quanhengwen/LK02/硬件/LK02/LK02第二次试产/瞄准板/新建文件夹/IMG_4605.JPG

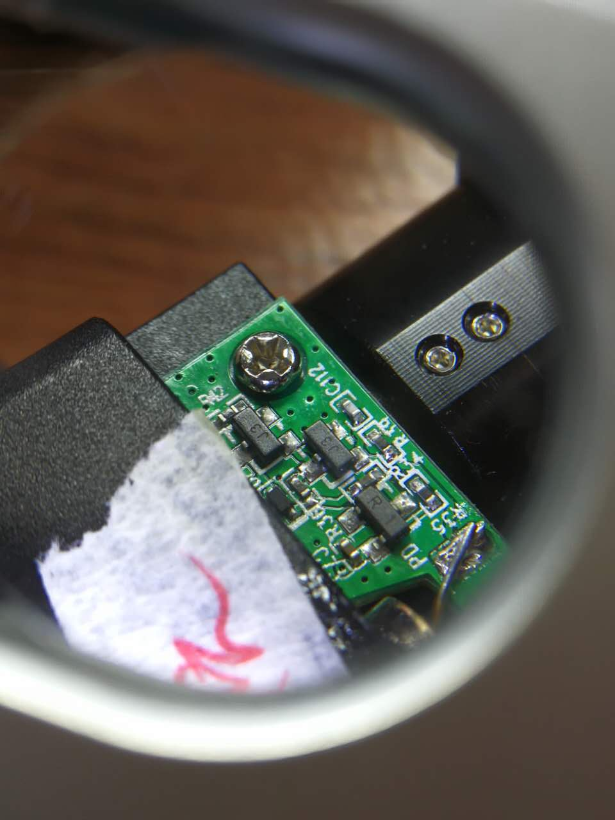
硬件/LK02/LK02第二次试产/瞄准板/新建文件夹/IMG_4605.JPG
