quanhengwen/LK02/浙大报警输出/MDK/JLinkLog.txt

T4118 227:283 SEGGER J-Link V6.32i Log File (0000ms, 1088ms total)
T4118 227:283 DLL Compiled: Jul 24 2018 15:19:55 (0000ms, 1088ms total)
T4118 227:283 Logging started @ 2019-03-27 14:07 (0000ms, 1088ms total)
T4118 227:283 JLINK_SetWarnOutHandler(...) (0000ms, 1088ms total)
T4118 227:283 JLINK_OpenEx(...)
Firmware: J-Link V9 compiled Apr 20 2018 16:47:26
Hardware: V9.40
S/N: 59400616
Feature(s): RDI, FlashBP, FlashDL, JFlash, GDB
TELNET listener socket opened on port 19021WEBSRV 
Starting webserver (0017ms, 1105ms total)
T4118 227:283 WEBSRV Webserver running on local port 19080 (0017ms, 1105ms total)
T4118 227:283   returns O.K. (0017ms, 1105ms total)
T4118 227:300 JLINK_GetEmuCaps()  returns 0xB9FF7BBF (0000ms, 1105ms total)
T4118 227:301 JLINK_TIF_GetAvailable(...) (0000ms, 1105ms total)
T4118 227:301 JLINK_SetErrorOutHandler(...) (0000ms, 1105ms total)
T4118 227:301 JLINK_ExecCommand("ProjectFile = "E:\zjk_lk\develop\LK02\浙大报警输出\MDK\JLinkSettings.ini"", ...).   returns 0x00 (0003ms, 1108ms total)
T4118 227:304 JLINK_ExecCommand("Device = STM32F103C8", ...). Device "STM32F103C8" selected.  returns 0x00 (0001ms, 1109ms total)
T4118 227:305 JLINK_ExecCommand("DisableConnectionTimeout", ...).   returns 0x01 (0000ms, 1109ms total)
T4118 227:305 JLINK_GetHardwareVersion()  returns 0x16F30 (0000ms, 1109ms total)
T4118 227:305 JLINK_GetDLLVersion()  returns 63209 (0000ms, 1109ms total)
T4118 227:305 JLINK_GetFirmwareString(...) (0000ms, 1109ms total)
T4118 227:305 JLINK_GetDLLVersion()  returns 63209 (0000ms, 1109ms total)
T4118 227:305 JLINK_GetCompileDateTime() (0001ms, 1110ms total)
T4118 227:306 JLINK_GetFirmwareString(...) (0000ms, 1110ms total)
T4118 227:306 JLINK_GetHardwareVersion()  returns 0x16F30 (0000ms, 1110ms total)
T4118 227:306 JLINK_TIF_Select(JLINKARM_TIF_SWD)  returns 0x00 (0000ms, 1110ms total)
T4118 227:306 JLINK_SetSpeed(5000) (0000ms, 1110ms total)
T4118 227:306 JLINK_GetId() >0x10B TIF>Found SW-DP with ID 0x1BA01477 >0x0D TIF> >0x28 TIF> >0x0D TIF> >0x28 TIF> >0x0D TIF> >0x28 TIF> >0x0D TIF> >0x28 TIF> >0x0D TIF> >0x21 TIF> >0x0D TIF> >0x28 TIF> >0x0D TIF> >0x28 TIF> >0x0D TIF> >0x28 TIF> >0x0D TIF> >0x21 TIF> >0x0D TIF> >0x21 TIF> >0x0D TIF> >0x28 TIF> >0x0D TIF> >0x21 TIF> >0x0D TIF> >0x21 TIF> >0x0D TIF> >0x28 TIF> >0x0D TIF> >0x28 TIF> >0x0D TIF> >0x28 TIF> >0x0D TIF> >0x21 TIF> >0x0D TIF> >0x21 TIF> >0x0D TIF> >0x28 TIF> >0x0D TIF> >0x21 TIF>
 >0x0D TIF> >0x21 TIF> >0x0D TIF> >0x28 TIF> >0x0D TIF> >0x21 TIF> >0x0D TIF> >0x21 TIF> >0x0D TIF> >0x28 TIF> >0x0D TIF> >0x21 TIF> >0x0D TIF> >0x21 TIF> >0x0D TIF> >0x28 TIF> >0x0D TIF> >0x21 TIF> >0x0D TIF> >0x21 TIF> >0x10B TIF>Found SW-DP with ID 0x1BA01477 >0x0D TIF> >0x28 TIF> >0x0D TIF> >0x28 TIF> >0x0D TIF> >0x28 TIF> >0x0D TIF> >0x28 TIF> >0x0D TIF> >0x21 TIF> >0x0D TIF> >0x28 TIF>Scanning AP map to find all available APs >0x0D TIF> >0x28 TIF> >0x0D TIF> >0x21 TIF> >0x0D TIF> >0x21 TIF>
 >0x0D TIF> >0x28 TIF> >0x0D TIF> >0x21 TIF> >0x0D TIF> >0x21 TIF>AP[1]: Stopped AP scan as end of AP map has been reachedAP[0]: AHB-AP (IDR: 0x14770011)Iterating through AP map to find AHB-AP to use >0x42 TIF> >0x28 TIF> >0x0D TIF> >0x28 TIF> >0x0D TIF> >0x21 TIF> >0x0D TIF> >0x21 TIF> >0x42 TIF> >0x28 TIF> >0x0D TIF> >0x28 TIF> >0x0D TIF> >0x28 TIF> >0x0D TIF> >0x21 TIF> >0x0D TIF> >0x21 TIF>AP[0]: Core foundAP[0]: AHB-AP ROM base: 0xE00FF000 >0x0D TIF> >0x28 TIF> >0x0D TIF> >0x28 TIF> >0x0D TIF>
 >0x28 TIF> >0x0D TIF> >0x21 TIF> >0x0D TIF> >0x21 TIF>CPUID register: 0x411FC231. Implementer code: 0x41 (ARM)Found Cortex-M3 r1p1, Little endian. -- Max. mem block: 0x00010F28 -- CPU_ReadMem(4 bytes @ 0xE000EDF0) -- CPU_WriteMem(4 bytes @ 0xE000EDF0) -- CPU_ReadMem(4 bytes @ 0xE0002000)FPUnit: 6 code (BP) slots and 2 literal slots -- CPU_ReadMem(4 bytes @ 0xE000EDFC) -- CPU_WriteMem(4 bytes @ 0xE000EDFC) -- CPU_ReadMem(4 bytes @ 0xE0001000) -- CPU_WriteMem(4 bytes @ 0xE0001000)
 -- CPU_ReadMem(4 bytes @ 0xE000ED88) -- CPU_WriteMem(4 bytes @ 0xE000ED88) -- CPU_ReadMem(4 bytes @ 0xE000ED88) -- CPU_WriteMem(4 bytes @ 0xE000ED88)CoreSight components:ROMTbl[0] @ E00FF000 -- CPU_ReadMem(16 bytes @ 0xE00FF000) -- CPU_ReadMem(16 bytes @ 0xE000EFF0) -- CPU_ReadMem(16 bytes @ 0xE000EFE0)ROMTbl[0][0]: E000E000, CID: B105E00D, PID: 001BB000 SCS -- CPU_ReadMem(16 bytes @ 0xE0001FF0) -- CPU_ReadMem(16 bytes @ 0xE0001FE0)ROMTbl[0][1]: E0001000, CID: B105E00D, PID: 001BB002 DWT
 -- CPU_ReadMem(16 bytes @ 0xE0002FF0) -- CPU_ReadMem(16 bytes @ 0xE0002FE0)ROMTbl[0][2]: E0002000, CID: B105E00D, PID: 000BB003 FPB -- CPU_ReadMem(16 bytes @ 0xE0000FF0) -- CPU_ReadMem(16 bytes @ 0xE0000FE0)ROMTbl[0][3]: E0000000, CID: B105E00D, PID: 001BB001 ITM -- CPU_ReadMem(16 bytes @ 0xE00FF010) -- CPU_ReadMem(16 bytes @ 0xE0040FF0) -- CPU_ReadMem(16 bytes @ 0xE0040FE0)ROMTbl[0][4]: E0040000, CID: B105900D, PID: 001BB923 TPIU-Lite >0x0D TIF> >0x21 TIF>  returns 0x1BA01477 (0127ms, 1237ms total)
T4118 227:433 JLINK_GetDLLVersion()  returns 63209 (0000ms, 1237ms total)
T4118 227:433 JLINK_CORE_GetFound()  returns 0x30000FF (0000ms, 1237ms total)
T4118 227:433 JLINK_GetDebugInfo(0x100 = JLINKARM_ROM_TABLE_ADDR_INDEX) -- Value=0xE00FF000  returns 0x00 (0000ms, 1237ms total)
T4118 227:433 JLINK_GetDebugInfo(0x100 = JLINKARM_ROM_TABLE_ADDR_INDEX) -- Value=0xE00FF000  returns 0x00 (0000ms, 1237ms total)
T4118 227:433 JLINK_GetDebugInfo(0x101 = JLINKARM_DEBUG_INFO_ETM_ADDR_INDEX) -- Value=0x00000000  returns 0x00 (0000ms, 1237ms total)
T4118 227:433 JLINK_ReadMemEx(0xE0041FF0, 0x0010 Bytes, ..., Flags = 0x02000004) -- CPU_ReadMem(16 bytes @ 0xE0041FF0) - Data: 00 00 00 00 00 00 00 00 00 00 00 00 00 00 00 00  returns 0x10 (0001ms, 1238ms total)
T4118 227:434 JLINK_GetDebugInfo(0x102 = JLINKARM_DEBUG_INFO_MTB_ADDR_INDEX) -- Value=0x00000000  returns 0x00 (0000ms, 1238ms total)
T4118 227:434 JLINK_GetDebugInfo(0x103 = JLINKARM_DEBUG_INFO_TPIU_ADDR_INDEX) -- Value=0xE0040000  returns 0x00 (0000ms, 1238ms total)
T4118 227:434 JLINK_GetDebugInfo(0x104 = JLINKARM_DEBUG_INFO_ITM_ADDR_INDEX) -- Value=0xE0000000  returns 0x00 (0000ms, 1238ms total)
T4118 227:434 JLINK_GetDebugInfo(0x105 = JLINKARM_DEBUG_INFO_DWT_ADDR_INDEX) -- Value=0xE0001000  returns 0x00 (0000ms, 1238ms total)
T4118 227:434 JLINK_GetDebugInfo(0x106 = JLINKARM_DEBUG_INFO_FPB_ADDR_INDEX) -- Value=0xE0002000  returns 0x00 (0000ms, 1238ms total)
T4118 227:434 JLINK_GetDebugInfo(0x107 = JLINKARM_DEBUG_INFO_NVIC_ADDR_INDEX) -- Value=0xE000E000  returns 0x00 (0000ms, 1238ms total)
T4118 227:434 JLINK_GetDebugInfo(0x10C = JLINKARM_DEBUG_INFO_DBG_ADDR_INDEX) -- Value=0xE000EDF0  returns 0x00 (0000ms, 1238ms total)
T4118 227:434 JLINK_GetDebugInfo(0x01 = Unknown) -- Value=0x00000000  returns 0x00 (0000ms, 1238ms total)
T4118 227:434 JLINK_ReadMemU32(0xE000ED00, 0x0001 Items, ...) -- CPU_ReadMem(4 bytes @ 0xE000ED00) - Data: 31 C2 1F 41  returns 0x01 (0000ms, 1238ms total)
T4118 227:434 JLINK_GetDebugInfo(0x10F = JLINKARM_DEBUG_INFO_HAS_CORTEX_M_SECURITY_EXT_INDEX) -- Value=0x00000000  returns 0x00 (0000ms, 1238ms total)
T4118 227:434 JLINK_SetResetType(JLINKARM_CM3_RESET_TYPE_NORMAL)  returns JLINKARM_CM3_RESET_TYPE_NORMAL (0000ms, 1238ms total)
T4118 227:434 JLINK_Reset() -- CPU is running -- CPU_WriteMem(4 bytes @ 0xE000EDF0) -- CPU is running -- CPU_WriteMem(4 bytes @ 0xE000EDFC)Reset: Halt core after reset via DEMCR.VC_CORERESET. >0x35 TIF>Reset: Reset device via AIRCR.SYSRESETREQ. -- CPU is running -- CPU_WriteMem(4 bytes @ 0xE000ED0C) >0x0D TIF> >0x28 TIF> -- CPU_ReadMem(4 bytes @ 0xE000EDF0) -- CPU_ReadMem(4 bytes @ 0xE000EDF0) -- CPU is running -- CPU_WriteMem(4 bytes @ 0xE000EDF0) -- CPU is running -- CPU_WriteMem(4 bytes @ 0xE000EDFC)
 -- CPU_ReadMem(4 bytes @ 0xE000EDF0) -- CPU_WriteMem(4 bytes @ 0xE0002000) -- CPU_ReadMem(4 bytes @ 0xE000EDFC) -- CPU_ReadMem(4 bytes @ 0xE0001000) (0066ms, 1304ms total)
T4118 227:500 JLINK_ReadReg(R15 (PC))  returns 0x080001A8 (0000ms, 1304ms total)
T4118 227:500 JLINK_ReadReg(XPSR)  returns 0x01000000 (0000ms, 1304ms total)
T4118 227:500 JLINK_Halt()  returns 0x00 (0000ms, 1304ms total)
T4118 227:500 JLINK_ReadMemU32(0xE000EDF0, 0x0001 Items, ...) -- CPU_ReadMem(4 bytes @ 0xE000EDF0) - Data: 03 00 03 00  returns 0x01 (0001ms, 1305ms total)
T4118 227:501 JLINK_WriteU32(0xE000EDF0, 0xA05F0003) -- CPU_WriteMem(4 bytes @ 0xE000EDF0)  returns 0x00 (0001ms, 1306ms total)
T4118 227:502 JLINK_WriteU32(0xE000EDFC, 0x01000000) -- CPU_WriteMem(4 bytes @ 0xE000EDFC)  returns 0x00 (0000ms, 1306ms total)
T4118 227:503 JLINK_GetHWStatus(...)  returns 0x00 (0000ms, 1306ms total)
T4118 227:503 JLINK_GetNumBPUnits(Type = 0xFFFFFF00)  returns 0x06 (0000ms, 1306ms total)
T4118 227:503 JLINK_GetNumBPUnits(Type = 0xF0)  returns 0x2000 (0000ms, 1306ms total)
T4118 227:503 JLINK_GetNumWPUnits()  returns 0x04 (0000ms, 1306ms total)
T4118 227:503 JLINK_GetSpeed()  returns 0xFA0 (0000ms, 1306ms total)
T4118 227:503 JLINK_ReadMemU32(0xE000E004, 0x0001 Items, ...) -- CPU_ReadMem(4 bytes @ 0xE000E004) - Data: 01 00 00 00  returns 0x01 (0001ms, 1307ms total)
T4118 227:504 JLINK_ReadMemU32(0xE000E004, 0x0001 Items, ...) -- CPU_ReadMem(4 bytes @ 0xE000E004) - Data: 01 00 00 00  returns 0x01 (0001ms, 1308ms total)
T4118 227:505 JLINK_WriteMemEx(0xE0001000, 0x001C Bytes, ..., Flags = 0x02000004) - Data: 01 00 00 00 00 00 00 00 00 00 00 00 00 00 00 00 ... -- CPU_WriteMem(28 bytes @ 0xE0001000)  returns 0x1C (0002ms, 1310ms total)
T4118 227:507 JLINK_ReadReg(R15 (PC))  returns 0x080001A8 (0000ms, 1310ms total)
T4118 227:507 JLINK_ReadReg(XPSR)  returns 0x01000000 (0000ms, 1310ms total)
T4118 227:538 JLINK_ReadMemEx(0xE0001004, 0x0004 Bytes, ..., Flags = 0x02000000) - Data: 00 00 00 00  returns 0x04 (0000ms, 1310ms total)
T4118 227:611 JLINK_SetResetType(JLINKARM_CM3_RESET_TYPE_NORMAL)  returns JLINKARM_CM3_RESET_TYPE_NORMAL (0000ms, 1310ms total)
T4118 227:611 JLINK_Reset() -- CPU_WriteMem(4 bytes @ 0xE000EDF0) -- CPU_WriteMem(4 bytes @ 0xE000EDFC)Reset: Halt core after reset via DEMCR.VC_CORERESET. >0x35 TIF>Reset: Reset device via AIRCR.SYSRESETREQ. -- CPU_WriteMem(4 bytes @ 0xE000ED0C) >0x0D TIF> >0x28 TIF> -- CPU_ReadMem(4 bytes @ 0xE000EDF0) -- CPU_ReadMem(4 bytes @ 0xE000EDF0) -- CPU_WriteMem(4 bytes @ 0xE000EDF0) -- CPU_WriteMem(4 bytes @ 0xE000EDFC) -- CPU_ReadMem(4 bytes @ 0xE000EDF0) -- CPU_WriteMem(4 bytes @ 0xE0002000)
 -- CPU_ReadMem(4 bytes @ 0xE000EDFC) -- CPU_ReadMem(4 bytes @ 0xE0001000) (0064ms, 1374ms total)
T4118 227:675 JLINK_ReadReg(R15 (PC))  returns 0x080001A8 (0000ms, 1374ms total)
T4118 227:675 JLINK_ReadReg(XPSR)  returns 0x01000000 (0000ms, 1374ms total)
T4118 228:011 JLINK_ReadMemEx(0x080001A8, 0x003C Bytes, ..., Flags = 0x02000000) -- CPU_ReadMem(128 bytes @ 0x08000180) -- Updating C cache (128 bytes @ 0x08000180) -- Read from C cache (60 bytes @ 0x080001A8) - Data: 09 48 80 47 09 48 00 47 FE E7 FE E7 FE E7 FE E7 ...  returns 0x3C (0008ms, 1382ms total)
T4118 230:407 JLINK_ReadReg(R0)  returns 0x00000000 (0001ms, 1383ms total)
T4118 230:408 JLINK_ReadReg(R1)  returns 0x00000000 (0000ms, 1383ms total)
T4118 230:408 JLINK_ReadReg(R2)  returns 0x00000000 (0000ms, 1383ms total)
T4118 230:408 JLINK_ReadReg(R3)  returns 0x00000000 (0000ms, 1383ms total)
T4118 230:408 JLINK_ReadReg(R4)  returns 0x20002194 (0000ms, 1383ms total)
T4118 230:408 JLINK_ReadReg(R5)  returns 0x00000006 (0000ms, 1383ms total)
T4118 230:408 JLINK_ReadReg(R6)  returns 0x00000000 (0000ms, 1383ms total)
T4118 230:408 JLINK_ReadReg(R7)  returns 0x00000000 (0000ms, 1383ms total)
T4118 230:408 JLINK_ReadReg(R8)  returns 0x20001FBC (0000ms, 1383ms total)
T4118 230:408 JLINK_ReadReg(R9)  returns 0x0000C350 (0000ms, 1383ms total)
T4118 230:408 JLINK_ReadReg(R10)  returns 0x000003E8 (0000ms, 1383ms total)
T4118 230:408 JLINK_ReadReg(R11)  returns 0x00000001 (0000ms, 1383ms total)
T4118 230:408 JLINK_ReadReg(R12)  returns 0x00000000 (0000ms, 1383ms total)
T4118 230:408 JLINK_ReadReg(R13 (SP))  returns 0x20002948 (0000ms, 1383ms total)
T4118 230:408 JLINK_ReadReg(R14)  returns 0xFFFFFFFF (0000ms, 1383ms total)
T4118 230:408 JLINK_ReadReg(R15 (PC))  returns 0x080001A8 (0000ms, 1383ms total)
T4118 230:408 JLINK_ReadReg(XPSR)  returns 0x01000000 (0000ms, 1383ms total)
T4118 230:408 JLINK_ReadReg(MSP)  returns 0x20002948 (0000ms, 1383ms total)
T4118 230:408 JLINK_ReadReg(PSP)  returns 0xAEAA5364 (0000ms, 1383ms total)
T4118 230:408 JLINK_ReadReg(CFBP)  returns 0x00000000 (0000ms, 1383ms total)
T4118 230:415 JLINK_ReadMemEx(0x20000024, 0x0002 Bytes, ..., Flags = 0x02000000) -- CPU_ReadMem(64 bytes @ 0x20000000) -- Updating C cache (64 bytes @ 0x20000000) -- Read from C cache (2 bytes @ 0x20000024) - Data: 02 00  returns 0x02 (0000ms, 1383ms total)
T2470 230:517 JLINK_ReadMemEx(0x080001A8, 0x0002 Bytes, ..., Flags = 0x02000000) -- Read from C cache (2 bytes @ 0x080001A8) - Data: 09 48  returns 0x02 (0000ms, 1383ms total)
T2470 230:517 JLINK_SetBPEx(Addr = 0x08004FD4, Type = 0xFFFFFFF2)  returns 0x00000001 (0000ms, 1383ms total)
T2470 230:517 JLINK_SetBPEx(Addr = 0x0800456A, Type = 0xFFFFFFF2)  returns 0x00000002 (0000ms, 1383ms total)
T2470 230:517 JLINK_Go() -- CPU_WriteMem(4 bytes @ 0xE0002000) -- CPU_WriteMem(4 bytes @ 0xE0002000) -- CPU_ReadMem(4 bytes @ 0xE0001000) -- CPU_WriteMem(4 bytes @ 0xE0002008) -- CPU_WriteMem(4 bytes @ 0xE000200C) -- CPU_WriteMem(4 bytes @ 0xE0002010) -- CPU_WriteMem(4 bytes @ 0xE0002014) -- CPU_WriteMem(4 bytes @ 0xE0002018) -- CPU_WriteMem(4 bytes @ 0xE000201C) -- CPU_WriteMem(4 bytes @ 0xE0001004) (0004ms, 1387ms total)
T2470 230:622 JLINK_IsHalted()  returns TRUE (0001ms, 1388ms total)
T2470 230:623 JLINK_Halt()  returns 0x00 (0000ms, 1387ms total)
T2470 230:623 JLINK_IsHalted()  returns TRUE (0000ms, 1387ms total)
T2470 230:623 JLINK_IsHalted()  returns TRUE (0000ms, 1387ms total)
T2470 230:623 JLINK_IsHalted()  returns TRUE (0000ms, 1387ms total)
T2470 230:624 JLINK_ReadReg(R15 (PC))  returns 0x08004FD4 (0000ms, 1387ms total)
T2470 230:624 JLINK_ReadReg(XPSR)  returns 0x61000000 (0000ms, 1387ms total)
T2470 230:624 JLINK_ClrBPEx(BPHandle = 0x00000001)  returns 0x00 (0000ms, 1387ms total)
T2470 230:624 JLINK_ClrBPEx(BPHandle = 0x00000002)  returns 0x00 (0000ms, 1387ms total)
T2470 230:624 JLINK_ReadMemU32(0xE000ED30, 0x0001 Items, ...) -- CPU_ReadMem(4 bytes @ 0xE000ED30) - Data: 02 00 00 00  returns 0x01 (0000ms, 1387ms total)
T2470 230:624 JLINK_ReadMemU32(0xE0001028, 0x0001 Items, ...) -- CPU_ReadMem(4 bytes @ 0xE0001028) - Data: 00 00 00 00  returns 0x01 (0000ms, 1387ms total)
T2470 230:624 JLINK_ReadMemU32(0xE0001038, 0x0001 Items, ...) -- CPU_ReadMem(4 bytes @ 0xE0001038) - Data: 00 02 00 00  returns 0x01 (0001ms, 1388ms total)
T2470 230:625 JLINK_ReadMemU32(0xE0001048, 0x0001 Items, ...) -- CPU_ReadMem(4 bytes @ 0xE0001048) - Data: 00 00 00 00  returns 0x01 (0000ms, 1388ms total)
T2470 230:625 JLINK_ReadMemU32(0xE0001058, 0x0001 Items, ...) -- CPU_ReadMem(4 bytes @ 0xE0001058) - Data: 00 00 00 00  returns 0x01 (0000ms, 1388ms total)
T2470 230:625 JLINK_ReadReg(R0)  returns 0x20002348 (0000ms, 1388ms total)
T2470 230:625 JLINK_ReadReg(R1)  returns 0x20002548 (0000ms, 1388ms total)
T2470 230:625 JLINK_ReadReg(R2)  returns 0x20002548 (0000ms, 1388ms total)
T2470 230:625 JLINK_ReadReg(R3)  returns 0x20002548 (0000ms, 1388ms total)
T2470 230:625 JLINK_ReadReg(R4)  returns 0x00000000 (0000ms, 1388ms total)
T2470 230:625 JLINK_ReadReg(R5)  returns 0x200022E4 (0000ms, 1388ms total)
T2470 230:625 JLINK_ReadReg(R6)  returns 0x00000000 (0000ms, 1388ms total)
T2470 230:625 JLINK_ReadReg(R7)  returns 0x00000000 (0000ms, 1388ms total)
T2470 230:625 JLINK_ReadReg(R8)  returns 0x00000000 (0000ms, 1388ms total)
T2470 230:625 JLINK_ReadReg(R9)  returns 0x0000C350 (0000ms, 1388ms total)
T2470 230:625 JLINK_ReadReg(R10)  returns 0x08006874 (0000ms, 1388ms total)
T2470 230:625 JLINK_ReadReg(R11)  returns 0x00000000 (0000ms, 1388ms total)
T2470 230:625 JLINK_ReadReg(R12)  returns 0x20002324 (0000ms, 1388ms total)
T2470 230:625 JLINK_ReadReg(R13 (SP))  returns 0x20002948 (0000ms, 1388ms total)
T2470 230:625 JLINK_ReadReg(R14)  returns 0x08000197 (0000ms, 1388ms total)
T2470 230:625 JLINK_ReadReg(R15 (PC))  returns 0x08004FD4 (0000ms, 1388ms total)
T2470 230:625 JLINK_ReadReg(XPSR)  returns 0x61000000 (0000ms, 1388ms total)
T2470 230:625 JLINK_ReadReg(MSP)  returns 0x20002948 (0001ms, 1389ms total)
T2470 230:626 JLINK_ReadReg(PSP)  returns 0xAEAA5364 (0000ms, 1389ms total)
T2470 230:626 JLINK_ReadReg(CFBP)  returns 0x00000000 (0000ms, 1389ms total)
T4118 230:629 JLINK_ReadMemEx(0x00000000, 0x0004 Bytes, ..., Flags = 0x02000000) -- CPU_ReadMem(4 bytes @ 0x00000004) -- CPU_ReadMem(64 bytes @ 0x08000000) -- Updating C cache (64 bytes @ 0x08000000) -- Read from C cache (4 bytes @ 0x08000000) - Data: 48 29 00 20  returns 0x04 (0001ms, 1390ms total)
T4118 230:631 JLINK_ReadMemEx(0x20000024, 0x0002 Bytes, ..., Flags = 0x02000000) -- CPU_ReadMem(64 bytes @ 0x20000000) -- Updating C cache (64 bytes @ 0x20000000) -- Read from C cache (2 bytes @ 0x20000024) - Data: 00 00  returns 0x02 (0000ms, 1390ms total)
T4118 230:633 JLINK_ReadMemEx(0x08004FD4, 0x002C Bytes, ..., Flags = 0x02000000) -- CPU_ReadMem(64 bytes @ 0x08004FC0) -- Updating C cache (64 bytes @ 0x08004FC0) -- Read from C cache (44 bytes @ 0x08004FD4) - Data: 00 26 35 46 FE F7 D4 FF FE F7 92 FF FE F7 22 FA ...  returns 0x2C (0001ms, 1391ms total)
T4118 230:634 JLINK_ReadMemEx(0x08005000, 0x0010 Bytes, ..., Flags = 0x02000000) -- CPU_ReadMem(64 bytes @ 0x08005000) -- Updating C cache (64 bytes @ 0x08005000) -- Read from C cache (16 bytes @ 0x08005000) - Data: 4C F2 50 39 00 27 E0 7A 21 79 08 43 18 D0 E0 79  returns 0x10 (0000ms, 1391ms total)
T2470 253:211 JLINK_ReadMemEx(0x08004FD4, 0x0002 Bytes, ..., Flags = 0x02000000) -- Read from C cache (2 bytes @ 0x08004FD4) - Data: 00 26  returns 0x02 (0000ms, 1391ms total)
T2470 253:211 JLINK_SetBPEx(Addr = 0x0800456A, Type = 0xFFFFFFF2)  returns 0x00000003 (0000ms, 1391ms total)
T2470 253:211 JLINK_SetBPEx(Addr = 0x0800215E, Type = 0xFFFFFFF2)  returns 0x00000004 (0000ms, 1391ms total)
T2470 253:211 JLINK_SetBPEx(Addr = 0x08002164, Type = 0xFFFFFFF2)  returns 0x00000005 (0000ms, 1391ms total)
T2470 253:211 JLINK_Go() -- CPU_WriteMem(4 bytes @ 0xE0002000) -- CPU_WriteMem(4 bytes @ 0xE0002000) -- CPU_WriteMem(4 bytes @ 0xE0002000) -- CPU_ReadMem(4 bytes @ 0xE0001000) -- CPU_WriteMem(4 bytes @ 0xE0002008) -- CPU_WriteMem(4 bytes @ 0xE000200C) -- CPU_WriteMem(4 bytes @ 0xE0002010) (0003ms, 1394ms total)
T2470 253:315 JLINK_IsHalted()  returns FALSE (0000ms, 1394ms total)
T2470 253:415 JLINK_IsHalted()  returns FALSE (0000ms, 1394ms total)
T2470 253:516 JLINK_IsHalted()  returns FALSE (0000ms, 1394ms total)
T2470 253:618 JLINK_IsHalted()  returns FALSE (0000ms, 1394ms total)
T2470 253:719 JLINK_IsHalted()  returns FALSE (0000ms, 1394ms total)
T2470 253:819 JLINK_IsHalted()  returns FALSE (0000ms, 1394ms total)
T2470 253:920 JLINK_IsHalted()  returns FALSE (0000ms, 1394ms total)
T2470 254:021 JLINK_IsHalted()  returns FALSE (0000ms, 1394ms total)
T2470 254:122 JLINK_IsHalted()  returns FALSE (0000ms, 1394ms total)
T2470 254:223 JLINK_IsHalted()  returns FALSE (0000ms, 1394ms total)
T2470 254:324 JLINK_IsHalted()  returns FALSE (0000ms, 1394ms total)
T2470 254:425 JLINK_IsHalted()  returns FALSE (0000ms, 1394ms total)
T2470 254:525 JLINK_IsHalted()  returns FALSE (0000ms, 1394ms total)
T2470 254:626 JLINK_IsHalted()  returns FALSE (0000ms, 1394ms total)
T2470 254:727 JLINK_IsHalted()  returns FALSE (0000ms, 1394ms total)
T2470 254:828 JLINK_IsHalted()  returns FALSE (0000ms, 1394ms total)
T2470 254:928 JLINK_IsHalted()  returns FALSE (0000ms, 1394ms total)
T2470 255:030 JLINK_IsHalted()  returns FALSE (0000ms, 1394ms total)
T2470 255:132 JLINK_IsHalted()  returns FALSE (0000ms, 1394ms total)
T2470 255:232 JLINK_IsHalted()  returns FALSE (0000ms, 1394ms total)
T2470 255:333 JLINK_IsHalted()  returns FALSE (0000ms, 1394ms total)
T2470 255:435 JLINK_IsHalted()  returns FALSE (0000ms, 1394ms total)
T2470 255:536 JLINK_IsHalted()  returns FALSE (0000ms, 1394ms total)
T2470 255:636 JLINK_IsHalted()  returns FALSE (0000ms, 1394ms total)
T2470 255:737 JLINK_IsHalted()  returns FALSE (0000ms, 1394ms total)
T2470 255:838 JLINK_IsHalted()  returns FALSE (0000ms, 1394ms total)
T2470 255:939 JLINK_IsHalted()  returns FALSE (0000ms, 1394ms total)
T2470 256:039 JLINK_IsHalted()  returns FALSE (0000ms, 1394ms total)
T2470 256:140 JLINK_IsHalted()  returns FALSE (0000ms, 1394ms total)
T2470 256:242 JLINK_IsHalted()  returns FALSE (0000ms, 1394ms total)
T2470 256:343 JLINK_IsHalted()  returns FALSE (0000ms, 1394ms total)
T2470 256:444 JLINK_IsHalted()  returns FALSE (0000ms, 1394ms total)
T2470 256:545 JLINK_IsHalted()  returns FALSE (0000ms, 1394ms total)
T2470 256:646 JLINK_IsHalted()  returns FALSE (0000ms, 1394ms total)
T2470 256:747 JLINK_IsHalted()  returns FALSE (0000ms, 1394ms total)
T2470 256:847 JLINK_IsHalted()  returns FALSE (0000ms, 1394ms total)
T2470 256:948 JLINK_IsHalted()  returns FALSE (0000ms, 1394ms total)
T2470 257:049 JLINK_IsHalted()  returns FALSE (0000ms, 1394ms total)
T2470 257:149 JLINK_IsHalted()  returns FALSE (0000ms, 1394ms total)
T2470 257:250 JLINK_IsHalted()  returns FALSE (0000ms, 1394ms total)
T2470 257:352 JLINK_IsHalted()  returns FALSE (0000ms, 1394ms total)
T2470 257:453 JLINK_IsHalted()  returns FALSE (0000ms, 1394ms total)
T2470 257:553 JLINK_IsHalted()  returns FALSE (0000ms, 1394ms total)
T2470 257:654 JLINK_IsHalted()  returns FALSE (0000ms, 1394ms total)
T2470 257:755 JLINK_IsHalted()  returns FALSE (0000ms, 1394ms total)
T2470 257:857 JLINK_IsHalted()  returns FALSE (0000ms, 1394ms total)
T2470 257:957 JLINK_IsHalted()  returns FALSE (0000ms, 1394ms total)
T2470 258:058 JLINK_IsHalted()  returns FALSE (0000ms, 1394ms total)
T2470 258:159 JLINK_IsHalted()  returns FALSE (0000ms, 1394ms total)
T2470 258:260 JLINK_IsHalted()  returns FALSE (0000ms, 1394ms total)
T2470 258:361 JLINK_IsHalted()  returns FALSE (0000ms, 1394ms total)
T2470 258:462 JLINK_IsHalted()  returns FALSE (0000ms, 1394ms total)
T2470 258:563 JLINK_IsHalted()  returns FALSE (0000ms, 1394ms total)
T2470 258:664 JLINK_IsHalted()  returns FALSE (0000ms, 1394ms total)
T2470 258:765 JLINK_IsHalted()  returns FALSE (0000ms, 1394ms total)
T2470 258:866 JLINK_IsHalted()  returns FALSE (0000ms, 1394ms total)
T2470 258:968 JLINK_IsHalted()  returns FALSE (0000ms, 1394ms total)
T2470 259:069 JLINK_IsHalted()  returns FALSE (0000ms, 1394ms total)
T2470 259:170 JLINK_IsHalted()  returns FALSE (0000ms, 1394ms total)
T2470 259:271 JLINK_IsHalted()  returns FALSE (0000ms, 1394ms total)
T2470 259:372 JLINK_IsHalted()  returns FALSE (0000ms, 1394ms total)
T2470 259:473 JLINK_IsHalted()  returns FALSE (0000ms, 1394ms total)
T2470 259:575 JLINK_IsHalted()  returns FALSE (0000ms, 1394ms total)
T2470 259:676 JLINK_IsHalted()  returns FALSE (0000ms, 1394ms total)
T2470 259:776 JLINK_IsHalted()  returns FALSE (0000ms, 1394ms total)
T2470 259:877 JLINK_IsHalted()  returns FALSE (0000ms, 1394ms total)
T2470 259:979 JLINK_IsHalted()  returns FALSE (0000ms, 1394ms total)
T2470 260:080 JLINK_IsHalted()  returns FALSE (0000ms, 1394ms total)
T2470 260:181 JLINK_IsHalted()  returns FALSE (0000ms, 1394ms total)
T2470 260:282 JLINK_IsHalted()  returns FALSE (0000ms, 1394ms total)
T2470 260:384 JLINK_IsHalted()  returns FALSE (0000ms, 1394ms total)
T2470 260:485 JLINK_IsHalted()  returns FALSE (0000ms, 1394ms total)
T2470 260:586 JLINK_IsHalted()  returns FALSE (0000ms, 1394ms total)
T2470 260:687 JLINK_IsHalted()  returns FALSE (0000ms, 1394ms total)
T2470 260:789 JLINK_IsHalted()  returns FALSE (0000ms, 1394ms total)
T2470 260:889 JLINK_IsHalted()  returns FALSE (0000ms, 1394ms total)
T2470 260:990 JLINK_IsHalted()  returns FALSE (0000ms, 1394ms total)
T2470 261:091 JLINK_IsHalted()  returns FALSE (0001ms, 1395ms total)
T2470 261:193 JLINK_IsHalted()  returns FALSE (0000ms, 1394ms total)
T2470 261:293 JLINK_IsHalted()  returns FALSE (0000ms, 1394ms total)
T2470 261:394 JLINK_IsHalted()  returns FALSE (0000ms, 1394ms total)
T2470 261:496 JLINK_IsHalted()  returns FALSE (0000ms, 1394ms total)
T2470 261:597 JLINK_IsHalted()  returns FALSE (0000ms, 1394ms total)
T2470 261:697 JLINK_IsHalted()  returns FALSE (0000ms, 1394ms total)
T2470 261:798 JLINK_IsHalted()  returns FALSE (0000ms, 1394ms total)
T2470 261:900 JLINK_IsHalted()  returns FALSE (0000ms, 1394ms total)
T2470 262:001 JLINK_IsHalted()  returns FALSE (0000ms, 1394ms total)
T2470 262:102 JLINK_IsHalted()  returns FALSE (0000ms, 1394ms total)
T2470 262:203 JLINK_IsHalted()  returns FALSE (0001ms, 1395ms total)
T2470 262:305 JLINK_IsHalted()  returns FALSE (0000ms, 1394ms total)
T2470 262:405 JLINK_IsHalted()  returns FALSE (0000ms, 1394ms total)
T2470 262:506 JLINK_IsHalted()  returns FALSE (0000ms, 1394ms total)
T2470 262:607 JLINK_IsHalted()  returns FALSE (0000ms, 1394ms total)
T2470 262:708 JLINK_IsHalted()  returns FALSE (0000ms, 1394ms total)
T2470 262:809 JLINK_IsHalted()  returns FALSE (0000ms, 1394ms total)
T2470 262:910 JLINK_IsHalted()  returns FALSE (0000ms, 1394ms total)
T2470 263:011 JLINK_IsHalted()  returns FALSE (0000ms, 1394ms total)
T2470 263:111 JLINK_IsHalted()  returns FALSE (0000ms, 1394ms total)
T2470 263:212 JLINK_IsHalted()  returns FALSE (0000ms, 1394ms total)
T2470 263:313 JLINK_IsHalted()  returns FALSE (0000ms, 1394ms total)
T2470 263:414 JLINK_IsHalted()  returns FALSE (0000ms, 1394ms total)
T2470 263:514 JLINK_IsHalted()  returns FALSE (0000ms, 1394ms total)
T2470 263:615 JLINK_IsHalted()  returns FALSE (0000ms, 1394ms total)
T2470 263:716 JLINK_IsHalted()  returns FALSE (0000ms, 1394ms total)
T2470 263:822 JLINK_IsHalted()  returns FALSE (0004ms, 1398ms total)
T2470 263:934 JLINK_IsHalted()  returns FALSE (0000ms, 1394ms total)
T2470 264:049 JLINK_IsHalted()  returns FALSE (0003ms, 1397ms total)
T2470 264:154 JLINK_IsHalted()  returns FALSE (0000ms, 1394ms total)
T2470 264:255 JLINK_IsHalted()  returns FALSE (0000ms, 1394ms total)
T2470 264:367 JLINK_IsHalted()  returns FALSE (0003ms, 1408ms total)
T2470 264:471 JLINK_IsHalted()  returns FALSE (0000ms, 1405ms total)
T2470 264:578 JLINK_IsHalted()  returns FALSE (0002ms, 1407ms total)
T2470 264:692 JLINK_IsHalted()  returns FALSE (0003ms, 1408ms total)
T2470 264:796 JLINK_IsHalted()  returns FALSE (0000ms, 1405ms total)
T2470 264:905 JLINK_IsHalted()  returns FALSE (0007ms, 1412ms total)
T2470 265:012 JLINK_IsHalted()  returns FALSE (0000ms, 1405ms total)
T2470 265:113 JLINK_IsHalted()  returns FALSE (0000ms, 1405ms total)
T2470 265:226 JLINK_IsHalted()  returns FALSE (0008ms, 1413ms total)
T2470 265:337 JLINK_IsHalted()  returns FALSE (0005ms, 1410ms total)
T2470 265:443 JLINK_IsHalted()  returns FALSE (0000ms, 1405ms total)
T2470 265:548 JLINK_IsHalted()  returns FALSE (0001ms, 1406ms total)
T2470 265:651 JLINK_IsHalted()  returns FALSE (0001ms, 1406ms total)
T2470 265:752 JLINK_IsHalted()  returns FALSE (0000ms, 1405ms total)
T2470 265:858 JLINK_IsHalted()  returns FALSE (0001ms, 1406ms total)
T2470 265:967 JLINK_IsHalted()  returns FALSE (0000ms, 1405ms total)
T2470 266:072 JLINK_IsHalted()  returns FALSE (0000ms, 1405ms total)
T2470 266:173 JLINK_IsHalted()  returns FALSE (0000ms, 1405ms total)
T2470 266:274 JLINK_IsHalted()  returns FALSE (0000ms, 1405ms total)
T2470 266:375 JLINK_IsHalted()  returns FALSE (0000ms, 1405ms total)
T2470 266:476 JLINK_IsHalted()  returns FALSE (0000ms, 1405ms total)
T2470 266:577 JLINK_IsHalted()  returns FALSE (0000ms, 1405ms total)
T2470 266:678 JLINK_IsHalted()  returns FALSE (0000ms, 1405ms total)
T2470 266:779 JLINK_IsHalted()  returns FALSE (0000ms, 1405ms total)
T2470 266:880 JLINK_IsHalted()  returns FALSE (0000ms, 1405ms total)
T2470 266:981 JLINK_IsHalted()  returns FALSE (0000ms, 1405ms total)
T2470 267:082 JLINK_IsHalted()  returns FALSE (0000ms, 1405ms total)
T2470 267:184 JLINK_IsHalted()  returns FALSE (0000ms, 1405ms total)
T2470 267:284 JLINK_IsHalted()  returns FALSE (0000ms, 1405ms total)
T2470 267:385 JLINK_IsHalted()  returns FALSE (0000ms, 1405ms total)
T2470 267:487 JLINK_IsHalted()  returns FALSE (0000ms, 1405ms total)
T2470 267:588 JLINK_IsHalted()  returns FALSE (0000ms, 1405ms total)
T2470 267:689 JLINK_IsHalted()  returns FALSE (0000ms, 1405ms total)
T2470 267:790 JLINK_IsHalted()  returns FALSE (0000ms, 1405ms total)
T2470 267:891 JLINK_IsHalted()  returns FALSE (0000ms, 1405ms total)
T2470 267:992 JLINK_IsHalted()  returns FALSE (0000ms, 1405ms total)
T2470 268:093 JLINK_IsHalted()  returns FALSE (0000ms, 1405ms total)
T2470 268:195 JLINK_IsHalted()  returns FALSE (0000ms, 1405ms total)
T2470 268:296 JLINK_IsHalted()  returns FALSE (0000ms, 1405ms total)
T2470 268:396 JLINK_IsHalted()  returns FALSE (0000ms, 1405ms total)
T2470 268:497 JLINK_IsHalted()  returns FALSE (0000ms, 1405ms total)
T2470 268:598 JLINK_IsHalted()  returns FALSE (0000ms, 1405ms total)
T2470 268:699 JLINK_IsHalted()  returns FALSE (0000ms, 1405ms total)
T2470 268:799 JLINK_IsHalted()  returns FALSE (0000ms, 1405ms total)
T2470 268:900 JLINK_IsHalted()  returns FALSE (0000ms, 1405ms total)
T2470 269:002 JLINK_IsHalted()  returns FALSE (0000ms, 1405ms total)
T2470 269:103 JLINK_IsHalted()  returns FALSE (0000ms, 1405ms total)
T2470 269:204 JLINK_IsHalted()  returns FALSE (0000ms, 1405ms total)
T2470 269:305 JLINK_IsHalted()  returns FALSE (0000ms, 1405ms total)
T2470 269:407 JLINK_IsHalted()  returns FALSE (0000ms, 1405ms total)
T2470 269:508 JLINK_IsHalted()  returns FALSE (0000ms, 1405ms total)
T2470 269:609 JLINK_IsHalted()  returns FALSE (0000ms, 1405ms total)
T2470 269:711 JLINK_IsHalted()  returns FALSE (0000ms, 1405ms total)
T2470 269:812 JLINK_IsHalted()  returns FALSE (0000ms, 1405ms total)
T2470 269:913 JLINK_IsHalted()  returns FALSE (0000ms, 1405ms total)
T2470 270:014 JLINK_IsHalted()  returns FALSE (0000ms, 1405ms total)
T2470 270:115 JLINK_IsHalted()  returns FALSE (0000ms, 1405ms total)
T2470 270:215 JLINK_IsHalted()  returns FALSE (0000ms, 1405ms total)
T2470 270:316 JLINK_IsHalted()  returns FALSE (0000ms, 1405ms total)
T2470 270:417 JLINK_IsHalted()  returns FALSE (0000ms, 1405ms total)
T2470 270:518 JLINK_IsHalted()  returns FALSE (0000ms, 1405ms total)
T2470 270:620 JLINK_IsHalted()  returns FALSE (0000ms, 1405ms total)
T2470 270:720 JLINK_IsHalted()  returns FALSE (0000ms, 1405ms total)
T2470 270:821 JLINK_IsHalted()  returns FALSE (0000ms, 1405ms total)
T2470 270:922 JLINK_IsHalted()  returns FALSE (0000ms, 1405ms total)
T2470 271:022 JLINK_IsHalted()  returns FALSE (0000ms, 1405ms total)
T2470 271:124 JLINK_IsHalted()  returns FALSE (0000ms, 1405ms total)
T2470 271:225 JLINK_IsHalted()  returns FALSE (0000ms, 1405ms total)
T2470 271:326 JLINK_IsHalted()  returns FALSE (0000ms, 1405ms total)
T2470 271:426 JLINK_IsHalted()  returns FALSE (0000ms, 1405ms total)
T2470 271:527 JLINK_IsHalted()  returns FALSE (0000ms, 1405ms total)
T2470 271:628 JLINK_IsHalted()  returns FALSE (0000ms, 1405ms total)
T2470 271:729 JLINK_IsHalted()  returns FALSE (0000ms, 1405ms total)
T2470 271:830 JLINK_IsHalted()  returns FALSE (0000ms, 1405ms total)
T2470 271:931 JLINK_IsHalted()  returns FALSE (0000ms, 1405ms total)
T2470 272:032 JLINK_IsHalted()  returns FALSE (0000ms, 1405ms total)
T2470 272:133 JLINK_IsHalted()  returns FALSE (0000ms, 1405ms total)
T2470 272:234 JLINK_IsHalted()  returns FALSE (0000ms, 1405ms total)
T2470 272:335 JLINK_IsHalted()  returns FALSE (0000ms, 1405ms total)
T2470 272:436 JLINK_IsHalted()  returns FALSE (0000ms, 1405ms total)
T2470 272:537 JLINK_IsHalted()  returns FALSE (0000ms, 1405ms total)
T2470 272:638 JLINK_IsHalted()  returns FALSE (0000ms, 1405ms total)
T2470 272:739 JLINK_IsHalted()  returns FALSE (0000ms, 1405ms total)
T2470 272:839 JLINK_IsHalted()  returns FALSE (0000ms, 1405ms total)
T2470 272:940 JLINK_IsHalted()  returns FALSE (0000ms, 1405ms total)
T2470 273:042 JLINK_IsHalted()  returns FALSE (0000ms, 1405ms total)
T2470 273:143 JLINK_IsHalted()  returns FALSE (0000ms, 1405ms total)
T2470 273:243 JLINK_IsHalted()  returns FALSE (0000ms, 1405ms total)
T2470 273:344 JLINK_IsHalted()  returns FALSE (0000ms, 1405ms total)
T2470 273:445 JLINK_IsHalted()  returns FALSE (0000ms, 1405ms total)
T2470 273:546 JLINK_IsHalted()  returns FALSE (0000ms, 1405ms total)
T2470 273:647 JLINK_IsHalted()  returns FALSE (0000ms, 1405ms total)
T2470 273:748 JLINK_IsHalted()  returns FALSE (0000ms, 1405ms total)
T2470 273:850 JLINK_IsHalted()  returns FALSE (0000ms, 1405ms total)
T2470 273:951 JLINK_IsHalted()  returns FALSE (0000ms, 1405ms total)
T2470 274:052 JLINK_IsHalted()  returns FALSE (0000ms, 1405ms total)
T2470 274:153 JLINK_IsHalted()  returns FALSE (0000ms, 1405ms total)
T2470 274:254 JLINK_IsHalted()  returns FALSE (0000ms, 1405ms total)
T2470 274:355 JLINK_IsHalted()  returns FALSE (0000ms, 1405ms total)
T2470 274:456 JLINK_IsHalted()  returns FALSE (0000ms, 1405ms total)
T2470 274:557 JLINK_IsHalted()  returns FALSE (0000ms, 1405ms total)
T2470 274:658 JLINK_IsHalted()  returns FALSE (0000ms, 1405ms total)
T2470 274:758 JLINK_IsHalted()  returns FALSE (0000ms, 1405ms total)
T2470 274:859 JLINK_IsHalted()  returns FALSE (0000ms, 1405ms total)
T2470 274:960 JLINK_IsHalted()  returns FALSE (0000ms, 1405ms total)
T2470 275:061 JLINK_IsHalted()  returns FALSE (0000ms, 1405ms total)
T2470 275:161 JLINK_IsHalted()  returns FALSE (0000ms, 1405ms total)
T2470 275:262 JLINK_IsHalted()  returns FALSE (0000ms, 1405ms total)
T2470 275:363 JLINK_IsHalted()  returns FALSE (0000ms, 1405ms total)
T2470 275:463 JLINK_IsHalted()  returns FALSE (0000ms, 1405ms total)
T2470 275:564 JLINK_IsHalted()  returns FALSE (0000ms, 1405ms total)
T2470 275:665 JLINK_IsHalted()  returns FALSE (0000ms, 1405ms total)
T2470 275:766 JLINK_IsHalted()  returns FALSE (0000ms, 1405ms total)
T2470 275:866 JLINK_IsHalted()  returns FALSE (0000ms, 1405ms total)
T2470 275:967 JLINK_IsHalted()  returns FALSE (0000ms, 1405ms total)
T2470 276:069 JLINK_IsHalted()  returns FALSE (0000ms, 1405ms total)
T2470 276:170 JLINK_IsHalted()  returns FALSE (0000ms, 1405ms total)
T2470 276:270 JLINK_IsHalted()  returns FALSE (0000ms, 1405ms total)
T2470 276:371 JLINK_IsHalted()  returns FALSE (0000ms, 1405ms total)
T2470 276:472 JLINK_IsHalted()  returns FALSE (0000ms, 1405ms total)
T2470 276:574 JLINK_IsHalted()  returns FALSE (0000ms, 1405ms total)
T2470 276:675 JLINK_IsHalted()  returns FALSE (0000ms, 1405ms total)
T2470 276:776 JLINK_IsHalted()  returns FALSE (0000ms, 1405ms total)
T2470 276:877 JLINK_IsHalted()  returns FALSE (0000ms, 1405ms total)
T2470 276:978 JLINK_IsHalted()  returns FALSE (0000ms, 1405ms total)
T2470 277:079 JLINK_IsHalted()  returns FALSE (0000ms, 1405ms total)
T2470 277:180 JLINK_IsHalted()  returns FALSE (0000ms, 1405ms total)
T2470 277:281 JLINK_IsHalted()  returns FALSE (0000ms, 1405ms total)
T2470 277:381 JLINK_IsHalted()  returns FALSE (0000ms, 1405ms total)
T2470 277:482 JLINK_IsHalted()  returns FALSE (0000ms, 1405ms total)
T2470 277:584 JLINK_IsHalted()  returns FALSE (0000ms, 1405ms total)
T2470 277:685 JLINK_IsHalted()  returns FALSE (0000ms, 1405ms total)
T2470 277:786 JLINK_IsHalted()  returns FALSE (0000ms, 1405ms total)
T2470 277:887 JLINK_IsHalted()  returns FALSE (0000ms, 1405ms total)
T2470 277:988 JLINK_IsHalted()  returns FALSE (0000ms, 1405ms total)
T2470 278:089 JLINK_IsHalted()  returns FALSE (0000ms, 1405ms total)
T2470 278:189 JLINK_IsHalted()  returns FALSE (0000ms, 1405ms total)
T2470 278:290 JLINK_IsHalted()  returns FALSE (0000ms, 1405ms total)
T2470 278:391 JLINK_IsHalted()  returns FALSE (0000ms, 1405ms total)
T2470 278:491 JLINK_IsHalted()  returns FALSE (0000ms, 1405ms total)
T2470 278:592 JLINK_IsHalted()  returns FALSE (0000ms, 1405ms total)
T2470 278:693 JLINK_IsHalted()  returns FALSE (0000ms, 1405ms total)
T2470 278:793 JLINK_IsHalted()  returns FALSE (0000ms, 1405ms total)
T2470 278:894 JLINK_IsHalted()  returns FALSE (0000ms, 1405ms total)
T2470 278:995 JLINK_IsHalted()  returns FALSE (0000ms, 1405ms total)
T2470 279:096 JLINK_IsHalted()  returns FALSE (0000ms, 1405ms total)
T2470 279:198 JLINK_IsHalted()  returns FALSE (0000ms, 1405ms total)
T2470 279:299 JLINK_IsHalted()  returns FALSE (0000ms, 1405ms total)
T2470 279:400 JLINK_IsHalted()  returns FALSE (0000ms, 1405ms total)
T2470 279:501 JLINK_IsHalted()  returns FALSE (0000ms, 1405ms total)
T2470 279:601 JLINK_IsHalted()  returns FALSE (0000ms, 1405ms total)
T2470 279:702 JLINK_IsHalted()  returns FALSE (0000ms, 1405ms total)
T2470 279:804 JLINK_IsHalted()  returns FALSE (0000ms, 1405ms total)
T2470 279:905 JLINK_IsHalted()  returns FALSE (0000ms, 1405ms total)
T2470 280:005 JLINK_IsHalted()  returns FALSE (0000ms, 1405ms total)
T2470 280:106 JLINK_IsHalted()  returns FALSE (0000ms, 1405ms total)
T2470 280:207 JLINK_IsHalted()  returns FALSE (0000ms, 1405ms total)
T2470 280:308 JLINK_IsHalted()  returns FALSE (0000ms, 1405ms total)
T2470 280:409 JLINK_IsHalted()  returns FALSE (0000ms, 1405ms total)
T2470 280:510 JLINK_IsHalted()  returns FALSE (0000ms, 1405ms total)
T2470 280:611 JLINK_IsHalted()  returns FALSE (0000ms, 1405ms total)
T2470 280:711 JLINK_IsHalted()  returns FALSE (0000ms, 1405ms total)
T2470 280:812 JLINK_IsHalted()  returns FALSE (0000ms, 1405ms total)
T2470 280:913 JLINK_IsHalted()  returns FALSE (0000ms, 1405ms total)
T2470 281:014 JLINK_IsHalted()  returns FALSE (0000ms, 1405ms total)
T2470 281:114 JLINK_IsHalted()  returns FALSE (0000ms, 1405ms total)
T2470 281:215 JLINK_IsHalted()  returns FALSE (0000ms, 1405ms total)
T2470 281:316 JLINK_IsHalted()  returns FALSE (0000ms, 1405ms total)
T2470 281:417 JLINK_IsHalted()  returns FALSE (0000ms, 1405ms total)
T2470 281:518 JLINK_IsHalted()  returns FALSE (0000ms, 1405ms total)
T2470 281:620 JLINK_IsHalted()  returns FALSE (0000ms, 1405ms total)
T2470 281:721 JLINK_IsHalted()  returns FALSE (0000ms, 1405ms total)
T2470 281:821 JLINK_IsHalted()  returns FALSE (0000ms, 1405ms total)
T2470 281:922 JLINK_IsHalted()  returns FALSE (0000ms, 1405ms total)
T2470 282:023 JLINK_IsHalted()  returns FALSE (0000ms, 1405ms total)
T2470 282:124 JLINK_IsHalted()  returns FALSE (0000ms, 1405ms total)
T2470 282:225 JLINK_IsHalted()  returns FALSE (0000ms, 1405ms total)
T2470 282:326 JLINK_IsHalted()  returns FALSE (0000ms, 1405ms total)
T2470 282:428 JLINK_IsHalted()  returns FALSE (0000ms, 1405ms total)
T2470 282:529 JLINK_IsHalted()  returns FALSE (0000ms, 1405ms total)
T2470 282:630 JLINK_IsHalted()  returns FALSE (0000ms, 1405ms total)
T2470 282:731 JLINK_IsHalted()  returns FALSE (0000ms, 1405ms total)
T2470 282:832 JLINK_IsHalted()  returns FALSE (0000ms, 1405ms total)
T2470 282:934 JLINK_IsHalted()  returns FALSE (0000ms, 1405ms total)
T2470 283:035 JLINK_IsHalted()  returns FALSE (0000ms, 1405ms total)
T2470 283:136 JLINK_IsHalted()  returns FALSE (0000ms, 1405ms total)
T2470 283:237 JLINK_IsHalted()  returns FALSE (0000ms, 1405ms total)
T2470 283:337 JLINK_IsHalted()  returns FALSE (0000ms, 1405ms total)
T2470 283:438 JLINK_IsHalted()  returns FALSE (0000ms, 1405ms total)
T2470 283:539 JLINK_IsHalted()  returns FALSE (0000ms, 1405ms total)
T2470 283:640 JLINK_IsHalted()  returns FALSE (0000ms, 1405ms total)
T2470 283:740 JLINK_IsHalted()  returns FALSE (0000ms, 1405ms total)
T2470 283:841 JLINK_IsHalted()  returns FALSE (0000ms, 1405ms total)
T2470 283:943 JLINK_IsHalted()  returns FALSE (0000ms, 1405ms total)
T2470 284:044 JLINK_IsHalted()  returns FALSE (0000ms, 1405ms total)
T2470 284:144 JLINK_IsHalted()  returns FALSE (0000ms, 1405ms total)
T2470 284:245 JLINK_IsHalted()  returns FALSE (0000ms, 1405ms total)
T2470 284:346 JLINK_IsHalted()  returns FALSE (0000ms, 1405ms total)
T2470 284:448 JLINK_IsHalted()  returns FALSE (0000ms, 1405ms total)
T2470 284:548 JLINK_IsHalted()  returns FALSE (0000ms, 1405ms total)
T2470 284:650 JLINK_IsHalted()  returns FALSE (0000ms, 1405ms total)
T2470 284:751 JLINK_IsHalted()  returns FALSE (0000ms, 1405ms total)
T2470 284:851 JLINK_IsHalted()  returns FALSE (0000ms, 1405ms total)
T2470 284:952 JLINK_IsHalted()  returns FALSE (0000ms, 1405ms total)
T2470 285:053 JLINK_IsHalted()  returns FALSE (0000ms, 1405ms total)
T2470 285:153 JLINK_IsHalted()  returns FALSE (0000ms, 1405ms total)
T2470 285:254 JLINK_IsHalted()  returns FALSE (0000ms, 1405ms total)
T2470 285:356 JLINK_IsHalted()  returns FALSE (0000ms, 1405ms total)
T2470 285:457 JLINK_IsHalted()  returns FALSE (0000ms, 1405ms total)
T2470 285:557 JLINK_IsHalted()  returns FALSE (0000ms, 1405ms total)
T2470 285:658 JLINK_IsHalted()  returns FALSE (0000ms, 1405ms total)
T2470 285:759 JLINK_IsHalted()  returns FALSE (0000ms, 1405ms total)
T2470 285:860 JLINK_IsHalted()  returns FALSE (0000ms, 1405ms total)
T2470 285:961 JLINK_IsHalted()  returns FALSE (0000ms, 1405ms total)
T2470 286:061 JLINK_IsHalted()  returns FALSE (0000ms, 1405ms total)
T2470 286:162 JLINK_IsHalted()  returns FALSE (0000ms, 1405ms total)
T2470 286:264 JLINK_IsHalted()  returns FALSE (0000ms, 1405ms total)
T2470 286:365 JLINK_IsHalted()  returns FALSE (0000ms, 1405ms total)
T2470 286:466 JLINK_IsHalted()  returns FALSE (0000ms, 1405ms total)
T2470 286:568 JLINK_IsHalted()  returns FALSE (0000ms, 1405ms total)
T2470 286:668 JLINK_IsHalted()  returns FALSE (0000ms, 1405ms total)
T2470 286:769 JLINK_IsHalted()  returns FALSE (0000ms, 1405ms total)
T2470 286:870 JLINK_IsHalted()  returns FALSE (0000ms, 1405ms total)
T2470 286:971 JLINK_IsHalted()  returns FALSE (0000ms, 1405ms total)
T2470 287:072 JLINK_IsHalted()  returns FALSE (0000ms, 1405ms total)
T2470 287:172 JLINK_IsHalted()  returns FALSE (0000ms, 1405ms total)
T2470 287:273 JLINK_IsHalted()  returns FALSE (0000ms, 1405ms total)
T2470 287:374 JLINK_IsHalted()  returns FALSE (0000ms, 1405ms total)
T2470 287:475 JLINK_IsHalted()  returns FALSE (0000ms, 1405ms total)
T2470 287:576 JLINK_IsHalted()  returns FALSE (0000ms, 1405ms total)
T2470 287:677 JLINK_IsHalted()  returns FALSE (0000ms, 1405ms total)
T2470 287:778 JLINK_IsHalted()  returns FALSE (0000ms, 1405ms total)
T2470 287:878 JLINK_IsHalted()  returns FALSE (0000ms, 1405ms total)
T2470 287:979 JLINK_IsHalted()  returns FALSE (0000ms, 1405ms total)
T2470 288:080 JLINK_IsHalted()  returns FALSE (0000ms, 1405ms total)
T2470 288:181 JLINK_IsHalted()  returns FALSE (0000ms, 1405ms total)
T2470 288:282 JLINK_IsHalted()  returns FALSE (0000ms, 1405ms total)
T2470 288:383 JLINK_IsHalted()  returns FALSE (0000ms, 1405ms total)
T2470 288:484 JLINK_IsHalted()  returns FALSE (0000ms, 1405ms total)
T2470 288:584 JLINK_IsHalted()  returns FALSE (0000ms, 1405ms total)
T2470 288:685 JLINK_IsHalted()  returns FALSE (0000ms, 1405ms total)
T2470 288:786 JLINK_IsHalted()  returns FALSE (0000ms, 1405ms total)
T2470 288:887 JLINK_IsHalted()  returns FALSE (0000ms, 1405ms total)
T2470 288:987 JLINK_IsHalted()  returns FALSE (0000ms, 1405ms total)
T2470 289:088 JLINK_IsHalted()  returns FALSE (0000ms, 1405ms total)
T2470 289:189 JLINK_IsHalted()  returns FALSE (0000ms, 1405ms total)
T2470 289:289 JLINK_IsHalted()  returns FALSE (0000ms, 1405ms total)
T2470 289:390 JLINK_IsHalted()  returns FALSE (0000ms, 1405ms total)
T2470 289:492 JLINK_IsHalted()  returns FALSE (0000ms, 1405ms total)
T2470 289:593 JLINK_IsHalted()  returns FALSE (0000ms, 1405ms total)
T2470 289:693 JLINK_IsHalted()  returns FALSE (0000ms, 1405ms total)
T2470 289:794 JLINK_IsHalted()  returns FALSE (0000ms, 1405ms total)
T4118 289:860 JLINK_SetBPEx(Addr = 0x080045EC, Type = 0xFFFFFFF2) -- CPU is running -- CPU is running -- CPU_WriteMem(4 bytes @ 0xE0002000) -- CPU is running -- CPU_WriteMem(4 bytes @ 0xE0002014)  returns 0x00000006 (0014ms, 1419ms total)
T2470 289:895 JLINK_IsHalted()  returns FALSE (0000ms, 1419ms total)
T2470 289:996 JLINK_IsHalted()  returns FALSE (0000ms, 1419ms total)
T2470 290:096 JLINK_IsHalted()  returns FALSE (0000ms, 1419ms total)
T2470 290:197 JLINK_IsHalted()  returns FALSE (0000ms, 1419ms total)
T2470 290:298 JLINK_IsHalted()  returns FALSE (0000ms, 1419ms total)
T2470 290:399 JLINK_IsHalted()  returns FALSE (0000ms, 1419ms total)
T2470 290:500 JLINK_IsHalted()  returns FALSE (0000ms, 1419ms total)
T2470 290:601 JLINK_IsHalted()  returns FALSE (0000ms, 1419ms total)
T2470 290:702 JLINK_IsHalted()  returns FALSE (0000ms, 1419ms total)
T2470 290:803 JLINK_IsHalted()  returns FALSE (0000ms, 1419ms total)
T2470 290:903 JLINK_IsHalted()  returns FALSE (0000ms, 1419ms total)
T2470 291:004 JLINK_IsHalted()  returns FALSE (0000ms, 1419ms total)
T2470 291:105 JLINK_IsHalted()  returns FALSE (0000ms, 1419ms total)
T2470 291:205 JLINK_IsHalted()  returns FALSE (0000ms, 1419ms total)
T2470 291:306 JLINK_IsHalted()  returns FALSE (0000ms, 1419ms total)
T2470 291:407 JLINK_IsHalted()  returns FALSE (0000ms, 1419ms total)
T2470 291:508 JLINK_IsHalted()  returns TRUE (0002ms, 1421ms total)
T2470 291:510 JLINK_Halt()  returns 0x00 (0000ms, 1419ms total)
T2470 291:510 JLINK_IsHalted()  returns TRUE (0000ms, 1419ms total)
T2470 291:510 JLINK_IsHalted()  returns TRUE (0000ms, 1419ms total)
T2470 291:510 JLINK_IsHalted()  returns TRUE (0000ms, 1419ms total)
T2470 291:510 JLINK_ReadReg(R15 (PC))  returns 0x080045EC (0000ms, 1419ms total)
T2470 291:510 JLINK_ReadReg(XPSR)  returns 0xA1000035 (0000ms, 1419ms total)
T2470 291:510 JLINK_ClrBPEx(BPHandle = 0x00000003)  returns 0x00 (0000ms, 1419ms total)
T2470 291:510 JLINK_ClrBPEx(BPHandle = 0x00000004)  returns 0x00 (0000ms, 1419ms total)
T2470 291:510 JLINK_ClrBPEx(BPHandle = 0x00000005)  returns 0x00 (0000ms, 1419ms total)
T2470 291:510 JLINK_ClrBPEx(BPHandle = 0x00000006)  returns 0x00 (0000ms, 1419ms total)
T2470 291:510 JLINK_ReadMemU32(0xE000ED30, 0x0001 Items, ...) -- CPU_ReadMem(4 bytes @ 0xE000ED30) - Data: 02 00 00 00  returns 0x01 (0000ms, 1419ms total)
T2470 291:510 JLINK_ReadMemU32(0xE0001028, 0x0001 Items, ...) -- CPU_ReadMem(4 bytes @ 0xE0001028) - Data: 00 00 00 00  returns 0x01 (0000ms, 1419ms total)
T2470 291:510 JLINK_ReadMemU32(0xE0001038, 0x0001 Items, ...) -- CPU_ReadMem(4 bytes @ 0xE0001038) - Data: 00 02 00 00  returns 0x01 (0001ms, 1420ms total)
T2470 291:511 JLINK_ReadMemU32(0xE0001048, 0x0001 Items, ...) -- CPU_ReadMem(4 bytes @ 0xE0001048) - Data: 00 00 00 00  returns 0x01 (0000ms, 1420ms total)
T2470 291:511 JLINK_ReadMemU32(0xE0001058, 0x0001 Items, ...) -- CPU_ReadMem(4 bytes @ 0xE0001058) - Data: 00 00 00 00  returns 0x01 (0000ms, 1420ms total)
T2470 291:511 JLINK_ReadReg(R0)  returns 0xC0000000 (0000ms, 1420ms total)
T2470 291:511 JLINK_ReadReg(R1)  returns 0x00000000 (0000ms, 1420ms total)
T2470 291:511 JLINK_ReadReg(R2)  returns 0x00000000 (0000ms, 1420ms total)
T2470 291:511 JLINK_ReadReg(R3)  returns 0x00000000 (0000ms, 1420ms total)
T2470 291:511 JLINK_ReadReg(R4)  returns 0x20000000 (0000ms, 1420ms total)
T2470 291:511 JLINK_ReadReg(R5)  returns 0x00000003 (0000ms, 1420ms total)
T2470 291:511 JLINK_ReadReg(R6)  returns 0x00000000 (0000ms, 1420ms total)
T2470 291:511 JLINK_ReadReg(R7)  returns 0x00000000 (0000ms, 1420ms total)
T2470 291:511 JLINK_ReadReg(R8)  returns 0x20001FBC (0000ms, 1420ms total)
T2470 291:511 JLINK_ReadReg(R9)  returns 0x0000C350 (0000ms, 1420ms total)
T2470 291:511 JLINK_ReadReg(R10)  returns 0x000003E8 (0000ms, 1420ms total)
T2470 291:511 JLINK_ReadReg(R11)  returns 0x00000001 (0000ms, 1420ms total)
T2470 291:511 JLINK_ReadReg(R12)  returns 0x00000000 (0000ms, 1420ms total)
T2470 291:511 JLINK_ReadReg(R13 (SP))  returns 0x20002928 (0000ms, 1420ms total)
T2470 291:511 JLINK_ReadReg(R14)  returns 0xFFFFFFF9 (0000ms, 1420ms total)
T2470 291:511 JLINK_ReadReg(R15 (PC))  returns 0x080045EC (0000ms, 1420ms total)
T2470 291:511 JLINK_ReadReg(XPSR)  returns 0xA1000035 (0000ms, 1420ms total)
T2470 291:511 JLINK_ReadReg(MSP)  returns 0x20002928 (0000ms, 1420ms total)
T2470 291:511 JLINK_ReadReg(PSP)  returns 0xAEAA5364 (0000ms, 1420ms total)
T2470 291:511 JLINK_ReadReg(CFBP)  returns 0x00000000 (0000ms, 1420ms total)
T4118 291:511 JLINK_ReadMemEx(0x20002940, 0x0004 Bytes, ..., Flags = 0x02000000) -- CPU_ReadMem(64 bytes @ 0x20002940) -- Updating C cache (64 bytes @ 0x20002940) -- Read from C cache (4 bytes @ 0x20002940) - Data: 40 50 00 08  returns 0x04 (0002ms, 1422ms total)
T4118 291:513 JLINK_ReadMemEx(0x20002944, 0x0004 Bytes, ..., Flags = 0x02000000) -- Read from C cache (4 bytes @ 0x20002944) - Data: 00 00 00 41  returns 0x04 (0000ms, 1422ms total)
T4118 291:513 JLINK_ReadMemEx(0x2000293C, 0x0004 Bytes, ..., Flags = 0x02000000) -- CPU_ReadMem(64 bytes @ 0x20002900) -- Updating C cache (64 bytes @ 0x20002900) -- Read from C cache (4 bytes @ 0x2000293C) - Data: 47 50 00 08  returns 0x04 (0000ms, 1422ms total)
T4118 291:513 JLINK_ReadMemEx(0xE000ED28, 0x0004 Bytes, ..., Flags = 0x02000000) -- CPU_ReadMem(4 bytes @ 0xE000ED28) - Data: 00 00 00 00  returns 0x04 (0000ms, 1422ms total)
T4118 291:513 JLINK_ReadMemEx(0x20000024, 0x0002 Bytes, ..., Flags = 0x02000000) -- CPU_ReadMem(64 bytes @ 0x20000000) -- Updating C cache (64 bytes @ 0x20000000) -- Read from C cache (2 bytes @ 0x20000024) - Data: FA FF  returns 0x02 (0001ms, 1423ms total)
T4118 291:517 JLINK_ReadMemEx(0x080045EC, 0x003C Bytes, ..., Flags = 0x02000000) -- CPU_ReadMem(128 bytes @ 0x080045C0) -- Updating C cache (128 bytes @ 0x080045C0) -- Read from C cache (60 bytes @ 0x080045EC) - Data: FF F7 8A BF 70 47 00 00 00 38 01 40 C9 43 01 80 ...  returns 0x3C (0001ms, 1424ms total)
T4118 294:218 JLINK_SetResetType(JLINKARM_CM3_RESET_TYPE_NORMAL)  returns JLINKARM_CM3_RESET_TYPE_NORMAL (0000ms, 1424ms total)
T4118 294:218 JLINK_Reset() -- CPU_WriteMem(4 bytes @ 0xE000EDF0) -- CPU_WriteMem(4 bytes @ 0xE000EDFC)Reset: Halt core after reset via DEMCR.VC_CORERESET. >0x35 TIF>Reset: Reset device via AIRCR.SYSRESETREQ. -- CPU_WriteMem(4 bytes @ 0xE000ED0C) >0x0D TIF> >0x28 TIF> -- CPU_ReadMem(4 bytes @ 0xE000EDF0) -- CPU_ReadMem(4 bytes @ 0xE000EDF0) -- CPU_WriteMem(4 bytes @ 0xE000EDF0) -- CPU_WriteMem(4 bytes @ 0xE000EDFC) -- CPU_ReadMem(4 bytes @ 0xE000EDF0) -- CPU_WriteMem(4 bytes @ 0xE0002000)
 -- CPU_ReadMem(4 bytes @ 0xE000EDFC) -- CPU_ReadMem(4 bytes @ 0xE0001000) (0065ms, 1489ms total)
T4118 294:283 JLINK_ReadReg(R15 (PC))  returns 0x080001A8 (0000ms, 1489ms total)
T4118 294:283 JLINK_ReadReg(XPSR)  returns 0x01000000 (0001ms, 1490ms total)
T4118 294:284 JLINK_ReadMemEx(0x080001A8, 0x003C Bytes, ..., Flags = 0x02000000) -- CPU_ReadMem(128 bytes @ 0x08000180) -- Updating C cache (128 bytes @ 0x08000180) -- Read from C cache (60 bytes @ 0x080001A8) - Data: 09 48 80 47 09 48 00 47 FE E7 FE E7 FE E7 FE E7 ...  returns 0x3C (0001ms, 1491ms total)
T4118 294:373 JLINK_ReadReg(R0)  returns 0xC0000000 (0000ms, 1491ms total)
T4118 294:373 JLINK_ReadReg(R1)  returns 0x00000000 (0000ms, 1491ms total)
T4118 294:373 JLINK_ReadReg(R2)  returns 0x00000000 (0000ms, 1491ms total)
T4118 294:373 JLINK_ReadReg(R3)  returns 0x00000000 (0000ms, 1491ms total)
T4118 294:373 JLINK_ReadReg(R4)  returns 0x20000000 (0000ms, 1491ms total)
T4118 294:373 JLINK_ReadReg(R5)  returns 0x00000003 (0000ms, 1491ms total)
T4118 294:373 JLINK_ReadReg(R6)  returns 0x00000000 (0000ms, 1491ms total)
T4118 294:373 JLINK_ReadReg(R7)  returns 0x00000000 (0000ms, 1491ms total)
T4118 294:373 JLINK_ReadReg(R8)  returns 0x20001FBC (0000ms, 1491ms total)
T4118 294:373 JLINK_ReadReg(R9)  returns 0x0000C350 (0000ms, 1491ms total)
T4118 294:373 JLINK_ReadReg(R10)  returns 0x000003E8 (0000ms, 1491ms total)
T4118 294:373 JLINK_ReadReg(R11)  returns 0x00000001 (0000ms, 1491ms total)
T4118 294:373 JLINK_ReadReg(R12)  returns 0x00000000 (0000ms, 1491ms total)
T4118 294:373 JLINK_ReadReg(R13 (SP))  returns 0x20002948 (0000ms, 1491ms total)
T4118 294:373 JLINK_ReadReg(R14)  returns 0xFFFFFFFF (0000ms, 1491ms total)
T4118 294:373 JLINK_ReadReg(R15 (PC))  returns 0x080001A8 (0000ms, 1491ms total)
T4118 294:373 JLINK_ReadReg(XPSR)  returns 0x01000000 (0000ms, 1491ms total)
T4118 294:373 JLINK_ReadReg(MSP)  returns 0x20002948 (0000ms, 1491ms total)
T4118 294:373 JLINK_ReadReg(PSP)  returns 0xAEAA5364 (0000ms, 1491ms total)
T4118 294:373 JLINK_ReadReg(CFBP)  returns 0x00000000 (0000ms, 1491ms total)
T4118 294:373 JLINK_ReadMemEx(0x20000024, 0x0002 Bytes, ..., Flags = 0x02000000) -- CPU_ReadMem(64 bytes @ 0x20000000) -- Updating C cache (64 bytes @ 0x20000000) -- Read from C cache (2 bytes @ 0x20000024) - Data: FA FF  returns 0x02 (0001ms, 1492ms total)
T2470 294:708 JLINK_ReadMemEx(0x080001A8, 0x0002 Bytes, ..., Flags = 0x02000000) -- Read from C cache (2 bytes @ 0x080001A8) - Data: 09 48  returns 0x02 (0000ms, 1492ms total)
T2470 294:708 JLINK_SetBPEx(Addr = 0x0800456A, Type = 0xFFFFFFF2)  returns 0x00000007 (0000ms, 1492ms total)
T2470 294:708 JLINK_SetBPEx(Addr = 0x0800215E, Type = 0xFFFFFFF2)  returns 0x00000008 (0000ms, 1492ms total)
T2470 294:708 JLINK_SetBPEx(Addr = 0x08002164, Type = 0xFFFFFFF2)  returns 0x00000009 (0000ms, 1492ms total)
T2470 294:708 JLINK_Go() -- CPU_WriteMem(4 bytes @ 0xE0002000) -- CPU_WriteMem(4 bytes @ 0xE0002000) -- CPU_WriteMem(4 bytes @ 0xE0002000) -- CPU_ReadMem(4 bytes @ 0xE0001000) -- CPU_WriteMem(4 bytes @ 0xE0002008) -- CPU_WriteMem(4 bytes @ 0xE000200C) -- CPU_WriteMem(4 bytes @ 0xE0002010) -- CPU_WriteMem(4 bytes @ 0xE0002014) -- CPU_WriteMem(4 bytes @ 0xE0002018) -- CPU_WriteMem(4 bytes @ 0xE000201C) -- CPU_WriteMem(4 bytes @ 0xE0001004) (0003ms, 1495ms total)
T2470 294:812 JLINK_IsHalted()  returns FALSE (0000ms, 1495ms total)
T2470 294:912 JLINK_IsHalted()  returns FALSE (0000ms, 1495ms total)
T2470 295:013 JLINK_IsHalted()  returns FALSE (0000ms, 1495ms total)
T2470 295:114 JLINK_IsHalted()  returns FALSE (0000ms, 1495ms total)
T2470 295:215 JLINK_IsHalted()  returns FALSE (0000ms, 1495ms total)
T2470 295:316 JLINK_IsHalted()  returns FALSE (0000ms, 1495ms total)
T2470 295:417 JLINK_IsHalted()  returns FALSE (0000ms, 1495ms total)
T2470 295:518 JLINK_IsHalted()  returns FALSE (0000ms, 1495ms total)
T2470 295:620 JLINK_IsHalted()  returns FALSE (0000ms, 1495ms total)
T2470 295:720 JLINK_IsHalted()  returns FALSE (0000ms, 1495ms total)
T2470 295:822 JLINK_IsHalted()  returns FALSE (0000ms, 1495ms total)
T2470 295:923 JLINK_IsHalted()  returns FALSE (0000ms, 1495ms total)
T2470 296:024 JLINK_IsHalted()  returns FALSE (0000ms, 1495ms total)
T2470 296:125 JLINK_IsHalted()  returns FALSE (0000ms, 1495ms total)
T2470 296:226 JLINK_IsHalted()  returns FALSE (0000ms, 1495ms total)
T2470 296:327 JLINK_IsHalted()  returns FALSE (0000ms, 1495ms total)
T2470 296:427 JLINK_IsHalted()  returns FALSE (0000ms, 1495ms total)
T2470 296:528 JLINK_IsHalted()  returns FALSE (0000ms, 1495ms total)
T2470 296:629 JLINK_IsHalted()  returns FALSE (0000ms, 1495ms total)
T2470 296:730 JLINK_IsHalted()  returns FALSE (0000ms, 1495ms total)
T2470 296:830 JLINK_IsHalted()  returns FALSE (0000ms, 1495ms total)
T2470 296:931 JLINK_IsHalted()  returns FALSE (0000ms, 1495ms total)
T2470 297:032 JLINK_IsHalted()  returns FALSE (0000ms, 1495ms total)
T2470 297:132 JLINK_IsHalted()  returns FALSE (0000ms, 1495ms total)
T2470 297:233 JLINK_IsHalted()  returns FALSE (0000ms, 1495ms total)
T2470 297:334 JLINK_IsHalted()  returns FALSE (0000ms, 1495ms total)
T2470 297:435 JLINK_IsHalted()  returns FALSE (0000ms, 1495ms total)
T2470 297:535 JLINK_IsHalted()  returns FALSE (0000ms, 1495ms total)
T2470 297:636 JLINK_IsHalted()  returns FALSE (0000ms, 1495ms total)
T2470 297:737 JLINK_IsHalted()  returns FALSE (0000ms, 1495ms total)
T2470 297:838 JLINK_IsHalted()  returns FALSE (0000ms, 1495ms total)
T2470 297:938 JLINK_IsHalted()  returns FALSE (0000ms, 1495ms total)
T2470 298:039 JLINK_IsHalted()  returns FALSE (0000ms, 1495ms total)
T2470 298:140 JLINK_IsHalted()  returns FALSE (0000ms, 1495ms total)
T2470 298:241 JLINK_IsHalted()  returns FALSE (0000ms, 1495ms total)
T2470 298:341 JLINK_IsHalted()  returns FALSE (0000ms, 1495ms total)
T2470 298:442 JLINK_IsHalted()  returns FALSE (0000ms, 1495ms total)
T2470 298:543 JLINK_IsHalted()  returns FALSE (0000ms, 1495ms total)
T2470 298:643 JLINK_IsHalted()  returns FALSE (0000ms, 1495ms total)
T2470 298:744 JLINK_IsHalted()  returns FALSE (0000ms, 1495ms total)
T2470 298:845 JLINK_IsHalted()  returns FALSE (0000ms, 1495ms total)
T2470 298:946 JLINK_IsHalted()  returns FALSE (0000ms, 1495ms total)
T2470 299:047 JLINK_IsHalted()  returns FALSE (0000ms, 1495ms total)
T2470 299:147 JLINK_IsHalted()  returns FALSE (0000ms, 1495ms total)
T2470 299:248 JLINK_IsHalted()  returns FALSE (0000ms, 1495ms total)
T2470 299:349 JLINK_IsHalted()  returns FALSE (0000ms, 1495ms total)
T2470 299:449 JLINK_IsHalted()  returns FALSE (0000ms, 1495ms total)
T2470 299:550 JLINK_IsHalted()  returns FALSE (0000ms, 1495ms total)
T2470 299:651 JLINK_IsHalted()  returns FALSE (0000ms, 1495ms total)
T2470 299:752 JLINK_IsHalted()  returns FALSE (0000ms, 1495ms total)
T2470 299:853 JLINK_IsHalted()  returns FALSE (0000ms, 1495ms total)
T2470 299:954 JLINK_IsHalted()  returns FALSE (0000ms, 1495ms total)
T2470 300:055 JLINK_IsHalted()  returns FALSE (0000ms, 1495ms total)
T2470 300:156 JLINK_IsHalted()  returns FALSE (0000ms, 1495ms total)
T2470 300:256 JLINK_IsHalted()  returns FALSE (0000ms, 1495ms total)
T2470 300:357 JLINK_IsHalted()  returns FALSE (0000ms, 1495ms total)
T2470 300:458 JLINK_IsHalted()  returns FALSE (0000ms, 1495ms total)
T2470 300:558 JLINK_IsHalted()  returns FALSE (0000ms, 1495ms total)
T2470 300:659 JLINK_IsHalted()  returns FALSE (0000ms, 1495ms total)
T2470 300:760 JLINK_IsHalted()  returns FALSE (0000ms, 1495ms total)
T2470 300:861 JLINK_IsHalted()  returns FALSE (0000ms, 1495ms total)
T2470 300:962 JLINK_IsHalted()  returns FALSE (0000ms, 1495ms total)
T2470 301:063 JLINK_IsHalted()  returns FALSE (0000ms, 1495ms total)
T2470 301:164 JLINK_IsHalted()  returns FALSE (0000ms, 1495ms total)
T2470 301:265 JLINK_IsHalted()  returns FALSE (0000ms, 1495ms total)
T2470 301:365 JLINK_IsHalted()  returns FALSE (0000ms, 1495ms total)
T2470 301:467 JLINK_IsHalted()  returns FALSE (0000ms, 1495ms total)
T2470 301:568 JLINK_IsHalted()  returns FALSE (0000ms, 1495ms total)
T2470 301:668 JLINK_IsHalted()  returns FALSE (0000ms, 1495ms total)
T2470 301:769 JLINK_IsHalted()  returns FALSE (0000ms, 1495ms total)
T2470 301:870 JLINK_IsHalted()  returns FALSE (0000ms, 1495ms total)
T2470 301:971 JLINK_IsHalted()  returns FALSE (0000ms, 1495ms total)
T2470 302:071 JLINK_IsHalted()  returns FALSE (0000ms, 1495ms total)
T2470 302:172 JLINK_IsHalted()  returns FALSE (0000ms, 1495ms total)
T2470 302:274 JLINK_IsHalted()  returns FALSE (0000ms, 1495ms total)
T2470 302:375 JLINK_IsHalted()  returns FALSE (0000ms, 1495ms total)
T2470 302:475 JLINK_IsHalted()  returns FALSE (0000ms, 1495ms total)
T2470 302:576 JLINK_IsHalted()  returns FALSE (0000ms, 1495ms total)
T2470 302:678 JLINK_IsHalted()  returns FALSE (0000ms, 1495ms total)
T2470 302:779 JLINK_IsHalted()  returns FALSE (0000ms, 1495ms total)
T2470 302:879 JLINK_IsHalted()  returns FALSE (0000ms, 1495ms total)
T2470 302:980 JLINK_IsHalted()  returns FALSE (0000ms, 1495ms total)
T2470 303:081 JLINK_IsHalted()  returns FALSE (0000ms, 1495ms total)
T2470 303:182 JLINK_IsHalted()  returns FALSE (0000ms, 1495ms total)
T2470 303:283 JLINK_IsHalted()  returns FALSE (0000ms, 1495ms total)
T2470 303:384 JLINK_IsHalted()  returns FALSE (0000ms, 1495ms total)
T2470 303:485 JLINK_IsHalted()  returns FALSE (0000ms, 1495ms total)
T2470 303:585 JLINK_IsHalted()  returns FALSE (0000ms, 1495ms total)
T2470 303:686 JLINK_IsHalted()  returns FALSE (0000ms, 1495ms total)
T2470 303:787 JLINK_IsHalted()  returns FALSE (0000ms, 1495ms total)
T2470 303:888 JLINK_IsHalted()  returns FALSE (0000ms, 1495ms total)
T2470 303:988 JLINK_IsHalted()  returns FALSE (0000ms, 1495ms total)
T2470 304:090 JLINK_IsHalted()  returns FALSE (0000ms, 1495ms total)
T2470 304:191 JLINK_IsHalted()  returns FALSE (0000ms, 1495ms total)
T2470 304:291 JLINK_IsHalted()  returns FALSE (0000ms, 1495ms total)
T2470 304:392 JLINK_IsHalted()  returns FALSE (0000ms, 1495ms total)
T2470 304:494 JLINK_IsHalted()  returns FALSE (0000ms, 1495ms total)
T2470 304:595 JLINK_IsHalted()  returns FALSE (0000ms, 1495ms total)
T2470 304:696 JLINK_IsHalted()  returns FALSE (0000ms, 1495ms total)
T2470 304:797 JLINK_IsHalted()  returns FALSE (0000ms, 1495ms total)
T2470 304:899 JLINK_IsHalted()  returns FALSE (0000ms, 1495ms total)
T2470 305:000 JLINK_IsHalted()  returns FALSE (0000ms, 1495ms total)
T2470 305:101 JLINK_IsHalted()  returns FALSE (0000ms, 1495ms total)
T2470 305:202 JLINK_IsHalted()  returns FALSE (0000ms, 1495ms total)
T2470 305:304 JLINK_IsHalted()  returns FALSE (0000ms, 1495ms total)
T2470 305:404 JLINK_IsHalted()  returns FALSE (0000ms, 1495ms total)
T2470 305:505 JLINK_IsHalted()  returns FALSE (0000ms, 1495ms total)
T2470 305:606 JLINK_IsHalted()  returns FALSE (0000ms, 1495ms total)
T2470 305:707 JLINK_IsHalted()  returns FALSE (0000ms, 1495ms total)
T2470 305:807 JLINK_IsHalted()  returns FALSE (0000ms, 1495ms total)
T2470 305:908 JLINK_IsHalted()  returns FALSE (0000ms, 1495ms total)
T2470 306:010 JLINK_IsHalted()  returns FALSE (0000ms, 1495ms total)
T2470 306:112 JLINK_IsHalted()  returns FALSE (0000ms, 1495ms total)
T4118 306:115 JLINK_ClrBPEx(BPHandle = 0x00000007) -- CPU is running -- CPU is running -- CPU_WriteMem(4 bytes @ 0xE0002000) -- CPU is running -- CPU_WriteMem(4 bytes @ 0xE000200C) -- CPU is running -- CPU_WriteMem(4 bytes @ 0xE0002008) -- CPU is running -- CPU_WriteMem(4 bytes @ 0xE0002000) -- CPU is running -- CPU_WriteMem(4 bytes @ 0xE0002010) -- CPU is running -- CPU_WriteMem(4 bytes @ 0xE000200C) -- CPU is running -- CPU_WriteMem(4 bytes @ 0xE0002008) -- CPU is running
 -- CPU_WriteMem(4 bytes @ 0xE000200C) -- CPU is running -- CPU_WriteMem(4 bytes @ 0xE0002010) -- CPU is running -- CPU_WriteMem(4 bytes @ 0xE0002014) -- CPU is running -- CPU_WriteMem(4 bytes @ 0xE0002018) -- CPU is running -- CPU_WriteMem(4 bytes @ 0xE000201C)  returns 0x00 (0003ms, 1498ms total)
T2470 306:213 JLINK_IsHalted()  returns FALSE (0000ms, 1498ms total)
T2470 306:314 JLINK_IsHalted()  returns FALSE (0000ms, 1498ms total)
T2470 306:416 JLINK_IsHalted()  returns FALSE (0000ms, 1498ms total)
T2470 306:517 JLINK_IsHalted()  returns FALSE (0000ms, 1498ms total)
T2470 306:618 JLINK_IsHalted()  returns FALSE (0000ms, 1498ms total)
T2470 306:719 JLINK_IsHalted()  returns FALSE (0000ms, 1498ms total)
T2470 306:820 JLINK_IsHalted()  returns FALSE (0000ms, 1498ms total)
T2470 306:921 JLINK_IsHalted()  returns FALSE (0000ms, 1498ms total)
T2470 307:021 JLINK_IsHalted()  returns FALSE (0000ms, 1498ms total)
T2470 307:122 JLINK_IsHalted()  returns FALSE (0000ms, 1498ms total)
T2470 307:223 JLINK_IsHalted()  returns FALSE (0000ms, 1498ms total)
T2470 307:323 JLINK_IsHalted()  returns FALSE (0000ms, 1498ms total)
T2470 307:424 JLINK_IsHalted()  returns FALSE (0000ms, 1498ms total)
T2470 307:526 JLINK_IsHalted()  returns FALSE (0000ms, 1498ms total)
T2470 307:626 JLINK_IsHalted()  returns FALSE (0000ms, 1498ms total)
T2470 307:727 JLINK_IsHalted()  returns FALSE (0000ms, 1498ms total)
T2470 307:828 JLINK_IsHalted()  returns FALSE (0000ms, 1498ms total)
T2470 307:929 JLINK_IsHalted()  returns FALSE (0000ms, 1498ms total)
T2470 308:030 JLINK_IsHalted()  returns FALSE (0000ms, 1498ms total)
T2470 308:131 JLINK_IsHalted()  returns FALSE (0000ms, 1498ms total)
T2470 308:233 JLINK_IsHalted()  returns FALSE (0000ms, 1498ms total)
T2470 308:334 JLINK_IsHalted()  returns FALSE (0000ms, 1498ms total)
T2470 308:435 JLINK_IsHalted()  returns FALSE (0000ms, 1498ms total)
T2470 308:536 JLINK_IsHalted()  returns FALSE (0000ms, 1498ms total)
T2470 308:637 JLINK_IsHalted()  returns FALSE (0000ms, 1498ms total)
T2470 308:738 JLINK_IsHalted()  returns FALSE (0000ms, 1498ms total)
T2470 308:839 JLINK_IsHalted()  returns FALSE (0000ms, 1498ms total)
T2470 308:940 JLINK_IsHalted()  returns FALSE (0000ms, 1498ms total)
T2470 309:041 JLINK_IsHalted()  returns FALSE (0000ms, 1498ms total)
T2470 309:142 JLINK_IsHalted()  returns FALSE (0000ms, 1498ms total)
T2470 309:242 JLINK_IsHalted()  returns FALSE (0000ms, 1498ms total)
T2470 309:343 JLINK_IsHalted()  returns FALSE (0000ms, 1498ms total)
T2470 309:445 JLINK_IsHalted()  returns FALSE (0000ms, 1498ms total)
T2470 309:545 JLINK_IsHalted()  returns FALSE (0000ms, 1498ms total)
T2470 309:647 JLINK_IsHalted()  returns FALSE (0000ms, 1498ms total)
T2470 309:748 JLINK_IsHalted()  returns FALSE (0000ms, 1498ms total)
T2470 309:848 JLINK_IsHalted()  returns FALSE (0000ms, 1498ms total)
T2470 309:949 JLINK_IsHalted()  returns FALSE (0000ms, 1498ms total)
T2470 310:050 JLINK_IsHalted()  returns FALSE (0000ms, 1498ms total)
T2470 310:152 JLINK_IsHalted()  returns FALSE (0000ms, 1498ms total)
T2470 310:253 JLINK_IsHalted()  returns FALSE (0000ms, 1498ms total)
T2470 310:353 JLINK_IsHalted()  returns FALSE (0000ms, 1498ms total)
T2470 310:454 JLINK_IsHalted()  returns FALSE (0000ms, 1498ms total)
T2470 310:556 JLINK_IsHalted()  returns FALSE (0000ms, 1498ms total)
T2470 310:656 JLINK_IsHalted()  returns FALSE (0000ms, 1498ms total)
T2470 310:757 JLINK_IsHalted()  returns FALSE (0000ms, 1498ms total)
T2470 310:858 JLINK_IsHalted()  returns FALSE (0000ms, 1498ms total)
T2470 310:959 JLINK_IsHalted()  returns FALSE (0000ms, 1498ms total)
T2470 311:059 JLINK_IsHalted()  returns FALSE (0000ms, 1498ms total)
T2470 311:160 JLINK_IsHalted()  returns FALSE (0000ms, 1498ms total)
T2470 311:261 JLINK_IsHalted()  returns FALSE (0000ms, 1498ms total)
T2470 311:362 JLINK_IsHalted()  returns FALSE (0000ms, 1498ms total)
T2470 311:462 JLINK_IsHalted()  returns FALSE (0000ms, 1498ms total)
T2470 311:563 JLINK_IsHalted()  returns FALSE (0000ms, 1498ms total)
T2470 311:664 JLINK_IsHalted()  returns FALSE (0000ms, 1498ms total)
T2470 311:765 JLINK_IsHalted()  returns FALSE (0000ms, 1498ms total)
T2470 311:865 JLINK_IsHalted()  returns FALSE (0000ms, 1498ms total)
T2470 311:966 JLINK_IsHalted()  returns FALSE (0000ms, 1498ms total)
T2470 312:067 JLINK_IsHalted()  returns FALSE (0000ms, 1498ms total)
T2470 312:167 JLINK_IsHalted()  returns FALSE (0000ms, 1498ms total)
T2470 312:269 JLINK_IsHalted()  returns FALSE (0000ms, 1498ms total)
T2470 312:370 JLINK_IsHalted()  returns FALSE (0000ms, 1498ms total)
T2470 312:471 JLINK_IsHalted()  returns FALSE (0000ms, 1498ms total)
T2470 312:571 JLINK_IsHalted()  returns FALSE (0000ms, 1498ms total)
T2470 312:672 JLINK_IsHalted()  returns FALSE (0000ms, 1498ms total)
T2470 312:774 JLINK_IsHalted()  returns FALSE (0000ms, 1498ms total)
T2470 312:874 JLINK_IsHalted()  returns FALSE (0000ms, 1498ms total)
T2470 312:975 JLINK_IsHalted()  returns FALSE (0000ms, 1498ms total)
T2470 313:076 JLINK_IsHalted()  returns FALSE (0000ms, 1498ms total)
T2470 313:177 JLINK_IsHalted()  returns FALSE (0000ms, 1498ms total)
T2470 313:278 JLINK_IsHalted()  returns FALSE (0000ms, 1498ms total)
T2470 313:379 JLINK_IsHalted()  returns FALSE (0000ms, 1498ms total)
T2470 313:480 JLINK_IsHalted()  returns FALSE (0000ms, 1498ms total)
T2470 313:581 JLINK_IsHalted()  returns FALSE (0000ms, 1498ms total)
T2470 313:682 JLINK_IsHalted()  returns FALSE (0000ms, 1498ms total)
T2470 313:783 JLINK_IsHalted()  returns FALSE (0000ms, 1498ms total)
T2470 313:884 JLINK_IsHalted()  returns FALSE (0000ms, 1498ms total)
T2470 313:985 JLINK_IsHalted()  returns FALSE (0000ms, 1498ms total)
T2470 314:085 JLINK_IsHalted()  returns FALSE (0000ms, 1498ms total)
T2470 314:186 JLINK_IsHalted()  returns FALSE (0000ms, 1498ms total)
T2470 314:288 JLINK_IsHalted()  returns FALSE (0000ms, 1498ms total)
T2470 314:389 JLINK_IsHalted()  returns FALSE (0000ms, 1498ms total)
T2470 314:489 JLINK_IsHalted()  returns FALSE (0000ms, 1498ms total)
T2470 314:590 JLINK_IsHalted()  returns FALSE (0000ms, 1498ms total)
T2470 314:691 JLINK_IsHalted()  returns FALSE (0000ms, 1498ms total)
T2470 314:791 JLINK_IsHalted()  returns FALSE (0000ms, 1498ms total)
T4118 314:881 JLINK_ReadMemEx(0x20002214, 0x0001 Bytes, ..., Flags = 0x02000000) -- CPU_ReadMem(1 bytes @ 0x20002214) - Data: 00  returns 0x01 (0000ms, 1498ms total)
T4118 314:881 JLINK_ReadMemEx(0x20002194, 0x0001 Bytes, ..., Flags = 0x02000000) -- CPU_ReadMem(1 bytes @ 0x20002194) - Data: 00  returns 0x01 (0001ms, 1499ms total)
T2470 314:892 JLINK_IsHalted()  returns FALSE (0000ms, 1499ms total)
T2470 314:993 JLINK_IsHalted()  returns FALSE (0000ms, 1499ms total)
T2470 315:094 JLINK_IsHalted()  returns FALSE (0000ms, 1499ms total)
T4118 315:191 JLINK_ReadMemEx(0x20002214, 0x0001 Bytes, ..., Flags = 0x02000000) -- CPU_ReadMem(1 bytes @ 0x20002214) - Data: 00  returns 0x01 (0001ms, 1500ms total)
T4118 315:192 JLINK_ReadMemEx(0x20002194, 0x0001 Bytes, ..., Flags = 0x02000000) -- CPU_ReadMem(1 bytes @ 0x20002194) - Data: 00  returns 0x01 (0000ms, 1500ms total)
T2470 315:194 JLINK_IsHalted()  returns FALSE (0000ms, 1500ms total)
T2470 315:295 JLINK_IsHalted()  returns FALSE (0000ms, 1500ms total)
T2470 315:397 JLINK_IsHalted()  returns FALSE (0000ms, 1500ms total)
T2470 315:498 JLINK_IsHalted()  returns FALSE (0000ms, 1500ms total)
T2470 315:599 JLINK_IsHalted()  returns FALSE (0000ms, 1500ms total)
T2470 315:700 JLINK_IsHalted()  returns FALSE (0000ms, 1500ms total)
T2470 315:801 JLINK_IsHalted()  returns FALSE (0000ms, 1500ms total)
T2470 315:901 JLINK_IsHalted()  returns FALSE (0000ms, 1500ms total)
T2470 316:002 JLINK_IsHalted()  returns FALSE (0000ms, 1500ms total)
T2470 316:104 JLINK_IsHalted()  returns FALSE (0000ms, 1500ms total)
T2470 316:205 JLINK_IsHalted()  returns FALSE (0000ms, 1500ms total)
T2470 316:305 JLINK_IsHalted()  returns FALSE (0000ms, 1500ms total)
T2470 316:406 JLINK_IsHalted()  returns FALSE (0000ms, 1500ms total)
T2470 316:507 JLINK_IsHalted()  returns FALSE (0000ms, 1500ms total)
T2470 316:608 JLINK_IsHalted()  returns FALSE (0000ms, 1500ms total)
T2470 316:708 JLINK_IsHalted()  returns FALSE (0000ms, 1500ms total)
T2470 316:809 JLINK_IsHalted()  returns FALSE (0000ms, 1500ms total)
T2470 316:910 JLINK_IsHalted()  returns FALSE (0000ms, 1500ms total)
T2470 317:012 JLINK_IsHalted()  returns FALSE (0000ms, 1500ms total)
T2470 317:112 JLINK_IsHalted()  returns FALSE (0000ms, 1500ms total)
T2470 317:213 JLINK_IsHalted()  returns FALSE (0000ms, 1500ms total)
T2470 317:314 JLINK_IsHalted()  returns FALSE (0000ms, 1500ms total)
T2470 317:414 JLINK_IsHalted()  returns FALSE (0000ms, 1500ms total)
T2470 317:515 JLINK_IsHalted()  returns FALSE (0000ms, 1500ms total)
T2470 317:616 JLINK_IsHalted()  returns FALSE (0000ms, 1500ms total)
T2470 317:717 JLINK_IsHalted()  returns FALSE (0000ms, 1500ms total)
T2470 317:818 JLINK_IsHalted()  returns FALSE (0000ms, 1500ms total)
T2470 317:919 JLINK_IsHalted()  returns FALSE (0000ms, 1500ms total)
T2470 318:020 JLINK_IsHalted()  returns FALSE (0000ms, 1500ms total)
T2470 318:120 JLINK_IsHalted()  returns FALSE (0000ms, 1500ms total)
T2470 318:221 JLINK_IsHalted()  returns FALSE (0000ms, 1500ms total)
T2470 318:322 JLINK_IsHalted()  returns FALSE (0000ms, 1500ms total)
T2470 318:423 JLINK_IsHalted()  returns FALSE (0000ms, 1500ms total)
T2470 318:523 JLINK_IsHalted()  returns FALSE (0000ms, 1500ms total)
T2470 318:624 JLINK_IsHalted()  returns FALSE (0000ms, 1500ms total)
T2470 318:725 JLINK_IsHalted()  returns FALSE (0000ms, 1500ms total)
T2470 318:826 JLINK_IsHalted()  returns FALSE (0000ms, 1500ms total)
T2470 318:926 JLINK_IsHalted()  returns FALSE (0000ms, 1500ms total)
T2470 319:027 JLINK_IsHalted()  returns FALSE (0000ms, 1500ms total)
T2470 319:128 JLINK_IsHalted()  returns FALSE (0000ms, 1500ms total)
T2470 319:228 JLINK_IsHalted()  returns FALSE (0000ms, 1500ms total)
T2470 319:329 JLINK_IsHalted()  returns FALSE (0000ms, 1500ms total)
T2470 319:431 JLINK_IsHalted()  returns FALSE (0000ms, 1500ms total)
T2470 319:532 JLINK_IsHalted()  returns FALSE (0000ms, 1500ms total)
T2470 319:632 JLINK_IsHalted()  returns FALSE (0000ms, 1500ms total)
T2470 319:733 JLINK_IsHalted()  returns FALSE (0000ms, 1500ms total)
T2470 319:834 JLINK_IsHalted()  returns FALSE (0000ms, 1500ms total)
T2470 319:935 JLINK_IsHalted()  returns FALSE (0000ms, 1500ms total)
T2470 320:035 JLINK_IsHalted()  returns FALSE (0000ms, 1500ms total)
T2470 320:136 JLINK_IsHalted()  returns FALSE (0000ms, 1500ms total)
T2470 320:237 JLINK_IsHalted()  returns FALSE (0000ms, 1500ms total)
T2470 320:339 JLINK_IsHalted()  returns FALSE (0000ms, 1500ms total)
T2470 320:439 JLINK_IsHalted()  returns FALSE (0000ms, 1500ms total)
T2470 320:540 JLINK_IsHalted()  returns FALSE (0000ms, 1500ms total)
T2470 320:641 JLINK_IsHalted()  returns FALSE (0000ms, 1500ms total)
T2470 320:742 JLINK_IsHalted()  returns FALSE (0000ms, 1500ms total)
T2470 320:843 JLINK_IsHalted()  returns FALSE (0000ms, 1500ms total)
T2470 320:945 JLINK_IsHalted()  returns FALSE (0000ms, 1500ms total)
T2470 321:046 JLINK_IsHalted()  returns FALSE (0000ms, 1500ms total)
T2470 321:147 JLINK_IsHalted()  returns FALSE (0000ms, 1500ms total)
T2470 321:248 JLINK_IsHalted()  returns FALSE (0000ms, 1500ms total)
T2470 321:350 JLINK_IsHalted()  returns FALSE (0000ms, 1500ms total)
T2470 321:451 JLINK_IsHalted()  returns FALSE (0000ms, 1500ms total)
T2470 321:552 JLINK_IsHalted()  returns FALSE (0000ms, 1500ms total)
T2470 321:653 JLINK_IsHalted()  returns FALSE (0000ms, 1500ms total)
T2470 321:755 JLINK_IsHalted()  returns FALSE (0000ms, 1500ms total)
T2470 321:856 JLINK_IsHalted()  returns FALSE (0000ms, 1500ms total)
T2470 321:956 JLINK_IsHalted()  returns FALSE (0000ms, 1500ms total)
T2470 322:058 JLINK_IsHalted()  returns FALSE (0000ms, 1500ms total)
T2470 322:159 JLINK_IsHalted()  returns FALSE (0000ms, 1500ms total)
T2470 322:259 JLINK_IsHalted()  returns FALSE (0000ms, 1500ms total)
T2470 322:360 JLINK_IsHalted()  returns FALSE (0000ms, 1500ms total)
T2470 322:461 JLINK_IsHalted()  returns FALSE (0000ms, 1500ms total)
T2470 322:562 JLINK_IsHalted()  returns FALSE (0000ms, 1500ms total)
T2470 322:663 JLINK_IsHalted()  returns FALSE (0000ms, 1500ms total)
T2470 322:764 JLINK_IsHalted()  returns FALSE (0000ms, 1500ms total)
T2470 322:865 JLINK_IsHalted()  returns FALSE (0000ms, 1500ms total)
T2470 322:966 JLINK_IsHalted()  returns FALSE (0000ms, 1500ms total)
T2470 323:066 JLINK_IsHalted()  returns FALSE (0000ms, 1500ms total)
T2470 323:168 JLINK_IsHalted()  returns FALSE (0000ms, 1500ms total)
T2470 323:269 JLINK_IsHalted()  returns FALSE (0000ms, 1500ms total)
T2470 323:370 JLINK_IsHalted()  returns FALSE (0000ms, 1500ms total)
T2470 323:471 JLINK_IsHalted()  returns FALSE (0000ms, 1500ms total)
T2470 323:572 JLINK_IsHalted()  returns FALSE (0000ms, 1500ms total)
T2470 323:674 JLINK_IsHalted()  returns FALSE (0000ms, 1500ms total)
T2470 323:774 JLINK_IsHalted()  returns FALSE (0000ms, 1500ms total)
T2470 323:875 JLINK_IsHalted()  returns FALSE (0000ms, 1500ms total)
T2470 323:976 JLINK_IsHalted()  returns FALSE (0000ms, 1500ms total)
T2470 324:077 JLINK_IsHalted()  returns FALSE (0000ms, 1500ms total)
T2470 324:177 JLINK_IsHalted()  returns FALSE (0000ms, 1500ms total)
T2470 324:279 JLINK_IsHalted()  returns FALSE (0000ms, 1500ms total)
T2470 324:380 JLINK_IsHalted()  returns FALSE (0000ms, 1500ms total)
T2470 324:481 JLINK_IsHalted()  returns FALSE (0000ms, 1500ms total)
T2470 324:581 JLINK_IsHalted()  returns FALSE (0000ms, 1500ms total)
T2470 324:683 JLINK_IsHalted()  returns FALSE (0000ms, 1500ms total)
T2470 324:784 JLINK_IsHalted()  returns FALSE (0000ms, 1500ms total)
T2470 324:885 JLINK_IsHalted()  returns FALSE (0000ms, 1500ms total)
T2470 324:986 JLINK_IsHalted()  returns FALSE (0000ms, 1500ms total)
T2470 325:087 JLINK_IsHalted()  returns FALSE (0000ms, 1500ms total)
T2470 325:188 JLINK_IsHalted()  returns FALSE (0000ms, 1500ms total)
T2470 325:288 JLINK_IsHalted()  returns FALSE (0000ms, 1500ms total)
T2470 325:389 JLINK_IsHalted()  returns FALSE (0000ms, 1500ms total)
T2470 325:490 JLINK_IsHalted()  returns FALSE (0000ms, 1500ms total)
T4118 325:588 JLINK_ReadMemEx(0x20002194, 0x0001 Bytes, ..., Flags = 0x02000000) -- CPU_ReadMem(1 bytes @ 0x20002194) - Data: 00  returns 0x01 (0000ms, 1500ms total)
T4118 325:588 JLINK_ReadMemEx(0x20002195, 0x0001 Bytes, ..., Flags = 0x02000000) -- CPU_ReadMem(1 bytes @ 0x20002195) - Data: 00  returns 0x01 (0001ms, 1501ms total)
T4118 325:589 JLINK_ReadMemEx(0x20002196, 0x0001 Bytes, ..., Flags = 0x02000000) -- CPU_ReadMem(1 bytes @ 0x20002196) - Data: 00  returns 0x01 (0000ms, 1501ms total)
T4118 325:589 JLINK_ReadMemEx(0x20002197, 0x0001 Bytes, ..., Flags = 0x02000000) -- CPU_ReadMem(1 bytes @ 0x20002197) - Data: 00  returns 0x01 (0000ms, 1501ms total)
T4118 325:589 JLINK_ReadMemEx(0x20002198, 0x0001 Bytes, ..., Flags = 0x02000000) -- CPU_ReadMem(1 bytes @ 0x20002198) - Data: 00  returns 0x01 (0001ms, 1502ms total)
T4118 325:590 JLINK_ReadMemEx(0x20002199, 0x0001 Bytes, ..., Flags = 0x02000000) -- CPU_ReadMem(1 bytes @ 0x20002199) - Data: 00  returns 0x01 (0000ms, 1502ms total)
T4118 325:590 JLINK_ReadMemEx(0x2000219A, 0x0001 Bytes, ..., Flags = 0x02000000) -- CPU_ReadMem(1 bytes @ 0x2000219A) - Data: 00  returns 0x01 (0000ms, 1502ms total)
T4118 325:590 JLINK_ReadMemEx(0x2000219B, 0x0001 Bytes, ..., Flags = 0x02000000) -- CPU_ReadMem(1 bytes @ 0x2000219B) - Data: 00  returns 0x01 (0001ms, 1503ms total)
T4118 325:591 JLINK_ReadMemEx(0x2000219C, 0x0001 Bytes, ..., Flags = 0x02000000) -- CPU_ReadMem(1 bytes @ 0x2000219C) - Data: 00  returns 0x01 (0000ms, 1503ms total)
T4118 325:591 JLINK_ReadMemEx(0x2000219D, 0x0001 Bytes, ..., Flags = 0x02000000) -- CPU_ReadMem(1 bytes @ 0x2000219D) - Data: 00  returns 0x01 (0000ms, 1503ms total)
T2470 325:591 JLINK_IsHalted()  returns FALSE (0000ms, 1503ms total)
T4118 325:591 JLINK_ReadMemEx(0x2000219E, 0x0001 Bytes, ..., Flags = 0x02000000) -- CPU_ReadMem(1 bytes @ 0x2000219E) - Data: 00  returns 0x01 (0001ms, 1504ms total)
T4118 325:592 JLINK_ReadMemEx(0x2000219F, 0x0001 Bytes, ..., Flags = 0x02000000) -- CPU_ReadMem(1 bytes @ 0x2000219F) - Data: 00  returns 0x01 (0000ms, 1504ms total)
T4118 325:592 JLINK_ReadMemEx(0x200021A0, 0x0001 Bytes, ..., Flags = 0x02000000) -- CPU_ReadMem(1 bytes @ 0x200021A0) - Data: 00  returns 0x01 (0000ms, 1504ms total)
T4118 325:592 JLINK_ReadMemEx(0x200021A1, 0x0001 Bytes, ..., Flags = 0x02000000) -- CPU_ReadMem(1 bytes @ 0x200021A1) - Data: 00  returns 0x01 (0001ms, 1505ms total)
T4118 325:593 JLINK_ReadMemEx(0x200021A2, 0x0001 Bytes, ..., Flags = 0x02000000) -- CPU_ReadMem(1 bytes @ 0x200021A2) - Data: 00  returns 0x01 (0000ms, 1505ms total)
T4118 325:593 JLINK_ReadMemEx(0x200021A3, 0x0001 Bytes, ..., Flags = 0x02000000) -- CPU_ReadMem(1 bytes @ 0x200021A3) - Data: 00  returns 0x01 (0000ms, 1505ms total)
T4118 325:593 JLINK_ReadMemEx(0x200021A4, 0x0001 Bytes, ..., Flags = 0x02000000) -- CPU_ReadMem(1 bytes @ 0x200021A4) - Data: 00  returns 0x01 (0000ms, 1505ms total)
T4118 325:593 JLINK_ReadMemEx(0x200021A5, 0x0001 Bytes, ..., Flags = 0x02000000) -- CPU_ReadMem(1 bytes @ 0x200021A5) - Data: 00  returns 0x01 (0001ms, 1506ms total)
T4118 325:594 JLINK_ReadMemEx(0x200021A6, 0x0001 Bytes, ..., Flags = 0x02000000) -- CPU_ReadMem(1 bytes @ 0x200021A6) - Data: 00  returns 0x01 (0000ms, 1506ms total)
T4118 325:594 JLINK_ReadMemEx(0x200021A7, 0x0001 Bytes, ..., Flags = 0x02000000) -- CPU_ReadMem(1 bytes @ 0x200021A7) - Data: 00  returns 0x01 (0000ms, 1506ms total)
T4118 325:594 JLINK_ReadMemEx(0x200021A8, 0x0001 Bytes, ..., Flags = 0x02000000) -- CPU_ReadMem(1 bytes @ 0x200021A8) - Data: 00  returns 0x01 (0000ms, 1506ms total)
T4118 325:594 JLINK_ReadMemEx(0x200021A9, 0x0001 Bytes, ..., Flags = 0x02000000) -- CPU_ReadMem(1 bytes @ 0x200021A9) - Data: 00  returns 0x01 (0001ms, 1507ms total)
T4118 325:595 JLINK_ReadMemEx(0x200021AA, 0x0001 Bytes, ..., Flags = 0x02000000) -- CPU_ReadMem(1 bytes @ 0x200021AA) - Data: 00  returns 0x01 (0000ms, 1507ms total)
T4118 325:595 JLINK_ReadMemEx(0x200021AB, 0x0001 Bytes, ..., Flags = 0x02000000) -- CPU_ReadMem(1 bytes @ 0x200021AB) - Data: 00  returns 0x01 (0000ms, 1507ms total)
T4118 325:595 JLINK_ReadMemEx(0x200021AC, 0x0001 Bytes, ..., Flags = 0x02000000) -- CPU_ReadMem(1 bytes @ 0x200021AC) - Data: 00  returns 0x01 (0001ms, 1508ms total)
T4118 325:596 JLINK_ReadMemEx(0x200021AD, 0x0001 Bytes, ..., Flags = 0x02000000) -- CPU_ReadMem(1 bytes @ 0x200021AD) - Data: 00  returns 0x01 (0000ms, 1508ms total)
T4118 325:596 JLINK_ReadMemEx(0x200021AE, 0x0001 Bytes, ..., Flags = 0x02000000) -- CPU_ReadMem(1 bytes @ 0x200021AE) - Data: 00  returns 0x01 (0000ms, 1508ms total)
T4118 325:596 JLINK_ReadMemEx(0x200021AF, 0x0001 Bytes, ..., Flags = 0x02000000) -- CPU_ReadMem(1 bytes @ 0x200021AF) - Data: 00  returns 0x01 (0000ms, 1508ms total)
T4118 325:596 JLINK_ReadMemEx(0x200021B0, 0x0001 Bytes, ..., Flags = 0x02000000) -- CPU_ReadMem(1 bytes @ 0x200021B0) - Data: 00  returns 0x01 (0001ms, 1509ms total)
T4118 325:597 JLINK_ReadMemEx(0x200021B1, 0x0001 Bytes, ..., Flags = 0x02000000) -- CPU_ReadMem(1 bytes @ 0x200021B1) - Data: 00  returns 0x01 (0000ms, 1509ms total)
T4118 325:597 JLINK_ReadMemEx(0x200021B2, 0x0001 Bytes, ..., Flags = 0x02000000) -- CPU_ReadMem(1 bytes @ 0x200021B2) - Data: 00  returns 0x01 (0000ms, 1509ms total)
T4118 325:597 JLINK_ReadMemEx(0x200021B3, 0x0001 Bytes, ..., Flags = 0x02000000) -- CPU_ReadMem(1 bytes @ 0x200021B3) - Data: 00  returns 0x01 (0000ms, 1509ms total)
T4118 325:597 JLINK_ReadMemEx(0x200021B4, 0x0001 Bytes, ..., Flags = 0x02000000) -- CPU_ReadMem(1 bytes @ 0x200021B4) - Data: 00  returns 0x01 (0001ms, 1510ms total)
T4118 325:598 JLINK_ReadMemEx(0x200021B5, 0x0001 Bytes, ..., Flags = 0x02000000) -- CPU_ReadMem(1 bytes @ 0x200021B5) - Data: 00  returns 0x01 (0000ms, 1510ms total)
T4118 325:598 JLINK_ReadMemEx(0x200021B6, 0x0001 Bytes, ..., Flags = 0x02000000) -- CPU_ReadMem(1 bytes @ 0x200021B6) - Data: 00  returns 0x01 (0000ms, 1510ms total)
T4118 325:598 JLINK_ReadMemEx(0x200021B7, 0x0001 Bytes, ..., Flags = 0x02000000) -- CPU_ReadMem(1 bytes @ 0x200021B7) - Data: 00  returns 0x01 (0001ms, 1511ms total)
T4118 325:599 JLINK_ReadMemEx(0x200021B8, 0x0001 Bytes, ..., Flags = 0x02000000) -- CPU_ReadMem(1 bytes @ 0x200021B8) - Data: 00  returns 0x01 (0000ms, 1511ms total)
T4118 325:599 JLINK_ReadMemEx(0x200021B9, 0x0001 Bytes, ..., Flags = 0x02000000) -- CPU_ReadMem(1 bytes @ 0x200021B9) - Data: 00  returns 0x01 (0000ms, 1511ms total)
T4118 325:599 JLINK_ReadMemEx(0x200021BA, 0x0001 Bytes, ..., Flags = 0x02000000) -- CPU_ReadMem(1 bytes @ 0x200021BA) - Data: 00  returns 0x01 (0000ms, 1511ms total)
T4118 325:599 JLINK_ReadMemEx(0x200021BB, 0x0001 Bytes, ..., Flags = 0x02000000) -- CPU_ReadMem(1 bytes @ 0x200021BB) - Data: 00  returns 0x01 (0001ms, 1512ms total)
T4118 325:600 JLINK_ReadMemEx(0x200021BC, 0x0001 Bytes, ..., Flags = 0x02000000) -- CPU_ReadMem(1 bytes @ 0x200021BC) - Data: 00  returns 0x01 (0000ms, 1512ms total)
T4118 325:600 JLINK_ReadMemEx(0x200021BD, 0x0001 Bytes, ..., Flags = 0x02000000) -- CPU_ReadMem(1 bytes @ 0x200021BD) - Data: 00  returns 0x01 (0000ms, 1512ms total)
T4118 325:600 JLINK_ReadMemEx(0x200021BE, 0x0001 Bytes, ..., Flags = 0x02000000) -- CPU_ReadMem(1 bytes @ 0x200021BE) - Data: 00  returns 0x01 (0001ms, 1513ms total)
T4118 325:601 JLINK_ReadMemEx(0x200021BF, 0x0001 Bytes, ..., Flags = 0x02000000) -- CPU_ReadMem(1 bytes @ 0x200021BF) - Data: 00  returns 0x01 (0000ms, 1513ms total)
T4118 325:601 JLINK_ReadMemEx(0x200021C0, 0x0001 Bytes, ..., Flags = 0x02000000) -- CPU_ReadMem(1 bytes @ 0x200021C0) - Data: 00  returns 0x01 (0000ms, 1513ms total)
T4118 325:601 JLINK_ReadMemEx(0x200021C1, 0x0001 Bytes, ..., Flags = 0x02000000) -- CPU_ReadMem(1 bytes @ 0x200021C1) - Data: 00  returns 0x01 (0000ms, 1513ms total)
T4118 325:601 JLINK_ReadMemEx(0x200021C2, 0x0001 Bytes, ..., Flags = 0x02000000) -- CPU_ReadMem(1 bytes @ 0x200021C2) - Data: 00  returns 0x01 (0001ms, 1514ms total)
T4118 325:602 JLINK_ReadMemEx(0x200021C3, 0x0001 Bytes, ..., Flags = 0x02000000) -- CPU_ReadMem(1 bytes @ 0x200021C3) - Data: 00  returns 0x01 (0000ms, 1514ms total)
T2470 325:693 JLINK_IsHalted()  returns FALSE (0000ms, 1514ms total)
T2470 325:794 JLINK_IsHalted()  returns FALSE (0000ms, 1514ms total)
T2470 325:895 JLINK_IsHalted()  returns FALSE (0000ms, 1514ms total)
T2470 325:995 JLINK_IsHalted()  returns FALSE (0000ms, 1514ms total)
T2470 326:096 JLINK_IsHalted()  returns FALSE (0000ms, 1514ms total)
T2470 326:198 JLINK_IsHalted()  returns FALSE (0000ms, 1514ms total)
T2470 326:299 JLINK_IsHalted()  returns FALSE (0000ms, 1514ms total)
T2470 326:399 JLINK_IsHalted()  returns FALSE (0000ms, 1514ms total)
T2470 326:500 JLINK_IsHalted()  returns FALSE (0000ms, 1514ms total)
T2470 326:601 JLINK_IsHalted()  returns FALSE (0000ms, 1514ms total)
T2470 326:701 JLINK_IsHalted()  returns FALSE (0000ms, 1514ms total)
T2470 326:802 JLINK_IsHalted()  returns FALSE (0000ms, 1514ms total)
T2470 326:903 JLINK_IsHalted()  returns FALSE (0000ms, 1514ms total)
T2470 327:004 JLINK_IsHalted()  returns FALSE (0000ms, 1514ms total)
T2470 327:104 JLINK_IsHalted()  returns FALSE (0000ms, 1514ms total)
T2470 327:205 JLINK_IsHalted()  returns FALSE (0000ms, 1514ms total)
T2470 327:307 JLINK_IsHalted()  returns FALSE (0000ms, 1514ms total)
T2470 327:408 JLINK_IsHalted()  returns FALSE (0000ms, 1514ms total)
T2470 327:509 JLINK_IsHalted()  returns FALSE (0000ms, 1514ms total)
T2470 327:610 JLINK_IsHalted()  returns FALSE (0000ms, 1514ms total)
T2470 327:712 JLINK_IsHalted()  returns FALSE (0000ms, 1514ms total)
T2470 327:813 JLINK_IsHalted()  returns FALSE (0000ms, 1514ms total)
T2470 327:913 JLINK_IsHalted()  returns FALSE (0000ms, 1514ms total)
T2470 328:014 JLINK_IsHalted()  returns FALSE (0000ms, 1514ms total)
T2470 328:115 JLINK_IsHalted()  returns FALSE (0000ms, 1514ms total)
T2470 328:216 JLINK_IsHalted()  returns FALSE (0000ms, 1514ms total)
T2470 328:316 JLINK_IsHalted()  returns FALSE (0000ms, 1514ms total)
T2470 328:418 JLINK_IsHalted()  returns FALSE (0000ms, 1514ms total)
T2470 328:519 JLINK_IsHalted()  returns FALSE (0000ms, 1514ms total)
T2470 328:619 JLINK_IsHalted()  returns FALSE (0000ms, 1514ms total)
T2470 328:720 JLINK_IsHalted()  returns FALSE (0000ms, 1514ms total)
T2470 328:822 JLINK_IsHalted()  returns FALSE (0000ms, 1514ms total)
T2470 328:924 JLINK_IsHalted()  returns FALSE (0000ms, 1514ms total)
T2470 329:024 JLINK_IsHalted()  returns FALSE (0000ms, 1514ms total)
T2470 329:125 JLINK_IsHalted()  returns FALSE (0000ms, 1514ms total)
T2470 329:226 JLINK_IsHalted()  returns FALSE (0000ms, 1514ms total)
T2470 329:326 JLINK_IsHalted()  returns FALSE (0000ms, 1514ms total)
T2470 329:427 JLINK_IsHalted()  returns FALSE (0000ms, 1514ms total)
T2470 329:528 JLINK_IsHalted()  returns FALSE (0000ms, 1514ms total)
T2470 329:629 JLINK_IsHalted()  returns FALSE (0000ms, 1514ms total)
T2470 329:729 JLINK_IsHalted()  returns FALSE (0000ms, 1514ms total)
T2470 329:830 JLINK_IsHalted()  returns FALSE (0000ms, 1514ms total)
T2470 329:931 JLINK_IsHalted()  returns FALSE (0000ms, 1514ms total)
T2470 330:032 JLINK_IsHalted()  returns FALSE (0000ms, 1514ms total)
T2470 330:133 JLINK_IsHalted()  returns FALSE (0000ms, 1514ms total)
T2470 330:234 JLINK_IsHalted()  returns FALSE (0000ms, 1514ms total)
T2470 330:334 JLINK_IsHalted()  returns FALSE (0000ms, 1514ms total)
T4118 330:348 JLINK_SetBPEx(Addr = 0x08004570, Type = 0xFFFFFFF2) -- CPU is running -- CPU is running -- CPU_WriteMem(4 bytes @ 0xE0002000) -- CPU is running -- CPU_WriteMem(4 bytes @ 0xE0002010)  returns 0x0000000A (0000ms, 1514ms total)
T2470 330:435 JLINK_IsHalted()  returns FALSE (0000ms, 1514ms total)
T2470 330:536 JLINK_IsHalted()  returns FALSE (0000ms, 1514ms total)
T2470 330:636 JLINK_IsHalted()  returns FALSE (0000ms, 1514ms total)
T2470 330:737 JLINK_IsHalted()  returns FALSE (0000ms, 1514ms total)
T2470 330:838 JLINK_IsHalted()  returns FALSE (0000ms, 1514ms total)
T2470 330:939 JLINK_IsHalted()  returns FALSE (0000ms, 1514ms total)
T2470 331:039 JLINK_IsHalted()  returns FALSE (0000ms, 1514ms total)
T2470 331:140 JLINK_IsHalted()  returns FALSE (0000ms, 1514ms total)
T2470 331:241 JLINK_IsHalted()  returns FALSE (0000ms, 1514ms total)
T2470 331:342 JLINK_IsHalted()  returns FALSE (0000ms, 1514ms total)
T2470 331:442 JLINK_IsHalted()  returns FALSE (0000ms, 1514ms total)
T2470 331:543 JLINK_IsHalted()  returns FALSE (0000ms, 1514ms total)
T2470 331:644 JLINK_IsHalted()  returns FALSE (0000ms, 1514ms total)
T2470 331:746 JLINK_IsHalted()  returns FALSE (0000ms, 1514ms total)
T2470 331:846 JLINK_IsHalted()  returns FALSE (0000ms, 1514ms total)
T2470 331:948 JLINK_IsHalted()  returns FALSE (0000ms, 1514ms total)
T2470 332:049 JLINK_IsHalted()  returns FALSE (0000ms, 1514ms total)
T2470 332:150 JLINK_IsHalted()  returns FALSE (0000ms, 1514ms total)
T2470 332:251 JLINK_IsHalted()  returns FALSE (0000ms, 1514ms total)
T2470 332:353 JLINK_IsHalted()  returns FALSE (0000ms, 1514ms total)
T2470 332:454 JLINK_IsHalted()  returns FALSE (0000ms, 1514ms total)
T2470 332:554 JLINK_IsHalted()  returns FALSE (0000ms, 1514ms total)
T2470 332:655 JLINK_IsHalted()  returns FALSE (0000ms, 1514ms total)
T2470 332:757 JLINK_IsHalted()  returns FALSE (0000ms, 1514ms total)
T2470 332:857 JLINK_IsHalted()  returns FALSE (0000ms, 1514ms total)
T2470 332:958 JLINK_IsHalted()  returns FALSE (0000ms, 1514ms total)
T2470 333:059 JLINK_IsHalted()  returns FALSE (0000ms, 1514ms total)
T2470 333:161 JLINK_IsHalted()  returns FALSE (0000ms, 1514ms total)
T2470 333:261 JLINK_IsHalted()  returns FALSE (0000ms, 1514ms total)
T2470 333:362 JLINK_IsHalted()  returns FALSE (0000ms, 1514ms total)
T2470 333:464 JLINK_IsHalted()  returns FALSE (0000ms, 1514ms total)
T2470 333:565 JLINK_IsHalted()  returns FALSE (0000ms, 1514ms total)
T2470 333:665 JLINK_IsHalted()  returns FALSE (0000ms, 1514ms total)
T2470 333:766 JLINK_IsHalted()  returns FALSE (0000ms, 1514ms total)
T2470 333:868 JLINK_IsHalted()  returns FALSE (0000ms, 1514ms total)
T2470 333:969 JLINK_IsHalted()  returns FALSE (0000ms, 1514ms total)
T2470 334:070 JLINK_IsHalted()  returns FALSE (0000ms, 1514ms total)
T2470 334:171 JLINK_IsHalted()  returns FALSE (0000ms, 1514ms total)
T2470 334:272 JLINK_IsHalted()  returns FALSE (0000ms, 1514ms total)
T2470 334:373 JLINK_IsHalted()  returns FALSE (0000ms, 1514ms total)
T2470 334:474 JLINK_IsHalted()  returns FALSE (0000ms, 1514ms total)
T2470 334:575 JLINK_IsHalted()  returns FALSE (0000ms, 1514ms total)
T2470 334:676 JLINK_IsHalted()  returns FALSE (0000ms, 1514ms total)
T2470 334:777 JLINK_IsHalted()  returns FALSE (0000ms, 1514ms total)
T2470 334:878 JLINK_IsHalted()  returns FALSE (0000ms, 1514ms total)
T2470 334:979 JLINK_IsHalted()  returns FALSE (0000ms, 1514ms total)
T2470 335:080 JLINK_IsHalted()  returns FALSE (0000ms, 1514ms total)
T2470 335:180 JLINK_IsHalted()  returns FALSE (0000ms, 1514ms total)
T2470 335:281 JLINK_IsHalted()  returns FALSE (0000ms, 1514ms total)
T2470 335:383 JLINK_IsHalted()  returns FALSE (0000ms, 1514ms total)
T2470 335:483 JLINK_IsHalted()  returns FALSE (0000ms, 1514ms total)
T2470 335:584 JLINK_IsHalted()  returns FALSE (0000ms, 1514ms total)
T2470 335:685 JLINK_IsHalted()  returns FALSE (0000ms, 1514ms total)
T2470 335:787 JLINK_IsHalted()  returns FALSE (0000ms, 1514ms total)
T2470 335:887 JLINK_IsHalted()  returns FALSE (0000ms, 1514ms total)
T2470 335:988 JLINK_IsHalted()  returns FALSE (0000ms, 1514ms total)
T2470 336:089 JLINK_IsHalted()  returns FALSE (0000ms, 1514ms total)
T2470 336:190 JLINK_IsHalted()  returns FALSE (0000ms, 1514ms total)
T2470 336:290 JLINK_IsHalted()  returns FALSE (0000ms, 1514ms total)
T2470 336:391 JLINK_IsHalted()  returns FALSE (0000ms, 1514ms total)
T2470 336:491 JLINK_IsHalted()  returns FALSE (0000ms, 1514ms total)
T2470 336:592 JLINK_IsHalted()  returns FALSE (0000ms, 1514ms total)
T4118 336:603 JLINK_ClrBPEx(BPHandle = 0x0000000A) -- CPU is running -- CPU is running -- CPU_WriteMem(4 bytes @ 0xE0002000) -- CPU is running -- CPU_WriteMem(4 bytes @ 0xE0002008) -- CPU is running -- CPU_WriteMem(4 bytes @ 0xE0002000) -- CPU is running -- CPU_WriteMem(4 bytes @ 0xE000200C) -- CPU is running -- CPU_WriteMem(4 bytes @ 0xE0002010) -- CPU is running -- CPU_WriteMem(4 bytes @ 0xE0002014) -- CPU is running -- CPU_WriteMem(4 bytes @ 0xE0002018) -- CPU is running
 -- CPU_WriteMem(4 bytes @ 0xE000201C)  returns 0x00 (0003ms, 1517ms total)
T2470 336:694 JLINK_IsHalted()  returns FALSE (0000ms, 1517ms total)
T2470 336:795 JLINK_IsHalted()  returns FALSE (0000ms, 1517ms total)
T2470 336:896 JLINK_IsHalted()  returns FALSE (0000ms, 1517ms total)
T2470 336:996 JLINK_IsHalted()  returns FALSE (0000ms, 1517ms total)
T2470 337:097 JLINK_IsHalted()  returns FALSE (0000ms, 1517ms total)
T2470 337:198 JLINK_IsHalted()  returns FALSE (0000ms, 1517ms total)
T2470 337:299 JLINK_IsHalted()  returns FALSE (0000ms, 1517ms total)
T2470 337:400 JLINK_IsHalted()  returns FALSE (0000ms, 1517ms total)
T2470 337:502 JLINK_IsHalted()  returns FALSE (0000ms, 1517ms total)
T4118 337:511 JLINK_SetBPEx(Addr = 0x08004574, Type = 0xFFFFFFF2) -- CPU is running -- CPU is running -- CPU_WriteMem(4 bytes @ 0xE0002000) -- CPU is running -- CPU_WriteMem(4 bytes @ 0xE0002010)  returns 0x0000000B (0001ms, 1518ms total)
T2470 337:604 JLINK_IsHalted()  returns FALSE (0000ms, 1518ms total)
T2470 337:704 JLINK_IsHalted()  returns FALSE (0000ms, 1518ms total)
T2470 337:806 JLINK_IsHalted()  returns FALSE (0000ms, 1518ms total)
T2470 337:907 JLINK_IsHalted()  returns FALSE (0000ms, 1518ms total)
T2470 338:007 JLINK_IsHalted()  returns FALSE (0000ms, 1518ms total)
T2470 338:108 JLINK_IsHalted()  returns FALSE (0000ms, 1518ms total)
T2470 338:209 JLINK_IsHalted()  returns FALSE (0000ms, 1518ms total)
T2470 338:310 JLINK_IsHalted()  returns FALSE (0000ms, 1518ms total)
T2470 338:411 JLINK_IsHalted()  returns FALSE (0000ms, 1518ms total)
T2470 338:511 JLINK_IsHalted()  returns FALSE (0000ms, 1518ms total)
T2470 338:612 JLINK_IsHalted()  returns FALSE (0000ms, 1518ms total)
T2470 338:714 JLINK_IsHalted()  returns FALSE (0000ms, 1518ms total)
T2470 338:814 JLINK_IsHalted()  returns FALSE (0000ms, 1518ms total)
T2470 338:915 JLINK_IsHalted()  returns FALSE (0000ms, 1518ms total)
T2470 339:016 JLINK_IsHalted()  returns TRUE (0002ms, 1520ms total)
T2470 339:018 JLINK_Halt()  returns 0x00 (0000ms, 1518ms total)
T2470 339:018 JLINK_IsHalted()  returns TRUE (0000ms, 1518ms total)
T2470 339:018 JLINK_IsHalted()  returns TRUE (0000ms, 1518ms total)
T2470 339:018 JLINK_IsHalted()  returns TRUE (0000ms, 1518ms total)
T2470 339:018 JLINK_ReadReg(R15 (PC))  returns 0x08004574 (0000ms, 1518ms total)
T2470 339:018 JLINK_ReadReg(XPSR)  returns 0x81000035 (0000ms, 1518ms total)
T2470 339:018 JLINK_ClrBPEx(BPHandle = 0x00000008)  returns 0x00 (0000ms, 1518ms total)
T2470 339:018 JLINK_ClrBPEx(BPHandle = 0x00000009)  returns 0x00 (0000ms, 1518ms total)
T2470 339:018 JLINK_ClrBPEx(BPHandle = 0x0000000B)  returns 0x00 (0000ms, 1518ms total)
T2470 339:018 JLINK_ReadMemU32(0xE000ED30, 0x0001 Items, ...) -- CPU_ReadMem(4 bytes @ 0xE000ED30) - Data: 02 00 00 00  returns 0x01 (0001ms, 1519ms total)
T2470 339:019 JLINK_ReadMemU32(0xE0001028, 0x0001 Items, ...) -- CPU_ReadMem(4 bytes @ 0xE0001028) - Data: 00 00 00 00  returns 0x01 (0000ms, 1519ms total)
T2470 339:019 JLINK_ReadMemU32(0xE0001038, 0x0001 Items, ...) -- CPU_ReadMem(4 bytes @ 0xE0001038) - Data: 00 02 00 00  returns 0x01 (0000ms, 1519ms total)
T2470 339:019 JLINK_ReadMemU32(0xE0001048, 0x0001 Items, ...) -- CPU_ReadMem(4 bytes @ 0xE0001048) - Data: 00 00 00 00  returns 0x01 (0001ms, 1520ms total)
T2470 339:020 JLINK_ReadMemU32(0xE0001058, 0x0001 Items, ...) -- CPU_ReadMem(4 bytes @ 0xE0001058) - Data: 00 00 00 00  returns 0x01 (0000ms, 1520ms total)
T2470 339:020 JLINK_ReadReg(R0)  returns 0x20002194 (0000ms, 1520ms total)
T2470 339:020 JLINK_ReadReg(R1)  returns 0x00000001 (0000ms, 1520ms total)
T2470 339:020 JLINK_ReadReg(R2)  returns 0x40012C00 (0000ms, 1520ms total)
T2470 339:020 JLINK_ReadReg(R3)  returns 0x40012C0C (0000ms, 1520ms total)
T2470 339:020 JLINK_ReadReg(R4)  returns 0x00000000 (0000ms, 1520ms total)
T2470 339:020 JLINK_ReadReg(R5)  returns 0x00000000 (0000ms, 1520ms total)
T2470 339:020 JLINK_ReadReg(R6)  returns 0x00000000 (0000ms, 1520ms total)
T2470 339:020 JLINK_ReadReg(R7)  returns 0x00000000 (0000ms, 1520ms total)
T2470 339:020 JLINK_ReadReg(R8)  returns 0x20001FBC (0000ms, 1520ms total)
T2470 339:020 JLINK_ReadReg(R9)  returns 0x0000C350 (0000ms, 1520ms total)
T2470 339:020 JLINK_ReadReg(R10)  returns 0x000003E8 (0000ms, 1520ms total)
T2470 339:020 JLINK_ReadReg(R11)  returns 0x00000001 (0000ms, 1520ms total)
T2470 339:020 JLINK_ReadReg(R12)  returns 0x00000000 (0000ms, 1520ms total)
T2470 339:020 JLINK_ReadReg(R13 (SP))  returns 0x20002918 (0000ms, 1520ms total)
T2470 339:020 JLINK_ReadReg(R14)  returns 0xFFFFFFF9 (0000ms, 1520ms total)
T2470 339:020 JLINK_ReadReg(R15 (PC))  returns 0x08004574 (0000ms, 1520ms total)
T2470 339:020 JLINK_ReadReg(XPSR)  returns 0x81000035 (0000ms, 1520ms total)
T2470 339:020 JLINK_ReadReg(MSP)  returns 0x20002918 (0001ms, 1521ms total)
T2470 339:021 JLINK_ReadReg(PSP)  returns 0xAEAA5364 (0000ms, 1521ms total)
T2470 339:021 JLINK_ReadReg(CFBP)  returns 0x00000000 (0000ms, 1521ms total)
T4118 339:021 JLINK_ReadMemEx(0x20002924, 0x0004 Bytes, ..., Flags = 0x02000000) -- CPU_ReadMem(64 bytes @ 0x20002900) -- Updating C cache (64 bytes @ 0x20002900) -- Read from C cache (4 bytes @ 0x20002924) - Data: F9 FF FF FF  returns 0x04 (0001ms, 1522ms total)
T4118 339:022 JLINK_ReadMemEx(0x20002940, 0x0004 Bytes, ..., Flags = 0x02000000) -- CPU_ReadMem(64 bytes @ 0x20002940) -- Updating C cache (64 bytes @ 0x20002940) -- Read from C cache (4 bytes @ 0x20002940) - Data: 40 50 00 08  returns 0x04 (0001ms, 1523ms total)
T4118 339:023 JLINK_ReadMemEx(0x20002944, 0x0004 Bytes, ..., Flags = 0x02000000) -- Read from C cache (4 bytes @ 0x20002944) - Data: 00 00 00 41  returns 0x04 (0000ms, 1523ms total)
T4118 339:023 JLINK_ReadMemEx(0x2000293C, 0x0004 Bytes, ..., Flags = 0x02000000) -- Read from C cache (4 bytes @ 0x2000293C) - Data: 47 50 00 08  returns 0x04 (0000ms, 1523ms total)
T4118 339:023 JLINK_ReadMemEx(0xE000ED28, 0x0004 Bytes, ..., Flags = 0x02000000) -- CPU_ReadMem(4 bytes @ 0xE000ED28) - Data: 00 00 00 00  returns 0x04 (0000ms, 1523ms total)
T4118 339:023 JLINK_ReadMemEx(0x20002938, 0x0004 Bytes, ..., Flags = 0x02000000) -- Read from C cache (4 bytes @ 0x20002938) - Data: 00 00 00 00  returns 0x04 (0000ms, 1523ms total)
T4118 339:023 JLINK_ReadMemEx(0x00000000, 0x0001 Bytes, ..., Flags = 0x02000000) -- CPU_ReadMem(4 bytes @ 0x00000004) -- CPU_ReadMem(64 bytes @ 0x08000000) -- Updating C cache (64 bytes @ 0x08000000) -- Read from C cache (1 bytes @ 0x08000000) - Data: 48  returns 0x01 (0001ms, 1524ms total)
T4118 339:026 JLINK_ReadMemEx(0x20000024, 0x0002 Bytes, ..., Flags = 0x02000000) -- CPU_ReadMem(64 bytes @ 0x20000000) -- Updating C cache (64 bytes @ 0x20000000) -- Read from C cache (2 bytes @ 0x20000024) - Data: 00 00  returns 0x02 (0001ms, 1525ms total)
T4118 339:028 JLINK_ReadMemEx(0x08004574, 0x003C Bytes, ..., Flags = 0x02000000) -- CPU_ReadMem(128 bytes @ 0x08004540) -- Updating C cache (128 bytes @ 0x08004540) -- Read from C cache (60 bytes @ 0x08004574) - Data: 07 48 18 30 05 80 18 88 40 F0 01 00 18 80 10 88 ...  returns 0x3C (0001ms, 1526ms total)
T2470 341:949 JLINK_ReadMemEx(0x08004574, 0x0002 Bytes, ..., Flags = 0x02000000) -- Read from C cache (2 bytes @ 0x08004574) - Data: 07 48  returns 0x02 (0000ms, 1526ms total)
T2470 341:949 JLINK_SetBPEx(Addr = 0x0800215E, Type = 0xFFFFFFF2)  returns 0x0000000C (0000ms, 1526ms total)
T2470 341:949 JLINK_SetBPEx(Addr = 0x08002164, Type = 0xFFFFFFF2)  returns 0x0000000D (0000ms, 1526ms total)
T2470 341:949 JLINK_Go() -- CPU_WriteMem(4 bytes @ 0xE0002000) -- CPU_WriteMem(4 bytes @ 0xE0002000) -- CPU_ReadMem(4 bytes @ 0xE0001000) -- CPU_WriteMem(4 bytes @ 0xE0002010) (0001ms, 1527ms total)
T2470 342:052 JLINK_IsHalted()  returns FALSE (0000ms, 1527ms total)
T2470 342:152 JLINK_IsHalted()  returns FALSE (0000ms, 1527ms total)
T2470 342:253 JLINK_IsHalted()  returns FALSE (0000ms, 1527ms total)
T2470 342:355 JLINK_IsHalted()  returns FALSE (0000ms, 1527ms total)
T2470 342:456 JLINK_IsHalted()  returns FALSE (0000ms, 1527ms total)
T2470 342:556 JLINK_IsHalted()  returns FALSE (0000ms, 1527ms total)
T2470 342:657 JLINK_IsHalted()  returns FALSE (0000ms, 1527ms total)
T2470 342:758 JLINK_IsHalted()  returns FALSE (0000ms, 1527ms total)
T2470 342:858 JLINK_IsHalted()  returns FALSE (0000ms, 1527ms total)
T2470 342:959 JLINK_IsHalted()  returns FALSE (0000ms, 1527ms total)
T2470 343:060 JLINK_IsHalted()  returns FALSE (0000ms, 1527ms total)
T2470 343:161 JLINK_IsHalted()  returns FALSE (0000ms, 1527ms total)
T2470 343:261 JLINK_IsHalted()  returns FALSE (0000ms, 1527ms total)
T2470 343:362 JLINK_IsHalted()  returns FALSE (0000ms, 1527ms total)
T2470 343:463 JLINK_IsHalted()  returns FALSE (0000ms, 1527ms total)
T2470 343:564 JLINK_IsHalted()  returns FALSE (0000ms, 1527ms total)
T2470 343:664 JLINK_IsHalted()  returns FALSE (0000ms, 1527ms total)
T2470 343:765 JLINK_IsHalted()  returns FALSE (0000ms, 1527ms total)
T2470 343:866 JLINK_IsHalted()  returns FALSE (0000ms, 1527ms total)
T2470 343:967 JLINK_IsHalted()  returns FALSE (0000ms, 1527ms total)
T2470 344:067 JLINK_IsHalted()  returns FALSE (0000ms, 1527ms total)
T2470 344:168 JLINK_IsHalted()  returns FALSE (0000ms, 1527ms total)
T2470 344:269 JLINK_IsHalted()  returns FALSE (0000ms, 1527ms total)
T2470 344:369 JLINK_IsHalted()  returns FALSE (0000ms, 1527ms total)
T2470 344:470 JLINK_IsHalted()  returns FALSE (0000ms, 1527ms total)
T2470 344:571 JLINK_IsHalted()  returns FALSE (0000ms, 1527ms total)
T2470 344:672 JLINK_IsHalted()  returns FALSE (0000ms, 1527ms total)
T2470 344:772 JLINK_IsHalted()  returns FALSE (0000ms, 1527ms total)
T2470 344:873 JLINK_IsHalted()  returns FALSE (0000ms, 1527ms total)
T2470 344:974 JLINK_IsHalted()  returns FALSE (0000ms, 1527ms total)
T2470 345:075 JLINK_IsHalted()  returns FALSE (0000ms, 1527ms total)
T2470 345:175 JLINK_IsHalted()  returns FALSE (0000ms, 1527ms total)
T2470 345:276 JLINK_IsHalted()  returns FALSE (0000ms, 1527ms total)
T2470 345:377 JLINK_IsHalted()  returns FALSE (0000ms, 1527ms total)
T2470 345:477 JLINK_IsHalted()  returns FALSE (0000ms, 1527ms total)
T2470 345:578 JLINK_IsHalted()  returns FALSE (0000ms, 1527ms total)
T2470 345:679 JLINK_IsHalted()  returns FALSE (0000ms, 1527ms total)
T2470 345:780 JLINK_IsHalted()  returns FALSE (0000ms, 1527ms total)
T2470 345:880 JLINK_IsHalted()  returns FALSE (0000ms, 1527ms total)
T2470 345:981 JLINK_IsHalted()  returns FALSE (0000ms, 1527ms total)
T2470 346:082 JLINK_IsHalted()  returns FALSE (0000ms, 1527ms total)
T2470 346:183 JLINK_IsHalted()  returns FALSE (0000ms, 1527ms total)
T2470 346:283 JLINK_IsHalted()  returns FALSE (0000ms, 1527ms total)
T2470 346:384 JLINK_IsHalted()  returns FALSE (0000ms, 1527ms total)
T2470 346:485 JLINK_IsHalted()  returns FALSE (0000ms, 1527ms total)
T2470 346:586 JLINK_IsHalted()  returns FALSE (0000ms, 1527ms total)
T2470 346:686 JLINK_IsHalted()  returns FALSE (0000ms, 1527ms total)
T2470 346:787 JLINK_IsHalted()  returns FALSE (0000ms, 1527ms total)
T2470 346:888 JLINK_IsHalted()  returns FALSE (0000ms, 1527ms total)
T2470 346:988 JLINK_IsHalted()  returns FALSE (0000ms, 1527ms total)
T2470 347:089 JLINK_IsHalted()  returns FALSE (0000ms, 1527ms total)
T2470 347:190 JLINK_IsHalted()  returns FALSE (0000ms, 1527ms total)
T2470 347:291 JLINK_IsHalted()  returns FALSE (0000ms, 1527ms total)
T2470 347:391 JLINK_IsHalted()  returns FALSE (0000ms, 1527ms total)
T2470 347:492 JLINK_IsHalted()  returns FALSE (0000ms, 1527ms total)
T2470 347:593 JLINK_IsHalted()  returns FALSE (0000ms, 1527ms total)
T2470 347:694 JLINK_IsHalted()  returns FALSE (0000ms, 1527ms total)
T2470 347:794 JLINK_IsHalted()  returns FALSE (0000ms, 1527ms total)
T2470 347:895 JLINK_IsHalted()  returns FALSE (0000ms, 1527ms total)
T2470 347:996 JLINK_IsHalted()  returns FALSE (0000ms, 1527ms total)
T2470 348:096 JLINK_IsHalted()  returns FALSE (0000ms, 1527ms total)
T2470 348:197 JLINK_IsHalted()  returns FALSE (0000ms, 1527ms total)
T2470 348:298 JLINK_IsHalted()  returns FALSE (0000ms, 1527ms total)
T2470 348:399 JLINK_IsHalted()  returns FALSE (0000ms, 1527ms total)
T2470 348:499 JLINK_IsHalted()  returns FALSE (0000ms, 1527ms total)
T2470 348:600 JLINK_IsHalted()  returns FALSE (0000ms, 1527ms total)
T2470 348:701 JLINK_IsHalted()  returns FALSE (0000ms, 1527ms total)
T2470 348:802 JLINK_IsHalted()  returns FALSE (0000ms, 1527ms total)
T2470 348:902 JLINK_IsHalted()  returns FALSE (0000ms, 1527ms total)
T2470 349:003 JLINK_IsHalted()  returns FALSE (0000ms, 1527ms total)
T2470 349:104 JLINK_IsHalted()  returns FALSE (0000ms, 1527ms total)
T2470 349:205 JLINK_IsHalted()  returns FALSE (0000ms, 1527ms total)
T2470 349:305 JLINK_IsHalted()  returns FALSE (0000ms, 1527ms total)
T2470 349:406 JLINK_IsHalted()  returns FALSE (0000ms, 1527ms total)
T2470 349:507 JLINK_IsHalted()  returns FALSE (0000ms, 1527ms total)
T2470 349:607 JLINK_IsHalted()  returns FALSE (0000ms, 1527ms total)
T2470 349:708 JLINK_IsHalted()  returns FALSE (0000ms, 1527ms total)
T2470 349:809 JLINK_IsHalted()  returns FALSE (0000ms, 1527ms total)
T2470 349:910 JLINK_IsHalted()  returns FALSE (0000ms, 1527ms total)
T2470 350:010 JLINK_IsHalted()  returns FALSE (0000ms, 1527ms total)
T2470 350:111 JLINK_IsHalted()  returns FALSE (0000ms, 1527ms total)
T2470 350:212 JLINK_IsHalted()  returns FALSE (0000ms, 1527ms total)
T2470 350:313 JLINK_IsHalted()  returns FALSE (0000ms, 1527ms total)
T2470 350:413 JLINK_IsHalted()  returns FALSE (0000ms, 1527ms total)
T2470 350:514 JLINK_IsHalted()  returns FALSE (0000ms, 1527ms total)
T2470 350:615 JLINK_IsHalted()  returns FALSE (0000ms, 1527ms total)
T2470 350:715 JLINK_IsHalted()  returns FALSE (0000ms, 1527ms total)
T2470 350:816 JLINK_IsHalted()  returns FALSE (0000ms, 1527ms total)
T2470 350:917 JLINK_IsHalted()  returns FALSE (0000ms, 1527ms total)
T2470 351:018 JLINK_IsHalted()  returns FALSE (0000ms, 1527ms total)
T2470 351:118 JLINK_IsHalted()  returns FALSE (0000ms, 1527ms total)
T2470 351:219 JLINK_IsHalted()  returns FALSE (0000ms, 1527ms total)
T2470 351:320 JLINK_IsHalted()  returns FALSE (0000ms, 1527ms total)
T2470 351:421 JLINK_IsHalted()  returns FALSE (0000ms, 1527ms total)
T2470 351:521 JLINK_IsHalted()  returns FALSE (0000ms, 1527ms total)
T2470 351:622 JLINK_IsHalted()  returns FALSE (0000ms, 1527ms total)
T2470 351:723 JLINK_IsHalted()  returns FALSE (0000ms, 1527ms total)
T2470 351:824 JLINK_IsHalted()  returns FALSE (0000ms, 1527ms total)
T2470 351:924 JLINK_IsHalted()  returns FALSE (0000ms, 1527ms total)
T2470 352:025 JLINK_IsHalted()  returns FALSE (0000ms, 1527ms total)
T2470 352:126 JLINK_IsHalted()  returns FALSE (0000ms, 1527ms total)
T2470 352:226 JLINK_IsHalted()  returns FALSE (0000ms, 1527ms total)
T2470 352:327 JLINK_IsHalted()  returns FALSE (0000ms, 1527ms total)
T2470 352:428 JLINK_IsHalted()  returns FALSE (0000ms, 1527ms total)
T2470 352:529 JLINK_IsHalted()  returns FALSE (0000ms, 1527ms total)
T2470 352:629 JLINK_IsHalted()  returns FALSE (0000ms, 1527ms total)
T2470 352:730 JLINK_IsHalted()  returns FALSE (0000ms, 1527ms total)
T2470 352:831 JLINK_IsHalted()  returns FALSE (0000ms, 1527ms total)
T2470 352:932 JLINK_IsHalted()  returns FALSE (0000ms, 1527ms total)
T2470 353:032 JLINK_IsHalted()  returns FALSE (0000ms, 1527ms total)
T2470 353:133 JLINK_IsHalted()  returns FALSE (0000ms, 1527ms total)
T2470 353:234 JLINK_IsHalted()  returns FALSE (0000ms, 1527ms total)
T2470 353:334 JLINK_IsHalted()  returns FALSE (0000ms, 1527ms total)
T2470 353:435 JLINK_IsHalted()  returns FALSE (0000ms, 1527ms total)
T2470 353:536 JLINK_IsHalted()  returns FALSE (0000ms, 1527ms total)
T2470 353:637 JLINK_IsHalted()  returns FALSE (0000ms, 1527ms total)
T2470 353:737 JLINK_IsHalted()  returns FALSE (0000ms, 1527ms total)
T2470 353:838 JLINK_IsHalted()  returns FALSE (0000ms, 1527ms total)
T2470 353:939 JLINK_IsHalted()  returns FALSE (0000ms, 1527ms total)
T2470 354:040 JLINK_IsHalted()  returns FALSE (0000ms, 1527ms total)
T2470 354:140 JLINK_IsHalted()  returns FALSE (0000ms, 1527ms total)
T2470 354:241 JLINK_IsHalted()  returns FALSE (0000ms, 1527ms total)
T2470 354:342 JLINK_IsHalted()  returns FALSE (0000ms, 1527ms total)
T2470 354:443 JLINK_IsHalted()  returns FALSE (0000ms, 1527ms total)
T2470 354:543 JLINK_IsHalted()  returns FALSE (0000ms, 1527ms total)
T2470 354:644 JLINK_IsHalted()  returns FALSE (0000ms, 1527ms total)
T2470 354:745 JLINK_IsHalted()  returns FALSE (0000ms, 1527ms total)
T2470 354:845 JLINK_IsHalted()  returns FALSE (0000ms, 1527ms total)
T2470 354:946 JLINK_IsHalted()  returns FALSE (0000ms, 1527ms total)
T2470 355:047 JLINK_IsHalted()  returns FALSE (0000ms, 1527ms total)
T2470 355:148 JLINK_IsHalted()  returns FALSE (0000ms, 1527ms total)
T2470 355:248 JLINK_IsHalted()  returns FALSE (0000ms, 1527ms total)
T2470 355:349 JLINK_IsHalted()  returns FALSE (0000ms, 1527ms total)
T2470 355:450 JLINK_IsHalted()  returns FALSE (0000ms, 1527ms total)
T2470 355:551 JLINK_IsHalted()  returns FALSE (0000ms, 1527ms total)
T2470 355:651 JLINK_IsHalted()  returns FALSE (0000ms, 1527ms total)
T2470 355:752 JLINK_IsHalted()  returns FALSE (0000ms, 1527ms total)
T2470 355:853 JLINK_IsHalted()  returns FALSE (0000ms, 1527ms total)
T2470 355:953 JLINK_IsHalted()  returns FALSE (0000ms, 1527ms total)
T2470 356:054 JLINK_IsHalted()  returns FALSE (0000ms, 1527ms total)
T2470 356:155 JLINK_IsHalted()  returns FALSE (0000ms, 1527ms total)
T2470 356:256 JLINK_IsHalted()  returns FALSE (0000ms, 1527ms total)
T2470 356:356 JLINK_IsHalted()  returns FALSE (0000ms, 1527ms total)
T2470 356:457 JLINK_IsHalted()  returns FALSE (0000ms, 1527ms total)
T2470 356:558 JLINK_IsHalted()  returns FALSE (0000ms, 1527ms total)
T2470 356:659 JLINK_IsHalted()  returns FALSE (0000ms, 1527ms total)
T2470 356:759 JLINK_IsHalted()  returns FALSE (0000ms, 1527ms total)
T2470 356:860 JLINK_IsHalted()  returns FALSE (0000ms, 1527ms total)
T2470 356:961 JLINK_IsHalted()  returns FALSE (0000ms, 1527ms total)
T2470 357:062 JLINK_IsHalted()  returns FALSE (0000ms, 1527ms total)
T2470 357:162 JLINK_IsHalted()  returns FALSE (0000ms, 1527ms total)
T2470 357:263 JLINK_IsHalted()  returns FALSE (0000ms, 1527ms total)
T2470 357:364 JLINK_IsHalted()  returns FALSE (0000ms, 1527ms total)
T2470 357:464 JLINK_IsHalted()  returns FALSE (0000ms, 1527ms total)
T2470 357:565 JLINK_IsHalted()  returns FALSE (0000ms, 1527ms total)
T2470 357:666 JLINK_IsHalted()  returns FALSE (0000ms, 1527ms total)
T2470 357:767 JLINK_IsHalted()  returns FALSE (0000ms, 1527ms total)
T2470 357:867 JLINK_IsHalted()  returns FALSE (0000ms, 1527ms total)
T2470 357:968 JLINK_IsHalted()  returns FALSE (0000ms, 1527ms total)
T2470 358:069 JLINK_IsHalted()  returns FALSE (0000ms, 1527ms total)
T2470 358:170 JLINK_IsHalted()  returns FALSE (0000ms, 1527ms total)
T2470 358:270 JLINK_IsHalted()  returns FALSE (0000ms, 1527ms total)
T2470 358:371 JLINK_IsHalted()  returns FALSE (0000ms, 1527ms total)
T2470 358:472 JLINK_IsHalted()  returns FALSE (0000ms, 1527ms total)
T2470 358:572 JLINK_IsHalted()  returns FALSE (0000ms, 1527ms total)
T2470 358:673 JLINK_IsHalted()  returns FALSE (0000ms, 1527ms total)
T2470 358:774 JLINK_IsHalted()  returns FALSE (0000ms, 1527ms total)
T2470 358:875 JLINK_IsHalted()  returns FALSE (0000ms, 1527ms total)
T2470 358:975 JLINK_IsHalted()  returns FALSE (0000ms, 1527ms total)
T2470 359:076 JLINK_IsHalted()  returns FALSE (0000ms, 1527ms total)
T2470 359:177 JLINK_IsHalted()  returns FALSE (0000ms, 1527ms total)
T2470 359:278 JLINK_IsHalted()  returns FALSE (0000ms, 1527ms total)
T2470 359:378 JLINK_IsHalted()  returns FALSE (0000ms, 1527ms total)
T2470 359:479 JLINK_IsHalted()  returns FALSE (0000ms, 1527ms total)
T2470 359:580 JLINK_IsHalted()  returns FALSE (0000ms, 1527ms total)
T2470 359:681 JLINK_IsHalted()  returns FALSE (0000ms, 1527ms total)
T2470 359:781 JLINK_IsHalted()  returns FALSE (0000ms, 1527ms total)
T2470 359:882 JLINK_IsHalted()  returns FALSE (0000ms, 1527ms total)
T2470 359:983 JLINK_IsHalted()  returns FALSE (0000ms, 1527ms total)
T2470 360:083 JLINK_IsHalted()  returns FALSE (0000ms, 1527ms total)
T2470 360:184 JLINK_IsHalted()  returns FALSE (0000ms, 1527ms total)
T2470 360:285 JLINK_IsHalted()  returns FALSE (0000ms, 1527ms total)
T2470 360:386 JLINK_IsHalted()  returns FALSE (0000ms, 1527ms total)
T2470 360:486 JLINK_IsHalted()  returns FALSE (0000ms, 1527ms total)
T2470 360:587 JLINK_IsHalted()  returns FALSE (0000ms, 1527ms total)
T2470 360:688 JLINK_IsHalted()  returns FALSE (0000ms, 1527ms total)
T2470 360:789 JLINK_IsHalted()  returns FALSE (0000ms, 1527ms total)
T2470 360:889 JLINK_IsHalted()  returns FALSE (0000ms, 1527ms total)
T2470 360:990 JLINK_IsHalted()  returns FALSE (0000ms, 1527ms total)
T2470 361:091 JLINK_IsHalted()  returns FALSE (0000ms, 1527ms total)
T2470 361:191 JLINK_IsHalted()  returns FALSE (0000ms, 1527ms total)
T2470 361:292 JLINK_IsHalted()  returns FALSE (0000ms, 1527ms total)
T2470 361:393 JLINK_IsHalted()  returns FALSE (0000ms, 1527ms total)
T2470 361:494 JLINK_IsHalted()  returns FALSE (0000ms, 1527ms total)
T2470 361:594 JLINK_IsHalted()  returns FALSE (0000ms, 1527ms total)
T2470 361:695 JLINK_IsHalted()  returns FALSE (0000ms, 1527ms total)
T2470 361:796 JLINK_IsHalted()  returns FALSE (0000ms, 1527ms total)
T2470 361:897 JLINK_IsHalted()  returns FALSE (0000ms, 1527ms total)
T2470 361:997 JLINK_IsHalted()  returns FALSE (0000ms, 1527ms total)
T2470 362:098 JLINK_IsHalted()  returns FALSE (0000ms, 1527ms total)
T2470 362:199 JLINK_IsHalted()  returns FALSE (0000ms, 1527ms total)
T2470 362:300 JLINK_IsHalted()  returns FALSE (0000ms, 1527ms total)
T2470 362:400 JLINK_IsHalted()  returns FALSE (0000ms, 1527ms total)
T2470 362:501 JLINK_IsHalted()  returns FALSE (0000ms, 1527ms total)
T2470 362:602 JLINK_IsHalted()  returns FALSE (0000ms, 1527ms total)
T2470 362:702 JLINK_IsHalted()  returns FALSE (0000ms, 1527ms total)
T2470 362:803 JLINK_IsHalted()  returns FALSE (0000ms, 1527ms total)
T2470 362:904 JLINK_IsHalted()  returns FALSE (0000ms, 1527ms total)
T2470 363:005 JLINK_IsHalted()  returns FALSE (0000ms, 1527ms total)
T2470 363:105 JLINK_IsHalted()  returns FALSE (0000ms, 1527ms total)
T2470 363:206 JLINK_IsHalted()  returns FALSE (0000ms, 1527ms total)
T2470 363:307 JLINK_IsHalted()  returns FALSE (0000ms, 1527ms total)
T2470 363:408 JLINK_IsHalted()  returns FALSE (0000ms, 1527ms total)
T2470 363:508 JLINK_IsHalted()  returns FALSE (0000ms, 1527ms total)
T2470 363:609 JLINK_IsHalted()  returns FALSE (0000ms, 1527ms total)
T2470 363:710 JLINK_IsHalted()  returns FALSE (0000ms, 1527ms total)
T2470 363:810 JLINK_IsHalted()  returns FALSE (0000ms, 1527ms total)
T2470 363:911 JLINK_IsHalted()  returns FALSE (0000ms, 1527ms total)
T2470 364:012 JLINK_IsHalted()  returns FALSE (0000ms, 1527ms total)
T2470 364:113 JLINK_IsHalted()  returns FALSE (0000ms, 1527ms total)
T2470 364:213 JLINK_IsHalted()  returns FALSE (0000ms, 1527ms total)
T2470 364:314 JLINK_IsHalted()  returns FALSE (0000ms, 1527ms total)
T2470 364:415 JLINK_IsHalted()  returns FALSE (0000ms, 1527ms total)
T2470 364:516 JLINK_IsHalted()  returns FALSE (0000ms, 1527ms total)
T2470 364:616 JLINK_IsHalted()  returns FALSE (0000ms, 1527ms total)
T2470 364:717 JLINK_IsHalted()  returns FALSE (0000ms, 1527ms total)
T2470 364:818 JLINK_IsHalted()  returns FALSE (0000ms, 1527ms total)
T2470 364:919 JLINK_IsHalted()  returns FALSE (0000ms, 1527ms total)
T2470 365:019 JLINK_IsHalted()  returns FALSE (0000ms, 1527ms total)
T2470 365:120 JLINK_IsHalted()  returns FALSE (0000ms, 1527ms total)
T2470 365:221 JLINK_IsHalted()  returns FALSE (0000ms, 1527ms total)
T2470 365:321 JLINK_IsHalted()  returns FALSE (0000ms, 1527ms total)
T2470 365:422 JLINK_IsHalted()  returns FALSE (0000ms, 1527ms total)
T2470 365:523 JLINK_IsHalted()  returns FALSE (0000ms, 1527ms total)
T2470 365:624 JLINK_IsHalted()  returns FALSE (0000ms, 1527ms total)
T2470 365:724 JLINK_IsHalted()  returns FALSE (0000ms, 1527ms total)
T2470 365:825 JLINK_IsHalted()  returns FALSE (0000ms, 1527ms total)
T2470 365:926 JLINK_IsHalted()  returns FALSE (0000ms, 1527ms total)
T2470 366:027 JLINK_IsHalted()  returns FALSE (0000ms, 1527ms total)
T2470 366:127 JLINK_IsHalted()  returns FALSE (0000ms, 1527ms total)
T2470 366:228 JLINK_IsHalted()  returns FALSE (0000ms, 1527ms total)
T2470 366:329 JLINK_IsHalted()  returns FALSE (0000ms, 1527ms total)
T2470 366:429 JLINK_IsHalted()  returns FALSE (0000ms, 1527ms total)
T2470 366:530 JLINK_IsHalted()  returns FALSE (0000ms, 1527ms total)
T2470 366:631 JLINK_IsHalted()  returns FALSE (0000ms, 1527ms total)
T2470 366:732 JLINK_IsHalted()  returns FALSE (0000ms, 1527ms total)
T2470 366:832 JLINK_IsHalted()  returns FALSE (0000ms, 1527ms total)
T2470 366:933 JLINK_IsHalted()  returns FALSE (0000ms, 1527ms total)
T2470 367:034 JLINK_IsHalted()  returns FALSE (0000ms, 1527ms total)
T2470 367:135 JLINK_IsHalted()  returns FALSE (0000ms, 1527ms total)
T2470 367:235 JLINK_IsHalted()  returns FALSE (0000ms, 1527ms total)
T2470 367:336 JLINK_IsHalted()  returns FALSE (0000ms, 1527ms total)
T2470 367:437 JLINK_IsHalted()  returns FALSE (0000ms, 1527ms total)
T2470 367:538 JLINK_IsHalted()  returns FALSE (0000ms, 1527ms total)
T2470 367:638 JLINK_IsHalted()  returns FALSE (0000ms, 1527ms total)
T2470 367:739 JLINK_IsHalted()  returns FALSE (0000ms, 1527ms total)
T2470 367:840 JLINK_IsHalted()  returns FALSE (0000ms, 1527ms total)
T2470 367:940 JLINK_IsHalted()  returns FALSE (0000ms, 1527ms total)
T2470 368:041 JLINK_IsHalted()  returns FALSE (0000ms, 1527ms total)
T2470 368:142 JLINK_IsHalted()  returns FALSE (0000ms, 1527ms total)
T2470 368:243 JLINK_IsHalted()  returns FALSE (0000ms, 1527ms total)
T2470 368:343 JLINK_IsHalted()  returns FALSE (0000ms, 1527ms total)
T2470 368:444 JLINK_IsHalted()  returns FALSE (0000ms, 1527ms total)
T2470 368:545 JLINK_IsHalted()  returns FALSE (0000ms, 1527ms total)
T2470 368:646 JLINK_IsHalted()  returns FALSE (0000ms, 1527ms total)
T2470 368:746 JLINK_IsHalted()  returns FALSE (0000ms, 1527ms total)
T2470 368:847 JLINK_IsHalted()  returns FALSE (0000ms, 1527ms total)
T2470 368:948 JLINK_IsHalted()  returns FALSE (0000ms, 1527ms total)
T2470 369:048 JLINK_IsHalted()  returns FALSE (0000ms, 1527ms total)
T2470 369:149 JLINK_IsHalted()  returns FALSE (0000ms, 1527ms total)
T2470 369:250 JLINK_IsHalted()  returns FALSE (0000ms, 1527ms total)
T2470 369:351 JLINK_IsHalted()  returns FALSE (0000ms, 1527ms total)
T2470 369:451 JLINK_IsHalted()  returns FALSE (0000ms, 1527ms total)
T2470 369:552 JLINK_IsHalted()  returns FALSE (0000ms, 1527ms total)
T2470 369:653 JLINK_IsHalted()  returns FALSE (0000ms, 1527ms total)
T2470 369:754 JLINK_IsHalted()  returns FALSE (0000ms, 1527ms total)
T2470 369:854 JLINK_IsHalted()  returns FALSE (0000ms, 1527ms total)
T2470 369:955 JLINK_IsHalted()  returns FALSE (0000ms, 1527ms total)
T2470 370:056 JLINK_IsHalted()  returns FALSE (0000ms, 1527ms total)
T2470 370:157 JLINK_IsHalted()  returns FALSE (0000ms, 1527ms total)
T2470 370:257 JLINK_IsHalted()  returns FALSE (0000ms, 1527ms total)
T2470 370:358 JLINK_IsHalted()  returns FALSE (0000ms, 1527ms total)
T2470 370:459 JLINK_IsHalted()  returns FALSE (0000ms, 1527ms total)
T2470 370:559 JLINK_IsHalted()  returns FALSE (0000ms, 1527ms total)
T2470 370:660 JLINK_IsHalted()  returns FALSE (0000ms, 1527ms total)
T2470 370:761 JLINK_IsHalted()  returns FALSE (0000ms, 1527ms total)
T2470 370:862 JLINK_IsHalted()  returns FALSE (0000ms, 1527ms total)
T2470 370:962 JLINK_IsHalted()  returns FALSE (0000ms, 1527ms total)
T2470 371:063 JLINK_IsHalted()  returns FALSE (0000ms, 1527ms total)
T2470 371:164 JLINK_IsHalted()  returns FALSE (0000ms, 1527ms total)
T2470 371:265 JLINK_IsHalted()  returns FALSE (0000ms, 1527ms total)
T2470 371:365 JLINK_IsHalted()  returns FALSE (0000ms, 1527ms total)
T2470 371:466 JLINK_IsHalted()  returns FALSE (0000ms, 1527ms total)
T2470 371:567 JLINK_IsHalted()  returns FALSE (0000ms, 1527ms total)
T2470 371:668 JLINK_IsHalted()  returns FALSE (0000ms, 1527ms total)
T2470 371:768 JLINK_IsHalted()  returns FALSE (0000ms, 1527ms total)
T2470 371:869 JLINK_IsHalted()  returns FALSE (0000ms, 1527ms total)
T2470 371:970 JLINK_IsHalted()  returns FALSE (0000ms, 1527ms total)
T2470 372:070 JLINK_IsHalted()  returns FALSE (0000ms, 1527ms total)
T2470 372:171 JLINK_IsHalted()  returns FALSE (0000ms, 1527ms total)
T2470 372:272 JLINK_IsHalted()  returns FALSE (0000ms, 1527ms total)
T2470 372:373 JLINK_IsHalted()  returns FALSE (0000ms, 1527ms total)
T2470 372:473 JLINK_IsHalted()  returns FALSE (0000ms, 1527ms total)
T2470 372:574 JLINK_IsHalted()  returns FALSE (0000ms, 1527ms total)
T2470 372:675 JLINK_IsHalted()  returns FALSE (0000ms, 1527ms total)
T2470 372:776 JLINK_IsHalted()  returns FALSE (0000ms, 1527ms total)
T2470 372:876 JLINK_IsHalted()  returns FALSE (0000ms, 1527ms total)
T2470 372:977 JLINK_IsHalted()  returns FALSE (0000ms, 1527ms total)
T2470 373:078 JLINK_IsHalted()  returns FALSE (0000ms, 1527ms total)
T2470 373:178 JLINK_IsHalted()  returns FALSE (0000ms, 1527ms total)
T2470 373:279 JLINK_IsHalted()  returns FALSE (0000ms, 1527ms total)
T2470 373:380 JLINK_IsHalted()  returns FALSE (0000ms, 1527ms total)
T2470 373:481 JLINK_IsHalted()  returns FALSE (0000ms, 1527ms total)
T2470 373:581 JLINK_IsHalted()  returns FALSE (0000ms, 1527ms total)
T2470 373:682 JLINK_IsHalted()  returns FALSE (0000ms, 1527ms total)
T2470 373:783 JLINK_IsHalted()  returns FALSE (0000ms, 1527ms total)
T2470 373:884 JLINK_IsHalted()  returns FALSE (0000ms, 1527ms total)
T2470 373:984 JLINK_IsHalted()  returns FALSE (0000ms, 1527ms total)
T2470 374:085 JLINK_IsHalted()  returns FALSE (0000ms, 1527ms total)
T2470 374:186 JLINK_IsHalted()  returns FALSE (0000ms, 1527ms total)
T2470 374:287 JLINK_IsHalted()  returns FALSE (0000ms, 1527ms total)
T2470 374:387 JLINK_IsHalted()  returns FALSE (0000ms, 1527ms total)
T2470 374:488 JLINK_IsHalted()  returns FALSE (0000ms, 1527ms total)
T2470 374:589 JLINK_IsHalted()  returns FALSE (0000ms, 1527ms total)
T2470 374:689 JLINK_IsHalted()  returns FALSE (0000ms, 1527ms total)
T2470 374:790 JLINK_IsHalted()  returns FALSE (0000ms, 1527ms total)
T2470 374:891 JLINK_IsHalted()  returns FALSE (0000ms, 1527ms total)
T2470 374:992 JLINK_IsHalted()  returns FALSE (0000ms, 1527ms total)
T2470 375:092 JLINK_IsHalted()  returns FALSE (0000ms, 1527ms total)
T2470 375:193 JLINK_IsHalted()  returns FALSE (0000ms, 1527ms total)
T2470 375:298 JLINK_IsHalted()  returns FALSE (0007ms, 1535ms total)
T2470 375:407 JLINK_IsHalted()  returns FALSE (0000ms, 1528ms total)
T2470 375:508 JLINK_IsHalted()  returns FALSE (0000ms, 1528ms total)
T2470 375:616 JLINK_IsHalted()  returns FALSE (0001ms, 1529ms total)
T2470 375:718 JLINK_IsHalted()  returns FALSE (0000ms, 1528ms total)
T2470 375:823 JLINK_IsHalted()  returns FALSE (0007ms, 1535ms total)
T2470 375:933 JLINK_IsHalted()  returns FALSE (0012ms, 1540ms total)
T2470 376:046 JLINK_IsHalted()  returns FALSE (0000ms, 1528ms total)
T2470 376:158 JLINK_IsHalted()  returns FALSE (0000ms, 1528ms total)
T2470 376:263 JLINK_IsHalted()  returns FALSE (0001ms, 1529ms total)
T2470 376:385 JLINK_IsHalted()  returns FALSE (0009ms, 1537ms total)
T2470 376:496 JLINK_IsHalted()  returns FALSE (0000ms, 1528ms total)
T2470 376:629 JLINK_IsHalted()  returns FALSE (0003ms, 1531ms total)
T2470 376:734 JLINK_IsHalted()  returns FALSE (0000ms, 1528ms total)
T2470 376:835 JLINK_IsHalted()  returns FALSE (0000ms, 1528ms total)
T2470 376:941 JLINK_IsHalted()  returns FALSE (0007ms, 1535ms total)
T2470 377:059 JLINK_IsHalted()  returns FALSE (0007ms, 1535ms total)
T2470 377:167 JLINK_IsHalted()  returns FALSE (0000ms, 1528ms total)
T2470 377:270 JLINK_IsHalted()  returns FALSE (0000ms, 1528ms total)
T2470 377:383 JLINK_IsHalted()  returns FALSE (0007ms, 1535ms total)
T2470 377:491 JLINK_IsHalted()  returns FALSE (0001ms, 1529ms total)
T2470 377:594 JLINK_IsHalted()  returns FALSE (0000ms, 1528ms total)
T2470 377:697 JLINK_IsHalted()  returns FALSE (0001ms, 1529ms total)
T2470 377:799 JLINK_IsHalted()  returns FALSE (0000ms, 1528ms total)
T2470 377:900 JLINK_IsHalted()  returns FALSE (0000ms, 1528ms total)
T2470 378:012 JLINK_IsHalted()  returns FALSE (0001ms, 1529ms total)
T2470 378:140 JLINK_IsHalted()  returns FALSE (0009ms, 1537ms total)
T2470 378:252 JLINK_IsHalted()  returns FALSE (0002ms, 1530ms total)
T2470 378:360 JLINK_IsHalted()  returns FALSE (0000ms, 1528ms total)
T2470 378:464 JLINK_IsHalted()  returns FALSE (0000ms, 1528ms total)
T2470 378:578 JLINK_IsHalted()  returns FALSE (0007ms, 1535ms total)
T2470 378:686 JLINK_IsHalted()  returns FALSE (0000ms, 1528ms total)
T2470 378:786 JLINK_IsHalted()  returns FALSE (0000ms, 1528ms total)
T2470 378:891 JLINK_IsHalted()  returns FALSE (0005ms, 1533ms total)
T2470 378:998 JLINK_IsHalted()  returns FALSE (0000ms, 1528ms total)
T2470 379:099 JLINK_IsHalted()  returns FALSE (0002ms, 1530ms total)
T2470 379:204 JLINK_IsHalted()  returns FALSE (0011ms, 1539ms total)
T2470 379:329 JLINK_IsHalted()  returns FALSE (0000ms, 1528ms total)
T2470 379:433 JLINK_IsHalted()  returns FALSE (0008ms, 1536ms total)
T2470 379:551 JLINK_IsHalted()  returns FALSE (0003ms, 1531ms total)
T2470 379:664 JLINK_IsHalted()  returns FALSE (0000ms, 1528ms total)
T2470 379:769 JLINK_IsHalted()  returns FALSE (0000ms, 1528ms total)
T2470 379:871 JLINK_IsHalted()  returns FALSE (0000ms, 1528ms total)
T2470 379:974 JLINK_IsHalted()  returns FALSE (0000ms, 1528ms total)
T2470 380:076 JLINK_IsHalted()  returns FALSE (0000ms, 1528ms total)
T2470 380:180 JLINK_IsHalted()  returns FALSE (0000ms, 1528ms total)
T2470 380:280 JLINK_IsHalted()  returns FALSE (0000ms, 1528ms total)
T2470 380:383 JLINK_IsHalted()  returns FALSE (0008ms, 1536ms total)
T2470 380:493 JLINK_IsHalted()  returns FALSE (0000ms, 1528ms total)
T2470 380:602 JLINK_IsHalted()  returns FALSE (0000ms, 1528ms total)
T2470 380:718 JLINK_IsHalted()  returns FALSE (0004ms, 1532ms total)
T2470 380:828 JLINK_IsHalted()  returns FALSE (0000ms, 1528ms total)
T2470 380:932 JLINK_IsHalted()  returns FALSE (0004ms, 1532ms total)
T2470 381:039 JLINK_IsHalted()  returns FALSE (0001ms, 1529ms total)
T2470 381:144 JLINK_IsHalted()  returns FALSE (0009ms, 1537ms total)
T2470 381:254 JLINK_IsHalted()  returns FALSE (0000ms, 1528ms total)
T2470 381:361 JLINK_IsHalted()  returns FALSE (0000ms, 1528ms total)
T2470 381:461 JLINK_IsHalted()  returns FALSE (0000ms, 1528ms total)
T2470 381:562 JLINK_IsHalted()  returns FALSE (0000ms, 1528ms total)
T2470 381:667 JLINK_IsHalted()  returns FALSE (0001ms, 1529ms total)
T2470 381:770 JLINK_IsHalted()  returns FALSE (0025ms, 1553ms total)
T2470 381:899 JLINK_IsHalted()  returns FALSE (0004ms, 1532ms total)
T2470 382:012 JLINK_IsHalted()  returns FALSE (0007ms, 1535ms total)
T2470 382:121 JLINK_IsHalted()  returns FALSE (0000ms, 1528ms total)
T2470 382:231 JLINK_IsHalted()  returns FALSE (0000ms, 1528ms total)
T2470 382:333 JLINK_IsHalted()  returns FALSE (0000ms, 1528ms total)
T2470 382:434 JLINK_IsHalted()  returns FALSE (0000ms, 1528ms total)
T2470 382:538 JLINK_IsHalted()  returns FALSE (0000ms, 1528ms total)
T2470 382:639 JLINK_IsHalted()  returns FALSE (0000ms, 1528ms total)
T2470 382:740 JLINK_IsHalted()  returns FALSE (0000ms, 1528ms total)
T2470 382:845 JLINK_IsHalted()  returns FALSE (0001ms, 1529ms total)
T2470 382:948 JLINK_IsHalted()  returns FALSE (0000ms, 1528ms total)
T2470 383:069 JLINK_IsHalted()  returns FALSE (0001ms, 1529ms total)
T2470 383:174 JLINK_IsHalted()  returns FALSE (0005ms, 1533ms total)
T2470 383:279 JLINK_IsHalted()  returns FALSE (0000ms, 1528ms total)
T2470 383:399 JLINK_IsHalted()  returns FALSE (0002ms, 1530ms total)
T2470 383:503 JLINK_IsHalted()  returns FALSE (0000ms, 1528ms total)
T2470 383:604 JLINK_IsHalted()  returns FALSE (0000ms, 1528ms total)
T2470 383:704 JLINK_IsHalted()  returns FALSE (0000ms, 1528ms total)
T2470 383:821 JLINK_IsHalted()  returns FALSE (0000ms, 1528ms total)
T2470 383:934 JLINK_IsHalted()  returns FALSE (0001ms, 1529ms total)
T2470 384:040 JLINK_IsHalted()  returns FALSE (0000ms, 1528ms total)
T2470 384:167 JLINK_IsHalted()  returns FALSE (0000ms, 1528ms total)
T2470 384:271 JLINK_IsHalted()  returns FALSE (0000ms, 1528ms total)
T2470 384:374 JLINK_IsHalted()  returns FALSE (0000ms, 1528ms total)
T2470 384:476 JLINK_IsHalted()  returns FALSE (0000ms, 1528ms total)
T2470 384:581 JLINK_IsHalted()  returns FALSE (0006ms, 1534ms total)
T2470 384:695 JLINK_IsHalted()  returns FALSE (0004ms, 1532ms total)
T2470 384:805 JLINK_IsHalted()  returns FALSE (0006ms, 1534ms total)
T2470 384:931 JLINK_IsHalted()  returns FALSE (0000ms, 1528ms total)
T2470 385:032 JLINK_IsHalted()  returns FALSE (0015ms, 1543ms total)
T2470 385:159 JLINK_IsHalted()  returns FALSE (0000ms, 1528ms total)
T2470 385:269 JLINK_IsHalted()  returns FALSE (0017ms, 1545ms total)
T2470 385:395 JLINK_IsHalted()  returns FALSE (0000ms, 1528ms total)
T2470 385:497 JLINK_IsHalted()  returns FALSE (0000ms, 1528ms total)
T2470 385:616 JLINK_IsHalted()  returns FALSE (0003ms, 1531ms total)
T2470 385:725 JLINK_IsHalted()  returns FALSE (0001ms, 1529ms total)
T2470 385:827 JLINK_IsHalted()  returns FALSE (0000ms, 1528ms total)
T2470 385:927 JLINK_IsHalted()  returns FALSE (0000ms, 1528ms total)
T2470 386:028 JLINK_IsHalted()  returns FALSE (0000ms, 1528ms total)
T2470 386:129 JLINK_IsHalted()  returns FALSE (0000ms, 1528ms total)
T2470 386:230 JLINK_IsHalted()  returns FALSE (0000ms, 1528ms total)
T2470 386:330 JLINK_IsHalted()  returns FALSE (0000ms, 1528ms total)
T2470 386:431 JLINK_IsHalted()  returns FALSE (0000ms, 1528ms total)
T2470 386:532 JLINK_IsHalted()  returns FALSE (0000ms, 1528ms total)
T2470 386:633 JLINK_IsHalted()  returns FALSE (0000ms, 1528ms total)
T2470 386:733 JLINK_IsHalted()  returns FALSE (0000ms, 1528ms total)
T2470 386:834 JLINK_IsHalted()  returns FALSE (0000ms, 1528ms total)
T2470 386:935 JLINK_IsHalted()  returns FALSE (0000ms, 1528ms total)
T2470 387:035 JLINK_IsHalted()  returns FALSE (0000ms, 1528ms total)
T2470 387:136 JLINK_IsHalted()  returns FALSE (0000ms, 1528ms total)
T2470 387:237 JLINK_IsHalted()  returns FALSE (0000ms, 1528ms total)
T2470 387:338 JLINK_IsHalted()  returns FALSE (0000ms, 1528ms total)
T2470 387:438 JLINK_IsHalted()  returns FALSE (0000ms, 1528ms total)
T2470 387:539 JLINK_IsHalted()  returns FALSE (0000ms, 1528ms total)
T2470 387:640 JLINK_IsHalted()  returns FALSE (0000ms, 1528ms total)
T2470 387:741 JLINK_IsHalted()  returns FALSE (0000ms, 1528ms total)
T2470 387:841 JLINK_IsHalted()  returns FALSE (0000ms, 1528ms total)
T2470 387:942 JLINK_IsHalted()  returns FALSE (0000ms, 1528ms total)
T2470 388:043 JLINK_IsHalted()  returns FALSE (0000ms, 1528ms total)
T2470 388:143 JLINK_IsHalted()  returns FALSE (0000ms, 1528ms total)
T2470 388:244 JLINK_IsHalted()  returns FALSE (0000ms, 1528ms total)
T2470 388:345 JLINK_IsHalted()  returns FALSE (0000ms, 1528ms total)
T2470 388:446 JLINK_IsHalted()  returns FALSE (0000ms, 1528ms total)
T2470 388:546 JLINK_IsHalted()  returns FALSE (0000ms, 1528ms total)
T2470 388:647 JLINK_IsHalted()  returns FALSE (0000ms, 1528ms total)
T2470 388:748 JLINK_IsHalted()  returns FALSE (0000ms, 1528ms total)
T2470 388:849 JLINK_IsHalted()  returns FALSE (0000ms, 1528ms total)
T2470 388:949 JLINK_IsHalted()  returns FALSE (0000ms, 1528ms total)
T2470 389:050 JLINK_IsHalted()  returns FALSE (0000ms, 1528ms total)
T2470 389:151 JLINK_IsHalted()  returns FALSE (0000ms, 1528ms total)
T2470 389:252 JLINK_IsHalted()  returns FALSE (0000ms, 1528ms total)
T2470 389:352 JLINK_IsHalted()  returns FALSE (0000ms, 1528ms total)
T2470 389:453 JLINK_IsHalted()  returns FALSE (0000ms, 1528ms total)
T2470 389:554 JLINK_IsHalted()  returns FALSE (0000ms, 1528ms total)
T2470 389:654 JLINK_IsHalted()  returns FALSE (0000ms, 1528ms total)
T2470 389:755 JLINK_IsHalted()  returns FALSE (0000ms, 1528ms total)
T2470 389:856 JLINK_IsHalted()  returns FALSE (0000ms, 1528ms total)
T2470 389:957 JLINK_IsHalted()  returns FALSE (0000ms, 1528ms total)
T2470 390:057 JLINK_IsHalted()  returns FALSE (0000ms, 1528ms total)
T2470 390:158 JLINK_IsHalted()  returns FALSE (0000ms, 1528ms total)
T2470 390:259 JLINK_IsHalted()  returns FALSE (0000ms, 1528ms total)
T2470 390:360 JLINK_IsHalted()  returns FALSE (0000ms, 1528ms total)
T2470 390:460 JLINK_IsHalted()  returns FALSE (0000ms, 1528ms total)
T2470 390:561 JLINK_IsHalted()  returns FALSE (0000ms, 1528ms total)
T2470 390:662 JLINK_IsHalted()  returns FALSE (0000ms, 1528ms total)
T2470 390:762 JLINK_IsHalted()  returns FALSE (0000ms, 1528ms total)
T4118 390:847 JLINK_ReadMemEx(0x20002194, 0x0001 Bytes, ..., Flags = 0x02000000) -- CPU_ReadMem(1 bytes @ 0x20002194) - Data: 00  returns 0x01 (0001ms, 1529ms total)
T4118 390:848 JLINK_ReadMemEx(0x20002195, 0x0001 Bytes, ..., Flags = 0x02000000) -- CPU_ReadMem(1 bytes @ 0x20002195) - Data: 00  returns 0x01 (0000ms, 1529ms total)
T4118 390:848 JLINK_ReadMemEx(0x20002196, 0x0001 Bytes, ..., Flags = 0x02000000) -- CPU_ReadMem(1 bytes @ 0x20002196) - Data: 00  returns 0x01 (0000ms, 1529ms total)
T4118 390:848 JLINK_ReadMemEx(0x20002197, 0x0001 Bytes, ..., Flags = 0x02000000) -- CPU_ReadMem(1 bytes @ 0x20002197) - Data: 00  returns 0x01 (0000ms, 1529ms total)
T4118 390:848 JLINK_ReadMemEx(0x20002198, 0x0001 Bytes, ..., Flags = 0x02000000) -- CPU_ReadMem(1 bytes @ 0x20002198) - Data: 00  returns 0x01 (0001ms, 1530ms total)
T4118 390:849 JLINK_ReadMemEx(0x20002199, 0x0001 Bytes, ..., Flags = 0x02000000) -- CPU_ReadMem(1 bytes @ 0x20002199) - Data: 00  returns 0x01 (0000ms, 1530ms total)
T4118 390:849 JLINK_ReadMemEx(0x2000219A, 0x0001 Bytes, ..., Flags = 0x02000000) -- CPU_ReadMem(1 bytes @ 0x2000219A) - Data: 00  returns 0x01 (0000ms, 1530ms total)
T4118 390:849 JLINK_ReadMemEx(0x2000219B, 0x0001 Bytes, ..., Flags = 0x02000000) -- CPU_ReadMem(1 bytes @ 0x2000219B) - Data: 00  returns 0x01 (0000ms, 1530ms total)
T4118 390:849 JLINK_ReadMemEx(0x2000219C, 0x0001 Bytes, ..., Flags = 0x02000000) -- CPU_ReadMem(1 bytes @ 0x2000219C) - Data: 00  returns 0x01 (0001ms, 1531ms total)
T4118 390:850 JLINK_ReadMemEx(0x2000219D, 0x0001 Bytes, ..., Flags = 0x02000000) -- CPU_ReadMem(1 bytes @ 0x2000219D) - Data: 00  returns 0x01 (0000ms, 1531ms total)
T4118 390:850 JLINK_ReadMemEx(0x2000219E, 0x0001 Bytes, ..., Flags = 0x02000000) -- CPU_ReadMem(1 bytes @ 0x2000219E) - Data: 00  returns 0x01 (0000ms, 1531ms total)
T4118 390:850 JLINK_ReadMemEx(0x2000219F, 0x0001 Bytes, ..., Flags = 0x02000000) -- CPU_ReadMem(1 bytes @ 0x2000219F) - Data: 00  returns 0x01 (0001ms, 1532ms total)
T4118 390:851 JLINK_ReadMemEx(0x200021A0, 0x0001 Bytes, ..., Flags = 0x02000000) -- CPU_ReadMem(1 bytes @ 0x200021A0) - Data: 00  returns 0x01 (0000ms, 1532ms total)
T4118 390:851 JLINK_ReadMemEx(0x200021A1, 0x0001 Bytes, ..., Flags = 0x02000000) -- CPU_ReadMem(1 bytes @ 0x200021A1) - Data: 00  returns 0x01 (0000ms, 1532ms total)
T4118 390:851 JLINK_ReadMemEx(0x200021A2, 0x0001 Bytes, ..., Flags = 0x02000000) -- CPU_ReadMem(1 bytes @ 0x200021A2) - Data: 00  returns 0x01 (0000ms, 1532ms total)
T4118 390:851 JLINK_ReadMemEx(0x200021A3, 0x0001 Bytes, ..., Flags = 0x02000000) -- CPU_ReadMem(1 bytes @ 0x200021A3) - Data: 00  returns 0x01 (0001ms, 1533ms total)
T4118 390:852 JLINK_ReadMemEx(0x200021A4, 0x0001 Bytes, ..., Flags = 0x02000000) -- CPU_ReadMem(1 bytes @ 0x200021A4) - Data: 00  returns 0x01 (0000ms, 1533ms total)
T4118 390:852 JLINK_ReadMemEx(0x200021A5, 0x0001 Bytes, ..., Flags = 0x02000000) -- CPU_ReadMem(1 bytes @ 0x200021A5) - Data: 00  returns 0x01 (0000ms, 1533ms total)
T4118 390:852 JLINK_ReadMemEx(0x200021A6, 0x0001 Bytes, ..., Flags = 0x02000000) -- CPU_ReadMem(1 bytes @ 0x200021A6) - Data: 00  returns 0x01 (0000ms, 1533ms total)
T4118 390:852 JLINK_ReadMemEx(0x200021A7, 0x0001 Bytes, ..., Flags = 0x02000000) -- CPU_ReadMem(1 bytes @ 0x200021A7) - Data: 00  returns 0x01 (0001ms, 1534ms total)
T4118 390:853 JLINK_ReadMemEx(0x200021A8, 0x0001 Bytes, ..., Flags = 0x02000000) -- CPU_ReadMem(1 bytes @ 0x200021A8) - Data: 00  returns 0x01 (0000ms, 1534ms total)
T4118 390:853 JLINK_ReadMemEx(0x200021A9, 0x0001 Bytes, ..., Flags = 0x02000000) -- CPU_ReadMem(1 bytes @ 0x200021A9) - Data: 00  returns 0x01 (0000ms, 1534ms total)
T4118 390:853 JLINK_ReadMemEx(0x200021AA, 0x0001 Bytes, ..., Flags = 0x02000000) -- CPU_ReadMem(1 bytes @ 0x200021AA) - Data: 00  returns 0x01 (0001ms, 1535ms total)
T4118 390:854 JLINK_ReadMemEx(0x200021AB, 0x0001 Bytes, ..., Flags = 0x02000000) -- CPU_ReadMem(1 bytes @ 0x200021AB) - Data: 00  returns 0x01 (0000ms, 1535ms total)
T4118 390:854 JLINK_ReadMemEx(0x200021AC, 0x0001 Bytes, ..., Flags = 0x02000000) -- CPU_ReadMem(1 bytes @ 0x200021AC) - Data: 00  returns 0x01 (0000ms, 1535ms total)
T4118 390:854 JLINK_ReadMemEx(0x200021AD, 0x0001 Bytes, ..., Flags = 0x02000000) -- CPU_ReadMem(1 bytes @ 0x200021AD) - Data: 00  returns 0x01 (0000ms, 1535ms total)
T4118 390:854 JLINK_ReadMemEx(0x200021AE, 0x0001 Bytes, ..., Flags = 0x02000000) -- CPU_ReadMem(1 bytes @ 0x200021AE) - Data: 00  returns 0x01 (0001ms, 1536ms total)
T4118 390:855 JLINK_ReadMemEx(0x200021AF, 0x0001 Bytes, ..., Flags = 0x02000000) -- CPU_ReadMem(1 bytes @ 0x200021AF) - Data: 00  returns 0x01 (0000ms, 1536ms total)
T4118 390:855 JLINK_ReadMemEx(0x200021B0, 0x0001 Bytes, ..., Flags = 0x02000000) -- CPU_ReadMem(1 bytes @ 0x200021B0) - Data: 00  returns 0x01 (0000ms, 1536ms total)
T4118 390:855 JLINK_ReadMemEx(0x200021B1, 0x0001 Bytes, ..., Flags = 0x02000000) -- CPU_ReadMem(1 bytes @ 0x200021B1) - Data: 00  returns 0x01 (0000ms, 1536ms total)
T4118 390:855 JLINK_ReadMemEx(0x200021B2, 0x0001 Bytes, ..., Flags = 0x02000000) -- CPU_ReadMem(1 bytes @ 0x200021B2) - Data: 00  returns 0x01 (0001ms, 1537ms total)
T4118 390:856 JLINK_ReadMemEx(0x200021B3, 0x0001 Bytes, ..., Flags = 0x02000000) -- CPU_ReadMem(1 bytes @ 0x200021B3) - Data: 00  returns 0x01 (0000ms, 1537ms total)
T4118 390:856 JLINK_ReadMemEx(0x200021B4, 0x0001 Bytes, ..., Flags = 0x02000000) -- CPU_ReadMem(1 bytes @ 0x200021B4) - Data: 00  returns 0x01 (0000ms, 1537ms total)
T4118 390:856 JLINK_ReadMemEx(0x200021B5, 0x0001 Bytes, ..., Flags = 0x02000000) -- CPU_ReadMem(1 bytes @ 0x200021B5) - Data: 00  returns 0x01 (0000ms, 1537ms total)
T4118 390:856 JLINK_ReadMemEx(0x200021B6, 0x0001 Bytes, ..., Flags = 0x02000000) -- CPU_ReadMem(1 bytes @ 0x200021B6) - Data: 00  returns 0x01 (0001ms, 1538ms total)
T4118 390:857 JLINK_ReadMemEx(0x200021B7, 0x0001 Bytes, ..., Flags = 0x02000000) -- CPU_ReadMem(1 bytes @ 0x200021B7) - Data: 00  returns 0x01 (0000ms, 1538ms total)
T4118 390:857 JLINK_ReadMemEx(0x200021B8, 0x0001 Bytes, ..., Flags = 0x02000000) -- CPU_ReadMem(1 bytes @ 0x200021B8) - Data: 00  returns 0x01 (0000ms, 1538ms total)
T4118 390:857 JLINK_ReadMemEx(0x200021B9, 0x0001 Bytes, ..., Flags = 0x02000000) -- CPU_ReadMem(1 bytes @ 0x200021B9) - Data: 00  returns 0x01 (0000ms, 1538ms total)
T4118 390:857 JLINK_ReadMemEx(0x200021BA, 0x0001 Bytes, ..., Flags = 0x02000000) -- CPU_ReadMem(1 bytes @ 0x200021BA) - Data: 00  returns 0x01 (0001ms, 1539ms total)
T4118 390:858 JLINK_ReadMemEx(0x200021BB, 0x0001 Bytes, ..., Flags = 0x02000000) -- CPU_ReadMem(1 bytes @ 0x200021BB) - Data: 00  returns 0x01 (0000ms, 1539ms total)
T4118 390:858 JLINK_ReadMemEx(0x200021BC, 0x0001 Bytes, ..., Flags = 0x02000000) -- CPU_ReadMem(1 bytes @ 0x200021BC) - Data: 00  returns 0x01 (0000ms, 1539ms total)
T4118 390:858 JLINK_ReadMemEx(0x200021BD, 0x0001 Bytes, ..., Flags = 0x02000000) -- CPU_ReadMem(1 bytes @ 0x200021BD) - Data: 00  returns 0x01 (0001ms, 1540ms total)
T4118 390:859 JLINK_ReadMemEx(0x200021BE, 0x0001 Bytes, ..., Flags = 0x02000000) -- CPU_ReadMem(1 bytes @ 0x200021BE) - Data: 00  returns 0x01 (0000ms, 1540ms total)
T4118 390:859 JLINK_ReadMemEx(0x200021BF, 0x0001 Bytes, ..., Flags = 0x02000000) -- CPU_ReadMem(1 bytes @ 0x200021BF) - Data: 00  returns 0x01 (0000ms, 1540ms total)
T4118 390:859 JLINK_ReadMemEx(0x200021C0, 0x0001 Bytes, ..., Flags = 0x02000000) -- CPU_ReadMem(1 bytes @ 0x200021C0) - Data: 00  returns 0x01 (0000ms, 1540ms total)
T4118 390:859 JLINK_ReadMemEx(0x200021C1, 0x0001 Bytes, ..., Flags = 0x02000000) -- CPU_ReadMem(1 bytes @ 0x200021C1) - Data: 00  returns 0x01 (0001ms, 1541ms total)
T4118 390:860 JLINK_ReadMemEx(0x200021C2, 0x0001 Bytes, ..., Flags = 0x02000000) -- CPU_ReadMem(1 bytes @ 0x200021C2) - Data: 00  returns 0x01 (0000ms, 1541ms total)
T4118 390:860 JLINK_ReadMemEx(0x200021C3, 0x0001 Bytes, ..., Flags = 0x02000000) -- CPU_ReadMem(1 bytes @ 0x200021C3) - Data: 00  returns 0x01 (0000ms, 1541ms total)
T2470 390:863 JLINK_IsHalted()  returns FALSE (0000ms, 1541ms total)
T2470 390:964 JLINK_IsHalted()  returns FALSE (0000ms, 1541ms total)
T2470 391:065 JLINK_IsHalted()  returns FALSE (0000ms, 1541ms total)
T2470 391:165 JLINK_IsHalted()  returns FALSE (0000ms, 1541ms total)
T2470 391:266 JLINK_IsHalted()  returns FALSE (0000ms, 1541ms total)
T2470 391:367 JLINK_IsHalted()  returns FALSE (0000ms, 1541ms total)
T2470 391:468 JLINK_IsHalted()  returns FALSE (0000ms, 1541ms total)
T4118 391:526 JLINK_ReadMemEx(0x20002194, 0x0001 Bytes, ..., Flags = 0x02000000) -- CPU_ReadMem(1 bytes @ 0x20002194) - Data: 00  returns 0x01 (0000ms, 1541ms total)
T4118 391:527 JLINK_ReadMemEx(0x20002195, 0x0001 Bytes, ..., Flags = 0x02000000) -- CPU_ReadMem(1 bytes @ 0x20002195) - Data: 00  returns 0x01 (0000ms, 1542ms total)
T4118 391:527 JLINK_ReadMemEx(0x20002196, 0x0001 Bytes, ..., Flags = 0x02000000) -- CPU_ReadMem(1 bytes @ 0x20002196) - Data: 00  returns 0x01 (0000ms, 1542ms total)
T4118 391:527 JLINK_ReadMemEx(0x20002197, 0x0001 Bytes, ..., Flags = 0x02000000) -- CPU_ReadMem(1 bytes @ 0x20002197) - Data: 00  returns 0x01 (0001ms, 1543ms total)
T4118 391:528 JLINK_ReadMemEx(0x20002198, 0x0001 Bytes, ..., Flags = 0x02000000) -- CPU_ReadMem(1 bytes @ 0x20002198) - Data: 00  returns 0x01 (0000ms, 1543ms total)
T4118 391:528 JLINK_ReadMemEx(0x20002199, 0x0001 Bytes, ..., Flags = 0x02000000) -- CPU_ReadMem(1 bytes @ 0x20002199) - Data: 00  returns 0x01 (0000ms, 1543ms total)
T4118 391:528 JLINK_ReadMemEx(0x2000219A, 0x0001 Bytes, ..., Flags = 0x02000000) -- CPU_ReadMem(1 bytes @ 0x2000219A) - Data: 00  returns 0x01 (0001ms, 1544ms total)
T4118 391:529 JLINK_ReadMemEx(0x2000219B, 0x0001 Bytes, ..., Flags = 0x02000000) -- CPU_ReadMem(1 bytes @ 0x2000219B) - Data: 00  returns 0x01 (0000ms, 1544ms total)
T4118 391:529 JLINK_ReadMemEx(0x2000219C, 0x0001 Bytes, ..., Flags = 0x02000000) -- CPU_ReadMem(1 bytes @ 0x2000219C) - Data: 00  returns 0x01 (0001ms, 1545ms total)
T4118 391:530 JLINK_ReadMemEx(0x2000219D, 0x0001 Bytes, ..., Flags = 0x02000000) -- CPU_ReadMem(1 bytes @ 0x2000219D) - Data: 00  returns 0x01 (0000ms, 1545ms total)
T4118 391:530 JLINK_ReadMemEx(0x2000219E, 0x0001 Bytes, ..., Flags = 0x02000000) -- CPU_ReadMem(1 bytes @ 0x2000219E) - Data: 00  returns 0x01 (0000ms, 1545ms total)
T4118 391:530 JLINK_ReadMemEx(0x2000219F, 0x0001 Bytes, ..., Flags = 0x02000000) -- CPU_ReadMem(1 bytes @ 0x2000219F) - Data: 00  returns 0x01 (0001ms, 1546ms total)
T4118 391:531 JLINK_ReadMemEx(0x200021A0, 0x0001 Bytes, ..., Flags = 0x02000000) -- CPU_ReadMem(1 bytes @ 0x200021A0) - Data: 00  returns 0x01 (0000ms, 1546ms total)
T4118 391:531 JLINK_ReadMemEx(0x200021A1, 0x0001 Bytes, ..., Flags = 0x02000000) -- CPU_ReadMem(1 bytes @ 0x200021A1) - Data: 00  returns 0x01 (0001ms, 1547ms total)
T4118 391:532 JLINK_ReadMemEx(0x200021A2, 0x0001 Bytes, ..., Flags = 0x02000000) -- CPU_ReadMem(1 bytes @ 0x200021A2) - Data: 00  returns 0x01 (0000ms, 1547ms total)
T4118 391:532 JLINK_ReadMemEx(0x200021A3, 0x0001 Bytes, ..., Flags = 0x02000000) -- CPU_ReadMem(1 bytes @ 0x200021A3) - Data: 00  returns 0x01 (0000ms, 1547ms total)
T4118 391:532 JLINK_ReadMemEx(0x200021A4, 0x0001 Bytes, ..., Flags = 0x02000000) -- CPU_ReadMem(1 bytes @ 0x200021A4) - Data: 00  returns 0x01 (0001ms, 1548ms total)
T4118 391:533 JLINK_ReadMemEx(0x200021A5, 0x0001 Bytes, ..., Flags = 0x02000000) -- CPU_ReadMem(1 bytes @ 0x200021A5) - Data: 00  returns 0x01 (0000ms, 1548ms total)
T4118 391:533 JLINK_ReadMemEx(0x200021A6, 0x0001 Bytes, ..., Flags = 0x02000000) -- CPU_ReadMem(1 bytes @ 0x200021A6) - Data: 00  returns 0x01 (0000ms, 1548ms total)
T4118 391:533 JLINK_ReadMemEx(0x200021A7, 0x0001 Bytes, ..., Flags = 0x02000000) -- CPU_ReadMem(1 bytes @ 0x200021A7) - Data: 00  returns 0x01 (0001ms, 1549ms total)
T4118 391:534 JLINK_ReadMemEx(0x200021A8, 0x0001 Bytes, ..., Flags = 0x02000000) -- CPU_ReadMem(1 bytes @ 0x200021A8) - Data: 00  returns 0x01 (0000ms, 1549ms total)
T4118 391:534 JLINK_ReadMemEx(0x200021A9, 0x0001 Bytes, ..., Flags = 0x02000000) -- CPU_ReadMem(1 bytes @ 0x200021A9) - Data: 00  returns 0x01 (0000ms, 1549ms total)
T4118 391:535 JLINK_ReadMemEx(0x200021AA, 0x0001 Bytes, ..., Flags = 0x02000000) -- CPU_ReadMem(1 bytes @ 0x200021AA) - Data: 00  returns 0x01 (0000ms, 1550ms total)
T4118 391:535 JLINK_ReadMemEx(0x200021AB, 0x0001 Bytes, ..., Flags = 0x02000000) -- CPU_ReadMem(1 bytes @ 0x200021AB) - Data: 00  returns 0x01 (0000ms, 1550ms total)
T4118 391:535 JLINK_ReadMemEx(0x200021AC, 0x0001 Bytes, ..., Flags = 0x02000000) -- CPU_ReadMem(1 bytes @ 0x200021AC) - Data: 00  returns 0x01 (0001ms, 1551ms total)
T4118 391:536 JLINK_ReadMemEx(0x200021AD, 0x0001 Bytes, ..., Flags = 0x02000000) -- CPU_ReadMem(1 bytes @ 0x200021AD) - Data: 00  returns 0x01 (0000ms, 1551ms total)
T4118 391:536 JLINK_ReadMemEx(0x200021AE, 0x0001 Bytes, ..., Flags = 0x02000000) -- CPU_ReadMem(1 bytes @ 0x200021AE) - Data: 00  returns 0x01 (0000ms, 1551ms total)
T4118 391:536 JLINK_ReadMemEx(0x200021AF, 0x0001 Bytes, ..., Flags = 0x02000000) -- CPU_ReadMem(1 bytes @ 0x200021AF) - Data: 00  returns 0x01 (0001ms, 1552ms total)
T4118 391:537 JLINK_ReadMemEx(0x200021B0, 0x0001 Bytes, ..., Flags = 0x02000000) -- CPU_ReadMem(1 bytes @ 0x200021B0) - Data: 00  returns 0x01 (0000ms, 1552ms total)
T4118 391:537 JLINK_ReadMemEx(0x200021B1, 0x0001 Bytes, ..., Flags = 0x02000000) -- CPU_ReadMem(1 bytes @ 0x200021B1) - Data: 00  returns 0x01 (0000ms, 1552ms total)
T4118 391:537 JLINK_ReadMemEx(0x200021B2, 0x0001 Bytes, ..., Flags = 0x02000000) -- CPU_ReadMem(1 bytes @ 0x200021B2) - Data: 00  returns 0x01 (0001ms, 1553ms total)
T4118 391:538 JLINK_ReadMemEx(0x200021B3, 0x0001 Bytes, ..., Flags = 0x02000000) -- CPU_ReadMem(1 bytes @ 0x200021B3) - Data: 00  returns 0x01 (0000ms, 1553ms total)
T4118 391:538 JLINK_ReadMemEx(0x200021B4, 0x0001 Bytes, ..., Flags = 0x02000000) -- CPU_ReadMem(1 bytes @ 0x200021B4) - Data: 00  returns 0x01 (0000ms, 1553ms total)
T4118 391:538 JLINK_ReadMemEx(0x200021B5, 0x0001 Bytes, ..., Flags = 0x02000000) -- CPU_ReadMem(1 bytes @ 0x200021B5) - Data: 00  returns 0x01 (0001ms, 1554ms total)
T4118 391:539 JLINK_ReadMemEx(0x200021B6, 0x0001 Bytes, ..., Flags = 0x02000000) -- CPU_ReadMem(1 bytes @ 0x200021B6) - Data: 00  returns 0x01 (0000ms, 1554ms total)
T4118 391:539 JLINK_ReadMemEx(0x200021B7, 0x0001 Bytes, ..., Flags = 0x02000000) -- CPU_ReadMem(1 bytes @ 0x200021B7) - Data: 00  returns 0x01 (0000ms, 1554ms total)
T4118 391:539 JLINK_ReadMemEx(0x200021B8, 0x0001 Bytes, ..., Flags = 0x02000000) -- CPU_ReadMem(1 bytes @ 0x200021B8) - Data: 00  returns 0x01 (0001ms, 1555ms total)
T4118 391:540 JLINK_ReadMemEx(0x200021B9, 0x0001 Bytes, ..., Flags = 0x02000000) -- CPU_ReadMem(1 bytes @ 0x200021B9) - Data: 00  returns 0x01 (0000ms, 1555ms total)
T4118 391:540 JLINK_ReadMemEx(0x200021BA, 0x0001 Bytes, ..., Flags = 0x02000000) -- CPU_ReadMem(1 bytes @ 0x200021BA) - Data: 00  returns 0x01 (0000ms, 1555ms total)
T4118 391:540 JLINK_ReadMemEx(0x200021BB, 0x0001 Bytes, ..., Flags = 0x02000000) -- CPU_ReadMem(1 bytes @ 0x200021BB) - Data: 00  returns 0x01 (0001ms, 1556ms total)
T4118 391:541 JLINK_ReadMemEx(0x200021BC, 0x0001 Bytes, ..., Flags = 0x02000000) -- CPU_ReadMem(1 bytes @ 0x200021BC) - Data: 00  returns 0x01 (0000ms, 1556ms total)
T4118 391:541 JLINK_ReadMemEx(0x200021BD, 0x0001 Bytes, ..., Flags = 0x02000000) -- CPU_ReadMem(1 bytes @ 0x200021BD) - Data: 00  returns 0x01 (0000ms, 1556ms total)
T4118 391:541 JLINK_ReadMemEx(0x200021BE, 0x0001 Bytes, ..., Flags = 0x02000000) -- CPU_ReadMem(1 bytes @ 0x200021BE) - Data: 00  returns 0x01 (0001ms, 1557ms total)
T4118 391:542 JLINK_ReadMemEx(0x200021BF, 0x0001 Bytes, ..., Flags = 0x02000000) -- CPU_ReadMem(1 bytes @ 0x200021BF) - Data: 00  returns 0x01 (0000ms, 1557ms total)
T4118 391:542 JLINK_ReadMemEx(0x200021C0, 0x0001 Bytes, ..., Flags = 0x02000000) -- CPU_ReadMem(1 bytes @ 0x200021C0) - Data: 00  returns 0x01 (0000ms, 1557ms total)
T4118 391:542 JLINK_ReadMemEx(0x200021C1, 0x0001 Bytes, ..., Flags = 0x02000000) -- CPU_ReadMem(1 bytes @ 0x200021C1) - Data: 00  returns 0x01 (0001ms, 1558ms total)
T4118 391:543 JLINK_ReadMemEx(0x200021C2, 0x0001 Bytes, ..., Flags = 0x02000000) -- CPU_ReadMem(1 bytes @ 0x200021C2) - Data: 00  returns 0x01 (0000ms, 1558ms total)
T4118 391:543 JLINK_ReadMemEx(0x200021C3, 0x0001 Bytes, ..., Flags = 0x02000000) -- CPU_ReadMem(1 bytes @ 0x200021C3) - Data: 00  returns 0x01 (0000ms, 1558ms total)
T2470 391:568 JLINK_IsHalted()  returns FALSE (0000ms, 1558ms total)
T2470 391:669 JLINK_IsHalted()  returns FALSE (0000ms, 1558ms total)
T2470 391:770 JLINK_IsHalted()  returns FALSE (0000ms, 1558ms total)
T2470 391:871 JLINK_IsHalted()  returns FALSE (0000ms, 1558ms total)
T2470 391:971 JLINK_IsHalted()  returns FALSE (0000ms, 1558ms total)
T2470 392:072 JLINK_IsHalted()  returns FALSE (0000ms, 1558ms total)
T2470 392:173 JLINK_IsHalted()  returns FALSE (0000ms, 1558ms total)
T2470 392:273 JLINK_IsHalted()  returns FALSE (0000ms, 1558ms total)
T2470 392:374 JLINK_IsHalted()  returns FALSE (0000ms, 1558ms total)
T2470 392:475 JLINK_IsHalted()  returns FALSE (0000ms, 1558ms total)
T2470 392:576 JLINK_IsHalted()  returns FALSE (0000ms, 1558ms total)
T2470 392:676 JLINK_IsHalted()  returns FALSE (0000ms, 1558ms total)
T2470 392:777 JLINK_IsHalted()  returns FALSE (0000ms, 1558ms total)
T2470 392:878 JLINK_IsHalted()  returns FALSE (0000ms, 1558ms total)
T2470 392:979 JLINK_IsHalted()  returns FALSE (0000ms, 1558ms total)
T2470 393:079 JLINK_IsHalted()  returns FALSE (0000ms, 1558ms total)
T2470 393:180 JLINK_IsHalted()  returns FALSE (0000ms, 1558ms total)
T2470 393:281 JLINK_IsHalted()  returns FALSE (0000ms, 1558ms total)
T2470 393:381 JLINK_IsHalted()  returns FALSE (0000ms, 1558ms total)
T2470 393:482 JLINK_IsHalted()  returns FALSE (0000ms, 1558ms total)
T2470 393:583 JLINK_IsHalted()  returns FALSE (0000ms, 1558ms total)
T2470 393:684 JLINK_IsHalted()  returns FALSE (0000ms, 1558ms total)
T2470 393:784 JLINK_IsHalted()  returns FALSE (0000ms, 1558ms total)
T2470 393:885 JLINK_IsHalted()  returns FALSE (0000ms, 1558ms total)
T2470 393:986 JLINK_IsHalted()  returns FALSE (0000ms, 1558ms total)
T2470 394:087 JLINK_IsHalted()  returns FALSE (0000ms, 1558ms total)
T2470 394:187 JLINK_IsHalted()  returns FALSE (0000ms, 1558ms total)
T2470 394:288 JLINK_IsHalted()  returns FALSE (0000ms, 1558ms total)
T2470 394:389 JLINK_IsHalted()  returns FALSE (0000ms, 1558ms total)
T2470 394:490 JLINK_IsHalted()  returns FALSE (0000ms, 1558ms total)
T2470 394:590 JLINK_IsHalted()  returns FALSE (0000ms, 1558ms total)
T2470 394:691 JLINK_IsHalted()  returns FALSE (0000ms, 1558ms total)
T2470 394:792 JLINK_IsHalted()  returns FALSE (0000ms, 1558ms total)
T2470 394:892 JLINK_IsHalted()  returns FALSE (0000ms, 1558ms total)
T2470 394:993 JLINK_IsHalted()  returns FALSE (0000ms, 1558ms total)
T2470 395:094 JLINK_IsHalted()  returns FALSE (0000ms, 1558ms total)
T4118 395:108 JLINK_ReadMemEx(0x20002194, 0x0020 Bytes, ..., Flags = 0x02000000) -- CPU_ReadMem(32 bytes @ 0x20002194) - Data: 00 00 00 00 00 00 00 00 00 00 00 00 00 00 00 00 ...  returns 0x20 (0001ms, 1559ms total)
T4118 395:109 JLINK_ReadMemEx(0x20002214, 0x0001 Bytes, ..., Flags = 0x02000000) -- CPU_ReadMem(1 bytes @ 0x20002214) - Data: 00  returns 0x01 (0000ms, 1559ms total)
T4118 395:109 JLINK_ReadMemEx(0x20002215, 0x0001 Bytes, ..., Flags = 0x02000000) -- CPU_ReadMem(1 bytes @ 0x20002215) - Data: 00  returns 0x01 (0000ms, 1559ms total)
T4118 395:109 JLINK_ReadMemEx(0x20002194, 0x0020 Bytes, ..., Flags = 0x02000000) -- CPU_ReadMem(32 bytes @ 0x20002194) - Data: 00 00 00 00 00 00 00 00 00 00 00 00 00 00 00 00 ...  returns 0x20 (0000ms, 1559ms total)
T4118 395:109 JLINK_ReadMemEx(0x20002214, 0x0001 Bytes, ..., Flags = 0x02000000) -- CPU_ReadMem(1 bytes @ 0x20002214) - Data: 00  returns 0x01 (0001ms, 1560ms total)
T4118 395:110 JLINK_ReadMemEx(0x20002215, 0x0001 Bytes, ..., Flags = 0x02000000) -- CPU_ReadMem(1 bytes @ 0x20002215) - Data: 00  returns 0x01 (0000ms, 1560ms total)
T4118 395:115 JLINK_ReadMemEx(0x20002194, 0x0020 Bytes, ..., Flags = 0x02000000) -- CPU_ReadMem(32 bytes @ 0x20002194) - Data: 00 00 00 00 00 00 00 00 00 00 00 00 00 00 00 00 ...  returns 0x20 (0001ms, 1561ms total)
T4118 395:116 JLINK_ReadMemEx(0x20002214, 0x0001 Bytes, ..., Flags = 0x02000000) -- CPU_ReadMem(1 bytes @ 0x20002214) - Data: 00  returns 0x01 (0000ms, 1561ms total)
T4118 395:116 JLINK_ReadMemEx(0x20002215, 0x0001 Bytes, ..., Flags = 0x02000000) -- CPU_ReadMem(1 bytes @ 0x20002215) - Data: 00  returns 0x01 (0000ms, 1561ms total)
T2470 395:195 JLINK_IsHalted()  returns FALSE (0000ms, 1561ms total)
T2470 395:295 JLINK_IsHalted()  returns FALSE (0000ms, 1561ms total)
T2470 395:396 JLINK_IsHalted()  returns FALSE (0000ms, 1561ms total)
T2470 395:497 JLINK_IsHalted()  returns FALSE (0000ms, 1561ms total)
T2470 395:598 JLINK_IsHalted()  returns FALSE (0000ms, 1561ms total)
T2470 395:698 JLINK_IsHalted()  returns FALSE (0000ms, 1561ms total)
T2470 395:799 JLINK_IsHalted()  returns FALSE (0000ms, 1561ms total)
T2470 395:900 JLINK_IsHalted()  returns FALSE (0000ms, 1561ms total)
T2470 396:000 JLINK_IsHalted()  returns FALSE (0000ms, 1561ms total)
T2470 396:101 JLINK_IsHalted()  returns FALSE (0000ms, 1561ms total)
T2470 396:202 JLINK_IsHalted()  returns FALSE (0000ms, 1561ms total)
T2470 396:303 JLINK_IsHalted()  returns FALSE (0000ms, 1561ms total)
T2470 396:403 JLINK_IsHalted()  returns FALSE (0000ms, 1561ms total)
T2470 396:504 JLINK_IsHalted()  returns FALSE (0000ms, 1561ms total)
T2470 396:605 JLINK_IsHalted()  returns FALSE (0000ms, 1561ms total)
T2470 396:706 JLINK_IsHalted()  returns FALSE (0000ms, 1561ms total)
T4118 396:790 JLINK_ReadMemEx(0x20002194, 0x0020 Bytes, ..., Flags = 0x02000000) -- CPU_ReadMem(32 bytes @ 0x20002194) - Data: 00 00 00 00 00 00 00 00 00 00 00 00 00 00 00 00 ...  returns 0x20 (0001ms, 1562ms total)
T4118 396:791 JLINK_ReadMemEx(0x20002194, 0x0001 Bytes, ..., Flags = 0x02000000) -- CPU_ReadMem(1 bytes @ 0x20002194) - Data: 00  returns 0x01 (0000ms, 1562ms total)
T4118 396:791 JLINK_ReadMemEx(0x20002195, 0x0001 Bytes, ..., Flags = 0x02000000) -- CPU_ReadMem(1 bytes @ 0x20002195) - Data: 00  returns 0x01 (0000ms, 1562ms total)
T4118 396:791 JLINK_ReadMemEx(0x20002196, 0x0001 Bytes, ..., Flags = 0x02000000) -- CPU_ReadMem(1 bytes @ 0x20002196) - Data: 00  returns 0x01 (0001ms, 1563ms total)
T4118 396:792 JLINK_ReadMemEx(0x20002197, 0x0001 Bytes, ..., Flags = 0x02000000) -- CPU_ReadMem(1 bytes @ 0x20002197) - Data: 00  returns 0x01 (0000ms, 1563ms total)
T4118 396:792 JLINK_ReadMemEx(0x20002198, 0x0001 Bytes, ..., Flags = 0x02000000) -- CPU_ReadMem(1 bytes @ 0x20002198) - Data: 00  returns 0x01 (0000ms, 1563ms total)
T4118 396:792 JLINK_ReadMemEx(0x20002199, 0x0001 Bytes, ..., Flags = 0x02000000) -- CPU_ReadMem(1 bytes @ 0x20002199) - Data: 00  returns 0x01 (0000ms, 1563ms total)
T4118 396:792 JLINK_ReadMemEx(0x2000219A, 0x0001 Bytes, ..., Flags = 0x02000000) -- CPU_ReadMem(1 bytes @ 0x2000219A) - Data: 00  returns 0x01 (0001ms, 1564ms total)
T4118 396:793 JLINK_ReadMemEx(0x2000219B, 0x0001 Bytes, ..., Flags = 0x02000000) -- CPU_ReadMem(1 bytes @ 0x2000219B) - Data: 00  returns 0x01 (0000ms, 1564ms total)
T4118 396:793 JLINK_ReadMemEx(0x2000219C, 0x0001 Bytes, ..., Flags = 0x02000000) -- CPU_ReadMem(1 bytes @ 0x2000219C) - Data: 00  returns 0x01 (0000ms, 1564ms total)
T4118 396:793 JLINK_ReadMemEx(0x2000219D, 0x0001 Bytes, ..., Flags = 0x02000000) -- CPU_ReadMem(1 bytes @ 0x2000219D) - Data: 00  returns 0x01 (0000ms, 1564ms total)
T4118 396:794 JLINK_ReadMemEx(0x2000219E, 0x0001 Bytes, ..., Flags = 0x02000000) -- CPU_ReadMem(1 bytes @ 0x2000219E) - Data: 00  returns 0x01 (0000ms, 1564ms total)
T4118 396:794 JLINK_ReadMemEx(0x2000219F, 0x0001 Bytes, ..., Flags = 0x02000000) -- CPU_ReadMem(1 bytes @ 0x2000219F) - Data: 00  returns 0x01 (0000ms, 1564ms total)
T4118 396:794 JLINK_ReadMemEx(0x200021A0, 0x0001 Bytes, ..., Flags = 0x02000000) -- CPU_ReadMem(1 bytes @ 0x200021A0) - Data: 00  returns 0x01 (0000ms, 1564ms total)
T4118 396:794 JLINK_ReadMemEx(0x200021A1, 0x0001 Bytes, ..., Flags = 0x02000000) -- CPU_ReadMem(1 bytes @ 0x200021A1) - Data: 00  returns 0x01 (0001ms, 1565ms total)
T4118 396:795 JLINK_ReadMemEx(0x200021A2, 0x0001 Bytes, ..., Flags = 0x02000000) -- CPU_ReadMem(1 bytes @ 0x200021A2) - Data: 00  returns 0x01 (0000ms, 1565ms total)
T4118 396:795 JLINK_ReadMemEx(0x200021A3, 0x0001 Bytes, ..., Flags = 0x02000000) -- CPU_ReadMem(1 bytes @ 0x200021A3) - Data: 00  returns 0x01 (0000ms, 1565ms total)
T4118 396:795 JLINK_ReadMemEx(0x200021A4, 0x0001 Bytes, ..., Flags = 0x02000000) -- CPU_ReadMem(1 bytes @ 0x200021A4) - Data: 00  returns 0x01 (0000ms, 1565ms total)
T4118 396:795 JLINK_ReadMemEx(0x200021A5, 0x0001 Bytes, ..., Flags = 0x02000000) -- CPU_ReadMem(1 bytes @ 0x200021A5) - Data: 00  returns 0x01 (0001ms, 1566ms total)
T4118 396:796 JLINK_ReadMemEx(0x200021A6, 0x0001 Bytes, ..., Flags = 0x02000000) -- CPU_ReadMem(1 bytes @ 0x200021A6) - Data: 00  returns 0x01 (0000ms, 1566ms total)
T4118 396:796 JLINK_ReadMemEx(0x200021A7, 0x0001 Bytes, ..., Flags = 0x02000000) -- CPU_ReadMem(1 bytes @ 0x200021A7) - Data: 00  returns 0x01 (0000ms, 1566ms total)
T4118 396:796 JLINK_ReadMemEx(0x200021A8, 0x0001 Bytes, ..., Flags = 0x02000000) -- CPU_ReadMem(1 bytes @ 0x200021A8) - Data: 00  returns 0x01 (0000ms, 1566ms total)
T4118 396:796 JLINK_ReadMemEx(0x200021A9, 0x0001 Bytes, ..., Flags = 0x02000000) -- CPU_ReadMem(1 bytes @ 0x200021A9) - Data: 00  returns 0x01 (0001ms, 1567ms total)
T4118 396:797 JLINK_ReadMemEx(0x200021AA, 0x0001 Bytes, ..., Flags = 0x02000000) -- CPU_ReadMem(1 bytes @ 0x200021AA) - Data: 00  returns 0x01 (0000ms, 1567ms total)
T4118 396:797 JLINK_ReadMemEx(0x200021AB, 0x0001 Bytes, ..., Flags = 0x02000000) -- CPU_ReadMem(1 bytes @ 0x200021AB) - Data: 00  returns 0x01 (0000ms, 1567ms total)
T4118 396:797 JLINK_ReadMemEx(0x200021AC, 0x0001 Bytes, ..., Flags = 0x02000000) -- CPU_ReadMem(1 bytes @ 0x200021AC) - Data: 00  returns 0x01 (0001ms, 1568ms total)
T4118 396:798 JLINK_ReadMemEx(0x200021AD, 0x0001 Bytes, ..., Flags = 0x02000000) -- CPU_ReadMem(1 bytes @ 0x200021AD) - Data: 00  returns 0x01 (0000ms, 1568ms total)
T4118 396:798 JLINK_ReadMemEx(0x200021AE, 0x0001 Bytes, ..., Flags = 0x02000000) -- CPU_ReadMem(1 bytes @ 0x200021AE) - Data: 00  returns 0x01 (0000ms, 1568ms total)
T4118 396:798 JLINK_ReadMemEx(0x200021AF, 0x0001 Bytes, ..., Flags = 0x02000000) -- CPU_ReadMem(1 bytes @ 0x200021AF) - Data: 00  returns 0x01 (0000ms, 1568ms total)
T4118 396:798 JLINK_ReadMemEx(0x200021B0, 0x0001 Bytes, ..., Flags = 0x02000000) -- CPU_ReadMem(1 bytes @ 0x200021B0) - Data: 00  returns 0x01 (0001ms, 1569ms total)
T4118 396:799 JLINK_ReadMemEx(0x200021B1, 0x0001 Bytes, ..., Flags = 0x02000000) -- CPU_ReadMem(1 bytes @ 0x200021B1) - Data: 00  returns 0x01 (0000ms, 1569ms total)
T4118 396:799 JLINK_ReadMemEx(0x200021B2, 0x0001 Bytes, ..., Flags = 0x02000000) -- CPU_ReadMem(1 bytes @ 0x200021B2) - Data: 00  returns 0x01 (0000ms, 1569ms total)
T4118 396:799 JLINK_ReadMemEx(0x200021B3, 0x0001 Bytes, ..., Flags = 0x02000000) -- CPU_ReadMem(1 bytes @ 0x200021B3) - Data: 00  returns 0x01 (0000ms, 1569ms total)
T4118 396:799 JLINK_ReadMemEx(0x200021B4, 0x0001 Bytes, ..., Flags = 0x02000000) -- CPU_ReadMem(1 bytes @ 0x200021B4) - Data: 00  returns 0x01 (0001ms, 1570ms total)
T4118 396:800 JLINK_ReadMemEx(0x200021B5, 0x0001 Bytes, ..., Flags = 0x02000000) -- CPU_ReadMem(1 bytes @ 0x200021B5) - Data: 00  returns 0x01 (0000ms, 1570ms total)
T4118 396:800 JLINK_ReadMemEx(0x200021B6, 0x0001 Bytes, ..., Flags = 0x02000000) -- CPU_ReadMem(1 bytes @ 0x200021B6) - Data: 00  returns 0x01 (0000ms, 1570ms total)
T4118 396:800 JLINK_ReadMemEx(0x200021B7, 0x0001 Bytes, ..., Flags = 0x02000000) -- CPU_ReadMem(1 bytes @ 0x200021B7) - Data: 00  returns 0x01 (0000ms, 1570ms total)
T4118 396:800 JLINK_ReadMemEx(0x200021B8, 0x0001 Bytes, ..., Flags = 0x02000000) -- CPU_ReadMem(1 bytes @ 0x200021B8) - Data: 00  returns 0x01 (0001ms, 1571ms total)
T4118 396:801 JLINK_ReadMemEx(0x200021B9, 0x0001 Bytes, ..., Flags = 0x02000000) -- CPU_ReadMem(1 bytes @ 0x200021B9) - Data: 00  returns 0x01 (0000ms, 1571ms total)
T4118 396:801 JLINK_ReadMemEx(0x200021BA, 0x0001 Bytes, ..., Flags = 0x02000000) -- CPU_ReadMem(1 bytes @ 0x200021BA) - Data: 00  returns 0x01 (0000ms, 1571ms total)
T4118 396:801 JLINK_ReadMemEx(0x200021BB, 0x0001 Bytes, ..., Flags = 0x02000000) -- CPU_ReadMem(1 bytes @ 0x200021BB) - Data: 00  returns 0x01 (0000ms, 1571ms total)
T4118 396:801 JLINK_ReadMemEx(0x200021BC, 0x0001 Bytes, ..., Flags = 0x02000000) -- CPU_ReadMem(1 bytes @ 0x200021BC) - Data: 00  returns 0x01 (0001ms, 1572ms total)
T4118 396:802 JLINK_ReadMemEx(0x200021BD, 0x0001 Bytes, ..., Flags = 0x02000000) -- CPU_ReadMem(1 bytes @ 0x200021BD) - Data: 00  returns 0x01 (0000ms, 1572ms total)
T4118 396:802 JLINK_ReadMemEx(0x200021BE, 0x0001 Bytes, ..., Flags = 0x02000000) -- CPU_ReadMem(1 bytes @ 0x200021BE) - Data: 00  returns 0x01 (0000ms, 1572ms total)
T4118 396:802 JLINK_ReadMemEx(0x200021BF, 0x0001 Bytes, ..., Flags = 0x02000000) -- CPU_ReadMem(1 bytes @ 0x200021BF) - Data: 00  returns 0x01 (0000ms, 1572ms total)
T4118 396:802 JLINK_ReadMemEx(0x200021C0, 0x0001 Bytes, ..., Flags = 0x02000000) -- CPU_ReadMem(1 bytes @ 0x200021C0) - Data: 00  returns 0x01 (0001ms, 1573ms total)
T4118 396:803 JLINK_ReadMemEx(0x200021C1, 0x0001 Bytes, ..., Flags = 0x02000000) -- CPU_ReadMem(1 bytes @ 0x200021C1) - Data: 00  returns 0x01 (0000ms, 1573ms total)
T4118 396:803 JLINK_ReadMemEx(0x200021C2, 0x0001 Bytes, ..., Flags = 0x02000000) -- CPU_ReadMem(1 bytes @ 0x200021C2) - Data: 00  returns 0x01 (0000ms, 1573ms total)
T4118 396:803 JLINK_ReadMemEx(0x200021C3, 0x0001 Bytes, ..., Flags = 0x02000000) -- CPU_ReadMem(1 bytes @ 0x200021C3) - Data: 00  returns 0x01 (0001ms, 1574ms total)
T4118 396:804 JLINK_ReadMemEx(0x200021C4, 0x0001 Bytes, ..., Flags = 0x02000000) -- CPU_ReadMem(1 bytes @ 0x200021C4) - Data: 00  returns 0x01 (0000ms, 1574ms total)
T4118 396:804 JLINK_ReadMemEx(0x200021C5, 0x0001 Bytes, ..., Flags = 0x02000000) -- CPU_ReadMem(1 bytes @ 0x200021C5) - Data: 00  returns 0x01 (0000ms, 1574ms total)
T4118 396:804 JLINK_ReadMemEx(0x200021C6, 0x0001 Bytes, ..., Flags = 0x02000000) -- CPU_ReadMem(1 bytes @ 0x200021C6) - Data: 00  returns 0x01 (0000ms, 1574ms total)
T4118 396:804 JLINK_ReadMemEx(0x200021C7, 0x0001 Bytes, ..., Flags = 0x02000000) -- CPU_ReadMem(1 bytes @ 0x200021C7) - Data: 00  returns 0x01 (0001ms, 1575ms total)
T4118 396:805 JLINK_ReadMemEx(0x200021C8, 0x0001 Bytes, ..., Flags = 0x02000000) -- CPU_ReadMem(1 bytes @ 0x200021C8) - Data: 00  returns 0x01 (0000ms, 1575ms total)
T4118 396:805 JLINK_ReadMemEx(0x200021C9, 0x0001 Bytes, ..., Flags = 0x02000000) -- CPU_ReadMem(1 bytes @ 0x200021C9) - Data: 00  returns 0x01 (0000ms, 1575ms total)
T4118 396:805 JLINK_ReadMemEx(0x200021CA, 0x0001 Bytes, ..., Flags = 0x02000000) -- CPU_ReadMem(1 bytes @ 0x200021CA) - Data: 00  returns 0x01 (0000ms, 1575ms total)
T4118 396:805 JLINK_ReadMemEx(0x200021CB, 0x0001 Bytes, ..., Flags = 0x02000000) -- CPU_ReadMem(1 bytes @ 0x200021CB) - Data: 00  returns 0x01 (0001ms, 1576ms total)
T4118 396:806 JLINK_ReadMemEx(0x200021CC, 0x0001 Bytes, ..., Flags = 0x02000000) -- CPU_ReadMem(1 bytes @ 0x200021CC) - Data: 00  returns 0x01 (0000ms, 1576ms total)
T2470 396:806 JLINK_IsHalted()  returns FALSE (0000ms, 1576ms total)
T4118 396:806 JLINK_ReadMemEx(0x200021CD, 0x0001 Bytes, ..., Flags = 0x02000000) -- CPU_ReadMem(1 bytes @ 0x200021CD) - Data: 00  returns 0x01 (0001ms, 1577ms total)
T4118 396:807 JLINK_ReadMemEx(0x200021CE, 0x0001 Bytes, ..., Flags = 0x02000000) -- CPU_ReadMem(1 bytes @ 0x200021CE) - Data: 00  returns 0x01 (0000ms, 1577ms total)
T4118 396:807 JLINK_ReadMemEx(0x200021CF, 0x0001 Bytes, ..., Flags = 0x02000000) -- CPU_ReadMem(1 bytes @ 0x200021CF) - Data: 00  returns 0x01 (0000ms, 1577ms total)
T4118 396:807 JLINK_ReadMemEx(0x200021D0, 0x0001 Bytes, ..., Flags = 0x02000000) -- CPU_ReadMem(1 bytes @ 0x200021D0) - Data: 00  returns 0x01 (0000ms, 1577ms total)
T4118 396:807 JLINK_ReadMemEx(0x200021D1, 0x0001 Bytes, ..., Flags = 0x02000000) -- CPU_ReadMem(1 bytes @ 0x200021D1) - Data: 00  returns 0x01 (0001ms, 1578ms total)
T4118 396:808 JLINK_ReadMemEx(0x200021D2, 0x0001 Bytes, ..., Flags = 0x02000000) -- CPU_ReadMem(1 bytes @ 0x200021D2) - Data: 00  returns 0x01 (0000ms, 1578ms total)
T4118 396:808 JLINK_ReadMemEx(0x200021D3, 0x0001 Bytes, ..., Flags = 0x02000000) -- CPU_ReadMem(1 bytes @ 0x200021D3) - Data: 00  returns 0x01 (0000ms, 1578ms total)
T4118 396:808 JLINK_ReadMemEx(0x200021D4, 0x0001 Bytes, ..., Flags = 0x02000000) -- CPU_ReadMem(1 bytes @ 0x200021D4) - Data: 00  returns 0x01 (0000ms, 1578ms total)
T4118 396:808 JLINK_ReadMemEx(0x200021D5, 0x0001 Bytes, ..., Flags = 0x02000000) -- CPU_ReadMem(1 bytes @ 0x200021D5) - Data: 00  returns 0x01 (0001ms, 1579ms total)
T4118 396:809 JLINK_ReadMemEx(0x200021D6, 0x0001 Bytes, ..., Flags = 0x02000000) -- CPU_ReadMem(1 bytes @ 0x200021D6) - Data: 00  returns 0x01 (0000ms, 1579ms total)
T4118 396:809 JLINK_ReadMemEx(0x200021D7, 0x0001 Bytes, ..., Flags = 0x02000000) -- CPU_ReadMem(1 bytes @ 0x200021D7) - Data: 00  returns 0x01 (0000ms, 1579ms total)
T4118 396:809 JLINK_ReadMemEx(0x200021D8, 0x0001 Bytes, ..., Flags = 0x02000000) -- CPU_ReadMem(1 bytes @ 0x200021D8) - Data: 00  returns 0x01 (0000ms, 1579ms total)
T4118 396:809 JLINK_ReadMemEx(0x200021D9, 0x0001 Bytes, ..., Flags = 0x02000000) -- CPU_ReadMem(1 bytes @ 0x200021D9) - Data: 00  returns 0x01 (0001ms, 1580ms total)
T4118 396:810 JLINK_ReadMemEx(0x200021DA, 0x0001 Bytes, ..., Flags = 0x02000000) -- CPU_ReadMem(1 bytes @ 0x200021DA) - Data: 00  returns 0x01 (0000ms, 1580ms total)
T4118 396:810 JLINK_ReadMemEx(0x200021DB, 0x0001 Bytes, ..., Flags = 0x02000000) -- CPU_ReadMem(1 bytes @ 0x200021DB) - Data: 00  returns 0x01 (0000ms, 1580ms total)
T4118 396:810 JLINK_ReadMemEx(0x200021DC, 0x0001 Bytes, ..., Flags = 0x02000000) -- CPU_ReadMem(1 bytes @ 0x200021DC) - Data: 00  returns 0x01 (0000ms, 1580ms total)
T4118 396:810 JLINK_ReadMemEx(0x200021DD, 0x0001 Bytes, ..., Flags = 0x02000000) -- CPU_ReadMem(1 bytes @ 0x200021DD) - Data: 00  returns 0x01 (0001ms, 1581ms total)
T4118 396:811 JLINK_ReadMemEx(0x200021DE, 0x0001 Bytes, ..., Flags = 0x02000000) -- CPU_ReadMem(1 bytes @ 0x200021DE) - Data: 00  returns 0x01 (0000ms, 1581ms total)
T4118 396:811 JLINK_ReadMemEx(0x200021DF, 0x0001 Bytes, ..., Flags = 0x02000000) -- CPU_ReadMem(1 bytes @ 0x200021DF) - Data: 00  returns 0x01 (0000ms, 1581ms total)
T4118 396:811 JLINK_ReadMemEx(0x200021E0, 0x0001 Bytes, ..., Flags = 0x02000000) -- CPU_ReadMem(1 bytes @ 0x200021E0) - Data: 00  returns 0x01 (0000ms, 1581ms total)
T4118 396:812 JLINK_ReadMemEx(0x200021E1, 0x0001 Bytes, ..., Flags = 0x02000000) -- CPU_ReadMem(1 bytes @ 0x200021E1) - Data: 00  returns 0x01 (0000ms, 1582ms total)
T4118 396:812 JLINK_ReadMemEx(0x200021E2, 0x0001 Bytes, ..., Flags = 0x02000000) -- CPU_ReadMem(1 bytes @ 0x200021E2) - Data: 00  returns 0x01 (0000ms, 1582ms total)
T4118 396:812 JLINK_ReadMemEx(0x200021E3, 0x0001 Bytes, ..., Flags = 0x02000000) -- CPU_ReadMem(1 bytes @ 0x200021E3) - Data: 00  returns 0x01 (0000ms, 1582ms total)
T4118 396:812 JLINK_ReadMemEx(0x200021E4, 0x0001 Bytes, ..., Flags = 0x02000000) -- CPU_ReadMem(1 bytes @ 0x200021E4) - Data: 00  returns 0x01 (0001ms, 1583ms total)
T4118 396:813 JLINK_ReadMemEx(0x200021E5, 0x0001 Bytes, ..., Flags = 0x02000000) -- CPU_ReadMem(1 bytes @ 0x200021E5) - Data: 00  returns 0x01 (0000ms, 1583ms total)
T4118 396:813 JLINK_ReadMemEx(0x200021E6, 0x0001 Bytes, ..., Flags = 0x02000000) -- CPU_ReadMem(1 bytes @ 0x200021E6) - Data: 00  returns 0x01 (0000ms, 1583ms total)
T4118 396:813 JLINK_ReadMemEx(0x200021E7, 0x0001 Bytes, ..., Flags = 0x02000000) -- CPU_ReadMem(1 bytes @ 0x200021E7) - Data: 00  returns 0x01 (0000ms, 1583ms total)
T4118 396:813 JLINK_ReadMemEx(0x200021E8, 0x0001 Bytes, ..., Flags = 0x02000000) -- CPU_ReadMem(1 bytes @ 0x200021E8) - Data: 00  returns 0x01 (0001ms, 1584ms total)
T4118 396:814 JLINK_ReadMemEx(0x200021E9, 0x0001 Bytes, ..., Flags = 0x02000000) -- CPU_ReadMem(1 bytes @ 0x200021E9) - Data: 00  returns 0x01 (0000ms, 1584ms total)
T4118 396:814 JLINK_ReadMemEx(0x200021EA, 0x0001 Bytes, ..., Flags = 0x02000000) -- CPU_ReadMem(1 bytes @ 0x200021EA) - Data: 00  returns 0x01 (0000ms, 1584ms total)
T4118 396:814 JLINK_ReadMemEx(0x200021EB, 0x0001 Bytes, ..., Flags = 0x02000000) -- CPU_ReadMem(1 bytes @ 0x200021EB) - Data: 00  returns 0x01 (0000ms, 1584ms total)
T4118 396:814 JLINK_ReadMemEx(0x200021EC, 0x0001 Bytes, ..., Flags = 0x02000000) -- CPU_ReadMem(1 bytes @ 0x200021EC) - Data: 00  returns 0x01 (0001ms, 1585ms total)
T4118 396:815 JLINK_ReadMemEx(0x200021ED, 0x0001 Bytes, ..., Flags = 0x02000000) -- CPU_ReadMem(1 bytes @ 0x200021ED) - Data: 00  returns 0x01 (0000ms, 1585ms total)
T4118 396:815 JLINK_ReadMemEx(0x200021EE, 0x0001 Bytes, ..., Flags = 0x02000000) -- CPU_ReadMem(1 bytes @ 0x200021EE) - Data: 00  returns 0x01 (0000ms, 1585ms total)
T4118 396:815 JLINK_ReadMemEx(0x200021EF, 0x0001 Bytes, ..., Flags = 0x02000000) -- CPU_ReadMem(1 bytes @ 0x200021EF) - Data: 00  returns 0x01 (0000ms, 1585ms total)
T4118 396:815 JLINK_ReadMemEx(0x200021F0, 0x0001 Bytes, ..., Flags = 0x02000000) -- CPU_ReadMem(1 bytes @ 0x200021F0) - Data: 00  returns 0x01 (0001ms, 1586ms total)
T4118 396:816 JLINK_ReadMemEx(0x200021F1, 0x0001 Bytes, ..., Flags = 0x02000000) -- CPU_ReadMem(1 bytes @ 0x200021F1) - Data: 00  returns 0x01 (0000ms, 1586ms total)
T4118 396:816 JLINK_ReadMemEx(0x200021F2, 0x0001 Bytes, ..., Flags = 0x02000000) -- CPU_ReadMem(1 bytes @ 0x200021F2) - Data: 00  returns 0x01 (0000ms, 1586ms total)
T4118 396:816 JLINK_ReadMemEx(0x200021F3, 0x0001 Bytes, ..., Flags = 0x02000000) -- CPU_ReadMem(1 bytes @ 0x200021F3) - Data: 00  returns 0x01 (0000ms, 1586ms total)
T4118 396:816 JLINK_ReadMemEx(0x200021F4, 0x0001 Bytes, ..., Flags = 0x02000000) -- CPU_ReadMem(1 bytes @ 0x200021F4) - Data: 00  returns 0x01 (0001ms, 1587ms total)
T4118 396:817 JLINK_ReadMemEx(0x200021F5, 0x0001 Bytes, ..., Flags = 0x02000000) -- CPU_ReadMem(1 bytes @ 0x200021F5) - Data: 00  returns 0x01 (0000ms, 1587ms total)
T4118 396:817 JLINK_ReadMemEx(0x200021F6, 0x0001 Bytes, ..., Flags = 0x02000000) -- CPU_ReadMem(1 bytes @ 0x200021F6) - Data: 00  returns 0x01 (0000ms, 1587ms total)
T4118 396:817 JLINK_ReadMemEx(0x200021F7, 0x0001 Bytes, ..., Flags = 0x02000000) -- CPU_ReadMem(1 bytes @ 0x200021F7) - Data: 00  returns 0x01 (0000ms, 1587ms total)
T4118 396:817 JLINK_ReadMemEx(0x200021F8, 0x0001 Bytes, ..., Flags = 0x02000000) -- CPU_ReadMem(1 bytes @ 0x200021F8) - Data: 00  returns 0x01 (0001ms, 1588ms total)
T4118 396:818 JLINK_ReadMemEx(0x200021F9, 0x0001 Bytes, ..., Flags = 0x02000000) -- CPU_ReadMem(1 bytes @ 0x200021F9) - Data: 00  returns 0x01 (0000ms, 1588ms total)
T4118 396:818 JLINK_ReadMemEx(0x200021FA, 0x0001 Bytes, ..., Flags = 0x02000000) -- CPU_ReadMem(1 bytes @ 0x200021FA) - Data: 00  returns 0x01 (0000ms, 1588ms total)
T4118 396:818 JLINK_ReadMemEx(0x200021FB, 0x0001 Bytes, ..., Flags = 0x02000000) -- CPU_ReadMem(1 bytes @ 0x200021FB) - Data: 00  returns 0x01 (0000ms, 1588ms total)
T4118 396:818 JLINK_ReadMemEx(0x200021FC, 0x0001 Bytes, ..., Flags = 0x02000000) -- CPU_ReadMem(1 bytes @ 0x200021FC) - Data: 00  returns 0x01 (0001ms, 1589ms total)
T4118 396:819 JLINK_ReadMemEx(0x200021FD, 0x0001 Bytes, ..., Flags = 0x02000000) -- CPU_ReadMem(1 bytes @ 0x200021FD) - Data: 00  returns 0x01 (0000ms, 1589ms total)
T4118 396:819 JLINK_ReadMemEx(0x200021FE, 0x0001 Bytes, ..., Flags = 0x02000000) -- CPU_ReadMem(1 bytes @ 0x200021FE) - Data: 00  returns 0x01 (0000ms, 1589ms total)
T4118 396:819 JLINK_ReadMemEx(0x200021FF, 0x0001 Bytes, ..., Flags = 0x02000000) -- CPU_ReadMem(1 bytes @ 0x200021FF) - Data: 00  returns 0x01 (0000ms, 1589ms total)
T4118 396:819 JLINK_ReadMemEx(0x20002200, 0x0001 Bytes, ..., Flags = 0x02000000) -- CPU_ReadMem(1 bytes @ 0x20002200) - Data: 00  returns 0x01 (0001ms, 1590ms total)
T4118 396:820 JLINK_ReadMemEx(0x20002201, 0x0001 Bytes, ..., Flags = 0x02000000) -- CPU_ReadMem(1 bytes @ 0x20002201) - Data: 00  returns 0x01 (0000ms, 1590ms total)
T4118 396:820 JLINK_ReadMemEx(0x20002202, 0x0001 Bytes, ..., Flags = 0x02000000) -- CPU_ReadMem(1 bytes @ 0x20002202) - Data: 00  returns 0x01 (0000ms, 1590ms total)
T4118 396:820 JLINK_ReadMemEx(0x20002203, 0x0001 Bytes, ..., Flags = 0x02000000) -- CPU_ReadMem(1 bytes @ 0x20002203) - Data: 00  returns 0x01 (0000ms, 1590ms total)
T4118 396:820 JLINK_ReadMemEx(0x20002204, 0x0001 Bytes, ..., Flags = 0x02000000) -- CPU_ReadMem(1 bytes @ 0x20002204) - Data: 00  returns 0x01 (0001ms, 1591ms total)
T4118 396:821 JLINK_ReadMemEx(0x20002205, 0x0001 Bytes, ..., Flags = 0x02000000) -- CPU_ReadMem(1 bytes @ 0x20002205) - Data: 00  returns 0x01 (0000ms, 1591ms total)
T4118 396:821 JLINK_ReadMemEx(0x20002206, 0x0001 Bytes, ..., Flags = 0x02000000) -- CPU_ReadMem(1 bytes @ 0x20002206) - Data: 00  returns 0x01 (0000ms, 1591ms total)
T4118 396:821 JLINK_ReadMemEx(0x20002207, 0x0001 Bytes, ..., Flags = 0x02000000) -- CPU_ReadMem(1 bytes @ 0x20002207) - Data: 00  returns 0x01 (0000ms, 1591ms total)
T4118 396:821 JLINK_ReadMemEx(0x20002208, 0x0001 Bytes, ..., Flags = 0x02000000) -- CPU_ReadMem(1 bytes @ 0x20002208) - Data: 00  returns 0x01 (0001ms, 1592ms total)
T4118 396:822 JLINK_ReadMemEx(0x20002209, 0x0001 Bytes, ..., Flags = 0x02000000) -- CPU_ReadMem(1 bytes @ 0x20002209) - Data: 00  returns 0x01 (0000ms, 1592ms total)
T4118 396:822 JLINK_ReadMemEx(0x2000220A, 0x0001 Bytes, ..., Flags = 0x02000000) -- CPU_ReadMem(1 bytes @ 0x2000220A) - Data: 00  returns 0x01 (0000ms, 1592ms total)
T4118 396:822 JLINK_ReadMemEx(0x2000220B, 0x0001 Bytes, ..., Flags = 0x02000000) -- CPU_ReadMem(1 bytes @ 0x2000220B) - Data: 00  returns 0x01 (0000ms, 1592ms total)
T4118 396:822 JLINK_ReadMemEx(0x2000220C, 0x0001 Bytes, ..., Flags = 0x02000000) -- CPU_ReadMem(1 bytes @ 0x2000220C) - Data: 00  returns 0x01 (0001ms, 1593ms total)
T4118 396:823 JLINK_ReadMemEx(0x2000220D, 0x0001 Bytes, ..., Flags = 0x02000000) -- CPU_ReadMem(1 bytes @ 0x2000220D) - Data: 00  returns 0x01 (0000ms, 1593ms total)
T4118 396:823 JLINK_ReadMemEx(0x2000220E, 0x0001 Bytes, ..., Flags = 0x02000000) -- CPU_ReadMem(1 bytes @ 0x2000220E) - Data: 00  returns 0x01 (0000ms, 1593ms total)
T4118 396:823 JLINK_ReadMemEx(0x2000220F, 0x0001 Bytes, ..., Flags = 0x02000000) -- CPU_ReadMem(1 bytes @ 0x2000220F) - Data: 00  returns 0x01 (0008ms, 1601ms total)
T4118 396:831 JLINK_ReadMemEx(0x20002210, 0x0001 Bytes, ..., Flags = 0x02000000) -- CPU_ReadMem(1 bytes @ 0x20002210) - Data: 00  returns 0x01 (0001ms, 1602ms total)
T4118 396:832 JLINK_ReadMemEx(0x20002211, 0x0001 Bytes, ..., Flags = 0x02000000) -- CPU_ReadMem(1 bytes @ 0x20002211) - Data: 00  returns 0x01 (0000ms, 1602ms total)
T4118 396:832 JLINK_ReadMemEx(0x20002212, 0x0001 Bytes, ..., Flags = 0x02000000) -- CPU_ReadMem(1 bytes @ 0x20002212) - Data: 00  returns 0x01 (0000ms, 1602ms total)
T4118 396:832 JLINK_ReadMemEx(0x20002213, 0x0001 Bytes, ..., Flags = 0x02000000) -- CPU_ReadMem(1 bytes @ 0x20002213) - Data: 00  returns 0x01 (0000ms, 1602ms total)
T4118 396:833 JLINK_ReadMemEx(0x20002194, 0x0020 Bytes, ..., Flags = 0x02000000) -- CPU_ReadMem(32 bytes @ 0x20002194) - Data: 00 00 00 00 00 00 00 00 00 00 00 00 00 00 00 00 ...  returns 0x20 (0000ms, 1602ms total)
T4118 396:833 JLINK_ReadMemEx(0x20002194, 0x0001 Bytes, ..., Flags = 0x02000000) -- CPU_ReadMem(1 bytes @ 0x20002194) - Data: 00  returns 0x01 (0000ms, 1602ms total)
T4118 396:833 JLINK_ReadMemEx(0x20002195, 0x0001 Bytes, ..., Flags = 0x02000000) -- CPU_ReadMem(1 bytes @ 0x20002195) - Data: 00  returns 0x01 (0000ms, 1602ms total)
T4118 396:833 JLINK_ReadMemEx(0x20002196, 0x0001 Bytes, ..., Flags = 0x02000000) -- CPU_ReadMem(1 bytes @ 0x20002196) - Data: 00  returns 0x01 (0001ms, 1603ms total)
T4118 396:834 JLINK_ReadMemEx(0x20002197, 0x0001 Bytes, ..., Flags = 0x02000000) -- CPU_ReadMem(1 bytes @ 0x20002197) - Data: 00  returns 0x01 (0000ms, 1603ms total)
T4118 396:834 JLINK_ReadMemEx(0x20002198, 0x0001 Bytes, ..., Flags = 0x02000000) -- CPU_ReadMem(1 bytes @ 0x20002198) - Data: 00  returns 0x01 (0000ms, 1603ms total)
T4118 396:834 JLINK_ReadMemEx(0x20002199, 0x0001 Bytes, ..., Flags = 0x02000000) -- CPU_ReadMem(1 bytes @ 0x20002199) - Data: 00  returns 0x01 (0000ms, 1603ms total)
T4118 396:834 JLINK_ReadMemEx(0x2000219A, 0x0001 Bytes, ..., Flags = 0x02000000) -- CPU_ReadMem(1 bytes @ 0x2000219A) - Data: 00  returns 0x01 (0001ms, 1604ms total)
T4118 396:835 JLINK_ReadMemEx(0x2000219B, 0x0001 Bytes, ..., Flags = 0x02000000) -- CPU_ReadMem(1 bytes @ 0x2000219B) - Data: 00  returns 0x01 (0000ms, 1604ms total)
T4118 396:835 JLINK_ReadMemEx(0x2000219C, 0x0001 Bytes, ..., Flags = 0x02000000) -- CPU_ReadMem(1 bytes @ 0x2000219C) - Data: 00  returns 0x01 (0000ms, 1604ms total)
T4118 396:835 JLINK_ReadMemEx(0x2000219D, 0x0001 Bytes, ..., Flags = 0x02000000) -- CPU_ReadMem(1 bytes @ 0x2000219D) - Data: 00  returns 0x01 (0001ms, 1605ms total)
T4118 396:836 JLINK_ReadMemEx(0x2000219E, 0x0001 Bytes, ..., Flags = 0x02000000) -- CPU_ReadMem(1 bytes @ 0x2000219E) - Data: 00  returns 0x01 (0000ms, 1605ms total)
T4118 396:836 JLINK_ReadMemEx(0x2000219F, 0x0001 Bytes, ..., Flags = 0x02000000) -- CPU_ReadMem(1 bytes @ 0x2000219F) - Data: 00  returns 0x01 (0000ms, 1605ms total)
T4118 396:836 JLINK_ReadMemEx(0x200021A0, 0x0001 Bytes, ..., Flags = 0x02000000) -- CPU_ReadMem(1 bytes @ 0x200021A0) - Data: 00  returns 0x01 (0000ms, 1605ms total)
T4118 396:836 JLINK_ReadMemEx(0x200021A1, 0x0001 Bytes, ..., Flags = 0x02000000) -- CPU_ReadMem(1 bytes @ 0x200021A1) - Data: 00  returns 0x01 (0001ms, 1606ms total)
T4118 396:837 JLINK_ReadMemEx(0x200021A2, 0x0001 Bytes, ..., Flags = 0x02000000) -- CPU_ReadMem(1 bytes @ 0x200021A2) - Data: 00  returns 0x01 (0000ms, 1606ms total)
T4118 396:837 JLINK_ReadMemEx(0x200021A3, 0x0001 Bytes, ..., Flags = 0x02000000) -- CPU_ReadMem(1 bytes @ 0x200021A3) - Data: 00  returns 0x01 (0000ms, 1606ms total)
T4118 396:837 JLINK_ReadMemEx(0x200021A4, 0x0001 Bytes, ..., Flags = 0x02000000) -- CPU_ReadMem(1 bytes @ 0x200021A4) - Data: 00  returns 0x01 (0000ms, 1606ms total)
T4118 396:838 JLINK_ReadMemEx(0x200021A5, 0x0001 Bytes, ..., Flags = 0x02000000) -- CPU_ReadMem(1 bytes @ 0x200021A5) - Data: 00  returns 0x01 (0000ms, 1607ms total)
T4118 396:838 JLINK_ReadMemEx(0x200021A6, 0x0001 Bytes, ..., Flags = 0x02000000) -- CPU_ReadMem(1 bytes @ 0x200021A6) - Data: 00  returns 0x01 (0000ms, 1607ms total)
T4118 396:838 JLINK_ReadMemEx(0x200021A7, 0x0001 Bytes, ..., Flags = 0x02000000) -- CPU_ReadMem(1 bytes @ 0x200021A7) - Data: 00  returns 0x01 (0000ms, 1607ms total)
T4118 396:838 JLINK_ReadMemEx(0x200021A8, 0x0001 Bytes, ..., Flags = 0x02000000) -- CPU_ReadMem(1 bytes @ 0x200021A8) - Data: 00  returns 0x01 (0001ms, 1608ms total)
T4118 396:839 JLINK_ReadMemEx(0x200021A9, 0x0001 Bytes, ..., Flags = 0x02000000) -- CPU_ReadMem(1 bytes @ 0x200021A9) - Data: 00  returns 0x01 (0000ms, 1608ms total)
T4118 396:839 JLINK_ReadMemEx(0x200021AA, 0x0001 Bytes, ..., Flags = 0x02000000) -- CPU_ReadMem(1 bytes @ 0x200021AA) - Data: 00  returns 0x01 (0000ms, 1608ms total)
T4118 396:839 JLINK_ReadMemEx(0x200021AB, 0x0001 Bytes, ..., Flags = 0x02000000) -- CPU_ReadMem(1 bytes @ 0x200021AB) - Data: 00  returns 0x01 (0000ms, 1608ms total)
T4118 396:839 JLINK_ReadMemEx(0x200021AC, 0x0001 Bytes, ..., Flags = 0x02000000) -- CPU_ReadMem(1 bytes @ 0x200021AC) - Data: 00  returns 0x01 (0001ms, 1609ms total)
T4118 396:840 JLINK_ReadMemEx(0x200021AD, 0x0001 Bytes, ..., Flags = 0x02000000) -- CPU_ReadMem(1 bytes @ 0x200021AD) - Data: 00  returns 0x01 (0000ms, 1609ms total)
T4118 396:840 JLINK_ReadMemEx(0x200021AE, 0x0001 Bytes, ..., Flags = 0x02000000) -- CPU_ReadMem(1 bytes @ 0x200021AE) - Data: 00  returns 0x01 (0000ms, 1609ms total)
T4118 396:840 JLINK_ReadMemEx(0x200021AF, 0x0001 Bytes, ..., Flags = 0x02000000) -- CPU_ReadMem(1 bytes @ 0x200021AF) - Data: 00  returns 0x01 (0000ms, 1609ms total)
T4118 396:841 JLINK_ReadMemEx(0x200021B0, 0x0001 Bytes, ..., Flags = 0x02000000) -- CPU_ReadMem(1 bytes @ 0x200021B0) - Data: 00  returns 0x01 (0000ms, 1609ms total)
T4118 396:841 JLINK_ReadMemEx(0x200021B1, 0x0001 Bytes, ..., Flags = 0x02000000) -- CPU_ReadMem(1 bytes @ 0x200021B1) - Data: 00  returns 0x01 (0000ms, 1609ms total)
T4118 396:841 JLINK_ReadMemEx(0x200021B2, 0x0001 Bytes, ..., Flags = 0x02000000) -- CPU_ReadMem(1 bytes @ 0x200021B2) - Data: 00  returns 0x01 (0000ms, 1609ms total)
T4118 396:841 JLINK_ReadMemEx(0x200021B3, 0x0001 Bytes, ..., Flags = 0x02000000) -- CPU_ReadMem(1 bytes @ 0x200021B3) - Data: 00  returns 0x01 (0001ms, 1610ms total)
T4118 396:842 JLINK_ReadMemEx(0x200021B4, 0x0001 Bytes, ..., Flags = 0x02000000) -- CPU_ReadMem(1 bytes @ 0x200021B4) - Data: 00  returns 0x01 (0000ms, 1610ms total)
T4118 396:842 JLINK_ReadMemEx(0x200021B5, 0x0001 Bytes, ..., Flags = 0x02000000) -- CPU_ReadMem(1 bytes @ 0x200021B5) - Data: 00  returns 0x01 (0000ms, 1610ms total)
T4118 396:842 JLINK_ReadMemEx(0x200021B6, 0x0001 Bytes, ..., Flags = 0x02000000) -- CPU_ReadMem(1 bytes @ 0x200021B6) - Data: 00  returns 0x01 (0000ms, 1610ms total)
T4118 396:842 JLINK_ReadMemEx(0x200021B7, 0x0001 Bytes, ..., Flags = 0x02000000) -- CPU_ReadMem(1 bytes @ 0x200021B7) - Data: 00  returns 0x01 (0001ms, 1611ms total)
T4118 396:843 JLINK_ReadMemEx(0x200021B8, 0x0001 Bytes, ..., Flags = 0x02000000) -- CPU_ReadMem(1 bytes @ 0x200021B8) - Data: 00  returns 0x01 (0000ms, 1611ms total)
T4118 396:843 JLINK_ReadMemEx(0x200021B9, 0x0001 Bytes, ..., Flags = 0x02000000) -- CPU_ReadMem(1 bytes @ 0x200021B9) - Data: 00  returns 0x01 (0000ms, 1611ms total)
T4118 396:843 JLINK_ReadMemEx(0x200021BA, 0x0001 Bytes, ..., Flags = 0x02000000) -- CPU_ReadMem(1 bytes @ 0x200021BA) - Data: 00  returns 0x01 (0000ms, 1611ms total)
T4118 396:843 JLINK_ReadMemEx(0x200021BB, 0x0001 Bytes, ..., Flags = 0x02000000) -- CPU_ReadMem(1 bytes @ 0x200021BB) - Data: 00  returns 0x01 (0001ms, 1612ms total)
T4118 396:844 JLINK_ReadMemEx(0x200021BC, 0x0001 Bytes, ..., Flags = 0x02000000) -- CPU_ReadMem(1 bytes @ 0x200021BC) - Data: 00  returns 0x01 (0000ms, 1612ms total)
T4118 396:844 JLINK_ReadMemEx(0x200021BD, 0x0001 Bytes, ..., Flags = 0x02000000) -- CPU_ReadMem(1 bytes @ 0x200021BD) - Data: 00  returns 0x01 (0000ms, 1612ms total)
T4118 396:844 JLINK_ReadMemEx(0x200021BE, 0x0001 Bytes, ..., Flags = 0x02000000) -- CPU_ReadMem(1 bytes @ 0x200021BE) - Data: 00  returns 0x01 (0000ms, 1612ms total)
T4118 396:844 JLINK_ReadMemEx(0x200021BF, 0x0001 Bytes, ..., Flags = 0x02000000) -- CPU_ReadMem(1 bytes @ 0x200021BF) - Data: 00  returns 0x01 (0001ms, 1613ms total)
T4118 396:845 JLINK_ReadMemEx(0x200021C0, 0x0001 Bytes, ..., Flags = 0x02000000) -- CPU_ReadMem(1 bytes @ 0x200021C0) - Data: 00  returns 0x01 (0000ms, 1613ms total)
T4118 396:845 JLINK_ReadMemEx(0x200021C1, 0x0001 Bytes, ..., Flags = 0x02000000) -- CPU_ReadMem(1 bytes @ 0x200021C1) - Data: 00  returns 0x01 (0000ms, 1613ms total)
T4118 396:845 JLINK_ReadMemEx(0x200021C2, 0x0001 Bytes, ..., Flags = 0x02000000) -- CPU_ReadMem(1 bytes @ 0x200021C2) - Data: 00  returns 0x01 (0000ms, 1613ms total)
T4118 396:846 JLINK_ReadMemEx(0x200021C3, 0x0001 Bytes, ..., Flags = 0x02000000) -- CPU_ReadMem(1 bytes @ 0x200021C3) - Data: 00  returns 0x01 (0000ms, 1613ms total)
T4118 396:846 JLINK_ReadMemEx(0x200021C4, 0x0001 Bytes, ..., Flags = 0x02000000) -- CPU_ReadMem(1 bytes @ 0x200021C4) - Data: 00  returns 0x01 (0000ms, 1613ms total)
T4118 396:846 JLINK_ReadMemEx(0x200021C5, 0x0001 Bytes, ..., Flags = 0x02000000) -- CPU_ReadMem(1 bytes @ 0x200021C5) - Data: 00  returns 0x01 (0000ms, 1613ms total)
T4118 396:846 JLINK_ReadMemEx(0x200021C6, 0x0001 Bytes, ..., Flags = 0x02000000) -- CPU_ReadMem(1 bytes @ 0x200021C6) - Data: 00  returns 0x01 (0000ms, 1613ms total)
T4118 396:847 JLINK_ReadMemEx(0x200021C7, 0x0001 Bytes, ..., Flags = 0x02000000) -- CPU_ReadMem(1 bytes @ 0x200021C7) - Data: 00  returns 0x01 (0000ms, 1614ms total)
T4118 396:847 JLINK_ReadMemEx(0x200021C8, 0x0001 Bytes, ..., Flags = 0x02000000) -- CPU_ReadMem(1 bytes @ 0x200021C8) - Data: 00  returns 0x01 (0000ms, 1614ms total)
T4118 396:847 JLINK_ReadMemEx(0x200021C9, 0x0001 Bytes, ..., Flags = 0x02000000) -- CPU_ReadMem(1 bytes @ 0x200021C9) - Data: 00  returns 0x01 (0000ms, 1614ms total)
T4118 396:847 JLINK_ReadMemEx(0x200021CA, 0x0001 Bytes, ..., Flags = 0x02000000) -- CPU_ReadMem(1 bytes @ 0x200021CA) - Data: 00  returns 0x01 (0001ms, 1615ms total)
T4118 396:848 JLINK_ReadMemEx(0x200021CB, 0x0001 Bytes, ..., Flags = 0x02000000) -- CPU_ReadMem(1 bytes @ 0x200021CB) - Data: 00  returns 0x01 (0000ms, 1615ms total)
T4118 396:848 JLINK_ReadMemEx(0x200021CC, 0x0001 Bytes, ..., Flags = 0x02000000) -- CPU_ReadMem(1 bytes @ 0x200021CC) - Data: 00  returns 0x01 (0000ms, 1615ms total)
T4118 396:848 JLINK_ReadMemEx(0x200021CD, 0x0001 Bytes, ..., Flags = 0x02000000) -- CPU_ReadMem(1 bytes @ 0x200021CD) - Data: 00  returns 0x01 (0000ms, 1615ms total)
T4118 396:848 JLINK_ReadMemEx(0x200021CE, 0x0001 Bytes, ..., Flags = 0x02000000) -- CPU_ReadMem(1 bytes @ 0x200021CE) - Data: 00  returns 0x01 (0001ms, 1616ms total)
T4118 396:849 JLINK_ReadMemEx(0x200021CF, 0x0001 Bytes, ..., Flags = 0x02000000) -- CPU_ReadMem(1 bytes @ 0x200021CF) - Data: 00  returns 0x01 (0000ms, 1616ms total)
T4118 396:849 JLINK_ReadMemEx(0x200021D0, 0x0001 Bytes, ..., Flags = 0x02000000) -- CPU_ReadMem(1 bytes @ 0x200021D0) - Data: 00  returns 0x01 (0000ms, 1616ms total)
T4118 396:849 JLINK_ReadMemEx(0x200021D1, 0x0001 Bytes, ..., Flags = 0x02000000) -- CPU_ReadMem(1 bytes @ 0x200021D1) - Data: 00  returns 0x01 (0000ms, 1616ms total)
T4118 396:849 JLINK_ReadMemEx(0x200021D2, 0x0001 Bytes, ..., Flags = 0x02000000) -- CPU_ReadMem(1 bytes @ 0x200021D2) - Data: 00  returns 0x01 (0001ms, 1617ms total)
T4118 396:850 JLINK_ReadMemEx(0x200021D3, 0x0001 Bytes, ..., Flags = 0x02000000) -- CPU_ReadMem(1 bytes @ 0x200021D3) - Data: 00  returns 0x01 (0000ms, 1617ms total)
T4118 396:850 JLINK_ReadMemEx(0x200021D4, 0x0001 Bytes, ..., Flags = 0x02000000) -- CPU_ReadMem(1 bytes @ 0x200021D4) - Data: 00  returns 0x01 (0000ms, 1617ms total)
T4118 396:850 JLINK_ReadMemEx(0x200021D5, 0x0001 Bytes, ..., Flags = 0x02000000) -- CPU_ReadMem(1 bytes @ 0x200021D5) - Data: 00  returns 0x01 (0000ms, 1617ms total)
T4118 396:850 JLINK_ReadMemEx(0x200021D6, 0x0001 Bytes, ..., Flags = 0x02000000) -- CPU_ReadMem(1 bytes @ 0x200021D6) - Data: 00  returns 0x01 (0001ms, 1618ms total)
T4118 396:851 JLINK_ReadMemEx(0x200021D7, 0x0001 Bytes, ..., Flags = 0x02000000) -- CPU_ReadMem(1 bytes @ 0x200021D7) - Data: 00  returns 0x01 (0000ms, 1618ms total)
T4118 396:851 JLINK_ReadMemEx(0x200021D8, 0x0001 Bytes, ..., Flags = 0x02000000) -- CPU_ReadMem(1 bytes @ 0x200021D8) - Data: 00  returns 0x01 (0000ms, 1618ms total)
T4118 396:851 JLINK_ReadMemEx(0x200021D9, 0x0001 Bytes, ..., Flags = 0x02000000) -- CPU_ReadMem(1 bytes @ 0x200021D9) - Data: 00  returns 0x01 (0000ms, 1618ms total)
T4118 396:851 JLINK_ReadMemEx(0x200021DA, 0x0001 Bytes, ..., Flags = 0x02000000) -- CPU_ReadMem(1 bytes @ 0x200021DA) - Data: 00  returns 0x01 (0001ms, 1619ms total)
T4118 396:852 JLINK_ReadMemEx(0x200021DB, 0x0001 Bytes, ..., Flags = 0x02000000) -- CPU_ReadMem(1 bytes @ 0x200021DB) - Data: 00  returns 0x01 (0000ms, 1619ms total)
T4118 396:852 JLINK_ReadMemEx(0x200021DC, 0x0001 Bytes, ..., Flags = 0x02000000) -- CPU_ReadMem(1 bytes @ 0x200021DC) - Data: 00  returns 0x01 (0000ms, 1619ms total)
T4118 396:852 JLINK_ReadMemEx(0x200021DD, 0x0001 Bytes, ..., Flags = 0x02000000) -- CPU_ReadMem(1 bytes @ 0x200021DD) - Data: 00  returns 0x01 (0000ms, 1619ms total)
T4118 396:852 JLINK_ReadMemEx(0x200021DE, 0x0001 Bytes, ..., Flags = 0x02000000) -- CPU_ReadMem(1 bytes @ 0x200021DE) - Data: 00  returns 0x01 (0001ms, 1620ms total)
T4118 396:853 JLINK_ReadMemEx(0x200021DF, 0x0001 Bytes, ..., Flags = 0x02000000) -- CPU_ReadMem(1 bytes @ 0x200021DF) - Data: 00  returns 0x01 (0000ms, 1620ms total)
T4118 396:853 JLINK_ReadMemEx(0x200021E0, 0x0001 Bytes, ..., Flags = 0x02000000) -- CPU_ReadMem(1 bytes @ 0x200021E0) - Data: 00  returns 0x01 (0000ms, 1620ms total)
T4118 396:853 JLINK_ReadMemEx(0x200021E1, 0x0001 Bytes, ..., Flags = 0x02000000) -- CPU_ReadMem(1 bytes @ 0x200021E1) - Data: 00  returns 0x01 (0000ms, 1620ms total)
T4118 396:853 JLINK_ReadMemEx(0x200021E2, 0x0001 Bytes, ..., Flags = 0x02000000) -- CPU_ReadMem(1 bytes @ 0x200021E2) - Data: 00  returns 0x01 (0001ms, 1621ms total)
T4118 396:854 JLINK_ReadMemEx(0x200021E3, 0x0001 Bytes, ..., Flags = 0x02000000) -- CPU_ReadMem(1 bytes @ 0x200021E3) - Data: 00  returns 0x01 (0000ms, 1621ms total)
T4118 396:854 JLINK_ReadMemEx(0x200021E4, 0x0001 Bytes, ..., Flags = 0x02000000) -- CPU_ReadMem(1 bytes @ 0x200021E4) - Data: 00  returns 0x01 (0000ms, 1621ms total)
T4118 396:854 JLINK_ReadMemEx(0x200021E5, 0x0001 Bytes, ..., Flags = 0x02000000) -- CPU_ReadMem(1 bytes @ 0x200021E5) - Data: 00  returns 0x01 (0000ms, 1621ms total)
T4118 396:854 JLINK_ReadMemEx(0x200021E6, 0x0001 Bytes, ..., Flags = 0x02000000) -- CPU_ReadMem(1 bytes @ 0x200021E6) - Data: 00  returns 0x01 (0001ms, 1622ms total)
T4118 396:855 JLINK_ReadMemEx(0x200021E7, 0x0001 Bytes, ..., Flags = 0x02000000) -- CPU_ReadMem(1 bytes @ 0x200021E7) - Data: 00  returns 0x01 (0000ms, 1622ms total)
T4118 396:855 JLINK_ReadMemEx(0x200021E8, 0x0001 Bytes, ..., Flags = 0x02000000) -- CPU_ReadMem(1 bytes @ 0x200021E8) - Data: 00  returns 0x01 (0000ms, 1622ms total)
T4118 396:855 JLINK_ReadMemEx(0x200021E9, 0x0001 Bytes, ..., Flags = 0x02000000) -- CPU_ReadMem(1 bytes @ 0x200021E9) - Data: 00  returns 0x01 (0000ms, 1622ms total)
T4118 396:855 JLINK_ReadMemEx(0x200021EA, 0x0001 Bytes, ..., Flags = 0x02000000) -- CPU_ReadMem(1 bytes @ 0x200021EA) - Data: 00  returns 0x01 (0001ms, 1623ms total)
T4118 396:856 JLINK_ReadMemEx(0x200021EB, 0x0001 Bytes, ..., Flags = 0x02000000) -- CPU_ReadMem(1 bytes @ 0x200021EB) - Data: 00  returns 0x01 (0000ms, 1623ms total)
T4118 396:856 JLINK_ReadMemEx(0x200021EC, 0x0001 Bytes, ..., Flags = 0x02000000) -- CPU_ReadMem(1 bytes @ 0x200021EC) - Data: 00  returns 0x01 (0000ms, 1623ms total)
T4118 396:856 JLINK_ReadMemEx(0x200021ED, 0x0001 Bytes, ..., Flags = 0x02000000) -- CPU_ReadMem(1 bytes @ 0x200021ED) - Data: 00  returns 0x01 (0000ms, 1623ms total)
T4118 396:856 JLINK_ReadMemEx(0x200021EE, 0x0001 Bytes, ..., Flags = 0x02000000) -- CPU_ReadMem(1 bytes @ 0x200021EE) - Data: 00  returns 0x01 (0001ms, 1624ms total)
T4118 396:857 JLINK_ReadMemEx(0x200021EF, 0x0001 Bytes, ..., Flags = 0x02000000) -- CPU_ReadMem(1 bytes @ 0x200021EF) - Data: 00  returns 0x01 (0000ms, 1624ms total)
T4118 396:857 JLINK_ReadMemEx(0x200021F0, 0x0001 Bytes, ..., Flags = 0x02000000) -- CPU_ReadMem(1 bytes @ 0x200021F0) - Data: 00  returns 0x01 (0000ms, 1624ms total)
T4118 396:857 JLINK_ReadMemEx(0x200021F1, 0x0001 Bytes, ..., Flags = 0x02000000) -- CPU_ReadMem(1 bytes @ 0x200021F1) - Data: 00  returns 0x01 (0000ms, 1624ms total)
T4118 396:857 JLINK_ReadMemEx(0x200021F2, 0x0001 Bytes, ..., Flags = 0x02000000) -- CPU_ReadMem(1 bytes @ 0x200021F2) - Data: 00  returns 0x01 (0001ms, 1625ms total)
T4118 396:858 JLINK_ReadMemEx(0x200021F3, 0x0001 Bytes, ..., Flags = 0x02000000) -- CPU_ReadMem(1 bytes @ 0x200021F3) - Data: 00  returns 0x01 (0000ms, 1625ms total)
T4118 396:858 JLINK_ReadMemEx(0x200021F4, 0x0001 Bytes, ..., Flags = 0x02000000) -- CPU_ReadMem(1 bytes @ 0x200021F4) - Data: 00  returns 0x01 (0000ms, 1625ms total)
T4118 396:858 JLINK_ReadMemEx(0x200021F5, 0x0001 Bytes, ..., Flags = 0x02000000) -- CPU_ReadMem(1 bytes @ 0x200021F5) - Data: 00  returns 0x01 (0001ms, 1626ms total)
T4118 396:859 JLINK_ReadMemEx(0x200021F6, 0x0001 Bytes, ..., Flags = 0x02000000) -- CPU_ReadMem(1 bytes @ 0x200021F6) - Data: 00  returns 0x01 (0000ms, 1626ms total)
T4118 396:859 JLINK_ReadMemEx(0x200021F7, 0x0001 Bytes, ..., Flags = 0x02000000) -- CPU_ReadMem(1 bytes @ 0x200021F7) - Data: 00  returns 0x01 (0000ms, 1626ms total)
T4118 396:859 JLINK_ReadMemEx(0x200021F8, 0x0001 Bytes, ..., Flags = 0x02000000) -- CPU_ReadMem(1 bytes @ 0x200021F8) - Data: 00  returns 0x01 (0000ms, 1626ms total)
T4118 396:859 JLINK_ReadMemEx(0x200021F9, 0x0001 Bytes, ..., Flags = 0x02000000) -- CPU_ReadMem(1 bytes @ 0x200021F9) - Data: 00  returns 0x01 (0001ms, 1627ms total)
T4118 396:860 JLINK_ReadMemEx(0x200021FA, 0x0001 Bytes, ..., Flags = 0x02000000) -- CPU_ReadMem(1 bytes @ 0x200021FA) - Data: 00  returns 0x01 (0000ms, 1627ms total)
T4118 396:860 JLINK_ReadMemEx(0x200021FB, 0x0001 Bytes, ..., Flags = 0x02000000) -- CPU_ReadMem(1 bytes @ 0x200021FB) - Data: 00  returns 0x01 (0000ms, 1627ms total)
T4118 396:860 JLINK_ReadMemEx(0x200021FC, 0x0001 Bytes, ..., Flags = 0x02000000) -- CPU_ReadMem(1 bytes @ 0x200021FC) - Data: 00  returns 0x01 (0000ms, 1627ms total)
T4118 396:860 JLINK_ReadMemEx(0x200021FD, 0x0001 Bytes, ..., Flags = 0x02000000) -- CPU_ReadMem(1 bytes @ 0x200021FD) - Data: 00  returns 0x01 (0001ms, 1628ms total)
T4118 396:861 JLINK_ReadMemEx(0x200021FE, 0x0001 Bytes, ..., Flags = 0x02000000) -- CPU_ReadMem(1 bytes @ 0x200021FE) - Data: 00  returns 0x01 (0000ms, 1628ms total)
T4118 396:861 JLINK_ReadMemEx(0x200021FF, 0x0001 Bytes, ..., Flags = 0x02000000) -- CPU_ReadMem(1 bytes @ 0x200021FF) - Data: 00  returns 0x01 (0000ms, 1628ms total)
T4118 396:861 JLINK_ReadMemEx(0x20002200, 0x0001 Bytes, ..., Flags = 0x02000000) -- CPU_ReadMem(1 bytes @ 0x20002200) - Data: 00  returns 0x01 (0000ms, 1628ms total)
T4118 396:861 JLINK_ReadMemEx(0x20002201, 0x0001 Bytes, ..., Flags = 0x02000000) -- CPU_ReadMem(1 bytes @ 0x20002201) - Data: 00  returns 0x01 (0001ms, 1629ms total)
T4118 396:862 JLINK_ReadMemEx(0x20002202, 0x0001 Bytes, ..., Flags = 0x02000000) -- CPU_ReadMem(1 bytes @ 0x20002202) - Data: 00  returns 0x01 (0000ms, 1629ms total)
T4118 396:862 JLINK_ReadMemEx(0x20002203, 0x0001 Bytes, ..., Flags = 0x02000000) -- CPU_ReadMem(1 bytes @ 0x20002203) - Data: 00  returns 0x01 (0000ms, 1629ms total)
T4118 396:862 JLINK_ReadMemEx(0x20002204, 0x0001 Bytes, ..., Flags = 0x02000000) -- CPU_ReadMem(1 bytes @ 0x20002204) - Data: 00  returns 0x01 (0000ms, 1629ms total)
T4118 396:862 JLINK_ReadMemEx(0x20002205, 0x0001 Bytes, ..., Flags = 0x02000000) -- CPU_ReadMem(1 bytes @ 0x20002205) - Data: 00  returns 0x01 (0001ms, 1630ms total)
T4118 396:863 JLINK_ReadMemEx(0x20002206, 0x0001 Bytes, ..., Flags = 0x02000000) -- CPU_ReadMem(1 bytes @ 0x20002206) - Data: 00  returns 0x01 (0000ms, 1630ms total)
T4118 396:863 JLINK_ReadMemEx(0x20002207, 0x0001 Bytes, ..., Flags = 0x02000000) -- CPU_ReadMem(1 bytes @ 0x20002207) - Data: 00  returns 0x01 (0000ms, 1630ms total)
T4118 396:863 JLINK_ReadMemEx(0x20002208, 0x0001 Bytes, ..., Flags = 0x02000000) -- CPU_ReadMem(1 bytes @ 0x20002208) - Data: 00  returns 0x01 (0000ms, 1630ms total)
T4118 396:863 JLINK_ReadMemEx(0x20002209, 0x0001 Bytes, ..., Flags = 0x02000000) -- CPU_ReadMem(1 bytes @ 0x20002209) - Data: 00  returns 0x01 (0001ms, 1631ms total)
T4118 396:864 JLINK_ReadMemEx(0x2000220A, 0x0001 Bytes, ..., Flags = 0x02000000) -- CPU_ReadMem(1 bytes @ 0x2000220A) - Data: 00  returns 0x01 (0000ms, 1631ms total)
T4118 396:864 JLINK_ReadMemEx(0x2000220B, 0x0001 Bytes, ..., Flags = 0x02000000) -- CPU_ReadMem(1 bytes @ 0x2000220B) - Data: 00  returns 0x01 (0000ms, 1631ms total)
T4118 396:864 JLINK_ReadMemEx(0x2000220C, 0x0001 Bytes, ..., Flags = 0x02000000) -- CPU_ReadMem(1 bytes @ 0x2000220C) - Data: 00  returns 0x01 (0000ms, 1631ms total)
T4118 396:864 JLINK_ReadMemEx(0x2000220D, 0x0001 Bytes, ..., Flags = 0x02000000) -- CPU_ReadMem(1 bytes @ 0x2000220D) - Data: 00  returns 0x01 (0001ms, 1632ms total)
T4118 396:865 JLINK_ReadMemEx(0x2000220E, 0x0001 Bytes, ..., Flags = 0x02000000) -- CPU_ReadMem(1 bytes @ 0x2000220E) - Data: 00  returns 0x01 (0000ms, 1632ms total)
T4118 396:865 JLINK_ReadMemEx(0x2000220F, 0x0001 Bytes, ..., Flags = 0x02000000) -- CPU_ReadMem(1 bytes @ 0x2000220F) - Data: 00  returns 0x01 (0000ms, 1632ms total)
T4118 396:865 JLINK_ReadMemEx(0x20002210, 0x0001 Bytes, ..., Flags = 0x02000000) -- CPU_ReadMem(1 bytes @ 0x20002210) - Data: 00  returns 0x01 (0000ms, 1632ms total)
T4118 396:865 JLINK_ReadMemEx(0x20002211, 0x0001 Bytes, ..., Flags = 0x02000000) -- CPU_ReadMem(1 bytes @ 0x20002211) - Data: 00  returns 0x01 (0001ms, 1633ms total)
T4118 396:866 JLINK_ReadMemEx(0x20002212, 0x0001 Bytes, ..., Flags = 0x02000000) -- CPU_ReadMem(1 bytes @ 0x20002212) - Data: 00  returns 0x01 (0000ms, 1633ms total)
T4118 396:866 JLINK_ReadMemEx(0x20002213, 0x0001 Bytes, ..., Flags = 0x02000000) -- CPU_ReadMem(1 bytes @ 0x20002213) - Data: 00  returns 0x01 (0000ms, 1633ms total)
T4118 396:901 JLINK_ReadMemEx(0x20002194, 0x0020 Bytes, ..., Flags = 0x02000000) -- CPU_ReadMem(32 bytes @ 0x20002194) - Data: 00 00 00 00 00 00 00 00 00 00 00 00 00 00 00 00 ...  returns 0x20 (0001ms, 1634ms total)
T4118 396:902 JLINK_ReadMemEx(0x20002194, 0x0001 Bytes, ..., Flags = 0x02000000) -- CPU_ReadMem(1 bytes @ 0x20002194) - Data: 00  returns 0x01 (0000ms, 1634ms total)
T4118 396:902 JLINK_ReadMemEx(0x20002195, 0x0001 Bytes, ..., Flags = 0x02000000) -- CPU_ReadMem(1 bytes @ 0x20002195) - Data: 00  returns 0x01 (0000ms, 1634ms total)
T4118 396:902 JLINK_ReadMemEx(0x20002196, 0x0001 Bytes, ..., Flags = 0x02000000) -- CPU_ReadMem(1 bytes @ 0x20002196) - Data: 00  returns 0x01 (0000ms, 1634ms total)
T4118 396:902 JLINK_ReadMemEx(0x20002197, 0x0001 Bytes, ..., Flags = 0x02000000) -- CPU_ReadMem(1 bytes @ 0x20002197) - Data: 00  returns 0x01 (0001ms, 1635ms total)
T4118 396:903 JLINK_ReadMemEx(0x20002198, 0x0001 Bytes, ..., Flags = 0x02000000) -- CPU_ReadMem(1 bytes @ 0x20002198) - Data: 00  returns 0x01 (0000ms, 1635ms total)
T4118 396:903 JLINK_ReadMemEx(0x20002199, 0x0001 Bytes, ..., Flags = 0x02000000) -- CPU_ReadMem(1 bytes @ 0x20002199) - Data: 00  returns 0x01 (0000ms, 1635ms total)
T4118 396:903 JLINK_ReadMemEx(0x2000219A, 0x0001 Bytes, ..., Flags = 0x02000000) -- CPU_ReadMem(1 bytes @ 0x2000219A) - Data: 00  returns 0x01 (0000ms, 1635ms total)
T4118 396:903 JLINK_ReadMemEx(0x2000219B, 0x0001 Bytes, ..., Flags = 0x02000000) -- CPU_ReadMem(1 bytes @ 0x2000219B) - Data: 00  returns 0x01 (0001ms, 1636ms total)
T4118 396:904 JLINK_ReadMemEx(0x2000219C, 0x0001 Bytes, ..., Flags = 0x02000000) -- CPU_ReadMem(1 bytes @ 0x2000219C) - Data: 00  returns 0x01 (0000ms, 1636ms total)
T4118 396:904 JLINK_ReadMemEx(0x2000219D, 0x0001 Bytes, ..., Flags = 0x02000000) -- CPU_ReadMem(1 bytes @ 0x2000219D) - Data: 00  returns 0x01 (0000ms, 1636ms total)
T4118 396:904 JLINK_ReadMemEx(0x2000219E, 0x0001 Bytes, ..., Flags = 0x02000000) -- CPU_ReadMem(1 bytes @ 0x2000219E) - Data: 00  returns 0x01 (0000ms, 1636ms total)
T4118 396:904 JLINK_ReadMemEx(0x2000219F, 0x0001 Bytes, ..., Flags = 0x02000000) -- CPU_ReadMem(1 bytes @ 0x2000219F) - Data: 00  returns 0x01 (0001ms, 1637ms total)
T4118 396:905 JLINK_ReadMemEx(0x200021A0, 0x0001 Bytes, ..., Flags = 0x02000000) -- CPU_ReadMem(1 bytes @ 0x200021A0) - Data: 00  returns 0x01 (0000ms, 1637ms total)
T4118 396:905 JLINK_ReadMemEx(0x200021A1, 0x0001 Bytes, ..., Flags = 0x02000000) -- CPU_ReadMem(1 bytes @ 0x200021A1) - Data: 00  returns 0x01 (0000ms, 1637ms total)
T4118 396:905 JLINK_ReadMemEx(0x200021A2, 0x0001 Bytes, ..., Flags = 0x02000000) -- CPU_ReadMem(1 bytes @ 0x200021A2) - Data: 00  returns 0x01 (0001ms, 1638ms total)
T4118 396:906 JLINK_ReadMemEx(0x200021A3, 0x0001 Bytes, ..., Flags = 0x02000000) -- CPU_ReadMem(1 bytes @ 0x200021A3) - Data: 00  returns 0x01 (0000ms, 1638ms total)
T4118 396:906 JLINK_ReadMemEx(0x200021A4, 0x0001 Bytes, ..., Flags = 0x02000000) -- CPU_ReadMem(1 bytes @ 0x200021A4) - Data: 00  returns 0x01 (0000ms, 1638ms total)
T4118 396:906 JLINK_ReadMemEx(0x200021A5, 0x0001 Bytes, ..., Flags = 0x02000000) -- CPU_ReadMem(1 bytes @ 0x200021A5) - Data: 00  returns 0x01 (0000ms, 1638ms total)
T4118 396:906 JLINK_ReadMemEx(0x200021A6, 0x0001 Bytes, ..., Flags = 0x02000000) -- CPU_ReadMem(1 bytes @ 0x200021A6) - Data: 00  returns 0x01 (0001ms, 1639ms total)
T4118 396:907 JLINK_ReadMemEx(0x200021A7, 0x0001 Bytes, ..., Flags = 0x02000000) -- CPU_ReadMem(1 bytes @ 0x200021A7) - Data: 00  returns 0x01 (0000ms, 1639ms total)
T4118 396:907 JLINK_ReadMemEx(0x200021A8, 0x0001 Bytes, ..., Flags = 0x02000000) -- CPU_ReadMem(1 bytes @ 0x200021A8) - Data: 00  returns 0x01 (0000ms, 1639ms total)
T4118 396:907 JLINK_ReadMemEx(0x200021A9, 0x0001 Bytes, ..., Flags = 0x02000000) -- CPU_ReadMem(1 bytes @ 0x200021A9) - Data: 00  returns 0x01 (0000ms, 1639ms total)
T4118 396:907 JLINK_ReadMemEx(0x200021AA, 0x0001 Bytes, ..., Flags = 0x02000000) -- CPU_ReadMem(1 bytes @ 0x200021AA) - Data: 00  returns 0x01 (0001ms, 1640ms total)
T4118 396:908 JLINK_ReadMemEx(0x200021AB, 0x0001 Bytes, ..., Flags = 0x02000000) -- CPU_ReadMem(1 bytes @ 0x200021AB) - Data: 00  returns 0x01 (0000ms, 1640ms total)
T2470 396:908 JLINK_IsHalted()  returns FALSE (0000ms, 1640ms total)
T4118 396:908 JLINK_ReadMemEx(0x200021AC, 0x0001 Bytes, ..., Flags = 0x02000000) -- CPU_ReadMem(1 bytes @ 0x200021AC) - Data: 00  returns 0x01 (0001ms, 1641ms total)
T4118 396:909 JLINK_ReadMemEx(0x200021AD, 0x0001 Bytes, ..., Flags = 0x02000000) -- CPU_ReadMem(1 bytes @ 0x200021AD) - Data: 00  returns 0x01 (0000ms, 1641ms total)
T4118 396:909 JLINK_ReadMemEx(0x200021AE, 0x0001 Bytes, ..., Flags = 0x02000000) -- CPU_ReadMem(1 bytes @ 0x200021AE) - Data: 00  returns 0x01 (0000ms, 1641ms total)
T4118 396:909 JLINK_ReadMemEx(0x200021AF, 0x0001 Bytes, ..., Flags = 0x02000000) -- CPU_ReadMem(1 bytes @ 0x200021AF) - Data: 00  returns 0x01 (0000ms, 1641ms total)
T4118 396:909 JLINK_ReadMemEx(0x200021B0, 0x0001 Bytes, ..., Flags = 0x02000000) -- CPU_ReadMem(1 bytes @ 0x200021B0) - Data: 00  returns 0x01 (0001ms, 1642ms total)
T4118 396:910 JLINK_ReadMemEx(0x200021B1, 0x0001 Bytes, ..., Flags = 0x02000000) -- CPU_ReadMem(1 bytes @ 0x200021B1) - Data: 00  returns 0x01 (0000ms, 1642ms total)
T4118 396:910 JLINK_ReadMemEx(0x200021B2, 0x0001 Bytes, ..., Flags = 0x02000000) -- CPU_ReadMem(1 bytes @ 0x200021B2) - Data: 00  returns 0x01 (0000ms, 1642ms total)
T4118 396:910 JLINK_ReadMemEx(0x200021B3, 0x0001 Bytes, ..., Flags = 0x02000000) -- CPU_ReadMem(1 bytes @ 0x200021B3) - Data: 00  returns 0x01 (0000ms, 1642ms total)
T4118 396:910 JLINK_ReadMemEx(0x200021B4, 0x0001 Bytes, ..., Flags = 0x02000000) -- CPU_ReadMem(1 bytes @ 0x200021B4) - Data: 00  returns 0x01 (0001ms, 1643ms total)
T4118 396:911 JLINK_ReadMemEx(0x200021B5, 0x0001 Bytes, ..., Flags = 0x02000000) -- CPU_ReadMem(1 bytes @ 0x200021B5) - Data: 00  returns 0x01 (0000ms, 1643ms total)
T4118 396:911 JLINK_ReadMemEx(0x200021B6, 0x0001 Bytes, ..., Flags = 0x02000000) -- CPU_ReadMem(1 bytes @ 0x200021B6) - Data: 00  returns 0x01 (0000ms, 1643ms total)
T4118 396:911 JLINK_ReadMemEx(0x200021B7, 0x0001 Bytes, ..., Flags = 0x02000000) -- CPU_ReadMem(1 bytes @ 0x200021B7) - Data: 00  returns 0x01 (0000ms, 1643ms total)
T4118 396:911 JLINK_ReadMemEx(0x200021B8, 0x0001 Bytes, ..., Flags = 0x02000000) -- CPU_ReadMem(1 bytes @ 0x200021B8) - Data: 00  returns 0x01 (0001ms, 1644ms total)
T4118 396:912 JLINK_ReadMemEx(0x200021B9, 0x0001 Bytes, ..., Flags = 0x02000000) -- CPU_ReadMem(1 bytes @ 0x200021B9) - Data: 00  returns 0x01 (0000ms, 1644ms total)
T4118 396:912 JLINK_ReadMemEx(0x200021BA, 0x0001 Bytes, ..., Flags = 0x02000000) -- CPU_ReadMem(1 bytes @ 0x200021BA) - Data: 00  returns 0x01 (0000ms, 1644ms total)
T4118 396:912 JLINK_ReadMemEx(0x200021BB, 0x0001 Bytes, ..., Flags = 0x02000000) -- CPU_ReadMem(1 bytes @ 0x200021BB) - Data: 00  returns 0x01 (0000ms, 1644ms total)
T4118 396:912 JLINK_ReadMemEx(0x200021BC, 0x0001 Bytes, ..., Flags = 0x02000000) -- CPU_ReadMem(1 bytes @ 0x200021BC) - Data: 00  returns 0x01 (0001ms, 1645ms total)
T4118 396:913 JLINK_ReadMemEx(0x200021BD, 0x0001 Bytes, ..., Flags = 0x02000000) -- CPU_ReadMem(1 bytes @ 0x200021BD) - Data: 00  returns 0x01 (0000ms, 1645ms total)
T4118 396:913 JLINK_ReadMemEx(0x200021BE, 0x0001 Bytes, ..., Flags = 0x02000000) -- CPU_ReadMem(1 bytes @ 0x200021BE) - Data: 00  returns 0x01 (0000ms, 1645ms total)
T4118 396:913 JLINK_ReadMemEx(0x200021BF, 0x0001 Bytes, ..., Flags = 0x02000000) -- CPU_ReadMem(1 bytes @ 0x200021BF) - Data: 00  returns 0x01 (0000ms, 1645ms total)
T4118 396:913 JLINK_ReadMemEx(0x200021C0, 0x0001 Bytes, ..., Flags = 0x02000000) -- CPU_ReadMem(1 bytes @ 0x200021C0) - Data: 00  returns 0x01 (0001ms, 1646ms total)
T4118 396:914 JLINK_ReadMemEx(0x200021C1, 0x0001 Bytes, ..., Flags = 0x02000000) -- CPU_ReadMem(1 bytes @ 0x200021C1) - Data: 00  returns 0x01 (0000ms, 1646ms total)
T4118 396:914 JLINK_ReadMemEx(0x200021C2, 0x0001 Bytes, ..., Flags = 0x02000000) -- CPU_ReadMem(1 bytes @ 0x200021C2) - Data: 00  returns 0x01 (0000ms, 1646ms total)
T4118 396:914 JLINK_ReadMemEx(0x200021C3, 0x0001 Bytes, ..., Flags = 0x02000000) -- CPU_ReadMem(1 bytes @ 0x200021C3) - Data: 00  returns 0x01 (0000ms, 1646ms total)
T4118 396:914 JLINK_ReadMemEx(0x200021C4, 0x0001 Bytes, ..., Flags = 0x02000000) -- CPU_ReadMem(1 bytes @ 0x200021C4) - Data: 00  returns 0x01 (0001ms, 1647ms total)
T4118 396:915 JLINK_ReadMemEx(0x200021C5, 0x0001 Bytes, ..., Flags = 0x02000000) -- CPU_ReadMem(1 bytes @ 0x200021C5) - Data: 00  returns 0x01 (0000ms, 1647ms total)
T4118 396:915 JLINK_ReadMemEx(0x200021C6, 0x0001 Bytes, ..., Flags = 0x02000000) -- CPU_ReadMem(1 bytes @ 0x200021C6) - Data: 00  returns 0x01 (0000ms, 1647ms total)
T4118 396:915 JLINK_ReadMemEx(0x200021C7, 0x0001 Bytes, ..., Flags = 0x02000000) -- CPU_ReadMem(1 bytes @ 0x200021C7) - Data: 00  returns 0x01 (0000ms, 1647ms total)
T4118 396:915 JLINK_ReadMemEx(0x200021C8, 0x0001 Bytes, ..., Flags = 0x02000000) -- CPU_ReadMem(1 bytes @ 0x200021C8) - Data: 00  returns 0x01 (0001ms, 1648ms total)
T4118 396:916 JLINK_ReadMemEx(0x200021C9, 0x0001 Bytes, ..., Flags = 0x02000000) -- CPU_ReadMem(1 bytes @ 0x200021C9) - Data: 00  returns 0x01 (0000ms, 1648ms total)
T4118 396:916 JLINK_ReadMemEx(0x200021CA, 0x0001 Bytes, ..., Flags = 0x02000000) -- CPU_ReadMem(1 bytes @ 0x200021CA) - Data: 00  returns 0x01 (0000ms, 1648ms total)
T4118 396:916 JLINK_ReadMemEx(0x200021CB, 0x0001 Bytes, ..., Flags = 0x02000000) -- CPU_ReadMem(1 bytes @ 0x200021CB) - Data: 00  returns 0x01 (0000ms, 1648ms total)
T4118 396:916 JLINK_ReadMemEx(0x200021CC, 0x0001 Bytes, ..., Flags = 0x02000000) -- CPU_ReadMem(1 bytes @ 0x200021CC) - Data: 00  returns 0x01 (0001ms, 1649ms total)
T4118 396:917 JLINK_ReadMemEx(0x200021CD, 0x0001 Bytes, ..., Flags = 0x02000000) -- CPU_ReadMem(1 bytes @ 0x200021CD) - Data: 00  returns 0x01 (0000ms, 1649ms total)
T4118 396:917 JLINK_ReadMemEx(0x200021CE, 0x0001 Bytes, ..., Flags = 0x02000000) -- CPU_ReadMem(1 bytes @ 0x200021CE) - Data: 00  returns 0x01 (0000ms, 1649ms total)
T4118 396:917 JLINK_ReadMemEx(0x200021CF, 0x0001 Bytes, ..., Flags = 0x02000000) -- CPU_ReadMem(1 bytes @ 0x200021CF) - Data: 00  returns 0x01 (0000ms, 1649ms total)
T4118 396:917 JLINK_ReadMemEx(0x200021D0, 0x0001 Bytes, ..., Flags = 0x02000000) -- CPU_ReadMem(1 bytes @ 0x200021D0) - Data: 00  returns 0x01 (0001ms, 1650ms total)
T4118 396:918 JLINK_ReadMemEx(0x200021D1, 0x0001 Bytes, ..., Flags = 0x02000000) -- CPU_ReadMem(1 bytes @ 0x200021D1) - Data: 00  returns 0x01 (0000ms, 1650ms total)
T4118 396:918 JLINK_ReadMemEx(0x200021D2, 0x0001 Bytes, ..., Flags = 0x02000000) -- CPU_ReadMem(1 bytes @ 0x200021D2) - Data: 00  returns 0x01 (0000ms, 1650ms total)
T4118 396:918 JLINK_ReadMemEx(0x200021D3, 0x0001 Bytes, ..., Flags = 0x02000000) -- CPU_ReadMem(1 bytes @ 0x200021D3) - Data: 00  returns 0x01 (0000ms, 1650ms total)
T4118 396:918 JLINK_ReadMemEx(0x200021D4, 0x0001 Bytes, ..., Flags = 0x02000000) -- CPU_ReadMem(1 bytes @ 0x200021D4) - Data: 00  returns 0x01 (0001ms, 1651ms total)
T4118 396:919 JLINK_ReadMemEx(0x200021D5, 0x0001 Bytes, ..., Flags = 0x02000000) -- CPU_ReadMem(1 bytes @ 0x200021D5) - Data: 00  returns 0x01 (0000ms, 1651ms total)
T4118 396:919 JLINK_ReadMemEx(0x200021D6, 0x0001 Bytes, ..., Flags = 0x02000000) -- CPU_ReadMem(1 bytes @ 0x200021D6) - Data: 00  returns 0x01 (0000ms, 1651ms total)
T4118 396:919 JLINK_ReadMemEx(0x200021D7, 0x0001 Bytes, ..., Flags = 0x02000000) -- CPU_ReadMem(1 bytes @ 0x200021D7) - Data: 00  returns 0x01 (0000ms, 1651ms total)
T4118 396:919 JLINK_ReadMemEx(0x200021D8, 0x0001 Bytes, ..., Flags = 0x02000000) -- CPU_ReadMem(1 bytes @ 0x200021D8) - Data: 00  returns 0x01 (0001ms, 1652ms total)
T4118 396:920 JLINK_ReadMemEx(0x200021D9, 0x0001 Bytes, ..., Flags = 0x02000000) -- CPU_ReadMem(1 bytes @ 0x200021D9) - Data: 00  returns 0x01 (0000ms, 1652ms total)
T4118 396:920 JLINK_ReadMemEx(0x200021DA, 0x0001 Bytes, ..., Flags = 0x02000000) -- CPU_ReadMem(1 bytes @ 0x200021DA) - Data: 00  returns 0x01 (0000ms, 1652ms total)
T4118 396:920 JLINK_ReadMemEx(0x200021DB, 0x0001 Bytes, ..., Flags = 0x02000000) -- CPU_ReadMem(1 bytes @ 0x200021DB) - Data: 00  returns 0x01 (0000ms, 1652ms total)
T4118 396:920 JLINK_ReadMemEx(0x200021DC, 0x0001 Bytes, ..., Flags = 0x02000000) -- CPU_ReadMem(1 bytes @ 0x200021DC) - Data: 00  returns 0x01 (0001ms, 1653ms total)
T4118 396:921 JLINK_ReadMemEx(0x200021DD, 0x0001 Bytes, ..., Flags = 0x02000000) -- CPU_ReadMem(1 bytes @ 0x200021DD) - Data: 00  returns 0x01 (0000ms, 1653ms total)
T4118 396:921 JLINK_ReadMemEx(0x200021DE, 0x0001 Bytes, ..., Flags = 0x02000000) -- CPU_ReadMem(1 bytes @ 0x200021DE) - Data: 00  returns 0x01 (0000ms, 1653ms total)
T4118 396:921 JLINK_ReadMemEx(0x200021DF, 0x0001 Bytes, ..., Flags = 0x02000000) -- CPU_ReadMem(1 bytes @ 0x200021DF) - Data: 00  returns 0x01 (0000ms, 1653ms total)
T4118 396:921 JLINK_ReadMemEx(0x200021E0, 0x0001 Bytes, ..., Flags = 0x02000000) -- CPU_ReadMem(1 bytes @ 0x200021E0) - Data: 00  returns 0x01 (0001ms, 1654ms total)
T4118 396:922 JLINK_ReadMemEx(0x200021E1, 0x0001 Bytes, ..., Flags = 0x02000000) -- CPU_ReadMem(1 bytes @ 0x200021E1) - Data: 00  returns 0x01 (0000ms, 1654ms total)
T4118 396:922 JLINK_ReadMemEx(0x200021E2, 0x0001 Bytes, ..., Flags = 0x02000000) -- CPU_ReadMem(1 bytes @ 0x200021E2) - Data: 00  returns 0x01 (0000ms, 1654ms total)
T4118 396:922 JLINK_ReadMemEx(0x200021E3, 0x0001 Bytes, ..., Flags = 0x02000000) -- CPU_ReadMem(1 bytes @ 0x200021E3) - Data: 00  returns 0x01 (0000ms, 1654ms total)
T4118 396:922 JLINK_ReadMemEx(0x200021E4, 0x0001 Bytes, ..., Flags = 0x02000000) -- CPU_ReadMem(1 bytes @ 0x200021E4) - Data: 00  returns 0x01 (0001ms, 1655ms total)
T4118 396:923 JLINK_ReadMemEx(0x200021E5, 0x0001 Bytes, ..., Flags = 0x02000000) -- CPU_ReadMem(1 bytes @ 0x200021E5) - Data: 00  returns 0x01 (0000ms, 1655ms total)
T4118 396:923 JLINK_ReadMemEx(0x200021E6, 0x0001 Bytes, ..., Flags = 0x02000000) -- CPU_ReadMem(1 bytes @ 0x200021E6) - Data: 00  returns 0x01 (0000ms, 1655ms total)
T4118 396:923 JLINK_ReadMemEx(0x200021E7, 0x0001 Bytes, ..., Flags = 0x02000000) -- CPU_ReadMem(1 bytes @ 0x200021E7) - Data: 00  returns 0x01 (0000ms, 1655ms total)
T4118 396:923 JLINK_ReadMemEx(0x200021E8, 0x0001 Bytes, ..., Flags = 0x02000000) -- CPU_ReadMem(1 bytes @ 0x200021E8) - Data: 00  returns 0x01 (0001ms, 1656ms total)
T4118 396:924 JLINK_ReadMemEx(0x200021E9, 0x0001 Bytes, ..., Flags = 0x02000000) -- CPU_ReadMem(1 bytes @ 0x200021E9) - Data: 00  returns 0x01 (0000ms, 1656ms total)
T4118 396:924 JLINK_ReadMemEx(0x200021EA, 0x0001 Bytes, ..., Flags = 0x02000000) -- CPU_ReadMem(1 bytes @ 0x200021EA) - Data: 00  returns 0x01 (0000ms, 1656ms total)
T4118 396:924 JLINK_ReadMemEx(0x200021EB, 0x0001 Bytes, ..., Flags = 0x02000000) -- CPU_ReadMem(1 bytes @ 0x200021EB) - Data: 00  returns 0x01 (0001ms, 1657ms total)
T4118 396:925 JLINK_ReadMemEx(0x200021EC, 0x0001 Bytes, ..., Flags = 0x02000000) -- CPU_ReadMem(1 bytes @ 0x200021EC) - Data: 00  returns 0x01 (0000ms, 1657ms total)
T4118 396:925 JLINK_ReadMemEx(0x200021ED, 0x0001 Bytes, ..., Flags = 0x02000000) -- CPU_ReadMem(1 bytes @ 0x200021ED) - Data: 00  returns 0x01 (0000ms, 1657ms total)
T4118 396:925 JLINK_ReadMemEx(0x200021EE, 0x0001 Bytes, ..., Flags = 0x02000000) -- CPU_ReadMem(1 bytes @ 0x200021EE) - Data: 00  returns 0x01 (0000ms, 1657ms total)
T4118 396:925 JLINK_ReadMemEx(0x200021EF, 0x0001 Bytes, ..., Flags = 0x02000000) -- CPU_ReadMem(1 bytes @ 0x200021EF) - Data: 00  returns 0x01 (0001ms, 1658ms total)
T4118 396:926 JLINK_ReadMemEx(0x200021F0, 0x0001 Bytes, ..., Flags = 0x02000000) -- CPU_ReadMem(1 bytes @ 0x200021F0) - Data: 00  returns 0x01 (0000ms, 1658ms total)
T4118 396:926 JLINK_ReadMemEx(0x200021F1, 0x0001 Bytes, ..., Flags = 0x02000000) -- CPU_ReadMem(1 bytes @ 0x200021F1) - Data: 00  returns 0x01 (0000ms, 1658ms total)
T4118 396:926 JLINK_ReadMemEx(0x200021F2, 0x0001 Bytes, ..., Flags = 0x02000000) -- CPU_ReadMem(1 bytes @ 0x200021F2) - Data: 00  returns 0x01 (0000ms, 1658ms total)
T4118 396:926 JLINK_ReadMemEx(0x200021F3, 0x0001 Bytes, ..., Flags = 0x02000000) -- CPU_ReadMem(1 bytes @ 0x200021F3) - Data: 00  returns 0x01 (0001ms, 1659ms total)
T4118 396:927 JLINK_ReadMemEx(0x200021F4, 0x0001 Bytes, ..., Flags = 0x02000000) -- CPU_ReadMem(1 bytes @ 0x200021F4) - Data: 00  returns 0x01 (0000ms, 1659ms total)
T4118 396:927 JLINK_ReadMemEx(0x200021F5, 0x0001 Bytes, ..., Flags = 0x02000000) -- CPU_ReadMem(1 bytes @ 0x200021F5) - Data: 00  returns 0x01 (0000ms, 1659ms total)
T4118 396:927 JLINK_ReadMemEx(0x200021F6, 0x0001 Bytes, ..., Flags = 0x02000000) -- CPU_ReadMem(1 bytes @ 0x200021F6) - Data: 00  returns 0x01 (0000ms, 1659ms total)
T4118 396:927 JLINK_ReadMemEx(0x200021F7, 0x0001 Bytes, ..., Flags = 0x02000000) -- CPU_ReadMem(1 bytes @ 0x200021F7) - Data: 00  returns 0x01 (0001ms, 1660ms total)
T4118 396:928 JLINK_ReadMemEx(0x200021F8, 0x0001 Bytes, ..., Flags = 0x02000000) -- CPU_ReadMem(1 bytes @ 0x200021F8) - Data: 00  returns 0x01 (0000ms, 1660ms total)
T4118 396:928 JLINK_ReadMemEx(0x200021F9, 0x0001 Bytes, ..., Flags = 0x02000000) -- CPU_ReadMem(1 bytes @ 0x200021F9) - Data: 00  returns 0x01 (0000ms, 1660ms total)
T4118 396:928 JLINK_ReadMemEx(0x200021FA, 0x0001 Bytes, ..., Flags = 0x02000000) -- CPU_ReadMem(1 bytes @ 0x200021FA) - Data: 00  returns 0x01 (0000ms, 1660ms total)
T4118 396:928 JLINK_ReadMemEx(0x200021FB, 0x0001 Bytes, ..., Flags = 0x02000000) -- CPU_ReadMem(1 bytes @ 0x200021FB) - Data: 00  returns 0x01 (0001ms, 1661ms total)
T4118 396:929 JLINK_ReadMemEx(0x200021FC, 0x0001 Bytes, ..., Flags = 0x02000000) -- CPU_ReadMem(1 bytes @ 0x200021FC) - Data: 00  returns 0x01 (0000ms, 1661ms total)
T4118 396:929 JLINK_ReadMemEx(0x200021FD, 0x0001 Bytes, ..., Flags = 0x02000000) -- CPU_ReadMem(1 bytes @ 0x200021FD) - Data: 00  returns 0x01 (0000ms, 1661ms total)
T4118 396:929 JLINK_ReadMemEx(0x200021FE, 0x0001 Bytes, ..., Flags = 0x02000000) -- CPU_ReadMem(1 bytes @ 0x200021FE) - Data: 00  returns 0x01 (0000ms, 1661ms total)
T4118 396:929 JLINK_ReadMemEx(0x200021FF, 0x0001 Bytes, ..., Flags = 0x02000000) -- CPU_ReadMem(1 bytes @ 0x200021FF) - Data: 00  returns 0x01 (0001ms, 1662ms total)
T4118 396:930 JLINK_ReadMemEx(0x20002200, 0x0001 Bytes, ..., Flags = 0x02000000) -- CPU_ReadMem(1 bytes @ 0x20002200) - Data: 00  returns 0x01 (0000ms, 1662ms total)
T4118 396:930 JLINK_ReadMemEx(0x20002201, 0x0001 Bytes, ..., Flags = 0x02000000) -- CPU_ReadMem(1 bytes @ 0x20002201) - Data: 00  returns 0x01 (0000ms, 1662ms total)
T4118 396:930 JLINK_ReadMemEx(0x20002202, 0x0001 Bytes, ..., Flags = 0x02000000) -- CPU_ReadMem(1 bytes @ 0x20002202) - Data: 00  returns 0x01 (0000ms, 1662ms total)
T4118 396:930 JLINK_ReadMemEx(0x20002203, 0x0001 Bytes, ..., Flags = 0x02000000) -- CPU_ReadMem(1 bytes @ 0x20002203) - Data: 00  returns 0x01 (0001ms, 1663ms total)
T4118 396:931 JLINK_ReadMemEx(0x20002204, 0x0001 Bytes, ..., Flags = 0x02000000) -- CPU_ReadMem(1 bytes @ 0x20002204) - Data: 00  returns 0x01 (0000ms, 1663ms total)
T4118 396:931 JLINK_ReadMemEx(0x20002205, 0x0001 Bytes, ..., Flags = 0x02000000) -- CPU_ReadMem(1 bytes @ 0x20002205) - Data: 00  returns 0x01 (0000ms, 1663ms total)
T4118 396:931 JLINK_ReadMemEx(0x20002206, 0x0001 Bytes, ..., Flags = 0x02000000) -- CPU_ReadMem(1 bytes @ 0x20002206) - Data: 00  returns 0x01 (0000ms, 1663ms total)
T4118 396:931 JLINK_ReadMemEx(0x20002207, 0x0001 Bytes, ..., Flags = 0x02000000) -- CPU_ReadMem(1 bytes @ 0x20002207) - Data: 00  returns 0x01 (0001ms, 1664ms total)
T4118 396:932 JLINK_ReadMemEx(0x20002208, 0x0001 Bytes, ..., Flags = 0x02000000) -- CPU_ReadMem(1 bytes @ 0x20002208) - Data: 00  returns 0x01 (0000ms, 1664ms total)
T4118 396:932 JLINK_ReadMemEx(0x20002209, 0x0001 Bytes, ..., Flags = 0x02000000) -- CPU_ReadMem(1 bytes @ 0x20002209) - Data: 00  returns 0x01 (0000ms, 1664ms total)
T4118 396:932 JLINK_ReadMemEx(0x2000220A, 0x0001 Bytes, ..., Flags = 0x02000000) -- CPU_ReadMem(1 bytes @ 0x2000220A) - Data: 00  returns 0x01 (0000ms, 1664ms total)
T4118 396:932 JLINK_ReadMemEx(0x2000220B, 0x0001 Bytes, ..., Flags = 0x02000000) -- CPU_ReadMem(1 bytes @ 0x2000220B) - Data: 00  returns 0x01 (0001ms, 1665ms total)
T4118 396:933 JLINK_ReadMemEx(0x2000220C, 0x0001 Bytes, ..., Flags = 0x02000000) -- CPU_ReadMem(1 bytes @ 0x2000220C) - Data: 00  returns 0x01 (0000ms, 1665ms total)
T4118 396:933 JLINK_ReadMemEx(0x2000220D, 0x0001 Bytes, ..., Flags = 0x02000000) -- CPU_ReadMem(1 bytes @ 0x2000220D) - Data: 00  returns 0x01 (0000ms, 1665ms total)
T4118 396:933 JLINK_ReadMemEx(0x2000220E, 0x0001 Bytes, ..., Flags = 0x02000000) -- CPU_ReadMem(1 bytes @ 0x2000220E) - Data: 00  returns 0x01 (0000ms, 1665ms total)
T4118 396:933 JLINK_ReadMemEx(0x2000220F, 0x0001 Bytes, ..., Flags = 0x02000000) -- CPU_ReadMem(1 bytes @ 0x2000220F) - Data: 00  returns 0x01 (0001ms, 1666ms total)
T4118 396:934 JLINK_ReadMemEx(0x20002210, 0x0001 Bytes, ..., Flags = 0x02000000) -- CPU_ReadMem(1 bytes @ 0x20002210) - Data: 00  returns 0x01 (0000ms, 1666ms total)
T4118 396:934 JLINK_ReadMemEx(0x20002211, 0x0001 Bytes, ..., Flags = 0x02000000) -- CPU_ReadMem(1 bytes @ 0x20002211) - Data: 00  returns 0x01 (0000ms, 1666ms total)
T4118 396:934 JLINK_ReadMemEx(0x20002212, 0x0001 Bytes, ..., Flags = 0x02000000) -- CPU_ReadMem(1 bytes @ 0x20002212) - Data: 00  returns 0x01 (0000ms, 1666ms total)
T4118 396:934 JLINK_ReadMemEx(0x20002213, 0x0001 Bytes, ..., Flags = 0x02000000) -- CPU_ReadMem(1 bytes @ 0x20002213) - Data: 00  returns 0x01 (0001ms, 1667ms total)
T2470 397:010 JLINK_IsHalted()  returns FALSE (0000ms, 1667ms total)
T2470 397:111 JLINK_IsHalted()  returns FALSE (0000ms, 1667ms total)
T2470 397:211 JLINK_IsHalted()  returns FALSE (0000ms, 1667ms total)
T2470 397:312 JLINK_IsHalted()  returns FALSE (0000ms, 1667ms total)
T2470 397:413 JLINK_IsHalted()  returns FALSE (0000ms, 1667ms total)
T2470 397:513 JLINK_IsHalted()  returns FALSE (0000ms, 1667ms total)
T2470 397:614 JLINK_IsHalted()  returns FALSE (0000ms, 1667ms total)
T2470 397:715 JLINK_IsHalted()  returns FALSE (0000ms, 1667ms total)
T2470 397:816 JLINK_IsHalted()  returns FALSE (0000ms, 1667ms total)
T2470 397:916 JLINK_IsHalted()  returns FALSE (0000ms, 1667ms total)
T2470 398:017 JLINK_IsHalted()  returns FALSE (0000ms, 1667ms total)
T2470 398:118 JLINK_IsHalted()  returns FALSE (0000ms, 1667ms total)
T2470 398:219 JLINK_IsHalted()  returns FALSE (0000ms, 1667ms total)
T2470 398:319 JLINK_IsHalted()  returns FALSE (0000ms, 1667ms total)
T2470 398:420 JLINK_IsHalted()  returns FALSE (0000ms, 1667ms total)
T2470 398:521 JLINK_IsHalted()  returns FALSE (0000ms, 1667ms total)
T2470 398:621 JLINK_IsHalted()  returns FALSE (0000ms, 1667ms total)
T2470 398:722 JLINK_IsHalted()  returns FALSE (0000ms, 1667ms total)
T2470 398:823 JLINK_IsHalted()  returns FALSE (0000ms, 1667ms total)
T2470 398:924 JLINK_IsHalted()  returns FALSE (0000ms, 1667ms total)
T2470 399:024 JLINK_IsHalted()  returns FALSE (0000ms, 1667ms total)
T2470 399:125 JLINK_IsHalted()  returns FALSE (0000ms, 1667ms total)
T2470 399:226 JLINK_IsHalted()  returns FALSE (0000ms, 1667ms total)
T4118 399:314 JLINK_SetBPEx(Addr = 0x08004574, Type = 0xFFFFFFF2) -- CPU is running -- CPU is running -- CPU_WriteMem(4 bytes @ 0xE0002000) -- CPU is running -- CPU_WriteMem(4 bytes @ 0xE0002010)  returns 0x0000000E (0000ms, 1667ms total)
T2470 399:327 JLINK_IsHalted()  returns FALSE (0000ms, 1667ms total)
T2470 399:427 JLINK_IsHalted()  returns FALSE (0000ms, 1667ms total)
T2470 399:528 JLINK_IsHalted()  returns FALSE (0000ms, 1667ms total)
T2470 399:629 JLINK_IsHalted()  returns FALSE (0000ms, 1667ms total)
T2470 399:730 JLINK_IsHalted()  returns FALSE (0000ms, 1667ms total)
T2470 399:830 JLINK_IsHalted()  returns FALSE (0000ms, 1667ms total)
T2470 399:931 JLINK_IsHalted()  returns FALSE (0000ms, 1667ms total)
T2470 400:032 JLINK_IsHalted()  returns FALSE (0000ms, 1667ms total)
T2470 400:132 JLINK_IsHalted()  returns FALSE (0000ms, 1667ms total)
T2470 400:233 JLINK_IsHalted()  returns FALSE (0000ms, 1667ms total)
T2470 400:334 JLINK_IsHalted()  returns FALSE (0000ms, 1667ms total)
T2470 400:435 JLINK_IsHalted()  returns FALSE (0000ms, 1667ms total)
T2470 400:535 JLINK_IsHalted()  returns FALSE (0000ms, 1667ms total)
T2470 400:651 JLINK_IsHalted()  returns FALSE (0007ms, 1674ms total)
T2470 400:760 JLINK_IsHalted()  returns TRUE (0002ms, 1669ms total)
T2470 400:762 JLINK_Halt()  returns 0x00 (0000ms, 1667ms total)
T2470 400:762 JLINK_IsHalted()  returns TRUE (0000ms, 1667ms total)
T2470 400:762 JLINK_IsHalted()  returns TRUE (0000ms, 1667ms total)
T2470 400:762 JLINK_IsHalted()  returns TRUE (0000ms, 1667ms total)
T2470 400:762 JLINK_ReadReg(R15 (PC))  returns 0x08004574 (0000ms, 1667ms total)
T2470 400:762 JLINK_ReadReg(XPSR)  returns 0x81000035 (0000ms, 1667ms total)
T2470 400:762 JLINK_ClrBPEx(BPHandle = 0x0000000C)  returns 0x00 (0000ms, 1667ms total)
T2470 400:762 JLINK_ClrBPEx(BPHandle = 0x0000000D)  returns 0x00 (0000ms, 1667ms total)
T2470 400:762 JLINK_ClrBPEx(BPHandle = 0x0000000E)  returns 0x00 (0000ms, 1667ms total)
T2470 400:762 JLINK_ReadMemU32(0xE000ED30, 0x0001 Items, ...) -- CPU_ReadMem(4 bytes @ 0xE000ED30) - Data: 02 00 00 00  returns 0x01 (0000ms, 1667ms total)
T2470 400:762 JLINK_ReadMemU32(0xE0001028, 0x0001 Items, ...) -- CPU_ReadMem(4 bytes @ 0xE0001028) - Data: 00 00 00 00  returns 0x01 (0000ms, 1667ms total)
T2470 400:762 JLINK_ReadMemU32(0xE0001038, 0x0001 Items, ...) -- CPU_ReadMem(4 bytes @ 0xE0001038) - Data: 00 02 00 00  returns 0x01 (0001ms, 1668ms total)
T2470 400:763 JLINK_ReadMemU32(0xE0001048, 0x0001 Items, ...) -- CPU_ReadMem(4 bytes @ 0xE0001048) - Data: 00 00 00 00  returns 0x01 (0000ms, 1668ms total)
T2470 400:763 JLINK_ReadMemU32(0xE0001058, 0x0001 Items, ...) -- CPU_ReadMem(4 bytes @ 0xE0001058) - Data: 00 00 00 00  returns 0x01 (0000ms, 1668ms total)
T2470 400:763 JLINK_ReadReg(R0)  returns 0x20002194 (0000ms, 1668ms total)
T2470 400:763 JLINK_ReadReg(R1)  returns 0x00000001 (0000ms, 1668ms total)
T2470 400:763 JLINK_ReadReg(R2)  returns 0x40012C00 (0000ms, 1668ms total)
T2470 400:763 JLINK_ReadReg(R3)  returns 0x40012C0C (0000ms, 1668ms total)
T2470 400:763 JLINK_ReadReg(R4)  returns 0x00000000 (0000ms, 1668ms total)
T2470 400:763 JLINK_ReadReg(R5)  returns 0x00000000 (0001ms, 1669ms total)
T2470 400:764 JLINK_ReadReg(R6)  returns 0x00000000 (0000ms, 1669ms total)
T2470 400:764 JLINK_ReadReg(R7)  returns 0x00000000 (0000ms, 1669ms total)
T2470 400:764 JLINK_ReadReg(R8)  returns 0x20001FBC (0000ms, 1669ms total)
T2470 400:764 JLINK_ReadReg(R9)  returns 0x0000C350 (0000ms, 1669ms total)
T2470 400:764 JLINK_ReadReg(R10)  returns 0x000003E8 (0000ms, 1669ms total)
T2470 400:764 JLINK_ReadReg(R11)  returns 0x00000001 (0000ms, 1669ms total)
T2470 400:764 JLINK_ReadReg(R12)  returns 0x9E1B08C0 (0000ms, 1669ms total)
T2470 400:764 JLINK_ReadReg(R13 (SP))  returns 0x20002918 (0000ms, 1669ms total)
T2470 400:764 JLINK_ReadReg(R14)  returns 0xFFFFFFF9 (0000ms, 1669ms total)
T2470 400:764 JLINK_ReadReg(R15 (PC))  returns 0x08004574 (0000ms, 1669ms total)
T2470 400:764 JLINK_ReadReg(XPSR)  returns 0x81000035 (0000ms, 1669ms total)
T2470 400:764 JLINK_ReadReg(MSP)  returns 0x20002918 (0000ms, 1669ms total)
T2470 400:764 JLINK_ReadReg(PSP)  returns 0xAEAA5364 (0000ms, 1669ms total)
T2470 400:764 JLINK_ReadReg(CFBP)  returns 0x00000000 (0000ms, 1669ms total)
T4118 400:764 JLINK_ReadMemEx(0x20002924, 0x0004 Bytes, ..., Flags = 0x02000000) -- CPU_ReadMem(64 bytes @ 0x20002900) -- Updating C cache (64 bytes @ 0x20002900) -- Read from C cache (4 bytes @ 0x20002924) - Data: F9 FF FF FF  returns 0x04 (0001ms, 1670ms total)
T4118 400:765 JLINK_ReadMemEx(0x20002940, 0x0004 Bytes, ..., Flags = 0x02000000) -- CPU_ReadMem(64 bytes @ 0x20002940) -- Updating C cache (64 bytes @ 0x20002940) -- Read from C cache (4 bytes @ 0x20002940) - Data: 5E 49 00 08  returns 0x04 (0000ms, 1670ms total)
T4118 400:765 JLINK_ReadMemEx(0x20002944, 0x0004 Bytes, ..., Flags = 0x02000000) -- Read from C cache (4 bytes @ 0x20002944) - Data: 00 00 00 21  returns 0x04 (0000ms, 1670ms total)
T4118 400:765 JLINK_ReadMemEx(0x2000293C, 0x0004 Bytes, ..., Flags = 0x02000000) -- Read from C cache (4 bytes @ 0x2000293C) - Data: 3F 50 00 08  returns 0x04 (0000ms, 1670ms total)
T4118 400:765 JLINK_ReadMemEx(0xE000ED28, 0x0004 Bytes, ..., Flags = 0x02000000) -- CPU_ReadMem(4 bytes @ 0xE000ED28) - Data: 00 00 00 00  returns 0x04 (0001ms, 1671ms total)
T4118 400:779 JLINK_ReadMemEx(0x20002938, 0x0004 Bytes, ..., Flags = 0x02000000) -- Read from C cache (4 bytes @ 0x20002938) - Data: C0 08 1B 9E  returns 0x04 (0001ms, 1672ms total)
T4118 400:780 JLINK_ReadMemEx(0x00000000, 0x0001 Bytes, ..., Flags = 0x02000000) -- CPU_ReadMem(4 bytes @ 0x00000004) -- CPU_ReadMem(64 bytes @ 0x08000000) -- Updating C cache (64 bytes @ 0x08000000) -- Read from C cache (1 bytes @ 0x08000000) - Data: 48  returns 0x01 (0001ms, 1673ms total)
T4118 400:781 JLINK_ReadMemEx(0x20000024, 0x0002 Bytes, ..., Flags = 0x02000000) -- CPU_ReadMem(64 bytes @ 0x20000000) -- Updating C cache (64 bytes @ 0x20000000) -- Read from C cache (2 bytes @ 0x20000024) - Data: 02 00  returns 0x02 (0001ms, 1674ms total)
T4118 400:783 JLINK_ReadMemEx(0x20002194, 0x0020 Bytes, ..., Flags = 0x02000000) -- CPU_ReadMem(64 bytes @ 0x20002180) -- Updating C cache (64 bytes @ 0x20002180) -- Read from C cache (32 bytes @ 0x20002194) - Data: 4D 00 00 00 00 00 00 00 00 00 00 00 00 00 00 00 ...  returns 0x20 (0000ms, 1674ms total)
T4118 400:784 JLINK_ReadMemEx(0x200021B4, 0x0001 Bytes, ..., Flags = 0x02000000) -- Read from C cache (1 bytes @ 0x200021B4) - Data: 00  returns 0x01 (0000ms, 1674ms total)
T4118 400:784 JLINK_ReadMemEx(0x200021B5, 0x0001 Bytes, ..., Flags = 0x02000000) -- Read from C cache (1 bytes @ 0x200021B5) - Data: 00  returns 0x01 (0000ms, 1674ms total)
T4118 400:784 JLINK_ReadMemEx(0x200021B6, 0x0001 Bytes, ..., Flags = 0x02000000) -- Read from C cache (1 bytes @ 0x200021B6) - Data: 00  returns 0x01 (0000ms, 1674ms total)
T4118 400:784 JLINK_ReadMemEx(0x200021B7, 0x0001 Bytes, ..., Flags = 0x02000000) -- Read from C cache (1 bytes @ 0x200021B7) - Data: 00  returns 0x01 (0000ms, 1674ms total)
T4118 400:784 JLINK_ReadMemEx(0x200021B8, 0x0001 Bytes, ..., Flags = 0x02000000) -- Read from C cache (1 bytes @ 0x200021B8) - Data: 00  returns 0x01 (0000ms, 1674ms total)
T4118 400:784 JLINK_ReadMemEx(0x200021B9, 0x0001 Bytes, ..., Flags = 0x02000000) -- Read from C cache (1 bytes @ 0x200021B9) - Data: 00  returns 0x01 (0000ms, 1674ms total)
T4118 400:784 JLINK_ReadMemEx(0x200021BA, 0x0001 Bytes, ..., Flags = 0x02000000) -- Read from C cache (1 bytes @ 0x200021BA) - Data: 00  returns 0x01 (0000ms, 1674ms total)
T4118 400:784 JLINK_ReadMemEx(0x200021BB, 0x0001 Bytes, ..., Flags = 0x02000000) -- Read from C cache (1 bytes @ 0x200021BB) - Data: 00  returns 0x01 (0000ms, 1674ms total)
T4118 400:784 JLINK_ReadMemEx(0x200021BC, 0x0001 Bytes, ..., Flags = 0x02000000) -- Read from C cache (1 bytes @ 0x200021BC) - Data: 00  returns 0x01 (0000ms, 1674ms total)
T4118 400:784 JLINK_ReadMemEx(0x200021BD, 0x0001 Bytes, ..., Flags = 0x02000000) -- Read from C cache (1 bytes @ 0x200021BD) - Data: 00  returns 0x01 (0000ms, 1674ms total)
T4118 400:784 JLINK_ReadMemEx(0x200021BE, 0x0001 Bytes, ..., Flags = 0x02000000) -- Read from C cache (1 bytes @ 0x200021BE) - Data: 00  returns 0x01 (0000ms, 1674ms total)
T4118 400:784 JLINK_ReadMemEx(0x200021BF, 0x0001 Bytes, ..., Flags = 0x02000000) -- Read from C cache (1 bytes @ 0x200021BF) - Data: 00  returns 0x01 (0000ms, 1674ms total)
T4118 400:784 JLINK_ReadMemEx(0x200021C0, 0x0001 Bytes, ..., Flags = 0x02000000) -- CPU_ReadMem(64 bytes @ 0x200021C0) -- Updating C cache (64 bytes @ 0x200021C0) -- Read from C cache (1 bytes @ 0x200021C0) - Data: 00  returns 0x01 (0001ms, 1675ms total)
T4118 400:785 JLINK_ReadMemEx(0x200021C1, 0x0001 Bytes, ..., Flags = 0x02000000) -- Read from C cache (1 bytes @ 0x200021C1) - Data: 00  returns 0x01 (0000ms, 1675ms total)
T4118 400:785 JLINK_ReadMemEx(0x200021C2, 0x0001 Bytes, ..., Flags = 0x02000000) -- Read from C cache (1 bytes @ 0x200021C2) - Data: 00  returns 0x01 (0000ms, 1675ms total)
T4118 400:785 JLINK_ReadMemEx(0x200021C3, 0x0001 Bytes, ..., Flags = 0x02000000) -- Read from C cache (1 bytes @ 0x200021C3) - Data: 00  returns 0x01 (0000ms, 1675ms total)
T4118 400:785 JLINK_ReadMemEx(0x200021C4, 0x0001 Bytes, ..., Flags = 0x02000000) -- Read from C cache (1 bytes @ 0x200021C4) - Data: 00  returns 0x01 (0000ms, 1675ms total)
T4118 400:785 JLINK_ReadMemEx(0x200021C5, 0x0001 Bytes, ..., Flags = 0x02000000) -- Read from C cache (1 bytes @ 0x200021C5) - Data: 00  returns 0x01 (0000ms, 1675ms total)
T4118 400:785 JLINK_ReadMemEx(0x200021C6, 0x0001 Bytes, ..., Flags = 0x02000000) -- Read from C cache (1 bytes @ 0x200021C6) - Data: 00  returns 0x01 (0000ms, 1675ms total)
T4118 400:785 JLINK_ReadMemEx(0x200021C7, 0x0001 Bytes, ..., Flags = 0x02000000) -- Read from C cache (1 bytes @ 0x200021C7) - Data: 00  returns 0x01 (0000ms, 1675ms total)
T4118 400:785 JLINK_ReadMemEx(0x200021C8, 0x0001 Bytes, ..., Flags = 0x02000000) -- Read from C cache (1 bytes @ 0x200021C8) - Data: 00  returns 0x01 (0000ms, 1675ms total)
T4118 400:785 JLINK_ReadMemEx(0x200021C9, 0x0001 Bytes, ..., Flags = 0x02000000) -- Read from C cache (1 bytes @ 0x200021C9) - Data: 00  returns 0x01 (0000ms, 1675ms total)
T4118 400:785 JLINK_ReadMemEx(0x200021CA, 0x0001 Bytes, ..., Flags = 0x02000000) -- Read from C cache (1 bytes @ 0x200021CA) - Data: 00  returns 0x01 (0000ms, 1675ms total)
T4118 400:785 JLINK_ReadMemEx(0x200021CB, 0x0001 Bytes, ..., Flags = 0x02000000) -- Read from C cache (1 bytes @ 0x200021CB) - Data: 00  returns 0x01 (0000ms, 1675ms total)
T4118 400:785 JLINK_ReadMemEx(0x200021CC, 0x0001 Bytes, ..., Flags = 0x02000000) -- Read from C cache (1 bytes @ 0x200021CC) - Data: 00  returns 0x01 (0000ms, 1675ms total)
T4118 400:785 JLINK_ReadMemEx(0x200021CD, 0x0001 Bytes, ..., Flags = 0x02000000) -- Read from C cache (1 bytes @ 0x200021CD) - Data: 00  returns 0x01 (0000ms, 1675ms total)
T4118 400:785 JLINK_ReadMemEx(0x200021CE, 0x0001 Bytes, ..., Flags = 0x02000000) -- Read from C cache (1 bytes @ 0x200021CE) - Data: 00  returns 0x01 (0000ms, 1675ms total)
T4118 400:785 JLINK_ReadMemEx(0x200021CF, 0x0001 Bytes, ..., Flags = 0x02000000) -- Read from C cache (1 bytes @ 0x200021CF) - Data: 00  returns 0x01 (0000ms, 1675ms total)
T4118 400:785 JLINK_ReadMemEx(0x200021D0, 0x0001 Bytes, ..., Flags = 0x02000000) -- Read from C cache (1 bytes @ 0x200021D0) - Data: 00  returns 0x01 (0000ms, 1675ms total)
T4118 400:785 JLINK_ReadMemEx(0x200021D1, 0x0001 Bytes, ..., Flags = 0x02000000) -- Read from C cache (1 bytes @ 0x200021D1) - Data: 00  returns 0x01 (0001ms, 1676ms total)
T4118 400:786 JLINK_ReadMemEx(0x200021D2, 0x0001 Bytes, ..., Flags = 0x02000000) -- Read from C cache (1 bytes @ 0x200021D2) - Data: 00  returns 0x01 (0000ms, 1676ms total)
T4118 400:786 JLINK_ReadMemEx(0x200021D3, 0x0001 Bytes, ..., Flags = 0x02000000) -- Read from C cache (1 bytes @ 0x200021D3) - Data: 00  returns 0x01 (0000ms, 1676ms total)
T4118 400:786 JLINK_ReadMemEx(0x200021D4, 0x0001 Bytes, ..., Flags = 0x02000000) -- Read from C cache (1 bytes @ 0x200021D4) - Data: 00  returns 0x01 (0000ms, 1676ms total)
T4118 400:786 JLINK_ReadMemEx(0x200021D5, 0x0001 Bytes, ..., Flags = 0x02000000) -- Read from C cache (1 bytes @ 0x200021D5) - Data: 00  returns 0x01 (0000ms, 1676ms total)
T4118 400:786 JLINK_ReadMemEx(0x200021D6, 0x0001 Bytes, ..., Flags = 0x02000000) -- Read from C cache (1 bytes @ 0x200021D6) - Data: 00  returns 0x01 (0000ms, 1676ms total)
T4118 400:786 JLINK_ReadMemEx(0x200021D7, 0x0001 Bytes, ..., Flags = 0x02000000) -- Read from C cache (1 bytes @ 0x200021D7) - Data: 00  returns 0x01 (0000ms, 1676ms total)
T4118 400:786 JLINK_ReadMemEx(0x200021D8, 0x0001 Bytes, ..., Flags = 0x02000000) -- Read from C cache (1 bytes @ 0x200021D8) - Data: 00  returns 0x01 (0000ms, 1676ms total)
T4118 400:786 JLINK_ReadMemEx(0x200021D9, 0x0001 Bytes, ..., Flags = 0x02000000) -- Read from C cache (1 bytes @ 0x200021D9) - Data: 00  returns 0x01 (0000ms, 1676ms total)
T4118 400:786 JLINK_ReadMemEx(0x200021DA, 0x0001 Bytes, ..., Flags = 0x02000000) -- Read from C cache (1 bytes @ 0x200021DA) - Data: 00  returns 0x01 (0000ms, 1676ms total)
T4118 400:786 JLINK_ReadMemEx(0x200021DB, 0x0001 Bytes, ..., Flags = 0x02000000) -- Read from C cache (1 bytes @ 0x200021DB) - Data: 00  returns 0x01 (0000ms, 1676ms total)
T4118 400:786 JLINK_ReadMemEx(0x200021DC, 0x0001 Bytes, ..., Flags = 0x02000000) -- Read from C cache (1 bytes @ 0x200021DC) - Data: 00  returns 0x01 (0000ms, 1676ms total)
T4118 400:786 JLINK_ReadMemEx(0x200021DD, 0x0001 Bytes, ..., Flags = 0x02000000) -- Read from C cache (1 bytes @ 0x200021DD) - Data: 00  returns 0x01 (0000ms, 1676ms total)
T4118 400:786 JLINK_ReadMemEx(0x200021DE, 0x0001 Bytes, ..., Flags = 0x02000000) -- Read from C cache (1 bytes @ 0x200021DE) - Data: 00  returns 0x01 (0000ms, 1676ms total)
T4118 400:786 JLINK_ReadMemEx(0x200021DF, 0x0001 Bytes, ..., Flags = 0x02000000) -- Read from C cache (1 bytes @ 0x200021DF) - Data: 00  returns 0x01 (0000ms, 1676ms total)
T4118 400:786 JLINK_ReadMemEx(0x200021E0, 0x0001 Bytes, ..., Flags = 0x02000000) -- Read from C cache (1 bytes @ 0x200021E0) - Data: 00  returns 0x01 (0000ms, 1676ms total)
T4118 400:786 JLINK_ReadMemEx(0x200021E1, 0x0001 Bytes, ..., Flags = 0x02000000) -- Read from C cache (1 bytes @ 0x200021E1) - Data: 00  returns 0x01 (0000ms, 1676ms total)
T4118 400:786 JLINK_ReadMemEx(0x200021E2, 0x0001 Bytes, ..., Flags = 0x02000000) -- Read from C cache (1 bytes @ 0x200021E2) - Data: 00  returns 0x01 (0000ms, 1676ms total)
T4118 400:786 JLINK_ReadMemEx(0x200021E3, 0x0001 Bytes, ..., Flags = 0x02000000) -- Read from C cache (1 bytes @ 0x200021E3) - Data: 00  returns 0x01 (0000ms, 1676ms total)
T4118 400:786 JLINK_ReadMemEx(0x200021E4, 0x0001 Bytes, ..., Flags = 0x02000000) -- Read from C cache (1 bytes @ 0x200021E4) - Data: 00  returns 0x01 (0000ms, 1676ms total)
T4118 400:786 JLINK_ReadMemEx(0x200021E5, 0x0001 Bytes, ..., Flags = 0x02000000) -- Read from C cache (1 bytes @ 0x200021E5) - Data: 00  returns 0x01 (0000ms, 1676ms total)
T4118 400:786 JLINK_ReadMemEx(0x200021E6, 0x0001 Bytes, ..., Flags = 0x02000000) -- Read from C cache (1 bytes @ 0x200021E6) - Data: 00  returns 0x01 (0000ms, 1676ms total)
T4118 400:786 JLINK_ReadMemEx(0x200021E7, 0x0001 Bytes, ..., Flags = 0x02000000) -- Read from C cache (1 bytes @ 0x200021E7) - Data: 00  returns 0x01 (0000ms, 1676ms total)
T4118 400:786 JLINK_ReadMemEx(0x200021E8, 0x0001 Bytes, ..., Flags = 0x02000000) -- Read from C cache (1 bytes @ 0x200021E8) - Data: 00  returns 0x01 (0000ms, 1676ms total)
T4118 400:786 JLINK_ReadMemEx(0x200021E9, 0x0001 Bytes, ..., Flags = 0x02000000) -- Read from C cache (1 bytes @ 0x200021E9) - Data: 00  returns 0x01 (0000ms, 1676ms total)
T4118 400:786 JLINK_ReadMemEx(0x200021EA, 0x0001 Bytes, ..., Flags = 0x02000000) -- Read from C cache (1 bytes @ 0x200021EA) - Data: 00  returns 0x01 (0000ms, 1676ms total)
T4118 400:786 JLINK_ReadMemEx(0x200021EB, 0x0001 Bytes, ..., Flags = 0x02000000) -- Read from C cache (1 bytes @ 0x200021EB) - Data: 00  returns 0x01 (0000ms, 1676ms total)
T4118 400:786 JLINK_ReadMemEx(0x200021EC, 0x0001 Bytes, ..., Flags = 0x02000000) -- Read from C cache (1 bytes @ 0x200021EC) - Data: 00  returns 0x01 (0001ms, 1677ms total)
T4118 400:787 JLINK_ReadMemEx(0x200021ED, 0x0001 Bytes, ..., Flags = 0x02000000) -- Read from C cache (1 bytes @ 0x200021ED) - Data: 00  returns 0x01 (0000ms, 1677ms total)
T4118 400:787 JLINK_ReadMemEx(0x200021EE, 0x0001 Bytes, ..., Flags = 0x02000000) -- Read from C cache (1 bytes @ 0x200021EE) - Data: 00  returns 0x01 (0000ms, 1677ms total)
T4118 400:787 JLINK_ReadMemEx(0x200021EF, 0x0001 Bytes, ..., Flags = 0x02000000) -- Read from C cache (1 bytes @ 0x200021EF) - Data: 00  returns 0x01 (0000ms, 1677ms total)
T4118 400:787 JLINK_ReadMemEx(0x200021F0, 0x0001 Bytes, ..., Flags = 0x02000000) -- Read from C cache (1 bytes @ 0x200021F0) - Data: 00  returns 0x01 (0000ms, 1677ms total)
T4118 400:787 JLINK_ReadMemEx(0x200021F1, 0x0001 Bytes, ..., Flags = 0x02000000) -- Read from C cache (1 bytes @ 0x200021F1) - Data: 00  returns 0x01 (0000ms, 1677ms total)
T4118 400:787 JLINK_ReadMemEx(0x200021F2, 0x0001 Bytes, ..., Flags = 0x02000000) -- Read from C cache (1 bytes @ 0x200021F2) - Data: 00  returns 0x01 (0000ms, 1677ms total)
T4118 400:787 JLINK_ReadMemEx(0x200021F3, 0x0001 Bytes, ..., Flags = 0x02000000) -- Read from C cache (1 bytes @ 0x200021F3) - Data: 00  returns 0x01 (0000ms, 1677ms total)
T4118 400:787 JLINK_ReadMemEx(0x200021F4, 0x0001 Bytes, ..., Flags = 0x02000000) -- Read from C cache (1 bytes @ 0x200021F4) - Data: 00  returns 0x01 (0000ms, 1677ms total)
T4118 400:787 JLINK_ReadMemEx(0x200021F5, 0x0001 Bytes, ..., Flags = 0x02000000) -- Read from C cache (1 bytes @ 0x200021F5) - Data: 00  returns 0x01 (0000ms, 1677ms total)
T4118 400:787 JLINK_ReadMemEx(0x200021F6, 0x0001 Bytes, ..., Flags = 0x02000000) -- Read from C cache (1 bytes @ 0x200021F6) - Data: 00  returns 0x01 (0000ms, 1677ms total)
T4118 400:787 JLINK_ReadMemEx(0x200021F7, 0x0001 Bytes, ..., Flags = 0x02000000) -- Read from C cache (1 bytes @ 0x200021F7) - Data: 00  returns 0x01 (0000ms, 1677ms total)
T4118 400:787 JLINK_ReadMemEx(0x200021F8, 0x0001 Bytes, ..., Flags = 0x02000000) -- Read from C cache (1 bytes @ 0x200021F8) - Data: 00  returns 0x01 (0000ms, 1677ms total)
T4118 400:787 JLINK_ReadMemEx(0x200021F9, 0x0001 Bytes, ..., Flags = 0x02000000) -- Read from C cache (1 bytes @ 0x200021F9) - Data: 00  returns 0x01 (0000ms, 1677ms total)
T4118 400:787 JLINK_ReadMemEx(0x200021FA, 0x0001 Bytes, ..., Flags = 0x02000000) -- Read from C cache (1 bytes @ 0x200021FA) - Data: 00  returns 0x01 (0000ms, 1677ms total)
T4118 400:787 JLINK_ReadMemEx(0x200021FB, 0x0001 Bytes, ..., Flags = 0x02000000) -- Read from C cache (1 bytes @ 0x200021FB) - Data: 00  returns 0x01 (0000ms, 1677ms total)
T4118 400:787 JLINK_ReadMemEx(0x200021FC, 0x0001 Bytes, ..., Flags = 0x02000000) -- Read from C cache (1 bytes @ 0x200021FC) - Data: 00  returns 0x01 (0000ms, 1677ms total)
T4118 400:787 JLINK_ReadMemEx(0x200021FD, 0x0001 Bytes, ..., Flags = 0x02000000) -- Read from C cache (1 bytes @ 0x200021FD) - Data: 00  returns 0x01 (0000ms, 1677ms total)
T4118 400:787 JLINK_ReadMemEx(0x200021FE, 0x0001 Bytes, ..., Flags = 0x02000000) -- Read from C cache (1 bytes @ 0x200021FE) - Data: 00  returns 0x01 (0000ms, 1677ms total)
T4118 400:787 JLINK_ReadMemEx(0x200021FF, 0x0001 Bytes, ..., Flags = 0x02000000) -- Read from C cache (1 bytes @ 0x200021FF) - Data: 00  returns 0x01 (0000ms, 1677ms total)
T4118 400:787 JLINK_ReadMemEx(0x20002200, 0x0001 Bytes, ..., Flags = 0x02000000) -- CPU_ReadMem(64 bytes @ 0x20002200) -- Updating C cache (64 bytes @ 0x20002200) -- Read from C cache (1 bytes @ 0x20002200) - Data: 00  returns 0x01 (0001ms, 1678ms total)
T4118 400:788 JLINK_ReadMemEx(0x20002201, 0x0001 Bytes, ..., Flags = 0x02000000) -- Read from C cache (1 bytes @ 0x20002201) - Data: 00  returns 0x01 (0000ms, 1678ms total)
T4118 400:788 JLINK_ReadMemEx(0x20002202, 0x0001 Bytes, ..., Flags = 0x02000000) -- Read from C cache (1 bytes @ 0x20002202) - Data: 00  returns 0x01 (0000ms, 1678ms total)
T4118 400:788 JLINK_ReadMemEx(0x20002203, 0x0001 Bytes, ..., Flags = 0x02000000) -- Read from C cache (1 bytes @ 0x20002203) - Data: 00  returns 0x01 (0000ms, 1678ms total)
T4118 400:788 JLINK_ReadMemEx(0x20002204, 0x0001 Bytes, ..., Flags = 0x02000000) -- Read from C cache (1 bytes @ 0x20002204) - Data: 00  returns 0x01 (0000ms, 1678ms total)
T4118 400:788 JLINK_ReadMemEx(0x20002205, 0x0001 Bytes, ..., Flags = 0x02000000) -- Read from C cache (1 bytes @ 0x20002205) - Data: 00  returns 0x01 (0000ms, 1678ms total)
T4118 400:788 JLINK_ReadMemEx(0x20002206, 0x0001 Bytes, ..., Flags = 0x02000000) -- Read from C cache (1 bytes @ 0x20002206) - Data: 00  returns 0x01 (0000ms, 1678ms total)
T4118 400:788 JLINK_ReadMemEx(0x20002207, 0x0001 Bytes, ..., Flags = 0x02000000) -- Read from C cache (1 bytes @ 0x20002207) - Data: 00  returns 0x01 (0000ms, 1678ms total)
T4118 400:788 JLINK_ReadMemEx(0x20002208, 0x0001 Bytes, ..., Flags = 0x02000000) -- Read from C cache (1 bytes @ 0x20002208) - Data: 00  returns 0x01 (0000ms, 1678ms total)
T4118 400:788 JLINK_ReadMemEx(0x20002209, 0x0001 Bytes, ..., Flags = 0x02000000) -- Read from C cache (1 bytes @ 0x20002209) - Data: 00  returns 0x01 (0000ms, 1678ms total)
T4118 400:788 JLINK_ReadMemEx(0x2000220A, 0x0001 Bytes, ..., Flags = 0x02000000) -- Read from C cache (1 bytes @ 0x2000220A) - Data: 00  returns 0x01 (0000ms, 1678ms total)
T4118 400:788 JLINK_ReadMemEx(0x2000220B, 0x0001 Bytes, ..., Flags = 0x02000000) -- Read from C cache (1 bytes @ 0x2000220B) - Data: 00  returns 0x01 (0000ms, 1678ms total)
T4118 400:788 JLINK_ReadMemEx(0x2000220C, 0x0001 Bytes, ..., Flags = 0x02000000) -- Read from C cache (1 bytes @ 0x2000220C) - Data: 00  returns 0x01 (0000ms, 1678ms total)
T4118 400:788 JLINK_ReadMemEx(0x2000220D, 0x0001 Bytes, ..., Flags = 0x02000000) -- Read from C cache (1 bytes @ 0x2000220D) - Data: 00  returns 0x01 (0000ms, 1678ms total)
T4118 400:788 JLINK_ReadMemEx(0x2000220E, 0x0001 Bytes, ..., Flags = 0x02000000) -- Read from C cache (1 bytes @ 0x2000220E) - Data: 00  returns 0x01 (0000ms, 1678ms total)
T4118 400:788 JLINK_ReadMemEx(0x2000220F, 0x0001 Bytes, ..., Flags = 0x02000000) -- Read from C cache (1 bytes @ 0x2000220F) - Data: 00  returns 0x01 (0000ms, 1678ms total)
T4118 400:788 JLINK_ReadMemEx(0x20002210, 0x0001 Bytes, ..., Flags = 0x02000000) -- Read from C cache (1 bytes @ 0x20002210) - Data: 00  returns 0x01 (0001ms, 1679ms total)
T4118 400:789 JLINK_ReadMemEx(0x20002211, 0x0001 Bytes, ..., Flags = 0x02000000) -- Read from C cache (1 bytes @ 0x20002211) - Data: 00  returns 0x01 (0000ms, 1679ms total)
T4118 400:789 JLINK_ReadMemEx(0x20002212, 0x0001 Bytes, ..., Flags = 0x02000000) -- Read from C cache (1 bytes @ 0x20002212) - Data: 00  returns 0x01 (0000ms, 1679ms total)
T4118 400:789 JLINK_ReadMemEx(0x20002213, 0x0001 Bytes, ..., Flags = 0x02000000) -- Read from C cache (1 bytes @ 0x20002213) - Data: 00  returns 0x01 (0000ms, 1679ms total)
T4118 400:789 JLINK_ReadMemEx(0x20002214, 0x0001 Bytes, ..., Flags = 0x02000000) -- Read from C cache (1 bytes @ 0x20002214) - Data: 01  returns 0x01 (0000ms, 1679ms total)
T4118 400:789 JLINK_ReadMemEx(0x20002215, 0x0001 Bytes, ..., Flags = 0x02000000) -- Read from C cache (1 bytes @ 0x20002215) - Data: 00  returns 0x01 (0000ms, 1679ms total)
T4118 440:083 JLINK_SetResetType(JLINKARM_CM3_RESET_TYPE_NORMAL)  returns JLINKARM_CM3_RESET_TYPE_NORMAL (0000ms, 1679ms total)
T4118 440:083 JLINK_Reset() -- CPU_WriteMem(4 bytes @ 0xE000EDF0) -- CPU_WriteMem(4 bytes @ 0xE000EDFC)Reset: Halt core after reset via DEMCR.VC_CORERESET. >0x35 TIF>Reset: Reset device via AIRCR.SYSRESETREQ. -- CPU_WriteMem(4 bytes @ 0xE000ED0C) >0x0D TIF> >0x28 TIF> -- CPU_ReadMem(4 bytes @ 0xE000EDF0) -- CPU_ReadMem(4 bytes @ 0xE000EDF0) -- CPU_WriteMem(4 bytes @ 0xE000EDF0) -- CPU_WriteMem(4 bytes @ 0xE000EDFC) -- CPU_ReadMem(4 bytes @ 0xE000EDF0) -- CPU_WriteMem(4 bytes @ 0xE0002000)
 -- CPU_ReadMem(4 bytes @ 0xE000EDFC) -- CPU_ReadMem(4 bytes @ 0xE0001000) (0065ms, 1744ms total)
T4118 440:148 JLINK_ReadReg(R15 (PC))  returns 0x080001A8 (0000ms, 1744ms total)
T4118 440:148 JLINK_ReadReg(XPSR)  returns 0x01000000 (0000ms, 1744ms total)
T4118 440:148 JLINK_ReadMemEx(0x080001A8, 0x003C Bytes, ..., Flags = 0x02000000) -- CPU_ReadMem(128 bytes @ 0x08000180) -- Updating C cache (128 bytes @ 0x08000180) -- Read from C cache (60 bytes @ 0x080001A8) - Data: 09 48 80 47 09 48 00 47 FE E7 FE E7 FE E7 FE E7 ...  returns 0x3C (0001ms, 1745ms total)
T4118 440:234 JLINK_ReadReg(R0)  returns 0x20002194 (0000ms, 1745ms total)
T4118 440:234 JLINK_ReadReg(R1)  returns 0x00000001 (0000ms, 1745ms total)
T4118 440:234 JLINK_ReadReg(R2)  returns 0x40012C00 (0000ms, 1745ms total)
T4118 440:234 JLINK_ReadReg(R3)  returns 0x40012C0C (0000ms, 1745ms total)
T4118 440:234 JLINK_ReadReg(R4)  returns 0x00000000 (0000ms, 1745ms total)
T4118 440:234 JLINK_ReadReg(R5)  returns 0x00000000 (0000ms, 1745ms total)
T4118 440:234 JLINK_ReadReg(R6)  returns 0x00000000 (0000ms, 1745ms total)
T4118 440:234 JLINK_ReadReg(R7)  returns 0x00000000 (0000ms, 1745ms total)
T4118 440:234 JLINK_ReadReg(R8)  returns 0x20001FBC (0000ms, 1745ms total)
T4118 440:234 JLINK_ReadReg(R9)  returns 0x0000C350 (0000ms, 1745ms total)
T4118 440:234 JLINK_ReadReg(R10)  returns 0x000003E8 (0000ms, 1745ms total)
T4118 440:234 JLINK_ReadReg(R11)  returns 0x00000001 (0000ms, 1745ms total)
T4118 440:234 JLINK_ReadReg(R12)  returns 0x9E1B08C0 (0000ms, 1745ms total)
T4118 440:234 JLINK_ReadReg(R13 (SP))  returns 0x20002948 (0000ms, 1745ms total)
T4118 440:234 JLINK_ReadReg(R14)  returns 0xFFFFFFFF (0000ms, 1745ms total)
T4118 440:234 JLINK_ReadReg(R15 (PC))  returns 0x080001A8 (0000ms, 1745ms total)
T4118 440:234 JLINK_ReadReg(XPSR)  returns 0x01000000 (0000ms, 1745ms total)
T4118 440:234 JLINK_ReadReg(MSP)  returns 0x20002948 (0000ms, 1745ms total)
T4118 440:234 JLINK_ReadReg(PSP)  returns 0xAEAA5364 (0000ms, 1745ms total)
T4118 440:234 JLINK_ReadReg(CFBP)  returns 0x00000000 (0000ms, 1745ms total)
T4118 440:234 JLINK_ReadMemEx(0x20000024, 0x0002 Bytes, ..., Flags = 0x02000000) -- CPU_ReadMem(64 bytes @ 0x20000000) -- Updating C cache (64 bytes @ 0x20000000) -- Read from C cache (2 bytes @ 0x20000024) - Data: 02 00  returns 0x02 (0001ms, 1746ms total)
T4118 440:236 JLINK_ReadMemEx(0x20002194, 0x0020 Bytes, ..., Flags = 0x02000000) -- CPU_ReadMem(64 bytes @ 0x20002180) -- Updating C cache (64 bytes @ 0x20002180) -- Read from C cache (32 bytes @ 0x20002194) - Data: 4D 00 00 00 00 00 00 00 00 00 00 00 00 00 00 00 ...  returns 0x20 (0000ms, 1746ms total)
T4118 440:236 JLINK_ReadMemEx(0x200021B4, 0x0001 Bytes, ..., Flags = 0x02000000) -- Read from C cache (1 bytes @ 0x200021B4) - Data: 00  returns 0x01 (0001ms, 1747ms total)
T4118 440:237 JLINK_ReadMemEx(0x200021B5, 0x0001 Bytes, ..., Flags = 0x02000000) -- Read from C cache (1 bytes @ 0x200021B5) - Data: 00  returns 0x01 (0000ms, 1747ms total)
T4118 440:237 JLINK_ReadMemEx(0x200021B6, 0x0001 Bytes, ..., Flags = 0x02000000) -- Read from C cache (1 bytes @ 0x200021B6) - Data: 00  returns 0x01 (0000ms, 1747ms total)
T4118 440:237 JLINK_ReadMemEx(0x200021B7, 0x0001 Bytes, ..., Flags = 0x02000000) -- Read from C cache (1 bytes @ 0x200021B7) - Data: 00  returns 0x01 (0000ms, 1747ms total)
T4118 440:237 JLINK_ReadMemEx(0x200021B8, 0x0001 Bytes, ..., Flags = 0x02000000) -- Read from C cache (1 bytes @ 0x200021B8) - Data: 00  returns 0x01 (0000ms, 1747ms total)
T4118 440:237 JLINK_ReadMemEx(0x200021B9, 0x0001 Bytes, ..., Flags = 0x02000000) -- Read from C cache (1 bytes @ 0x200021B9) - Data: 00  returns 0x01 (0000ms, 1747ms total)
T4118 440:237 JLINK_ReadMemEx(0x200021BA, 0x0001 Bytes, ..., Flags = 0x02000000) -- Read from C cache (1 bytes @ 0x200021BA) - Data: 00  returns 0x01 (0000ms, 1747ms total)
T4118 440:237 JLINK_ReadMemEx(0x200021BB, 0x0001 Bytes, ..., Flags = 0x02000000) -- Read from C cache (1 bytes @ 0x200021BB) - Data: 00  returns 0x01 (0000ms, 1747ms total)
T4118 440:237 JLINK_ReadMemEx(0x200021BC, 0x0001 Bytes, ..., Flags = 0x02000000) -- Read from C cache (1 bytes @ 0x200021BC) - Data: 00  returns 0x01 (0000ms, 1747ms total)
T4118 440:237 JLINK_ReadMemEx(0x200021BD, 0x0001 Bytes, ..., Flags = 0x02000000) -- Read from C cache (1 bytes @ 0x200021BD) - Data: 00  returns 0x01 (0000ms, 1747ms total)
T4118 440:237 JLINK_ReadMemEx(0x200021BE, 0x0001 Bytes, ..., Flags = 0x02000000) -- Read from C cache (1 bytes @ 0x200021BE) - Data: 00  returns 0x01 (0000ms, 1747ms total)
T4118 440:237 JLINK_ReadMemEx(0x200021BF, 0x0001 Bytes, ..., Flags = 0x02000000) -- Read from C cache (1 bytes @ 0x200021BF) - Data: 00  returns 0x01 (0000ms, 1747ms total)
T4118 440:237 JLINK_ReadMemEx(0x200021C0, 0x0001 Bytes, ..., Flags = 0x02000000) -- CPU_ReadMem(64 bytes @ 0x200021C0) -- Updating C cache (64 bytes @ 0x200021C0) -- Read from C cache (1 bytes @ 0x200021C0) - Data: 00  returns 0x01 (0000ms, 1747ms total)
T4118 440:238 JLINK_ReadMemEx(0x200021C1, 0x0001 Bytes, ..., Flags = 0x02000000) -- Read from C cache (1 bytes @ 0x200021C1) - Data: 00  returns 0x01 (0000ms, 1747ms total)
T4118 440:238 JLINK_ReadMemEx(0x200021C2, 0x0001 Bytes, ..., Flags = 0x02000000) -- Read from C cache (1 bytes @ 0x200021C2) - Data: 00  returns 0x01 (0000ms, 1747ms total)
T4118 440:238 JLINK_ReadMemEx(0x200021C3, 0x0001 Bytes, ..., Flags = 0x02000000) -- Read from C cache (1 bytes @ 0x200021C3) - Data: 00  returns 0x01 (0000ms, 1747ms total)
T4118 440:238 JLINK_ReadMemEx(0x200021C4, 0x0001 Bytes, ..., Flags = 0x02000000) -- Read from C cache (1 bytes @ 0x200021C4) - Data: 00  returns 0x01 (0000ms, 1747ms total)
T4118 440:238 JLINK_ReadMemEx(0x200021C5, 0x0001 Bytes, ..., Flags = 0x02000000) -- Read from C cache (1 bytes @ 0x200021C5) - Data: 00  returns 0x01 (0000ms, 1747ms total)
T4118 440:238 JLINK_ReadMemEx(0x200021C6, 0x0001 Bytes, ..., Flags = 0x02000000) -- Read from C cache (1 bytes @ 0x200021C6) - Data: 00  returns 0x01 (0000ms, 1747ms total)
T4118 440:238 JLINK_ReadMemEx(0x200021C7, 0x0001 Bytes, ..., Flags = 0x02000000) -- Read from C cache (1 bytes @ 0x200021C7) - Data: 00  returns 0x01 (0000ms, 1747ms total)
T4118 440:238 JLINK_ReadMemEx(0x200021C8, 0x0001 Bytes, ..., Flags = 0x02000000) -- Read from C cache (1 bytes @ 0x200021C8) - Data: 00  returns 0x01 (0000ms, 1747ms total)
T4118 440:238 JLINK_ReadMemEx(0x200021C9, 0x0001 Bytes, ..., Flags = 0x02000000) -- Read from C cache (1 bytes @ 0x200021C9) - Data: 00  returns 0x01 (0000ms, 1747ms total)
T4118 440:238 JLINK_ReadMemEx(0x200021CA, 0x0001 Bytes, ..., Flags = 0x02000000) -- Read from C cache (1 bytes @ 0x200021CA) - Data: 00  returns 0x01 (0000ms, 1747ms total)
T4118 440:238 JLINK_ReadMemEx(0x200021CB, 0x0001 Bytes, ..., Flags = 0x02000000) -- Read from C cache (1 bytes @ 0x200021CB) - Data: 00  returns 0x01 (0000ms, 1747ms total)
T4118 440:238 JLINK_ReadMemEx(0x200021CC, 0x0001 Bytes, ..., Flags = 0x02000000) -- Read from C cache (1 bytes @ 0x200021CC) - Data: 00  returns 0x01 (0000ms, 1747ms total)
T4118 440:238 JLINK_ReadMemEx(0x200021CD, 0x0001 Bytes, ..., Flags = 0x02000000) -- Read from C cache (1 bytes @ 0x200021CD) - Data: 00  returns 0x01 (0000ms, 1747ms total)
T4118 440:238 JLINK_ReadMemEx(0x200021CE, 0x0001 Bytes, ..., Flags = 0x02000000) -- Read from C cache (1 bytes @ 0x200021CE) - Data: 00  returns 0x01 (0000ms, 1747ms total)
T4118 440:238 JLINK_ReadMemEx(0x200021CF, 0x0001 Bytes, ..., Flags = 0x02000000) -- Read from C cache (1 bytes @ 0x200021CF) - Data: 00  returns 0x01 (0000ms, 1747ms total)
T4118 440:238 JLINK_ReadMemEx(0x200021D0, 0x0001 Bytes, ..., Flags = 0x02000000) -- Read from C cache (1 bytes @ 0x200021D0) - Data: 00  returns 0x01 (0000ms, 1747ms total)
T4118 440:238 JLINK_ReadMemEx(0x200021D1, 0x0001 Bytes, ..., Flags = 0x02000000) -- Read from C cache (1 bytes @ 0x200021D1) - Data: 00  returns 0x01 (0000ms, 1747ms total)
T4118 440:238 JLINK_ReadMemEx(0x200021D2, 0x0001 Bytes, ..., Flags = 0x02000000) -- Read from C cache (1 bytes @ 0x200021D2) - Data: 00  returns 0x01 (0000ms, 1747ms total)
T4118 440:238 JLINK_ReadMemEx(0x200021D3, 0x0001 Bytes, ..., Flags = 0x02000000) -- Read from C cache (1 bytes @ 0x200021D3) - Data: 00  returns 0x01 (0000ms, 1747ms total)
T4118 440:238 JLINK_ReadMemEx(0x200021D4, 0x0001 Bytes, ..., Flags = 0x02000000) -- Read from C cache (1 bytes @ 0x200021D4) - Data: 00  returns 0x01 (0000ms, 1747ms total)
T4118 440:238 JLINK_ReadMemEx(0x200021D5, 0x0001 Bytes, ..., Flags = 0x02000000) -- Read from C cache (1 bytes @ 0x200021D5) - Data: 00  returns 0x01 (0000ms, 1747ms total)
T4118 440:238 JLINK_ReadMemEx(0x200021D6, 0x0001 Bytes, ..., Flags = 0x02000000) -- Read from C cache (1 bytes @ 0x200021D6) - Data: 00  returns 0x01 (0000ms, 1747ms total)
T4118 440:238 JLINK_ReadMemEx(0x200021D7, 0x0001 Bytes, ..., Flags = 0x02000000) -- Read from C cache (1 bytes @ 0x200021D7) - Data: 00  returns 0x01 (0000ms, 1747ms total)
T4118 440:238 JLINK_ReadMemEx(0x200021D8, 0x0001 Bytes, ..., Flags = 0x02000000) -- Read from C cache (1 bytes @ 0x200021D8) - Data: 00  returns 0x01 (0000ms, 1747ms total)
T4118 440:238 JLINK_ReadMemEx(0x200021D9, 0x0001 Bytes, ..., Flags = 0x02000000) -- Read from C cache (1 bytes @ 0x200021D9) - Data: 00  returns 0x01 (0000ms, 1747ms total)
T4118 440:238 JLINK_ReadMemEx(0x200021DA, 0x0001 Bytes, ..., Flags = 0x02000000) -- Read from C cache (1 bytes @ 0x200021DA) - Data: 00  returns 0x01 (0000ms, 1747ms total)
T4118 440:238 JLINK_ReadMemEx(0x200021DB, 0x0001 Bytes, ..., Flags = 0x02000000) -- Read from C cache (1 bytes @ 0x200021DB) - Data: 00  returns 0x01 (0001ms, 1748ms total)
T4118 440:239 JLINK_ReadMemEx(0x200021DC, 0x0001 Bytes, ..., Flags = 0x02000000) -- Read from C cache (1 bytes @ 0x200021DC) - Data: 00  returns 0x01 (0000ms, 1748ms total)
T4118 440:239 JLINK_ReadMemEx(0x200021DD, 0x0001 Bytes, ..., Flags = 0x02000000) -- Read from C cache (1 bytes @ 0x200021DD) - Data: 00  returns 0x01 (0000ms, 1748ms total)
T4118 440:239 JLINK_ReadMemEx(0x200021DE, 0x0001 Bytes, ..., Flags = 0x02000000) -- Read from C cache (1 bytes @ 0x200021DE) - Data: 00  returns 0x01 (0000ms, 1748ms total)
T4118 440:239 JLINK_ReadMemEx(0x200021DF, 0x0001 Bytes, ..., Flags = 0x02000000) -- Read from C cache (1 bytes @ 0x200021DF) - Data: 00  returns 0x01 (0000ms, 1748ms total)
T4118 440:239 JLINK_ReadMemEx(0x200021E0, 0x0001 Bytes, ..., Flags = 0x02000000) -- Read from C cache (1 bytes @ 0x200021E0) - Data: 00  returns 0x01 (0000ms, 1748ms total)
T4118 440:239 JLINK_ReadMemEx(0x200021E1, 0x0001 Bytes, ..., Flags = 0x02000000) -- Read from C cache (1 bytes @ 0x200021E1) - Data: 00  returns 0x01 (0000ms, 1748ms total)
T4118 440:239 JLINK_ReadMemEx(0x200021E2, 0x0001 Bytes, ..., Flags = 0x02000000) -- Read from C cache (1 bytes @ 0x200021E2) - Data: 00  returns 0x01 (0000ms, 1748ms total)
T4118 440:239 JLINK_ReadMemEx(0x200021E3, 0x0001 Bytes, ..., Flags = 0x02000000) -- Read from C cache (1 bytes @ 0x200021E3) - Data: 00  returns 0x01 (0000ms, 1748ms total)
T4118 440:239 JLINK_ReadMemEx(0x200021E4, 0x0001 Bytes, ..., Flags = 0x02000000) -- Read from C cache (1 bytes @ 0x200021E4) - Data: 00  returns 0x01 (0000ms, 1748ms total)
T4118 440:239 JLINK_ReadMemEx(0x200021E5, 0x0001 Bytes, ..., Flags = 0x02000000) -- Read from C cache (1 bytes @ 0x200021E5) - Data: 00  returns 0x01 (0000ms, 1748ms total)
T4118 440:239 JLINK_ReadMemEx(0x200021E6, 0x0001 Bytes, ..., Flags = 0x02000000) -- Read from C cache (1 bytes @ 0x200021E6) - Data: 00  returns 0x01 (0000ms, 1748ms total)
T4118 440:239 JLINK_ReadMemEx(0x200021E7, 0x0001 Bytes, ..., Flags = 0x02000000) -- Read from C cache (1 bytes @ 0x200021E7) - Data: 00  returns 0x01 (0000ms, 1748ms total)
T4118 440:239 JLINK_ReadMemEx(0x200021E8, 0x0001 Bytes, ..., Flags = 0x02000000) -- Read from C cache (1 bytes @ 0x200021E8) - Data: 00  returns 0x01 (0000ms, 1748ms total)
T4118 440:239 JLINK_ReadMemEx(0x200021E9, 0x0001 Bytes, ..., Flags = 0x02000000) -- Read from C cache (1 bytes @ 0x200021E9) - Data: 00  returns 0x01 (0000ms, 1748ms total)
T4118 440:239 JLINK_ReadMemEx(0x200021EA, 0x0001 Bytes, ..., Flags = 0x02000000) -- Read from C cache (1 bytes @ 0x200021EA) - Data: 00  returns 0x01 (0000ms, 1748ms total)
T4118 440:239 JLINK_ReadMemEx(0x200021EB, 0x0001 Bytes, ..., Flags = 0x02000000) -- Read from C cache (1 bytes @ 0x200021EB) - Data: 00  returns 0x01 (0000ms, 1748ms total)
T4118 440:239 JLINK_ReadMemEx(0x200021EC, 0x0001 Bytes, ..., Flags = 0x02000000) -- Read from C cache (1 bytes @ 0x200021EC) - Data: 00  returns 0x01 (0000ms, 1748ms total)
T4118 440:239 JLINK_ReadMemEx(0x200021ED, 0x0001 Bytes, ..., Flags = 0x02000000) -- Read from C cache (1 bytes @ 0x200021ED) - Data: 00  returns 0x01 (0000ms, 1748ms total)
T4118 440:239 JLINK_ReadMemEx(0x200021EE, 0x0001 Bytes, ..., Flags = 0x02000000) -- Read from C cache (1 bytes @ 0x200021EE) - Data: 00  returns 0x01 (0000ms, 1748ms total)
T4118 440:239 JLINK_ReadMemEx(0x200021EF, 0x0001 Bytes, ..., Flags = 0x02000000) -- Read from C cache (1 bytes @ 0x200021EF) - Data: 00  returns 0x01 (0000ms, 1748ms total)
T4118 440:239 JLINK_ReadMemEx(0x200021F0, 0x0001 Bytes, ..., Flags = 0x02000000) -- Read from C cache (1 bytes @ 0x200021F0) - Data: 00  returns 0x01 (0000ms, 1748ms total)
T4118 440:239 JLINK_ReadMemEx(0x200021F1, 0x0001 Bytes, ..., Flags = 0x02000000) -- Read from C cache (1 bytes @ 0x200021F1) - Data: 00  returns 0x01 (0000ms, 1748ms total)
T4118 440:239 JLINK_ReadMemEx(0x200021F2, 0x0001 Bytes, ..., Flags = 0x02000000) -- Read from C cache (1 bytes @ 0x200021F2) - Data: 00  returns 0x01 (0000ms, 1748ms total)
T4118 440:239 JLINK_ReadMemEx(0x200021F3, 0x0001 Bytes, ..., Flags = 0x02000000) -- Read from C cache (1 bytes @ 0x200021F3) - Data: 00  returns 0x01 (0000ms, 1748ms total)
T4118 440:239 JLINK_ReadMemEx(0x200021F4, 0x0001 Bytes, ..., Flags = 0x02000000) -- Read from C cache (1 bytes @ 0x200021F4) - Data: 00  returns 0x01 (0000ms, 1748ms total)
T4118 440:239 JLINK_ReadMemEx(0x200021F5, 0x0001 Bytes, ..., Flags = 0x02000000) -- Read from C cache (1 bytes @ 0x200021F5) - Data: 00  returns 0x01 (0000ms, 1748ms total)
T4118 440:240 JLINK_ReadMemEx(0x200021F6, 0x0001 Bytes, ..., Flags = 0x02000000) -- Read from C cache (1 bytes @ 0x200021F6) - Data: 00  returns 0x01 (0000ms, 1749ms total)
T4118 440:240 JLINK_ReadMemEx(0x200021F7, 0x0001 Bytes, ..., Flags = 0x02000000) -- Read from C cache (1 bytes @ 0x200021F7) - Data: 00  returns 0x01 (0000ms, 1749ms total)
T4118 440:240 JLINK_ReadMemEx(0x200021F8, 0x0001 Bytes, ..., Flags = 0x02000000) -- Read from C cache (1 bytes @ 0x200021F8) - Data: 00  returns 0x01 (0000ms, 1749ms total)
T4118 440:240 JLINK_ReadMemEx(0x200021F9, 0x0001 Bytes, ..., Flags = 0x02000000) -- Read from C cache (1 bytes @ 0x200021F9) - Data: 00  returns 0x01 (0000ms, 1749ms total)
T4118 440:240 JLINK_ReadMemEx(0x200021FA, 0x0001 Bytes, ..., Flags = 0x02000000) -- Read from C cache (1 bytes @ 0x200021FA) - Data: 00  returns 0x01 (0000ms, 1749ms total)
T4118 440:240 JLINK_ReadMemEx(0x200021FB, 0x0001 Bytes, ..., Flags = 0x02000000) -- Read from C cache (1 bytes @ 0x200021FB) - Data: 00  returns 0x01 (0000ms, 1749ms total)
T4118 440:240 JLINK_ReadMemEx(0x200021FC, 0x0001 Bytes, ..., Flags = 0x02000000) -- Read from C cache (1 bytes @ 0x200021FC) - Data: 00  returns 0x01 (0000ms, 1749ms total)
T4118 440:240 JLINK_ReadMemEx(0x200021FD, 0x0001 Bytes, ..., Flags = 0x02000000) -- Read from C cache (1 bytes @ 0x200021FD) - Data: 00  returns 0x01 (0000ms, 1749ms total)
T4118 440:240 JLINK_ReadMemEx(0x200021FE, 0x0001 Bytes, ..., Flags = 0x02000000) -- Read from C cache (1 bytes @ 0x200021FE) - Data: 00  returns 0x01 (0000ms, 1749ms total)
T4118 440:240 JLINK_ReadMemEx(0x200021FF, 0x0001 Bytes, ..., Flags = 0x02000000) -- Read from C cache (1 bytes @ 0x200021FF) - Data: 00  returns 0x01 (0000ms, 1749ms total)
T4118 440:240 JLINK_ReadMemEx(0x20002200, 0x0001 Bytes, ..., Flags = 0x02000000) -- CPU_ReadMem(64 bytes @ 0x20002200) -- Updating C cache (64 bytes @ 0x20002200) -- Read from C cache (1 bytes @ 0x20002200) - Data: 00  returns 0x01 (0001ms, 1750ms total)
T4118 440:241 JLINK_ReadMemEx(0x20002201, 0x0001 Bytes, ..., Flags = 0x02000000) -- Read from C cache (1 bytes @ 0x20002201) - Data: 00  returns 0x01 (0000ms, 1750ms total)
T4118 440:241 JLINK_ReadMemEx(0x20002202, 0x0001 Bytes, ..., Flags = 0x02000000) -- Read from C cache (1 bytes @ 0x20002202) - Data: 00  returns 0x01 (0000ms, 1750ms total)
T4118 440:241 JLINK_ReadMemEx(0x20002203, 0x0001 Bytes, ..., Flags = 0x02000000) -- Read from C cache (1 bytes @ 0x20002203) - Data: 00  returns 0x01 (0000ms, 1750ms total)
T4118 440:241 JLINK_ReadMemEx(0x20002204, 0x0001 Bytes, ..., Flags = 0x02000000) -- Read from C cache (1 bytes @ 0x20002204) - Data: 00  returns 0x01 (0000ms, 1750ms total)
T4118 440:241 JLINK_ReadMemEx(0x20002205, 0x0001 Bytes, ..., Flags = 0x02000000) -- Read from C cache (1 bytes @ 0x20002205) - Data: 00  returns 0x01 (0000ms, 1750ms total)
T4118 440:241 JLINK_ReadMemEx(0x20002206, 0x0001 Bytes, ..., Flags = 0x02000000) -- Read from C cache (1 bytes @ 0x20002206) - Data: 00  returns 0x01 (0000ms, 1750ms total)
T4118 440:241 JLINK_ReadMemEx(0x20002207, 0x0001 Bytes, ..., Flags = 0x02000000) -- Read from C cache (1 bytes @ 0x20002207) - Data: 00  returns 0x01 (0000ms, 1750ms total)
T4118 440:241 JLINK_ReadMemEx(0x20002208, 0x0001 Bytes, ..., Flags = 0x02000000) -- Read from C cache (1 bytes @ 0x20002208) - Data: 00  returns 0x01 (0000ms, 1750ms total)
T4118 440:241 JLINK_ReadMemEx(0x20002209, 0x0001 Bytes, ..., Flags = 0x02000000) -- Read from C cache (1 bytes @ 0x20002209) - Data: 00  returns 0x01 (0000ms, 1750ms total)
T4118 440:241 JLINK_ReadMemEx(0x2000220A, 0x0001 Bytes, ..., Flags = 0x02000000) -- Read from C cache (1 bytes @ 0x2000220A) - Data: 00  returns 0x01 (0000ms, 1750ms total)
T4118 440:241 JLINK_ReadMemEx(0x2000220B, 0x0001 Bytes, ..., Flags = 0x02000000) -- Read from C cache (1 bytes @ 0x2000220B) - Data: 00  returns 0x01 (0000ms, 1750ms total)
T4118 440:241 JLINK_ReadMemEx(0x2000220C, 0x0001 Bytes, ..., Flags = 0x02000000) -- Read from C cache (1 bytes @ 0x2000220C) - Data: 00  returns 0x01 (0000ms, 1750ms total)
T4118 440:241 JLINK_ReadMemEx(0x2000220D, 0x0001 Bytes, ..., Flags = 0x02000000) -- Read from C cache (1 bytes @ 0x2000220D) - Data: 00  returns 0x01 (0000ms, 1750ms total)
T4118 440:241 JLINK_ReadMemEx(0x2000220E, 0x0001 Bytes, ..., Flags = 0x02000000) -- Read from C cache (1 bytes @ 0x2000220E) - Data: 00  returns 0x01 (0000ms, 1750ms total)
T4118 440:241 JLINK_ReadMemEx(0x2000220F, 0x0001 Bytes, ..., Flags = 0x02000000) -- Read from C cache (1 bytes @ 0x2000220F) - Data: 00  returns 0x01 (0000ms, 1750ms total)
T4118 440:241 JLINK_ReadMemEx(0x20002210, 0x0001 Bytes, ..., Flags = 0x02000000) -- Read from C cache (1 bytes @ 0x20002210) - Data: 00  returns 0x01 (0000ms, 1750ms total)
T4118 440:241 JLINK_ReadMemEx(0x20002211, 0x0001 Bytes, ..., Flags = 0x02000000) -- Read from C cache (1 bytes @ 0x20002211) - Data: 00  returns 0x01 (0000ms, 1750ms total)
T4118 440:241 JLINK_ReadMemEx(0x20002212, 0x0001 Bytes, ..., Flags = 0x02000000) -- Read from C cache (1 bytes @ 0x20002212) - Data: 00  returns 0x01 (0000ms, 1750ms total)
T4118 440:241 JLINK_ReadMemEx(0x20002213, 0x0001 Bytes, ..., Flags = 0x02000000) -- Read from C cache (1 bytes @ 0x20002213) - Data: 00  returns 0x01 (0000ms, 1750ms total)
T4118 440:241 JLINK_ReadMemEx(0x20002214, 0x0001 Bytes, ..., Flags = 0x02000000) -- Read from C cache (1 bytes @ 0x20002214) - Data: 01  returns 0x01 (0000ms, 1750ms total)
T4118 440:241 JLINK_ReadMemEx(0x20002215, 0x0001 Bytes, ..., Flags = 0x02000000) -- Read from C cache (1 bytes @ 0x20002215) - Data: 00  returns 0x01 (0001ms, 1751ms total)
T2470 440:531 JLINK_ReadMemEx(0x080001A8, 0x0002 Bytes, ..., Flags = 0x02000000) -- Read from C cache (2 bytes @ 0x080001A8) - Data: 09 48  returns 0x02 (0000ms, 1751ms total)
T2470 440:531 JLINK_SetBPEx(Addr = 0x0800215E, Type = 0xFFFFFFF2)  returns 0x0000000F (0000ms, 1751ms total)
T2470 440:531 JLINK_SetBPEx(Addr = 0x08002164, Type = 0xFFFFFFF2)  returns 0x00000010 (0000ms, 1751ms total)
T2470 440:531 JLINK_SetBPEx(Addr = 0x0800456A, Type = 0xFFFFFFF2)  returns 0x00000011 (0000ms, 1751ms total)
T2470 440:531 JLINK_Go() -- CPU_WriteMem(4 bytes @ 0xE0002000) -- CPU_WriteMem(4 bytes @ 0xE0002000) -- CPU_WriteMem(4 bytes @ 0xE0002000) -- CPU_ReadMem(4 bytes @ 0xE0001000) -- CPU_WriteMem(4 bytes @ 0xE0002008) -- CPU_WriteMem(4 bytes @ 0xE000200C) -- CPU_WriteMem(4 bytes @ 0xE0002010) -- CPU_WriteMem(4 bytes @ 0xE0002014) -- CPU_WriteMem(4 bytes @ 0xE0002018) -- CPU_WriteMem(4 bytes @ 0xE000201C) -- CPU_WriteMem(4 bytes @ 0xE0001004) (0002ms, 1753ms total)
T2470 440:635 JLINK_IsHalted()  returns FALSE (0000ms, 1753ms total)
T2470 440:737 JLINK_IsHalted()  returns FALSE (0000ms, 1753ms total)
T2470 440:838 JLINK_IsHalted()  returns FALSE (0000ms, 1753ms total)
T2470 440:938 JLINK_IsHalted()  returns FALSE (0000ms, 1753ms total)
T2470 441:039 JLINK_IsHalted()  returns FALSE (0000ms, 1753ms total)
T2470 441:140 JLINK_IsHalted()  returns FALSE (0000ms, 1753ms total)
T2470 441:241 JLINK_IsHalted()  returns FALSE (0000ms, 1753ms total)
T2470 441:341 JLINK_IsHalted()  returns FALSE (0000ms, 1753ms total)
T2470 441:442 JLINK_IsHalted()  returns FALSE (0000ms, 1753ms total)
T2470 441:543 JLINK_IsHalted()  returns FALSE (0000ms, 1753ms total)
T2470 441:644 JLINK_IsHalted()  returns FALSE (0000ms, 1753ms total)
T2470 441:744 JLINK_IsHalted()  returns FALSE (0000ms, 1753ms total)
T2470 441:845 JLINK_IsHalted()  returns FALSE (0000ms, 1753ms total)
T2470 441:946 JLINK_IsHalted()  returns FALSE (0000ms, 1753ms total)
T2470 442:047 JLINK_IsHalted()  returns FALSE (0000ms, 1753ms total)
T2470 442:147 JLINK_IsHalted()  returns FALSE (0001ms, 1754ms total)
T2470 442:249 JLINK_IsHalted()  returns FALSE (0000ms, 1753ms total)
T2470 442:350 JLINK_IsHalted()  returns FALSE (0000ms, 1753ms total)
T2470 442:450 JLINK_IsHalted()  returns FALSE (0000ms, 1753ms total)
T2470 442:551 JLINK_IsHalted()  returns FALSE (0000ms, 1753ms total)
T2470 442:653 JLINK_IsHalted()  returns FALSE (0000ms, 1753ms total)
T2470 442:754 JLINK_IsHalted()  returns FALSE (0000ms, 1753ms total)
T2470 442:854 JLINK_IsHalted()  returns FALSE (0000ms, 1753ms total)
T2470 442:955 JLINK_IsHalted()  returns FALSE (0000ms, 1753ms total)
T2470 443:056 JLINK_IsHalted()  returns FALSE (0000ms, 1753ms total)
T2470 443:156 JLINK_IsHalted()  returns FALSE (0000ms, 1753ms total)
T2470 443:257 JLINK_IsHalted()  returns FALSE (0000ms, 1753ms total)
T2470 443:358 JLINK_IsHalted()  returns FALSE (0000ms, 1753ms total)
T2470 443:459 JLINK_IsHalted()  returns FALSE (0000ms, 1753ms total)
T2470 443:559 JLINK_IsHalted()  returns FALSE (0000ms, 1753ms total)
T2470 443:660 JLINK_IsHalted()  returns FALSE (0000ms, 1753ms total)
T2470 443:761 JLINK_IsHalted()  returns FALSE (0000ms, 1753ms total)
T2470 443:862 JLINK_IsHalted()  returns FALSE (0000ms, 1753ms total)
T2470 443:962 JLINK_IsHalted()  returns FALSE (0000ms, 1753ms total)
T2470 444:063 JLINK_IsHalted()  returns FALSE (0000ms, 1753ms total)
T2470 444:164 JLINK_IsHalted()  returns FALSE (0000ms, 1753ms total)
T2470 444:265 JLINK_IsHalted()  returns FALSE (0000ms, 1753ms total)
T2470 444:365 JLINK_IsHalted()  returns FALSE (0000ms, 1753ms total)
T2470 444:466 JLINK_IsHalted()  returns FALSE (0000ms, 1753ms total)
T2470 444:567 JLINK_IsHalted()  returns FALSE (0000ms, 1753ms total)
T2470 444:667 JLINK_IsHalted()  returns FALSE (0000ms, 1753ms total)
T2470 444:768 JLINK_IsHalted()  returns FALSE (0000ms, 1753ms total)
T2470 444:869 JLINK_IsHalted()  returns FALSE (0000ms, 1753ms total)
T2470 444:970 JLINK_IsHalted()  returns FALSE (0000ms, 1753ms total)
T2470 445:070 JLINK_IsHalted()  returns FALSE (0000ms, 1753ms total)
T2470 445:171 JLINK_IsHalted()  returns FALSE (0000ms, 1753ms total)
T2470 445:272 JLINK_IsHalted()  returns FALSE (0000ms, 1753ms total)
T2470 445:373 JLINK_IsHalted()  returns FALSE (0000ms, 1753ms total)
T2470 445:473 JLINK_IsHalted()  returns FALSE (0000ms, 1753ms total)
T2470 445:574 JLINK_IsHalted()  returns FALSE (0000ms, 1753ms total)
T2470 445:675 JLINK_IsHalted()  returns FALSE (0000ms, 1753ms total)
T2470 445:775 JLINK_IsHalted()  returns FALSE (0000ms, 1753ms total)
T2470 445:876 JLINK_IsHalted()  returns FALSE (0000ms, 1753ms total)
T2470 445:977 JLINK_IsHalted()  returns FALSE (0000ms, 1753ms total)
T2470 446:078 JLINK_IsHalted()  returns FALSE (0000ms, 1753ms total)
T2470 446:178 JLINK_IsHalted()  returns FALSE (0000ms, 1753ms total)
T2470 446:279 JLINK_IsHalted()  returns FALSE (0000ms, 1753ms total)
T2470 446:380 JLINK_IsHalted()  returns FALSE (0000ms, 1753ms total)
T2470 446:481 JLINK_IsHalted()  returns FALSE (0000ms, 1753ms total)
T2470 446:581 JLINK_IsHalted()  returns FALSE (0000ms, 1753ms total)
T2470 446:682 JLINK_IsHalted()  returns FALSE (0000ms, 1753ms total)
T2470 446:783 JLINK_IsHalted()  returns FALSE (0000ms, 1753ms total)
T2470 446:884 JLINK_IsHalted()  returns FALSE (0000ms, 1753ms total)
T2470 446:984 JLINK_IsHalted()  returns FALSE (0000ms, 1753ms total)
T2470 447:085 JLINK_IsHalted()  returns FALSE (0000ms, 1753ms total)
T2470 447:186 JLINK_IsHalted()  returns FALSE (0000ms, 1753ms total)
T2470 447:287 JLINK_IsHalted()  returns FALSE (0000ms, 1753ms total)
T2470 447:387 JLINK_IsHalted()  returns FALSE (0000ms, 1753ms total)
T2470 447:488 JLINK_IsHalted()  returns FALSE (0000ms, 1753ms total)
T2470 447:590 JLINK_IsHalted()  returns FALSE (0000ms, 1753ms total)
T2470 447:691 JLINK_IsHalted()  returns FALSE (0000ms, 1753ms total)
T2470 447:791 JLINK_IsHalted()  returns FALSE (0000ms, 1753ms total)
T2470 447:892 JLINK_IsHalted()  returns FALSE (0000ms, 1753ms total)
T2470 447:993 JLINK_IsHalted()  returns FALSE (0000ms, 1753ms total)
T2470 448:093 JLINK_IsHalted()  returns FALSE (0000ms, 1753ms total)
T2470 448:194 JLINK_IsHalted()  returns FALSE (0000ms, 1753ms total)
T2470 448:295 JLINK_IsHalted()  returns FALSE (0000ms, 1753ms total)
T2470 448:396 JLINK_IsHalted()  returns FALSE (0000ms, 1753ms total)
T2470 448:496 JLINK_IsHalted()  returns FALSE (0000ms, 1753ms total)
T2470 448:597 JLINK_IsHalted()  returns FALSE (0000ms, 1753ms total)
T2470 448:698 JLINK_IsHalted()  returns FALSE (0000ms, 1753ms total)
T2470 448:799 JLINK_IsHalted()  returns FALSE (0000ms, 1753ms total)
T2470 448:899 JLINK_IsHalted()  returns FALSE (0000ms, 1753ms total)
T2470 449:000 JLINK_IsHalted()  returns FALSE (0000ms, 1753ms total)
T2470 449:102 JLINK_IsHalted()  returns FALSE (0000ms, 1753ms total)
T2470 449:202 JLINK_IsHalted()  returns FALSE (0000ms, 1753ms total)
T2470 449:304 JLINK_IsHalted()  returns FALSE (0000ms, 1753ms total)
T2470 449:405 JLINK_IsHalted()  returns FALSE (0000ms, 1753ms total)
T2470 449:506 JLINK_IsHalted()  returns FALSE (0000ms, 1753ms total)
T2470 449:606 JLINK_IsHalted()  returns FALSE (0000ms, 1753ms total)
T2470 449:708 JLINK_IsHalted()  returns FALSE (0000ms, 1753ms total)
T2470 449:809 JLINK_IsHalted()  returns FALSE (0000ms, 1753ms total)
T2470 449:909 JLINK_IsHalted()  returns FALSE (0000ms, 1753ms total)
T2470 450:010 JLINK_IsHalted()  returns FALSE (0000ms, 1753ms total)
T2470 450:111 JLINK_IsHalted()  returns FALSE (0000ms, 1753ms total)
T2470 450:212 JLINK_IsHalted()  returns FALSE (0000ms, 1753ms total)
T2470 450:313 JLINK_IsHalted()  returns FALSE (0000ms, 1753ms total)
T2470 450:414 JLINK_IsHalted()  returns FALSE (0000ms, 1753ms total)
T2470 450:515 JLINK_IsHalted()  returns FALSE (0000ms, 1753ms total)
T2470 450:617 JLINK_IsHalted()  returns FALSE (0000ms, 1753ms total)
T2470 450:717 JLINK_IsHalted()  returns FALSE (0000ms, 1753ms total)
T2470 450:818 JLINK_IsHalted()  returns FALSE (0000ms, 1753ms total)
T2470 450:919 JLINK_IsHalted()  returns FALSE (0000ms, 1753ms total)
T2470 451:019 JLINK_IsHalted()  returns FALSE (0000ms, 1753ms total)
T2470 451:120 JLINK_IsHalted()  returns FALSE (0000ms, 1753ms total)
T2470 451:221 JLINK_IsHalted()  returns FALSE (0000ms, 1753ms total)
T2470 451:322 JLINK_IsHalted()  returns FALSE (0000ms, 1753ms total)
T2470 451:423 JLINK_IsHalted()  returns FALSE (0000ms, 1753ms total)
T2470 451:524 JLINK_IsHalted()  returns FALSE (0000ms, 1753ms total)
T2470 451:625 JLINK_IsHalted()  returns FALSE (0000ms, 1753ms total)
T2470 451:726 JLINK_IsHalted()  returns FALSE (0000ms, 1753ms total)
T2470 451:826 JLINK_IsHalted()  returns FALSE (0000ms, 1753ms total)
T2470 451:927 JLINK_IsHalted()  returns FALSE (0000ms, 1753ms total)
T2470 452:029 JLINK_IsHalted()  returns FALSE (0000ms, 1753ms total)
T2470 452:130 JLINK_IsHalted()  returns FALSE (0000ms, 1753ms total)
T2470 452:230 JLINK_IsHalted()  returns FALSE (0000ms, 1753ms total)
T2470 452:332 JLINK_IsHalted()  returns FALSE (0000ms, 1753ms total)
T2470 452:433 JLINK_IsHalted()  returns FALSE (0000ms, 1753ms total)
T2470 452:534 JLINK_IsHalted()  returns FALSE (0000ms, 1753ms total)
T2470 452:635 JLINK_IsHalted()  returns FALSE (0000ms, 1753ms total)
T2470 452:736 JLINK_IsHalted()  returns FALSE (0000ms, 1753ms total)
T2470 452:838 JLINK_IsHalted()  returns FALSE (0000ms, 1753ms total)
T2470 452:939 JLINK_IsHalted()  returns FALSE (0000ms, 1753ms total)
T2470 453:040 JLINK_IsHalted()  returns FALSE (0000ms, 1753ms total)
T2470 453:141 JLINK_IsHalted()  returns FALSE (0000ms, 1753ms total)
T2470 453:242 JLINK_IsHalted()  returns FALSE (0000ms, 1753ms total)
T2470 453:342 JLINK_IsHalted()  returns FALSE (0000ms, 1753ms total)
T2470 453:443 JLINK_IsHalted()  returns FALSE (0000ms, 1753ms total)
T2470 453:544 JLINK_IsHalted()  returns FALSE (0000ms, 1753ms total)
T2470 453:645 JLINK_IsHalted()  returns FALSE (0000ms, 1753ms total)
T2470 453:746 JLINK_IsHalted()  returns FALSE (0000ms, 1753ms total)
T2470 453:847 JLINK_IsHalted()  returns FALSE (0000ms, 1753ms total)
T2470 453:948 JLINK_IsHalted()  returns FALSE (0000ms, 1753ms total)
T2470 454:049 JLINK_IsHalted()  returns FALSE (0000ms, 1753ms total)
T2470 454:150 JLINK_IsHalted()  returns FALSE (0000ms, 1753ms total)
T2470 454:251 JLINK_IsHalted()  returns FALSE (0000ms, 1753ms total)
T2470 454:353 JLINK_IsHalted()  returns FALSE (0000ms, 1753ms total)
T2470 454:453 JLINK_IsHalted()  returns FALSE (0000ms, 1753ms total)
T2470 454:555 JLINK_IsHalted()  returns FALSE (0000ms, 1753ms total)
T2470 454:656 JLINK_IsHalted()  returns FALSE (0000ms, 1753ms total)
T2470 454:756 JLINK_IsHalted()  returns FALSE (0000ms, 1753ms total)
T2470 454:857 JLINK_IsHalted()  returns FALSE (0000ms, 1753ms total)
T2470 454:958 JLINK_IsHalted()  returns FALSE (0000ms, 1753ms total)
T2470 455:059 JLINK_IsHalted()  returns FALSE (0000ms, 1753ms total)
T2470 455:160 JLINK_IsHalted()  returns FALSE (0000ms, 1753ms total)
T2470 455:261 JLINK_IsHalted()  returns FALSE (0000ms, 1753ms total)
T2470 455:362 JLINK_IsHalted()  returns FALSE (0000ms, 1753ms total)
T2470 455:463 JLINK_IsHalted()  returns FALSE (0000ms, 1753ms total)
T2470 455:564 JLINK_IsHalted()  returns FALSE (0000ms, 1753ms total)
T2470 455:665 JLINK_IsHalted()  returns FALSE (0000ms, 1753ms total)
T2470 455:766 JLINK_IsHalted()  returns FALSE (0000ms, 1753ms total)
T2470 455:868 JLINK_IsHalted()  returns FALSE (0000ms, 1753ms total)
T2470 455:968 JLINK_IsHalted()  returns FALSE (0000ms, 1753ms total)
T2470 456:069 JLINK_IsHalted()  returns FALSE (0000ms, 1753ms total)
T2470 456:170 JLINK_IsHalted()  returns FALSE (0000ms, 1753ms total)
T2470 456:271 JLINK_IsHalted()  returns FALSE (0000ms, 1753ms total)
T2470 456:372 JLINK_IsHalted()  returns FALSE (0000ms, 1753ms total)
T2470 456:473 JLINK_IsHalted()  returns FALSE (0000ms, 1753ms total)
T2470 456:574 JLINK_IsHalted()  returns FALSE (0000ms, 1753ms total)
T2470 456:674 JLINK_IsHalted()  returns FALSE (0000ms, 1753ms total)
T2470 456:775 JLINK_IsHalted()  returns FALSE (0000ms, 1753ms total)
T2470 456:876 JLINK_IsHalted()  returns FALSE (0000ms, 1753ms total)
T2470 456:977 JLINK_IsHalted()  returns FALSE (0000ms, 1753ms total)
T2470 457:077 JLINK_IsHalted()  returns FALSE (0000ms, 1753ms total)
T2470 457:178 JLINK_IsHalted()  returns FALSE (0000ms, 1753ms total)
T2470 457:279 JLINK_IsHalted()  returns FALSE (0000ms, 1753ms total)
T2470 457:380 JLINK_IsHalted()  returns FALSE (0000ms, 1753ms total)
T2470 457:481 JLINK_IsHalted()  returns FALSE (0000ms, 1753ms total)
T2470 457:582 JLINK_IsHalted()  returns FALSE (0000ms, 1753ms total)
T2470 457:684 JLINK_IsHalted()  returns FALSE (0000ms, 1753ms total)
T2470 457:784 JLINK_IsHalted()  returns FALSE (0000ms, 1753ms total)
T2470 457:886 JLINK_IsHalted()  returns FALSE (0000ms, 1753ms total)
T2470 457:987 JLINK_IsHalted()  returns FALSE (0000ms, 1753ms total)
T2470 458:089 JLINK_IsHalted()  returns FALSE (0000ms, 1753ms total)
T2470 458:189 JLINK_IsHalted()  returns FALSE (0000ms, 1753ms total)
T2470 458:290 JLINK_IsHalted()  returns FALSE (0000ms, 1753ms total)
T2470 458:392 JLINK_IsHalted()  returns FALSE (0000ms, 1753ms total)
T2470 458:493 JLINK_IsHalted()  returns FALSE (0000ms, 1753ms total)
T2470 458:594 JLINK_IsHalted()  returns FALSE (0000ms, 1753ms total)
T2470 458:695 JLINK_IsHalted()  returns FALSE (0000ms, 1753ms total)
T2470 458:796 JLINK_IsHalted()  returns FALSE (0000ms, 1753ms total)
T2470 458:897 JLINK_IsHalted()  returns FALSE (0000ms, 1753ms total)
T2470 458:997 JLINK_IsHalted()  returns FALSE (0000ms, 1753ms total)
T2470 459:099 JLINK_IsHalted()  returns FALSE (0000ms, 1753ms total)
T2470 459:200 JLINK_IsHalted()  returns FALSE (0000ms, 1753ms total)
T2470 459:300 JLINK_IsHalted()  returns FALSE (0000ms, 1753ms total)
T2470 459:401 JLINK_IsHalted()  returns FALSE (0000ms, 1753ms total)
T2470 459:502 JLINK_IsHalted()  returns FALSE (0000ms, 1753ms total)
T2470 459:603 JLINK_IsHalted()  returns FALSE (0000ms, 1753ms total)
T2470 459:703 JLINK_IsHalted()  returns FALSE (0000ms, 1753ms total)
T2470 459:805 JLINK_IsHalted()  returns FALSE (0000ms, 1753ms total)
T2470 459:906 JLINK_IsHalted()  returns FALSE (0000ms, 1753ms total)
T2470 460:007 JLINK_IsHalted()  returns FALSE (0000ms, 1753ms total)
T2470 460:107 JLINK_IsHalted()  returns FALSE (0000ms, 1753ms total)
T2470 460:209 JLINK_IsHalted()  returns FALSE (0000ms, 1753ms total)
T2470 460:310 JLINK_IsHalted()  returns FALSE (0000ms, 1753ms total)
T2470 460:411 JLINK_IsHalted()  returns FALSE (0000ms, 1753ms total)
T2470 460:512 JLINK_IsHalted()  returns FALSE (0000ms, 1753ms total)
T2470 460:613 JLINK_IsHalted()  returns FALSE (0000ms, 1753ms total)
T2470 460:714 JLINK_IsHalted()  returns FALSE (0000ms, 1753ms total)
T2470 460:814 JLINK_IsHalted()  returns FALSE (0000ms, 1753ms total)
T2470 460:916 JLINK_IsHalted()  returns FALSE (0000ms, 1753ms total)
T2470 461:017 JLINK_IsHalted()  returns FALSE (0000ms, 1753ms total)
T2470 461:118 JLINK_IsHalted()  returns FALSE (0000ms, 1753ms total)
T2470 461:218 JLINK_IsHalted()  returns FALSE (0000ms, 1753ms total)
T2470 461:320 JLINK_IsHalted()  returns FALSE (0000ms, 1753ms total)
T2470 461:421 JLINK_IsHalted()  returns FALSE (0000ms, 1753ms total)
T2470 461:522 JLINK_IsHalted()  returns FALSE (0000ms, 1753ms total)
T2470 461:623 JLINK_IsHalted()  returns FALSE (0000ms, 1753ms total)
T2470 461:724 JLINK_IsHalted()  returns FALSE (0000ms, 1753ms total)
T2470 461:825 JLINK_IsHalted()  returns FALSE (0000ms, 1753ms total)
T2470 461:925 JLINK_IsHalted()  returns FALSE (0000ms, 1753ms total)
T2470 462:026 JLINK_IsHalted()  returns FALSE (0000ms, 1753ms total)
T2470 462:128 JLINK_IsHalted()  returns FALSE (0000ms, 1753ms total)
T2470 462:229 JLINK_IsHalted()  returns FALSE (0000ms, 1753ms total)
T2470 462:329 JLINK_IsHalted()  returns FALSE (0000ms, 1753ms total)
T2470 462:431 JLINK_IsHalted()  returns FALSE (0000ms, 1753ms total)
T2470 462:532 JLINK_IsHalted()  returns FALSE (0000ms, 1753ms total)
T2470 462:633 JLINK_IsHalted()  returns FALSE (0000ms, 1753ms total)
T2470 462:734 JLINK_IsHalted()  returns FALSE (0000ms, 1753ms total)
T2470 462:836 JLINK_IsHalted()  returns FALSE (0000ms, 1753ms total)
T2470 462:937 JLINK_IsHalted()  returns FALSE (0000ms, 1753ms total)
T2470 463:037 JLINK_IsHalted()  returns FALSE (0000ms, 1753ms total)
T2470 463:138 JLINK_IsHalted()  returns FALSE (0000ms, 1753ms total)
T2470 463:239 JLINK_IsHalted()  returns FALSE (0000ms, 1753ms total)
T2470 463:340 JLINK_IsHalted()  returns FALSE (0000ms, 1753ms total)
T2470 463:440 JLINK_IsHalted()  returns FALSE (0000ms, 1753ms total)
T2470 463:542 JLINK_IsHalted()  returns FALSE (0000ms, 1753ms total)
T2470 463:644 JLINK_IsHalted()  returns FALSE (0000ms, 1753ms total)
T2470 463:744 JLINK_IsHalted()  returns FALSE (0000ms, 1753ms total)
T2470 463:845 JLINK_IsHalted()  returns FALSE (0000ms, 1753ms total)
T2470 463:946 JLINK_IsHalted()  returns FALSE (0000ms, 1753ms total)
T2470 464:047 JLINK_IsHalted()  returns FALSE (0000ms, 1753ms total)
T2470 464:148 JLINK_IsHalted()  returns FALSE (0000ms, 1753ms total)
T2470 464:249 JLINK_IsHalted()  returns FALSE (0000ms, 1753ms total)
T2470 464:350 JLINK_IsHalted()  returns FALSE (0000ms, 1753ms total)
T2470 464:451 JLINK_IsHalted()  returns FALSE (0000ms, 1753ms total)
T2470 464:551 JLINK_IsHalted()  returns FALSE (0000ms, 1753ms total)
T2470 464:652 JLINK_IsHalted()  returns FALSE (0000ms, 1753ms total)
T2470 464:753 JLINK_IsHalted()  returns FALSE (0000ms, 1753ms total)
T2470 464:854 JLINK_IsHalted()  returns FALSE (0000ms, 1753ms total)
T2470 464:954 JLINK_IsHalted()  returns FALSE (0000ms, 1753ms total)
T2470 465:055 JLINK_IsHalted()  returns FALSE (0000ms, 1753ms total)
T2470 465:157 JLINK_IsHalted()  returns FALSE (0000ms, 1753ms total)
T2470 465:257 JLINK_IsHalted()  returns FALSE (0000ms, 1753ms total)
T2470 465:358 JLINK_IsHalted()  returns FALSE (0000ms, 1753ms total)
T2470 465:460 JLINK_IsHalted()  returns FALSE (0000ms, 1753ms total)
T2470 465:561 JLINK_IsHalted()  returns FALSE (0000ms, 1753ms total)
T2470 465:661 JLINK_IsHalted()  returns FALSE (0000ms, 1753ms total)
T2470 465:762 JLINK_IsHalted()  returns FALSE (0000ms, 1753ms total)
T2470 465:863 JLINK_IsHalted()  returns FALSE (0000ms, 1753ms total)
T2470 465:964 JLINK_IsHalted()  returns FALSE (0000ms, 1753ms total)
T2470 466:064 JLINK_IsHalted()  returns FALSE (0000ms, 1753ms total)
T2470 466:166 JLINK_IsHalted()  returns FALSE (0000ms, 1753ms total)
T2470 466:267 JLINK_IsHalted()  returns FALSE (0000ms, 1753ms total)
T2470 466:368 JLINK_IsHalted()  returns FALSE (0000ms, 1753ms total)
T2470 466:468 JLINK_IsHalted()  returns FALSE (0000ms, 1753ms total)
T2470 466:569 JLINK_IsHalted()  returns FALSE (0000ms, 1753ms total)
T2470 466:670 JLINK_IsHalted()  returns FALSE (0000ms, 1753ms total)
T2470 466:771 JLINK_IsHalted()  returns FALSE (0000ms, 1753ms total)
T2470 466:872 JLINK_IsHalted()  returns FALSE (0000ms, 1753ms total)
T2470 466:973 JLINK_IsHalted()  returns FALSE (0000ms, 1753ms total)
T2470 467:074 JLINK_IsHalted()  returns FALSE (0000ms, 1753ms total)
T2470 467:174 JLINK_IsHalted()  returns FALSE (0000ms, 1753ms total)
T2470 467:275 JLINK_IsHalted()  returns FALSE (0000ms, 1753ms total)
T2470 467:376 JLINK_IsHalted()  returns FALSE (0000ms, 1753ms total)
T2470 467:476 JLINK_IsHalted()  returns FALSE (0000ms, 1753ms total)
T2470 467:577 JLINK_IsHalted()  returns FALSE (0000ms, 1753ms total)
T2470 467:678 JLINK_IsHalted()  returns FALSE (0000ms, 1753ms total)
T2470 467:779 JLINK_IsHalted()  returns FALSE (0000ms, 1753ms total)
T2470 467:880 JLINK_IsHalted()  returns FALSE (0000ms, 1753ms total)
T2470 467:981 JLINK_IsHalted()  returns FALSE (0000ms, 1753ms total)
T2470 468:082 JLINK_IsHalted()  returns FALSE (0000ms, 1753ms total)
T2470 468:183 JLINK_IsHalted()  returns FALSE (0000ms, 1753ms total)
T2470 468:283 JLINK_IsHalted()  returns FALSE (0000ms, 1753ms total)
T2470 468:384 JLINK_IsHalted()  returns FALSE (0000ms, 1753ms total)
T2470 468:485 JLINK_IsHalted()  returns FALSE (0000ms, 1753ms total)
T2470 468:586 JLINK_IsHalted()  returns FALSE (0000ms, 1753ms total)
T2470 468:686 JLINK_IsHalted()  returns FALSE (0000ms, 1753ms total)
T2470 468:787 JLINK_IsHalted()  returns FALSE (0000ms, 1753ms total)
T2470 468:888 JLINK_IsHalted()  returns FALSE (0000ms, 1753ms total)
T2470 468:988 JLINK_IsHalted()  returns FALSE (0000ms, 1753ms total)
T2470 469:089 JLINK_IsHalted()  returns FALSE (0000ms, 1753ms total)
T2470 469:190 JLINK_IsHalted()  returns FALSE (0000ms, 1753ms total)
T2470 469:291 JLINK_IsHalted()  returns FALSE (0000ms, 1753ms total)
T2470 469:391 JLINK_IsHalted()  returns FALSE (0000ms, 1753ms total)
T2470 469:492 JLINK_IsHalted()  returns FALSE (0000ms, 1753ms total)
T2470 469:593 JLINK_IsHalted()  returns FALSE (0000ms, 1753ms total)
T2470 469:694 JLINK_IsHalted()  returns FALSE (0000ms, 1753ms total)
T2470 469:794 JLINK_IsHalted()  returns FALSE (0000ms, 1753ms total)
T2470 469:895 JLINK_IsHalted()  returns FALSE (0000ms, 1753ms total)
T2470 469:996 JLINK_IsHalted()  returns FALSE (0000ms, 1753ms total)
T2470 470:097 JLINK_IsHalted()  returns FALSE (0000ms, 1753ms total)
T2470 470:197 JLINK_IsHalted()  returns FALSE (0000ms, 1753ms total)
T2470 470:298 JLINK_IsHalted()  returns FALSE (0000ms, 1753ms total)
T2470 470:399 JLINK_IsHalted()  returns FALSE (0000ms, 1753ms total)
T2470 470:499 JLINK_IsHalted()  returns FALSE (0000ms, 1753ms total)
T2470 470:600 JLINK_IsHalted()  returns FALSE (0000ms, 1753ms total)
T2470 470:701 JLINK_IsHalted()  returns FALSE (0000ms, 1753ms total)
T2470 470:803 JLINK_IsHalted()  returns FALSE (0000ms, 1753ms total)
T2470 470:904 JLINK_IsHalted()  returns FALSE (0000ms, 1753ms total)
T2470 471:005 JLINK_IsHalted()  returns FALSE (0000ms, 1753ms total)
T2470 471:106 JLINK_IsHalted()  returns FALSE (0000ms, 1753ms total)
T2470 471:207 JLINK_IsHalted()  returns FALSE (0000ms, 1753ms total)
T2470 471:307 JLINK_IsHalted()  returns FALSE (0000ms, 1753ms total)
T2470 471:409 JLINK_IsHalted()  returns FALSE (0000ms, 1753ms total)
T2470 471:511 JLINK_IsHalted()  returns FALSE (0000ms, 1753ms total)
T2470 471:613 JLINK_IsHalted()  returns FALSE (0000ms, 1753ms total)
T2470 471:713 JLINK_IsHalted()  returns FALSE (0000ms, 1753ms total)
T2470 471:814 JLINK_IsHalted()  returns FALSE (0000ms, 1753ms total)
T2470 471:916 JLINK_IsHalted()  returns FALSE (0000ms, 1753ms total)
T2470 472:016 JLINK_IsHalted()  returns FALSE (0000ms, 1753ms total)
T2470 472:118 JLINK_IsHalted()  returns FALSE (0000ms, 1753ms total)
T2470 472:219 JLINK_IsHalted()  returns FALSE (0000ms, 1753ms total)
T2470 472:321 JLINK_IsHalted()  returns FALSE (0000ms, 1753ms total)
T2470 472:421 JLINK_IsHalted()  returns FALSE (0000ms, 1753ms total)
T2470 472:523 JLINK_IsHalted()  returns FALSE (0000ms, 1753ms total)
T2470 472:624 JLINK_IsHalted()  returns FALSE (0000ms, 1753ms total)
T2470 472:724 JLINK_IsHalted()  returns FALSE (0000ms, 1753ms total)
T2470 472:825 JLINK_IsHalted()  returns FALSE (0000ms, 1753ms total)
T2470 472:926 JLINK_IsHalted()  returns FALSE (0000ms, 1753ms total)
T2470 473:028 JLINK_IsHalted()  returns FALSE (0000ms, 1753ms total)
T4118 473:077 JLINK_ReadMemEx(0x20002194, 0x0020 Bytes, ..., Flags = 0x02000000) -- CPU_ReadMem(32 bytes @ 0x20002194) - Data: 00 00 00 00 00 00 00 00 00 00 00 00 00 00 00 00 ...  returns 0x20 (0001ms, 1754ms total)
T4118 473:078 JLINK_ReadMemEx(0x20002194, 0x0001 Bytes, ..., Flags = 0x02000000) -- CPU_ReadMem(1 bytes @ 0x20002194) - Data: 00  returns 0x01 (0000ms, 1754ms total)
T4118 473:078 JLINK_ReadMemEx(0x20002195, 0x0001 Bytes, ..., Flags = 0x02000000) -- CPU_ReadMem(1 bytes @ 0x20002195) - Data: 00  returns 0x01 (0001ms, 1755ms total)
T4118 473:079 JLINK_ReadMemEx(0x20002196, 0x0001 Bytes, ..., Flags = 0x02000000) -- CPU_ReadMem(1 bytes @ 0x20002196) - Data: 00  returns 0x01 (0000ms, 1755ms total)
T4118 473:079 JLINK_ReadMemEx(0x20002197, 0x0001 Bytes, ..., Flags = 0x02000000) -- CPU_ReadMem(1 bytes @ 0x20002197) - Data: 00  returns 0x01 (0001ms, 1756ms total)
T4118 473:080 JLINK_ReadMemEx(0x20002198, 0x0001 Bytes, ..., Flags = 0x02000000) -- CPU_ReadMem(1 bytes @ 0x20002198) - Data: 00  returns 0x01 (0000ms, 1756ms total)
T4118 473:080 JLINK_ReadMemEx(0x20002199, 0x0001 Bytes, ..., Flags = 0x02000000) -- CPU_ReadMem(1 bytes @ 0x20002199) - Data: 00  returns 0x01 (0000ms, 1756ms total)
T4118 473:080 JLINK_ReadMemEx(0x2000219A, 0x0001 Bytes, ..., Flags = 0x02000000) -- CPU_ReadMem(1 bytes @ 0x2000219A) - Data: 00  returns 0x01 (0001ms, 1757ms total)
T4118 473:081 JLINK_ReadMemEx(0x2000219B, 0x0001 Bytes, ..., Flags = 0x02000000) -- CPU_ReadMem(1 bytes @ 0x2000219B) - Data: 00  returns 0x01 (0000ms, 1757ms total)
T4118 473:081 JLINK_ReadMemEx(0x2000219C, 0x0001 Bytes, ..., Flags = 0x02000000) -- CPU_ReadMem(1 bytes @ 0x2000219C) - Data: 00  returns 0x01 (0000ms, 1757ms total)
T4118 473:081 JLINK_ReadMemEx(0x2000219D, 0x0001 Bytes, ..., Flags = 0x02000000) -- CPU_ReadMem(1 bytes @ 0x2000219D) - Data: 00  returns 0x01 (0001ms, 1758ms total)
T4118 473:082 JLINK_ReadMemEx(0x2000219E, 0x0001 Bytes, ..., Flags = 0x02000000) -- CPU_ReadMem(1 bytes @ 0x2000219E) - Data: 00  returns 0x01 (0000ms, 1758ms total)
T4118 473:082 JLINK_ReadMemEx(0x2000219F, 0x0001 Bytes, ..., Flags = 0x02000000) -- CPU_ReadMem(1 bytes @ 0x2000219F) - Data: 00  returns 0x01 (0000ms, 1758ms total)
T4118 473:082 JLINK_ReadMemEx(0x200021A0, 0x0001 Bytes, ..., Flags = 0x02000000) -- CPU_ReadMem(1 bytes @ 0x200021A0) - Data: 00  returns 0x01 (0001ms, 1759ms total)
T4118 473:083 JLINK_ReadMemEx(0x200021A1, 0x0001 Bytes, ..., Flags = 0x02000000) -- CPU_ReadMem(1 bytes @ 0x200021A1) - Data: 00  returns 0x01 (0000ms, 1759ms total)
T4118 473:083 JLINK_ReadMemEx(0x200021A2, 0x0001 Bytes, ..., Flags = 0x02000000) -- CPU_ReadMem(1 bytes @ 0x200021A2) - Data: 00  returns 0x01 (0000ms, 1759ms total)
T4118 473:083 JLINK_ReadMemEx(0x200021A3, 0x0001 Bytes, ..., Flags = 0x02000000) -- CPU_ReadMem(1 bytes @ 0x200021A3) - Data: 00  returns 0x01 (0001ms, 1760ms total)
T4118 473:084 JLINK_ReadMemEx(0x200021A4, 0x0001 Bytes, ..., Flags = 0x02000000) -- CPU_ReadMem(1 bytes @ 0x200021A4) - Data: 00  returns 0x01 (0000ms, 1760ms total)
T4118 473:084 JLINK_ReadMemEx(0x200021A5, 0x0001 Bytes, ..., Flags = 0x02000000) -- CPU_ReadMem(1 bytes @ 0x200021A5) - Data: 00  returns 0x01 (0000ms, 1760ms total)
T4118 473:084 JLINK_ReadMemEx(0x200021A6, 0x0001 Bytes, ..., Flags = 0x02000000) -- CPU_ReadMem(1 bytes @ 0x200021A6) - Data: 00  returns 0x01 (0000ms, 1760ms total)
T4118 473:084 JLINK_ReadMemEx(0x200021A7, 0x0001 Bytes, ..., Flags = 0x02000000) -- CPU_ReadMem(1 bytes @ 0x200021A7) - Data: 00  returns 0x01 (0000ms, 1760ms total)
T4118 473:084 JLINK_ReadMemEx(0x200021A8, 0x0001 Bytes, ..., Flags = 0x02000000) -- CPU_ReadMem(1 bytes @ 0x200021A8) - Data: 00  returns 0x01 (0000ms, 1760ms total)
T4118 473:084 JLINK_ReadMemEx(0x200021A9, 0x0001 Bytes, ..., Flags = 0x02000000) -- CPU_ReadMem(1 bytes @ 0x200021A9) - Data: 00  returns 0x01 (0000ms, 1760ms total)
T4118 473:084 JLINK_ReadMemEx(0x200021AA, 0x0001 Bytes, ..., Flags = 0x02000000) -- CPU_ReadMem(1 bytes @ 0x200021AA) - Data: 00  returns 0x01 (0000ms, 1760ms total)
T4118 473:084 JLINK_ReadMemEx(0x200021AB, 0x0001 Bytes, ..., Flags = 0x02000000) -- CPU_ReadMem(1 bytes @ 0x200021AB) - Data: 00  returns 0x01 (0001ms, 1761ms total)
T4118 473:085 JLINK_ReadMemEx(0x200021AC, 0x0001 Bytes, ..., Flags = 0x02000000) -- CPU_ReadMem(1 bytes @ 0x200021AC) - Data: 00  returns 0x01 (0000ms, 1761ms total)
T4118 473:085 JLINK_ReadMemEx(0x200021AD, 0x0001 Bytes, ..., Flags = 0x02000000) -- CPU_ReadMem(1 bytes @ 0x200021AD) - Data: 00  returns 0x01 (0000ms, 1761ms total)
T4118 473:085 JLINK_ReadMemEx(0x200021AE, 0x0001 Bytes, ..., Flags = 0x02000000) -- CPU_ReadMem(1 bytes @ 0x200021AE) - Data: 00  returns 0x01 (0000ms, 1761ms total)
T4118 473:085 JLINK_ReadMemEx(0x200021AF, 0x0001 Bytes, ..., Flags = 0x02000000) -- CPU_ReadMem(1 bytes @ 0x200021AF) - Data: 00  returns 0x01 (0001ms, 1762ms total)
T4118 473:086 JLINK_ReadMemEx(0x200021B0, 0x0001 Bytes, ..., Flags = 0x02000000) -- CPU_ReadMem(1 bytes @ 0x200021B0) - Data: 00  returns 0x01 (0000ms, 1762ms total)
T4118 473:086 JLINK_ReadMemEx(0x200021B1, 0x0001 Bytes, ..., Flags = 0x02000000) -- CPU_ReadMem(1 bytes @ 0x200021B1) - Data: 00  returns 0x01 (0000ms, 1762ms total)
T4118 473:086 JLINK_ReadMemEx(0x200021B2, 0x0001 Bytes, ..., Flags = 0x02000000) -- CPU_ReadMem(1 bytes @ 0x200021B2) - Data: 00  returns 0x01 (0001ms, 1763ms total)
T4118 473:087 JLINK_ReadMemEx(0x200021B3, 0x0001 Bytes, ..., Flags = 0x02000000) -- CPU_ReadMem(1 bytes @ 0x200021B3) - Data: 00  returns 0x01 (0000ms, 1763ms total)
T4118 473:087 JLINK_ReadMemEx(0x200021B4, 0x0001 Bytes, ..., Flags = 0x02000000) -- CPU_ReadMem(1 bytes @ 0x200021B4) - Data: 00  returns 0x01 (0000ms, 1763ms total)
T4118 473:087 JLINK_ReadMemEx(0x200021B5, 0x0001 Bytes, ..., Flags = 0x02000000) -- CPU_ReadMem(1 bytes @ 0x200021B5) - Data: 00  returns 0x01 (0001ms, 1764ms total)
T4118 473:088 JLINK_ReadMemEx(0x200021B6, 0x0001 Bytes, ..., Flags = 0x02000000) -- CPU_ReadMem(1 bytes @ 0x200021B6) - Data: 00  returns 0x01 (0000ms, 1764ms total)
T4118 473:088 JLINK_ReadMemEx(0x200021B7, 0x0001 Bytes, ..., Flags = 0x02000000) -- CPU_ReadMem(1 bytes @ 0x200021B7) - Data: 00  returns 0x01 (0000ms, 1764ms total)
T4118 473:088 JLINK_ReadMemEx(0x200021B8, 0x0001 Bytes, ..., Flags = 0x02000000) -- CPU_ReadMem(1 bytes @ 0x200021B8) - Data: 00  returns 0x01 (0000ms, 1764ms total)
T4118 473:088 JLINK_ReadMemEx(0x200021B9, 0x0001 Bytes, ..., Flags = 0x02000000) -- CPU_ReadMem(1 bytes @ 0x200021B9) - Data: 00  returns 0x01 (0001ms, 1765ms total)
T4118 473:089 JLINK_ReadMemEx(0x200021BA, 0x0001 Bytes, ..., Flags = 0x02000000) -- CPU_ReadMem(1 bytes @ 0x200021BA) - Data: 00  returns 0x01 (0000ms, 1765ms total)
T4118 473:089 JLINK_ReadMemEx(0x200021BB, 0x0001 Bytes, ..., Flags = 0x02000000) -- CPU_ReadMem(1 bytes @ 0x200021BB) - Data: 00  returns 0x01 (0000ms, 1765ms total)
T4118 473:089 JLINK_ReadMemEx(0x200021BC, 0x0001 Bytes, ..., Flags = 0x02000000) -- CPU_ReadMem(1 bytes @ 0x200021BC) - Data: 00  returns 0x01 (0000ms, 1765ms total)
T4118 473:089 JLINK_ReadMemEx(0x200021BD, 0x0001 Bytes, ..., Flags = 0x02000000) -- CPU_ReadMem(1 bytes @ 0x200021BD) - Data: 00  returns 0x01 (0001ms, 1766ms total)
T4118 473:090 JLINK_ReadMemEx(0x200021BE, 0x0001 Bytes, ..., Flags = 0x02000000) -- CPU_ReadMem(1 bytes @ 0x200021BE) - Data: 00  returns 0x01 (0000ms, 1766ms total)
T4118 473:090 JLINK_ReadMemEx(0x200021BF, 0x0001 Bytes, ..., Flags = 0x02000000) -- CPU_ReadMem(1 bytes @ 0x200021BF) - Data: 00  returns 0x01 (0000ms, 1766ms total)
T4118 473:090 JLINK_ReadMemEx(0x200021C0, 0x0001 Bytes, ..., Flags = 0x02000000) -- CPU_ReadMem(1 bytes @ 0x200021C0) - Data: 00  returns 0x01 (0001ms, 1767ms total)
T4118 473:091 JLINK_ReadMemEx(0x200021C1, 0x0001 Bytes, ..., Flags = 0x02000000) -- CPU_ReadMem(1 bytes @ 0x200021C1) - Data: 00  returns 0x01 (0000ms, 1767ms total)
T4118 473:091 JLINK_ReadMemEx(0x200021C2, 0x0001 Bytes, ..., Flags = 0x02000000) -- CPU_ReadMem(1 bytes @ 0x200021C2) - Data: 00  returns 0x01 (0000ms, 1767ms total)
T4118 473:091 JLINK_ReadMemEx(0x200021C3, 0x0001 Bytes, ..., Flags = 0x02000000) -- CPU_ReadMem(1 bytes @ 0x200021C3) - Data: 00  returns 0x01 (0000ms, 1767ms total)
T4118 473:092 JLINK_ReadMemEx(0x200021C4, 0x0001 Bytes, ..., Flags = 0x02000000) -- CPU_ReadMem(1 bytes @ 0x200021C4) - Data: 00  returns 0x01 (0000ms, 1768ms total)
T4118 473:092 JLINK_ReadMemEx(0x200021C5, 0x0001 Bytes, ..., Flags = 0x02000000) -- CPU_ReadMem(1 bytes @ 0x200021C5) - Data: 00  returns 0x01 (0000ms, 1768ms total)
T4118 473:092 JLINK_ReadMemEx(0x200021C6, 0x0001 Bytes, ..., Flags = 0x02000000) -- CPU_ReadMem(1 bytes @ 0x200021C6) - Data: 00  returns 0x01 (0000ms, 1768ms total)
T4118 473:092 JLINK_ReadMemEx(0x200021C7, 0x0001 Bytes, ..., Flags = 0x02000000) -- CPU_ReadMem(1 bytes @ 0x200021C7) - Data: 00  returns 0x01 (0001ms, 1769ms total)
T4118 473:093 JLINK_ReadMemEx(0x200021C8, 0x0001 Bytes, ..., Flags = 0x02000000) -- CPU_ReadMem(1 bytes @ 0x200021C8) - Data: 00  returns 0x01 (0000ms, 1769ms total)
T4118 473:093 JLINK_ReadMemEx(0x200021C9, 0x0001 Bytes, ..., Flags = 0x02000000) -- CPU_ReadMem(1 bytes @ 0x200021C9) - Data: 00  returns 0x01 (0000ms, 1769ms total)
T4118 473:093 JLINK_ReadMemEx(0x200021CA, 0x0001 Bytes, ..., Flags = 0x02000000) -- CPU_ReadMem(1 bytes @ 0x200021CA) - Data: 00  returns 0x01 (0000ms, 1769ms total)
T4118 473:093 JLINK_ReadMemEx(0x200021CB, 0x0001 Bytes, ..., Flags = 0x02000000) -- CPU_ReadMem(1 bytes @ 0x200021CB) - Data: 00  returns 0x01 (0001ms, 1770ms total)
T4118 473:094 JLINK_ReadMemEx(0x200021CC, 0x0001 Bytes, ..., Flags = 0x02000000) -- CPU_ReadMem(1 bytes @ 0x200021CC) - Data: 00  returns 0x01 (0000ms, 1770ms total)
T4118 473:094 JLINK_ReadMemEx(0x200021CD, 0x0001 Bytes, ..., Flags = 0x02000000) -- CPU_ReadMem(1 bytes @ 0x200021CD) - Data: 00  returns 0x01 (0000ms, 1770ms total)
T4118 473:094 JLINK_ReadMemEx(0x200021CE, 0x0001 Bytes, ..., Flags = 0x02000000) -- CPU_ReadMem(1 bytes @ 0x200021CE) - Data: 00  returns 0x01 (0000ms, 1770ms total)
T4118 473:094 JLINK_ReadMemEx(0x200021CF, 0x0001 Bytes, ..., Flags = 0x02000000) -- CPU_ReadMem(1 bytes @ 0x200021CF) - Data: 00  returns 0x01 (0001ms, 1771ms total)
T4118 473:095 JLINK_ReadMemEx(0x200021D0, 0x0001 Bytes, ..., Flags = 0x02000000) -- CPU_ReadMem(1 bytes @ 0x200021D0) - Data: 00  returns 0x01 (0000ms, 1771ms total)
T4118 473:095 JLINK_ReadMemEx(0x200021D1, 0x0001 Bytes, ..., Flags = 0x02000000) -- CPU_ReadMem(1 bytes @ 0x200021D1) - Data: 00  returns 0x01 (0000ms, 1771ms total)
T4118 473:095 JLINK_ReadMemEx(0x200021D2, 0x0001 Bytes, ..., Flags = 0x02000000) -- CPU_ReadMem(1 bytes @ 0x200021D2) - Data: 00  returns 0x01 (0000ms, 1771ms total)
T4118 473:095 JLINK_ReadMemEx(0x200021D3, 0x0001 Bytes, ..., Flags = 0x02000000) -- CPU_ReadMem(1 bytes @ 0x200021D3) - Data: 00  returns 0x01 (0001ms, 1772ms total)
T4118 473:096 JLINK_ReadMemEx(0x200021D4, 0x0001 Bytes, ..., Flags = 0x02000000) -- CPU_ReadMem(1 bytes @ 0x200021D4) - Data: 00  returns 0x01 (0000ms, 1772ms total)
T4118 473:096 JLINK_ReadMemEx(0x200021D5, 0x0001 Bytes, ..., Flags = 0x02000000) -- CPU_ReadMem(1 bytes @ 0x200021D5) - Data: 00  returns 0x01 (0000ms, 1772ms total)
T4118 473:096 JLINK_ReadMemEx(0x200021D6, 0x0001 Bytes, ..., Flags = 0x02000000) -- CPU_ReadMem(1 bytes @ 0x200021D6) - Data: 00  returns 0x01 (0001ms, 1773ms total)
T4118 473:097 JLINK_ReadMemEx(0x200021D7, 0x0001 Bytes, ..., Flags = 0x02000000) -- CPU_ReadMem(1 bytes @ 0x200021D7) - Data: 00  returns 0x01 (0000ms, 1773ms total)
T4118 473:097 JLINK_ReadMemEx(0x200021D8, 0x0001 Bytes, ..., Flags = 0x02000000) -- CPU_ReadMem(1 bytes @ 0x200021D8) - Data: 00  returns 0x01 (0000ms, 1773ms total)
T4118 473:097 JLINK_ReadMemEx(0x200021D9, 0x0001 Bytes, ..., Flags = 0x02000000) -- CPU_ReadMem(1 bytes @ 0x200021D9) - Data: 00  returns 0x01 (0000ms, 1773ms total)
T4118 473:097 JLINK_ReadMemEx(0x200021DA, 0x0001 Bytes, ..., Flags = 0x02000000) -- CPU_ReadMem(1 bytes @ 0x200021DA) - Data: 00  returns 0x01 (0001ms, 1774ms total)
T4118 473:098 JLINK_ReadMemEx(0x200021DB, 0x0001 Bytes, ..., Flags = 0x02000000) -- CPU_ReadMem(1 bytes @ 0x200021DB) - Data: 00  returns 0x01 (0000ms, 1774ms total)
T4118 473:098 JLINK_ReadMemEx(0x200021DC, 0x0001 Bytes, ..., Flags = 0x02000000) -- CPU_ReadMem(1 bytes @ 0x200021DC) - Data: 00  returns 0x01 (0000ms, 1774ms total)
T4118 473:098 JLINK_ReadMemEx(0x200021DD, 0x0001 Bytes, ..., Flags = 0x02000000) -- CPU_ReadMem(1 bytes @ 0x200021DD) - Data: 00  returns 0x01 (0001ms, 1775ms total)
T4118 473:099 JLINK_ReadMemEx(0x200021DE, 0x0001 Bytes, ..., Flags = 0x02000000) -- CPU_ReadMem(1 bytes @ 0x200021DE) - Data: 00  returns 0x01 (0000ms, 1775ms total)
T4118 473:099 JLINK_ReadMemEx(0x200021DF, 0x0001 Bytes, ..., Flags = 0x02000000) -- CPU_ReadMem(1 bytes @ 0x200021DF) - Data: 00  returns 0x01 (0000ms, 1775ms total)
T4118 473:099 JLINK_ReadMemEx(0x200021E0, 0x0001 Bytes, ..., Flags = 0x02000000) -- CPU_ReadMem(1 bytes @ 0x200021E0) - Data: 00  returns 0x01 (0000ms, 1775ms total)
T4118 473:100 JLINK_ReadMemEx(0x200021E1, 0x0001 Bytes, ..., Flags = 0x02000000) -- CPU_ReadMem(1 bytes @ 0x200021E1) - Data: 00  returns 0x01 (0000ms, 1775ms total)
T4118 473:100 JLINK_ReadMemEx(0x200021E2, 0x0001 Bytes, ..., Flags = 0x02000000) -- CPU_ReadMem(1 bytes @ 0x200021E2) - Data: 00  returns 0x01 (0000ms, 1775ms total)
T4118 473:100 JLINK_ReadMemEx(0x200021E3, 0x0001 Bytes, ..., Flags = 0x02000000) -- CPU_ReadMem(1 bytes @ 0x200021E3) - Data: 00  returns 0x01 (0000ms, 1775ms total)
T4118 473:100 JLINK_ReadMemEx(0x200021E4, 0x0001 Bytes, ..., Flags = 0x02000000) -- CPU_ReadMem(1 bytes @ 0x200021E4) - Data: 00  returns 0x01 (0001ms, 1776ms total)
T4118 473:101 JLINK_ReadMemEx(0x200021E5, 0x0001 Bytes, ..., Flags = 0x02000000) -- CPU_ReadMem(1 bytes @ 0x200021E5) - Data: 00  returns 0x01 (0000ms, 1776ms total)
T4118 473:101 JLINK_ReadMemEx(0x200021E6, 0x0001 Bytes, ..., Flags = 0x02000000) -- CPU_ReadMem(1 bytes @ 0x200021E6) - Data: 00  returns 0x01 (0000ms, 1776ms total)
T4118 473:101 JLINK_ReadMemEx(0x200021E7, 0x0001 Bytes, ..., Flags = 0x02000000) -- CPU_ReadMem(1 bytes @ 0x200021E7) - Data: 00  returns 0x01 (0000ms, 1776ms total)
T4118 473:101 JLINK_ReadMemEx(0x200021E8, 0x0001 Bytes, ..., Flags = 0x02000000) -- CPU_ReadMem(1 bytes @ 0x200021E8) - Data: 00  returns 0x01 (0001ms, 1777ms total)
T4118 473:102 JLINK_ReadMemEx(0x200021E9, 0x0001 Bytes, ..., Flags = 0x02000000) -- CPU_ReadMem(1 bytes @ 0x200021E9) - Data: 00  returns 0x01 (0000ms, 1777ms total)
T4118 473:102 JLINK_ReadMemEx(0x200021EA, 0x0001 Bytes, ..., Flags = 0x02000000) -- CPU_ReadMem(1 bytes @ 0x200021EA) - Data: 00  returns 0x01 (0000ms, 1777ms total)
T4118 473:102 JLINK_ReadMemEx(0x200021EB, 0x0001 Bytes, ..., Flags = 0x02000000) -- CPU_ReadMem(1 bytes @ 0x200021EB) - Data: 00  returns 0x01 (0000ms, 1777ms total)
T4118 473:102 JLINK_ReadMemEx(0x200021EC, 0x0001 Bytes, ..., Flags = 0x02000000) -- CPU_ReadMem(1 bytes @ 0x200021EC) - Data: 00  returns 0x01 (0001ms, 1778ms total)
T4118 473:103 JLINK_ReadMemEx(0x200021ED, 0x0001 Bytes, ..., Flags = 0x02000000) -- CPU_ReadMem(1 bytes @ 0x200021ED) - Data: 00  returns 0x01 (0000ms, 1778ms total)
T4118 473:103 JLINK_ReadMemEx(0x200021EE, 0x0001 Bytes, ..., Flags = 0x02000000) -- CPU_ReadMem(1 bytes @ 0x200021EE) - Data: 00  returns 0x01 (0000ms, 1778ms total)
T4118 473:103 JLINK_ReadMemEx(0x200021EF, 0x0001 Bytes, ..., Flags = 0x02000000) -- CPU_ReadMem(1 bytes @ 0x200021EF) - Data: 00  returns 0x01 (0001ms, 1779ms total)
T4118 473:104 JLINK_ReadMemEx(0x200021F0, 0x0001 Bytes, ..., Flags = 0x02000000) -- CPU_ReadMem(1 bytes @ 0x200021F0) - Data: 00  returns 0x01 (0000ms, 1779ms total)
T4118 473:104 JLINK_ReadMemEx(0x200021F1, 0x0001 Bytes, ..., Flags = 0x02000000) -- CPU_ReadMem(1 bytes @ 0x200021F1) - Data: 00  returns 0x01 (0000ms, 1779ms total)
T4118 473:104 JLINK_ReadMemEx(0x200021F2, 0x0001 Bytes, ..., Flags = 0x02000000) -- CPU_ReadMem(1 bytes @ 0x200021F2) - Data: 00  returns 0x01 (0000ms, 1779ms total)
T4118 473:104 JLINK_ReadMemEx(0x200021F3, 0x0001 Bytes, ..., Flags = 0x02000000) -- CPU_ReadMem(1 bytes @ 0x200021F3) - Data: 00  returns 0x01 (0001ms, 1780ms total)
T4118 473:105 JLINK_ReadMemEx(0x200021F4, 0x0001 Bytes, ..., Flags = 0x02000000) -- CPU_ReadMem(1 bytes @ 0x200021F4) - Data: 00  returns 0x01 (0000ms, 1780ms total)
T4118 473:105 JLINK_ReadMemEx(0x200021F5, 0x0001 Bytes, ..., Flags = 0x02000000) -- CPU_ReadMem(1 bytes @ 0x200021F5) - Data: 00  returns 0x01 (0000ms, 1780ms total)
T4118 473:105 JLINK_ReadMemEx(0x200021F6, 0x0001 Bytes, ..., Flags = 0x02000000) -- CPU_ReadMem(1 bytes @ 0x200021F6) - Data: 00  returns 0x01 (0001ms, 1781ms total)
T4118 473:106 JLINK_ReadMemEx(0x200021F7, 0x0001 Bytes, ..., Flags = 0x02000000) -- CPU_ReadMem(1 bytes @ 0x200021F7) - Data: 00  returns 0x01 (0000ms, 1781ms total)
T4118 473:106 JLINK_ReadMemEx(0x200021F8, 0x0001 Bytes, ..., Flags = 0x02000000) -- CPU_ReadMem(1 bytes @ 0x200021F8) - Data: 00  returns 0x01 (0000ms, 1781ms total)
T4118 473:106 JLINK_ReadMemEx(0x200021F9, 0x0001 Bytes, ..., Flags = 0x02000000) -- CPU_ReadMem(1 bytes @ 0x200021F9) - Data: 00  returns 0x01 (0000ms, 1781ms total)
T4118 473:106 JLINK_ReadMemEx(0x200021FA, 0x0001 Bytes, ..., Flags = 0x02000000) -- CPU_ReadMem(1 bytes @ 0x200021FA) - Data: 00  returns 0x01 (0001ms, 1782ms total)
T4118 473:107 JLINK_ReadMemEx(0x200021FB, 0x0001 Bytes, ..., Flags = 0x02000000) -- CPU_ReadMem(1 bytes @ 0x200021FB) - Data: 00  returns 0x01 (0000ms, 1782ms total)
T4118 473:107 JLINK_ReadMemEx(0x200021FC, 0x0001 Bytes, ..., Flags = 0x02000000) -- CPU_ReadMem(1 bytes @ 0x200021FC) - Data: 00  returns 0x01 (0000ms, 1782ms total)
T4118 473:107 JLINK_ReadMemEx(0x200021FD, 0x0001 Bytes, ..., Flags = 0x02000000) -- CPU_ReadMem(1 bytes @ 0x200021FD) - Data: 00  returns 0x01 (0000ms, 1782ms total)
T4118 473:107 JLINK_ReadMemEx(0x200021FE, 0x0001 Bytes, ..., Flags = 0x02000000) -- CPU_ReadMem(1 bytes @ 0x200021FE) - Data: 00  returns 0x01 (0001ms, 1783ms total)
T4118 473:108 JLINK_ReadMemEx(0x200021FF, 0x0001 Bytes, ..., Flags = 0x02000000) -- CPU_ReadMem(1 bytes @ 0x200021FF) - Data: 00  returns 0x01 (0000ms, 1783ms total)
T4118 473:108 JLINK_ReadMemEx(0x20002200, 0x0001 Bytes, ..., Flags = 0x02000000) -- CPU_ReadMem(1 bytes @ 0x20002200) - Data: 00  returns 0x01 (0000ms, 1783ms total)
T4118 473:108 JLINK_ReadMemEx(0x20002201, 0x0001 Bytes, ..., Flags = 0x02000000) -- CPU_ReadMem(1 bytes @ 0x20002201) - Data: 00  returns 0x01 (0000ms, 1783ms total)
T4118 473:108 JLINK_ReadMemEx(0x20002202, 0x0001 Bytes, ..., Flags = 0x02000000) -- CPU_ReadMem(1 bytes @ 0x20002202) - Data: 00  returns 0x01 (0001ms, 1784ms total)
T4118 473:109 JLINK_ReadMemEx(0x20002203, 0x0001 Bytes, ..., Flags = 0x02000000) -- CPU_ReadMem(1 bytes @ 0x20002203) - Data: 00  returns 0x01 (0000ms, 1784ms total)
T4118 473:109 JLINK_ReadMemEx(0x20002204, 0x0001 Bytes, ..., Flags = 0x02000000) -- CPU_ReadMem(1 bytes @ 0x20002204) - Data: 00  returns 0x01 (0000ms, 1784ms total)
T4118 473:109 JLINK_ReadMemEx(0x20002205, 0x0001 Bytes, ..., Flags = 0x02000000) -- CPU_ReadMem(1 bytes @ 0x20002205) - Data: 00  returns 0x01 (0000ms, 1784ms total)
T4118 473:109 JLINK_ReadMemEx(0x20002206, 0x0001 Bytes, ..., Flags = 0x02000000) -- CPU_ReadMem(1 bytes @ 0x20002206) - Data: 00  returns 0x01 (0001ms, 1785ms total)
T4118 473:110 JLINK_ReadMemEx(0x20002207, 0x0001 Bytes, ..., Flags = 0x02000000) -- CPU_ReadMem(1 bytes @ 0x20002207) - Data: 00  returns 0x01 (0000ms, 1785ms total)
T4118 473:110 JLINK_ReadMemEx(0x20002208, 0x0001 Bytes, ..., Flags = 0x02000000) -- CPU_ReadMem(1 bytes @ 0x20002208) - Data: 00  returns 0x01 (0000ms, 1785ms total)
T4118 473:110 JLINK_ReadMemEx(0x20002209, 0x0001 Bytes, ..., Flags = 0x02000000) -- CPU_ReadMem(1 bytes @ 0x20002209) - Data: 00  returns 0x01 (0001ms, 1786ms total)
T4118 473:111 JLINK_ReadMemEx(0x2000220A, 0x0001 Bytes, ..., Flags = 0x02000000) -- CPU_ReadMem(1 bytes @ 0x2000220A) - Data: 00  returns 0x01 (0000ms, 1786ms total)
T4118 473:111 JLINK_ReadMemEx(0x2000220B, 0x0001 Bytes, ..., Flags = 0x02000000) -- CPU_ReadMem(1 bytes @ 0x2000220B) - Data: 00  returns 0x01 (0000ms, 1786ms total)
T4118 473:111 JLINK_ReadMemEx(0x2000220C, 0x0001 Bytes, ..., Flags = 0x02000000) -- CPU_ReadMem(1 bytes @ 0x2000220C) - Data: 00  returns 0x01 (0000ms, 1786ms total)
T4118 473:111 JLINK_ReadMemEx(0x2000220D, 0x0001 Bytes, ..., Flags = 0x02000000) -- CPU_ReadMem(1 bytes @ 0x2000220D) - Data: 00  returns 0x01 (0001ms, 1787ms total)
T4118 473:112 JLINK_ReadMemEx(0x2000220E, 0x0001 Bytes, ..., Flags = 0x02000000) -- CPU_ReadMem(1 bytes @ 0x2000220E) - Data: 00  returns 0x01 (0000ms, 1787ms total)
T4118 473:112 JLINK_ReadMemEx(0x2000220F, 0x0001 Bytes, ..., Flags = 0x02000000) -- CPU_ReadMem(1 bytes @ 0x2000220F) - Data: 00  returns 0x01 (0000ms, 1787ms total)
T4118 473:112 JLINK_ReadMemEx(0x20002210, 0x0001 Bytes, ..., Flags = 0x02000000) -- CPU_ReadMem(1 bytes @ 0x20002210) - Data: 00  returns 0x01 (0000ms, 1787ms total)
T4118 473:112 JLINK_ReadMemEx(0x20002211, 0x0001 Bytes, ..., Flags = 0x02000000) -- CPU_ReadMem(1 bytes @ 0x20002211) - Data: 00  returns 0x01 (0001ms, 1788ms total)
T4118 473:113 JLINK_ReadMemEx(0x20002212, 0x0001 Bytes, ..., Flags = 0x02000000) -- CPU_ReadMem(1 bytes @ 0x20002212) - Data: 00  returns 0x01 (0000ms, 1788ms total)
T4118 473:113 JLINK_ReadMemEx(0x20002213, 0x0001 Bytes, ..., Flags = 0x02000000) -- CPU_ReadMem(1 bytes @ 0x20002213) - Data: 00  returns 0x01 (0000ms, 1788ms total)
T2470 473:128 JLINK_IsHalted()  returns FALSE (0000ms, 1788ms total)
T2470 473:229 JLINK_IsHalted()  returns FALSE (0000ms, 1788ms total)
T2470 473:330 JLINK_IsHalted()  returns FALSE (0000ms, 1788ms total)
T2470 473:431 JLINK_IsHalted()  returns FALSE (0000ms, 1788ms total)
T2470 473:531 JLINK_IsHalted()  returns FALSE (0000ms, 1788ms total)
T2470 473:633 JLINK_IsHalted()  returns FALSE (0000ms, 1788ms total)
T2470 473:734 JLINK_IsHalted()  returns FALSE (0000ms, 1788ms total)
T2470 473:835 JLINK_IsHalted()  returns FALSE (0000ms, 1788ms total)
T2470 473:936 JLINK_IsHalted()  returns FALSE (0000ms, 1788ms total)
T2470 474:037 JLINK_IsHalted()  returns FALSE (0000ms, 1788ms total)
T2470 474:138 JLINK_IsHalted()  returns FALSE (0000ms, 1788ms total)
T2470 474:239 JLINK_IsHalted()  returns FALSE (0000ms, 1788ms total)
T2470 474:340 JLINK_IsHalted()  returns FALSE (0000ms, 1788ms total)
T2470 474:441 JLINK_IsHalted()  returns FALSE (0000ms, 1788ms total)
T2470 474:542 JLINK_IsHalted()  returns FALSE (0000ms, 1788ms total)
T2470 474:643 JLINK_IsHalted()  returns FALSE (0000ms, 1788ms total)
T2470 474:744 JLINK_IsHalted()  returns FALSE (0000ms, 1788ms total)
T2470 474:845 JLINK_IsHalted()  returns FALSE (0000ms, 1788ms total)
T2470 474:946 JLINK_IsHalted()  returns FALSE (0000ms, 1788ms total)
T2470 475:046 JLINK_IsHalted()  returns FALSE (0000ms, 1788ms total)
T2470 475:147 JLINK_IsHalted()  returns FALSE (0000ms, 1788ms total)
T2470 475:248 JLINK_IsHalted()  returns FALSE (0000ms, 1788ms total)
T2470 475:349 JLINK_IsHalted()  returns FALSE (0000ms, 1788ms total)
T2470 475:450 JLINK_IsHalted()  returns FALSE (0000ms, 1788ms total)
T2470 475:551 JLINK_IsHalted()  returns FALSE (0000ms, 1788ms total)
T2470 475:652 JLINK_IsHalted()  returns FALSE (0000ms, 1788ms total)
T2470 475:752 JLINK_IsHalted()  returns FALSE (0000ms, 1788ms total)
T2470 475:853 JLINK_IsHalted()  returns FALSE (0000ms, 1788ms total)
T2470 475:955 JLINK_IsHalted()  returns FALSE (0000ms, 1788ms total)
T2470 476:056 JLINK_IsHalted()  returns FALSE (0000ms, 1788ms total)
T2470 476:157 JLINK_IsHalted()  returns FALSE (0000ms, 1788ms total)
T2470 476:259 JLINK_IsHalted()  returns FALSE (0000ms, 1788ms total)
T2470 476:360 JLINK_IsHalted()  returns FALSE (0000ms, 1788ms total)
T2470 476:460 JLINK_IsHalted()  returns FALSE (0000ms, 1788ms total)
T2470 476:561 JLINK_IsHalted()  returns FALSE (0000ms, 1788ms total)
T2470 476:662 JLINK_IsHalted()  returns FALSE (0000ms, 1788ms total)
T2470 476:763 JLINK_IsHalted()  returns FALSE (0000ms, 1788ms total)
T2470 476:864 JLINK_IsHalted()  returns FALSE (0000ms, 1788ms total)
T2470 476:965 JLINK_IsHalted()  returns FALSE (0000ms, 1788ms total)
T2470 477:066 JLINK_IsHalted()  returns FALSE (0000ms, 1788ms total)
T2470 477:167 JLINK_IsHalted()  returns FALSE (0000ms, 1788ms total)
T2470 477:267 JLINK_IsHalted()  returns FALSE (0000ms, 1788ms total)
T2470 477:369 JLINK_IsHalted()  returns FALSE (0000ms, 1788ms total)
T2470 477:470 JLINK_IsHalted()  returns FALSE (0000ms, 1788ms total)
T2470 477:571 JLINK_IsHalted()  returns FALSE (0000ms, 1788ms total)
T2470 477:671 JLINK_IsHalted()  returns FALSE (0000ms, 1788ms total)
T2470 477:772 JLINK_IsHalted()  returns FALSE (0000ms, 1788ms total)
T2470 477:873 JLINK_IsHalted()  returns FALSE (0000ms, 1788ms total)
T2470 477:973 JLINK_IsHalted()  returns FALSE (0000ms, 1788ms total)
T2470 478:074 JLINK_IsHalted()  returns FALSE (0000ms, 1788ms total)
T2470 478:176 JLINK_IsHalted()  returns FALSE (0000ms, 1788ms total)
T2470 478:277 JLINK_IsHalted()  returns FALSE (0000ms, 1788ms total)
T2470 478:378 JLINK_IsHalted()  returns FALSE (0000ms, 1788ms total)
T2470 478:478 JLINK_IsHalted()  returns FALSE (0000ms, 1788ms total)
T2470 478:580 JLINK_IsHalted()  returns FALSE (0000ms, 1788ms total)
T2470 478:681 JLINK_IsHalted()  returns FALSE (0000ms, 1788ms total)
T2470 478:781 JLINK_IsHalted()  returns FALSE (0000ms, 1788ms total)
T2470 478:883 JLINK_IsHalted()  returns FALSE (0000ms, 1788ms total)
T2470 478:984 JLINK_IsHalted()  returns FALSE (0000ms, 1788ms total)
T2470 479:085 JLINK_IsHalted()  returns FALSE (0000ms, 1788ms total)
T2470 479:185 JLINK_IsHalted()  returns FALSE (0000ms, 1788ms total)
T2470 479:286 JLINK_IsHalted()  returns FALSE (0000ms, 1788ms total)
T2470 479:387 JLINK_IsHalted()  returns FALSE (0000ms, 1788ms total)
T2470 479:488 JLINK_IsHalted()  returns FALSE (0000ms, 1788ms total)
T2470 479:589 JLINK_IsHalted()  returns FALSE (0000ms, 1788ms total)
T2470 479:690 JLINK_IsHalted()  returns FALSE (0000ms, 1788ms total)
T2470 479:791 JLINK_IsHalted()  returns FALSE (0000ms, 1788ms total)
T2470 479:891 JLINK_IsHalted()  returns FALSE (0000ms, 1788ms total)
T2470 479:992 JLINK_IsHalted()  returns FALSE (0000ms, 1788ms total)
T2470 480:093 JLINK_IsHalted()  returns FALSE (0000ms, 1788ms total)
T2470 480:195 JLINK_IsHalted()  returns FALSE (0000ms, 1788ms total)
T2470 480:295 JLINK_IsHalted()  returns FALSE (0001ms, 1789ms total)
T2470 480:397 JLINK_IsHalted()  returns FALSE (0000ms, 1788ms total)
T2470 480:498 JLINK_IsHalted()  returns FALSE (0000ms, 1788ms total)
T2470 480:599 JLINK_IsHalted()  returns FALSE (0000ms, 1788ms total)
T2470 480:700 JLINK_IsHalted()  returns FALSE (0000ms, 1788ms total)
T2470 480:802 JLINK_IsHalted()  returns FALSE (0000ms, 1788ms total)
T2470 480:903 JLINK_IsHalted()  returns FALSE (0000ms, 1788ms total)
T2470 481:004 JLINK_IsHalted()  returns FALSE (0000ms, 1788ms total)
T2470 481:104 JLINK_IsHalted()  returns FALSE (0000ms, 1788ms total)
T2470 481:205 JLINK_IsHalted()  returns FALSE (0000ms, 1788ms total)
T2470 481:307 JLINK_IsHalted()  returns FALSE (0000ms, 1788ms total)
T2470 481:407 JLINK_IsHalted()  returns FALSE (0000ms, 1788ms total)
T2470 481:509 JLINK_IsHalted()  returns FALSE (0000ms, 1788ms total)
T2470 481:610 JLINK_IsHalted()  returns FALSE (0000ms, 1788ms total)
T2470 481:711 JLINK_IsHalted()  returns FALSE (0000ms, 1788ms total)
T2470 481:811 JLINK_IsHalted()  returns FALSE (0000ms, 1788ms total)
T2470 481:913 JLINK_IsHalted()  returns FALSE (0000ms, 1788ms total)
T2470 482:014 JLINK_IsHalted()  returns FALSE (0000ms, 1788ms total)
T2470 482:115 JLINK_IsHalted()  returns FALSE (0000ms, 1788ms total)
T2470 482:215 JLINK_IsHalted()  returns FALSE (0000ms, 1788ms total)
T2470 482:316 JLINK_IsHalted()  returns FALSE (0000ms, 1788ms total)
T2470 482:417 JLINK_IsHalted()  returns FALSE (0000ms, 1788ms total)
T2470 482:517 JLINK_IsHalted()  returns FALSE (0000ms, 1788ms total)
T2470 482:619 JLINK_IsHalted()  returns FALSE (0000ms, 1788ms total)
T2470 482:720 JLINK_IsHalted()  returns FALSE (0000ms, 1788ms total)
T2470 482:821 JLINK_IsHalted()  returns FALSE (0000ms, 1788ms total)
T2470 482:921 JLINK_IsHalted()  returns FALSE (0000ms, 1788ms total)
T2470 483:023 JLINK_IsHalted()  returns FALSE (0000ms, 1788ms total)
T2470 483:124 JLINK_IsHalted()  returns FALSE (0000ms, 1788ms total)
T4118 483:205 JLINK_SetBPEx(Addr = 0x08004652, Type = 0xFFFFFFF2) -- CPU is running -- CPU is running -- CPU_WriteMem(4 bytes @ 0xE0002000) -- CPU is running -- CPU_WriteMem(4 bytes @ 0xE0002014)  returns 0x00000012 (0000ms, 1788ms total)
T2470 483:224 JLINK_IsHalted()  returns FALSE (0000ms, 1788ms total)
T2470 483:326 JLINK_IsHalted()  returns FALSE (0000ms, 1788ms total)
T2470 483:427 JLINK_IsHalted()  returns FALSE (0000ms, 1788ms total)
T2470 483:528 JLINK_IsHalted()  returns FALSE (0000ms, 1788ms total)
T2470 483:629 JLINK_IsHalted()  returns FALSE (0000ms, 1788ms total)
T2470 483:730 JLINK_IsHalted()  returns FALSE (0000ms, 1788ms total)
T2470 483:831 JLINK_IsHalted()  returns FALSE (0000ms, 1788ms total)
T2470 483:932 JLINK_IsHalted()  returns FALSE (0000ms, 1788ms total)
T2470 484:032 JLINK_IsHalted()  returns FALSE (0000ms, 1788ms total)
T2470 484:133 JLINK_IsHalted()  returns FALSE (0000ms, 1788ms total)
T2470 484:234 JLINK_IsHalted()  returns FALSE (0000ms, 1788ms total)
T2470 484:335 JLINK_IsHalted()  returns FALSE (0000ms, 1788ms total)
T2470 484:435 JLINK_IsHalted()  returns FALSE (0000ms, 1788ms total)
T2470 484:536 JLINK_IsHalted()  returns FALSE (0000ms, 1788ms total)
T2470 484:637 JLINK_IsHalted()  returns FALSE (0000ms, 1788ms total)
T2470 484:738 JLINK_IsHalted()  returns FALSE (0000ms, 1788ms total)
T2470 484:839 JLINK_IsHalted()  returns FALSE (0000ms, 1788ms total)
T2470 484:940 JLINK_IsHalted()  returns FALSE (0000ms, 1788ms total)
T2470 485:041 JLINK_IsHalted()  returns FALSE (0000ms, 1788ms total)
T2470 485:141 JLINK_IsHalted()  returns FALSE (0000ms, 1788ms total)
T2470 485:242 JLINK_IsHalted()  returns FALSE (0000ms, 1788ms total)
T2470 485:343 JLINK_IsHalted()  returns FALSE (0000ms, 1788ms total)
T2470 485:443 JLINK_IsHalted()  returns FALSE (0000ms, 1788ms total)
T2470 485:544 JLINK_IsHalted()  returns FALSE (0000ms, 1788ms total)
T2470 485:645 JLINK_IsHalted()  returns FALSE (0000ms, 1788ms total)
T2470 485:747 JLINK_IsHalted()  returns FALSE (0000ms, 1788ms total)
T2470 485:848 JLINK_IsHalted()  returns FALSE (0000ms, 1788ms total)
T2470 485:948 JLINK_IsHalted()  returns FALSE (0000ms, 1788ms total)
T2470 486:049 JLINK_IsHalted()  returns FALSE (0000ms, 1788ms total)
T2470 486:151 JLINK_IsHalted()  returns FALSE (0000ms, 1788ms total)
T2470 486:251 JLINK_IsHalted()  returns FALSE (0000ms, 1788ms total)
T2470 486:353 JLINK_IsHalted()  returns FALSE (0000ms, 1788ms total)
T2470 486:454 JLINK_IsHalted()  returns FALSE (0000ms, 1788ms total)
T2470 486:556 JLINK_IsHalted()  returns FALSE (0000ms, 1788ms total)
T2470 486:656 JLINK_IsHalted()  returns FALSE (0000ms, 1788ms total)
T2470 486:757 JLINK_IsHalted()  returns FALSE (0000ms, 1788ms total)
T2470 486:858 JLINK_IsHalted()  returns FALSE (0000ms, 1788ms total)
T2470 486:958 JLINK_IsHalted()  returns FALSE (0000ms, 1788ms total)
T2470 487:059 JLINK_IsHalted()  returns FALSE (0000ms, 1788ms total)
T2470 487:161 JLINK_IsHalted()  returns FALSE (0000ms, 1788ms total)
T2470 487:262 JLINK_IsHalted()  returns FALSE (0000ms, 1788ms total)
T2470 487:363 JLINK_IsHalted()  returns FALSE (0000ms, 1788ms total)
T2470 487:463 JLINK_IsHalted()  returns FALSE (0000ms, 1788ms total)
T2470 487:565 JLINK_IsHalted()  returns FALSE (0000ms, 1788ms total)
T2470 487:666 JLINK_IsHalted()  returns FALSE (0000ms, 1788ms total)
T2470 487:766 JLINK_IsHalted()  returns FALSE (0000ms, 1788ms total)
T2470 487:867 JLINK_IsHalted()  returns FALSE (0000ms, 1788ms total)
T2470 487:968 JLINK_IsHalted()  returns FALSE (0000ms, 1788ms total)
T2470 488:068 JLINK_IsHalted()  returns FALSE (0000ms, 1788ms total)
T2470 488:169 JLINK_IsHalted()  returns FALSE (0000ms, 1788ms total)
T2470 488:270 JLINK_IsHalted()  returns FALSE (0000ms, 1788ms total)
T2470 488:371 JLINK_IsHalted()  returns FALSE (0000ms, 1788ms total)
T2470 488:472 JLINK_IsHalted()  returns FALSE (0000ms, 1788ms total)
T2470 488:580 JLINK_IsHalted()  returns FALSE (0000ms, 1788ms total)
T2470 488:682 JLINK_IsHalted()  returns FALSE (0000ms, 1788ms total)
T2470 488:783 JLINK_IsHalted()  returns FALSE (0000ms, 1788ms total)
T2470 488:884 JLINK_IsHalted()  returns FALSE (0000ms, 1788ms total)
T2470 488:985 JLINK_IsHalted()  returns FALSE (0000ms, 1788ms total)
T2470 489:086 JLINK_IsHalted()  returns FALSE (0000ms, 1788ms total)
T2470 489:188 JLINK_IsHalted()  returns FALSE (0000ms, 1788ms total)
T2470 489:289 JLINK_IsHalted()  returns FALSE (0000ms, 1788ms total)
T2470 489:390 JLINK_IsHalted()  returns FALSE (0000ms, 1788ms total)
T2470 489:492 JLINK_IsHalted()  returns FALSE (0000ms, 1788ms total)
T2470 489:593 JLINK_IsHalted()  returns FALSE (0000ms, 1788ms total)
T2470 489:694 JLINK_IsHalted()  returns FALSE (0000ms, 1788ms total)
T2470 489:795 JLINK_IsHalted()  returns FALSE (0000ms, 1788ms total)
T2470 489:897 JLINK_IsHalted()  returns FALSE (0000ms, 1788ms total)
T2470 489:997 JLINK_IsHalted()  returns FALSE (0000ms, 1788ms total)
T2470 490:098 JLINK_IsHalted()  returns FALSE (0000ms, 1788ms total)
T2470 490:199 JLINK_IsHalted()  returns FALSE (0000ms, 1788ms total)
T2470 490:300 JLINK_IsHalted()  returns FALSE (0000ms, 1788ms total)
T2470 490:401 JLINK_IsHalted()  returns FALSE (0000ms, 1788ms total)
T2470 490:502 JLINK_IsHalted()  returns FALSE (0000ms, 1788ms total)
T2470 490:604 JLINK_IsHalted()  returns FALSE (0000ms, 1788ms total)
T2470 490:705 JLINK_IsHalted()  returns FALSE (0000ms, 1788ms total)
T2470 490:805 JLINK_IsHalted()  returns FALSE (0001ms, 1789ms total)
T2470 490:907 JLINK_IsHalted()  returns FALSE (0000ms, 1788ms total)
T2470 491:008 JLINK_IsHalted()  returns FALSE (0000ms, 1788ms total)
T2470 491:108 JLINK_IsHalted()  returns FALSE (0000ms, 1788ms total)
T2470 491:209 JLINK_IsHalted()  returns FALSE (0000ms, 1788ms total)
T2470 491:310 JLINK_IsHalted()  returns FALSE (0000ms, 1788ms total)
T2470 491:412 JLINK_IsHalted()  returns FALSE (0000ms, 1788ms total)
T2470 491:512 JLINK_IsHalted()  returns FALSE (0000ms, 1788ms total)
T2470 491:613 JLINK_IsHalted()  returns FALSE (0000ms, 1788ms total)
T2470 491:714 JLINK_IsHalted()  returns FALSE (0000ms, 1788ms total)
T2470 491:815 JLINK_IsHalted()  returns FALSE (0000ms, 1788ms total)
T2470 491:915 JLINK_IsHalted()  returns FALSE (0000ms, 1788ms total)
T2470 492:016 JLINK_IsHalted()  returns FALSE (0000ms, 1788ms total)
T2470 492:117 JLINK_IsHalted()  returns FALSE (0000ms, 1788ms total)
T2470 492:218 JLINK_IsHalted()  returns FALSE (0000ms, 1788ms total)
T2470 492:319 JLINK_IsHalted()  returns FALSE (0000ms, 1788ms total)
T2470 492:420 JLINK_IsHalted()  returns FALSE (0000ms, 1788ms total)
T2470 492:522 JLINK_IsHalted()  returns FALSE (0000ms, 1788ms total)
T2470 492:622 JLINK_IsHalted()  returns FALSE (0000ms, 1788ms total)
T2470 492:723 JLINK_IsHalted()  returns FALSE (0001ms, 1789ms total)
T2470 492:825 JLINK_IsHalted()  returns FALSE (0000ms, 1788ms total)
T2470 492:925 JLINK_IsHalted()  returns FALSE (0000ms, 1788ms total)
T2470 493:026 JLINK_IsHalted()  returns FALSE (0000ms, 1788ms total)
T2470 493:127 JLINK_IsHalted()  returns FALSE (0000ms, 1788ms total)
T2470 493:228 JLINK_IsHalted()  returns FALSE (0000ms, 1788ms total)
T2470 493:329 JLINK_IsHalted()  returns FALSE (0000ms, 1788ms total)
T2470 493:430 JLINK_IsHalted()  returns FALSE (0000ms, 1788ms total)
T2470 493:531 JLINK_IsHalted()  returns FALSE (0000ms, 1788ms total)
T2470 493:633 JLINK_IsHalted()  returns FALSE (0000ms, 1788ms total)
T2470 493:734 JLINK_IsHalted()  returns FALSE (0000ms, 1788ms total)
T2470 493:834 JLINK_IsHalted()  returns FALSE (0000ms, 1788ms total)
T2470 493:935 JLINK_IsHalted()  returns FALSE (0000ms, 1788ms total)
T2470 494:036 JLINK_IsHalted()  returns FALSE (0000ms, 1788ms total)
T2470 494:137 JLINK_IsHalted()  returns FALSE (0000ms, 1788ms total)
T2470 494:238 JLINK_IsHalted()  returns FALSE (0000ms, 1788ms total)
T2470 494:339 JLINK_IsHalted()  returns FALSE (0000ms, 1788ms total)
T2470 494:440 JLINK_IsHalted()  returns FALSE (0000ms, 1788ms total)
T2470 494:540 JLINK_IsHalted()  returns FALSE (0000ms, 1788ms total)
T2470 494:641 JLINK_IsHalted()  returns FALSE (0000ms, 1788ms total)
T2470 494:743 JLINK_IsHalted()  returns FALSE (0000ms, 1788ms total)
T2470 494:844 JLINK_IsHalted()  returns FALSE (0000ms, 1788ms total)
T2470 494:945 JLINK_IsHalted()  returns FALSE (0000ms, 1788ms total)
T2470 495:047 JLINK_IsHalted()  returns FALSE (0000ms, 1788ms total)
T2470 495:149 JLINK_IsHalted()  returns FALSE (0000ms, 1788ms total)
T2470 495:249 JLINK_IsHalted()  returns FALSE (0000ms, 1788ms total)
T2470 495:350 JLINK_IsHalted()  returns FALSE (0000ms, 1788ms total)
T2470 495:451 JLINK_IsHalted()  returns FALSE (0000ms, 1788ms total)
T2470 495:552 JLINK_IsHalted()  returns FALSE (0000ms, 1788ms total)
T2470 495:652 JLINK_IsHalted()  returns FALSE (0000ms, 1788ms total)
T2470 495:754 JLINK_IsHalted()  returns FALSE (0000ms, 1788ms total)
T2470 495:855 JLINK_IsHalted()  returns FALSE (0000ms, 1788ms total)
T2470 495:956 JLINK_IsHalted()  returns FALSE (0000ms, 1788ms total)
T2470 496:057 JLINK_IsHalted()  returns FALSE (0000ms, 1788ms total)
T2470 496:158 JLINK_IsHalted()  returns FALSE (0000ms, 1788ms total)
T2470 496:259 JLINK_IsHalted()  returns FALSE (0000ms, 1788ms total)
T2470 496:359 JLINK_IsHalted()  returns FALSE (0000ms, 1788ms total)
T2470 496:460 JLINK_IsHalted()  returns FALSE (0000ms, 1788ms total)
T2470 496:562 JLINK_IsHalted()  returns FALSE (0000ms, 1788ms total)
T2470 496:663 JLINK_IsHalted()  returns FALSE (0000ms, 1788ms total)
T2470 496:764 JLINK_IsHalted()  returns FALSE (0000ms, 1788ms total)
T2470 496:865 JLINK_IsHalted()  returns FALSE (0000ms, 1788ms total)
T2470 496:967 JLINK_IsHalted()  returns FALSE (0000ms, 1788ms total)
T2470 497:067 JLINK_IsHalted()  returns FALSE (0000ms, 1788ms total)
T2470 497:168 JLINK_IsHalted()  returns FALSE (0000ms, 1788ms total)
T2470 497:269 JLINK_IsHalted()  returns FALSE (0000ms, 1788ms total)
T2470 497:370 JLINK_IsHalted()  returns FALSE (0000ms, 1788ms total)
T2470 497:471 JLINK_IsHalted()  returns FALSE (0000ms, 1788ms total)
T2470 497:572 JLINK_IsHalted()  returns FALSE (0000ms, 1788ms total)
T2470 497:673 JLINK_IsHalted()  returns FALSE (0000ms, 1788ms total)
T2470 497:774 JLINK_IsHalted()  returns FALSE (0000ms, 1788ms total)
T2470 497:874 JLINK_IsHalted()  returns FALSE (0000ms, 1788ms total)
T2470 497:976 JLINK_IsHalted()  returns FALSE (0000ms, 1788ms total)
T2470 498:077 JLINK_IsHalted()  returns TRUE (0002ms, 1790ms total)
T2470 498:079 JLINK_Halt()  returns 0x00 (0000ms, 1788ms total)
T2470 498:079 JLINK_IsHalted()  returns TRUE (0000ms, 1788ms total)
T2470 498:079 JLINK_IsHalted()  returns TRUE (0000ms, 1788ms total)
T2470 498:079 JLINK_IsHalted()  returns TRUE (0000ms, 1788ms total)
T2470 498:079 JLINK_ReadReg(R15 (PC))  returns 0x08004652 (0000ms, 1788ms total)
T2470 498:079 JLINK_ReadReg(XPSR)  returns 0x41000000 (0000ms, 1788ms total)
T2470 498:079 JLINK_ClrBPEx(BPHandle = 0x0000000F)  returns 0x00 (0000ms, 1788ms total)
T2470 498:079 JLINK_ClrBPEx(BPHandle = 0x00000010)  returns 0x00 (0000ms, 1788ms total)
T2470 498:079 JLINK_ClrBPEx(BPHandle = 0x00000011)  returns 0x00 (0000ms, 1788ms total)
T2470 498:079 JLINK_ClrBPEx(BPHandle = 0x00000012)  returns 0x00 (0000ms, 1788ms total)
T2470 498:079 JLINK_ReadMemU32(0xE000ED30, 0x0001 Items, ...) -- CPU_ReadMem(4 bytes @ 0xE000ED30) - Data: 02 00 00 00  returns 0x01 (0000ms, 1788ms total)
T2470 498:079 JLINK_ReadMemU32(0xE0001028, 0x0001 Items, ...) -- CPU_ReadMem(4 bytes @ 0xE0001028) - Data: 00 00 00 00  returns 0x01 (0001ms, 1789ms total)
T2470 498:080 JLINK_ReadMemU32(0xE0001038, 0x0001 Items, ...) -- CPU_ReadMem(4 bytes @ 0xE0001038) - Data: 00 02 00 00  returns 0x01 (0001ms, 1790ms total)
T2470 498:081 JLINK_ReadMemU32(0xE0001048, 0x0001 Items, ...) -- CPU_ReadMem(4 bytes @ 0xE0001048) - Data: 00 00 00 00  returns 0x01 (0000ms, 1790ms total)
T2470 498:081 JLINK_ReadMemU32(0xE0001058, 0x0001 Items, ...) -- CPU_ReadMem(4 bytes @ 0xE0001058) - Data: 00 00 00 00  returns 0x01 (0001ms, 1791ms total)
T2470 498:082 JLINK_ReadReg(R0)  returns 0x08006324 (0000ms, 1791ms total)
T2470 498:082 JLINK_ReadReg(R1)  returns 0xFFFFFFD0 (0000ms, 1791ms total)
T2470 498:082 JLINK_ReadReg(R2)  returns 0x00000000 (0000ms, 1791ms total)
T2470 498:082 JLINK_ReadReg(R3)  returns 0x00000000 (0000ms, 1791ms total)
T2470 498:082 JLINK_ReadReg(R4)  returns 0x20002194 (0000ms, 1791ms total)
T2470 498:082 JLINK_ReadReg(R5)  returns 0x00000000 (0000ms, 1791ms total)
T2470 498:082 JLINK_ReadReg(R6)  returns 0x20002194 (0000ms, 1791ms total)
T2470 498:082 JLINK_ReadReg(R7)  returns 0x00000000 (0000ms, 1791ms total)
T2470 498:082 JLINK_ReadReg(R8)  returns 0x20001FBC (0000ms, 1791ms total)
T2470 498:082 JLINK_ReadReg(R9)  returns 0x0000C350 (0000ms, 1791ms total)
T2470 498:082 JLINK_ReadReg(R10)  returns 0x000003E8 (0000ms, 1791ms total)
T2470 498:082 JLINK_ReadReg(R11)  returns 0x00000001 (0000ms, 1791ms total)
T2470 498:082 JLINK_ReadReg(R12)  returns 0x00000000 (0000ms, 1791ms total)
T2470 498:082 JLINK_ReadReg(R13 (SP))  returns 0x20002930 (0000ms, 1791ms total)
T2470 498:082 JLINK_ReadReg(R14)  returns 0x0800464D (0000ms, 1791ms total)
T2470 498:082 JLINK_ReadReg(R15 (PC))  returns 0x08004652 (0000ms, 1791ms total)
T2470 498:082 JLINK_ReadReg(XPSR)  returns 0x41000000 (0000ms, 1791ms total)
T2470 498:082 JLINK_ReadReg(MSP)  returns 0x20002930 (0000ms, 1791ms total)
T2470 498:082 JLINK_ReadReg(PSP)  returns 0xAEAA5364 (0000ms, 1791ms total)
T2470 498:082 JLINK_ReadReg(CFBP)  returns 0x00000000 (0000ms, 1791ms total)
T4118 498:082 JLINK_ReadMemEx(0x20002944, 0x0004 Bytes, ..., Flags = 0x02000000) -- CPU_ReadMem(64 bytes @ 0x20002940) -- Updating C cache (64 bytes @ 0x20002940) -- Read from C cache (4 bytes @ 0x20002944) - Data: 47 50 00 08  returns 0x04 (0001ms, 1792ms total)
T4118 498:083 JLINK_ReadMemEx(0x20002934, 0x0004 Bytes, ..., Flags = 0x02000000) -- CPU_ReadMem(64 bytes @ 0x20002900) -- Updating C cache (64 bytes @ 0x20002900) -- Read from C cache (4 bytes @ 0x20002934) - Data: 00 00 00 20  returns 0x04 (0001ms, 1793ms total)
T4118 498:084 JLINK_ReadMemEx(0x20002938, 0x0004 Bytes, ..., Flags = 0x02000000) -- Read from C cache (4 bytes @ 0x20002938) - Data: 00 00 00 00  returns 0x04 (0000ms, 1793ms total)
T4118 498:084 JLINK_ReadMemEx(0x2000293C, 0x0004 Bytes, ..., Flags = 0x02000000) -- Read from C cache (4 bytes @ 0x2000293C) - Data: 00 00 00 00  returns 0x04 (0000ms, 1793ms total)
T4118 498:084 JLINK_ReadMemEx(0x20002940, 0x0004 Bytes, ..., Flags = 0x02000000) -- Read from C cache (4 bytes @ 0x20002940) - Data: 00 00 00 00  returns 0x04 (0000ms, 1793ms total)
T4118 498:084 JLINK_ReadMemEx(0x20002930, 0x0004 Bytes, ..., Flags = 0x02000000) -- Read from C cache (4 bytes @ 0x20002930) - Data: 00 00 00 00  returns 0x04 (0000ms, 1793ms total)
T4118 498:084 JLINK_ReadMemEx(0x00000000, 0x0001 Bytes, ..., Flags = 0x02000000) -- CPU_ReadMem(4 bytes @ 0x00000004) -- CPU_ReadMem(64 bytes @ 0x08000000) -- Updating C cache (64 bytes @ 0x08000000) -- Read from C cache (1 bytes @ 0x08000000) - Data: 48  returns 0x01 (0001ms, 1794ms total)
T4118 498:085 JLINK_ReadMemEx(0x20002194, 0x0020 Bytes, ..., Flags = 0x02000000) -- CPU_ReadMem(64 bytes @ 0x20002180) -- Updating C cache (64 bytes @ 0x20002180) -- Read from C cache (32 bytes @ 0x20002194) - Data: 4D 53 3A 63 6F 6E 74 69 73 00 00 00 00 00 00 00 ...  returns 0x20 (0001ms, 1795ms total)
T4118 498:086 JLINK_ReadMemEx(0x00000000, 0x0004 Bytes, ..., Flags = 0x02000000) -- Read from C cache (4 bytes @ 0x08000000) - Data: 48 29 00 20  returns 0x04 (0000ms, 1795ms total)
T4118 498:087 JLINK_ReadMemEx(0x20000024, 0x0002 Bytes, ..., Flags = 0x02000000) -- CPU_ReadMem(64 bytes @ 0x20000000) -- Updating C cache (64 bytes @ 0x20000000) -- Read from C cache (2 bytes @ 0x20000024) - Data: 00 00  returns 0x02 (0001ms, 1796ms total)
T4118 498:093 JLINK_ReadMemEx(0x20002214, 0x0001 Bytes, ..., Flags = 0x02000000) -- CPU_ReadMem(64 bytes @ 0x20002200) -- Updating C cache (64 bytes @ 0x20002200) -- Read from C cache (1 bytes @ 0x20002214) - Data: 09  returns 0x01 (0000ms, 1796ms total)
T4118 498:094 JLINK_ReadMemEx(0x20002215, 0x0001 Bytes, ..., Flags = 0x02000000) -- Read from C cache (1 bytes @ 0x20002215) - Data: 01  returns 0x01 (0000ms, 1796ms total)
T4118 498:094 JLINK_ReadMemEx(0x08004652, 0x0002 Bytes, ..., Flags = 0x02000000) -- CPU_ReadMem(64 bytes @ 0x08004640) -- Updating C cache (64 bytes @ 0x08004640) -- Read from C cache (2 bytes @ 0x08004652) - Data: 41 68  returns 0x02 (0001ms, 1797ms total)
T4118 498:095 JLINK_ReadMemEx(0x08004654, 0x003C Bytes, ..., Flags = 0x02000000) -- CPU_ReadMem(64 bytes @ 0x08004680) -- Updating C cache (64 bytes @ 0x08004680) -- Read from C cache (60 bytes @ 0x08004654) - Data: 00 98 88 47 96 F8 80 10 20 46 FB F7 63 FF FF F7 ...  returns 0x3C (0000ms, 1797ms total)
T4118 505:611 JLINK_SetResetType(JLINKARM_CM3_RESET_TYPE_NORMAL)  returns JLINKARM_CM3_RESET_TYPE_NORMAL (0000ms, 1797ms total)
T4118 505:611 JLINK_Reset() -- CPU_WriteMem(4 bytes @ 0xE000EDF0) -- CPU_WriteMem(4 bytes @ 0xE000EDFC)Reset: Halt core after reset via DEMCR.VC_CORERESET. >0x35 TIF>Reset: Reset device via AIRCR.SYSRESETREQ. -- CPU_WriteMem(4 bytes @ 0xE000ED0C) >0x0D TIF> >0x28 TIF> -- CPU_ReadMem(4 bytes @ 0xE000EDF0) -- CPU_ReadMem(4 bytes @ 0xE000EDF0) -- CPU_WriteMem(4 bytes @ 0xE000EDF0) -- CPU_WriteMem(4 bytes @ 0xE000EDFC) -- CPU_ReadMem(4 bytes @ 0xE000EDF0) -- CPU_WriteMem(4 bytes @ 0xE0002000)
 -- CPU_ReadMem(4 bytes @ 0xE000EDFC) -- CPU_ReadMem(4 bytes @ 0xE0001000) (0063ms, 1860ms total)
T4118 505:675 JLINK_ReadReg(R15 (PC))  returns 0x080001A8 (0000ms, 1860ms total)
T4118 505:675 JLINK_ReadReg(XPSR)  returns 0x01000000 (0000ms, 1860ms total)
T4118 505:676 JLINK_ReadMemEx(0x080001A8, 0x003C Bytes, ..., Flags = 0x02000000) -- CPU_ReadMem(128 bytes @ 0x08000180) -- Updating C cache (128 bytes @ 0x08000180) -- Read from C cache (60 bytes @ 0x080001A8) - Data: 09 48 80 47 09 48 00 47 FE E7 FE E7 FE E7 FE E7 ...  returns 0x3C (0000ms, 1860ms total)
T4118 505:765 JLINK_ReadReg(R0)  returns 0x08006324 (0000ms, 1860ms total)
T4118 505:765 JLINK_ReadReg(R1)  returns 0xFFFFFFD0 (0000ms, 1860ms total)
T4118 505:765 JLINK_ReadReg(R2)  returns 0x00000000 (0000ms, 1860ms total)
T4118 505:765 JLINK_ReadReg(R3)  returns 0x00000000 (0000ms, 1860ms total)
T4118 505:765 JLINK_ReadReg(R4)  returns 0x20002194 (0000ms, 1860ms total)
T4118 505:765 JLINK_ReadReg(R5)  returns 0x00000000 (0000ms, 1860ms total)
T4118 505:765 JLINK_ReadReg(R6)  returns 0x20002194 (0000ms, 1860ms total)
T4118 505:766 JLINK_ReadReg(R7)  returns 0x00000000 (0000ms, 1861ms total)
T4118 505:766 JLINK_ReadReg(R8)  returns 0x20001FBC (0000ms, 1861ms total)
T4118 505:766 JLINK_ReadReg(R9)  returns 0x0000C350 (0000ms, 1861ms total)
T4118 505:766 JLINK_ReadReg(R10)  returns 0x000003E8 (0000ms, 1861ms total)
T4118 505:766 JLINK_ReadReg(R11)  returns 0x00000001 (0000ms, 1861ms total)
T4118 505:766 JLINK_ReadReg(R12)  returns 0x00000000 (0000ms, 1861ms total)
T4118 505:766 JLINK_ReadReg(R13 (SP))  returns 0x20002948 (0000ms, 1861ms total)
T4118 505:766 JLINK_ReadReg(R14)  returns 0xFFFFFFFF (0000ms, 1861ms total)
T4118 505:766 JLINK_ReadReg(R15 (PC))  returns 0x080001A8 (0000ms, 1861ms total)
T4118 505:766 JLINK_ReadReg(XPSR)  returns 0x01000000 (0000ms, 1861ms total)
T4118 505:766 JLINK_ReadReg(MSP)  returns 0x20002948 (0000ms, 1861ms total)
T4118 505:766 JLINK_ReadReg(PSP)  returns 0xAEAA5364 (0000ms, 1861ms total)
T4118 505:766 JLINK_ReadReg(CFBP)  returns 0x00000000 (0000ms, 1861ms total)
T4118 505:766 JLINK_ReadMemEx(0x20000024, 0x0002 Bytes, ..., Flags = 0x02000000) -- CPU_ReadMem(64 bytes @ 0x20000000) -- Updating C cache (64 bytes @ 0x20000000) -- Read from C cache (2 bytes @ 0x20000024) - Data: 00 00  returns 0x02 (0000ms, 1861ms total)
T4118 505:768 JLINK_ReadMemEx(0x20002194, 0x0020 Bytes, ..., Flags = 0x02000000) -- CPU_ReadMem(64 bytes @ 0x20002180) -- Updating C cache (64 bytes @ 0x20002180) -- Read from C cache (32 bytes @ 0x20002194) - Data: 4D 53 3A 63 6F 6E 74 69 73 00 00 00 00 00 00 00 ...  returns 0x20 (0000ms, 1861ms total)
T4118 505:768 JLINK_ReadMemEx(0x20002214, 0x0001 Bytes, ..., Flags = 0x02000000) -- CPU_ReadMem(64 bytes @ 0x20002200) -- Updating C cache (64 bytes @ 0x20002200) -- Read from C cache (1 bytes @ 0x20002214) - Data: 09  returns 0x01 (0001ms, 1862ms total)
T4118 505:769 JLINK_ReadMemEx(0x20002215, 0x0001 Bytes, ..., Flags = 0x02000000) -- Read from C cache (1 bytes @ 0x20002215) - Data: 01  returns 0x01 (0000ms, 1862ms total)
T2470 506:156 JLINK_ReadMemEx(0x080001A8, 0x0002 Bytes, ..., Flags = 0x02000000) -- Read from C cache (2 bytes @ 0x080001A8) - Data: 09 48  returns 0x02 (0000ms, 1862ms total)
T2470 506:156 JLINK_SetBPEx(Addr = 0x0800215E, Type = 0xFFFFFFF2)  returns 0x00000013 (0000ms, 1862ms total)
T2470 506:156 JLINK_SetBPEx(Addr = 0x08002164, Type = 0xFFFFFFF2)  returns 0x00000014 (0000ms, 1862ms total)
T2470 506:156 JLINK_SetBPEx(Addr = 0x0800456A, Type = 0xFFFFFFF2)  returns 0x00000015 (0000ms, 1862ms total)
T2470 506:156 JLINK_Go() -- CPU_WriteMem(4 bytes @ 0xE0002000) -- CPU_WriteMem(4 bytes @ 0xE0002000) -- CPU_WriteMem(4 bytes @ 0xE0002000) -- CPU_ReadMem(4 bytes @ 0xE0001000) -- CPU_WriteMem(4 bytes @ 0xE0002008) -- CPU_WriteMem(4 bytes @ 0xE000200C) -- CPU_WriteMem(4 bytes @ 0xE0002010) -- CPU_WriteMem(4 bytes @ 0xE0002014) -- CPU_WriteMem(4 bytes @ 0xE0002018) -- CPU_WriteMem(4 bytes @ 0xE000201C) -- CPU_WriteMem(4 bytes @ 0xE0001004) (0003ms, 1865ms total)
T2470 506:260 JLINK_IsHalted()  returns FALSE (0000ms, 1865ms total)
T2470 506:361 JLINK_IsHalted()  returns FALSE (0000ms, 1865ms total)
T2470 506:462 JLINK_IsHalted()  returns FALSE (0000ms, 1865ms total)
T2470 506:563 JLINK_IsHalted()  returns FALSE (0000ms, 1865ms total)
T2470 506:665 JLINK_IsHalted()  returns FALSE (0000ms, 1865ms total)
T2470 506:766 JLINK_IsHalted()  returns FALSE (0000ms, 1865ms total)
T2470 506:866 JLINK_IsHalted()  returns FALSE (0000ms, 1865ms total)
T2470 506:967 JLINK_IsHalted()  returns FALSE (0000ms, 1865ms total)
T2470 507:068 JLINK_IsHalted()  returns FALSE (0000ms, 1865ms total)
T2470 507:169 JLINK_IsHalted()  returns FALSE (0000ms, 1865ms total)
T2470 507:270 JLINK_IsHalted()  returns FALSE (0000ms, 1865ms total)
T2470 507:371 JLINK_IsHalted()  returns FALSE (0000ms, 1865ms total)
T2470 507:472 JLINK_IsHalted()  returns FALSE (0000ms, 1865ms total)
T2470 507:573 JLINK_IsHalted()  returns FALSE (0000ms, 1865ms total)
T2470 507:673 JLINK_IsHalted()  returns FALSE (0000ms, 1865ms total)
T2470 507:775 JLINK_IsHalted()  returns FALSE (0000ms, 1865ms total)
T2470 507:876 JLINK_IsHalted()  returns FALSE (0000ms, 1865ms total)
T2470 507:976 JLINK_IsHalted()  returns FALSE (0000ms, 1865ms total)
T2470 508:077 JLINK_IsHalted()  returns FALSE (0000ms, 1865ms total)
T2470 508:178 JLINK_IsHalted()  returns FALSE (0000ms, 1865ms total)
T2470 508:279 JLINK_IsHalted()  returns FALSE (0000ms, 1865ms total)
T2470 508:380 JLINK_IsHalted()  returns FALSE (0000ms, 1865ms total)
T2470 508:482 JLINK_IsHalted()  returns FALSE (0000ms, 1865ms total)
T2470 508:583 JLINK_IsHalted()  returns FALSE (0000ms, 1865ms total)
T2470 508:684 JLINK_IsHalted()  returns FALSE (0000ms, 1865ms total)
T2470 508:785 JLINK_IsHalted()  returns FALSE (0000ms, 1865ms total)
T2470 508:886 JLINK_IsHalted()  returns FALSE (0000ms, 1865ms total)
T2470 508:987 JLINK_IsHalted()  returns FALSE (0000ms, 1865ms total)
T2470 509:088 JLINK_IsHalted()  returns FALSE (0000ms, 1865ms total)
T2470 509:189 JLINK_IsHalted()  returns FALSE (0000ms, 1865ms total)
T2470 509:291 JLINK_IsHalted()  returns FALSE (0000ms, 1865ms total)
T2470 509:391 JLINK_IsHalted()  returns FALSE (0000ms, 1865ms total)
T2470 509:492 JLINK_IsHalted()  returns FALSE (0000ms, 1865ms total)
T2470 509:593 JLINK_IsHalted()  returns FALSE (0000ms, 1865ms total)
T2470 509:694 JLINK_IsHalted()  returns FALSE (0000ms, 1865ms total)
T2470 509:794 JLINK_IsHalted()  returns FALSE (0000ms, 1865ms total)
T2470 509:895 JLINK_IsHalted()  returns FALSE (0000ms, 1865ms total)
T2470 509:996 JLINK_IsHalted()  returns FALSE (0000ms, 1865ms total)
T2470 510:097 JLINK_IsHalted()  returns FALSE (0000ms, 1865ms total)
T2470 510:197 JLINK_IsHalted()  returns FALSE (0000ms, 1865ms total)
T2470 510:298 JLINK_IsHalted()  returns FALSE (0000ms, 1865ms total)
T2470 510:399 JLINK_IsHalted()  returns FALSE (0000ms, 1865ms total)
T2470 510:501 JLINK_IsHalted()  returns FALSE (0000ms, 1865ms total)
T2470 510:602 JLINK_IsHalted()  returns FALSE (0000ms, 1865ms total)
T2470 510:703 JLINK_IsHalted()  returns FALSE (0000ms, 1865ms total)
T2470 510:804 JLINK_IsHalted()  returns FALSE (0000ms, 1865ms total)
T2470 510:905 JLINK_IsHalted()  returns FALSE (0000ms, 1865ms total)
T2470 511:005 JLINK_IsHalted()  returns FALSE (0000ms, 1865ms total)
T2470 511:106 JLINK_IsHalted()  returns FALSE (0000ms, 1865ms total)
T2470 511:207 JLINK_IsHalted()  returns FALSE (0000ms, 1865ms total)
T2470 511:307 JLINK_IsHalted()  returns FALSE (0000ms, 1865ms total)
T2470 511:408 JLINK_IsHalted()  returns FALSE (0000ms, 1865ms total)
T2470 511:510 JLINK_IsHalted()  returns FALSE (0000ms, 1865ms total)
T2470 511:611 JLINK_IsHalted()  returns FALSE (0000ms, 1865ms total)
T2470 511:711 JLINK_IsHalted()  returns FALSE (0000ms, 1865ms total)
T2470 511:812 JLINK_IsHalted()  returns FALSE (0000ms, 1865ms total)
T2470 511:914 JLINK_IsHalted()  returns FALSE (0000ms, 1865ms total)
T2470 512:015 JLINK_IsHalted()  returns FALSE (0000ms, 1865ms total)
T2470 512:115 JLINK_IsHalted()  returns FALSE (0000ms, 1865ms total)
T2470 512:216 JLINK_IsHalted()  returns FALSE (0000ms, 1865ms total)
T2470 512:317 JLINK_IsHalted()  returns FALSE (0000ms, 1865ms total)
T2470 512:417 JLINK_IsHalted()  returns FALSE (0000ms, 1865ms total)
T2470 512:518 JLINK_IsHalted()  returns FALSE (0000ms, 1865ms total)
T2470 512:620 JLINK_IsHalted()  returns FALSE (0000ms, 1865ms total)
T2470 512:721 JLINK_IsHalted()  returns FALSE (0000ms, 1865ms total)
T2470 512:821 JLINK_IsHalted()  returns FALSE (0000ms, 1865ms total)
T2470 512:922 JLINK_IsHalted()  returns FALSE (0000ms, 1865ms total)
T2470 513:024 JLINK_IsHalted()  returns FALSE (0000ms, 1865ms total)
T2470 513:125 JLINK_IsHalted()  returns FALSE (0000ms, 1865ms total)
T2470 513:226 JLINK_IsHalted()  returns FALSE (0000ms, 1865ms total)
T2470 513:327 JLINK_IsHalted()  returns FALSE (0000ms, 1865ms total)
T2470 513:428 JLINK_IsHalted()  returns FALSE (0000ms, 1865ms total)
T2470 513:528 JLINK_IsHalted()  returns FALSE (0000ms, 1865ms total)
T2470 513:629 JLINK_IsHalted()  returns FALSE (0000ms, 1865ms total)
T2470 513:730 JLINK_IsHalted()  returns FALSE (0000ms, 1865ms total)
T2470 513:831 JLINK_IsHalted()  returns FALSE (0000ms, 1865ms total)
T2470 513:932 JLINK_IsHalted()  returns FALSE (0000ms, 1865ms total)
T2470 514:033 JLINK_IsHalted()  returns FALSE (0000ms, 1865ms total)
T2470 514:135 JLINK_IsHalted()  returns FALSE (0000ms, 1865ms total)
T2470 514:236 JLINK_IsHalted()  returns FALSE (0000ms, 1865ms total)
T2470 514:336 JLINK_IsHalted()  returns FALSE (0000ms, 1865ms total)
T2470 514:437 JLINK_IsHalted()  returns FALSE (0000ms, 1865ms total)
T2470 514:539 JLINK_IsHalted()  returns FALSE (0000ms, 1865ms total)
T2470 514:640 JLINK_IsHalted()  returns FALSE (0000ms, 1865ms total)
T2470 514:741 JLINK_IsHalted()  returns FALSE (0000ms, 1865ms total)
T2470 514:842 JLINK_IsHalted()  returns FALSE (0000ms, 1865ms total)
T2470 514:943 JLINK_IsHalted()  returns FALSE (0000ms, 1865ms total)
T2470 515:044 JLINK_IsHalted()  returns FALSE (0000ms, 1865ms total)
T2470 515:144 JLINK_IsHalted()  returns FALSE (0000ms, 1865ms total)
T2470 515:245 JLINK_IsHalted()  returns FALSE (0000ms, 1865ms total)
T2470 515:346 JLINK_IsHalted()  returns FALSE (0000ms, 1865ms total)
T2470 515:446 JLINK_IsHalted()  returns FALSE (0000ms, 1865ms total)
T2470 515:547 JLINK_IsHalted()  returns FALSE (0000ms, 1865ms total)
T2470 515:648 JLINK_IsHalted()  returns FALSE (0000ms, 1865ms total)
T2470 515:749 JLINK_IsHalted()  returns FALSE (0000ms, 1865ms total)
T2470 515:850 JLINK_IsHalted()  returns FALSE (0000ms, 1865ms total)
T2470 515:951 JLINK_IsHalted()  returns FALSE (0000ms, 1865ms total)
T2470 516:053 JLINK_IsHalted()  returns FALSE (0000ms, 1865ms total)
T2470 516:154 JLINK_IsHalted()  returns FALSE (0000ms, 1865ms total)
T2470 516:254 JLINK_IsHalted()  returns FALSE (0000ms, 1865ms total)
T2470 516:356 JLINK_IsHalted()  returns FALSE (0000ms, 1865ms total)
T2470 516:457 JLINK_IsHalted()  returns FALSE (0000ms, 1865ms total)
T2470 516:557 JLINK_IsHalted()  returns FALSE (0000ms, 1865ms total)
T2470 516:659 JLINK_IsHalted()  returns FALSE (0000ms, 1865ms total)
T2470 516:761 JLINK_IsHalted()  returns FALSE (0000ms, 1865ms total)
T2470 516:862 JLINK_IsHalted()  returns FALSE (0000ms, 1865ms total)
T2470 516:963 JLINK_IsHalted()  returns FALSE (0000ms, 1865ms total)
T2470 517:064 JLINK_IsHalted()  returns FALSE (0000ms, 1865ms total)
T2470 517:165 JLINK_IsHalted()  returns FALSE (0000ms, 1865ms total)
T2470 517:266 JLINK_IsHalted()  returns FALSE (0000ms, 1865ms total)
T2470 517:366 JLINK_IsHalted()  returns FALSE (0000ms, 1865ms total)
T2470 517:468 JLINK_IsHalted()  returns FALSE (0000ms, 1865ms total)
T2470 517:569 JLINK_IsHalted()  returns FALSE (0000ms, 1865ms total)
T2470 517:670 JLINK_IsHalted()  returns FALSE (0000ms, 1865ms total)
T2470 517:771 JLINK_IsHalted()  returns FALSE (0000ms, 1865ms total)
T2470 517:872 JLINK_IsHalted()  returns FALSE (0000ms, 1865ms total)
T2470 517:974 JLINK_IsHalted()  returns FALSE (0000ms, 1865ms total)
T2470 518:074 JLINK_IsHalted()  returns FALSE (0000ms, 1865ms total)
T2470 518:175 JLINK_IsHalted()  returns FALSE (0000ms, 1865ms total)
T2470 518:276 JLINK_IsHalted()  returns FALSE (0000ms, 1865ms total)
T2470 518:377 JLINK_IsHalted()  returns FALSE (0000ms, 1865ms total)
T2470 518:478 JLINK_IsHalted()  returns FALSE (0000ms, 1865ms total)
T2470 518:579 JLINK_IsHalted()  returns FALSE (0000ms, 1865ms total)
T2470 518:680 JLINK_IsHalted()  returns FALSE (0000ms, 1865ms total)
T2470 518:781 JLINK_IsHalted()  returns FALSE (0000ms, 1865ms total)
T2470 518:882 JLINK_IsHalted()  returns FALSE (0000ms, 1865ms total)
T2470 518:983 JLINK_IsHalted()  returns FALSE (0000ms, 1865ms total)
T2470 519:084 JLINK_IsHalted()  returns FALSE (0000ms, 1865ms total)
T2470 519:184 JLINK_IsHalted()  returns FALSE (0000ms, 1865ms total)
T2470 519:285 JLINK_IsHalted()  returns FALSE (0000ms, 1865ms total)
T2470 519:386 JLINK_IsHalted()  returns FALSE (0000ms, 1865ms total)
T2470 519:487 JLINK_IsHalted()  returns FALSE (0000ms, 1865ms total)
T2470 519:588 JLINK_IsHalted()  returns FALSE (0000ms, 1865ms total)
T2470 519:689 JLINK_IsHalted()  returns FALSE (0000ms, 1865ms total)
T2470 519:790 JLINK_IsHalted()  returns FALSE (0000ms, 1865ms total)
T2470 519:890 JLINK_IsHalted()  returns FALSE (0000ms, 1865ms total)
T2470 519:991 JLINK_IsHalted()  returns FALSE (0000ms, 1865ms total)
T2470 520:092 JLINK_IsHalted()  returns FALSE (0000ms, 1865ms total)
T2470 520:194 JLINK_IsHalted()  returns FALSE (0000ms, 1865ms total)
T2470 520:294 JLINK_IsHalted()  returns FALSE (0000ms, 1865ms total)
T2470 520:395 JLINK_IsHalted()  returns FALSE (0000ms, 1865ms total)
T2470 520:496 JLINK_IsHalted()  returns FALSE (0000ms, 1865ms total)
T2470 520:598 JLINK_IsHalted()  returns FALSE (0000ms, 1865ms total)
T2470 520:698 JLINK_IsHalted()  returns FALSE (0000ms, 1865ms total)
T2470 520:799 JLINK_IsHalted()  returns FALSE (0000ms, 1865ms total)
T2470 520:900 JLINK_IsHalted()  returns FALSE (0000ms, 1865ms total)
T2470 521:001 JLINK_IsHalted()  returns FALSE (0000ms, 1865ms total)
T2470 521:101 JLINK_IsHalted()  returns FALSE (0000ms, 1865ms total)
T2470 521:202 JLINK_IsHalted()  returns FALSE (0000ms, 1865ms total)
T2470 521:303 JLINK_IsHalted()  returns FALSE (0000ms, 1865ms total)
T2470 521:403 JLINK_IsHalted()  returns FALSE (0000ms, 1865ms total)
T2470 521:504 JLINK_IsHalted()  returns FALSE (0000ms, 1865ms total)
T2470 521:606 JLINK_IsHalted()  returns FALSE (0000ms, 1865ms total)
T2470 521:707 JLINK_IsHalted()  returns FALSE (0000ms, 1865ms total)
T2470 521:807 JLINK_IsHalted()  returns FALSE (0000ms, 1865ms total)
T2470 521:908 JLINK_IsHalted()  returns FALSE (0000ms, 1865ms total)
T2470 522:009 JLINK_IsHalted()  returns FALSE (0000ms, 1865ms total)
T2470 522:110 JLINK_IsHalted()  returns FALSE (0000ms, 1865ms total)
T2470 522:210 JLINK_IsHalted()  returns FALSE (0000ms, 1865ms total)
T2470 522:311 JLINK_IsHalted()  returns FALSE (0000ms, 1865ms total)
T2470 522:412 JLINK_IsHalted()  returns FALSE (0000ms, 1865ms total)
T2470 522:513 JLINK_IsHalted()  returns FALSE (0000ms, 1865ms total)
T2470 522:613 JLINK_IsHalted()  returns FALSE (0000ms, 1865ms total)
T2470 522:714 JLINK_IsHalted()  returns FALSE (0000ms, 1865ms total)
T2470 522:815 JLINK_IsHalted()  returns FALSE (0000ms, 1865ms total)
T2470 522:915 JLINK_IsHalted()  returns FALSE (0000ms, 1865ms total)
T2470 523:016 JLINK_IsHalted()  returns FALSE (0000ms, 1865ms total)
T2470 523:118 JLINK_IsHalted()  returns FALSE (0000ms, 1865ms total)
T2470 523:219 JLINK_IsHalted()  returns FALSE (0000ms, 1865ms total)
T2470 523:319 JLINK_IsHalted()  returns FALSE (0000ms, 1865ms total)
T2470 523:420 JLINK_IsHalted()  returns FALSE (0000ms, 1865ms total)
T2470 523:521 JLINK_IsHalted()  returns FALSE (0000ms, 1865ms total)
T2470 523:621 JLINK_IsHalted()  returns FALSE (0000ms, 1865ms total)
T2470 523:722 JLINK_IsHalted()  returns FALSE (0000ms, 1865ms total)
T2470 523:823 JLINK_IsHalted()  returns FALSE (0000ms, 1865ms total)
T2470 523:924 JLINK_IsHalted()  returns FALSE (0000ms, 1865ms total)
T2470 524:024 JLINK_IsHalted()  returns FALSE (0000ms, 1865ms total)
T2470 524:125 JLINK_IsHalted()  returns FALSE (0000ms, 1865ms total)
T2470 524:226 JLINK_IsHalted()  returns FALSE (0000ms, 1865ms total)
T2470 524:327 JLINK_IsHalted()  returns FALSE (0000ms, 1865ms total)
T2470 524:427 JLINK_IsHalted()  returns FALSE (0000ms, 1865ms total)
T2470 524:529 JLINK_IsHalted()  returns FALSE (0000ms, 1865ms total)
T2470 524:630 JLINK_IsHalted()  returns FALSE (0000ms, 1865ms total)
T2470 524:731 JLINK_IsHalted()  returns FALSE (0000ms, 1865ms total)
T2470 524:831 JLINK_IsHalted()  returns FALSE (0000ms, 1865ms total)
T2470 524:933 JLINK_IsHalted()  returns FALSE (0000ms, 1865ms total)
T2470 525:034 JLINK_IsHalted()  returns FALSE (0000ms, 1865ms total)
T2470 525:135 JLINK_IsHalted()  returns FALSE (0000ms, 1865ms total)
T2470 525:236 JLINK_IsHalted()  returns FALSE (0000ms, 1865ms total)
T2470 525:338 JLINK_IsHalted()  returns FALSE (0000ms, 1865ms total)
T2470 525:439 JLINK_IsHalted()  returns FALSE (0000ms, 1865ms total)
T2470 525:539 JLINK_IsHalted()  returns FALSE (0000ms, 1865ms total)
T2470 525:640 JLINK_IsHalted()  returns FALSE (0000ms, 1865ms total)
T2470 525:742 JLINK_IsHalted()  returns FALSE (0000ms, 1865ms total)
T2470 525:843 JLINK_IsHalted()  returns FALSE (0000ms, 1865ms total)
T2470 525:943 JLINK_IsHalted()  returns FALSE (0000ms, 1865ms total)
T2470 526:044 JLINK_IsHalted()  returns FALSE (0000ms, 1865ms total)
T2470 526:145 JLINK_IsHalted()  returns FALSE (0000ms, 1865ms total)
T2470 526:246 JLINK_IsHalted()  returns FALSE (0000ms, 1865ms total)
T2470 526:347 JLINK_IsHalted()  returns FALSE (0000ms, 1865ms total)
T2470 526:448 JLINK_IsHalted()  returns FALSE (0000ms, 1865ms total)
T2470 526:549 JLINK_IsHalted()  returns FALSE (0000ms, 1865ms total)
T2470 526:650 JLINK_IsHalted()  returns FALSE (0000ms, 1865ms total)
T2470 526:751 JLINK_IsHalted()  returns FALSE (0000ms, 1865ms total)
T2470 526:853 JLINK_IsHalted()  returns FALSE (0000ms, 1865ms total)
T2470 526:954 JLINK_IsHalted()  returns FALSE (0000ms, 1865ms total)
T2470 527:054 JLINK_IsHalted()  returns FALSE (0000ms, 1865ms total)
T2470 527:156 JLINK_IsHalted()  returns FALSE (0000ms, 1865ms total)
T2470 527:257 JLINK_IsHalted()  returns FALSE (0000ms, 1865ms total)
T2470 527:358 JLINK_IsHalted()  returns FALSE (0000ms, 1865ms total)
T2470 527:458 JLINK_IsHalted()  returns FALSE (0000ms, 1865ms total)
T2470 527:559 JLINK_IsHalted()  returns FALSE (0000ms, 1865ms total)
T2470 527:660 JLINK_IsHalted()  returns FALSE (0000ms, 1865ms total)
T2470 527:760 JLINK_IsHalted()  returns FALSE (0000ms, 1865ms total)
T2470 527:861 JLINK_IsHalted()  returns FALSE (0001ms, 1866ms total)
T2470 527:963 JLINK_IsHalted()  returns FALSE (0000ms, 1865ms total)
T2470 528:064 JLINK_IsHalted()  returns FALSE (0000ms, 1865ms total)
T2470 528:164 JLINK_IsHalted()  returns FALSE (0000ms, 1865ms total)
T2470 528:265 JLINK_IsHalted()  returns FALSE (0000ms, 1865ms total)
T2470 528:366 JLINK_IsHalted()  returns FALSE (0000ms, 1865ms total)
T2470 528:467 JLINK_IsHalted()  returns FALSE (0000ms, 1865ms total)
T2470 528:567 JLINK_IsHalted()  returns FALSE (0000ms, 1865ms total)
T2470 528:668 JLINK_IsHalted()  returns FALSE (0000ms, 1865ms total)
T2470 528:770 JLINK_IsHalted()  returns FALSE (0000ms, 1865ms total)
T2470 528:870 JLINK_IsHalted()  returns FALSE (0000ms, 1865ms total)
T2470 528:971 JLINK_IsHalted()  returns FALSE (0000ms, 1865ms total)
T2470 529:072 JLINK_IsHalted()  returns FALSE (0000ms, 1865ms total)
T2470 529:173 JLINK_IsHalted()  returns FALSE (0000ms, 1865ms total)
T2470 529:274 JLINK_IsHalted()  returns FALSE (0000ms, 1865ms total)
T2470 529:375 JLINK_IsHalted()  returns FALSE (0000ms, 1865ms total)
T2470 529:476 JLINK_IsHalted()  returns FALSE (0000ms, 1865ms total)
T2470 529:577 JLINK_IsHalted()  returns FALSE (0000ms, 1865ms total)
T2470 529:677 JLINK_IsHalted()  returns FALSE (0000ms, 1865ms total)
T2470 529:779 JLINK_IsHalted()  returns FALSE (0000ms, 1865ms total)
T2470 529:880 JLINK_IsHalted()  returns FALSE (0000ms, 1865ms total)
T2470 529:980 JLINK_IsHalted()  returns FALSE (0000ms, 1865ms total)
T2470 530:081 JLINK_IsHalted()  returns FALSE (0000ms, 1865ms total)
T2470 530:183 JLINK_IsHalted()  returns FALSE (0000ms, 1865ms total)
T2470 530:284 JLINK_IsHalted()  returns FALSE (0000ms, 1865ms total)
T2470 530:385 JLINK_IsHalted()  returns FALSE (0000ms, 1865ms total)
T4118 530:481 JLINK_SetBPEx(Addr = 0x08004632, Type = 0xFFFFFFF2) -- CPU is running -- CPU is running -- CPU_WriteMem(4 bytes @ 0xE0002000) -- CPU is running -- CPU_WriteMem(4 bytes @ 0xE0002014)  returns 0x00000016 (0001ms, 1866ms total)
T2470 530:486 JLINK_IsHalted()  returns FALSE (0000ms, 1866ms total)
T2470 530:587 JLINK_IsHalted()  returns FALSE (0000ms, 1866ms total)
T2470 530:688 JLINK_IsHalted()  returns FALSE (0000ms, 1866ms total)
T2470 530:788 JLINK_IsHalted()  returns FALSE (0000ms, 1866ms total)
T2470 530:889 JLINK_IsHalted()  returns FALSE (0000ms, 1866ms total)
T2470 530:990 JLINK_IsHalted()  returns FALSE (0000ms, 1866ms total)
T2470 531:091 JLINK_IsHalted()  returns FALSE (0000ms, 1866ms total)
T2470 531:192 JLINK_IsHalted()  returns FALSE (0000ms, 1866ms total)
T2470 531:293 JLINK_IsHalted()  returns FALSE (0000ms, 1866ms total)
T2470 531:394 JLINK_IsHalted()  returns FALSE (0000ms, 1866ms total)
T2470 531:494 JLINK_IsHalted()  returns FALSE (0000ms, 1866ms total)
T2470 531:595 JLINK_IsHalted()  returns FALSE (0000ms, 1866ms total)
T2470 531:696 JLINK_IsHalted()  returns FALSE (0000ms, 1866ms total)
T2470 531:797 JLINK_IsHalted()  returns FALSE (0000ms, 1866ms total)
T2470 531:897 JLINK_IsHalted()  returns FALSE (0000ms, 1866ms total)
T2470 531:998 JLINK_IsHalted()  returns FALSE (0000ms, 1866ms total)
T2470 532:099 JLINK_IsHalted()  returns FALSE (0000ms, 1866ms total)
T2470 532:200 JLINK_IsHalted()  returns FALSE (0000ms, 1866ms total)
T2470 532:301 JLINK_IsHalted()  returns FALSE (0000ms, 1866ms total)
T2470 532:402 JLINK_IsHalted()  returns TRUE (0002ms, 1868ms total)
T2470 532:404 JLINK_Halt()  returns 0x00 (0000ms, 1866ms total)
T2470 532:404 JLINK_IsHalted()  returns TRUE (0000ms, 1866ms total)
T2470 532:404 JLINK_IsHalted()  returns TRUE (0000ms, 1866ms total)
T2470 532:404 JLINK_IsHalted()  returns TRUE (0000ms, 1866ms total)
T2470 532:404 JLINK_ReadReg(R15 (PC))  returns 0x08004632 (0000ms, 1866ms total)
T2470 532:404 JLINK_ReadReg(XPSR)  returns 0x61000000 (0000ms, 1866ms total)
T2470 532:404 JLINK_ClrBPEx(BPHandle = 0x00000013)  returns 0x00 (0000ms, 1866ms total)
T2470 532:404 JLINK_ClrBPEx(BPHandle = 0x00000014)  returns 0x00 (0000ms, 1866ms total)
T2470 532:404 JLINK_ClrBPEx(BPHandle = 0x00000015)  returns 0x00 (0000ms, 1866ms total)
T2470 532:404 JLINK_ClrBPEx(BPHandle = 0x00000016)  returns 0x00 (0000ms, 1866ms total)
T2470 532:404 JLINK_ReadMemU32(0xE000ED30, 0x0001 Items, ...) -- CPU_ReadMem(4 bytes @ 0xE000ED30) - Data: 02 00 00 00  returns 0x01 (0000ms, 1866ms total)
T2470 532:404 JLINK_ReadMemU32(0xE0001028, 0x0001 Items, ...) -- CPU_ReadMem(4 bytes @ 0xE0001028) - Data: 00 00 00 00  returns 0x01 (0000ms, 1866ms total)
T2470 532:404 JLINK_ReadMemU32(0xE0001038, 0x0001 Items, ...) -- CPU_ReadMem(4 bytes @ 0xE0001038) - Data: 00 02 00 00  returns 0x01 (0001ms, 1867ms total)
T2470 532:405 JLINK_ReadMemU32(0xE0001048, 0x0001 Items, ...) -- CPU_ReadMem(4 bytes @ 0xE0001048) - Data: 00 00 00 00  returns 0x01 (0000ms, 1867ms total)
T2470 532:405 JLINK_ReadMemU32(0xE0001058, 0x0001 Items, ...) -- CPU_ReadMem(4 bytes @ 0xE0001058) - Data: 00 00 00 00  returns 0x01 (0000ms, 1867ms total)
T2470 532:405 JLINK_ReadReg(R0)  returns 0x00000000 (0000ms, 1867ms total)
T2470 532:405 JLINK_ReadReg(R1)  returns 0x00000053 (0001ms, 1868ms total)
T2470 532:406 JLINK_ReadReg(R2)  returns 0x00000000 (0000ms, 1868ms total)
T2470 532:406 JLINK_ReadReg(R3)  returns 0x00000000 (0000ms, 1868ms total)
T2470 532:406 JLINK_ReadReg(R4)  returns 0x20002194 (0000ms, 1868ms total)
T2470 532:406 JLINK_ReadReg(R5)  returns 0x00000000 (0000ms, 1868ms total)
T2470 532:406 JLINK_ReadReg(R6)  returns 0x20002194 (0000ms, 1868ms total)
T2470 532:406 JLINK_ReadReg(R7)  returns 0x00000000 (0000ms, 1868ms total)
T2470 532:406 JLINK_ReadReg(R8)  returns 0x20001FBC (0000ms, 1868ms total)
T2470 532:406 JLINK_ReadReg(R9)  returns 0x0000C350 (0000ms, 1868ms total)
T2470 532:406 JLINK_ReadReg(R10)  returns 0x000003E8 (0000ms, 1868ms total)
T2470 532:406 JLINK_ReadReg(R11)  returns 0x00000001 (0000ms, 1868ms total)
T2470 532:406 JLINK_ReadReg(R12)  returns 0x00000018 (0000ms, 1868ms total)
T2470 532:406 JLINK_ReadReg(R13 (SP))  returns 0x20002930 (0000ms, 1868ms total)
T2470 532:406 JLINK_ReadReg(R14)  returns 0x08005047 (0000ms, 1868ms total)
T2470 532:406 JLINK_ReadReg(R15 (PC))  returns 0x08004632 (0000ms, 1868ms total)
T2470 532:406 JLINK_ReadReg(XPSR)  returns 0x61000000 (0000ms, 1868ms total)
T2470 532:406 JLINK_ReadReg(MSP)  returns 0x20002930 (0000ms, 1868ms total)
T2470 532:406 JLINK_ReadReg(PSP)  returns 0xAEAA5364 (0000ms, 1868ms total)
T2470 532:406 JLINK_ReadReg(CFBP)  returns 0x00000000 (0000ms, 1868ms total)
T4118 532:406 JLINK_ReadMemEx(0x20002944, 0x0004 Bytes, ..., Flags = 0x02000000) -- CPU_ReadMem(64 bytes @ 0x20002940) -- Updating C cache (64 bytes @ 0x20002940) -- Read from C cache (4 bytes @ 0x20002944) - Data: 47 50 00 08  returns 0x04 (0001ms, 1869ms total)
T4118 532:407 JLINK_ReadMemEx(0x20002934, 0x0004 Bytes, ..., Flags = 0x02000000) -- CPU_ReadMem(64 bytes @ 0x20002900) -- Updating C cache (64 bytes @ 0x20002900) -- Read from C cache (4 bytes @ 0x20002934) - Data: 00 00 00 20  returns 0x04 (0000ms, 1869ms total)
T4118 532:407 JLINK_ReadMemEx(0x20002938, 0x0004 Bytes, ..., Flags = 0x02000000) -- Read from C cache (4 bytes @ 0x20002938) - Data: 00 00 00 00  returns 0x04 (0000ms, 1869ms total)
T4118 532:407 JLINK_ReadMemEx(0x2000293C, 0x0004 Bytes, ..., Flags = 0x02000000) -- Read from C cache (4 bytes @ 0x2000293C) - Data: 00 00 00 00  returns 0x04 (0000ms, 1869ms total)
T4118 532:407 JLINK_ReadMemEx(0x20002940, 0x0004 Bytes, ..., Flags = 0x02000000) -- Read from C cache (4 bytes @ 0x20002940) - Data: 00 00 00 00  returns 0x04 (0000ms, 1869ms total)
T4118 532:407 JLINK_ReadMemEx(0x20002930, 0x0004 Bytes, ..., Flags = 0x02000000) -- Read from C cache (4 bytes @ 0x20002930) - Data: 00 00 00 00  returns 0x04 (0000ms, 1869ms total)
T4118 532:407 JLINK_ReadMemEx(0x00000000, 0x0001 Bytes, ..., Flags = 0x02000000) -- CPU_ReadMem(4 bytes @ 0x00000004) -- CPU_ReadMem(64 bytes @ 0x08000000) -- Updating C cache (64 bytes @ 0x08000000) -- Read from C cache (1 bytes @ 0x08000000) - Data: 48  returns 0x01 (0001ms, 1870ms total)
T4118 532:408 JLINK_ReadMemEx(0x20002194, 0x0020 Bytes, ..., Flags = 0x02000000) -- CPU_ReadMem(64 bytes @ 0x20002180) -- Updating C cache (64 bytes @ 0x20002180) -- Read from C cache (32 bytes @ 0x20002194) - Data: 4D 53 3A 53 57 43 68 6B 00 00 00 00 00 00 00 00 ...  returns 0x20 (0001ms, 1871ms total)
T4118 532:409 JLINK_ReadMemEx(0x00000000, 0x0004 Bytes, ..., Flags = 0x02000000) -- Read from C cache (4 bytes @ 0x08000000) - Data: 48 29 00 20  returns 0x04 (0000ms, 1871ms total)
T4118 532:410 JLINK_ReadMemEx(0x20000024, 0x0002 Bytes, ..., Flags = 0x02000000) -- CPU_ReadMem(64 bytes @ 0x20000000) -- Updating C cache (64 bytes @ 0x20000000) -- Read from C cache (2 bytes @ 0x20000024) - Data: 00 00  returns 0x02 (0000ms, 1871ms total)
T4118 532:413 JLINK_ReadMemEx(0x20002214, 0x0001 Bytes, ..., Flags = 0x02000000) -- CPU_ReadMem(64 bytes @ 0x20002200) -- Updating C cache (64 bytes @ 0x20002200) -- Read from C cache (1 bytes @ 0x20002214) - Data: 08  returns 0x01 (0000ms, 1871ms total)
T4118 532:413 JLINK_ReadMemEx(0x20002215, 0x0001 Bytes, ..., Flags = 0x02000000) -- Read from C cache (1 bytes @ 0x20002215) - Data: 01  returns 0x01 (0000ms, 1871ms total)
T4118 532:414 JLINK_ReadMemEx(0x08004632, 0x0002 Bytes, ..., Flags = 0x02000000) -- CPU_ReadMem(64 bytes @ 0x08004600) -- Updating C cache (64 bytes @ 0x08004600) -- Read from C cache (2 bytes @ 0x08004632) - Data: 0E 49  returns 0x02 (0000ms, 1871ms total)
T4118 532:414 JLINK_ReadMemEx(0x08004634, 0x003C Bytes, ..., Flags = 0x02000000) -- CPU_ReadMem(64 bytes @ 0x08004640) -- Updating C cache (64 bytes @ 0x08004640) -- Read from C cache (60 bytes @ 0x08004634) - Data: 08 70 20 46 FE F7 C4 FD 05 00 0B D4 96 F8 80 20 ...  returns 0x3C (0001ms, 1872ms total)
T2470 539:349 JLINK_ReadMemEx(0x08004632, 0x0002 Bytes, ..., Flags = 0x02000000) -- Read from C cache (2 bytes @ 0x08004632) - Data: 0E 49  returns 0x02 (0000ms, 1872ms total)
T2470 539:349 JLINK_Step() -- Read from C cache (2 bytes @ 0x08004632) -- CPU_ReadMem(4 bytes @ 0xE000ED18) -- CPU_WriteMem(4 bytes @ 0xE000ED18) -- CPU_ReadMem(4 bytes @ 0xE000ED18) -- CPU_WriteMem(4 bytes @ 0xE000ED18) -- CPU_ReadMem(4 bytes @ 0xE0001004) -- Read from C cache (4 bytes @ 0x0800466C) -- Simulated  returns 0x00 (0013ms, 1885ms total)
T2470 539:362 JLINK_ReadReg(R15 (PC))  returns 0x08004634 (0000ms, 1885ms total)
T2470 539:362 JLINK_ReadReg(XPSR)  returns 0x61000000 (0000ms, 1885ms total)
T2470 539:362 JLINK_SetBPEx(Addr = 0x0800215E, Type = 0xFFFFFFF2)  returns 0x00000017 (0000ms, 1885ms total)
T2470 539:362 JLINK_SetBPEx(Addr = 0x08002164, Type = 0xFFFFFFF2)  returns 0x00000018 (0000ms, 1885ms total)
T2470 539:362 JLINK_SetBPEx(Addr = 0x0800456A, Type = 0xFFFFFFF2)  returns 0x00000019 (0000ms, 1885ms total)
T2470 539:362 JLINK_SetBPEx(Addr = 0x08004632, Type = 0xFFFFFFF2)  returns 0x0000001A (0000ms, 1885ms total)
T2470 539:362 JLINK_SetBPEx(Addr = 0x0800463E, Type = 0xFFFFFFF2)  returns 0x0000001B (0000ms, 1885ms total)
T2470 539:362 JLINK_Go() -- CPU_WriteMem(4 bytes @ 0xE0002000) -- CPU_WriteMem(4 bytes @ 0xE0002000) -- CPU_WriteMem(4 bytes @ 0xE0002000) -- CPU_WriteMem(4 bytes @ 0xE0002000) -- CPU_WriteMem(4 bytes @ 0xE0002000) -- CPU_ReadMem(4 bytes @ 0xE0001000) -- CPU_WriteMem(4 bytes @ 0xE0002018) -- CPU_WriteMem(4 bytes @ 0xE0001004) (0004ms, 1889ms total)
T2470 539:467 JLINK_IsHalted()  returns TRUE (0002ms, 1891ms total)
T2470 539:469 JLINK_Halt()  returns 0x00 (0000ms, 1889ms total)
T2470 539:469 JLINK_IsHalted()  returns TRUE (0000ms, 1889ms total)
T2470 539:469 JLINK_IsHalted()  returns TRUE (0000ms, 1889ms total)
T2470 539:469 JLINK_IsHalted()  returns TRUE (0000ms, 1889ms total)
T2470 539:469 JLINK_ReadReg(R15 (PC))  returns 0x0800463E (0000ms, 1889ms total)
T2470 539:469 JLINK_ReadReg(XPSR)  returns 0xA1000000 (0000ms, 1889ms total)
T2470 539:469 JLINK_ClrBPEx(BPHandle = 0x00000017)  returns 0x00 (0000ms, 1889ms total)
T2470 539:469 JLINK_ClrBPEx(BPHandle = 0x00000018)  returns 0x00 (0000ms, 1889ms total)
T2470 539:469 JLINK_ClrBPEx(BPHandle = 0x00000019)  returns 0x00 (0001ms, 1890ms total)
T2470 539:470 JLINK_ClrBPEx(BPHandle = 0x0000001A)  returns 0x00 (0000ms, 1890ms total)
T2470 539:470 JLINK_ClrBPEx(BPHandle = 0x0000001B)  returns 0x00 (0000ms, 1890ms total)
T2470 539:470 JLINK_ReadMemU32(0xE000ED30, 0x0001 Items, ...) -- CPU_ReadMem(4 bytes @ 0xE000ED30) - Data: 02 00 00 00  returns 0x01 (0000ms, 1890ms total)
T2470 539:470 JLINK_ReadMemU32(0xE0001028, 0x0001 Items, ...) -- CPU_ReadMem(4 bytes @ 0xE0001028) - Data: 00 00 00 00  returns 0x01 (0001ms, 1891ms total)
T2470 539:471 JLINK_ReadMemU32(0xE0001038, 0x0001 Items, ...) -- CPU_ReadMem(4 bytes @ 0xE0001038) - Data: 00 02 00 00  returns 0x01 (0000ms, 1891ms total)
T2470 539:471 JLINK_ReadMemU32(0xE0001048, 0x0001 Items, ...) -- CPU_ReadMem(4 bytes @ 0xE0001048) - Data: 00 00 00 00  returns 0x01 (0001ms, 1892ms total)
T2470 539:472 JLINK_ReadMemU32(0xE0001058, 0x0001 Items, ...) -- CPU_ReadMem(4 bytes @ 0xE0001058) - Data: 00 00 00 00  returns 0x01 (0001ms, 1893ms total)
T2470 539:473 JLINK_ReadReg(R0)  returns 0xFFFFFFFF (0000ms, 1893ms total)
T2470 539:473 JLINK_ReadReg(R1)  returns 0x20002197 (0000ms, 1893ms total)
T2470 539:473 JLINK_ReadReg(R2)  returns 0x0000006C (0000ms, 1893ms total)
T2470 539:473 JLINK_ReadReg(R3)  returns 0x00000053 (0000ms, 1893ms total)
T2470 539:473 JLINK_ReadReg(R4)  returns 0x20002194 (0000ms, 1893ms total)
T2470 539:473 JLINK_ReadReg(R5)  returns 0xFFFFFFFF (0000ms, 1893ms total)
T2470 539:473 JLINK_ReadReg(R6)  returns 0x20002194 (0000ms, 1893ms total)
T2470 539:473 JLINK_ReadReg(R7)  returns 0x00000000 (0000ms, 1893ms total)
T2470 539:473 JLINK_ReadReg(R8)  returns 0x20001FBC (0000ms, 1893ms total)
T2470 539:473 JLINK_ReadReg(R9)  returns 0x0000C350 (0000ms, 1893ms total)
T2470 539:473 JLINK_ReadReg(R10)  returns 0x000003E8 (0000ms, 1893ms total)
T2470 539:473 JLINK_ReadReg(R11)  returns 0x00000001 (0000ms, 1893ms total)
T2470 539:473 JLINK_ReadReg(R12)  returns 0x00000018 (0001ms, 1894ms total)
T2470 539:474 JLINK_ReadReg(R13 (SP))  returns 0x20002930 (0000ms, 1894ms total)
T2470 539:474 JLINK_ReadReg(R14)  returns 0x080031DB (0000ms, 1894ms total)
T2470 539:474 JLINK_ReadReg(R15 (PC))  returns 0x0800463E (0000ms, 1894ms total)
T2470 539:474 JLINK_ReadReg(XPSR)  returns 0xA1000000 (0000ms, 1894ms total)
T2470 539:474 JLINK_ReadReg(MSP)  returns 0x20002930 (0000ms, 1894ms total)
T2470 539:474 JLINK_ReadReg(PSP)  returns 0xAEAA5364 (0000ms, 1894ms total)
T2470 539:474 JLINK_ReadReg(CFBP)  returns 0x00000000 (0000ms, 1894ms total)
T4118 539:475 JLINK_ReadMemEx(0x20002944, 0x0004 Bytes, ..., Flags = 0x02000000) -- CPU_ReadMem(64 bytes @ 0x20002940) -- Updating C cache (64 bytes @ 0x20002940) -- Read from C cache (4 bytes @ 0x20002944) - Data: 47 50 00 08  returns 0x04 (0001ms, 1895ms total)
T4118 539:476 JLINK_ReadMemEx(0x20002934, 0x0004 Bytes, ..., Flags = 0x02000000) -- CPU_ReadMem(64 bytes @ 0x20002900) -- Updating C cache (64 bytes @ 0x20002900) -- Read from C cache (4 bytes @ 0x20002934) - Data: 00 00 00 20  returns 0x04 (0001ms, 1896ms total)
T4118 539:477 JLINK_ReadMemEx(0x20002938, 0x0004 Bytes, ..., Flags = 0x02000000) -- Read from C cache (4 bytes @ 0x20002938) - Data: 00 00 00 00  returns 0x04 (0000ms, 1896ms total)
T4118 539:477 JLINK_ReadMemEx(0x2000293C, 0x0004 Bytes, ..., Flags = 0x02000000) -- Read from C cache (4 bytes @ 0x2000293C) - Data: 00 00 00 00  returns 0x04 (0000ms, 1896ms total)
T4118 539:477 JLINK_ReadMemEx(0x20002940, 0x0004 Bytes, ..., Flags = 0x02000000) -- Read from C cache (4 bytes @ 0x20002940) - Data: 00 00 00 00  returns 0x04 (0000ms, 1896ms total)
T4118 539:477 JLINK_ReadMemEx(0x20002930, 0x0004 Bytes, ..., Flags = 0x02000000) -- Read from C cache (4 bytes @ 0x20002930) - Data: 00 00 00 00  returns 0x04 (0000ms, 1896ms total)
T4118 539:478 JLINK_ReadMemEx(0x00000000, 0x0001 Bytes, ..., Flags = 0x02000000) -- CPU_ReadMem(4 bytes @ 0x00000004) -- CPU_ReadMem(64 bytes @ 0x08000000) -- Updating C cache (64 bytes @ 0x08000000) -- Read from C cache (1 bytes @ 0x08000000) - Data: 48  returns 0x01 (0001ms, 1898ms total)
T4118 539:479 JLINK_ReadMemEx(0x20002194, 0x0020 Bytes, ..., Flags = 0x02000000) -- CPU_ReadMem(64 bytes @ 0x20002180) -- Updating C cache (64 bytes @ 0x20002180) -- Read from C cache (32 bytes @ 0x20002194) - Data: 4D 53 3A 53 57 43 68 6B 00 00 00 00 00 00 00 00 ...  returns 0x20 (0001ms, 1899ms total)
T4118 539:480 JLINK_ReadMemEx(0x00000000, 0x0004 Bytes, ..., Flags = 0x02000000) -- Read from C cache (4 bytes @ 0x08000000) - Data: 48 29 00 20  returns 0x04 (0000ms, 1899ms total)
T4118 539:480 JLINK_ReadMemEx(0x20000024, 0x0002 Bytes, ..., Flags = 0x02000000) -- CPU_ReadMem(64 bytes @ 0x20000000) -- Updating C cache (64 bytes @ 0x20000000) -- Read from C cache (2 bytes @ 0x20000024) - Data: 00 00  returns 0x02 (0001ms, 1900ms total)
T4118 539:482 JLINK_ReadMemEx(0x20002214, 0x0001 Bytes, ..., Flags = 0x02000000) -- CPU_ReadMem(64 bytes @ 0x20002200) -- Updating C cache (64 bytes @ 0x20002200) -- Read from C cache (1 bytes @ 0x20002214) - Data: 08  returns 0x01 (0001ms, 1901ms total)
T4118 539:484 JLINK_ReadMemEx(0x20002215, 0x0001 Bytes, ..., Flags = 0x02000000) -- Read from C cache (1 bytes @ 0x20002215) - Data: 01  returns 0x01 (0000ms, 1901ms total)
T4118 539:484 JLINK_ReadMemEx(0x0800463E, 0x0002 Bytes, ..., Flags = 0x02000000) -- CPU_ReadMem(64 bytes @ 0x08004600) -- Updating C cache (64 bytes @ 0x08004600) -- Read from C cache (2 bytes @ 0x0800463E) - Data: 0B D4  returns 0x02 (0001ms, 1902ms total)
T4118 539:485 JLINK_ReadMemEx(0x08004640, 0x003C Bytes, ..., Flags = 0x02000000) -- CPU_ReadMem(64 bytes @ 0x08004640) -- Updating C cache (64 bytes @ 0x08004640) -- Read from C cache (60 bytes @ 0x08004640) - Data: 96 F8 80 20 69 46 60 1D FE F7 D6 FD 08 48 00 EB ...  returns 0x3C (0001ms, 1903ms total)
T2470 544:934 JLINK_ReadMemEx(0x0800463E, 0x0002 Bytes, ..., Flags = 0x02000000) -- Read from C cache (2 bytes @ 0x0800463E) - Data: 0B D4  returns 0x02 (0000ms, 1903ms total)
T2470 544:934 JLINK_Step() -- Read from C cache (2 bytes @ 0x0800463E) -- CPU_ReadMem(4 bytes @ 0xE0001004) -- Simulated  returns 0x00 (0000ms, 1903ms total)
T2470 544:934 JLINK_ReadReg(R15 (PC))  returns 0x08004658 (0000ms, 1903ms total)
T2470 544:934 JLINK_ReadReg(XPSR)  returns 0xA1000000 (0000ms, 1903ms total)
T2470 544:934 JLINK_SetBPEx(Addr = 0x0800215E, Type = 0xFFFFFFF2)  returns 0x0000001C (0000ms, 1903ms total)
T2470 544:934 JLINK_SetBPEx(Addr = 0x08002164, Type = 0xFFFFFFF2)  returns 0x0000001D (0000ms, 1903ms total)
T2470 544:934 JLINK_SetBPEx(Addr = 0x0800456A, Type = 0xFFFFFFF2)  returns 0x0000001E (0000ms, 1903ms total)
T2470 544:934 JLINK_SetBPEx(Addr = 0x0800463E, Type = 0xFFFFFFF2)  returns 0x0000001F (0000ms, 1903ms total)
T2470 544:934 JLINK_SetBPEx(Addr = 0x08004652, Type = 0xFFFFFFF2)  returns 0x00000020 (0000ms, 1903ms total)
T2470 544:934 JLINK_Go() -- CPU_WriteMem(4 bytes @ 0xE0002000) -- CPU_WriteMem(4 bytes @ 0xE0002000) -- CPU_WriteMem(4 bytes @ 0xE0002000) -- CPU_WriteMem(4 bytes @ 0xE0002000) -- CPU_WriteMem(4 bytes @ 0xE0002000) -- CPU_ReadMem(4 bytes @ 0xE0001000) -- CPU_WriteMem(4 bytes @ 0xE0002014) -- CPU_WriteMem(4 bytes @ 0xE0002018) -- CPU_WriteMem(4 bytes @ 0xE0001004) (0002ms, 1905ms total)
T2470 545:037 JLINK_IsHalted()  returns FALSE (0000ms, 1905ms total)
T2470 545:138 JLINK_IsHalted()  returns FALSE (0000ms, 1905ms total)
T2470 545:240 JLINK_IsHalted()  returns FALSE (0000ms, 1905ms total)
T2470 545:340 JLINK_IsHalted()  returns FALSE (0000ms, 1905ms total)
T2470 545:441 JLINK_IsHalted()  returns FALSE (0000ms, 1905ms total)
T2470 545:542 JLINK_IsHalted()  returns FALSE (0000ms, 1905ms total)
T2470 545:643 JLINK_IsHalted()  returns FALSE (0000ms, 1905ms total)
T2470 545:743 JLINK_IsHalted()  returns FALSE (0000ms, 1905ms total)
T2470 545:844 JLINK_IsHalted()  returns FALSE (0000ms, 1905ms total)
T2470 545:945 JLINK_IsHalted()  returns FALSE (0000ms, 1905ms total)
T2470 546:046 JLINK_IsHalted()  returns FALSE (0000ms, 1905ms total)
T2470 546:147 JLINK_IsHalted()  returns FALSE (0000ms, 1905ms total)
T2470 546:248 JLINK_IsHalted()  returns FALSE (0000ms, 1905ms total)
T2470 546:350 JLINK_IsHalted()  returns FALSE (0000ms, 1905ms total)
T2470 546:450 JLINK_IsHalted()  returns FALSE (0000ms, 1905ms total)
T2470 546:551 JLINK_IsHalted()  returns FALSE (0000ms, 1905ms total)
T2470 546:653 JLINK_IsHalted()  returns FALSE (0000ms, 1905ms total)
T2470 546:754 JLINK_IsHalted()  returns FALSE (0000ms, 1905ms total)
T2470 546:855 JLINK_IsHalted()  returns FALSE (0000ms, 1905ms total)
T2470 546:955 JLINK_IsHalted()  returns FALSE (0000ms, 1905ms total)
T2470 547:057 JLINK_IsHalted()  returns FALSE (0000ms, 1905ms total)
T2470 547:158 JLINK_IsHalted()  returns FALSE (0000ms, 1905ms total)
T2470 547:258 JLINK_IsHalted()  returns FALSE (0000ms, 1905ms total)
T2470 547:360 JLINK_IsHalted()  returns FALSE (0000ms, 1905ms total)
T2470 547:462 JLINK_IsHalted()  returns FALSE (0000ms, 1905ms total)
T2470 547:563 JLINK_IsHalted()  returns FALSE (0000ms, 1905ms total)
T2470 547:664 JLINK_IsHalted()  returns FALSE (0000ms, 1905ms total)
T2470 547:765 JLINK_IsHalted()  returns FALSE (0000ms, 1905ms total)
T2470 547:866 JLINK_IsHalted()  returns FALSE (0000ms, 1905ms total)
T2470 547:967 JLINK_IsHalted()  returns FALSE (0000ms, 1905ms total)
T2470 548:068 JLINK_IsHalted()  returns FALSE (0000ms, 1905ms total)
T2470 548:169 JLINK_IsHalted()  returns FALSE (0000ms, 1905ms total)
T2470 548:270 JLINK_IsHalted()  returns FALSE (0000ms, 1905ms total)
T2470 548:370 JLINK_IsHalted()  returns FALSE (0000ms, 1905ms total)
T2470 548:471 JLINK_IsHalted()  returns FALSE (0000ms, 1905ms total)
T2470 548:572 JLINK_IsHalted()  returns FALSE (0000ms, 1905ms total)
T2470 548:673 JLINK_IsHalted()  returns FALSE (0000ms, 1905ms total)
T2470 548:773 JLINK_IsHalted()  returns FALSE (0000ms, 1905ms total)
T2470 548:874 JLINK_IsHalted()  returns FALSE (0000ms, 1905ms total)
T2470 548:976 JLINK_IsHalted()  returns FALSE (0000ms, 1905ms total)
T2470 549:077 JLINK_IsHalted()  returns FALSE (0000ms, 1905ms total)
T2470 549:177 JLINK_IsHalted()  returns FALSE (0000ms, 1905ms total)
T2470 549:278 JLINK_IsHalted()  returns FALSE (0000ms, 1905ms total)
T2470 549:379 JLINK_IsHalted()  returns FALSE (0000ms, 1905ms total)
T2470 549:480 JLINK_IsHalted()  returns FALSE (0000ms, 1905ms total)
T2470 549:581 JLINK_IsHalted()  returns FALSE (0000ms, 1905ms total)
T2470 549:682 JLINK_IsHalted()  returns FALSE (0000ms, 1905ms total)
T2470 549:783 JLINK_IsHalted()  returns FALSE (0000ms, 1905ms total)
T4118 549:789 JLINK_SetBPEx(Addr = 0x08004658, Type = 0xFFFFFFF2) -- CPU is running -- CPU is running -- CPU_WriteMem(4 bytes @ 0xE0002000) -- CPU is running -- CPU_WriteMem(4 bytes @ 0xE000201C)  returns 0x00000021 (0000ms, 1905ms total)
T2470 549:883 JLINK_IsHalted()  returns FALSE (0000ms, 1905ms total)
T2470 549:984 JLINK_IsHalted()  returns FALSE (0000ms, 1905ms total)
T2470 550:085 JLINK_IsHalted()  returns FALSE (0000ms, 1905ms total)
T2470 550:186 JLINK_IsHalted()  returns FALSE (0000ms, 1905ms total)
T2470 550:287 JLINK_IsHalted()  returns FALSE (0000ms, 1905ms total)
T2470 550:388 JLINK_IsHalted()  returns FALSE (0000ms, 1905ms total)
T2470 550:489 JLINK_IsHalted()  returns FALSE (0000ms, 1905ms total)
T2470 550:589 JLINK_IsHalted()  returns FALSE (0000ms, 1905ms total)
T2470 550:690 JLINK_IsHalted()  returns FALSE (0000ms, 1905ms total)
T2470 550:792 JLINK_IsHalted()  returns FALSE (0000ms, 1905ms total)
T2470 550:893 JLINK_IsHalted()  returns FALSE (0000ms, 1905ms total)
T4118 550:948 JLINK_ClrBPEx(BPHandle = 0x00000020) -- CPU is running -- CPU is running -- CPU_WriteMem(4 bytes @ 0xE0002000) -- CPU is running -- CPU_WriteMem(4 bytes @ 0xE0002008) -- CPU is running -- CPU_WriteMem(4 bytes @ 0xE0002000) -- CPU is running -- CPU_WriteMem(4 bytes @ 0xE000200C) -- CPU is running -- CPU_WriteMem(4 bytes @ 0xE0002000) -- CPU is running -- CPU_WriteMem(4 bytes @ 0xE0002010) -- CPU is running -- CPU_WriteMem(4 bytes @ 0xE0002000) -- CPU is running
 -- CPU_WriteMem(4 bytes @ 0xE0002014) -- CPU is running -- CPU_WriteMem(4 bytes @ 0xE0002000) -- CPU is running -- CPU_WriteMem(4 bytes @ 0xE000201C) -- CPU is running -- CPU_WriteMem(4 bytes @ 0xE0002018) -- CPU is running -- CPU_WriteMem(4 bytes @ 0xE0002018) -- CPU is running -- CPU_WriteMem(4 bytes @ 0xE000201C)  returns 0x00 (0003ms, 1908ms total)
T2470 550:993 JLINK_IsHalted()  returns FALSE (0000ms, 1908ms total)
T2470 551:094 JLINK_IsHalted()  returns FALSE (0000ms, 1908ms total)
T2470 551:196 JLINK_IsHalted()  returns FALSE (0000ms, 1908ms total)
T2470 551:297 JLINK_IsHalted()  returns FALSE (0000ms, 1908ms total)
T2470 551:397 JLINK_IsHalted()  returns FALSE (0000ms, 1908ms total)
T2470 551:498 JLINK_IsHalted()  returns FALSE (0000ms, 1908ms total)
T2470 551:599 JLINK_IsHalted()  returns FALSE (0000ms, 1908ms total)
T4118 551:603 JLINK_ClrBPEx(BPHandle = 0x0000001F) -- CPU is running -- CPU is running -- CPU_WriteMem(4 bytes @ 0xE0002000) -- CPU is running -- CPU_WriteMem(4 bytes @ 0xE0002008) -- CPU is running -- CPU_WriteMem(4 bytes @ 0xE0002000) -- CPU is running -- CPU_WriteMem(4 bytes @ 0xE000200C) -- CPU is running -- CPU_WriteMem(4 bytes @ 0xE0002000) -- CPU is running -- CPU_WriteMem(4 bytes @ 0xE0002010) -- CPU is running -- CPU_WriteMem(4 bytes @ 0xE0002000) -- CPU is running
 -- CPU_WriteMem(4 bytes @ 0xE0002018) -- CPU is running -- CPU_WriteMem(4 bytes @ 0xE0002014) -- CPU is running -- CPU_WriteMem(4 bytes @ 0xE0002014) -- CPU is running -- CPU_WriteMem(4 bytes @ 0xE0002018) -- CPU is running -- CPU_WriteMem(4 bytes @ 0xE000201C)  returns 0x00 (0004ms, 1912ms total)
T2470 551:699 JLINK_IsHalted()  returns FALSE (0000ms, 1912ms total)
T2470 551:800 JLINK_IsHalted()  returns FALSE (0000ms, 1912ms total)
T2470 551:902 JLINK_IsHalted()  returns FALSE (0000ms, 1912ms total)
T2470 552:003 JLINK_IsHalted()  returns FALSE (0000ms, 1912ms total)
T2470 552:103 JLINK_IsHalted()  returns FALSE (0000ms, 1912ms total)
T2470 552:204 JLINK_IsHalted()  returns FALSE (0000ms, 1912ms total)
T2470 552:306 JLINK_IsHalted()  returns FALSE (0000ms, 1912ms total)
T2470 552:407 JLINK_IsHalted()  returns FALSE (0000ms, 1912ms total)
T2470 552:507 JLINK_IsHalted()  returns FALSE (0000ms, 1912ms total)
T2470 552:609 JLINK_IsHalted()  returns FALSE (0000ms, 1912ms total)
T2470 552:710 JLINK_IsHalted()  returns FALSE (0000ms, 1912ms total)
T2470 552:812 JLINK_IsHalted()  returns FALSE (0000ms, 1912ms total)
T2470 552:913 JLINK_IsHalted()  returns FALSE (0000ms, 1912ms total)
T2470 553:014 JLINK_IsHalted()  returns FALSE (0000ms, 1912ms total)
T2470 553:115 JLINK_IsHalted()  returns FALSE (0000ms, 1912ms total)
T2470 553:215 JLINK_IsHalted()  returns FALSE (0000ms, 1912ms total)
T2470 553:316 JLINK_IsHalted()  returns FALSE (0000ms, 1912ms total)
T2470 553:418 JLINK_IsHalted()  returns FALSE (0000ms, 1912ms total)
T2470 553:519 JLINK_IsHalted()  returns FALSE (0000ms, 1912ms total)
T2470 553:619 JLINK_IsHalted()  returns FALSE (0000ms, 1912ms total)
T2470 553:720 JLINK_IsHalted()  returns FALSE (0000ms, 1912ms total)
T2470 553:821 JLINK_IsHalted()  returns FALSE (0000ms, 1912ms total)
T2470 553:922 JLINK_IsHalted()  returns FALSE (0000ms, 1912ms total)
T2470 554:022 JLINK_IsHalted()  returns FALSE (0000ms, 1912ms total)
T2470 554:123 JLINK_IsHalted()  returns FALSE (0000ms, 1912ms total)
T2470 554:224 JLINK_IsHalted()  returns FALSE (0000ms, 1912ms total)
T2470 554:324 JLINK_IsHalted()  returns FALSE (0000ms, 1912ms total)
T2470 554:425 JLINK_IsHalted()  returns FALSE (0000ms, 1912ms total)
T2470 554:527 JLINK_IsHalted()  returns FALSE (0000ms, 1912ms total)
T2470 554:628 JLINK_IsHalted()  returns FALSE (0000ms, 1912ms total)
T2470 554:728 JLINK_IsHalted()  returns FALSE (0000ms, 1912ms total)
T2470 554:829 JLINK_IsHalted()  returns FALSE (0000ms, 1912ms total)
T2470 554:930 JLINK_IsHalted()  returns FALSE (0000ms, 1912ms total)
T2470 555:031 JLINK_IsHalted()  returns FALSE (0000ms, 1912ms total)
T2470 555:132 JLINK_IsHalted()  returns FALSE (0000ms, 1912ms total)
T2470 555:233 JLINK_IsHalted()  returns FALSE (0000ms, 1912ms total)
T2470 555:334 JLINK_IsHalted()  returns FALSE (0000ms, 1912ms total)
T2470 555:435 JLINK_IsHalted()  returns FALSE (0000ms, 1912ms total)
T2470 555:536 JLINK_IsHalted()  returns FALSE (0000ms, 1912ms total)
T2470 555:637 JLINK_IsHalted()  returns FALSE (0000ms, 1912ms total)
T2470 555:738 JLINK_IsHalted()  returns FALSE (0000ms, 1912ms total)
T2470 555:839 JLINK_IsHalted()  returns FALSE (0000ms, 1912ms total)
T2470 555:940 JLINK_IsHalted()  returns FALSE (0000ms, 1912ms total)
T2470 556:042 JLINK_IsHalted()  returns FALSE (0000ms, 1912ms total)
T2470 556:143 JLINK_IsHalted()  returns FALSE (0000ms, 1912ms total)
T2470 556:243 JLINK_IsHalted()  returns FALSE (0000ms, 1912ms total)
T2470 556:344 JLINK_IsHalted()  returns FALSE (0000ms, 1912ms total)
T2470 556:446 JLINK_IsHalted()  returns FALSE (0000ms, 1912ms total)
T2470 556:547 JLINK_IsHalted()  returns FALSE (0000ms, 1912ms total)
T2470 556:648 JLINK_IsHalted()  returns FALSE (0000ms, 1912ms total)
T2470 556:749 JLINK_IsHalted()  returns FALSE (0000ms, 1912ms total)
T2470 556:851 JLINK_IsHalted()  returns FALSE (0000ms, 1912ms total)
T2470 556:951 JLINK_IsHalted()  returns FALSE (0000ms, 1912ms total)
T2470 557:052 JLINK_IsHalted()  returns FALSE (0000ms, 1912ms total)
T2470 557:153 JLINK_IsHalted()  returns FALSE (0000ms, 1912ms total)
T2470 557:254 JLINK_IsHalted()  returns FALSE (0000ms, 1912ms total)
T2470 557:354 JLINK_IsHalted()  returns FALSE (0000ms, 1912ms total)
T2470 557:455 JLINK_IsHalted()  returns FALSE (0000ms, 1912ms total)
T2470 557:556 JLINK_IsHalted()  returns FALSE (0000ms, 1912ms total)
T2470 557:657 JLINK_IsHalted()  returns FALSE (0000ms, 1912ms total)
T2470 557:758 JLINK_IsHalted()  returns FALSE (0000ms, 1912ms total)
T2470 557:859 JLINK_IsHalted()  returns FALSE (0000ms, 1912ms total)
T2470 557:960 JLINK_IsHalted()  returns FALSE (0000ms, 1912ms total)
T2470 558:061 JLINK_IsHalted()  returns FALSE (0000ms, 1912ms total)
T2470 558:162 JLINK_IsHalted()  returns FALSE (0000ms, 1912ms total)
T2470 558:264 JLINK_IsHalted()  returns FALSE (0000ms, 1912ms total)
T2470 558:365 JLINK_IsHalted()  returns FALSE (0000ms, 1912ms total)
T2470 558:466 JLINK_IsHalted()  returns FALSE (0000ms, 1912ms total)
T2470 558:567 JLINK_IsHalted()  returns FALSE (0000ms, 1912ms total)
T2470 558:668 JLINK_IsHalted()  returns FALSE (0000ms, 1912ms total)
T2470 558:769 JLINK_IsHalted()  returns FALSE (0000ms, 1912ms total)
T2470 558:869 JLINK_IsHalted()  returns FALSE (0000ms, 1912ms total)
T2470 558:970 JLINK_IsHalted()  returns FALSE (0000ms, 1912ms total)
T2470 559:072 JLINK_IsHalted()  returns FALSE (0000ms, 1912ms total)
T2470 559:173 JLINK_IsHalted()  returns FALSE (0000ms, 1912ms total)
T2470 559:273 JLINK_IsHalted()  returns FALSE (0000ms, 1912ms total)
T2470 559:374 JLINK_IsHalted()  returns FALSE (0000ms, 1912ms total)
T2470 559:475 JLINK_IsHalted()  returns FALSE (0000ms, 1912ms total)
T2470 559:575 JLINK_IsHalted()  returns FALSE (0000ms, 1912ms total)
T2470 559:676 JLINK_IsHalted()  returns FALSE (0000ms, 1912ms total)
T2470 559:777 JLINK_IsHalted()  returns FALSE (0000ms, 1912ms total)
T2470 559:878 JLINK_IsHalted()  returns FALSE (0000ms, 1912ms total)
T2470 559:979 JLINK_IsHalted()  returns FALSE (0000ms, 1912ms total)
T2470 560:080 JLINK_IsHalted()  returns FALSE (0000ms, 1912ms total)
T2470 560:181 JLINK_IsHalted()  returns FALSE (0000ms, 1912ms total)
T2470 560:282 JLINK_IsHalted()  returns FALSE (0000ms, 1912ms total)
T2470 560:383 JLINK_IsHalted()  returns FALSE (0000ms, 1912ms total)
T2470 560:484 JLINK_IsHalted()  returns FALSE (0000ms, 1912ms total)
T2470 560:585 JLINK_IsHalted()  returns FALSE (0000ms, 1912ms total)
T2470 560:686 JLINK_IsHalted()  returns FALSE (0000ms, 1912ms total)
T2470 560:786 JLINK_IsHalted()  returns FALSE (0000ms, 1912ms total)
T2470 560:887 JLINK_IsHalted()  returns FALSE (0000ms, 1912ms total)
T2470 560:988 JLINK_IsHalted()  returns FALSE (0000ms, 1912ms total)
T2470 561:088 JLINK_IsHalted()  returns FALSE (0000ms, 1912ms total)
T2470 561:189 JLINK_IsHalted()  returns FALSE (0000ms, 1912ms total)
T2470 561:291 JLINK_IsHalted()  returns FALSE (0000ms, 1912ms total)
T2470 561:392 JLINK_IsHalted()  returns FALSE (0000ms, 1912ms total)
T2470 561:493 JLINK_IsHalted()  returns FALSE (0000ms, 1912ms total)
T2470 561:594 JLINK_IsHalted()  returns FALSE (0000ms, 1912ms total)
T2470 561:696 JLINK_IsHalted()  returns FALSE (0000ms, 1912ms total)
T2470 561:797 JLINK_IsHalted()  returns FALSE (0000ms, 1912ms total)
T2470 561:897 JLINK_IsHalted()  returns FALSE (0000ms, 1912ms total)
T2470 561:999 JLINK_IsHalted()  returns FALSE (0000ms, 1912ms total)
T2470 562:100 JLINK_IsHalted()  returns FALSE (0000ms, 1912ms total)
T2470 562:201 JLINK_IsHalted()  returns FALSE (0000ms, 1912ms total)
T2470 562:301 JLINK_IsHalted()  returns FALSE (0000ms, 1912ms total)
T2470 562:403 JLINK_IsHalted()  returns FALSE (0000ms, 1912ms total)
T2470 562:504 JLINK_IsHalted()  returns FALSE (0000ms, 1912ms total)
T2470 562:604 JLINK_IsHalted()  returns FALSE (0000ms, 1912ms total)
T2470 562:705 JLINK_IsHalted()  returns FALSE (0000ms, 1912ms total)
T2470 562:807 JLINK_IsHalted()  returns FALSE (0000ms, 1912ms total)
T2470 562:907 JLINK_IsHalted()  returns FALSE (0000ms, 1912ms total)
T2470 563:008 JLINK_IsHalted()  returns FALSE (0000ms, 1912ms total)
T2470 563:109 JLINK_IsHalted()  returns FALSE (0000ms, 1912ms total)
T2470 563:210 JLINK_IsHalted()  returns FALSE (0000ms, 1912ms total)
T2470 563:310 JLINK_IsHalted()  returns FALSE (0000ms, 1912ms total)
T2470 563:411 JLINK_IsHalted()  returns FALSE (0000ms, 1912ms total)
T2470 563:512 JLINK_IsHalted()  returns FALSE (0000ms, 1912ms total)
T2470 563:613 JLINK_IsHalted()  returns FALSE (0000ms, 1912ms total)
T2470 563:713 JLINK_IsHalted()  returns FALSE (0000ms, 1912ms total)
T2470 563:814 JLINK_IsHalted()  returns FALSE (0000ms, 1912ms total)
T2470 563:915 JLINK_IsHalted()  returns FALSE (0000ms, 1912ms total)
T2470 564:016 JLINK_IsHalted()  returns FALSE (0000ms, 1912ms total)
T2470 564:116 JLINK_IsHalted()  returns FALSE (0000ms, 1912ms total)
T2470 564:217 JLINK_IsHalted()  returns FALSE (0000ms, 1912ms total)
T2470 564:319 JLINK_IsHalted()  returns FALSE (0000ms, 1912ms total)
T2470 564:420 JLINK_IsHalted()  returns FALSE (0000ms, 1912ms total)
T2470 564:520 JLINK_IsHalted()  returns FALSE (0000ms, 1912ms total)
T2470 564:621 JLINK_IsHalted()  returns FALSE (0000ms, 1912ms total)
T2470 564:722 JLINK_IsHalted()  returns FALSE (0000ms, 1912ms total)
T2470 564:823 JLINK_IsHalted()  returns FALSE (0000ms, 1912ms total)
T2470 564:924 JLINK_IsHalted()  returns FALSE (0000ms, 1912ms total)
T2470 565:025 JLINK_IsHalted()  returns FALSE (0000ms, 1912ms total)
T2470 565:127 JLINK_IsHalted()  returns FALSE (0000ms, 1912ms total)
T2470 565:227 JLINK_IsHalted()  returns FALSE (0000ms, 1912ms total)
T2470 565:328 JLINK_IsHalted()  returns FALSE (0000ms, 1912ms total)
T2470 565:430 JLINK_IsHalted()  returns FALSE (0000ms, 1912ms total)
T2470 565:530 JLINK_IsHalted()  returns FALSE (0000ms, 1912ms total)
T2470 565:631 JLINK_IsHalted()  returns FALSE (0000ms, 1912ms total)
T2470 565:732 JLINK_IsHalted()  returns FALSE (0000ms, 1912ms total)
T2470 565:833 JLINK_IsHalted()  returns FALSE (0000ms, 1912ms total)
T2470 565:933 JLINK_IsHalted()  returns FALSE (0000ms, 1912ms total)
T2470 566:034 JLINK_IsHalted()  returns FALSE (0000ms, 1912ms total)
T2470 566:135 JLINK_IsHalted()  returns FALSE (0000ms, 1912ms total)
T2470 566:236 JLINK_IsHalted()  returns FALSE (0000ms, 1912ms total)
T2470 566:336 JLINK_IsHalted()  returns FALSE (0000ms, 1912ms total)
T2470 566:437 JLINK_IsHalted()  returns FALSE (0000ms, 1912ms total)
T2470 566:538 JLINK_IsHalted()  returns FALSE (0000ms, 1912ms total)
T2470 566:639 JLINK_IsHalted()  returns FALSE (0000ms, 1912ms total)
T2470 566:739 JLINK_IsHalted()  returns FALSE (0000ms, 1912ms total)
T2470 566:840 JLINK_IsHalted()  returns FALSE (0000ms, 1912ms total)
T2470 566:941 JLINK_IsHalted()  returns FALSE (0000ms, 1912ms total)
T2470 567:041 JLINK_IsHalted()  returns FALSE (0000ms, 1912ms total)
T2470 567:142 JLINK_IsHalted()  returns FALSE (0000ms, 1912ms total)
T2470 567:243 JLINK_IsHalted()  returns FALSE (0000ms, 1912ms total)
T2470 567:344 JLINK_IsHalted()  returns FALSE (0000ms, 1912ms total)
T2470 567:444 JLINK_IsHalted()  returns FALSE (0000ms, 1912ms total)
T2470 567:545 JLINK_IsHalted()  returns FALSE (0000ms, 1912ms total)
T2470 567:646 JLINK_IsHalted()  returns FALSE (0000ms, 1912ms total)
T2470 567:747 JLINK_IsHalted()  returns FALSE (0000ms, 1912ms total)
T2470 567:847 JLINK_IsHalted()  returns FALSE (0000ms, 1912ms total)
T2470 567:948 JLINK_IsHalted()  returns FALSE (0000ms, 1912ms total)
T2470 568:049 JLINK_IsHalted()  returns FALSE (0000ms, 1912ms total)
T2470 568:150 JLINK_IsHalted()  returns FALSE (0000ms, 1912ms total)
T2470 568:251 JLINK_IsHalted()  returns FALSE (0000ms, 1912ms total)
T2470 568:352 JLINK_IsHalted()  returns FALSE (0000ms, 1912ms total)
T2470 568:453 JLINK_IsHalted()  returns FALSE (0000ms, 1912ms total)
T2470 568:554 JLINK_IsHalted()  returns FALSE (0000ms, 1912ms total)
T2470 568:655 JLINK_IsHalted()  returns FALSE (0000ms, 1912ms total)
T2470 568:756 JLINK_IsHalted()  returns FALSE (0000ms, 1912ms total)
T2470 568:857 JLINK_IsHalted()  returns FALSE (0000ms, 1912ms total)
T2470 568:957 JLINK_IsHalted()  returns FALSE (0000ms, 1912ms total)
T2470 569:058 JLINK_IsHalted()  returns FALSE (0000ms, 1912ms total)
T2470 569:160 JLINK_IsHalted()  returns FALSE (0000ms, 1912ms total)
T2470 569:261 JLINK_IsHalted()  returns FALSE (0000ms, 1912ms total)
T2470 569:362 JLINK_IsHalted()  returns FALSE (0000ms, 1912ms total)
T2470 569:463 JLINK_IsHalted()  returns FALSE (0000ms, 1912ms total)
T2470 569:564 JLINK_IsHalted()  returns FALSE (0000ms, 1912ms total)
T2470 569:665 JLINK_IsHalted()  returns FALSE (0000ms, 1912ms total)
T2470 569:765 JLINK_IsHalted()  returns FALSE (0000ms, 1912ms total)
T2470 569:867 JLINK_IsHalted()  returns FALSE (0000ms, 1912ms total)
T2470 569:968 JLINK_IsHalted()  returns FALSE (0000ms, 1912ms total)
T2470 570:068 JLINK_IsHalted()  returns FALSE (0000ms, 1912ms total)
T2470 570:170 JLINK_IsHalted()  returns FALSE (0000ms, 1912ms total)
T2470 570:271 JLINK_IsHalted()  returns FALSE (0000ms, 1912ms total)
T2470 570:372 JLINK_IsHalted()  returns FALSE (0000ms, 1912ms total)
T2470 570:472 JLINK_IsHalted()  returns FALSE (0000ms, 1912ms total)
T2470 570:573 JLINK_IsHalted()  returns FALSE (0000ms, 1912ms total)
T2470 570:674 JLINK_IsHalted()  returns FALSE (0000ms, 1912ms total)
T2470 570:774 JLINK_IsHalted()  returns FALSE (0000ms, 1912ms total)
T2470 570:875 JLINK_IsHalted()  returns FALSE (0000ms, 1912ms total)
T2470 570:976 JLINK_IsHalted()  returns FALSE (0000ms, 1912ms total)
T2470 571:077 JLINK_IsHalted()  returns FALSE (0000ms, 1912ms total)
T2470 571:178 JLINK_IsHalted()  returns FALSE (0000ms, 1912ms total)
T2470 571:278 JLINK_IsHalted()  returns FALSE (0000ms, 1912ms total)
T2470 571:379 JLINK_IsHalted()  returns FALSE (0000ms, 1912ms total)
T2470 571:481 JLINK_IsHalted()  returns FALSE (0000ms, 1912ms total)
T2470 571:581 JLINK_IsHalted()  returns FALSE (0000ms, 1912ms total)
T2470 571:682 JLINK_IsHalted()  returns FALSE (0000ms, 1912ms total)
T2470 571:783 JLINK_IsHalted()  returns FALSE (0000ms, 1912ms total)
T2470 571:884 JLINK_IsHalted()  returns FALSE (0000ms, 1912ms total)
T2470 571:985 JLINK_IsHalted()  returns FALSE (0000ms, 1912ms total)
T2470 572:086 JLINK_IsHalted()  returns FALSE (0000ms, 1912ms total)
T2470 572:187 JLINK_IsHalted()  returns FALSE (0000ms, 1912ms total)
T2470 572:288 JLINK_IsHalted()  returns FALSE (0000ms, 1912ms total)
T2470 572:389 JLINK_IsHalted()  returns FALSE (0000ms, 1912ms total)
T2470 572:490 JLINK_IsHalted()  returns FALSE (0000ms, 1912ms total)
T2470 572:591 JLINK_IsHalted()  returns FALSE (0000ms, 1912ms total)
T2470 572:691 JLINK_IsHalted()  returns FALSE (0000ms, 1912ms total)
T2470 572:793 JLINK_IsHalted()  returns FALSE (0000ms, 1912ms total)
T2470 572:894 JLINK_IsHalted()  returns FALSE (0000ms, 1912ms total)
T2470 572:995 JLINK_IsHalted()  returns FALSE (0000ms, 1912ms total)
T2470 573:095 JLINK_IsHalted()  returns FALSE (0000ms, 1912ms total)
T2470 573:196 JLINK_IsHalted()  returns FALSE (0000ms, 1912ms total)
T2470 573:297 JLINK_IsHalted()  returns FALSE (0000ms, 1912ms total)
T2470 573:398 JLINK_IsHalted()  returns FALSE (0000ms, 1912ms total)
T2470 573:499 JLINK_IsHalted()  returns FALSE (0000ms, 1912ms total)
T2470 573:601 JLINK_IsHalted()  returns FALSE (0000ms, 1912ms total)
T2470 573:702 JLINK_IsHalted()  returns FALSE (0000ms, 1912ms total)
T2470 573:803 JLINK_IsHalted()  returns FALSE (0000ms, 1912ms total)
T2470 573:903 JLINK_IsHalted()  returns FALSE (0000ms, 1912ms total)
T2470 574:004 JLINK_IsHalted()  returns FALSE (0000ms, 1912ms total)
T2470 574:106 JLINK_IsHalted()  returns FALSE (0000ms, 1912ms total)
T2470 574:206 JLINK_IsHalted()  returns FALSE (0000ms, 1912ms total)
T2470 574:308 JLINK_IsHalted()  returns FALSE (0000ms, 1912ms total)
T2470 574:409 JLINK_IsHalted()  returns FALSE (0000ms, 1912ms total)
T2470 574:509 JLINK_IsHalted()  returns FALSE (0000ms, 1912ms total)
T2470 574:610 JLINK_IsHalted()  returns FALSE (0000ms, 1912ms total)
T2470 574:712 JLINK_IsHalted()  returns FALSE (0000ms, 1912ms total)
T2470 574:813 JLINK_IsHalted()  returns FALSE (0000ms, 1912ms total)
T2470 574:913 JLINK_IsHalted()  returns FALSE (0000ms, 1912ms total)
T2470 575:014 JLINK_IsHalted()  returns FALSE (0000ms, 1912ms total)
T2470 575:116 JLINK_IsHalted()  returns FALSE (0000ms, 1912ms total)
T2470 575:217 JLINK_IsHalted()  returns FALSE (0000ms, 1912ms total)
T2470 575:317 JLINK_IsHalted()  returns FALSE (0000ms, 1912ms total)
T2470 575:418 JLINK_IsHalted()  returns FALSE (0000ms, 1912ms total)
T2470 575:519 JLINK_IsHalted()  returns FALSE (0000ms, 1912ms total)
T2470 575:620 JLINK_IsHalted()  returns FALSE (0000ms, 1912ms total)
T2470 575:721 JLINK_IsHalted()  returns FALSE (0000ms, 1912ms total)
T2470 575:822 JLINK_IsHalted()  returns FALSE (0000ms, 1912ms total)
T2470 575:923 JLINK_IsHalted()  returns FALSE (0000ms, 1912ms total)
T2470 576:024 JLINK_IsHalted()  returns FALSE (0000ms, 1912ms total)
T2470 576:124 JLINK_IsHalted()  returns FALSE (0001ms, 1913ms total)
T2470 576:226 JLINK_IsHalted()  returns FALSE (0000ms, 1912ms total)
T2470 576:327 JLINK_IsHalted()  returns FALSE (0000ms, 1912ms total)
T2470 576:427 JLINK_IsHalted()  returns FALSE (0000ms, 1912ms total)
T2470 576:528 JLINK_IsHalted()  returns FALSE (0000ms, 1912ms total)
T2470 576:629 JLINK_IsHalted()  returns FALSE (0000ms, 1912ms total)
T2470 576:731 JLINK_IsHalted()  returns FALSE (0000ms, 1912ms total)
T2470 576:831 JLINK_IsHalted()  returns FALSE (0000ms, 1912ms total)
T2470 576:932 JLINK_IsHalted()  returns FALSE (0000ms, 1912ms total)
T2470 577:033 JLINK_IsHalted()  returns FALSE (0000ms, 1912ms total)
T2470 577:134 JLINK_IsHalted()  returns FALSE (0000ms, 1912ms total)
T2470 577:236 JLINK_IsHalted()  returns FALSE (0000ms, 1912ms total)
T2470 577:337 JLINK_IsHalted()  returns FALSE (0000ms, 1912ms total)
T2470 577:438 JLINK_IsHalted()  returns FALSE (0000ms, 1912ms total)
T2470 577:538 JLINK_IsHalted()  returns FALSE (0000ms, 1912ms total)
T2470 577:639 JLINK_IsHalted()  returns FALSE (0000ms, 1912ms total)
T2470 577:740 JLINK_IsHalted()  returns FALSE (0000ms, 1912ms total)
T2470 577:842 JLINK_IsHalted()  returns FALSE (0000ms, 1912ms total)
T2470 577:942 JLINK_IsHalted()  returns FALSE (0000ms, 1912ms total)
T2470 578:043 JLINK_IsHalted()  returns FALSE (0000ms, 1912ms total)
T2470 578:144 JLINK_IsHalted()  returns FALSE (0000ms, 1912ms total)
T2470 578:246 JLINK_IsHalted()  returns FALSE (0000ms, 1912ms total)
T2470 578:347 JLINK_IsHalted()  returns FALSE (0000ms, 1912ms total)
T2470 578:448 JLINK_IsHalted()  returns FALSE (0000ms, 1912ms total)
T2470 578:549 JLINK_IsHalted()  returns FALSE (0000ms, 1912ms total)
T2470 578:649 JLINK_IsHalted()  returns FALSE (0000ms, 1912ms total)
T2470 578:750 JLINK_IsHalted()  returns FALSE (0000ms, 1912ms total)
T2470 578:852 JLINK_IsHalted()  returns FALSE (0000ms, 1912ms total)
T2470 578:953 JLINK_IsHalted()  returns FALSE (0000ms, 1912ms total)
T2470 579:054 JLINK_IsHalted()  returns FALSE (0000ms, 1912ms total)
T2470 579:155 JLINK_IsHalted()  returns FALSE (0000ms, 1912ms total)
T2470 579:256 JLINK_IsHalted()  returns FALSE (0000ms, 1912ms total)
T2470 579:358 JLINK_IsHalted()  returns FALSE (0000ms, 1912ms total)
T2470 579:458 JLINK_IsHalted()  returns FALSE (0000ms, 1912ms total)
T2470 579:559 JLINK_IsHalted()  returns FALSE (0000ms, 1912ms total)
T2470 579:660 JLINK_IsHalted()  returns FALSE (0000ms, 1912ms total)
T2470 579:761 JLINK_IsHalted()  returns FALSE (0000ms, 1912ms total)
T2470 579:862 JLINK_IsHalted()  returns FALSE (0000ms, 1912ms total)
T2470 579:963 JLINK_IsHalted()  returns FALSE (0000ms, 1912ms total)
T2470 580:064 JLINK_IsHalted()  returns FALSE (0000ms, 1912ms total)
T2470 580:164 JLINK_IsHalted()  returns FALSE (0001ms, 1913ms total)
T2470 580:266 JLINK_IsHalted()  returns FALSE (0000ms, 1912ms total)
T2470 580:367 JLINK_IsHalted()  returns FALSE (0000ms, 1912ms total)
T2470 580:468 JLINK_IsHalted()  returns FALSE (0000ms, 1912ms total)
T2470 580:569 JLINK_IsHalted()  returns FALSE (0000ms, 1912ms total)
T2470 580:670 JLINK_IsHalted()  returns FALSE (0000ms, 1912ms total)
T2470 580:771 JLINK_IsHalted()  returns FALSE (0000ms, 1912ms total)
T2470 580:872 JLINK_IsHalted()  returns FALSE (0000ms, 1912ms total)
T2470 580:973 JLINK_IsHalted()  returns FALSE (0000ms, 1912ms total)
T2470 581:074 JLINK_IsHalted()  returns FALSE (0000ms, 1912ms total)
T2470 581:175 JLINK_IsHalted()  returns FALSE (0000ms, 1912ms total)
T2470 581:276 JLINK_IsHalted()  returns FALSE (0000ms, 1912ms total)
T2470 581:377 JLINK_IsHalted()  returns FALSE (0000ms, 1912ms total)
T2470 581:478 JLINK_IsHalted()  returns FALSE (0000ms, 1912ms total)
T2470 581:579 JLINK_IsHalted()  returns FALSE (0000ms, 1912ms total)
T2470 581:679 JLINK_IsHalted()  returns FALSE (0000ms, 1912ms total)
T2470 581:780 JLINK_IsHalted()  returns FALSE (0000ms, 1912ms total)
T2470 581:882 JLINK_IsHalted()  returns FALSE (0000ms, 1912ms total)
T2470 581:983 JLINK_IsHalted()  returns FALSE (0000ms, 1912ms total)
T2470 582:083 JLINK_IsHalted()  returns FALSE (0000ms, 1912ms total)
T2470 582:185 JLINK_IsHalted()  returns FALSE (0000ms, 1912ms total)
T2470 582:286 JLINK_IsHalted()  returns FALSE (0000ms, 1912ms total)
T2470 582:386 JLINK_IsHalted()  returns FALSE (0000ms, 1912ms total)
T2470 582:487 JLINK_IsHalted()  returns FALSE (0000ms, 1912ms total)
T2470 582:588 JLINK_IsHalted()  returns FALSE (0000ms, 1912ms total)
T2470 582:689 JLINK_IsHalted()  returns FALSE (0000ms, 1912ms total)
T2470 582:790 JLINK_IsHalted()  returns FALSE (0000ms, 1912ms total)
T2470 582:891 JLINK_IsHalted()  returns FALSE (0000ms, 1912ms total)
T2470 582:992 JLINK_IsHalted()  returns FALSE (0000ms, 1912ms total)
T2470 583:093 JLINK_IsHalted()  returns FALSE (0000ms, 1912ms total)
T2470 583:193 JLINK_IsHalted()  returns FALSE (0000ms, 1912ms total)
T2470 583:295 JLINK_IsHalted()  returns FALSE (0000ms, 1912ms total)
T2470 583:396 JLINK_IsHalted()  returns FALSE (0000ms, 1912ms total)
T2470 583:497 JLINK_IsHalted()  returns FALSE (0000ms, 1912ms total)
T2470 583:598 JLINK_IsHalted()  returns FALSE (0000ms, 1912ms total)
T2470 583:700 JLINK_IsHalted()  returns FALSE (0000ms, 1912ms total)
T2470 583:801 JLINK_IsHalted()  returns FALSE (0000ms, 1912ms total)
T2470 583:902 JLINK_IsHalted()  returns FALSE (0000ms, 1912ms total)
T2470 584:003 JLINK_IsHalted()  returns FALSE (0000ms, 1912ms total)
T2470 584:104 JLINK_IsHalted()  returns FALSE (0000ms, 1912ms total)
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
