quanhengwen/LK02/硬件/LK02/LK02最新硬件/发射板/C2 TX Rev2.0.pdf

FSA Main Board
0
Mileseey | Jonyzhong

³ß´ç

B Ò³Âë
/
¹«Ë¾ | ×÷Õß | Ê±¼ä
标题 | °æ±¾
1

5

2015-01-22

标题 | °æ±¾
2

5

¹«Ë¾ | ×÷Õß | Ê±¼ä ³ß´ç
B | Ò³Âë
/

Mileseey

FSA Main Board
Jonyzhong 0
2015-01-22

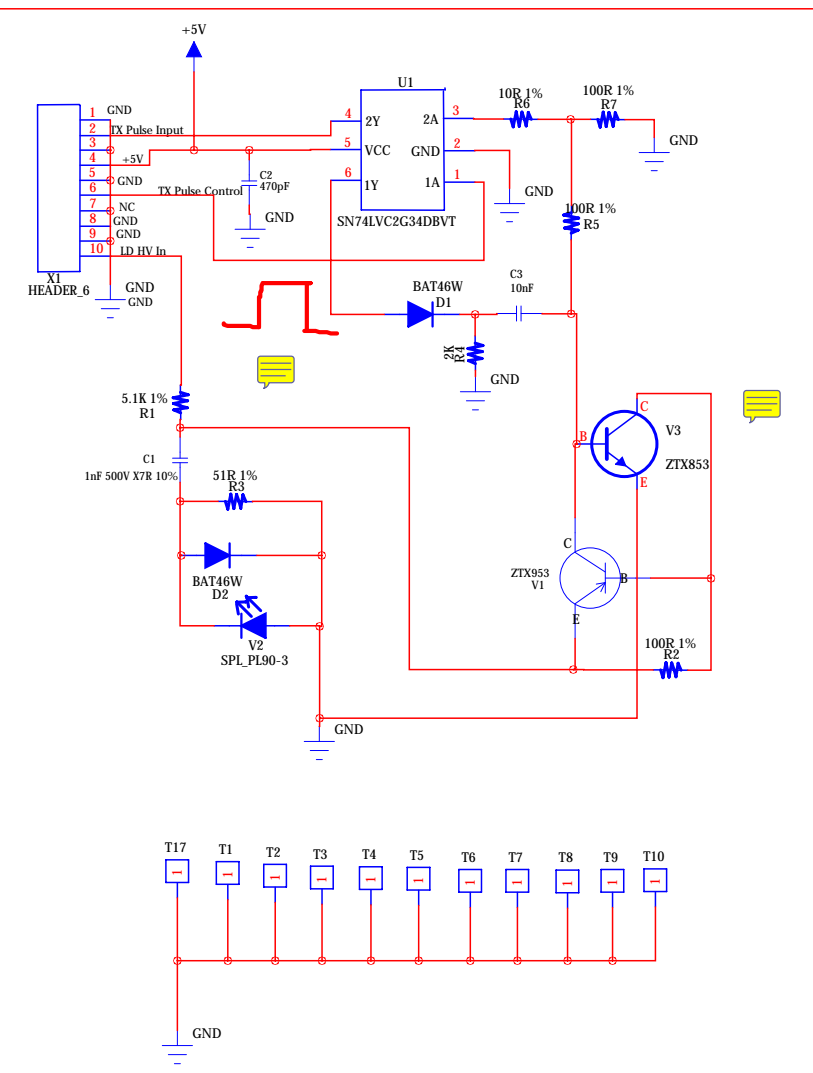
[picture p3: page 3]

FSA Main Board

Mileseey | Jonyzhong

³ß´ç

B Ò³Âë
/
标题 | °æ±¾
0

4

5

FSA Main Board

0

Mileseey

³ß´ç

B Ò³Âë
/
¹«Ë¾ | ×÷Õß | Jonyzhong | Ê±¼ä
±êÌâ | | °æ±¾
5

5
