quanhengwen/LK02/硬件/LK02/LK02最新硬件/接收板/C2 RX Rev2.2.pdf

## FSA Main Board

0
Mileseey | Jonyzhong

## ³ß´ç

## B Ò³Âë

/
¹«Ë¾ | ×÷Õß | Ê±¼ä
标题 | °æ±¾
1

5

2015-01-22

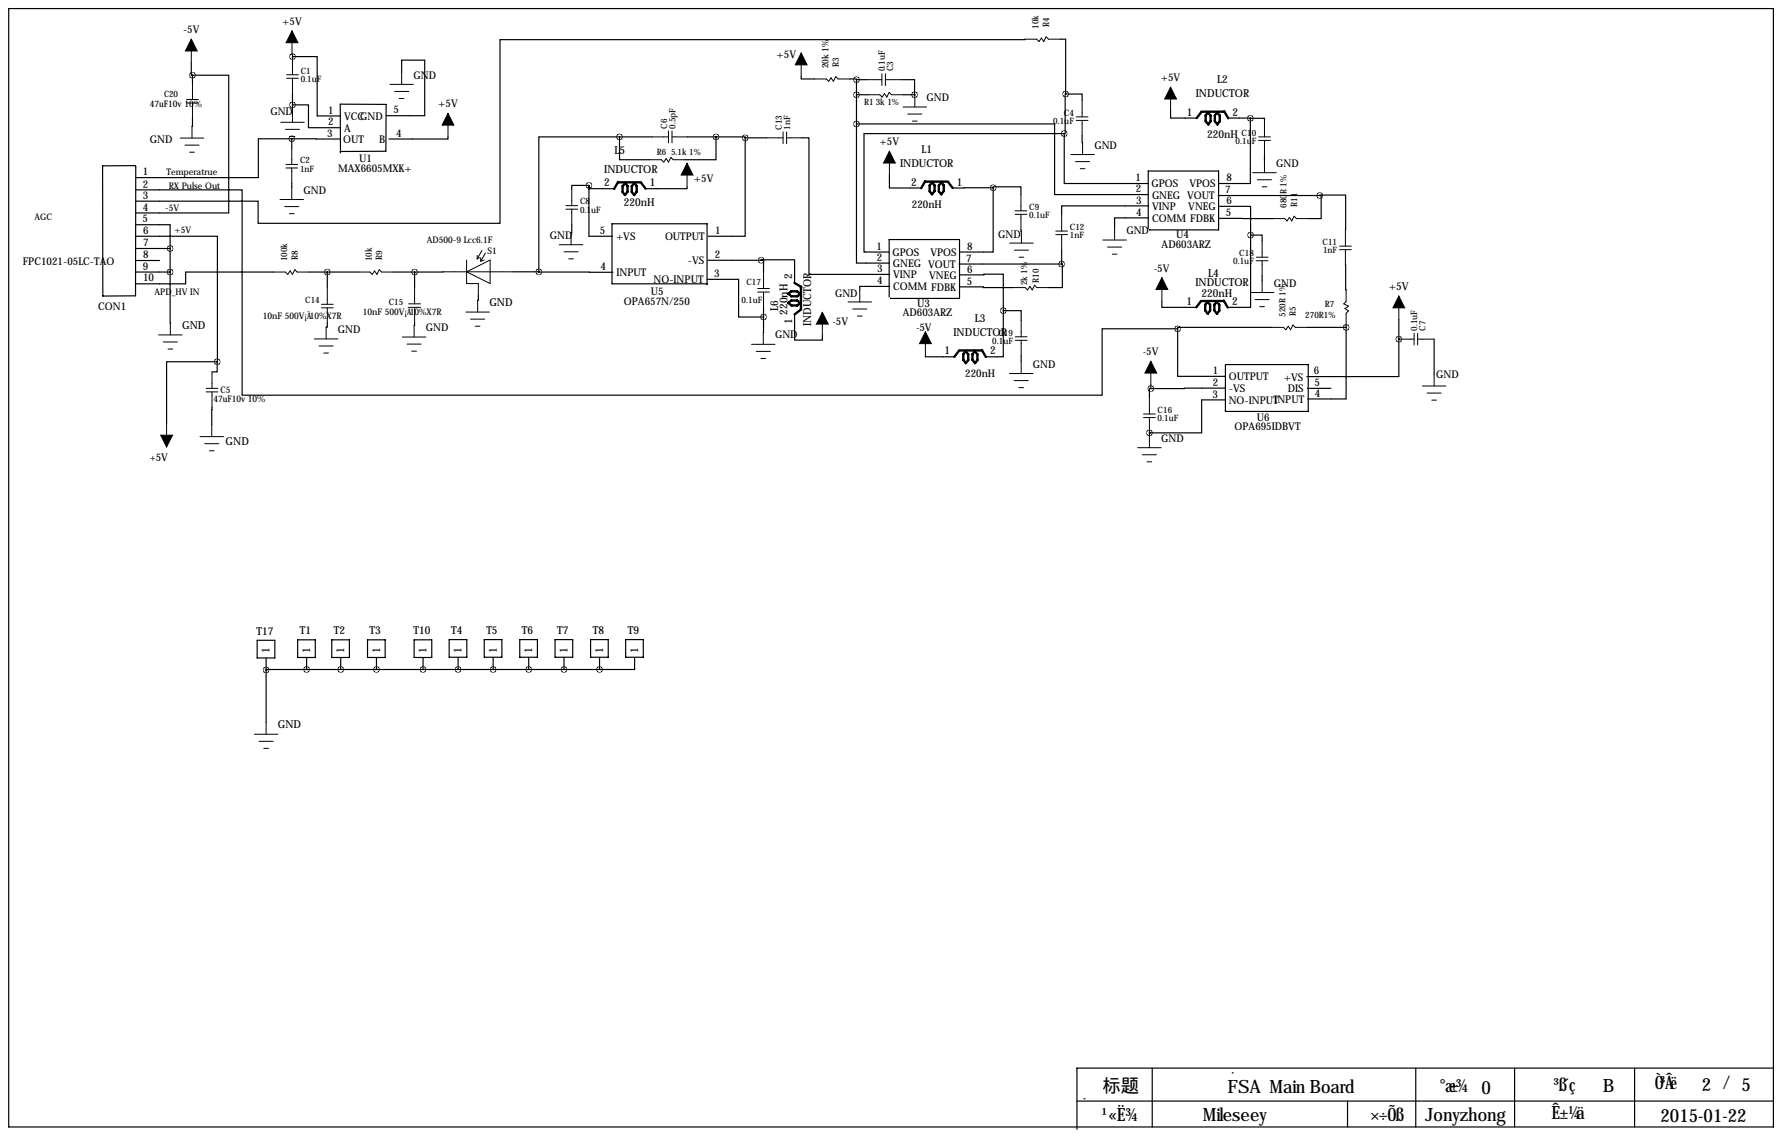
[picture p4: page 2]

## Jonyzhong

## FSA Main Board

## Mileseey

## ³ß´ç

## B Ò³Âë

/
标题 | °æ±¾
0

3

5

## FSA Main Board

Mileseey | Jonyzhong

## ³ß´ç

## B Ò³Âë

/
标题 | °æ±¾
0

4

5

## FSA Main Board

0

## Mileseey

## ³ß´ç

## B Ò³Âë

/

¹«Ë¾ | ×÷Õß | Jonyzhong | Ê±¼ä
±êÌâ | | °æ±¾
5

5
