quanhengwen/LK02/硬件/LK02 3V0/LK02_3V0/LK02缺料BOM.xlsx

Sheet: Sheet1
Item | Value | PCB Footprint | Description | Mileseey PN | Qty | Cost
1 | MIC4452 | SOP_8 | MIC4452/MOSDRIVER/SOP8 |  | 20
2 | BFT92 | SOT23_TEMP | BFT92/HFPNP/SOT23 |  | 100
3 | 56K/1% | R0402 | 56K/1%/R0402 |  | 10K
4 | 75K/1% | R0402 | 75K/1%/R0402 |  | 10K
5 | DS18B20 | SOP_8 | DS18B20/SOP8 |  | 20
6 | BFR92A | SOT23_TEMP | BFR92A/HF NPN/SOT23 |  | 100
7 | 820R | R0402 | 820R/1%/R0402 |  | 10K
8 | 220uF/6V3 | C1210 | 220uF/6V3/10%/C1210钽电容D型 |  | 100
9 | 3.3nF | C0402 | 3.3nF/50V/5%/C0402 |  | 10K
10 | 47uF/6V3 | C1210 | 47uF/6V3/10%/C1210钽电容D型 |  | 100
11 | 47uF | C1206 | 47uF/16V/10%/C1206 | 1114-00007-00 | 3K
12 | DB10_CON | CON1X10 | CONSMD10P/1.5mm/立式 |  | 100
13 | 8MHz/10pF/20ppm | SMD5032 | 8MHz/10pF/20ppm/SMD5032晶振 |  | 100
14 | BLM18AG152SN1D | R0603 | BLM18AG152SN1D/0603磁珠 |  | 4K
15 | BLM18AG471SN1D | R0603 | BLM18AG471SN1D/0603磁珠 |  | 4K
16 | 10uH CDRH74 | DRH4D28 | 10uH/10%/CDRH74功率电感 |  | 100
17 | MP1482 | SOP_8 | MP1482/DCDC/2A/SOP8/MPS |  | 100
18 | 0ZCJ0075AF2E | R1206 | 0ZCJ0075AF2E/R1206/自恢复保险SMD |  | 100
19 | 26.1K 1% | R0402 | 26K1/1%/R0402 |  | 10K
20 | 44.2K 1% | R0402 | 44K2/1%/R0402 |  | 10K
21 | STM32F103RCT6 | LQFP64 | STM32F103RCT6/LQFP64/ST |  | 20
22 | ZMM12 | LL34 | 12V/钳位稳压管/LL34 |  | 100
23 | ZMM3V3 | LL34 | 3V3/钳位稳压管/LL34 |  | 100

Sheet: Sheet2
迈测科技－物品申请单
编号：
申请人信息 |  | 姓名：范煦 | 职务：硬件工程师 | 部门：研发部
申请时间 |  | 2017-08-16
物品明细资料
序号 | 所属项目 | 物料编码（如无不填） | 物品详细规格（品牌、封装、颜色、材质等关键规格） | 申请数量 | 单位 | 期望交期 | 备注说明
1 | LK02 |  | MIC4452/MOSDRIVER/SOP8 | 20 | PCS | 2017-08-21 | 阻容件按照整盘封装数量整盘采购，其他IC散货需求按照请购数量执行
2 |  |  | BFT92/HFPNP/SOT23 | 100 | PCS
3 |  |  | 56K/1%/R0402 | 10K | PCS
4 |  |  | 75K/1%/R0402 | 10K | PCS
5 |  |  | DS18B20/SOP8 | 20 | PCS
6 |  |  | BFR92A/HF NPN/SOT23 | 100 | PCS
7 |  |  | 820R/1%/R0402 | 10K | PCS
8 |  |  | 220uF/6V3/10%/C1210钽电容D型 | 100 | PCS
9 |  |  | 3.3nF/50V/5%/C0402 | 10K | PCS
10 |  |  | 47uF/6V3/10%/C1210钽电容D型 | 100 | PCS
11 |  | 1114-00007-00 | 47uF/16V/10%/C1206 | 3K | PCS
12 |  |  | CONSMD10P/1.5mm/立式 | 100 | PCS
13 |  |  | 8MHz/10pF/20ppm/SMD5032晶振 | 100 | PCS
14 |  |  | BLM18AG152SN1D/0603磁珠 | 4K | PCS
15 |  |  | BLM18AG471SN1D/0603磁珠 | 4K | PCS
16 |  |  | 10uH/10%/CDRH74功率电感 | 100 | PCS
17 |  |  | MP1482/DCDC/2A/SOP8/MPS | 100 | PCS
18 |  |  | 0ZCJ0075AF2E/R1206/自恢复保险SMD | 100 | PCS
19 |  |  | 26K1/1%/R0402 | 10K | PCS
20 |  |  | 44K2/1%/R0402 | 10K | PCS
21 |  |  | STM32F103RCT6/LQFP64/ST | 20 | PCS
22 |  |  | 12V/钳位稳压管/LL34 | 100 | PCS
23 |  |  | 3V3/钳位稳压管/LL34 | 100 | PCS
结构确认： |  |  |  | 电子确认：
部门经理批准：
注：PCB放板需结构和电子确认，其他均只需部门经理批准。所属项目如未填，则默认为申请部门费用。
