quanhengwen/LK02/硬件/LK02 3V0/LK02_3V0/MAIN_3V0/BOM_MAIN_3V0.xlsx

Item | Qty | Reference | Value | PCB Footprint | Description | Mileseey PN
1 | 2 | D1-2 | 1N4148 | SOD123 | 1N4148W-7-F/SOD123 | 1133-00023-00
2 | 1 | Q3 | S8050 | SOT23_TEMP | S8050/J3Y/SOT23 | 1131-00007-00
3 | 2 | U5 U12 | 74AHC1G08 | SOT23-5 | SN74AHCT1G08DBVR SOT23-5 TI | 1141-00159-00
4 | 2 | U2 U14 | AD603ARZ | SO-8 | AD603ARZ SOIC-8 ADI | 1141-00177-00
5 | 1 | Q1 | AO3401A | SOT-23 | CJ3401/SOT-23/CHANGJIANG | 1135-00003-00
6 | 2 | V1 V10 | BAV99 | SOT-23 | BAV99/SOD-23/Fairchild | 1133-00025-00
7 | 2 | Q4 Q9 | BSS123 | SOT-23 | FET BSS131 SOT23 "SRs" Infineon | 1135-00008-00
8 | 31 | C1-2 C6 C8-12 C14-15 C17 C20 C36 C39-40 C42 C48 C53 C56 C60 C75-79 C82 C32 C57 C59 C68 C73 | 100nF | C0402 | 100nF/16V/10%/C0402 | 1111-00000-00
9 | 2 | C16 C21 | 100nF_NC | C0402 | NC
10 | 2 | C18-19 | 10nF | C0402 | 10nF/50V/10%/C0402 | 1111-00004-00
11 | 2 | C24-25 | 10pF | C0402 | 10pF/50V/5%/C0402 | 1111-00029-00
12 | 2 | C3-4 | 10pF_NC | C0402 | NC
13 | 2 | C33 C38 | 1nF | C0402 | 1nF/50V/5%/C0402 | 1111-00074-00
14 | 2 | C27 C49 | 1uF | C0402 | 1uF/16V/10%/C0402 | 1111-00007-00
15 | 1 | C28 | 4.7uF | C0402 | 4.7uF/6V3/10%/C0402 | 1111-00046-00
16 | 1 | C22 | 470pF | C0402 | 470pF/50V/10%/C0402 | 1111-00082-00
17 | 2 | C61 C69 | 10nF | C0402 | 10nF/50V/10%/C0402 | 1111-00004-00
18 | 5 | C37 C43 C66 C45-46 | 10uF | C0603 | 10uF/16V/10%/C0603 | 1112-00000-00
19 | 1 | C80 | 1uF | C0603 | 1uF/25V/10%/C0603 | 1112-00003-00
20 | 2 | C64 C71 | 220uF/6V3 | C1210 | 220uF/6V3/10%/C1210钽电容D型
21 | 9 | C7 C41 C55 C65 C67 C72 C34-35 C81 | 22uF | C0805 | 22uF/6V3/20%/C0805 | 1113-00000-00
22 | 2 | C63 C70 | 3.3nF | C0402 | 3.3nF/50V/5%/C0402
23 | 3 | C13 C30 C62 | 4.7uF | C0603 | 4.7uF/25V/10%/C0603 | 1112-00001-00
24 | 1 | C5 | 47uF/6V3 | C1210 | 47uF/6V3/10%/C1210钽电容D型
25 | 6 | C29 C31 C58 C83-85 | 10nF/250v | C1206 | 10nF/250V/10%/C1206 | 1114-00006-00
26 | 2 | C26 C74 | 47uF | C1206 | 47uF/16V/10%/C1206 | 1114-00007-00
27 | 1 | J3 | LD_TARGET | CON5-0.5MM | FPC5P/0.5mm/下接触/翻盖 | 1221-00023-00
28 | 1 | J2 | DB10_CON | CON1X10 | CONSMD10P/1.25mm/立式
29 | 1 | Y2 | 8MHz/10pF/20ppm | SMD5032 | 8MHz/10pF/20ppm/SMD5032晶振/无源
30 | 1 | D3 | US1G | SMA | US1G-13-F/SMA | 1133-00024-00
31 | 1 | J1 | TX_CON | XF2J-1024-12A | FPC10PIN立式1型抽屉下接触 脚间距1.0mm线间距0.5mm | 1221-00032-00
32 | 1 | J6 | RX_CON | XF2J-1024-12A | FPC10PIN立式1型抽屉下接触 脚间距1.0mm线间距0.5mm | 1221-00032-00
33 | 1 | L14 | BLM18AG152SN1D | R0603 | BLM18AG152SN1D/0603磁珠
34 | 7 | L1 L3-6 L8 L11 | BLM18AG471SN1D | R0603 | BLM18AG471SN1D/0603磁珠
35 | 2 | L10 L12 | 10uH CDRH74 | DRH4D28 | 10uH/10%/CDRH74功率电感
36 | 2 | L2 L9 | 220uH | L1210 | 220uH/10%/NLCV32T-221K-PF/TDK | 1128-00000-00
37 | 1 | U13 | LM27761 | LM27761 | LM27761DSGR WSON-8 TI | 1141-00161-00
38 | 1 | L13 | L_COMMON_4P | L_COMMON_4P | 1mH/LCOMMON/DIP4 | 1128-00031-00
39 | 2 | U4 U7 | MAX999 | SOT23-5 | MAX999EUK+T SOT23-5 Maxim | 1141-00162-00
40 | 2 | U1 U8 | MAX3620C | MAX3620C | MAX3620CETT 6-TDFN Maxim | 1141-00166-00
41 | 2 | U9 U11 | MP1482 | SOP_8 | MP1482/DCDC/2A/SOP8/MPS
42 | 1 | Q2 | S8050 | SOT23AB | S8050/NPN/SOT23/JCST | 1131-00007-00
43 | 1 | U6 | OPA690 | SOT23-6 | OPA690IDBVT SOT23-6 TI | 1141-00165-00
44 | 2 | R42 R60 | 0R | R0402 | 0R/1%/R0402 | 1101-00000-00
45 | 1 | R39 | 0R_NC | R0402 | NC
46 | 1 | FU1 | 0ZCJ0075AF2E | R1206 | 0ZCJ0075AF2E/R1206/自恢复保险SMD
47 | 1 | R4 | 1K2 | R0402 | 1K2/1%/R0402 | 1101-00034-00
48 | 11 | R15 R18 R31 R34 R44 R47 R24 R20 R45-46 R51 | 100K | R0402 | 100K/1%/R0402 | 1101-00002-00
49 | 3 | R13-14 R16 | 100R | R0402 | 100R/1%/R0402 | 1101-00077-00
50 | 7 | R23 R29 R32 R36 R64 R35 R48 | 10K | R0402 | 10K/1%/R0402 | 1101-00004-00
51 | 1 | R12 | 10R | R0402 | 10R/1%/R0402 | 1101-00003-00
52 | 1 | R3 | 11K | R0402 | 11K/1%/R0402 | 1101-00104-00
53 | 12 | R22 R25 R28 R61-63 R65 R68 R71 R17 R19 R27 | 1K | R0402 | 1K/1%/R0402 | 1101-00072-00
54 | 1 | R38 | 1K_NC | R0402 | NC
55 | 2 | R53 R59 | 1Meg | R0402 | 1Meg/1%/R0402 | 1101-00007-00
56 | 1 | R2 | 1Meg_NC | R0402 | NC
57 | 2 | R66 R69 | 2.2Meg 1% | R0805 | 2.2Meg/1%/R0805 | 1103-00003-00
58 | 1 | R21 | 20K 1% | R0402 | 20K/1%/R0402 | 1101-00013-00
59 | 1 | R49 | 26.1K 1% | R0402 | 26K1/1%/R0402
60 | 2 | R11 R33 | 30K | R0402 | 30K/1%/R0402 | 1101-00013-00
61 | 7 | R1 R50 R52 R55-58 | 33R | R0402 | 33R/1%/R0402 | 1101-00028-00
62 | 2 | R67 R70 | 39K 1% | R0402 | 39K/1%/R0402 | 1101-00023-00
63 | 1 | R43 | 44.2K 1% | R0402 | 44K2/1%/R0402
64 | 2 | R5-6 | 5K1 | R0402 | 5K1/1%/R0402 | 1101-00025-00
65 | 1 | R8 | 50R | R0402 | 51R/1%/R0402 | 1101-00015-00
66 | 2 | R7 R30 | 680R 1% | R0402 | 680R/1%/R0402 | 1101-00064-00
67 | 1 | R9 | NC | R0402 | NC
68 | 1 | U21 | REF5020 | SO-8 | REF5020AIDR SOIC-8 TI | 1141-00171-00
69 | 1 | R54 | 330K | R0402 | 330K/1%/R0402 | 1101-00063-00
70 | 1 | R10 | 750R | R0402 | 750R/1%/R0402 | 1101-00102-00
71 | 4 | D6-9 | SMAJ05 | SMA | SMAJ05/TVS管/SMA
72 | 1 | D5 | SMAJ25 | SMA | SMAJ25/TVS管/SMA | 1133-00027-00
73 | 1 | U15 | STM32F103RCT6 | LQFP64 | STM32F103RCT6/LQFP64/ST
74 | 1 | U3 | TDC-GP22 | QFN32_N | TDC-GP21/QFN32/IDT | 1141-00153-00
75 | 1 | U10 | TL082ID | SO-8 | TL082IDR SOIC-8 TI | 1141-00170-00
76 | 1 | Y1 | 4MHz_NC | HC-49S | 4MHz/10pF/20ppm/HC-49S/假贴 | 1155-00004-00
77 | 2 | D4 D13 | ZMM12 | LL34 | 12V/钳位稳压管/LL34
78 | 1 | D10 | ZMM3V3 | LL34 | 3V3/钳位稳压管/LL34
SUM | 199
