quanhengwen/LK02/硬件/LK02 3V0/LK02_3V0/RX_3V0/BOM_RX_3V0.xlsx

Item | Qty | Reference | Value | PCB Footprint | Description | Mileseey PN
1 | 1 | D1 | AD500-9 Lcc6.1F | AD500 | APD AD500-9 LCC6.1F | 1213-00011-00
2 | 4 | C1 C4-5 C7 | 100nF | C0402 | 100nF/25V/10%/0402 | 1111-00075-00
4 | 2 | C3 C6 | 1uF | C0402 | 1uF/16V/10%/0402 | 1111-00007-00
5 | 1 | C9 | 33pF_NC | C0402 | NC
6 | 1 | C8 | NC | C0402 | NC
7 | 2 | C14-15 | 10nF/250V | C1206 | 10nF/250V/10%/C1206 | 1114-00008-00
8 | 1 | U2 | DS18B20 | SOP_8 | DS18B20/SOP8
9 | 1 | CON1 | FPC100_10P_0.5DOWM | XF2J-1024-12A | FPC10PIN立式1型抽屉下接触 脚间距1.0mm线间距0.5mm | 1221-00032-00
10 | 2 | L1-2 | BLM15AG471 | L0402 | BLM15AG471磁珠/L0402
11 | 2 | Q1-2 | BFR92A | SOT23_TEMP | BFR92A/HF NPN/SOT23
12 | 2 | Q3-4 | BFT92 | SOT23_TEMP | BFT92/HF PNP/SOT23
13 | 1 | R9 | 100K | R0402 | 100K/1%/R0402 | 1101-00002-00
14 | 1 | R8 | 1K | R0402 | 1K/1%/R0402 | 1101-00072-00
15 | 2 | R3 R11 | 10K | R0402 | 10K/1%/R0402 | 1101-00004-00
16 | 1 | R5 | 10R | R0402 | 10R/1%/R0402 | 1101-00003-00
17 | 1 | R6 | 1K5 | R0402 | 1K5/1%/R0402 | 1101-00027-00
18 | 2 | R4 R7 | 200R | R0402 | 200R/1%/R0402 | 1101-00076-00
19 | 1 | R1 | 33K | R0402 | 33K/1%/R0402 | 1101-00086-00
20 | 1 | R10 | 5K1 | R0402 | 5K1/1%/R0402 | 1101-00025-00
21 | 1 | R2 | 820R | R0402 | 820R/1%/R0402
22 | 5 | S1-5 | Shield_Clamp | SHIELD_CLAMP
