quanhengwen/LK02/硬件/LK02/LK02最新硬件/BOM/Lk02带瞄准镜头 贴片BOM/2101-00092-LK02 LK02 Main Board  PCBA Assy 带瞄准镜头 .xlsx

产 品 BOM 表
产品 编码 |  | 2101-00092-LK02
产品 描述 |  | LK02 Main Board PCBA Assy 带瞄准镜头
版 本 |  | V0.1更新IC描述171010
日 期 |  | 2017-06-02
电子BOM
Item | Mileseey PN |  | Description | Qty | Reference | Unit
1 | 1111-00004-00 | 电容10nF | CAP SMD 0402 10nF 50V X5R ±10% | 2 | C18 C19 | PCS | 0.5
2 | 1111-00075-00 | 电容100nF | CAP SMD 0402 100nF 25V X5R ±10% | 29 | C1 C2 C6 C7 C8 C9 C10 C11 C12 C13 C14 C15 C16 C17 C20 C21 C25 C26 C28 C32 C39 C42 C44 C45 C57 C58 C59 C60 C82 | PCS | 0.5
3 | 1111-00006-00 | 电容100pF | CAP SMD 0402 100pF 50V COG ±10% | 1 | C53 | PCS | 0.5
4 | 1111-00013-00 | 电容10pF | CAP SMD 0402 10pF 50V NPO ±10% | 2 | C3 C4 | PCS | 0.5
5 | 1111-00007-00 | 电容1uF | CAP SMD 0402 1uF 16V X5R ±10% | 1 | C27 | PCS | 0.5
6 | 1111-00010-00 | 电容4.7nF | CAP SMD 0402 4.7nF 50V X7R ±10% | 1 | C54 | PCS | 0.5
7 | 1111-00046-00 | 电容4.7uF | CAP SMD 0402 4.7uF 6.3V ±10％ | 3 | C38 C40 C41 | PCS | 0.5
8 | 1111-00018-00 | 电容470pF | CAP SMD 0402 470pF 50V X7R ±10% | 1 | C22 | PCS | 0.5
9 | 1112-00000-00 | 电容10uF | CAP SMD 0603 10uF 16V X7R ±10% | 3 | C24 C43 C47 | PCS | 0.5
10 | 1112-00003-00 | 电容1uf | CAP SMD 0603 1uF 25V X5R ±10% | 1 | C80 | PCS | 0.5
11 | 1112-00001-00 | 电容4.7uF | CAP SMD 0603 4.7uF 25V X5R ±10% | 5 | C23 C30 C33 C62 C63 | PCS | 0.5
12 | 1114-00009-00 | 电容1nF | CAP SMD 1206 1nF 2KV X7R ±10% | 1 | C52 | PCS | 0.5
13 | 1114-00004-00 | 电容22nF | CAP SMD 1206 22nF 250V ±10% | 3 | C29 C31 C84 | PCS | 0.5
14 | 1114-00010-00 | 电容3.3nF | CAP SMD 1206 3.3nF 1KV X7R ±10% | 1 | C51 | PCS | 0.5
15 | 1114-00007-00 | 电容47uF | CAP SMD 1206 47uF 6.3V X5R ±20% | 10 | C5 C34 C35 C36 C37 C50 C55 C74 C81 C89 | PCS | 0.5
16 | 1101-00000-00 | 电阻0R | RES SMD 0402 0R 1/16W ±1% | 2 | R7 R64 | PCS | 0.5
17 | 1101-00034-00 | 电阻1.2K | RES SMD 0402 1.2K 1/16W ±1% | 1 | R4 | PCS | 0.5
18 | 1101-00001-00 | 电阻100R | RES SMD 0402 100R 1/16W ±5% | 3 | R13 R14 R5 | PCS | 0.5
19 | 1101-00002-00 | 电阻100K | RES SMD 0402 100K 1/16W ±1% | 5 | R20 R22 R45 R46 R51 | PCS | 0.5
20 | 1101-00003-00 | 电阻10R | RES SMD 0402 10R 1/16W ±1% | 2 | R12 R38 | PCS | 0.5
21 | 1101-00004-00 | 电阻10K | RES SMD 0402 10K 1/16W ±1% | 7 | R16 R23 R27 R65 R37 R26 R67 | PCS | 0.5
22 | 1101-00104-00 | 电阻11K | RES SMD 0402 11K 1/16W ±1% | 1 | R3 | PCS | 0.5
23 | 1101-00007-00 | 电阻1M | RES SMD 0402 1M 1/16W ±1% | 2 | R66 R53 | PCS | 0.5
24 | 1101-00008-00 | 电阻1K | RES SMD 0402 1K 1/16W ±5% | 2 | R17 R19 | PCS | 0.5
25 | 1101-00100-00 | 电阻22R | RES SMD 0402 22R 1/16W ±1% | 1 | R1 | PCS | 0.5
26 | 1101-00101-00 | 电阻30K | RES SMD 0402 30K 1/16W ±1% | 2 | R11 R41 | PCS | 0.5
27 | 1101-00025-00 | 电阻5.1K | RES SMD 0402 5.1K 1/16W ±1% | 1 | R15 | PCS | 0.5
28 | 1101-00015-00 | 电阻51R | RES SMD 0402 51R 1/16W ±1% | 2 | R6 R8 | PCS | 0.5
29 | 1101-00093-00 | 电阻510K | RES SMD 0402 510K 1/16W ±1% | 1 | R2 | PCS | 0.5
30 | 1101-00063-00 | 电阻330K | RES SMD 0402 330K 1/16W ±1% | 1 | R54 | PCS | 0.5
31 | 1101-00102-00 | 电阻750R | RES SMD 0402 750R 1/16W ±1% | 1 | R10 | PCS | 0.5
32 | 1102-00042-00 | 电阻2.2M | RES SMD 0603 2.2M 1/16W ±5% | 1 | R40 | PCS | 0.5
33 | 1102-00009-00 | 电阻0R | RES SMD 0603 0R 1/16W ±5% | 3 | L1 L3 R18 | PCS | 0.5
34 | 1122-00002-00 | 叠层电感4.7uH 顺络 | inductor SMD 0603 4.7uH +/-10% SDFL1608Q4R7KTF Sunlord | 2 | L6 L8 | PCS | 0.3
35 | 1128-00030-00 | 电感10uH | inductor SMD,10uH 2A CDRH74NP-100MC-B 7.5*7.5*4.5 Sumida | 1 | L7 | PCS | 0.3
36 | 1128-00000-00 | 绕线电感220uH TDK | inductor SMD 3.2*2.5*2.2 220uH +/-10% NLCV32T-221K-PF TDK | 1 | L2 | PCS | 0.3
37 | 1133-00023-00 | 二极管1N4148 | diode IN4148W-7-F SOD-123 Diodes | 1 | D1 | PCS | 0.3
38 | 1133-00024-00 | 二极管US1G-13-F | diode US1G-13-F SMA Diodes | 1 | D3 | PCS | 0.3
39 | 1133-00025-00 | 二极管BAV99 | diode BAV99 SOD-23 Fairchild | 1 | V10 | PCS | 0.3
40 | 1135-00002-00 | 场效应管FS3401 | FET FS3401 SOT23 forsemi | 2 | Q1 Q2 | PCS | 0.3
41 | 1135-00013-00 | MOS管IRLML2803TRPBF | FET IRLML2803TRPBF SOT23-3 Infineon | 1 | V1 | PCS | 0
42 | 1135-00008-00 | 场效应管BSS131 | FET BSS131 SOT23 "SRs" Infineon | 1 | V9 | PCS | 0.3
43 | 1135-00014-00 | MOS管FDC2512 | FET FDC2512 SOT-6 Fairchild | 1 | V5 | PCS | 0
44 | 1141-00159-00 | 双逻辑门SN74AHCT1G08DBVR | IC SN74AHCT1G08DBVR SOT23-5 TI | 1 | U5 | PCS | 0
45 | 1141-00160-00 | 单逻辑门SN74AHCT1G04DBVR | IC SN74AHCT1G04DBVR SOT23-5 TI | 2 | U1 U2 | PCS | 0
46 | 1141-00161-00 | 负电源开关稳压器LM27761DSGR | IC LM27761DSGR WSON-8 TI | 1 | U13 | PCS | 0
47 | 1141-00162-00 | 比较器MAX999EUK+T | IC MAX999EUK+T SOT23-5 Maxim | 2 | U4 U7 | PCS | 0
48 | 1141-00163-00 | PWM芯片MAX1523EUT+ | IC MAX1523EUT+ SOT23-6 Maxim | 1 | U23 | PCS | 0
49 | 1141-00164-00 | 3.3V稳压器MIC5207-3.3YM5-TR | IC MIC5207-3.3YM5-TR SOT23-5 Microchip | 1 | U19 | PCS | 0
50 | 1141-00165-00 | 运放OPA690IDBVT | IC OPA690IDBVT SOT23-6 TI | 1 | U6 | PCS | 0
51 | 1141-00166-00 | 延迟线MAX3620CETT | IC MAX3620CETT 6-TDFN Maxim | 2 | U8 U9 | PCS | 0
52 | 1141-00167-00 | 运放AD811JRZ | IC AD811JRZ SOIC-8 ADI | 1 | U11 | PCS | 0
53 | 1141-00168-00 | 单片机STM32F103C8T6 | IC STM32F103C8T6 LQFP48 ST | 1 | U26 | PCS | 0
54 | 1141-00153-00 | 时间数字转换器TDC_GP21 T&R | IC TDC_GP21 T&R(盘装&卷装) | 1 | U3 | PCS | 0
55 | 1141-00170-00 | 运放TL082IDR | IC TL082IDR SOIC-8 TI | 1 | U10 | PCS | 0
56 | 1141-00171-00 | 电压2.048V基准REF5020AIDR | IC REF5020AIDR SOIC-8 TI | 1 | U21 | PCS | 0
57 | 1141-00172-00 | 双路DAC芯片TLV5618AID | IC TLV5618AID SOIC8 TI | 1 | U20 | PCS | 0
58 | 1141-00173-00 | 3.3V稳压器TLV1117-33CDRJR | IC TLV1117-33CDRJR WSON-8 TI | 1 | U18 | PCS | 0
59 | 1223-00000-00 | 双排针2*12P | SMD Outlet 双排针 间距1.27mm PH1.27(H1.0) 2*12P SMD 三利佳 | 1 | CON2 | PCS | 0
60 | 1221-00032-00 | 10PIN双排插座 | SMD 10PIN立式 间距0.5mm | 2 | X3 X4 | PCS | 0
61 | 1221-00023-00 | 5PIN排插座 | Connector SMD 5PIN Pitch 0.5mm up flip lock | 1 | X1 | PCS | 0
62 | 1171-00226-02 | LK02 Main PCB V0.3 | LK02 Main PCB V0.3 FR4 4-Layer 50*59.3*1.2mm | 1 |  | PCS | 0
63 | 4501-00067-00 | 加工费 2101-00092-LK02 | 加工费 LK02 Main Board PCBA 带瞄准镜头 | 1 |  | PCS | 0
64 | 1156-00001-00 | 晶振5MHz | crystal 5MHz ±10ppm 49S（DIP）华易微 | 1 | Y1 | PCS | 0
定制：张媚 |  |  | 确认： |  | 审核：
