quanhengwen/LK02/硬件/LK02/LK02最新硬件/BOM/Lk02带瞄准镜头 贴片BOM/2103-00017-LK02 LK02 Power(V1.0) Board PCBA Assy 带瞄准镜头 TTL.xlsx

产 品 BOM 表
产品 编码 |  | 2103-00017-LK02
产品 描述 |  | LK02 Power(V1.0) Board PCBA Assy 带瞄准镜头 TTL
版 本 |  | V0.1更正10nF 0603电容用量
日 期 |  | 2017-07-05
电子BOM
Item | Mileseey PN |  | Description | Qty | Reference | Unit
1 | 4503-00011-00 | 加工费 2103-00017-LK02 | 加工费 LK02 Power PCBA | 1 |  | PCS | 0
2 | 1112-00017-00 | 电容0.1uf | CAP SMD 0603 0.1uf 50V X7R ±10% | 17 | C5 C8 C10 C13 C18 C19 C20 C21 C23 C26 C27 C31 C54 C57 C1 C2 C3 | PCS | 0.5
3 | 1111-00000-00 | 电容100nF | CAP SMD 0402 100nF 16V X5R ±10% | 5 | C34 C35 C38 C39 C41 | PCS | 0.5
4 | 1112-00014-00 | 电容10nF | CAP SMD 0603 10nF 16V X7R ±10% | 2 | C53 C25 | PCS | 0.5
5 | 1113-00004-00 | 电容10uF | CAP SMD 10uF 0805 16V X5R 10% | 6 | C14 C40 C48 C12 C17 C52 | PCS | 0.5
6 | 1112-00025-00 | 电容2.2uF | CAP SMD 0603 2.2uF 25V X5R ±10% | 1 | C36 | PCS | 0.5
7 | 1117-00005-00 | 钽电容220uF | CAP SMD 7343 220uF 16V ±10% AVX | 1 | C24 | PCS | 0.5
8 | 1117-00002-00 | 钽电容47uF | CAP SMD 7343 47uF 35V ±10% K Esize KEMET | 2 | C4 C6 | PCS | 0.5
9 | 1112-00002-00 | 电容1nf | CAP SMD 0603 1nF 50V NP0 ±10% | 4 | C7 C9 C11 C15 | PCS | 0.5
10 | 1135-00003-00 | 场效应管CJ3401 | FET CJ3401 SOT-23 CHANGJIANG | 1 | Q3 | PCS | 0.3
11 | 1221-00026-00 | 9PIN排插座 | 9PIN排插座 立贴 电源线插座 不带锁 间距1.25mm | 1 | CON3 | PCS | 0
12 | 1221-00006-00 | 双排母2*12P | SMD socket double row 1.27mm Pitch 1.27-15-22-12M-G0-046 | 1 | CON1 | PCS | 0
13 | 1141-00099-00 | CS51414 PXZPE | IC CS51414 PXZPE 1.5A SOIC-8 ON | 1 | U2 | PCS | 0
14 | 1133-00010-00 | 肖特基二极管ZHCS2000TA | SCHOTTKY BARRIER Diode ZHCS2000TA SOT23-6 ZETEX | 1 | D5 | PCS | 0.3
15 | 1133-00027-00 | TVS管 1KSMB30A | TVS管 1KSMB30A Reverse Stand off Voltage 25.6V | 1 | D3 | PCS | 0
16 | 1128-00014-00 | 功率电感22uH | inductor SMD 4D2 22uH +/-10% HSMRH4D28-220M | 1 | L2 | PCS | 0.3
17 | 1102-00000-00 | 电阻33R | RES SMD 0603 33R 1/16W ±1% | 6 | R4 R5 R12 R16 R6 R8 | PCS | 0.5
18 | 1101-00034-00 | 电阻1.2K | RES SMD 0402 1.2K 1/16W ±1% | 1 | R19 | PCS | 0.5
19 | 1102-00003-00 | 电阻100K | RES SMD 0603 100K 1/16W ±1% | 1 | R10 | PCS | 0.5
20 | 1102-00013-00 | 电阻10K | RES SMD 0603 10K 1/16W ±1% | 3 | R20 R33 R45 | PCS | 0.5
21 | 1101-00021-00 | 电阻133R | RES SMD 0402 133R 1/16W ±1% | 1 | R14 | PCS | 0.5
22 | 1102-00014-00 | 电阻18K | RES SMD 0603 18K 1/16W ±1% | 1 | R31 | PCS | 0.5
23 | 1102-00007-00 | 电阻1K | RES SMD 0603 1K 1/16W ±1% | 2 | R13 R25 | PCS | 0.5
24 | 1102-00016-00 | 电阻2K | RES SMD 0603 2K 1/16W ±1% | 4 | R21 R32 R44 R60 | PCS | 0.5
25 | 1101-00091-00 | 电阻51K | RES SMD 0402 51K 1/16W ±5% | 1 | R26 | PCS | 0.5
26 | 1102-00023-00 | 电阻5.1K | RES SMD 0603 5.1K 1/16W ±1% | 4 | R1 R2 R59 R11 | PCS | 0.5
27 | 1171-00080-03 | L2 Small Power PCB V2.1 | L2 Small Power PCB V2.1 FR4 2-Layer 40*54*1.2mm | 1 | PCB | PCS | 0
28 | 1133-00001-00 | 二极管BAR64-02V | Diode RF BAR64-02V SC79 Infineon | 2 | D1 D2 | PCS | 0.3
29 | 1161-00001-00 | 磁珠1K | BEAD SMD 0603 GZ1608D102TF ±25％ Sunlord | 3 | B1 B7 B8 | PCS | 0.3
30 | 1111-00074-00 | 电容1nF | CAP SMD 0402 1nF 50V C0G ±5% GRM155C1H102J | 2 | C16 C22 | PCS | 0.5
31 | 1102-00004-00 | 电阻10R | RES SMD 0603 10R 1/16W ±1% | 1 | R37 | PCS | 0.5
32 | 1131-00009-00 | 三极管S9013 | Transistor S9013 NPN SOT23 CHANGJIANG | 2 | Q2 Q10 | PCS | 0.3
33 | 1102-00009-00 | 电阻0R | RES SMD 0603 0R 1/16W ±5% | 2 | R15 R3 | PCS | 0.5
34 | 1101-00000-00 | 电阻0R | RES SMD 0402 0R 1/16W ±1% | 2 | R69 R71 | PCS | 0.5
 | 定制：张媚 |  | 确认: |  | 审核：
