quanhengwen/LK02/硬件/LK02/LK02最新硬件/BOM/Lk02带瞄准镜头 贴片BOM/2106-00001-00 LK02 Pilot Laser Board PCBA ASSY.xlsx

产 品 BOM 表
产品 编码 |  | 2106-00001-00
产品 描述 |  | LK02 Pilot Laser Board PCBA ASSY
版 本 |  | V0.1
日 期 |  | 2017-06-01
电子BOM
Item | Mileseey PN |  | Description | Qty | Reference | Unit
1 | 1101-00018-00 | 电阻5.1R | RES SMD 0402 5.1R 1/16W ±1% | 1 | R42 | PCS | 0.5
2 | 1101-00000-00 | 电阻0R | RES SMD 0402 0R 1/16W ±1% | 1 | R34 | PCS | 0.5
3 | 1101-00022-00 | 电阻3.6K | RES SMD 0402 3.6K 1/16W ±1% | 1 | R36 | PCS | 0.5
4 | 1101-00004-00 | 电阻10K | RES SMD 0402 10K 1/16W ±1% | 1 | R35 | PCS | 0.5
5 | 1101-00009-00 | 电阻15K | RES SMD 0402 15K 1/16W ±1% | 1 | R39 | PCS | 0.5
6 | 1111-00011-00 | 电容1nF | CAP SMD 0402 1nF 50V NPO ±5% | 1 | C112 | PCS | 0.5
7 | 1111-00043-00 | 电容100nF | CAP SMD 0402 100nF 50V X7R ±10% | 1 | C73 | PCS | 0.5
8 | 1131-00009-00 | 三极管S9013 | Transistor S9013 NPN SOT23 CHANGJIANG | 2 | Q7 Q8 | PCS | 0.3
9 | 1133-00001-00 | 二极管BAR64-02V | Diode RF BAR64-02V SC79 Infineon | 1 | D7 | PCS | 0.3
10 | 1135-00003-00 | 场效应管CJ3401 | FET CJ3401 SOT-23 CHANGJIANG | 1 | Q5 | PCS | 0.3
11 | 1171-00236-01 | LK02 Pilot Laser Board PCB V1.1 | LK02 Pilot Laser Board PCB V1.1 FR4 2-Layer 40*8.5*1.0mm | 1 | PCB | PCS | 0
12 | 1221-00023-00 | 5PIN排插座 | Connector SMD 5PIN Pitch 0.5mm up flip lock | 1 | X1 | PCS | 0
13 | 4506-00001-00 | 加工费 2106-00001-00 | 加工费 LK02 Pilot Laser Board PCBA | 1 |  | PCS | 0
 | 定制：张媚 |  | 确认: |  | 审核：
