quanhengwen/LK02/硬件/LK02/LK02最新硬件/BOM/Lk02带瞄准镜头 贴片BOM/2107-00002-00 LK02 Power CON Board PCBA TTL.xlsx

产 品 BOM 表
产品 编码 |  | 2107-00002-00
产品 描述 |  | LK02 Power CON Board PCBA TTL
版 本 |  | V0.1
日 期 |  | 2017-03-03
电子BOM
Item | Mileseey PN | Description | Qty | Reference | Unit
1 | 1171-00237-00 | LK02 Power CON PCB V0.1 FR4 2-Layer 29x15.4*1.2mm | 1 | PCB | PCS | 0
2 | 1221-00026-00 | 9PIN排插座 立贴 电源线插座 不带锁 间距1.25mm | 1 | CON1 | PCS | 0
3 | 4504-00002-00 | 加工费 LK02 Power CON PCBA | 1 |  | PCS | 0
 | 定制：张媚 | 确认: |  | 审核：
