quanhengwen/LK02/硬件/LK02/LK02最新硬件/BOM/Lk02带瞄准镜头 贴片BOM/2108-00000-LK02 LK02 Receiver board PCBA Assy.xlsx

产 品 BOM 表
产品 编码 |  | 2108-00000-LK02
产品 描述 |  | LK02 Receiver board PCBA Assy
版 本 |  | V0.1
日 期 |  | 2016-11-19
电子BOM
Item | Mileseey PN | Description | Qty | Reference | Unit
1 | 1111-00075-00 | CAP SMD 0402 100nF 25V X5R ±10% | 11 | C1 C3 C4 C7 C8 C9 C10 C16 C17 C18 C19 | PCS | 0.5
2 | 1111-00086-00 | CAP SMD 0402 0.5pF 50V NPO ±0.25pF | 1 | C6 | PCS | 0.5
3 | 1111-00074-00 | CAP SMD 0402 1nF 50V C0G ±5% GRM155C1H102J | 4 | C2 C11 C12 C13 | PCS | 0.5
4 | 1114-00008-00 | CAP SMD 1206 10nF 1KV ±10% TCC | 2 | C14 C15 | PCS | 0.5
5 | 1116-00002-00 | 钽电容 CAP SMD 1210 47uF 10V ±20% B类 | 2 | C5 C20 | PCS | 0.5
6 | 1101-00002-00 | RES SMD 0402 100K 1/16W ±1% | 1 | R8 | PCS | 0.5
7 | 1101-00004-00 | RES SMD 0402 10K 1/16W ±1% | 2 | R4 R9 | PCS | 0.5
8 | 1101-00013-00 | RES SMD 0402 20K 1/16W ±1% | 1 | R3 | PCS | 0.5
9 | 1101-00041-00 | RES SMD 0402 270R 1/16W ±1% | 1 | R7 | PCS | 0.5
10 | 1101-00035-00 | RES SMD 0402 2K 1/16W ±1% | 1 | R10 | PCS | 0.5
11 | 1101-00099-00 | RES SMD 0402 3K 1/16W ±1% | 1 | R1 | PCS | 0.5
12 | 1101-00025-00 | RES SMD 0402 5.1K 1/16W ±1% | 1 | R6 | PCS | 0.5
13 | 1101-00103-00 | RES SMD 0402 523R 1/16W ±1% | 1 | R5 | PCS | 0.5
14 | 1101-00064-00 | RES SMD 0402 680R 1/16W ±1% | 1 | R11 | PCS | 0.5
15 | 1121-00000-00 | inductor SMD 0402 220nH SDCL1005CR22JTDF Sunlord | 6 | L1 L2 L3 L4 L5 L6 | PCS | 0.3
16 | 1141-00174-00 | IC MAX6605MXK+T SC70-5 Maxim | 1 | U1 | PCS | 0
17 | 1141-00175-00 | IC OPA657NB/250 SOT23-5 Voltage Feedback TI | 1 | U5 | PCS | 0
18 | 1141-00176-00 | IC OPA695IDBVT SOT23-6 Current Feedback TI | 1 | U6 | PCS | 0
19 | 1141-00177-00 | IC AD603ARZ SOIC-8 ADI | 2 | U3 U4 | PCS | 0
20 | 1213-00011-00 | APD AD500-9 LCC6.1F | 1 | V1 | PCS | 0
21 | 1221-00032-00 | SMD 10PIN立式 间距0.5mm | 1 | X1 | PCS | 0
22 | 1171-00227-00 | LK02 Receiver PCB V0.1 FR4 4-Layer 24.6*23.0*1.2mm | 1 |  | PCS | 0
23 | 4508-00001-00 | 加工费 LK02 Receiver board PCBA | 1 |  | PCS | 0
 | 定制：张媚 | 确认: |  | 审核：
