quanhengwen/LK02/硬件/LK02/LK02最新硬件/BOM/Lk02带瞄准镜头 贴片BOM/2108-00001-LK02 LK02 Transmit board PCBA Assy.xlsx

产 品 BOM 表
产品 编码 |  | 2108-00001-LK02
产品 描述 |  | LK02 Transmit board PCBA Assy
版 本 |  | V0.1更新加工费名称171010
日 期 |  | 2017-06-01
电子BOM
Item | Mileseey PN |  | Description | Qty | Reference | Unit
1 | 1111-00018-00 | 电容470pF | CAP SMD 0402 470pF 50V X7R ±10% | 1 | C2 | PCS | 0.5
2 | 1111-00004-00 | 电容10nF | CAP SMD 0402 10nF 50V X5R ±10% | 1 | C3 | PCS | 0.5
3 | 1114-00009-00 | 电容1nF | CAP SMD 1206 1nF 2KV X7R ±10% | 1 | C1 | PCS | 0.5
4 | 1101-00077-00 | 电阻100R | RES SMD 0402 100R 1/16W ±1% | 2 | R2 R7 | PCS | 0.5
5 | 1101-00003-00 | 电阻10R | RES SMD 0402 10R 1/16W ±1% | 1 | R6 | PCS | 0.5
6 | 1101-00035-00 | 电阻2K | RES SMD 0402 2K 1/16W ±1% | 1 | R4 | PCS | 0.5
7 | 1101-00025-00 | 电阻5.1K | RES SMD 0402 5.1K 1/16W ±1% | 1 | R1 | PCS | 0.5
8 | 1101-00015-00 | 电阻51R | RES SMD 0402 51R 1/16W ±1% | 1 | R3 | PCS | 0.5
9 | 1131-00014-00 | 晶体管(BJT) - 单路 | TRANS PNP -100V -3500MA 125MHz E-LINE,ZTX953 TO-92 | 1 | V1 | PCS | 0.3
10 | 1131-00015-00 | 晶体管(BJT) - 单路 | TRANS NPN 100V-4A 130MHz MED E-LINE,ZTX853 TO-92 | 1 | V3 | PCS | 0.3
11 | 1133-00026-00 | 二极管BAT46W | diode BAT46W SOD123 DIODES | 2 | D1 D2 | PCS | 0.3
12 | 1141-00178-00 | 缓冲器SN74LVC2G34DBVT | IC SN74LVC2G34DBVT SOT23-6 TI | 1 | U1 | PCS | 0
13 | 1221-00032-00 | 10PIN双排插座 | SMD 10PIN立式 间距0.5mm | 1 | X1 | PCS | 0
14 | 1171-00228-00 | LK02 Transmit PCB | LK02 Transmit PCB V0.1 FR4 4-Layer 24.6*20.0*1.2mm | 1 |  | PCS | 0
15 | 4508-00000-00 | 加工费 2108-00001-LK02 | 加工费 LK02 Transmit board PCBA | 1 |  | PCS | 0
16 | 1211-00015-00 | 激光管 SPL_PL90-3 | Laser diode SPL_PL90-3 75W | 1 |  | PCS | 0
17 | 1101-00000-00 | 电阻0R | RES SMD 0402 0R 1/16W ±1% | 1 | R5 | PCS | 0.5
 | 定制：张媚 |  | 确认: |  | 审核：
