quanhengwen/LK02/硬件/LK02/LK02最新硬件/BOM/Lk02带瞄准镜头 贴片BOM/2500-00014-00 LK02 LASER ORGAN ASSY 带瞄准镜头_171010.xlsx

产 品 BOM 表
产品 编码 |  | 2500-00014-00
产品 描述 |  | LK02 LASER ORGAN ASSY 带瞄准镜头
版 本 |  | V0.1
日 期 |  | 2017-10-10
光学组件
Item | Mileseey PN |  | Description | Qty | Reference | Unit
1 | 1408-00008-00 | Lk02接收胶合透镜 | Lk02接收胶合透镜 材质玻璃 规格：Φ21*9.89mm 透明 焦距(f=38.8) | 1 |  | PCS
2 | 1409-00006-00 | Lk02发射胶合透镜 | Lk02发射胶合透镜 材质玻璃 规格：Φ19*9.89mm 透明 焦距(f=38.8) | 1 |  | PCS
3 | 1421-00012-00 | LK02 保护玻璃 | LK02 保护玻璃 规格φ8*2mm | 1 |  | PCS
4 | 1707-00023-01 | LK02有角面挡板V0.1 | LK02有角面挡板V0.1 HEAD BOARD SANDBLASTING OXIDATION AL 83.25*37.4*19 面挡板与光机构一体 带防水功能 | 1 |  | PCS
5 | 1722-00000-00 | LK02 发射调节支架 | LK02 发射调节支架 规格25*21.5*17mm、调节内孔直径12mm/铝材机加工、攻牙/表面样机氧化黑色 | 1 |  | PCS
6 | 1722-00001-00 | LK02 接收调节支架 | LK02 接收调节支架 规格25*21.5*15.9mm、调节内孔直径16mm/铝材机加工、攻牙/表面样机氧化黑色 | 1 |  | PCS
7 | 1701-00028-00 | 内六角M2*2.5螺丝 | SCREW 内六角机械牙M2*2.5 银色 | 4 | 锁接收和发射调节支架 | PCS
8 | 1506-00017-00 | PVC 发射板垫片 | PVC 发射板垫片 黑色 24*19*1mm 内孔直径12mm 单面3M背胶 | 2 | 接收板、发射板各使用一个 | PCS
9 | 1212-00014-00 | 塑料镜片外光路模组 针脚式 650nm 友嘉LD 瑞欣峰 | Laser Visible plastic module UOC650nm 5mW Ruixinfeng | 1 | D5 | PCS
10 | 2106-00001-00 | LK02 Pilot Laser Board PCBA ASSY | LK02 Pilot Laser Board PCBA ASSY | 1 |  | PCS
11 | 1701-00021-00 | 螺丝PM2*3.5 银色 | SCREW PM2*3.5 ROUND HEAD MACHINE STIFFENING SILVER | 2 |  | PCS
 | 定制： |  | 确认: |  | 审核：
