quanhengwen/LK02/硬件/LK02/LK02最新硬件/电源板/DXF/LK02_POWER_V1.0-531.dxf

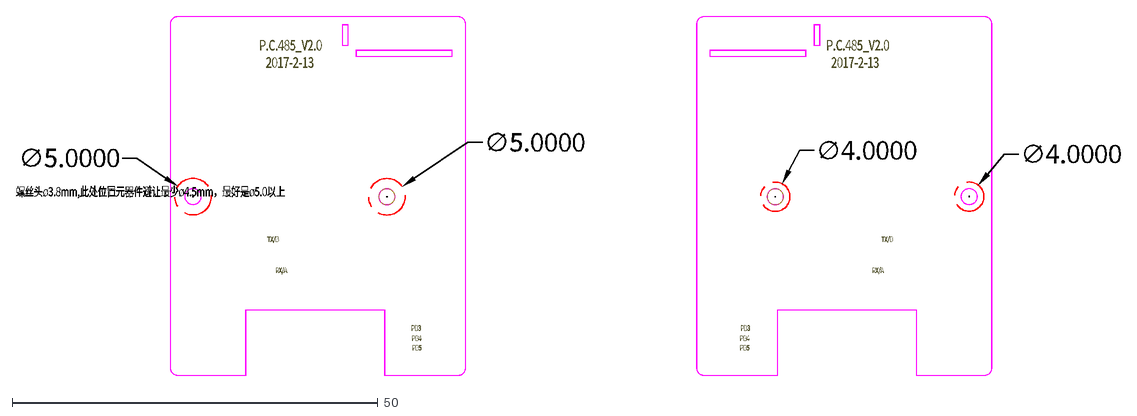
[picture p6: CAD file, 2019-10-28]
硬件/LK02/LK02最新硬件/电源板/DXF/LK02_POWER_V1.0-531.dxf
P.C.485_V2.0
PB3
PB4
PB5
TX/B
RX/A
2017-2-13
∅5.0000
螺丝头ø3.8mm,此处位置元器件避让最少ø4.5mm，最好是ø5.0以上
∅4.0000
