quanhengwen/LK02/硬件/MB01/PCB/layout_MB01_2v3_20160506.dxf

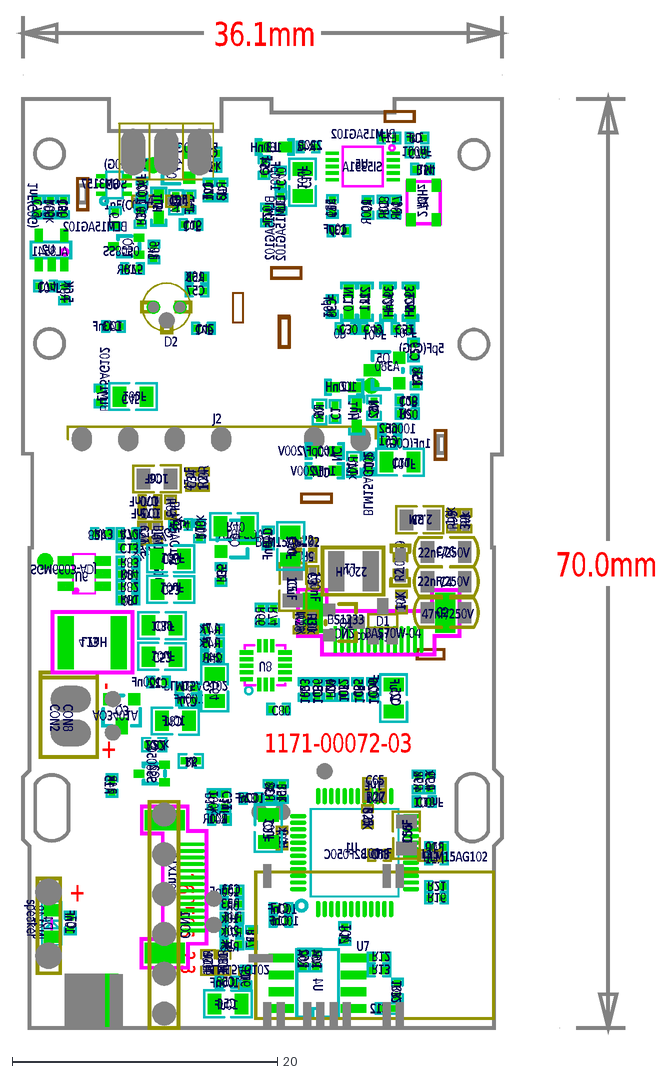
[picture p7: CAD file, 2019-10-28]
硬件/MB01/PCB/layout_MB01_2v3_20160506.dxf
36.1mm
70.0mm
2.3
-
+
160506
1171-00072-03
con1x14
CON1
CON2
J2
CON8
BAS70W-04
D1
C12
100nF
C16
C17
C18
C26
C28
5pF(C0G)
C29
C3
1uF
C31
C32
100pF
C33
47pF
C34
C35
C36
C40
C41
C43
1nF(C0G)
C44
C46
C9
C57
C61
C62
10nF
C7
C70
C71
C75
C77
C78
IN4148
D4
4.7uH
L13
220k
R22
100R
R26
R31
1k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
