quanhengwen/LK02/(list of files, cad)

Other CAD files:
硬件/LK02/LK02第二次试产/发射板/43680502HMC5883PADXL345PL1602/HMC5883+ADXL345+L1602/main.OBJ
硬件/LK02/LK02第二次试产/发射板/43680502HMC5883PADXL345PL1602/HMC5883+ADXL345+L1602/STARTUP.OBJ
硬件/LK02/LK02第二次试产/发射板/43680502HMC5883PADXL345PL1602/HMC5883+ADXL345+L1602/key.OBJ
硬件/LK02/LK02第二次试产/发射板/43680502HMC5883PADXL345PL1602/HMC5883+ADXL345+L1602/1602.OBJ
硬件/LK02/LK02第二次试产/发射板/43680502HMC5883PADXL345PL1602/HMC5883+ADXL345+L1602/HMC5883.OBJ
硬件/LK02/LK02第二次试产/发射板/43680502HMC5883PADXL345PL1602/HMC5883+ADXL345+L1602/delay.OBJ
硬件/LK02/LK02第二次试产/发射板/43680502HMC5883PADXL345PL1602/HMC5883+ADXL345+L1602/ADXL345.OBJ
