quanhengwen/LK02/硬件/LK02 3V0/LK02_3V0/MAIN_3V0/LK02 Main board 3V0_20170815.pdf

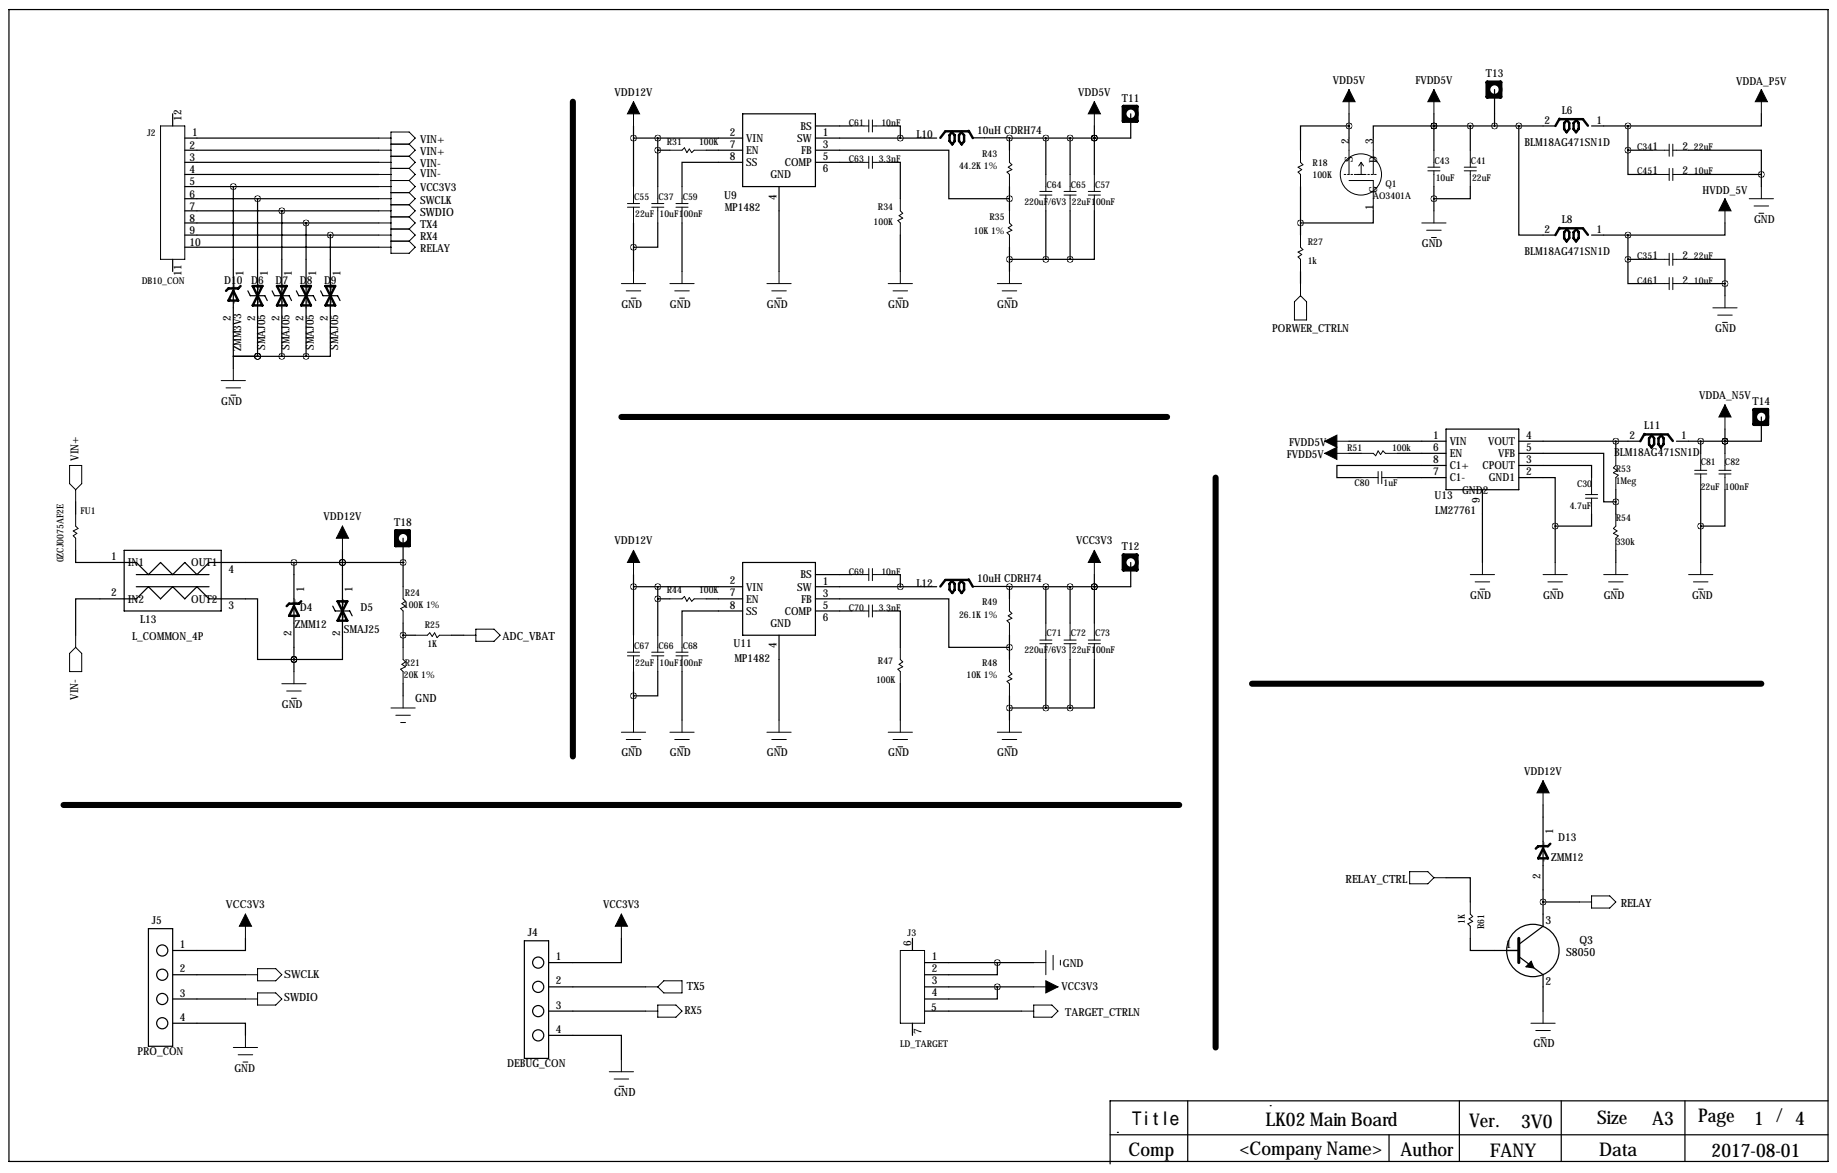
[picture p12: page 1]

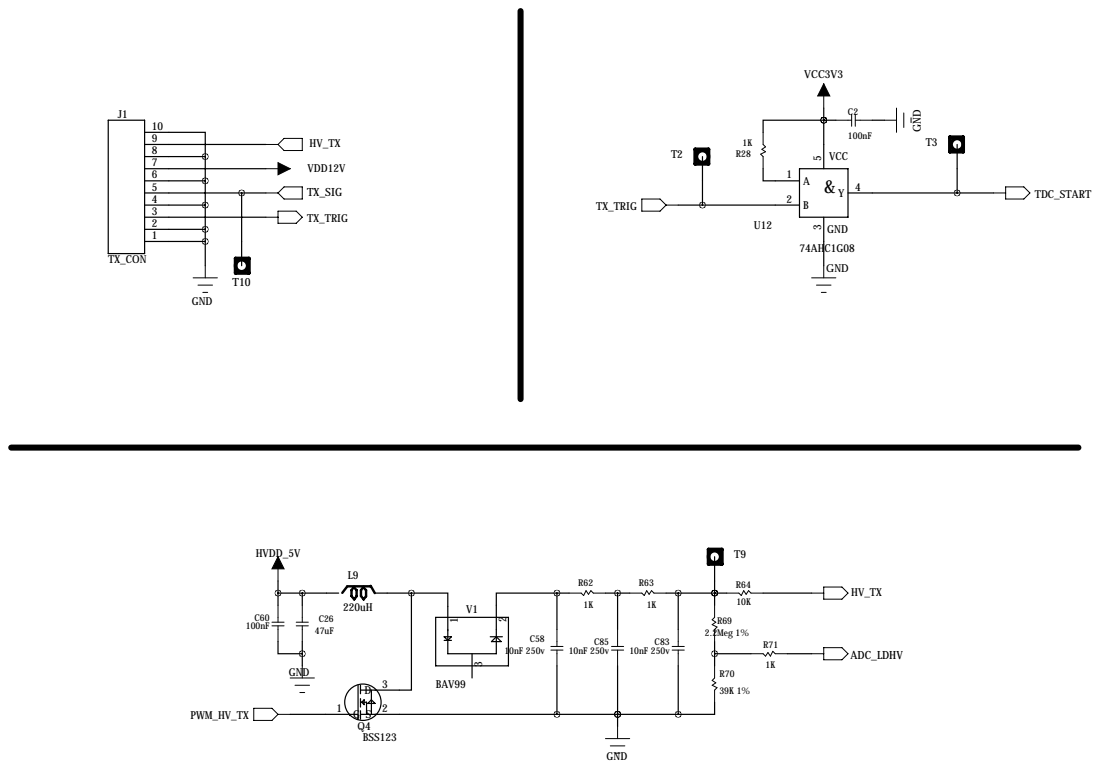
[picture p13: page 2]

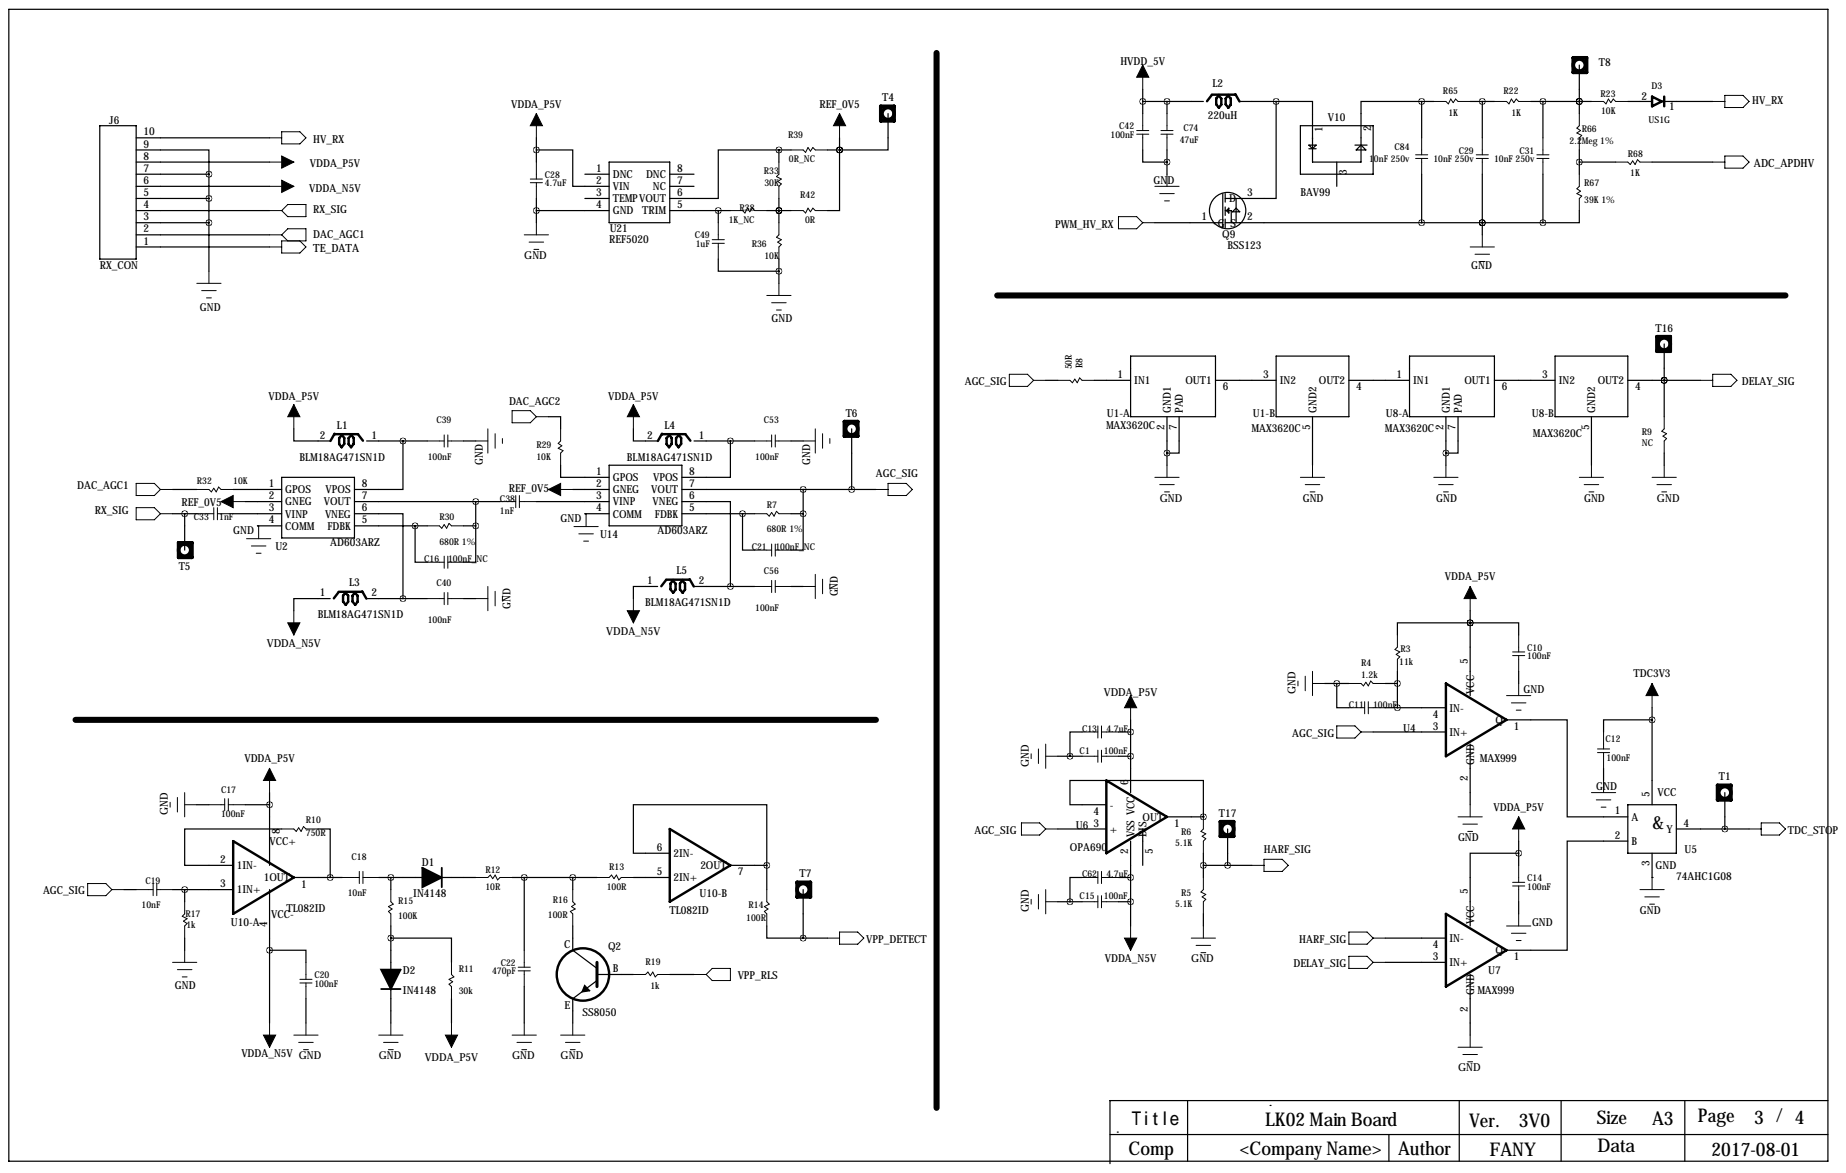
[picture p14: page 3]

GND | GND | GND SWCLK SWDIO

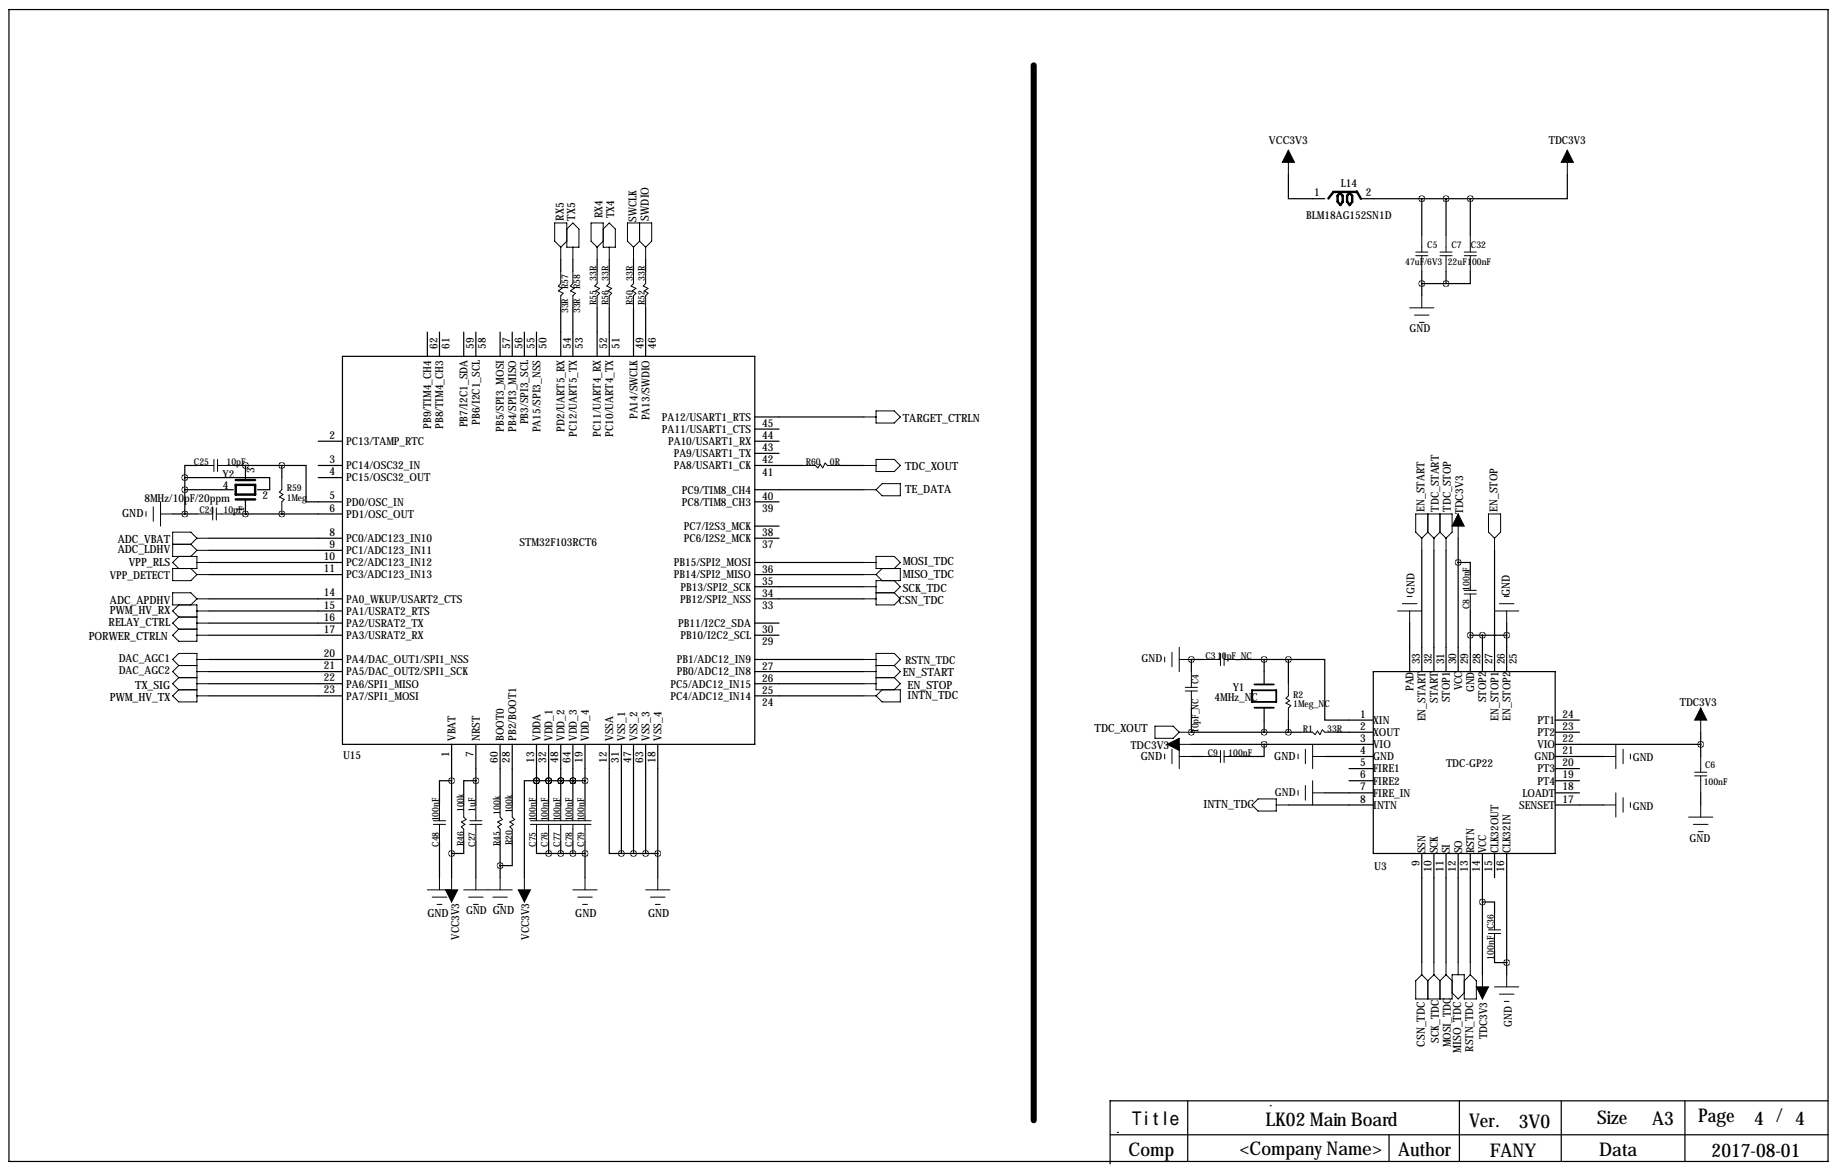
[picture p15: page 4]

25 EN_STOP2 26 EN_STOP1 27 STOP2 28 GND 29 VCC 30 STOP1 31 START 32 EN_START 33 PAD

9 SSN 10 SCK 11 SI 12 SO 13 RSTN 14 VCC 15 CLK32OUT 16 CLK32IN
