quanhengwen/LK02/硬件/LK02 3V0/LK02_3V0/MAIN_3V0/VALUE_MAIN_3V0.pdf

# LK02 Main board 3V0.pcb

47uF

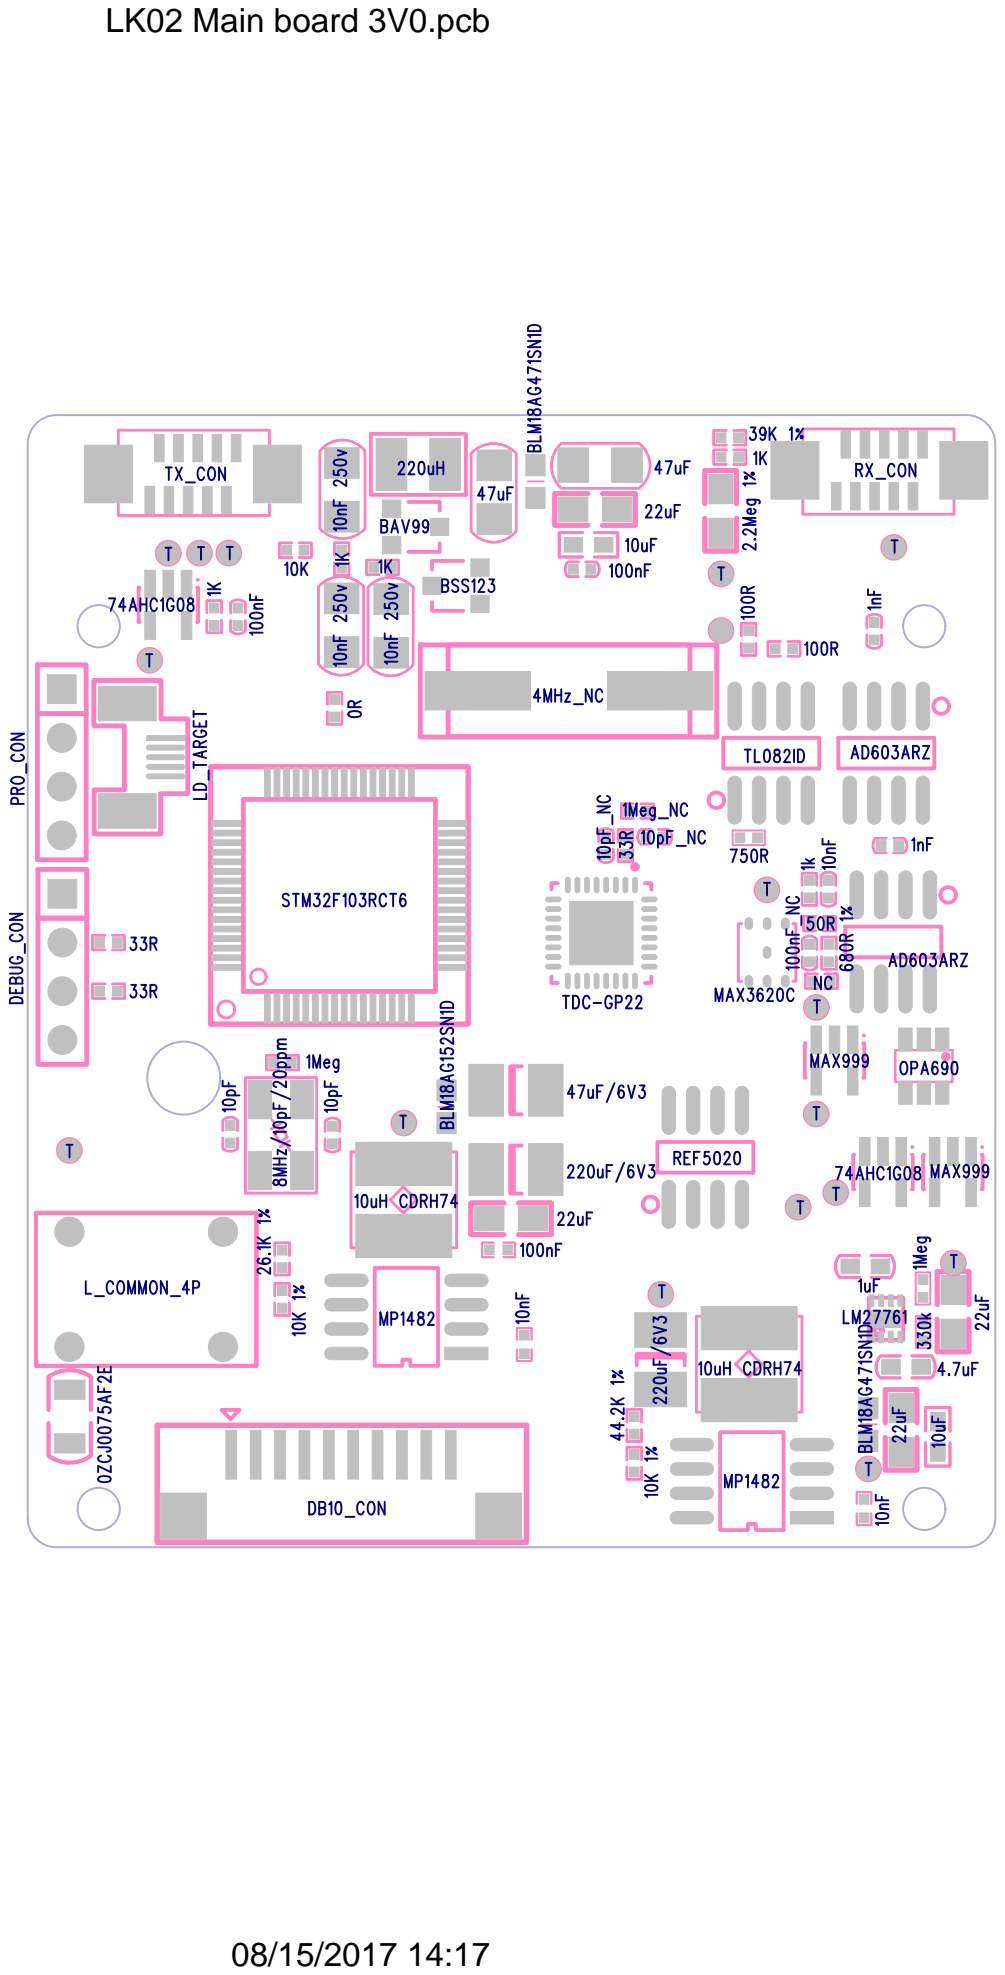
[picture p16: page 1]

39K 1%
1K

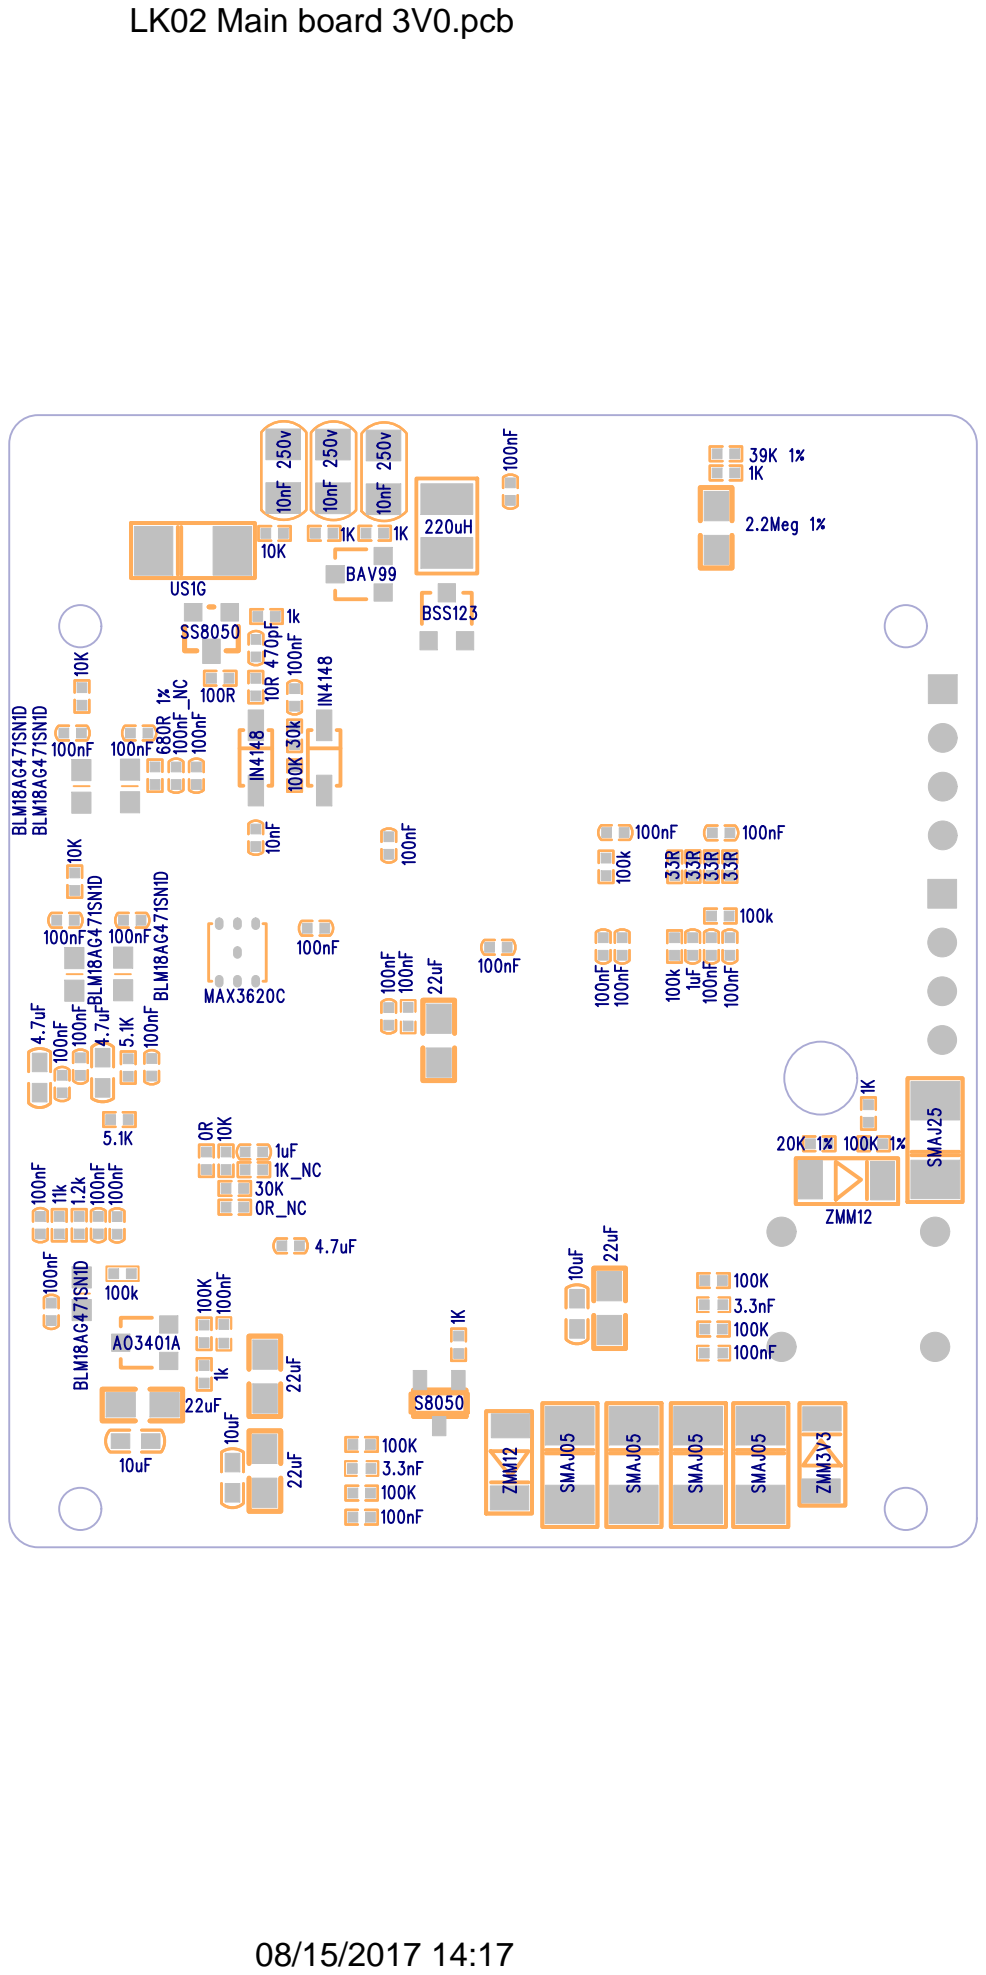
[picture p17: page 2]

C26

C74

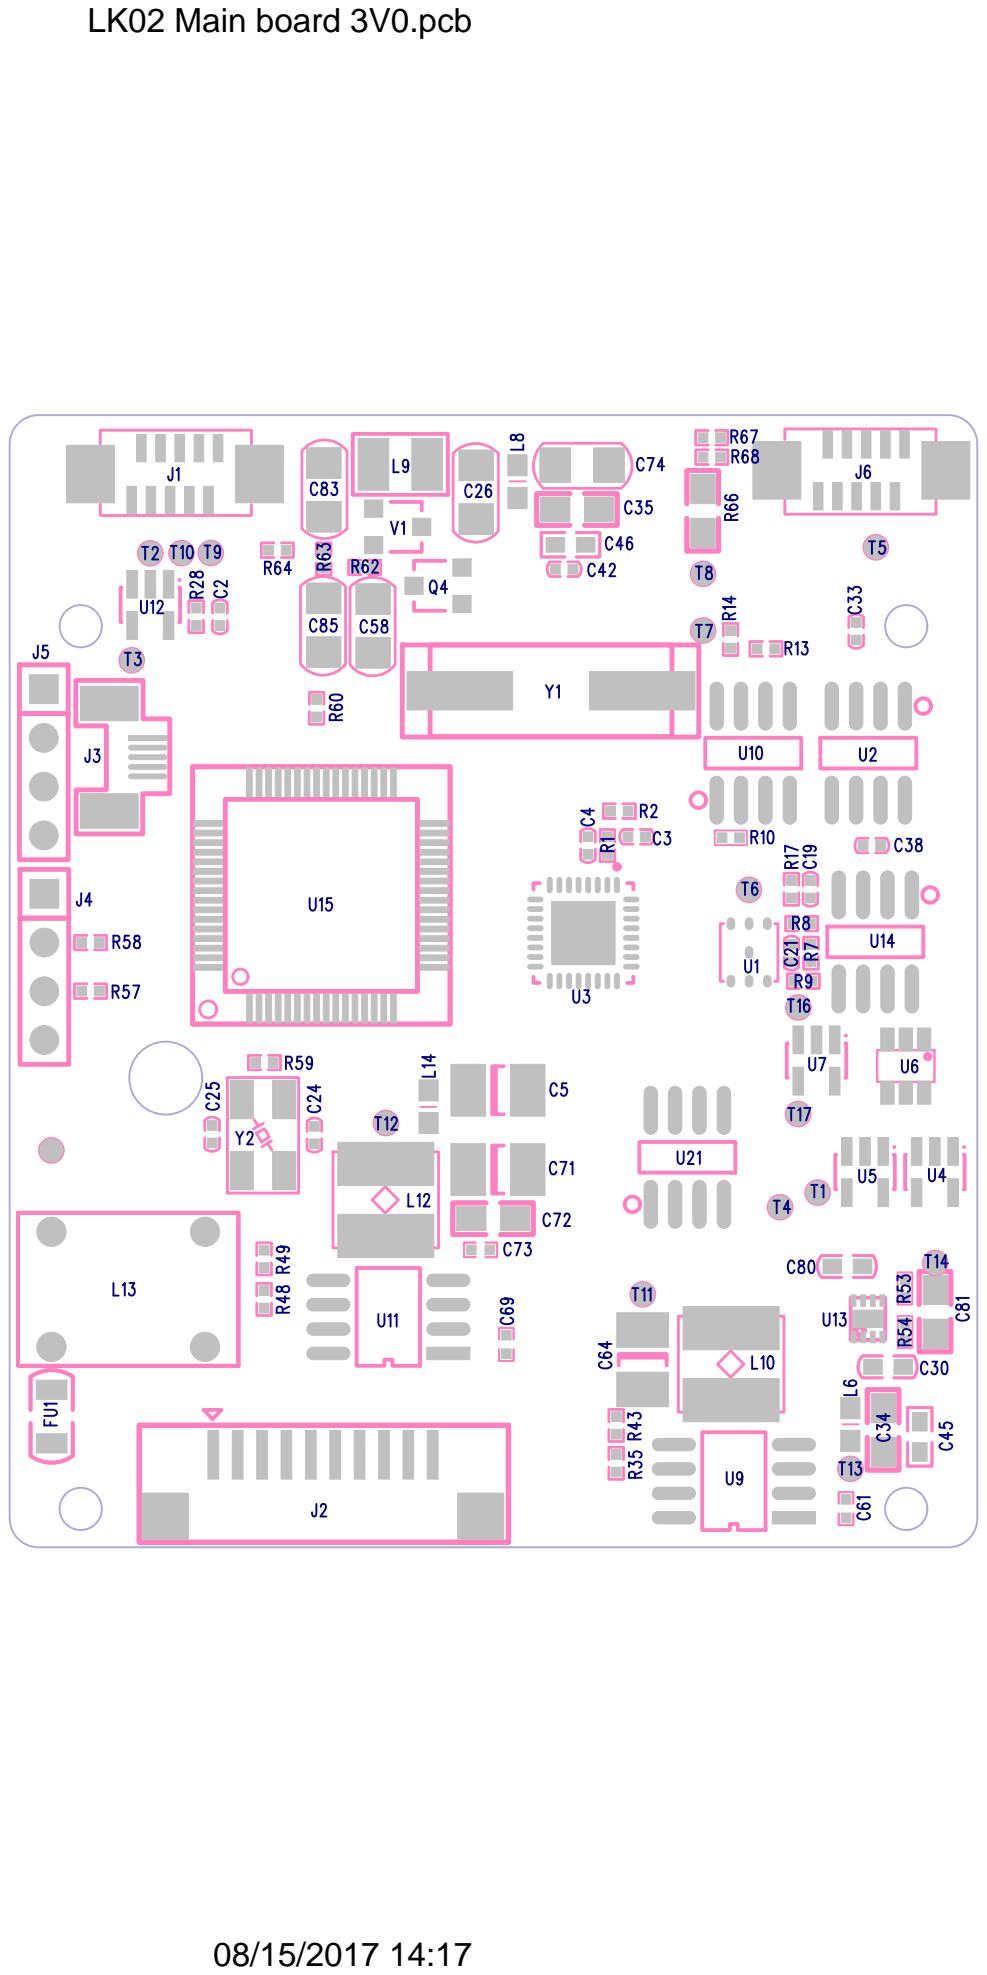
[picture p18: page 3]

# C31 C29 C84

R70

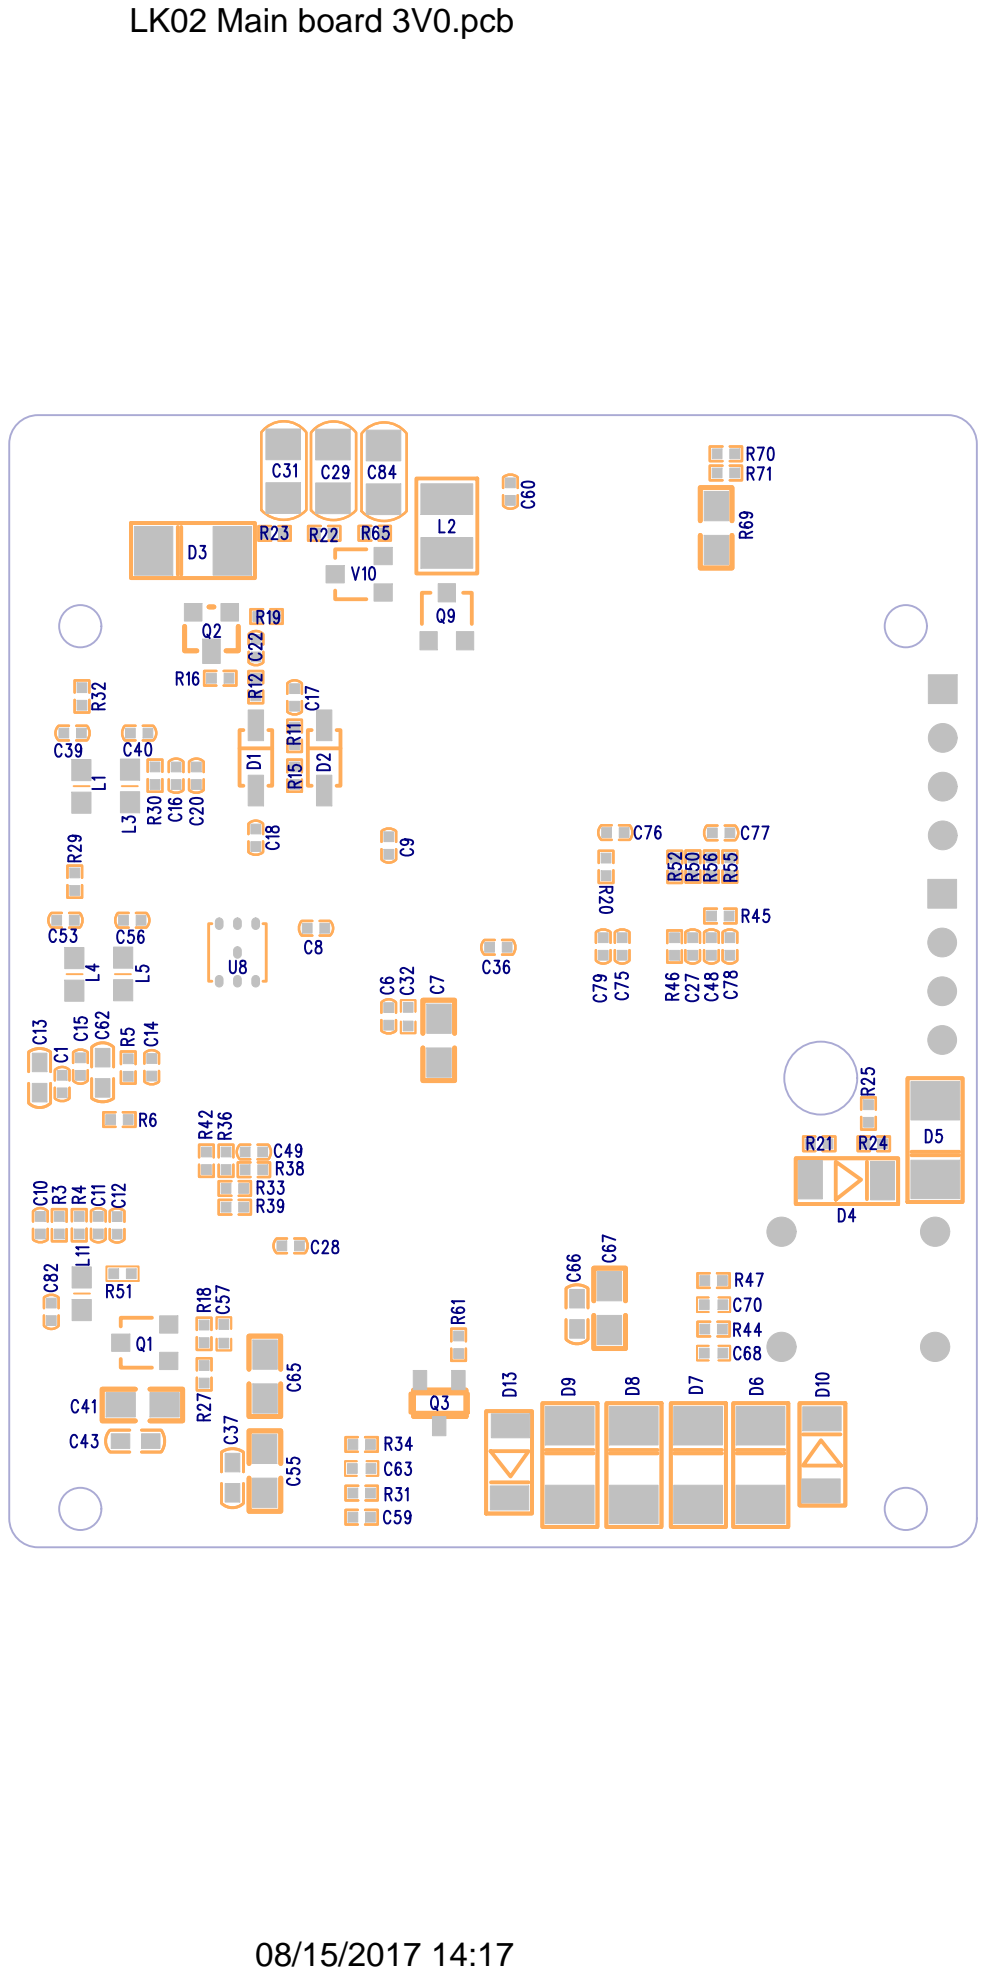
[picture p19: page 4]
