quanhengwen/LK02/硬件/LK02/LK02最新硬件/电源板/LK02_POWER_V1.0.pdf

D

6 | 5 | 4 | 3 | 2 | 1

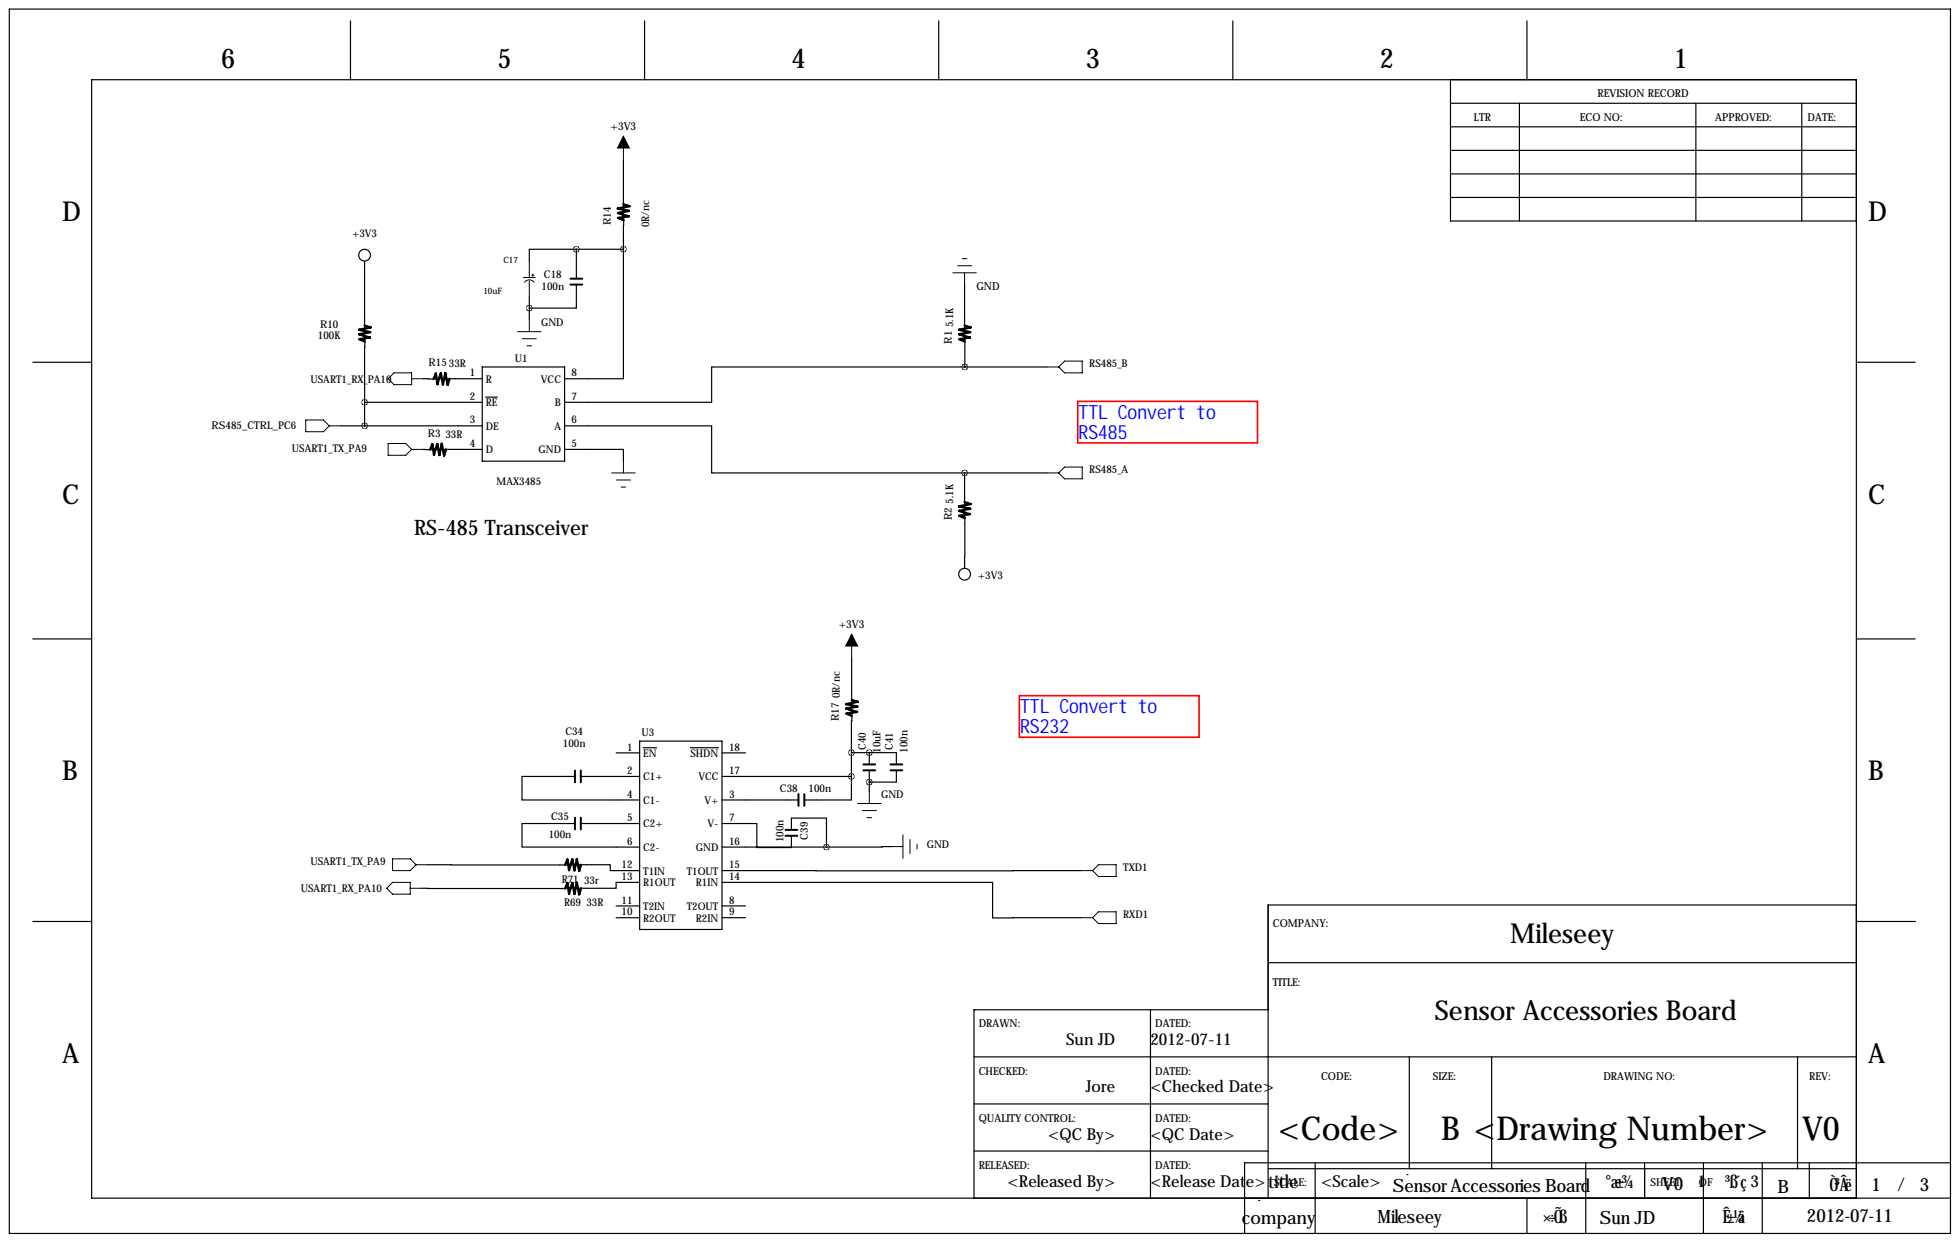
[picture p20: page 1]

REVISION RECORD

LTR | ECO NO: | APPROVED: | DATE:

DRAWN: Sun JD | DATED: 2012-07-11

CHECKED: Jore | DATED: <Checked Date> | CODE: <Code> | SIZE: B <Drawing Number> | DRAWING NO: | REV: V0

QUALITY CONTROL: <QC By> | DATED: <QC Date>

RELEASED: <Released By> | DATED: <Release Date>

SCALE: | <Scale> Sensor Accessories Board | 1 SHEET: V0 OF | 3

# LK02µçÔ´°åÐÞ¸Ä£º 1£¬¼ÌµçÆ÷Çý¶¯¹¦ÄÜÉ¾³ýÍ¬Ê±É¾³ýHET£¬¿ÉÊ¹ÓÃ±¨¾¯Êä³öÌæ´ú

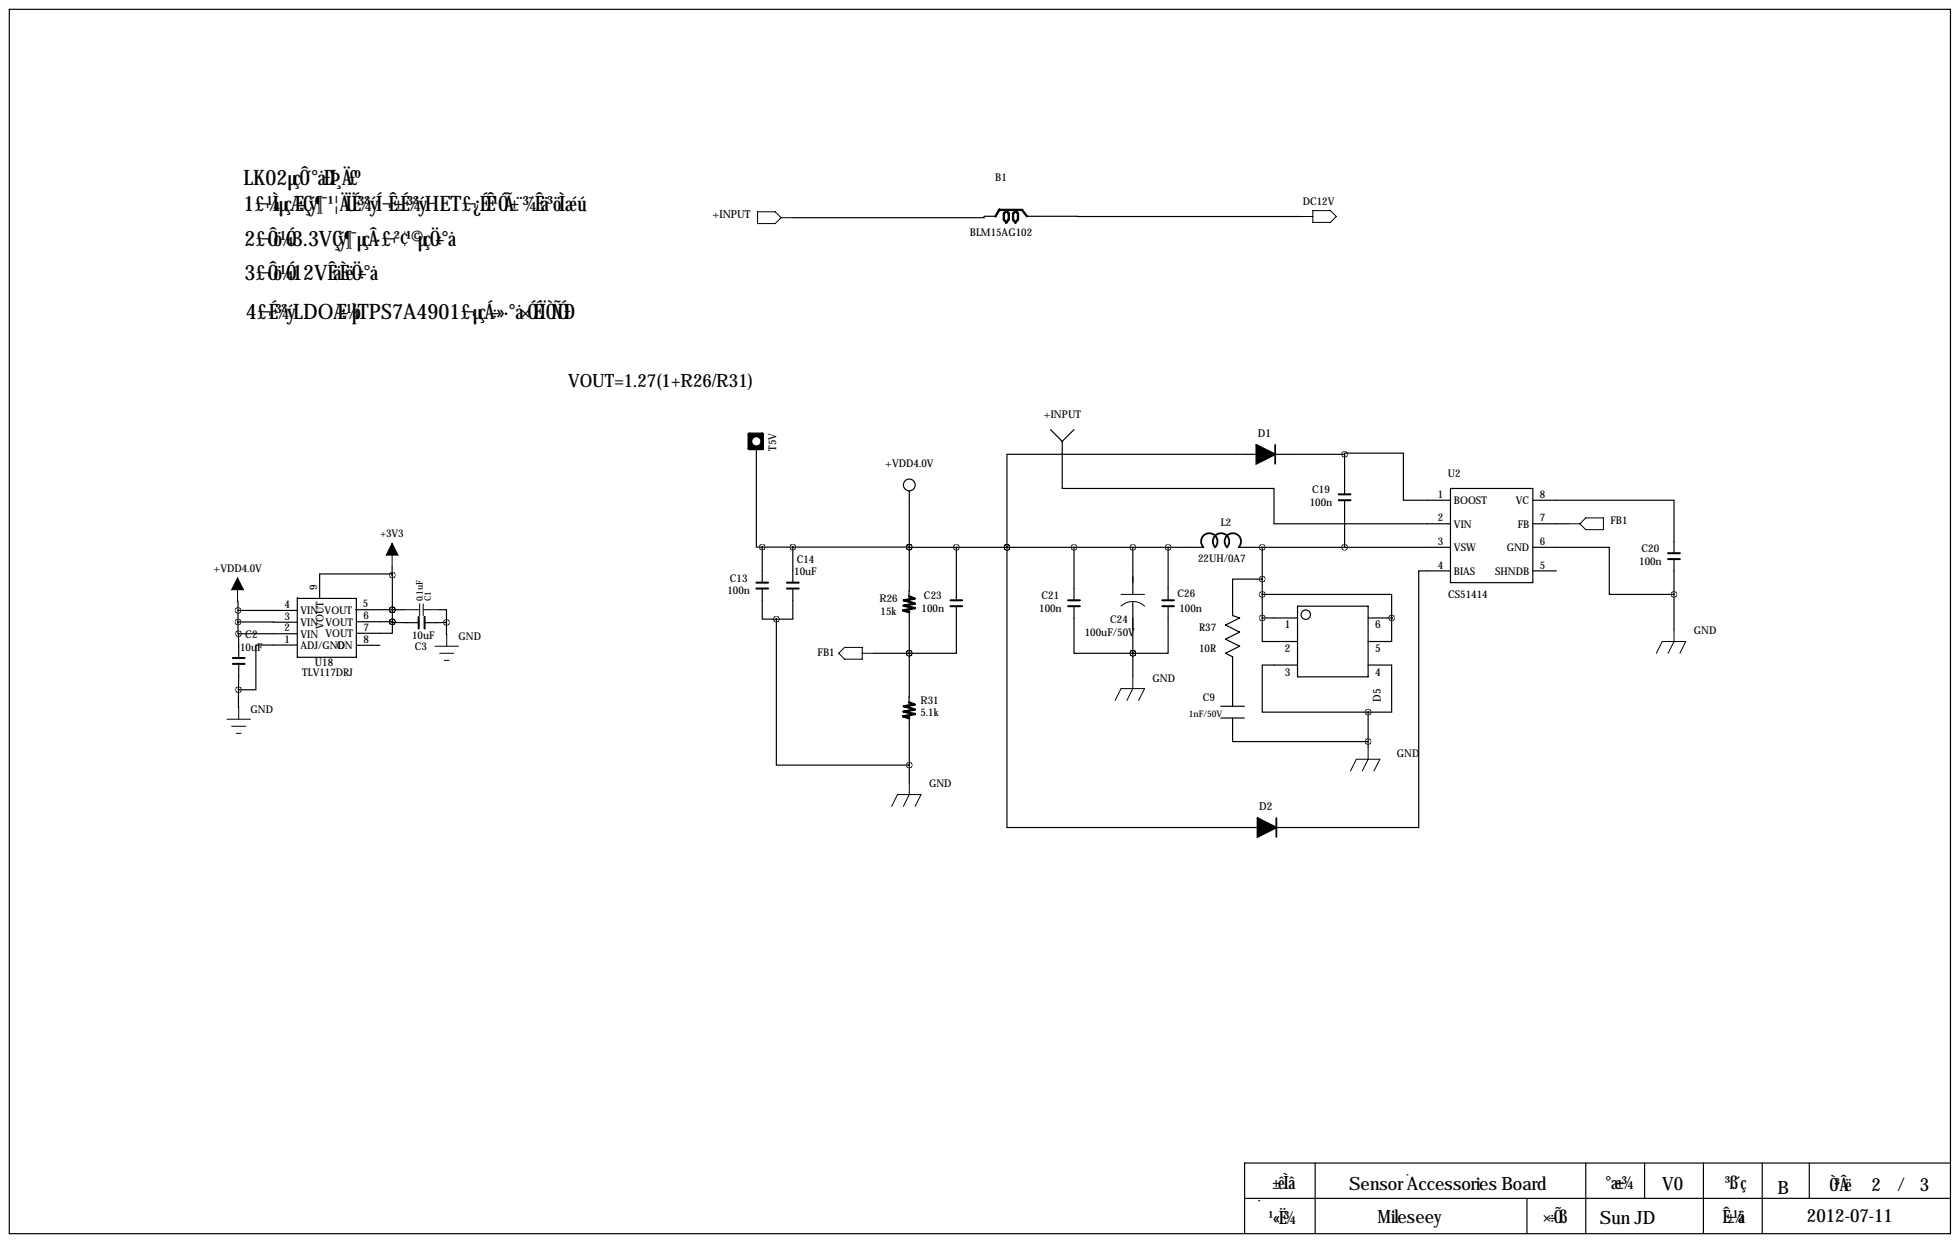
[picture p21: page 2]

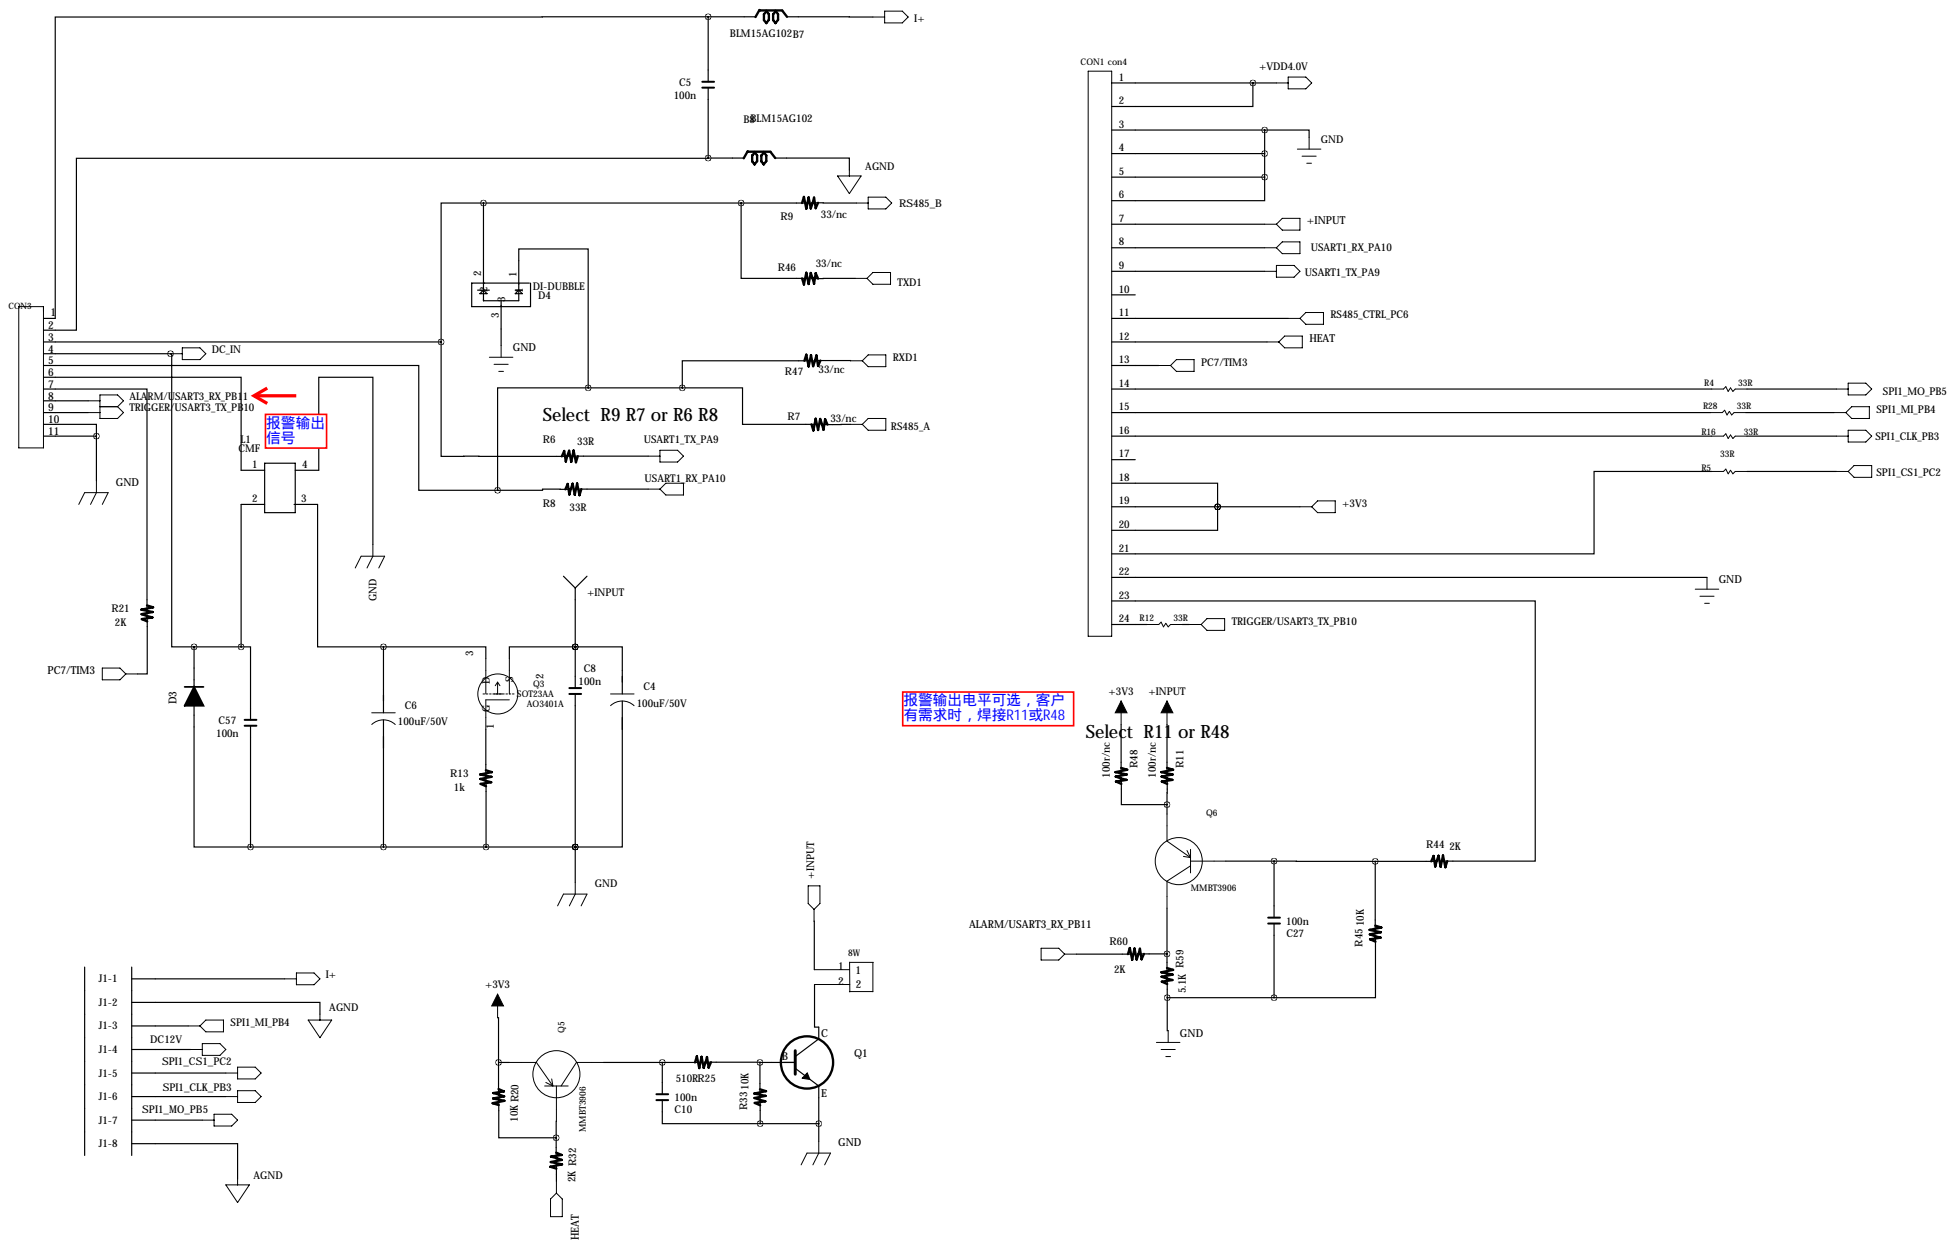
[picture p22: page 3]
