quanhengwen/LK02/硬件/LK02/LK02第三次试产/电源板/AD5420_POWER_V2.1.pdf

D

6 | 5 | 4 | 3 | 2 | 1

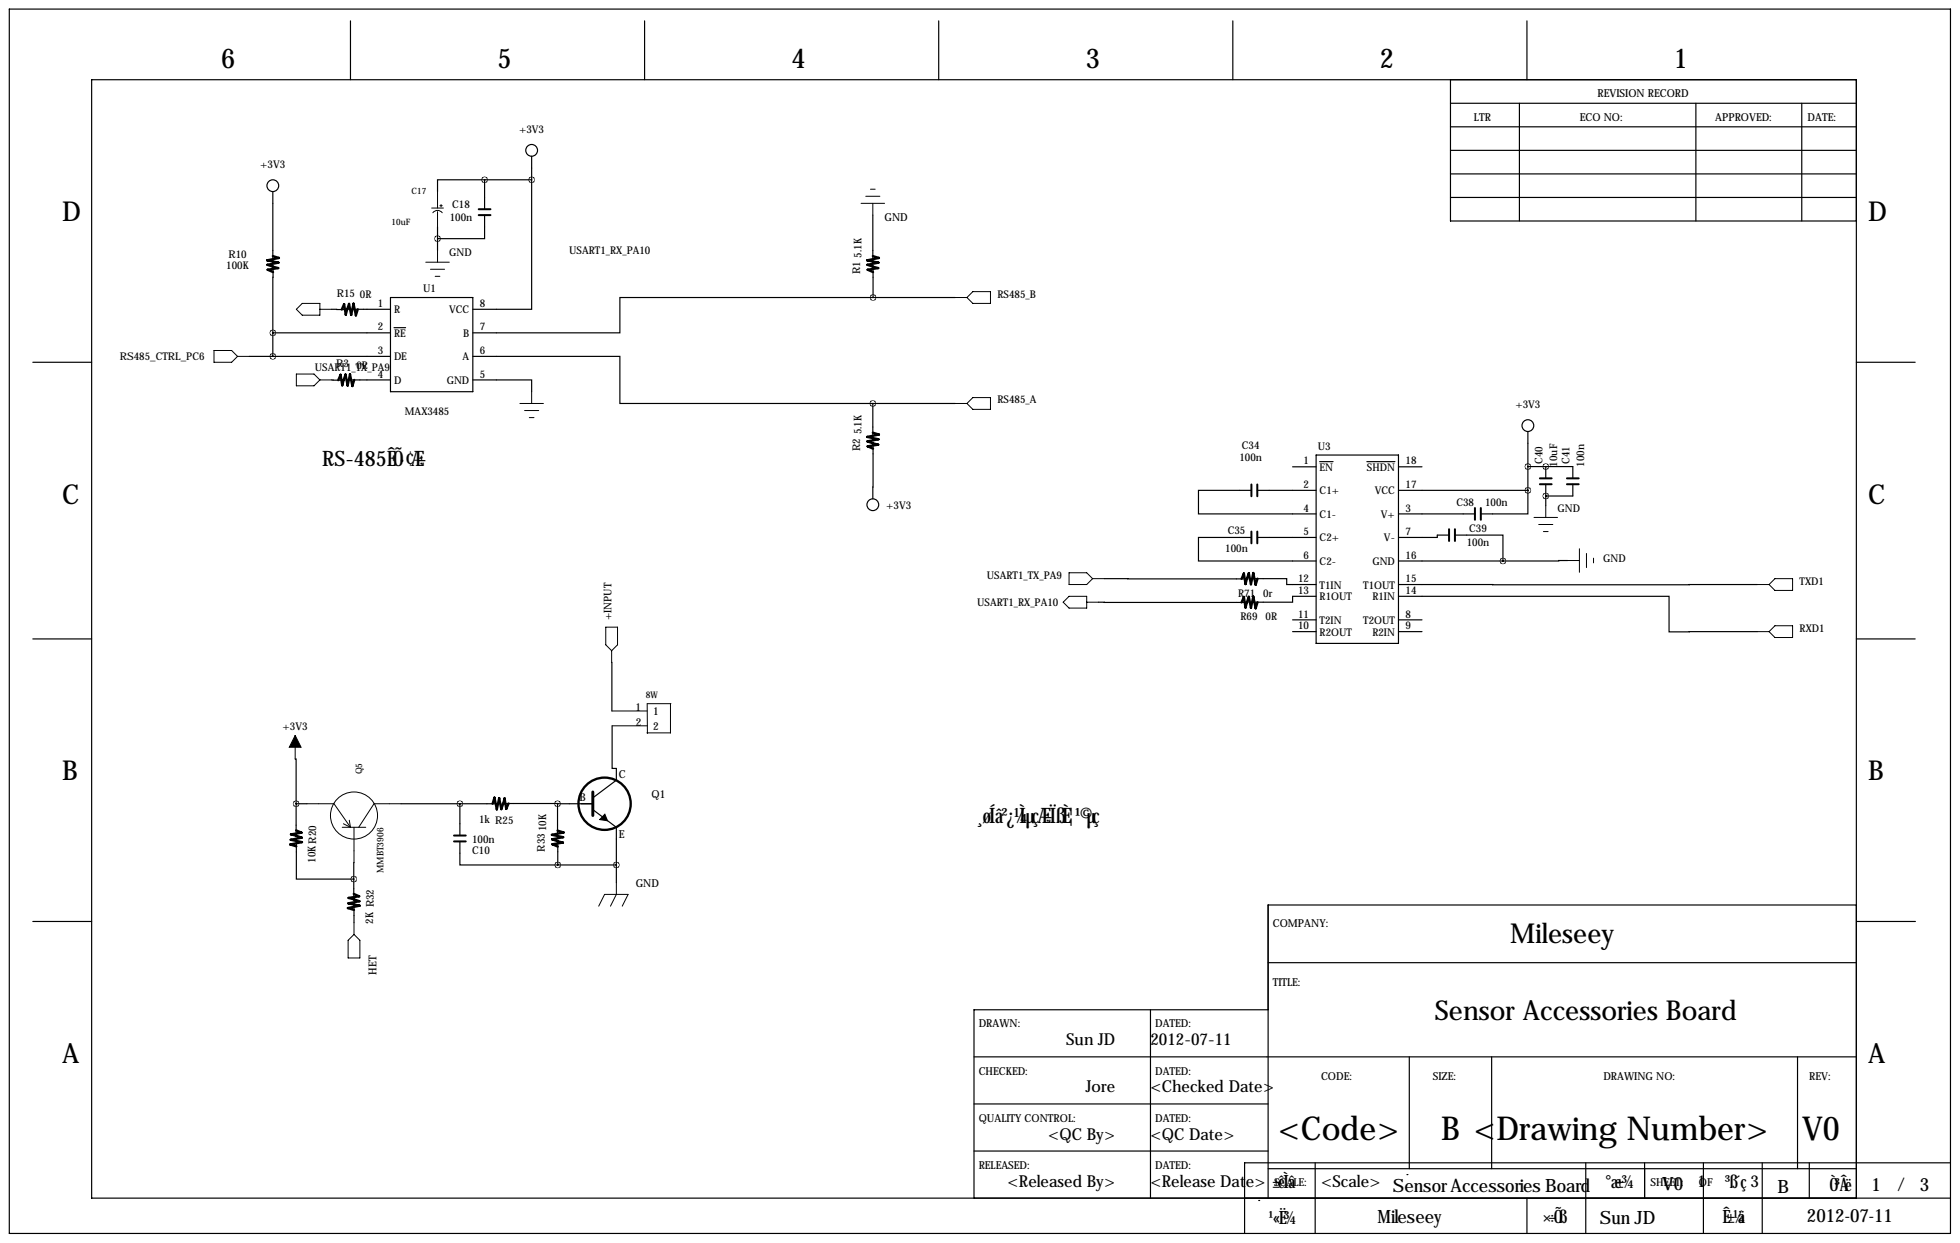
[picture p23: page 1]

+3V3 | REVISION RECORD

LTR | ECO NO: | APPROVED: | DATE:

¸øÍâ²¿¼ÌµçÆ÷ÏßÈ¦¹©µç

DRAWN: Sun JD | DATED: 2012-07-11

CHECKED: Jore | DATED: <Checked Date> | CODE: <Code> | SIZE: B <Drawing Number> | DRAWING NO: | REV: V0

QUALITY CONTROL: <QC By> | DATED: <QC Date>

RELEASED: <Released By> | DATED: <Release Date>

SCALE: | <Scale> Sensor Accessories Board | 1 SHEET: V0 OF | 3

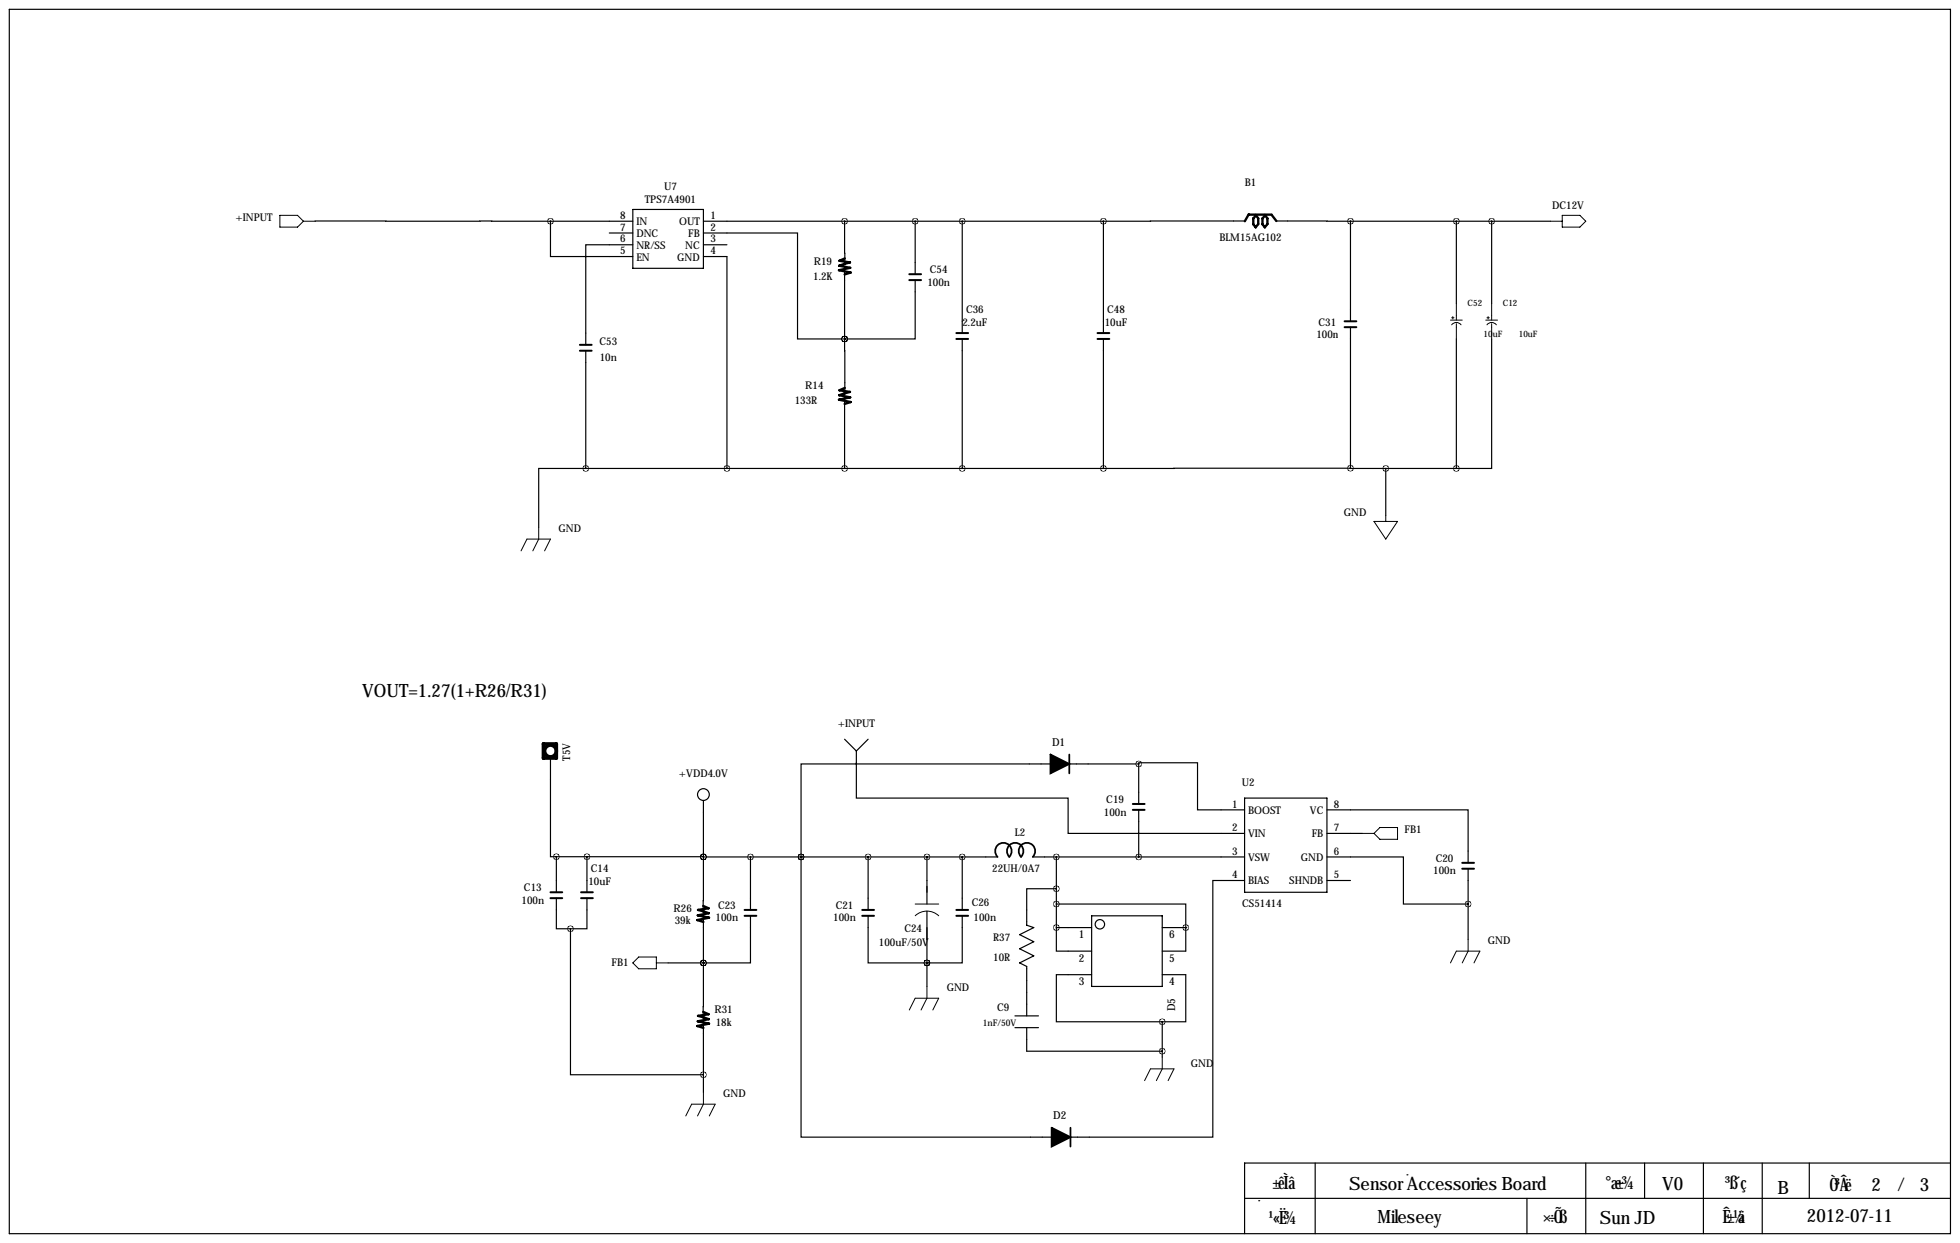
[picture p24: page 2]

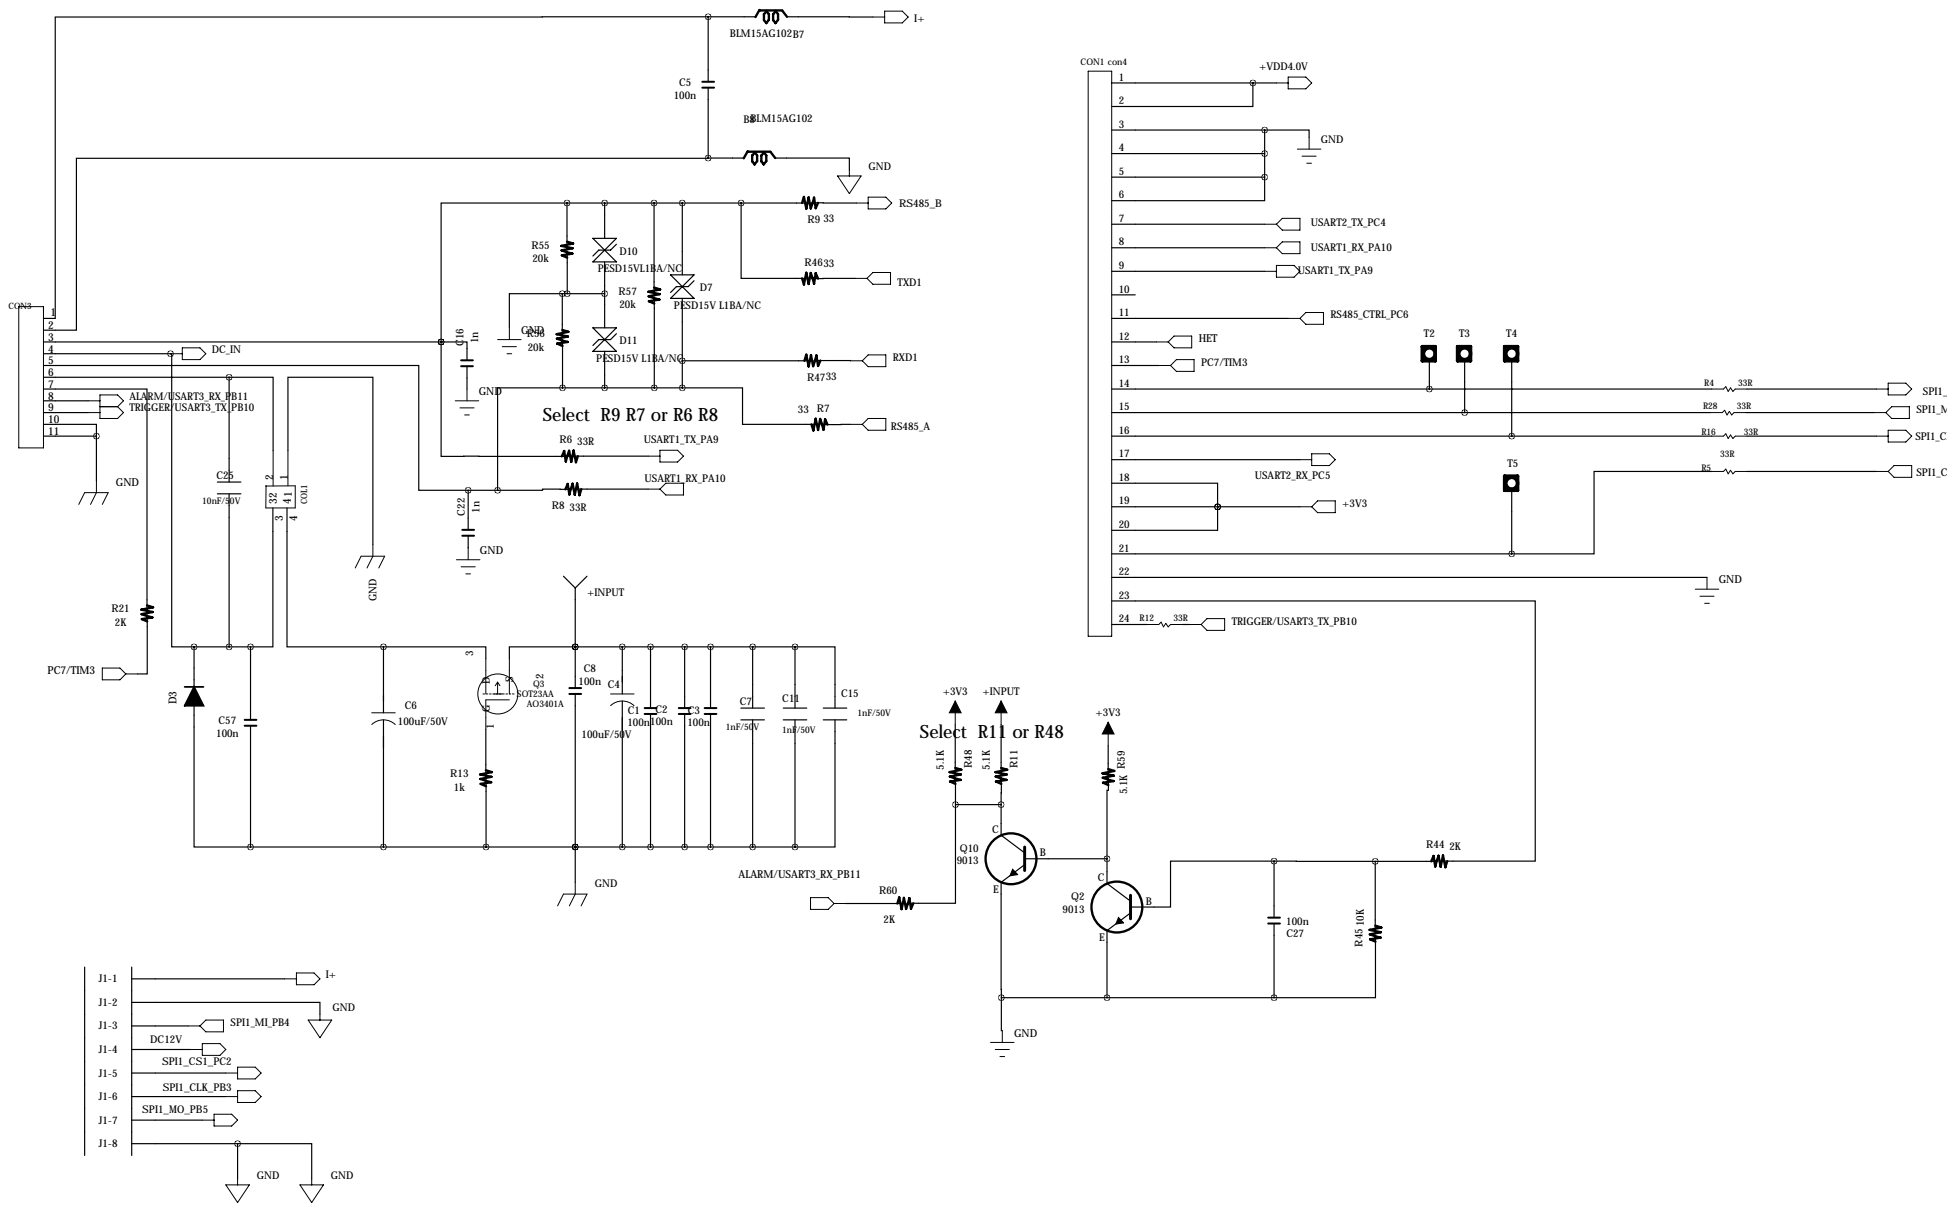
[picture p25: page 3]
