quanhengwen/LK02/硬件/LK02 3V0/v0.0.2/RX_3V0_20170804.pdf

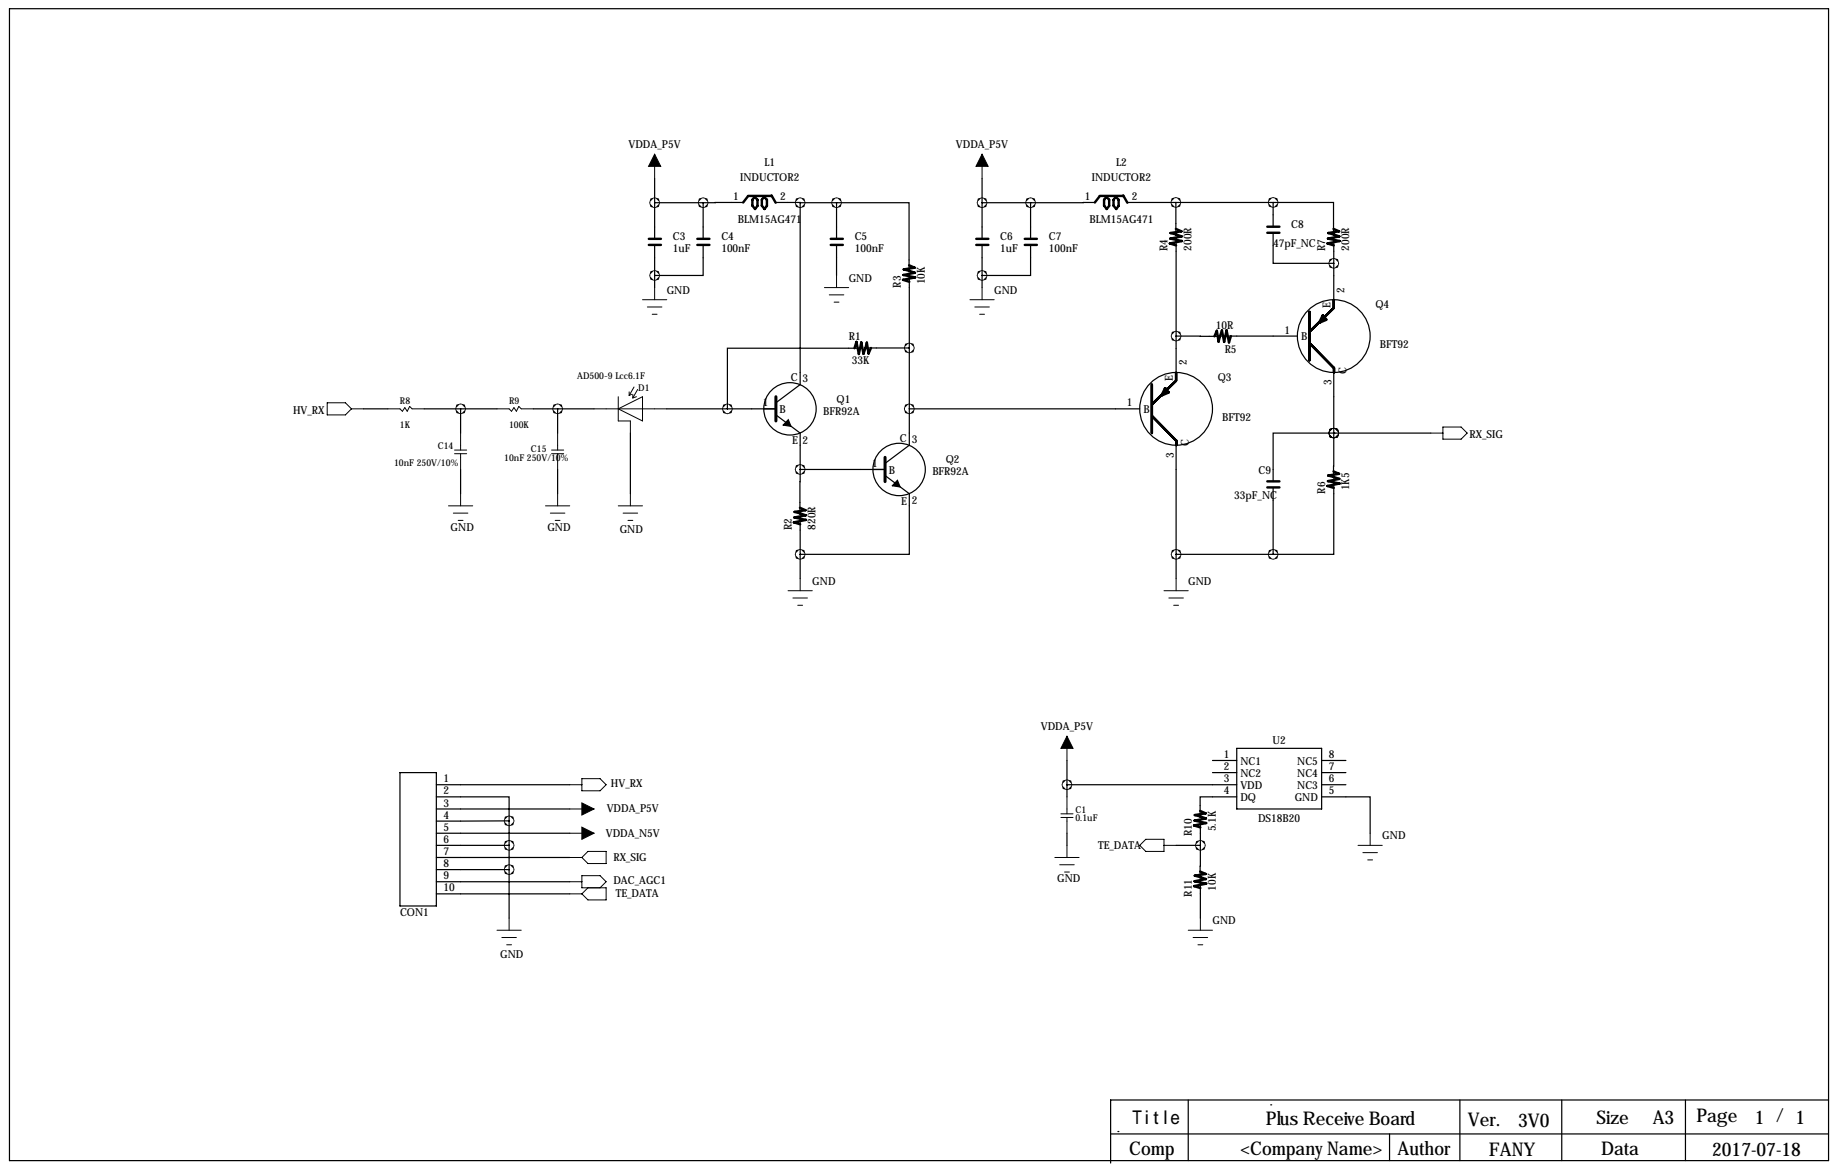
[picture p26: page 1]
