quanhengwen/LK02/硬件/LK02 3V0/v0.0.2/TX_3V0_20170804.pdf

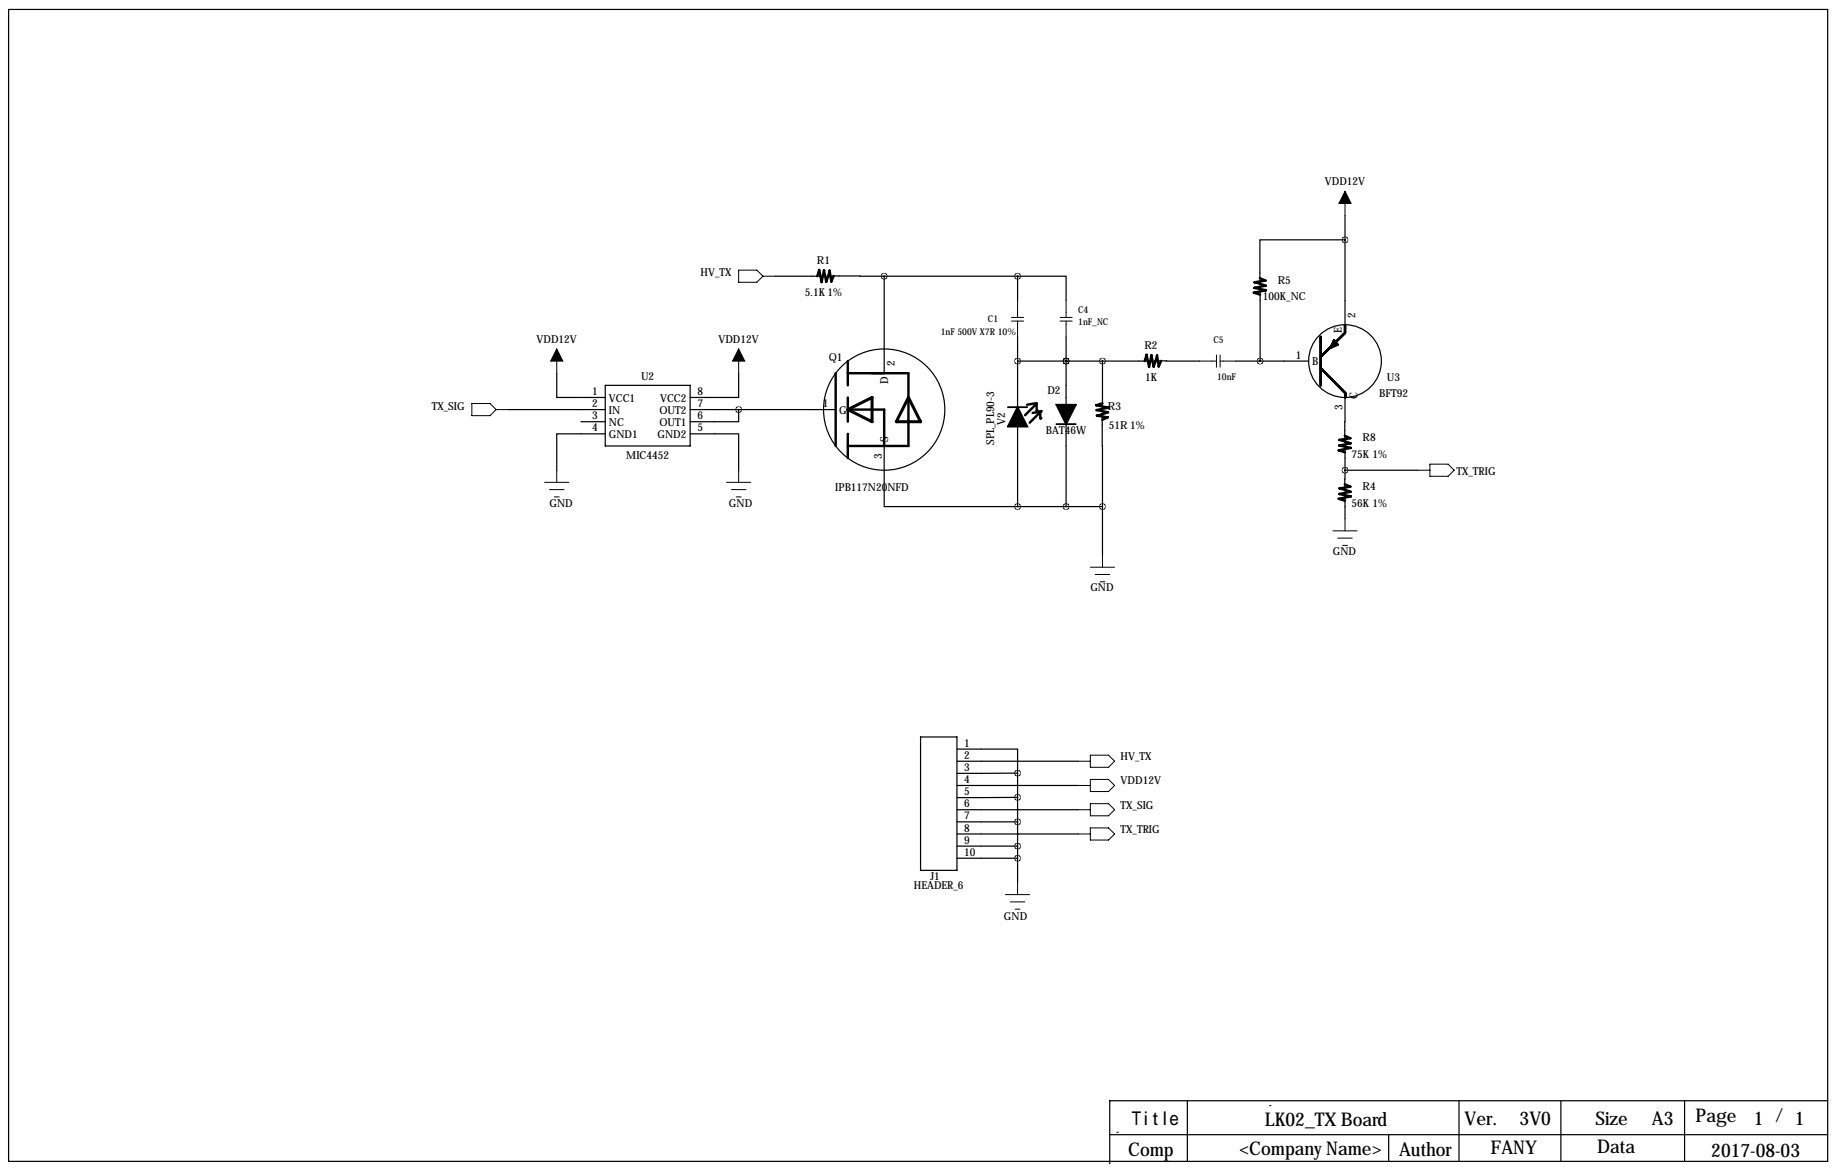
[picture p27: page 1]
