quanhengwen/LK02/硬件/MB01/SCH/sch_MB01_2v3_20160506.pdf

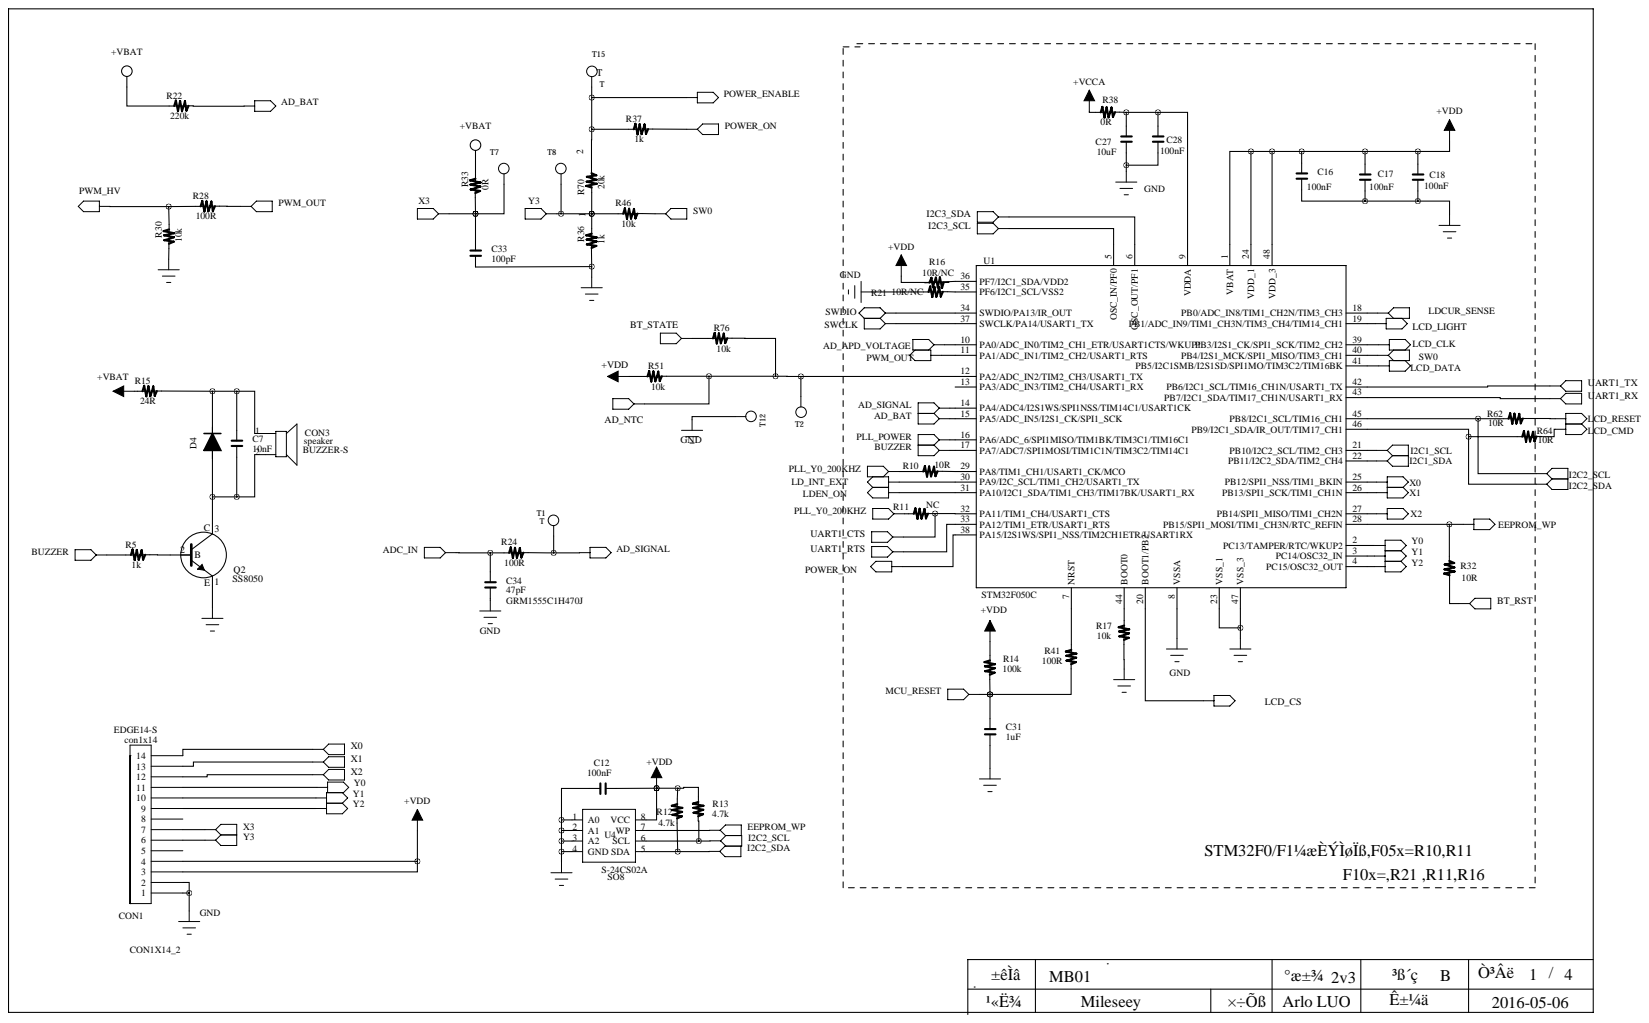
[picture p28: page 1]

## Internal

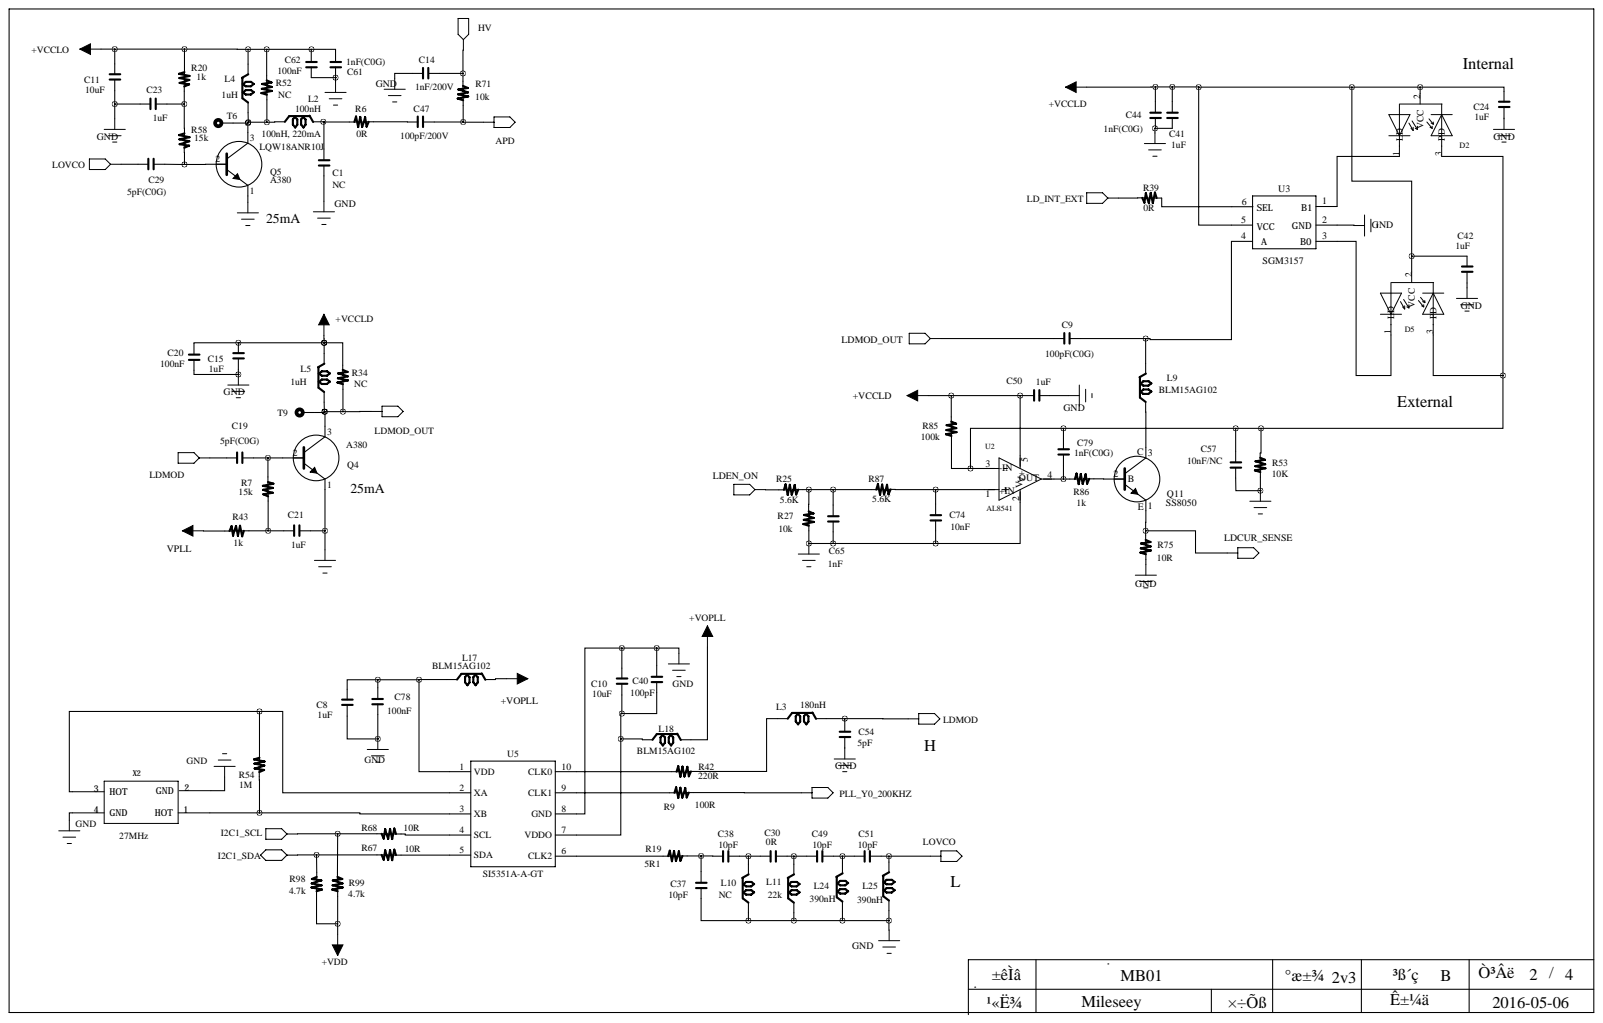
[picture p29: page 2]

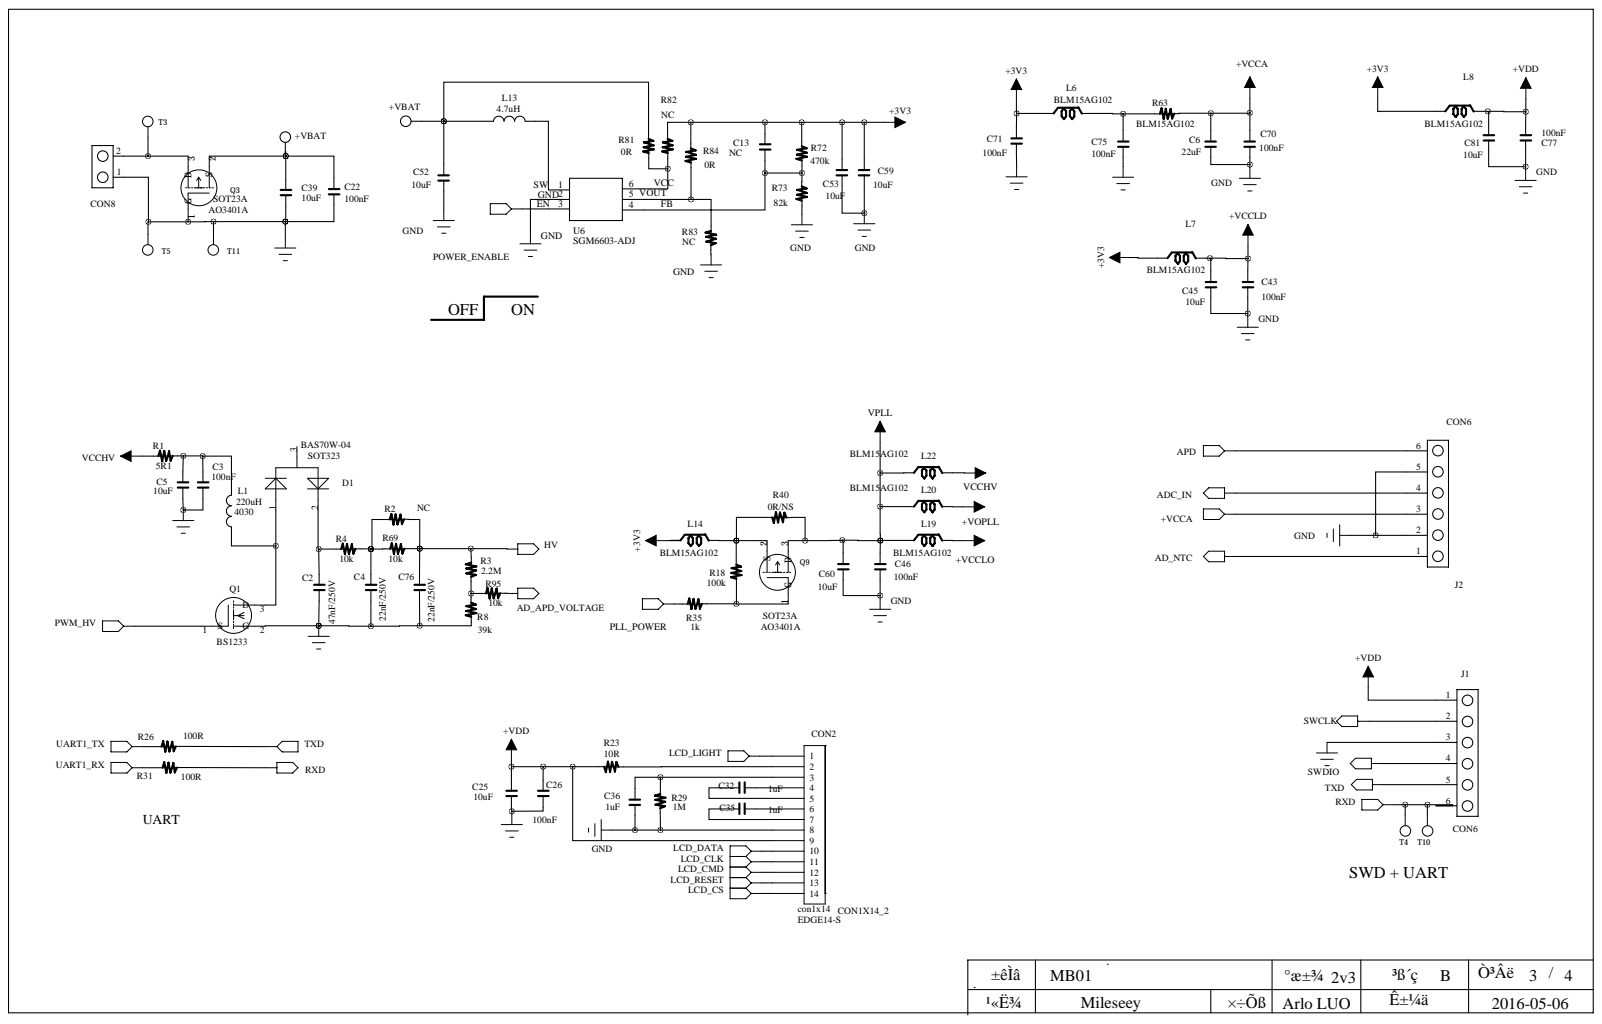
[picture p30: page 3]

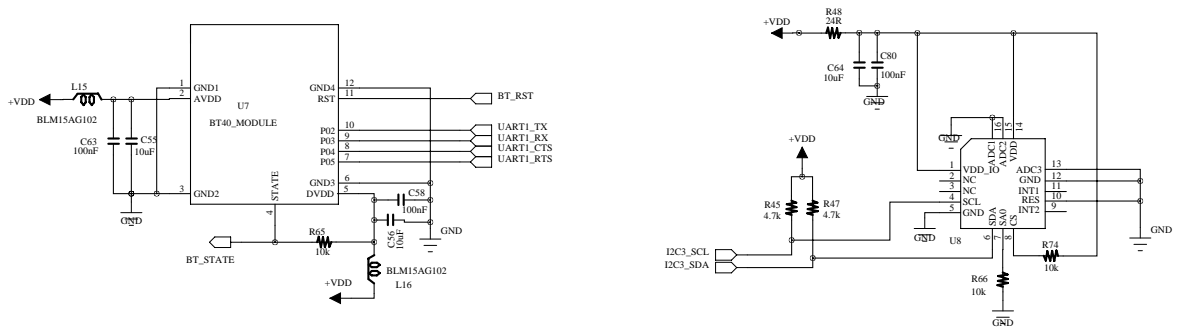
[picture p31: page 4]

13 ADC3 ¹⁴ VDD ¹⁵ ADC² ¹⁶ ADC¹
