quanhengwen/LK02/硬件/LK02 3V0/LK02_3V0/RX_3V0/RX_3V020180118.pdf

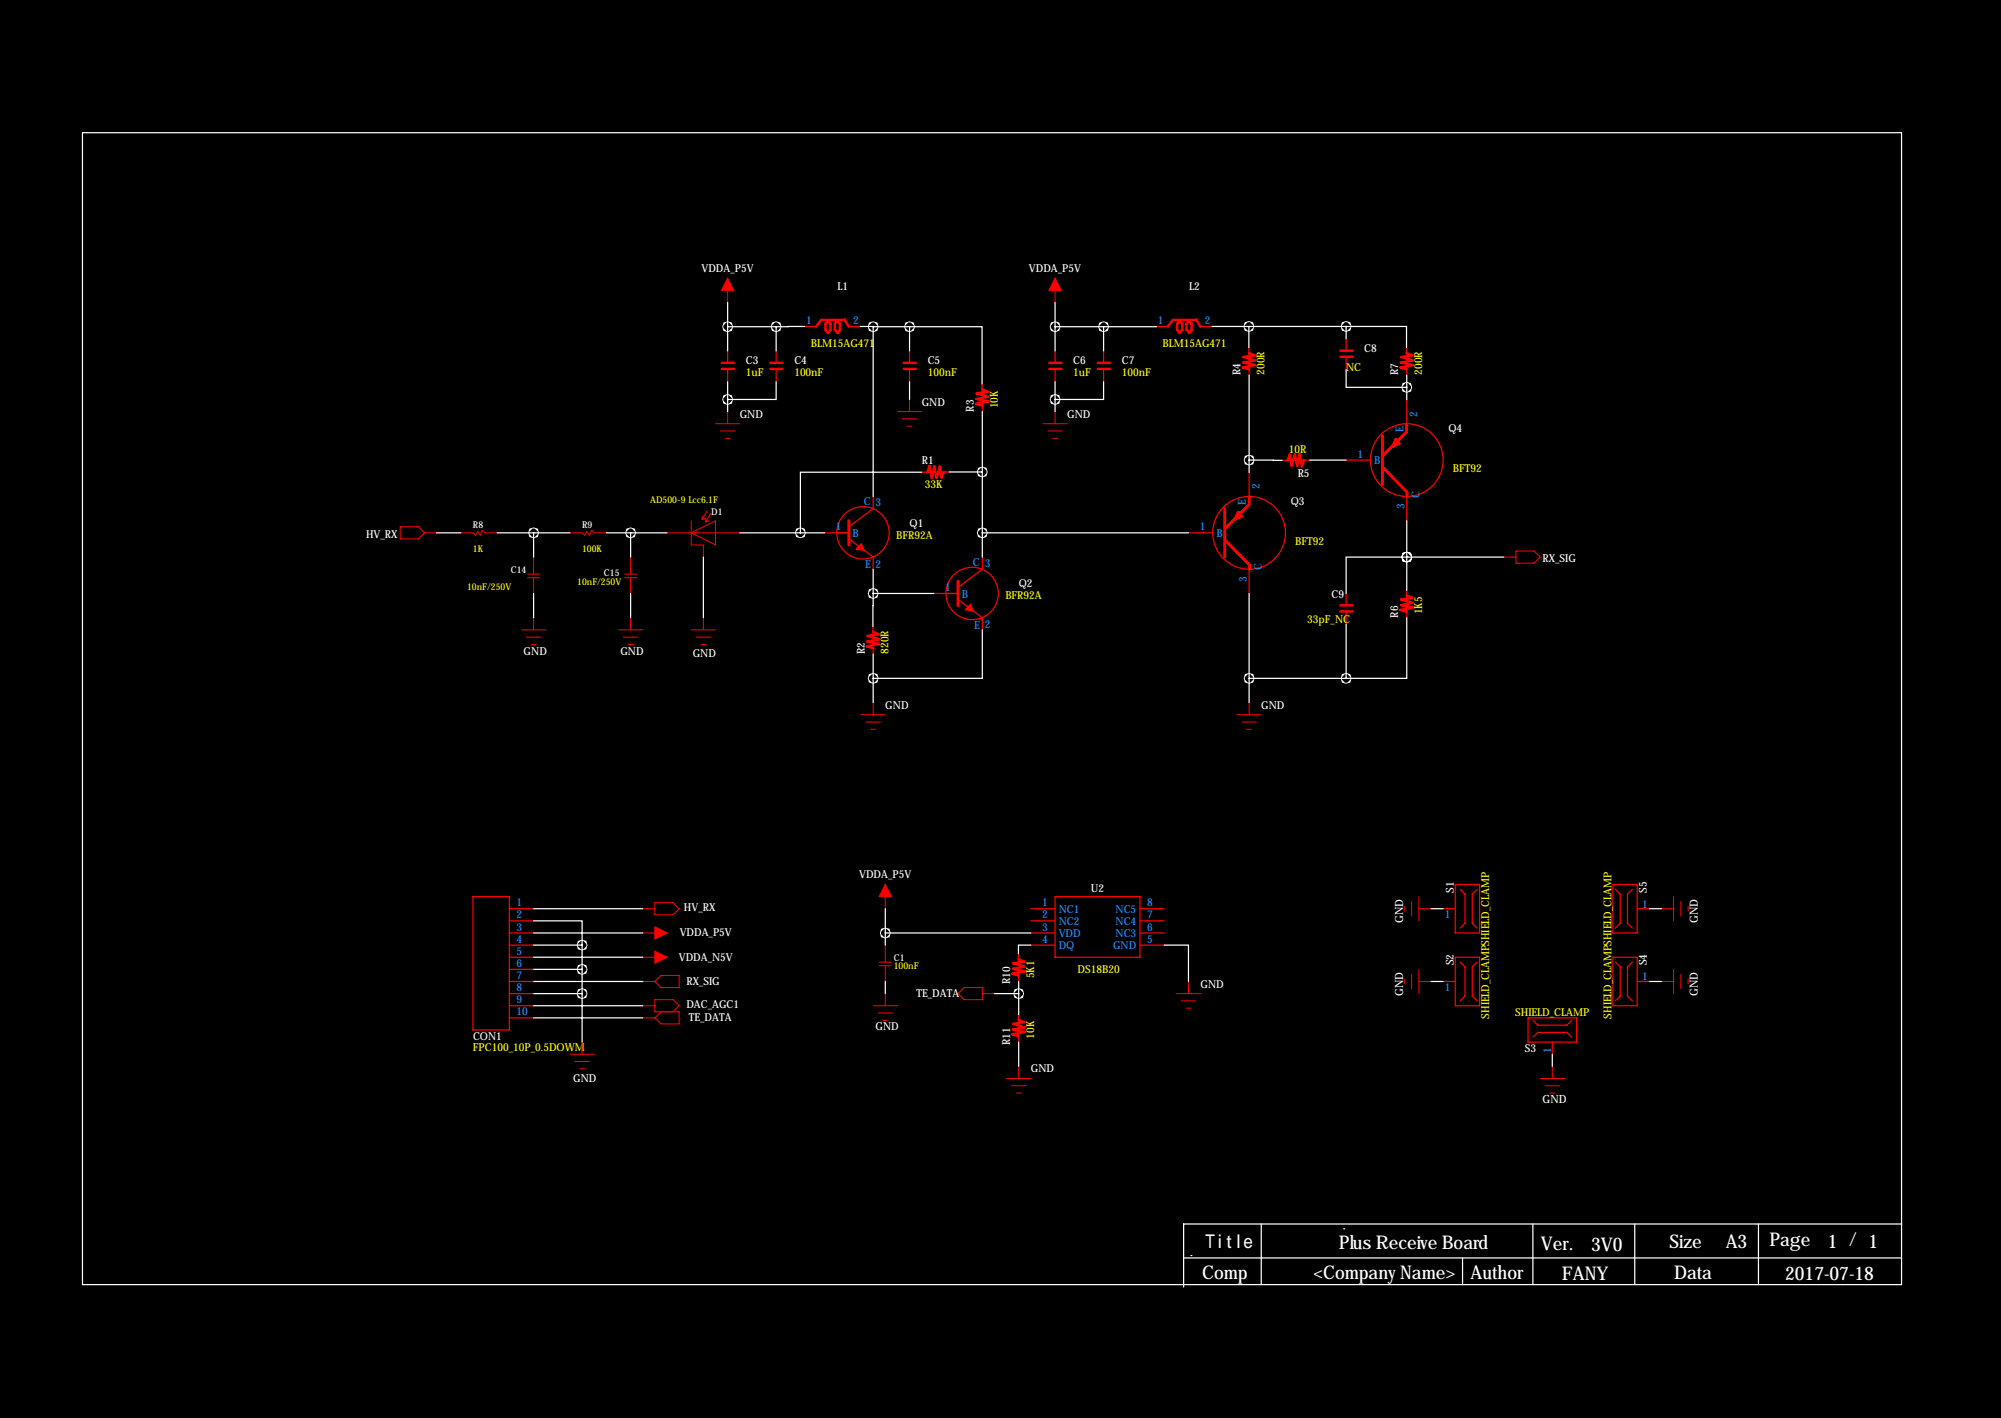
[picture p32: page 1]
