quanhengwen/LK02/硬件/LK02 3V0/LK02_3V0/RX_3V0/Value_RX_3V0.pdf

# FPC100_10P_0.5DOWM BLM¹⁵AG⁴⁷¹ BLM¹⁵AG⁴⁷¹ DS¹⁸B²⁰

# CON1

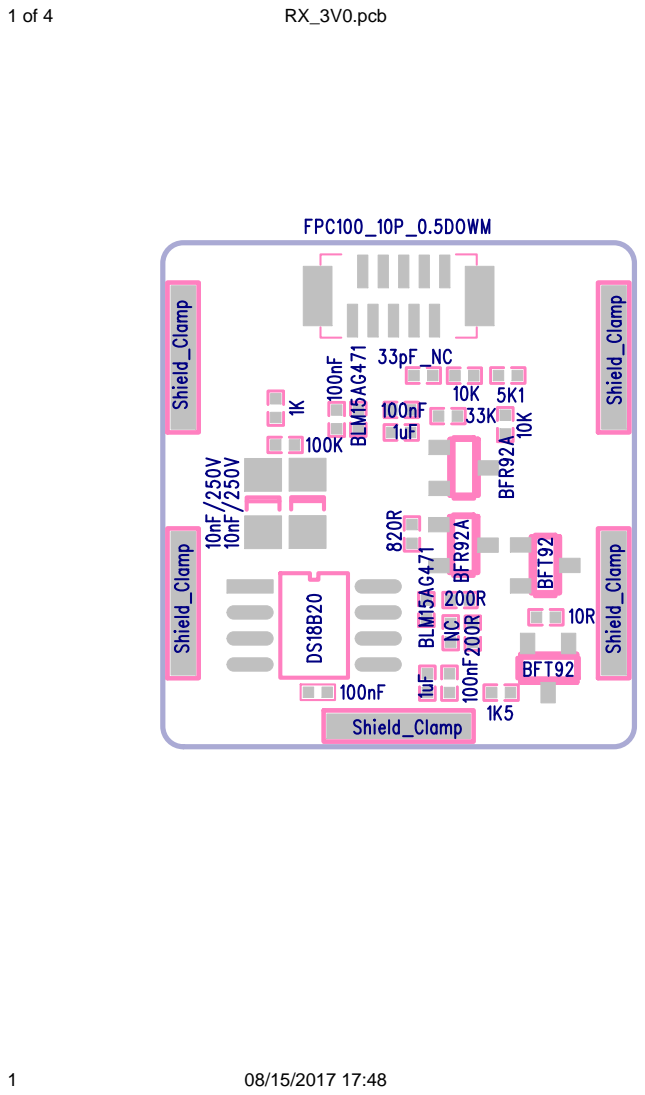
[picture p33: page 1]

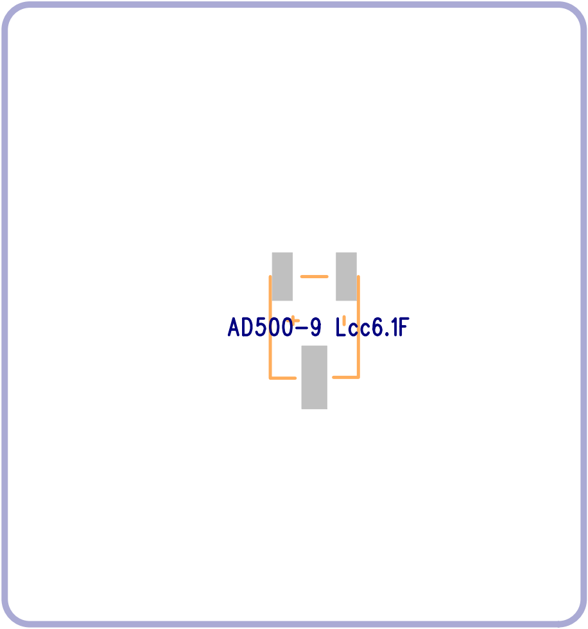
[picture p34: figure]
AD500-9 Lcc6.1F D1D¹x1; D¹x2 D¹x3

# CON1

C5 | S1

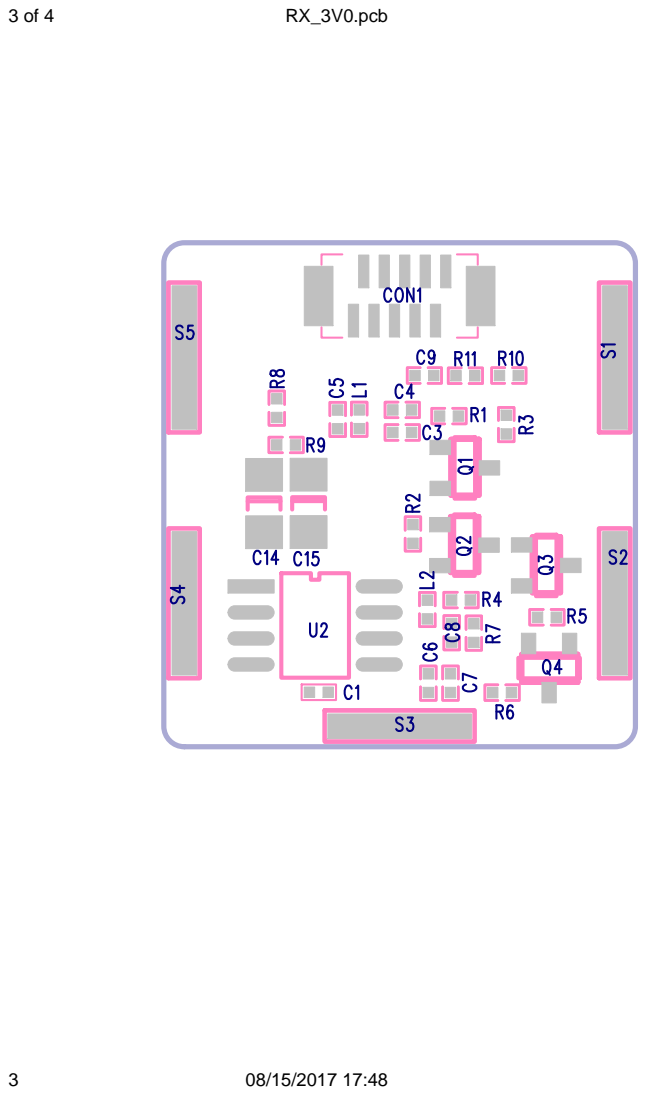
[picture p35: page 3]

+

D1 D1D¹x1 D¹x2 D¹x3
