quanhengwen/LK02/硬件/LK02 3V0/LK02_3V0/TX_3V0/TX_3V0_20170804.pdf

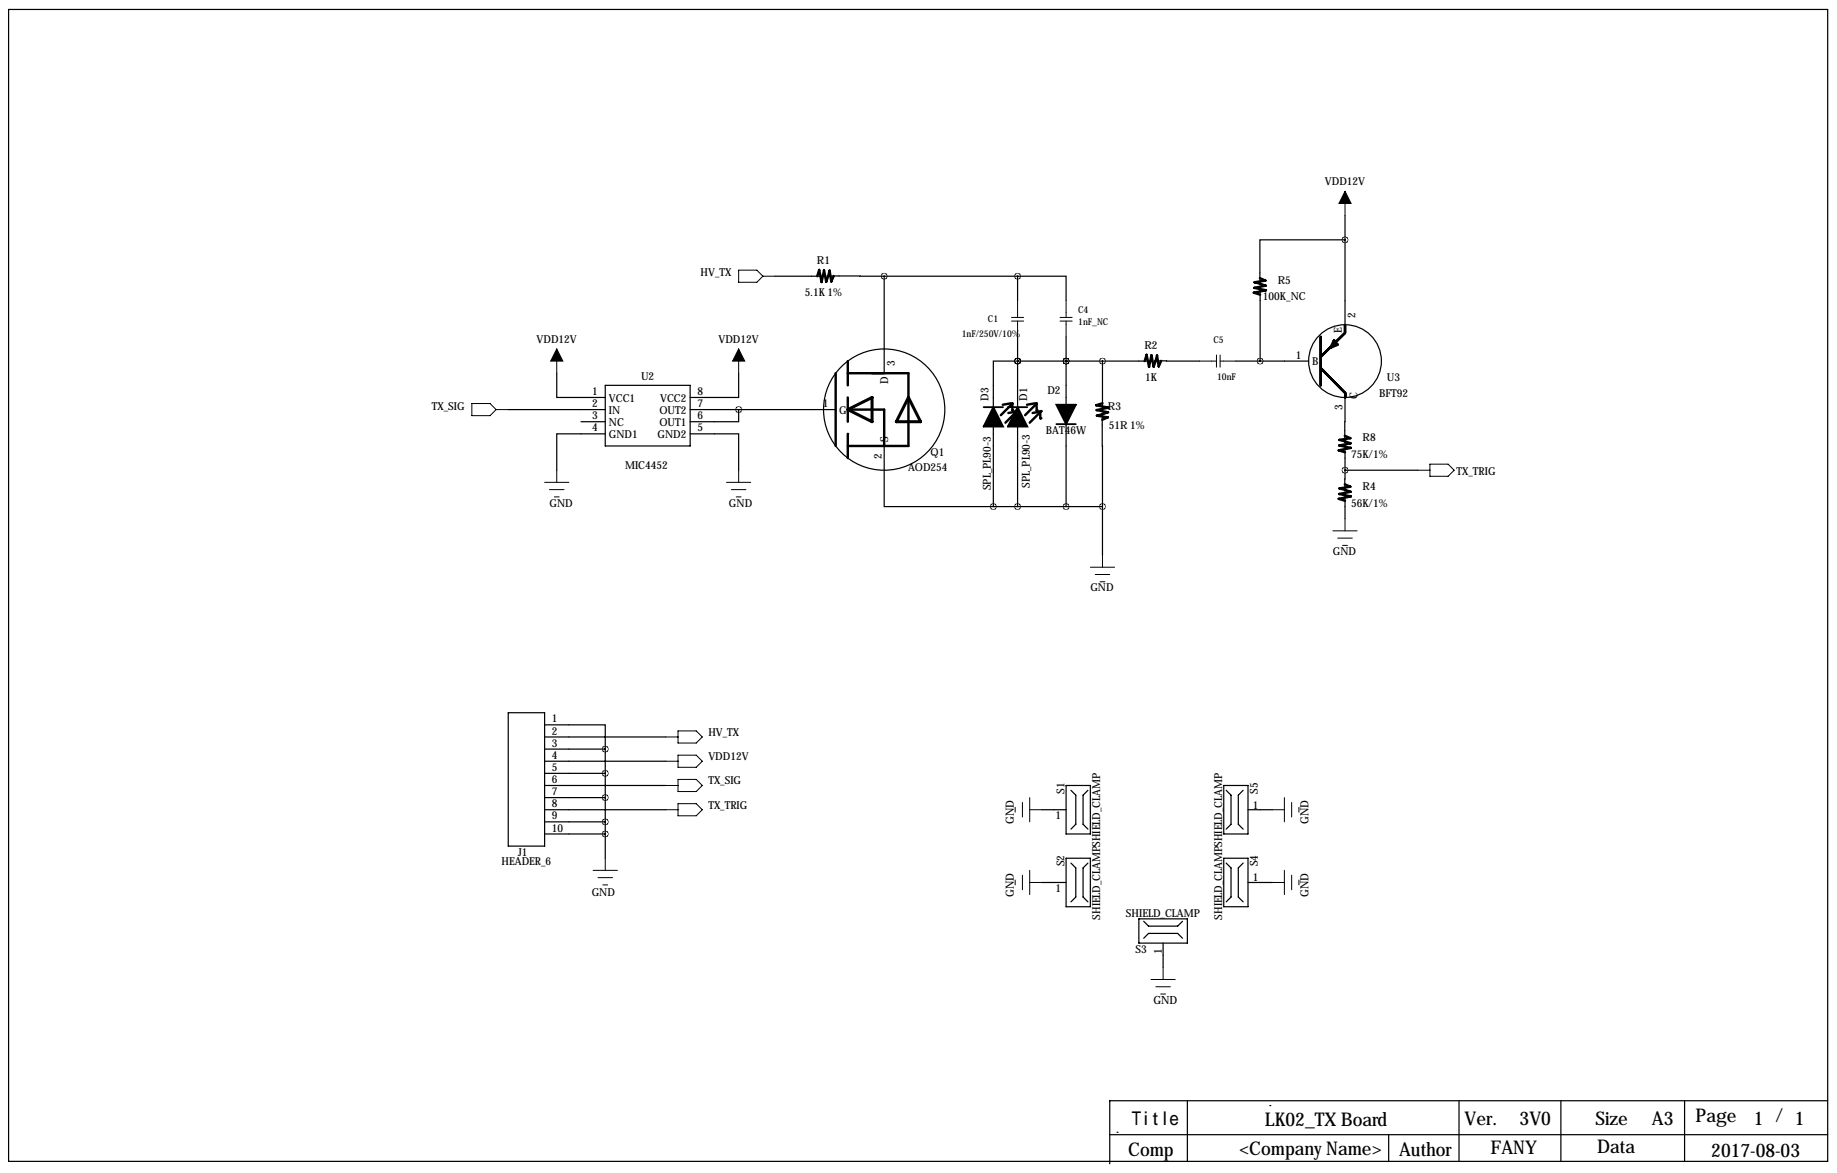
[picture p36: page 1]
