quanhengwen/LK02/硬件/LK02 3V0/LK02_3V0/TX_3V0/VALUE_TX_3V0.pdf

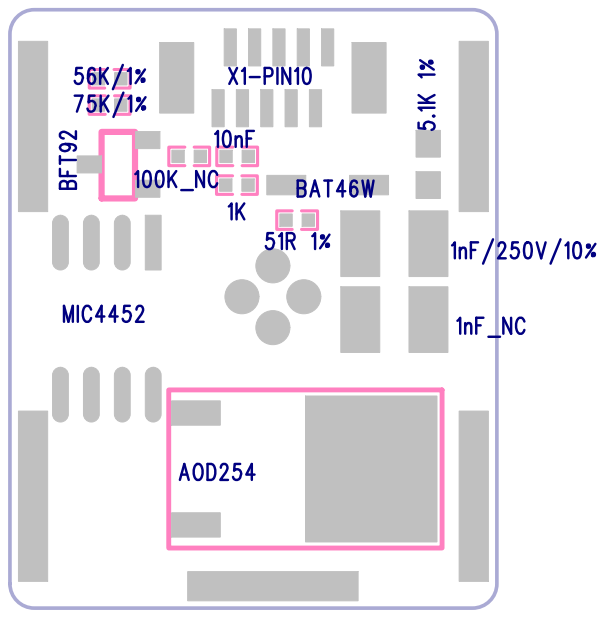
[picture p37: page 1]
BAT46W; X1-PIN10; 10nF 1nF_NC MIC4452 BFT⁹²; AOD254; C1C¹x2; C¹x1; D2D²xA; D²xK; D1D¹xA; D¹xK; R4R⁴x1; R⁴x2; C5C⁵x2; C⁵x1; U2 C4C⁴x2; C⁴x1 U²x4 U²x3 U²x2 U²x1 U²x5 U²x6 U²x7 U²x8; U3U³x1 U³x2 U³x3; R2R²x2; R²x1; R3R³x1; R³x2; R5R⁵x2; R⁵x1; R8R⁸x2; R⁸x1; D3D³xA D³xK; R1R¹x1; S1S¹x1; S2S²x1; S3S³x1; S4S⁴x1; S5S⁵x1; Q1Q¹x1 Q¹x2; Q¹x3

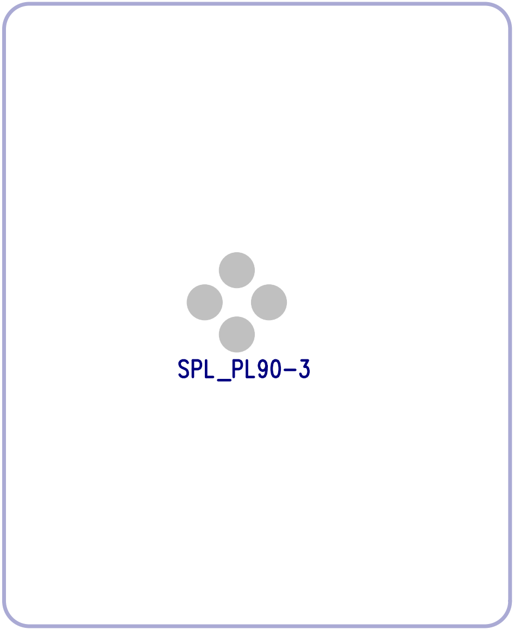
[picture p38: figure]
SPL_PL90-3
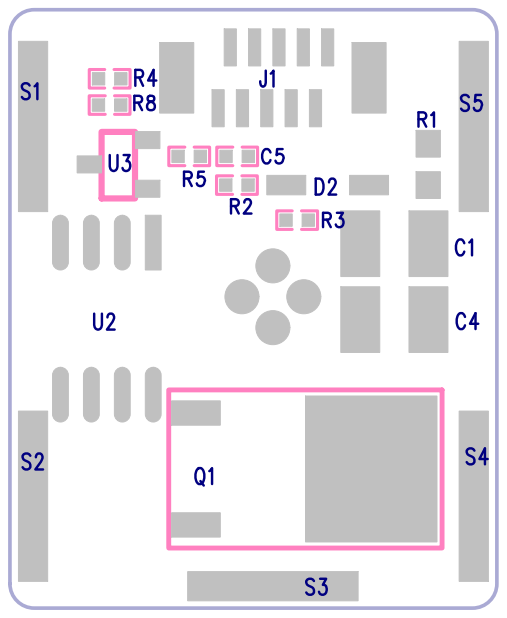
[picture p39: page 3]

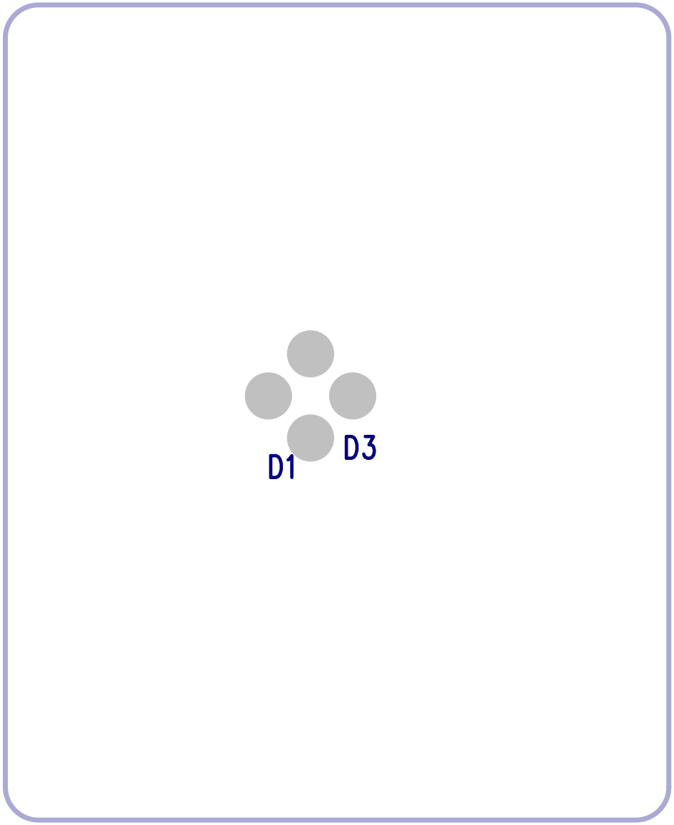
[picture p40: figure]
D3D1D¹xK D³xAD¹xA D3D³xK
