quanhengwen/LK02/硬件/LK02/LK02第二次试产/主板/C2 Main board Rev3.2-1.pdf

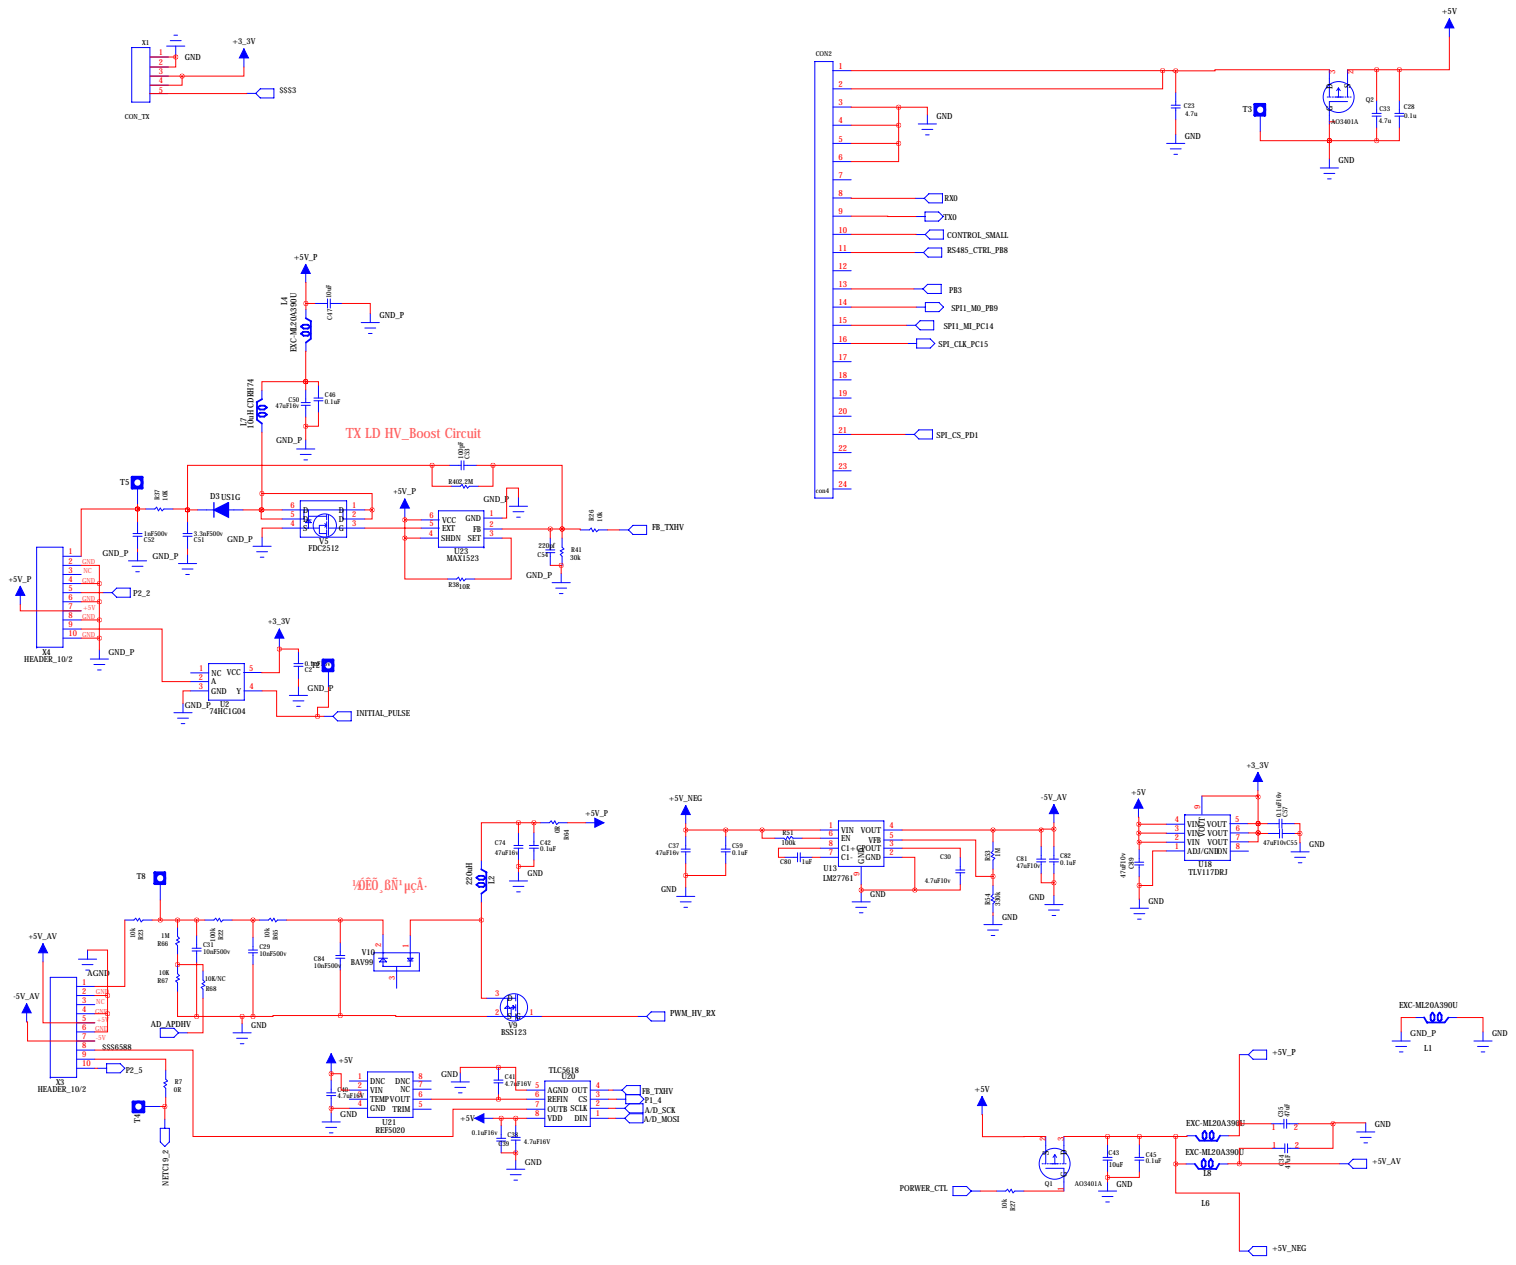
[picture p41: page 1]

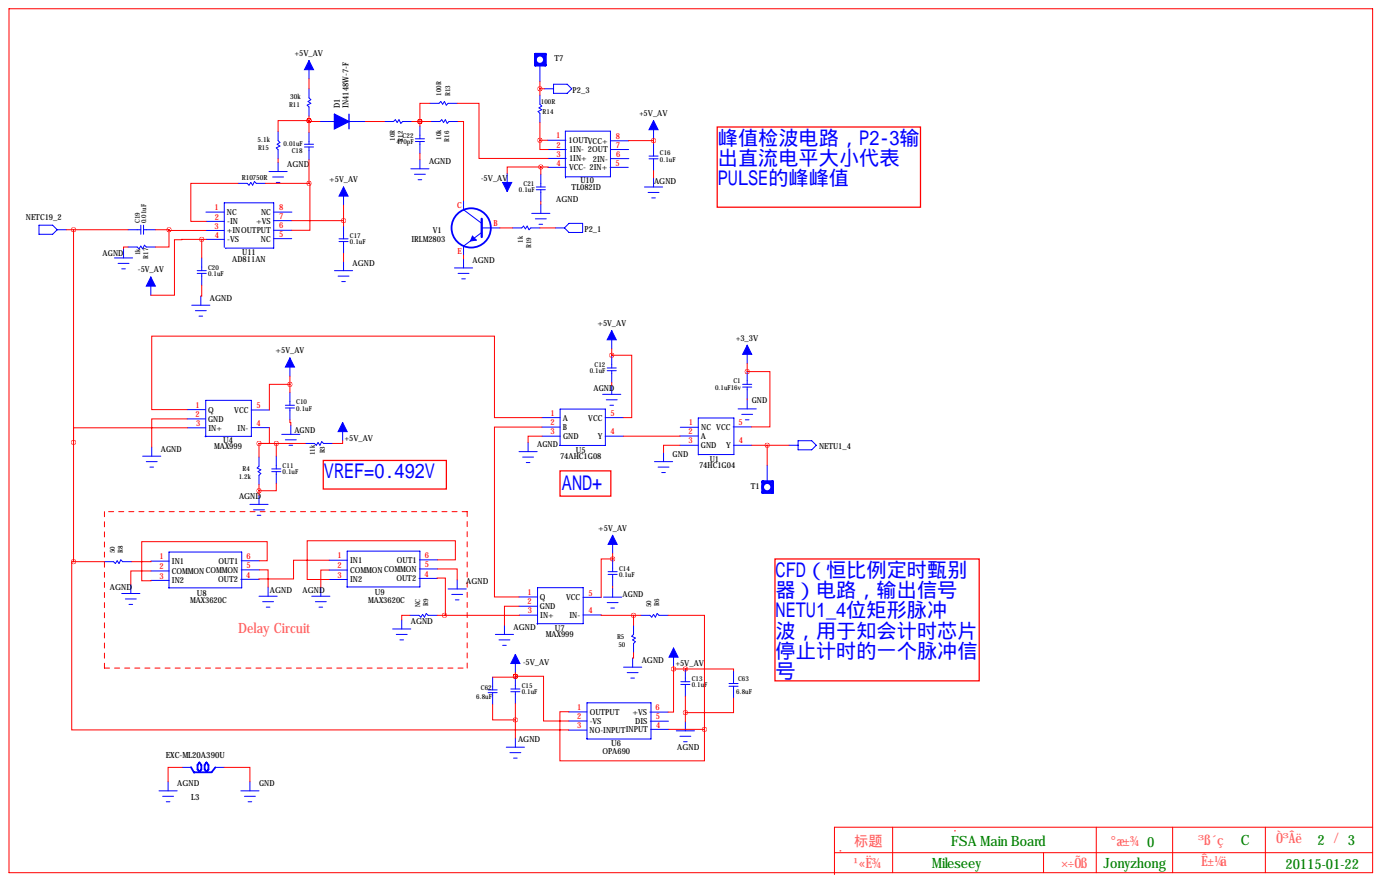
[picture p42: page 2]

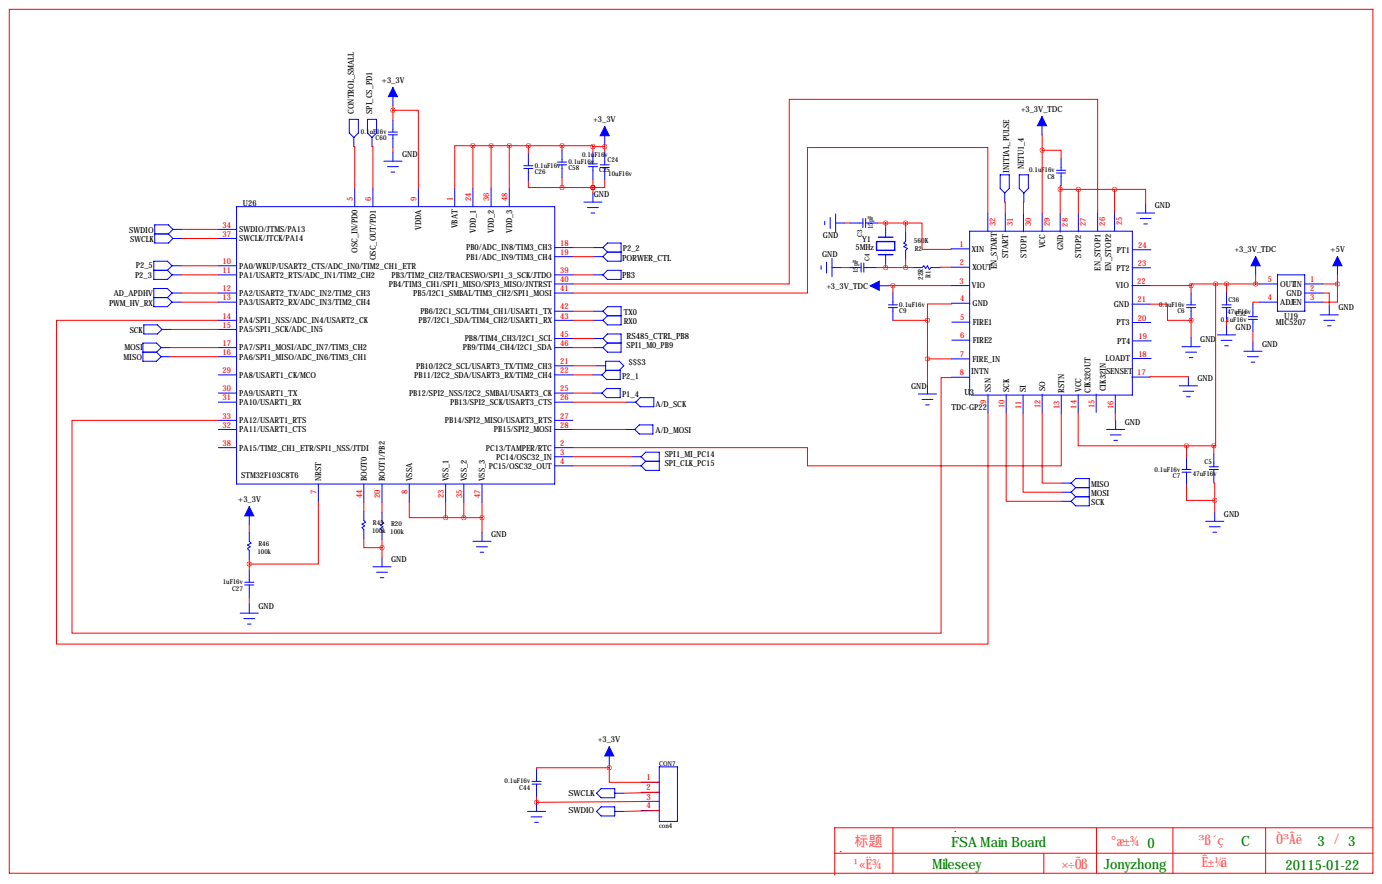
[picture p43: page 3]
