quanhengwen/LK02/硬件/LK02/LK02第二次试产/瞄准板/laser sight.pdf

D

6 | 5 | 4 | 3 | 2 | 1

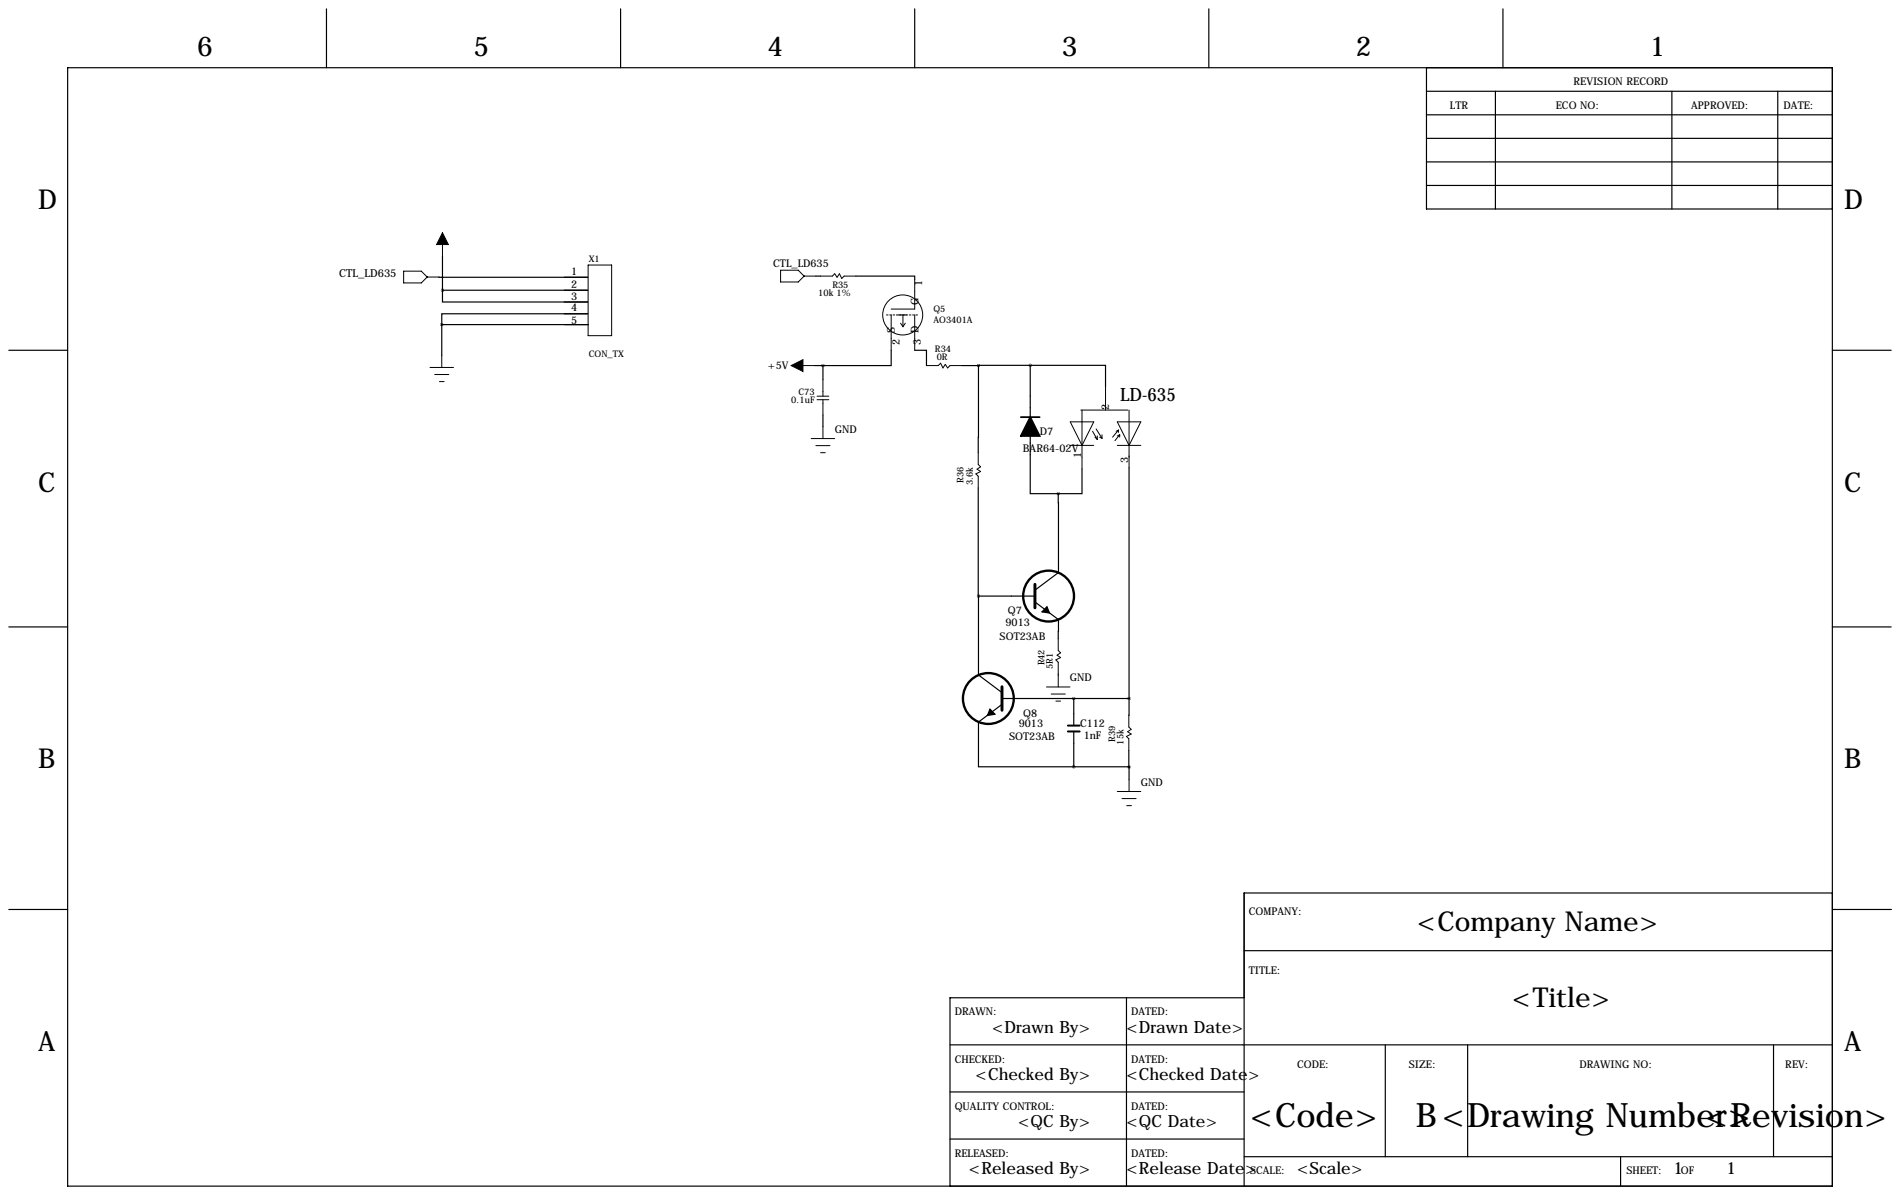
[picture p44: page 1]

REVISION RECORD

LTR | ECO NO: | APPROVED: | DATE:

DRAWN: <Drawn By> | DATED: <Drawn Date>

CHECKED: <Checked By> | DATED: <Checked Date> | CODE: | SIZE: | DRAWING NO: | REV:

QUALITY CONTROL: <QC By> | DATED: <QC Date>

RELEASED: <Released By> | DATED:

<Scale> SCALE: | 1 1 SHEET: OF
