quanhengwen/LK02/硬件/LK02/LK02最新硬件/主板/第二次试产主板/C2 Main board Rev3.2-1.pdf

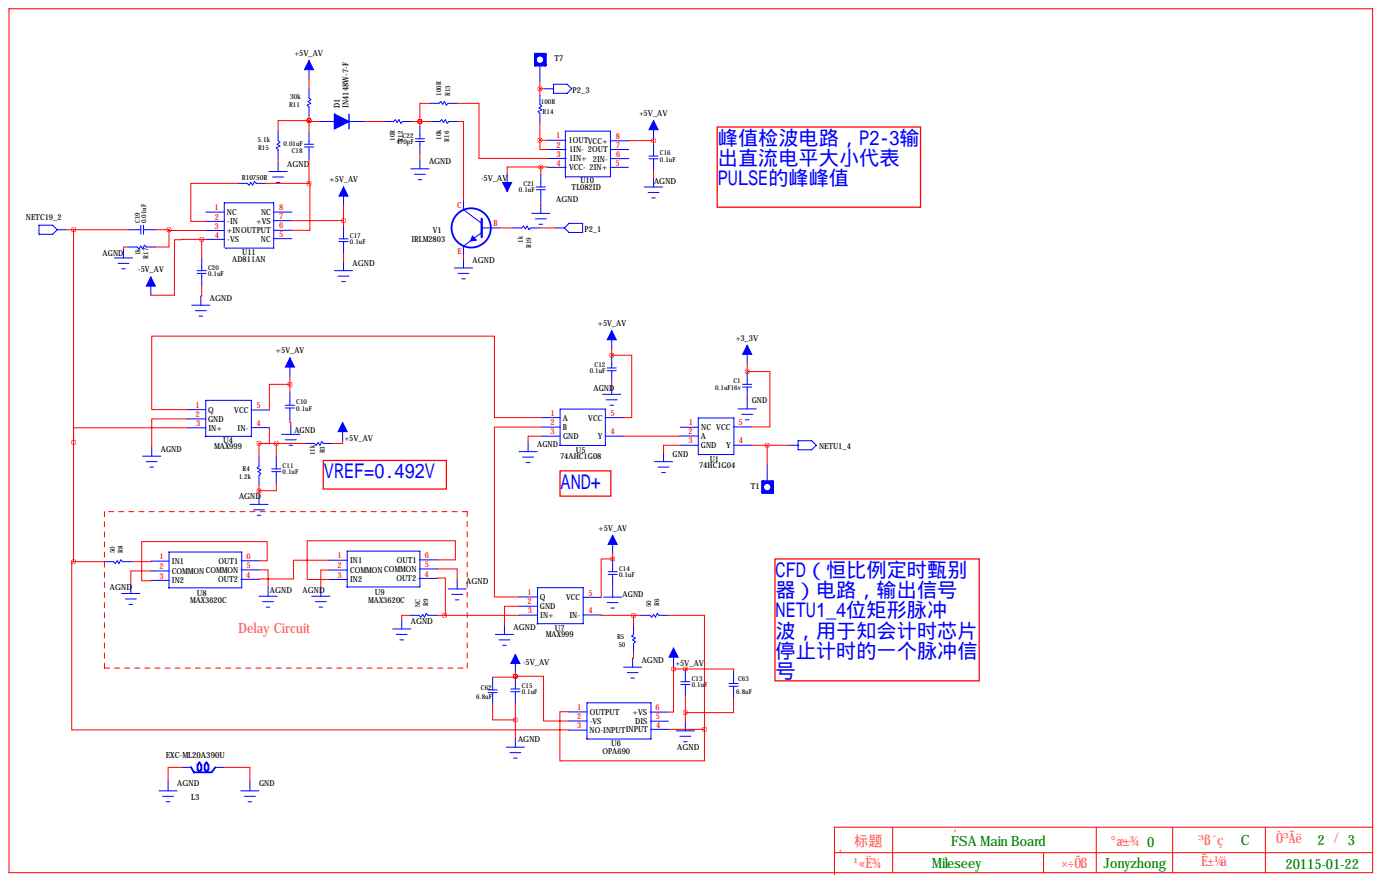
[picture p45: page 2]
