quanhengwen/LK02/硬件/LK02/LK02最新硬件/电源板/AD5420_POWER_V2.1（REF）/AD5420_POWER_V2.1贴片图.pdf

# C24C²⁴x1 C²⁴x2

Q5

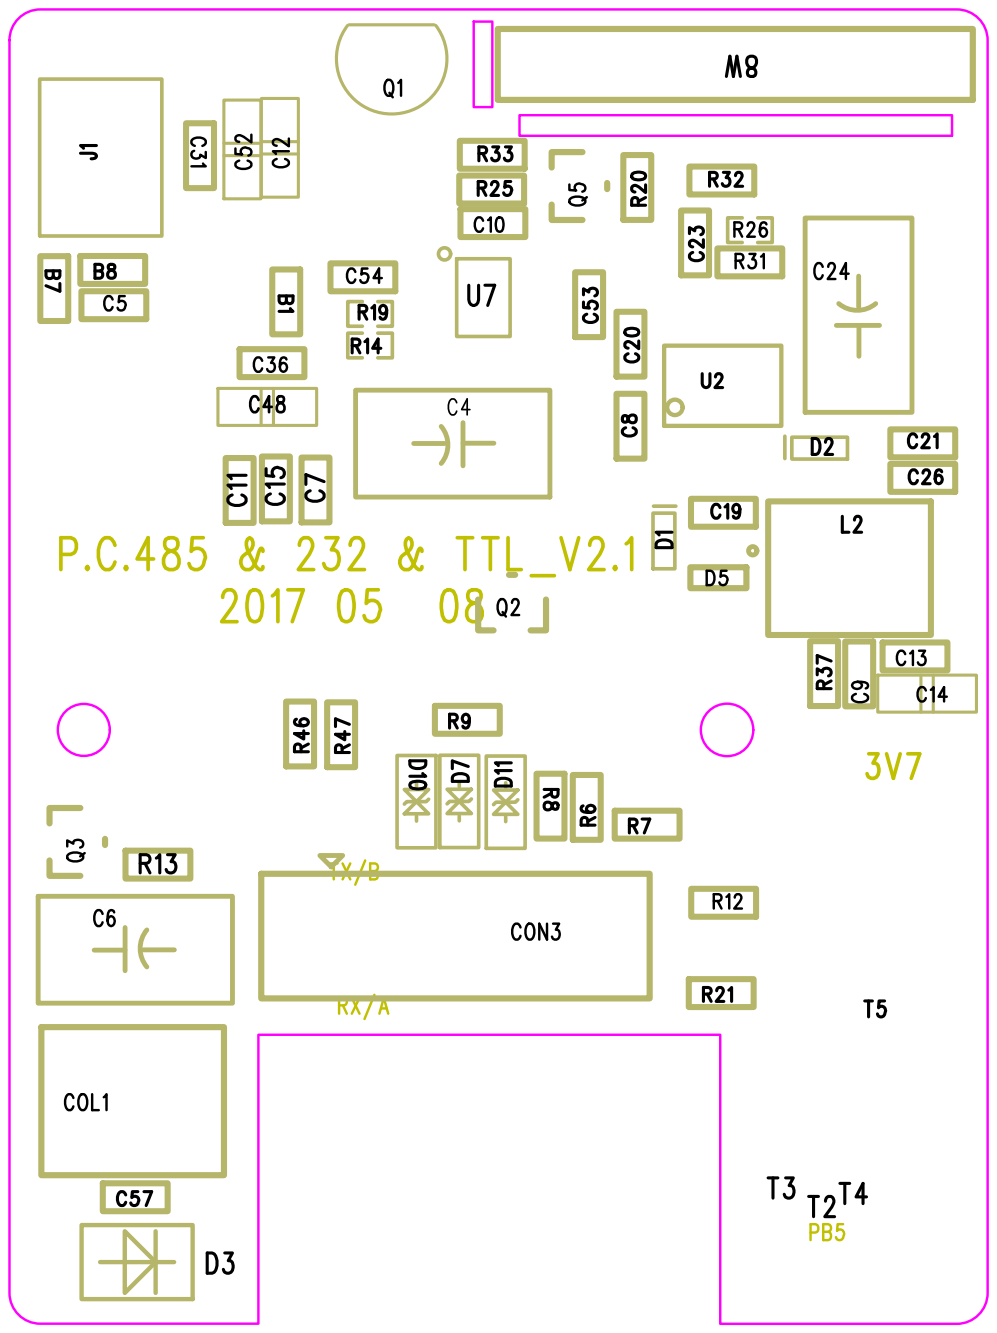
[picture p46: page 1]

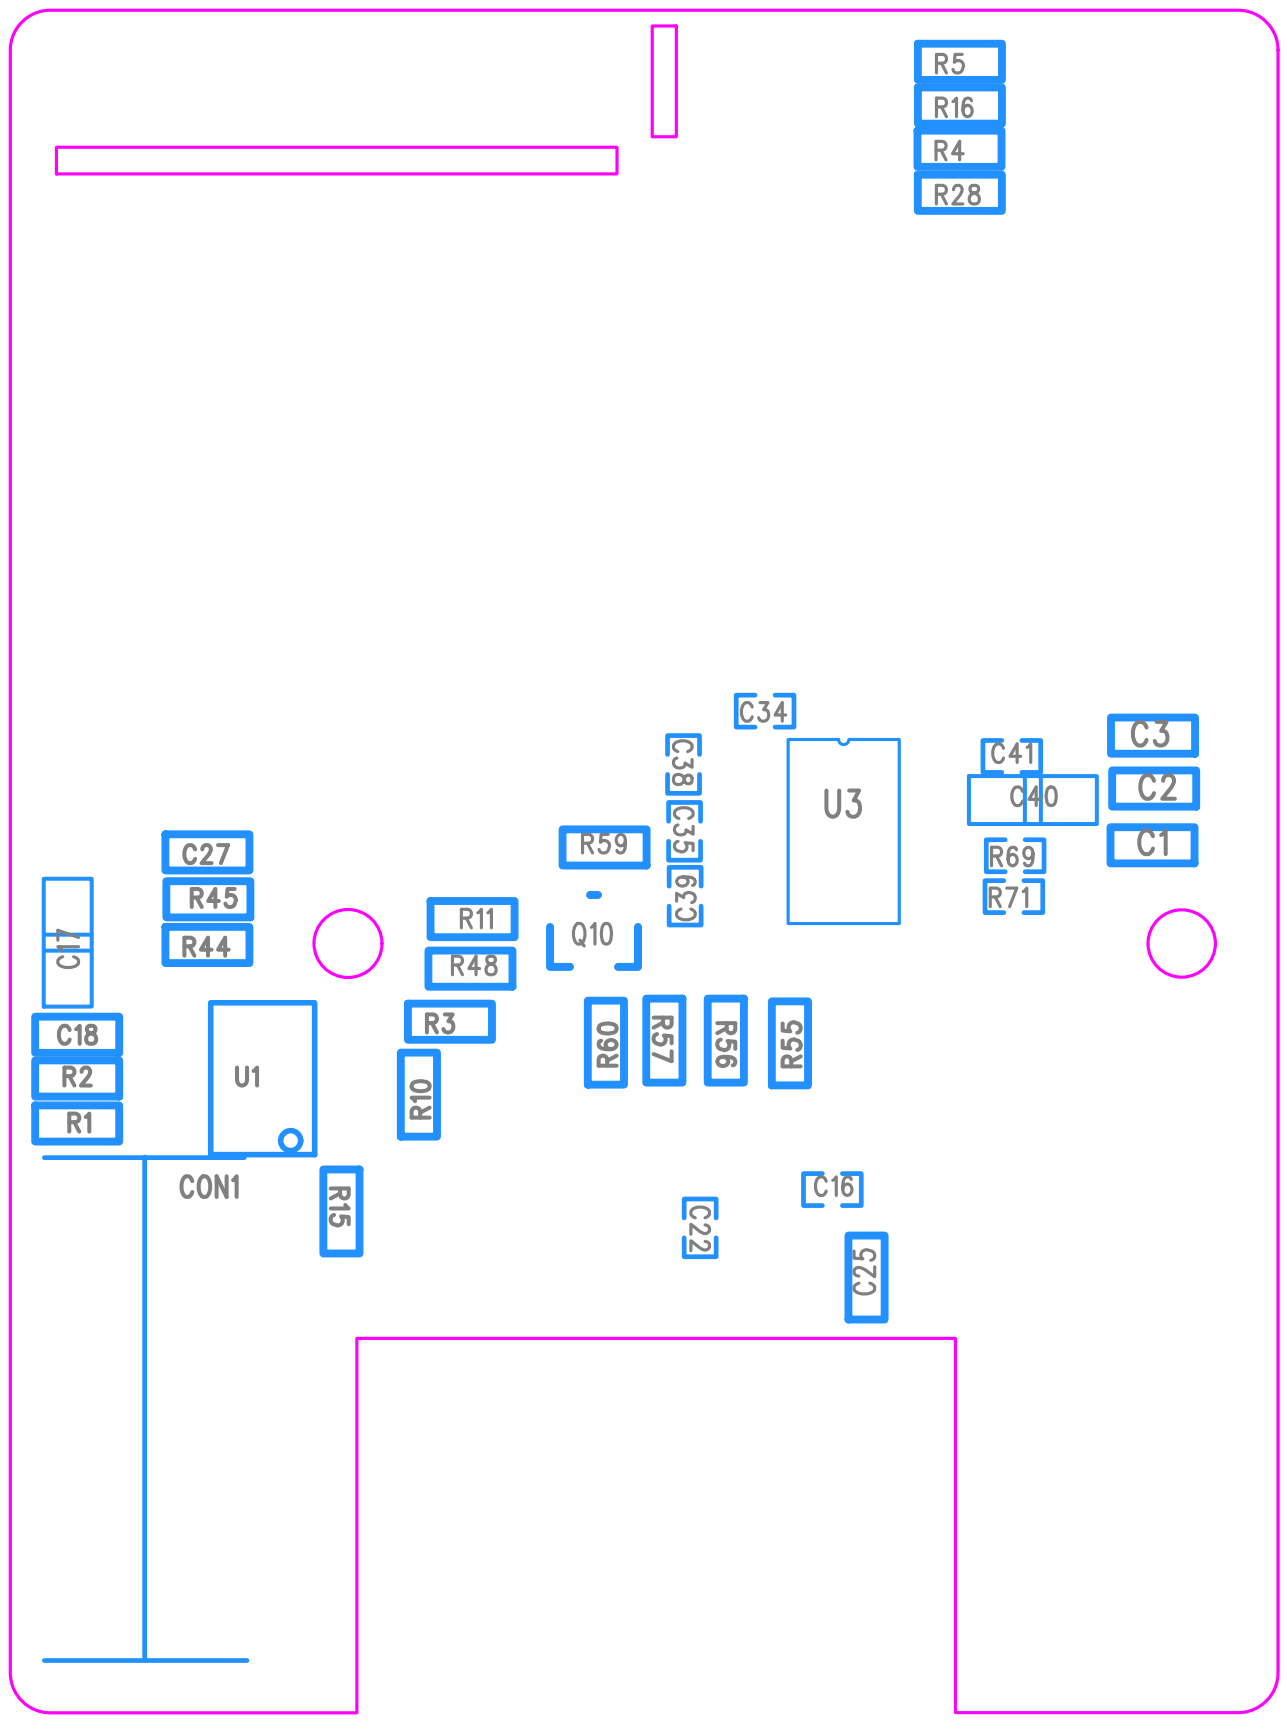
[picture p47: page 2]
