quanhengwen/LK02/硬件/LK02/LK02最新硬件/电源板/DXF/LK02_POWER_V1.0-531 Model (1).pdf

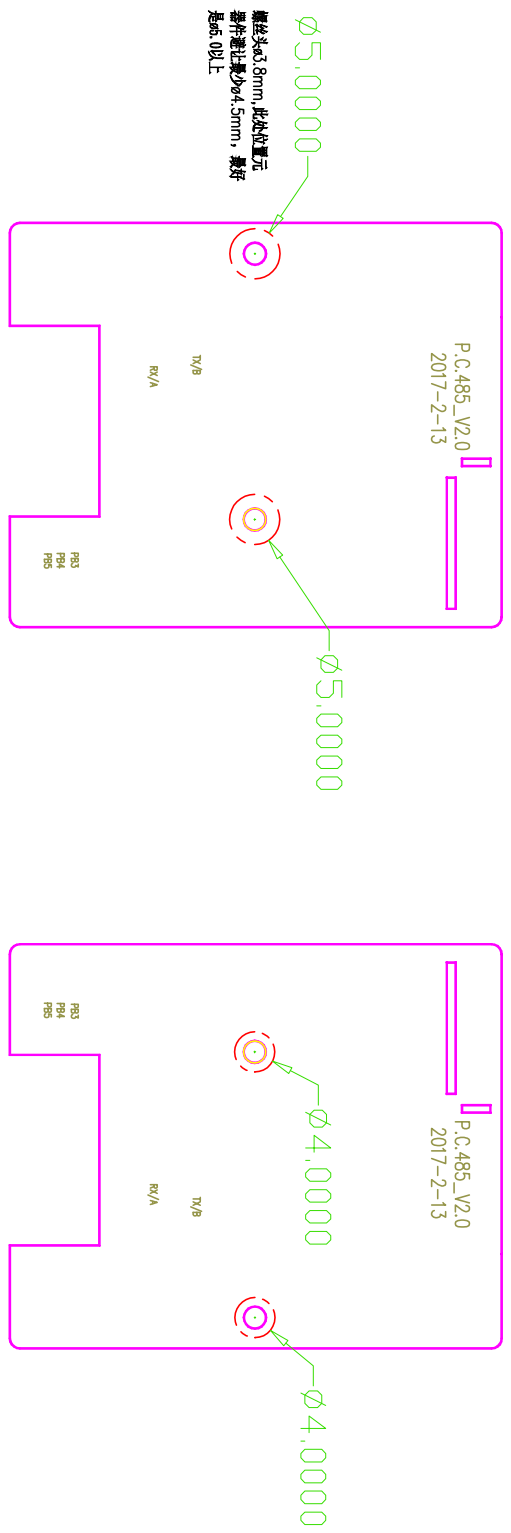
[picture p48: page 1]
