quanhengwen/LK02/硬件/LK02/LK02最新硬件/主板/LK02 Main board V0.3/SCH/LK02 Main board V0.3.pdf

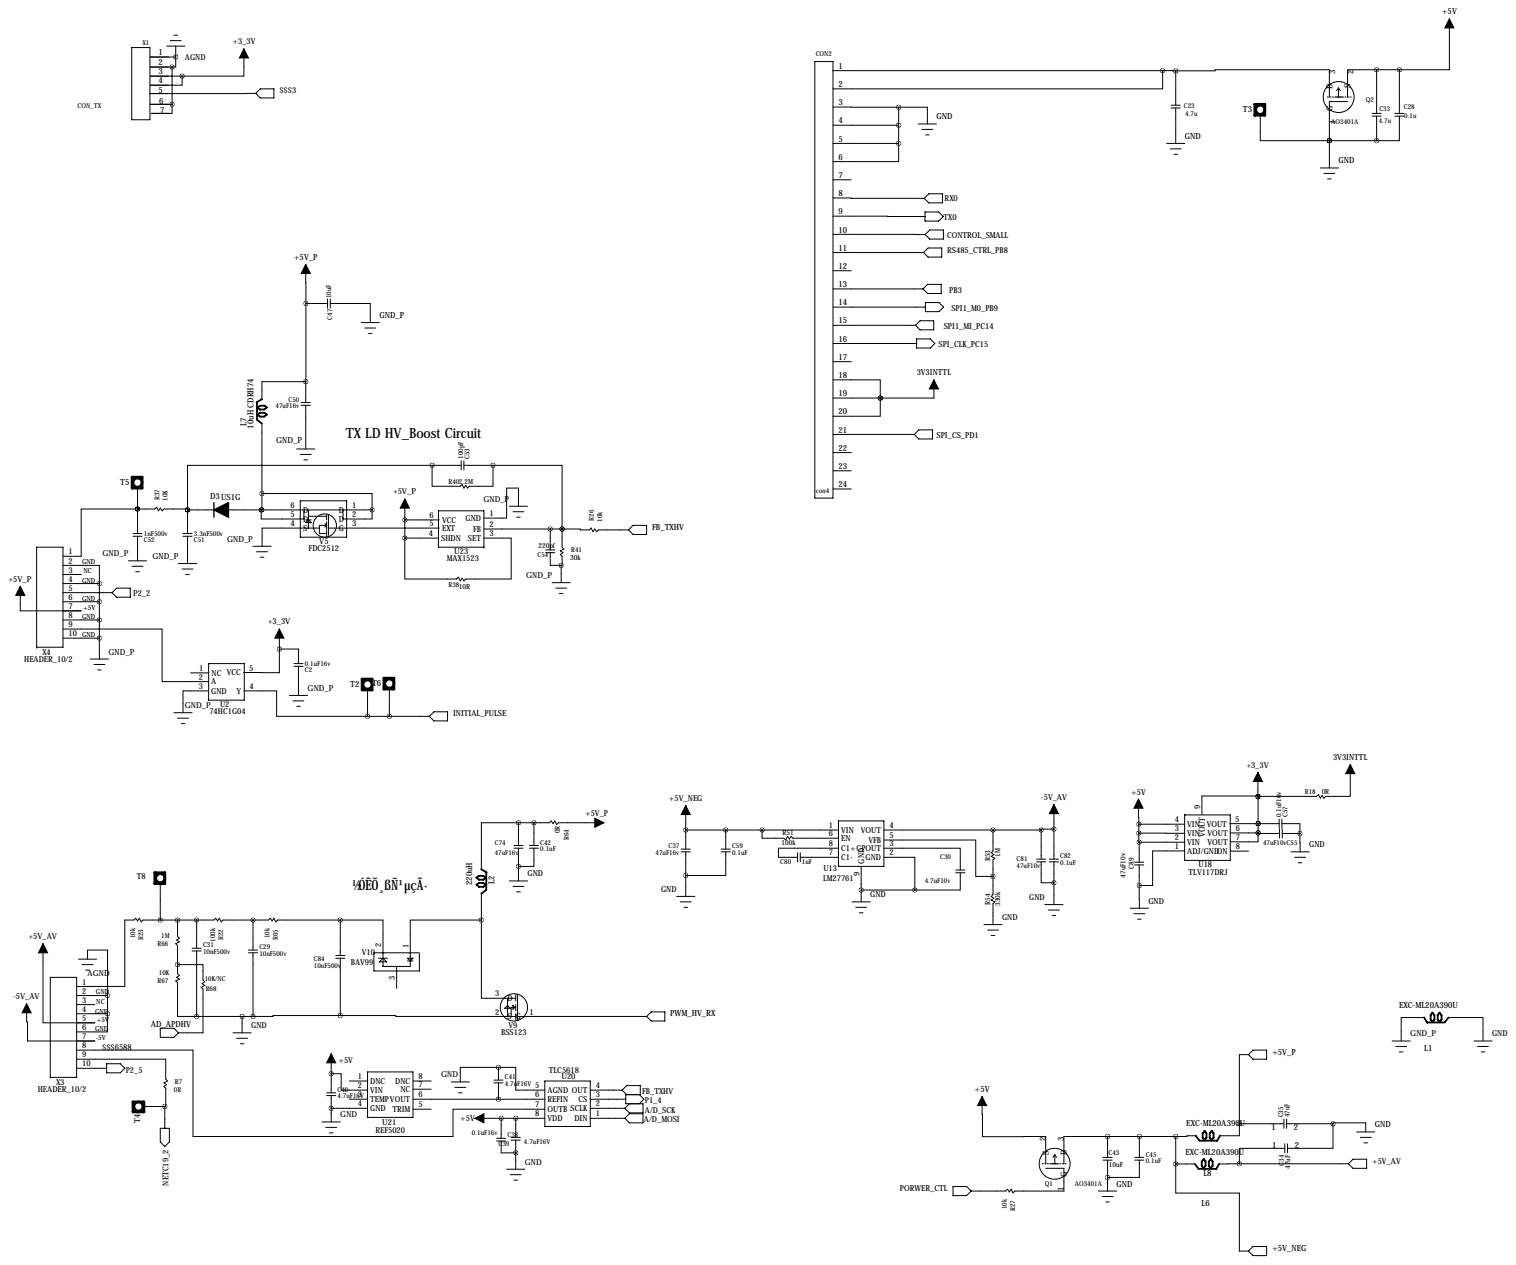
[picture p49: page 1]

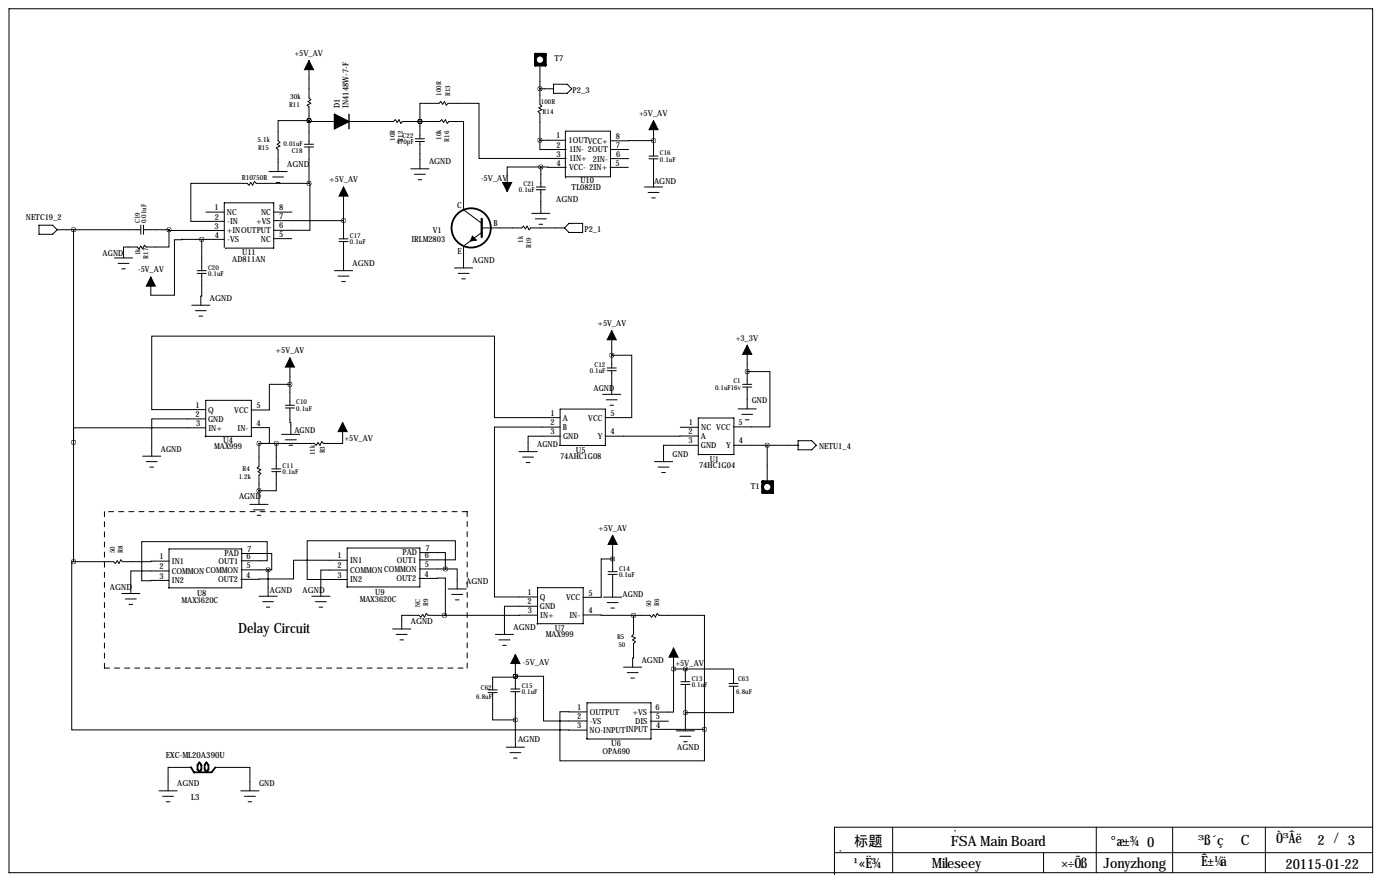
[picture p50: page 2]

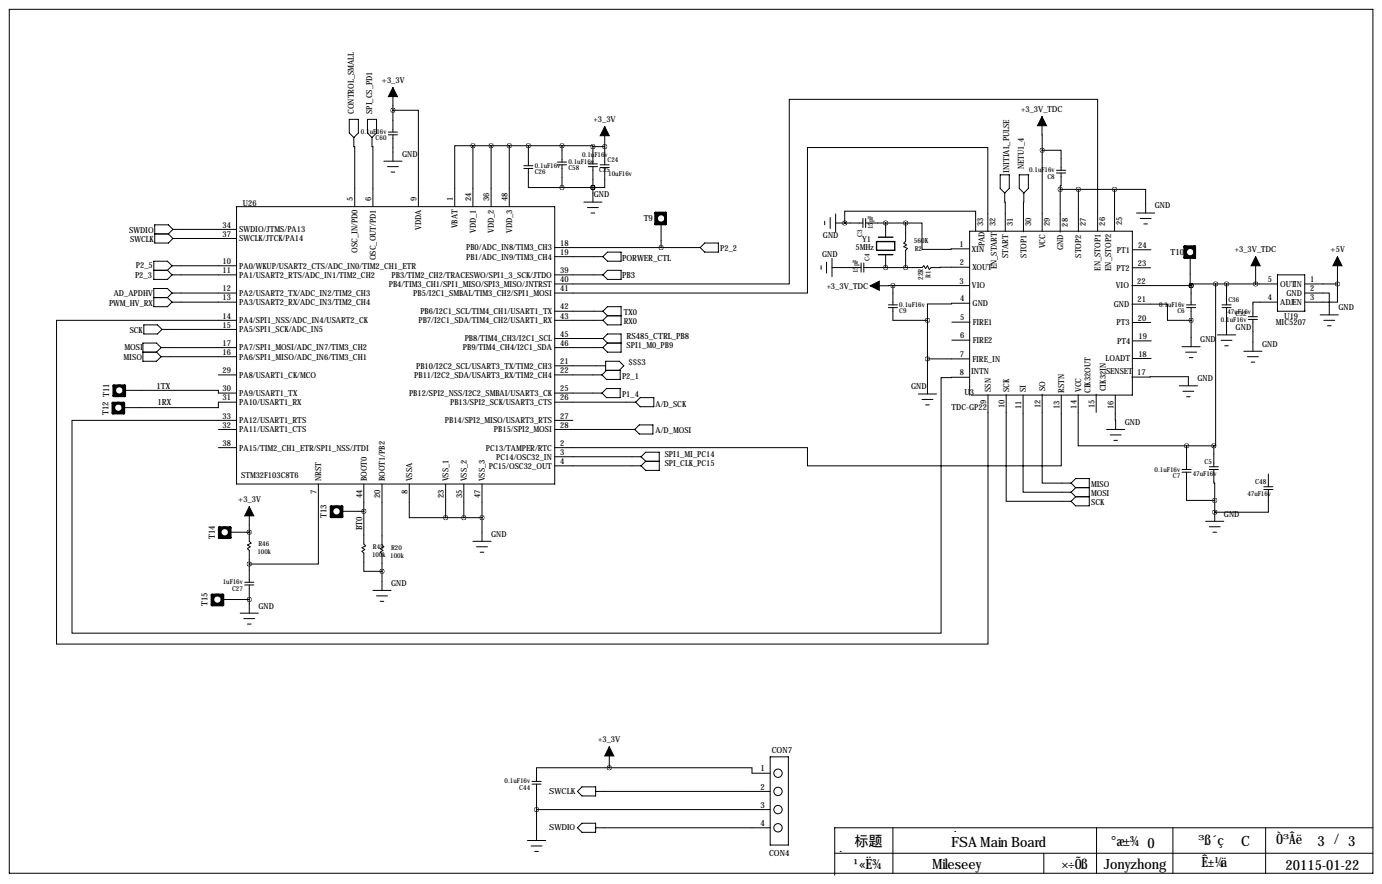
[picture p51: page 3]
