quanhengwen/LK02/硬件/LK02/LK02最新硬件/电源板/power PCB 1.6 new 2-19-Old/AD5420_POWER_V1.6.pdf

D

6 | 5 | 4 | 3 | 2 | 1

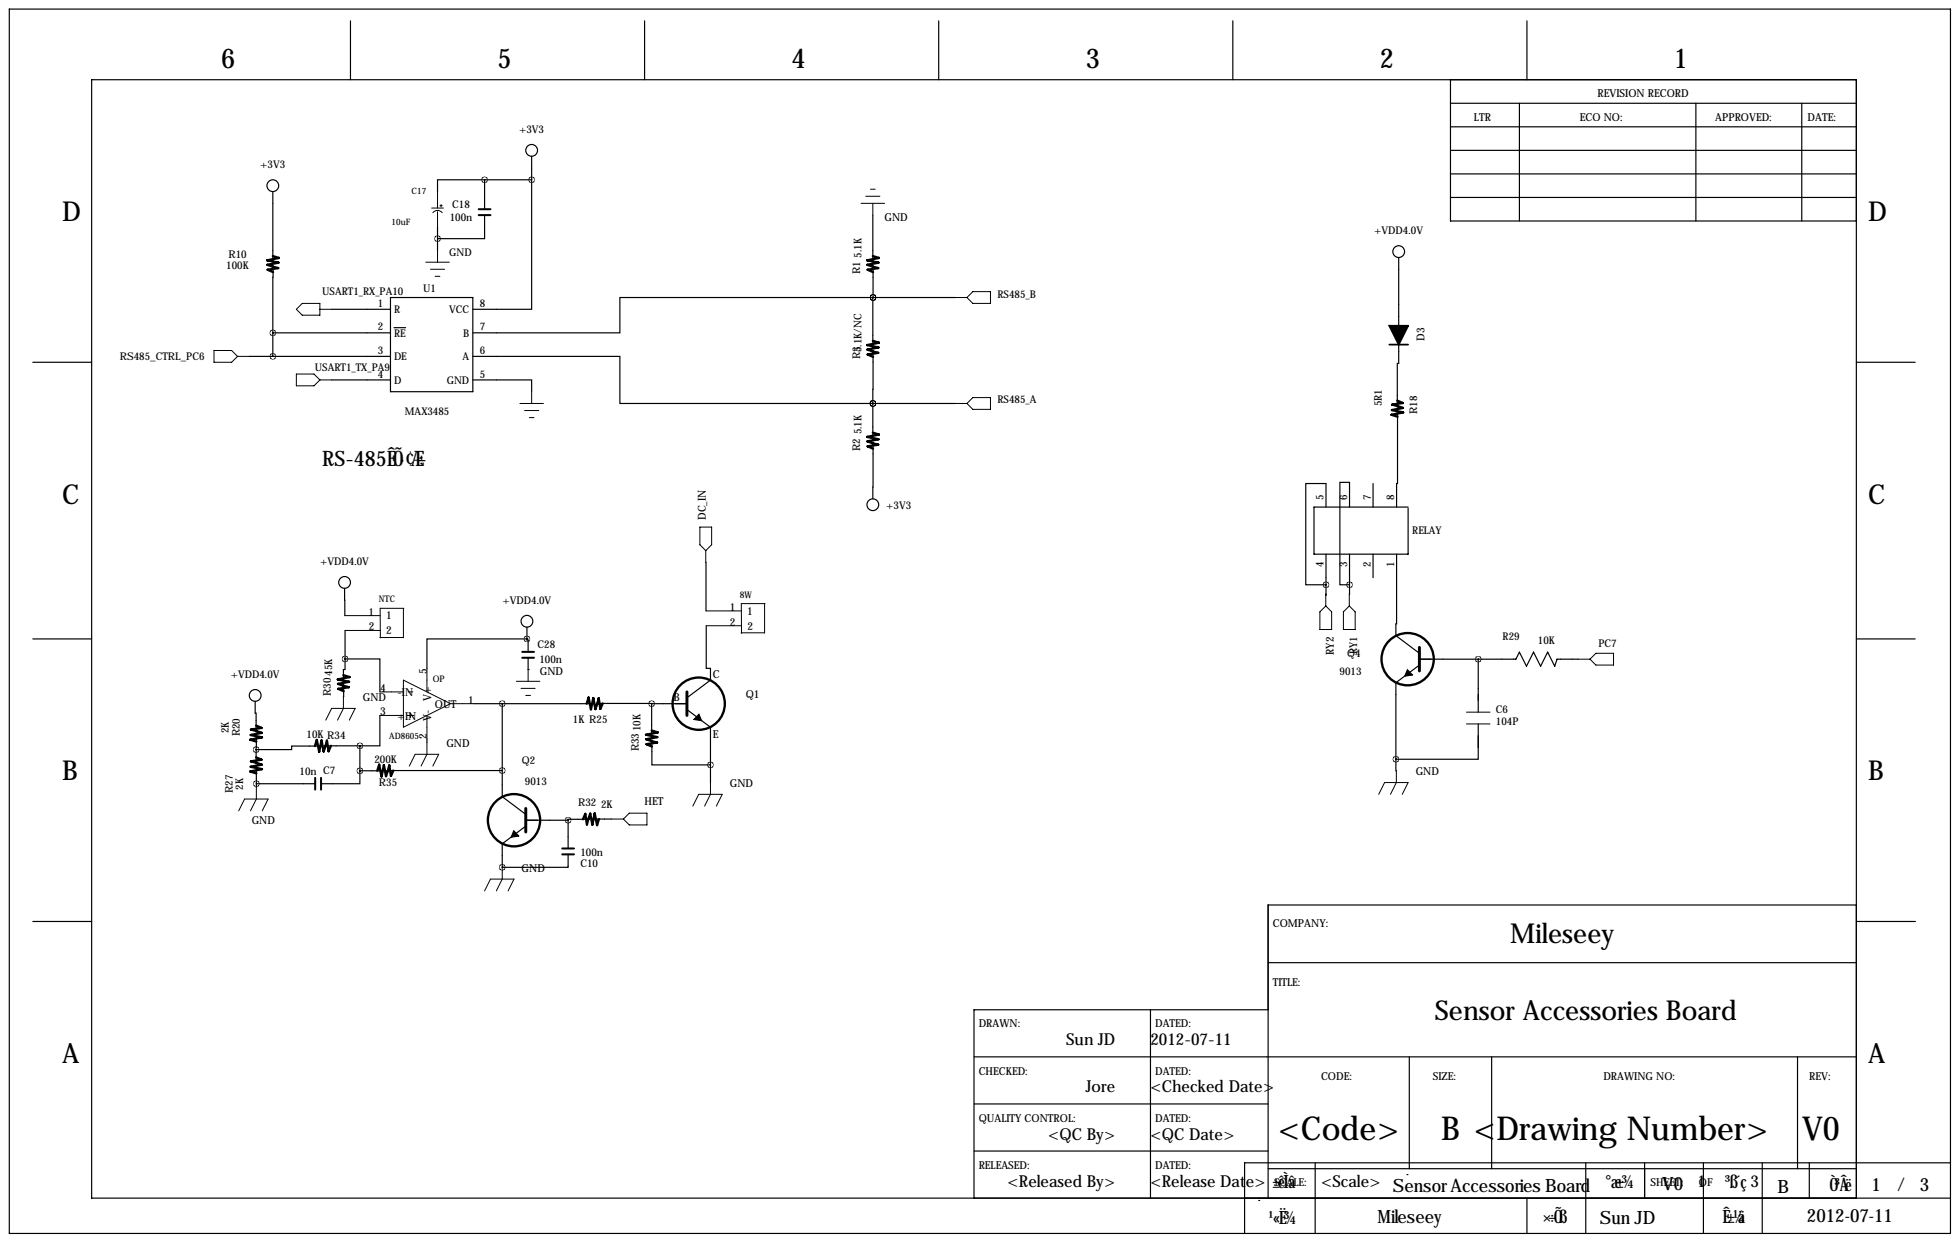
[picture p56: page 1]

+3V3 | REVISION RECORD

LTR | ECO NO: | APPROVED: | DATE:

DRAWN: Sun JD | DATED: 2012-07-11

CHECKED: Jore | DATED: <Checked Date> | CODE: <Code> | SIZE: B <Drawing Number> | DRAWING NO: | REV: V0

QUALITY CONTROL: <QC By> | DATED: <QC Date>

RELEASED: <Released By> | DATED: <Release Date>

SCALE: | <Scale> Sensor Accessories Board | 1 SHEET: V0 OF | 3

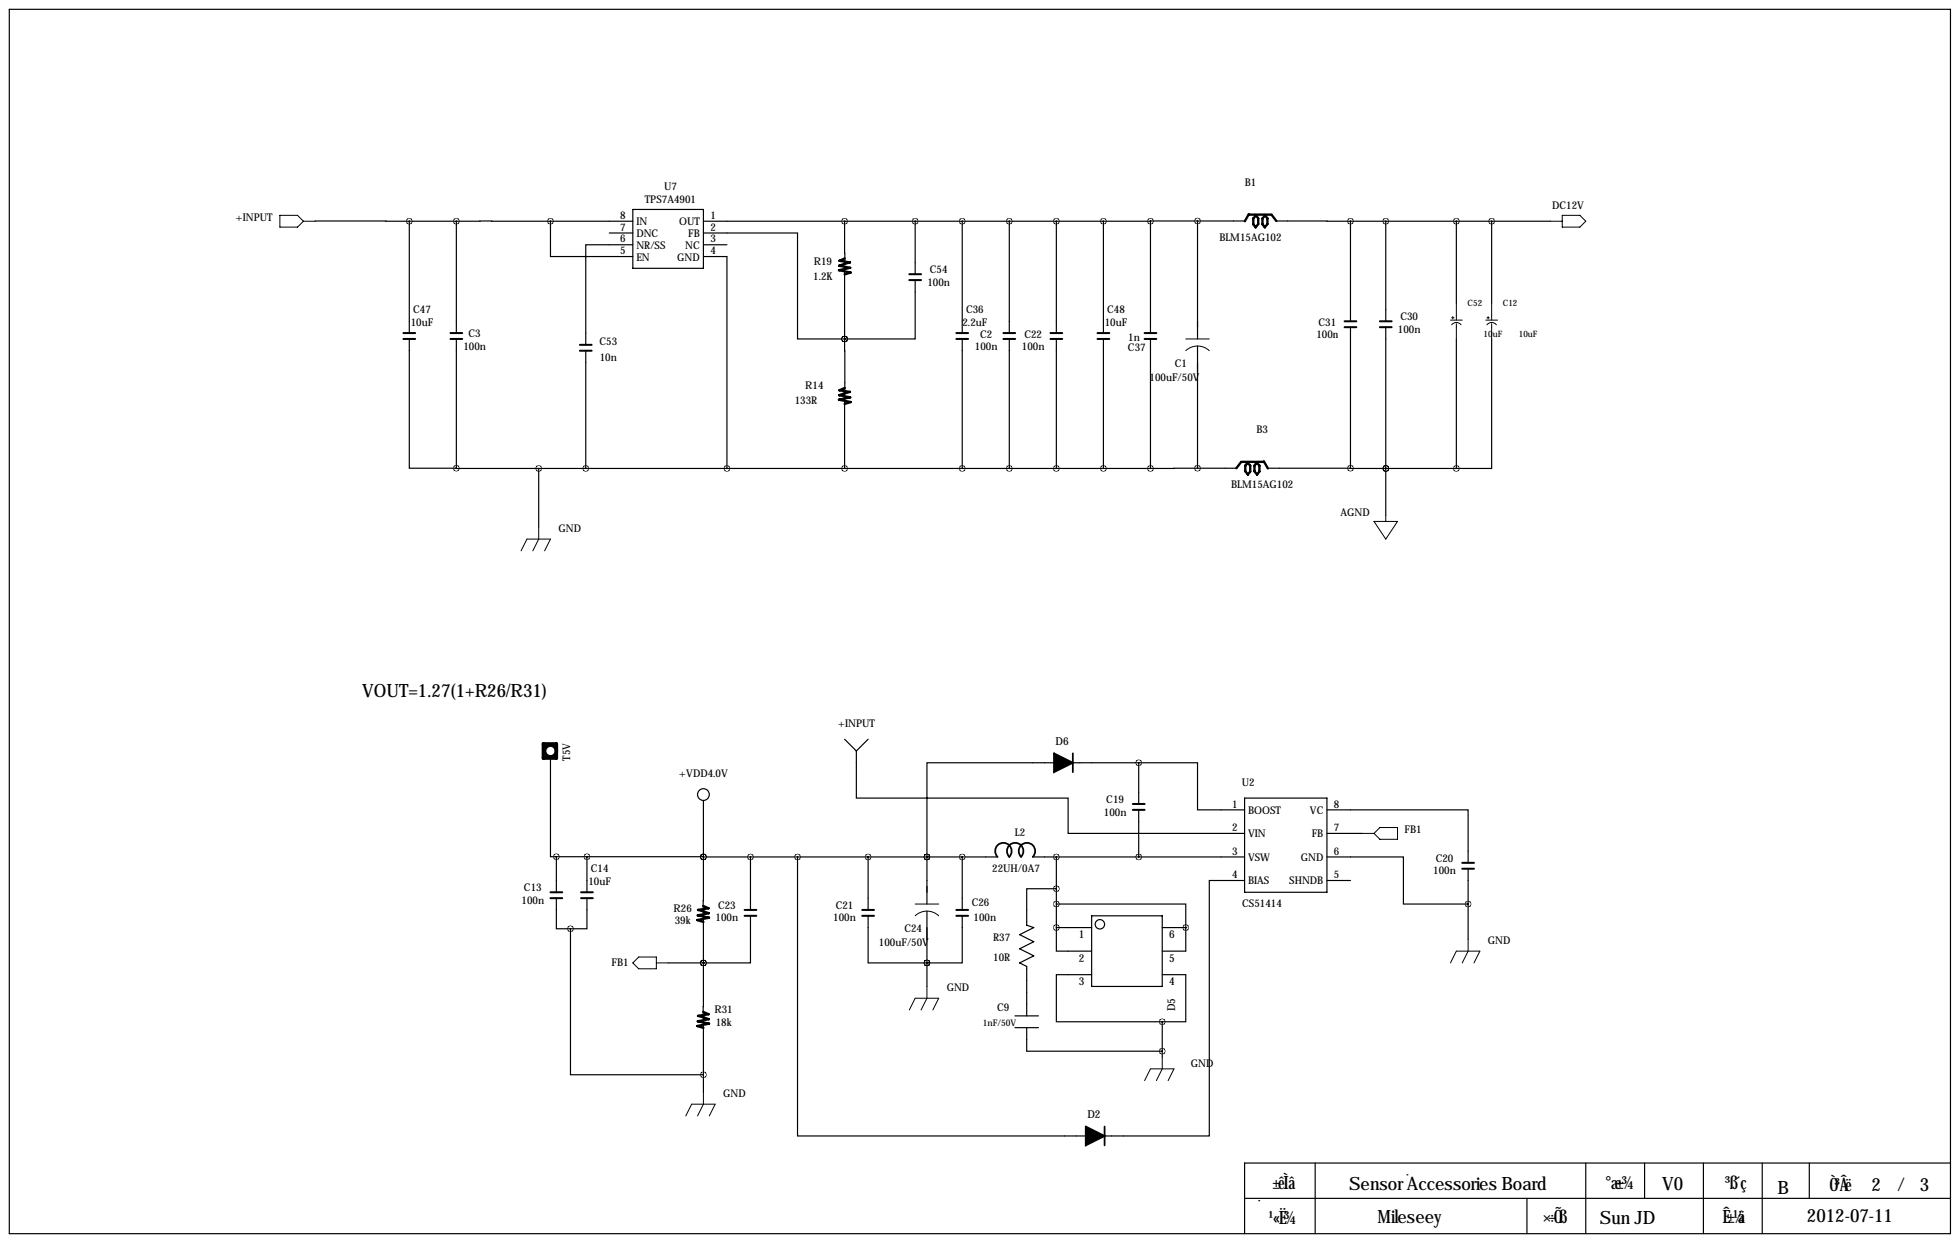
[picture p57: page 2]

## Select R46&R47 is TTL

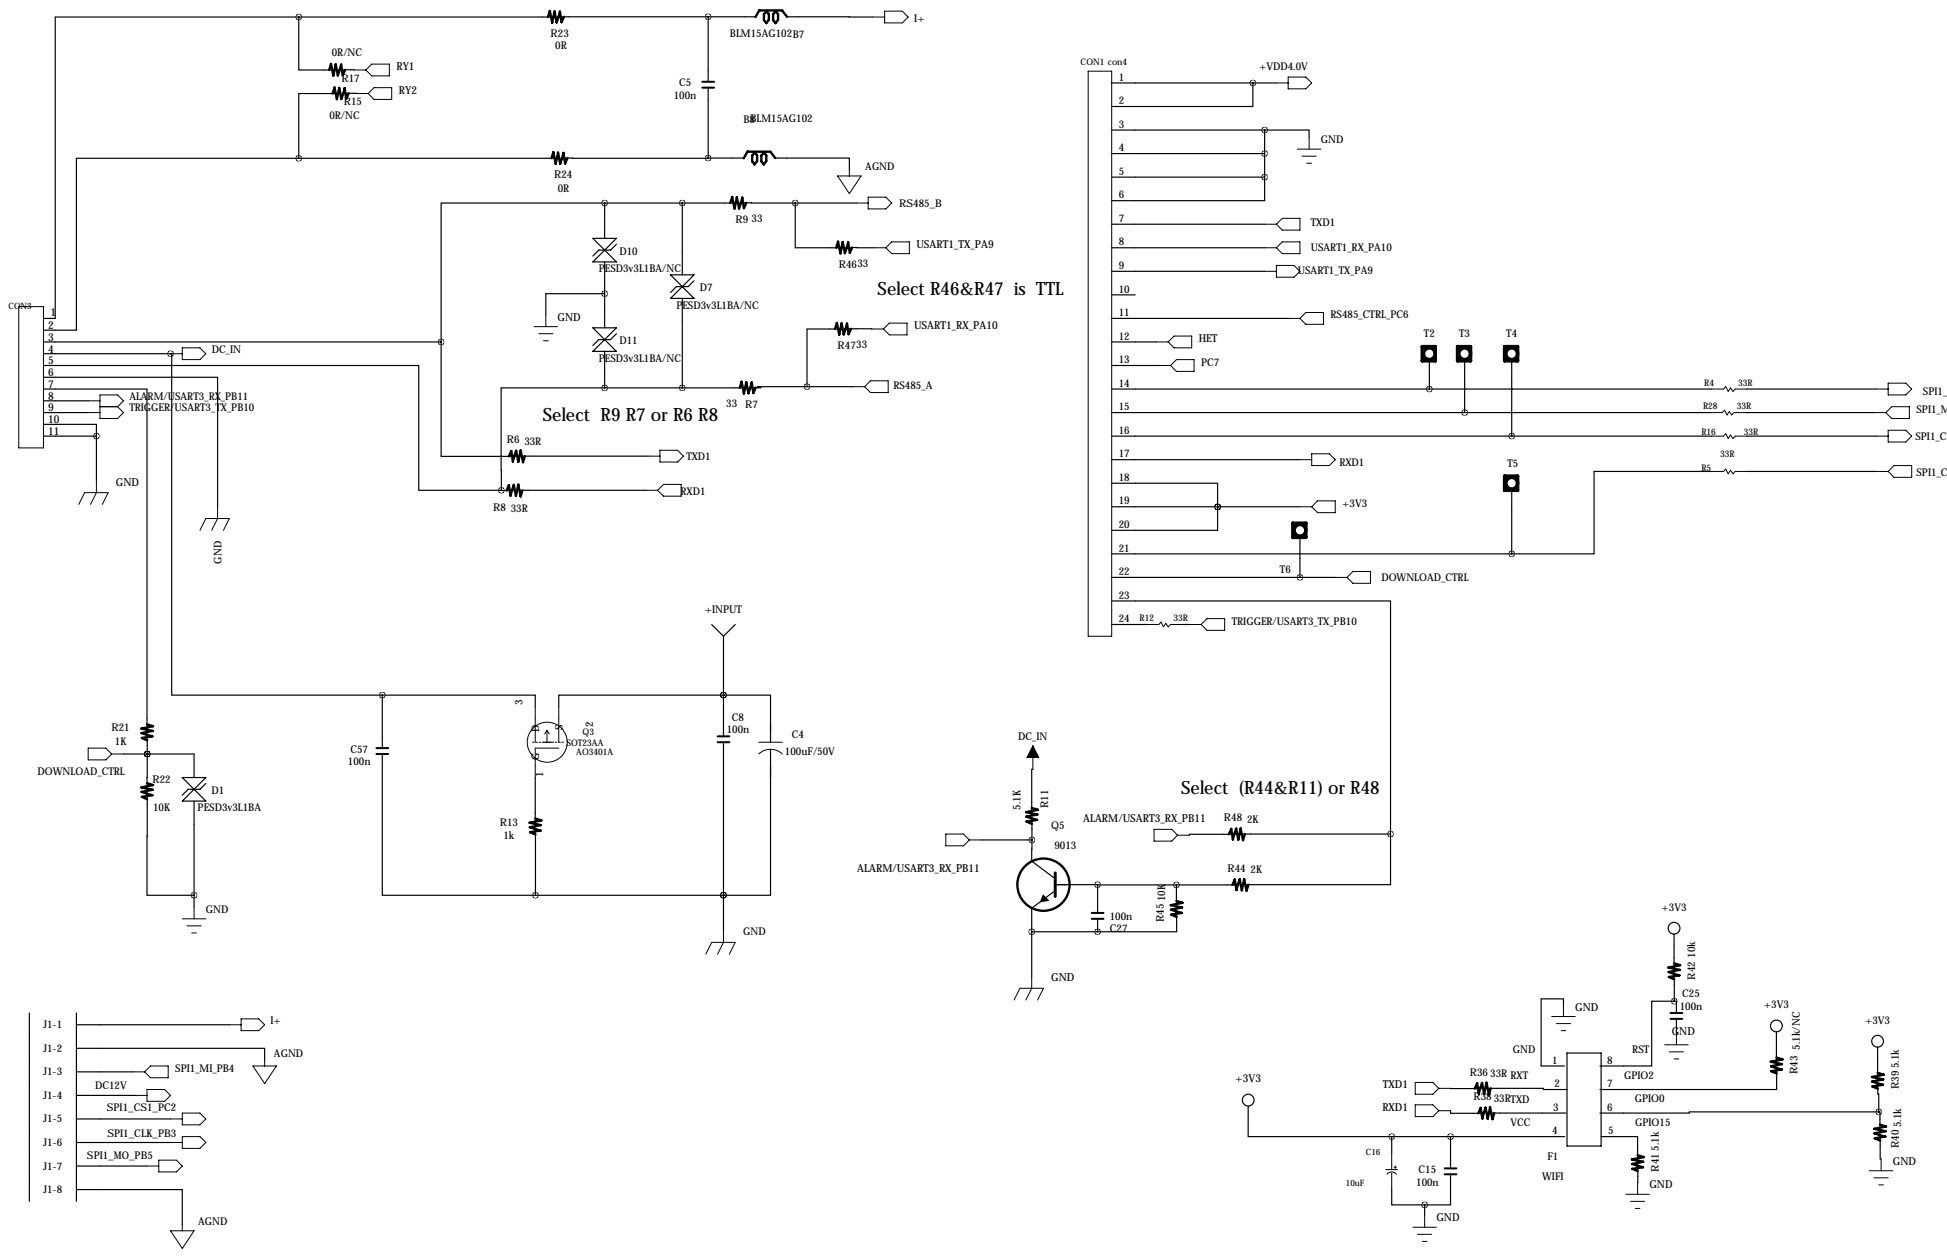
[picture p58: page 3]
