quanhengwen/LK02/硬件/LK02 3V0/v0.0.1/RX_3V0.pdf

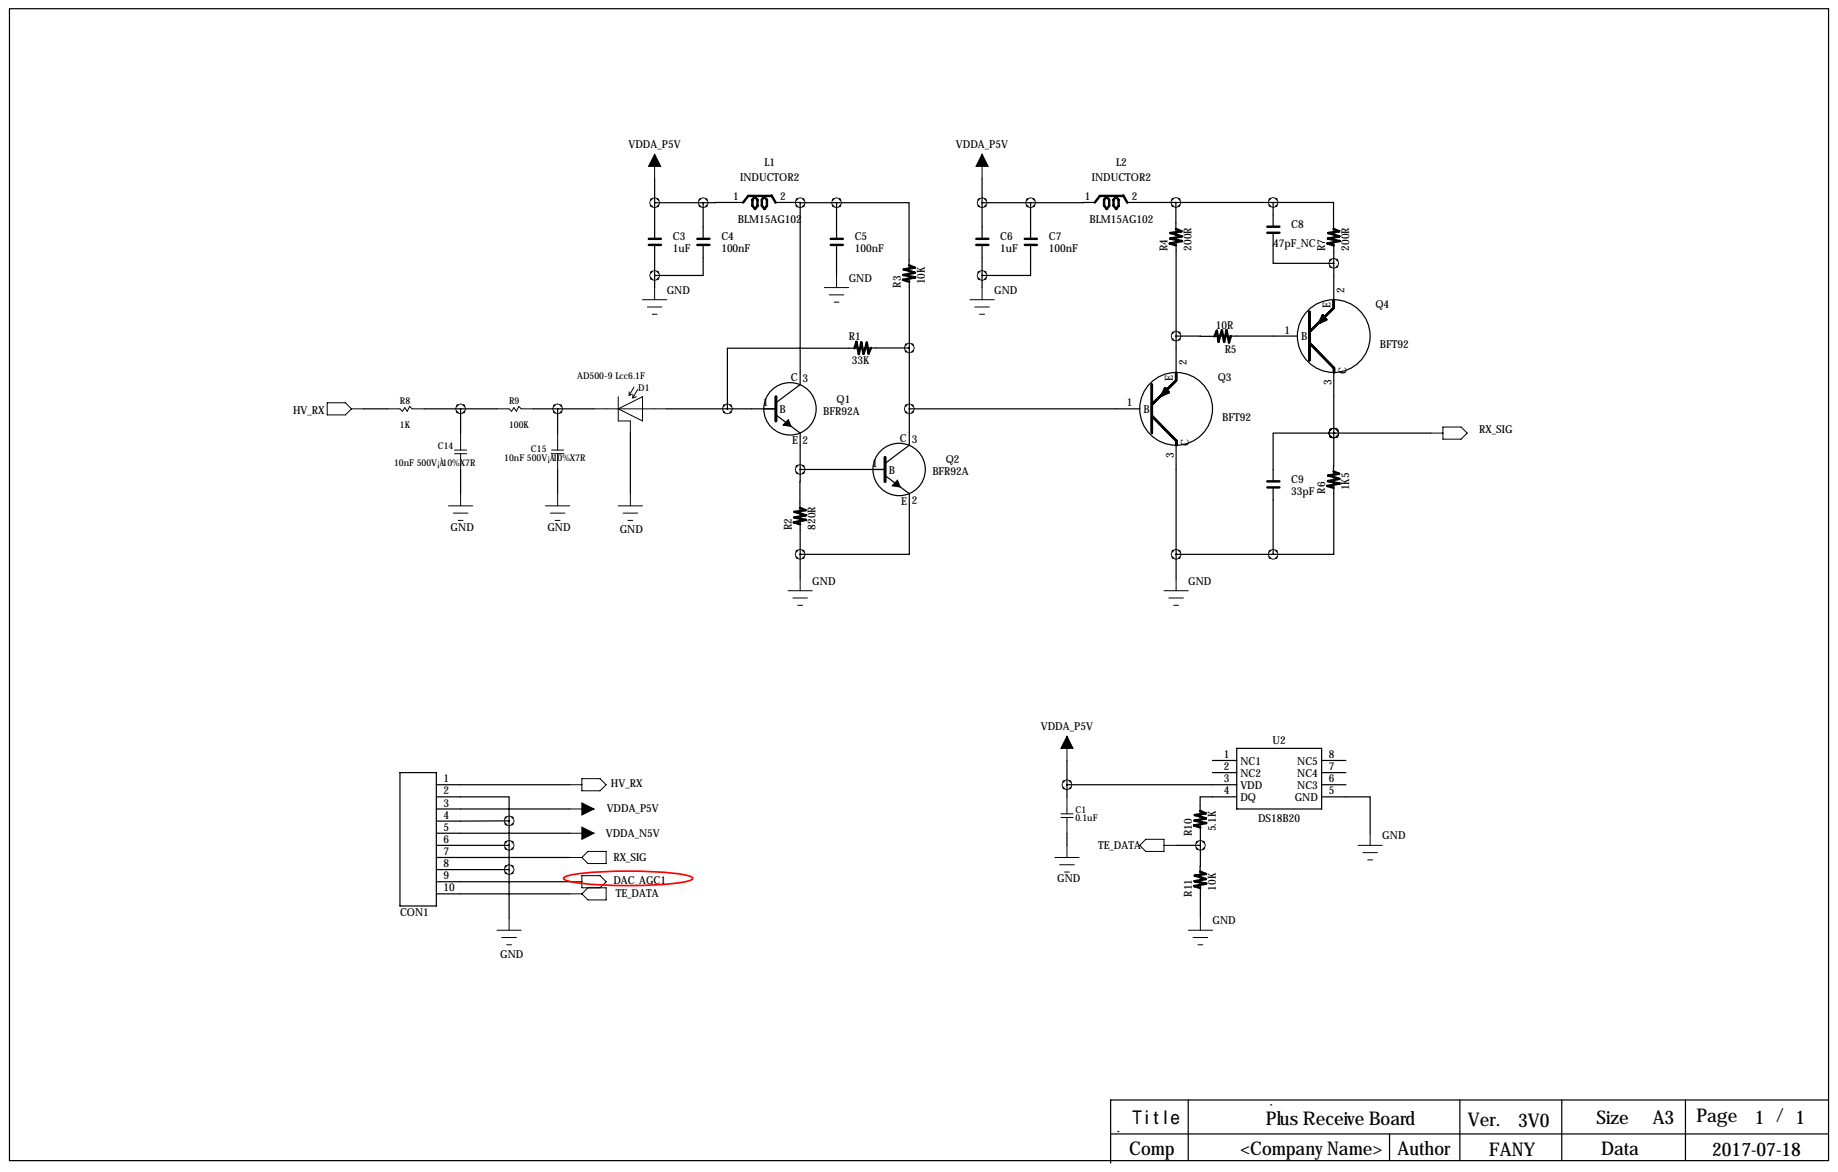
[picture p59: page 1]
