quanhengwen/LK02/硬件/LK02/LK02最新硬件/电源板/power PCB 1.6 new 2-19-Old/power PCB 1.6 new 2-19/AD5420_POWER_V1.6 top 2016.02.19 .pdf

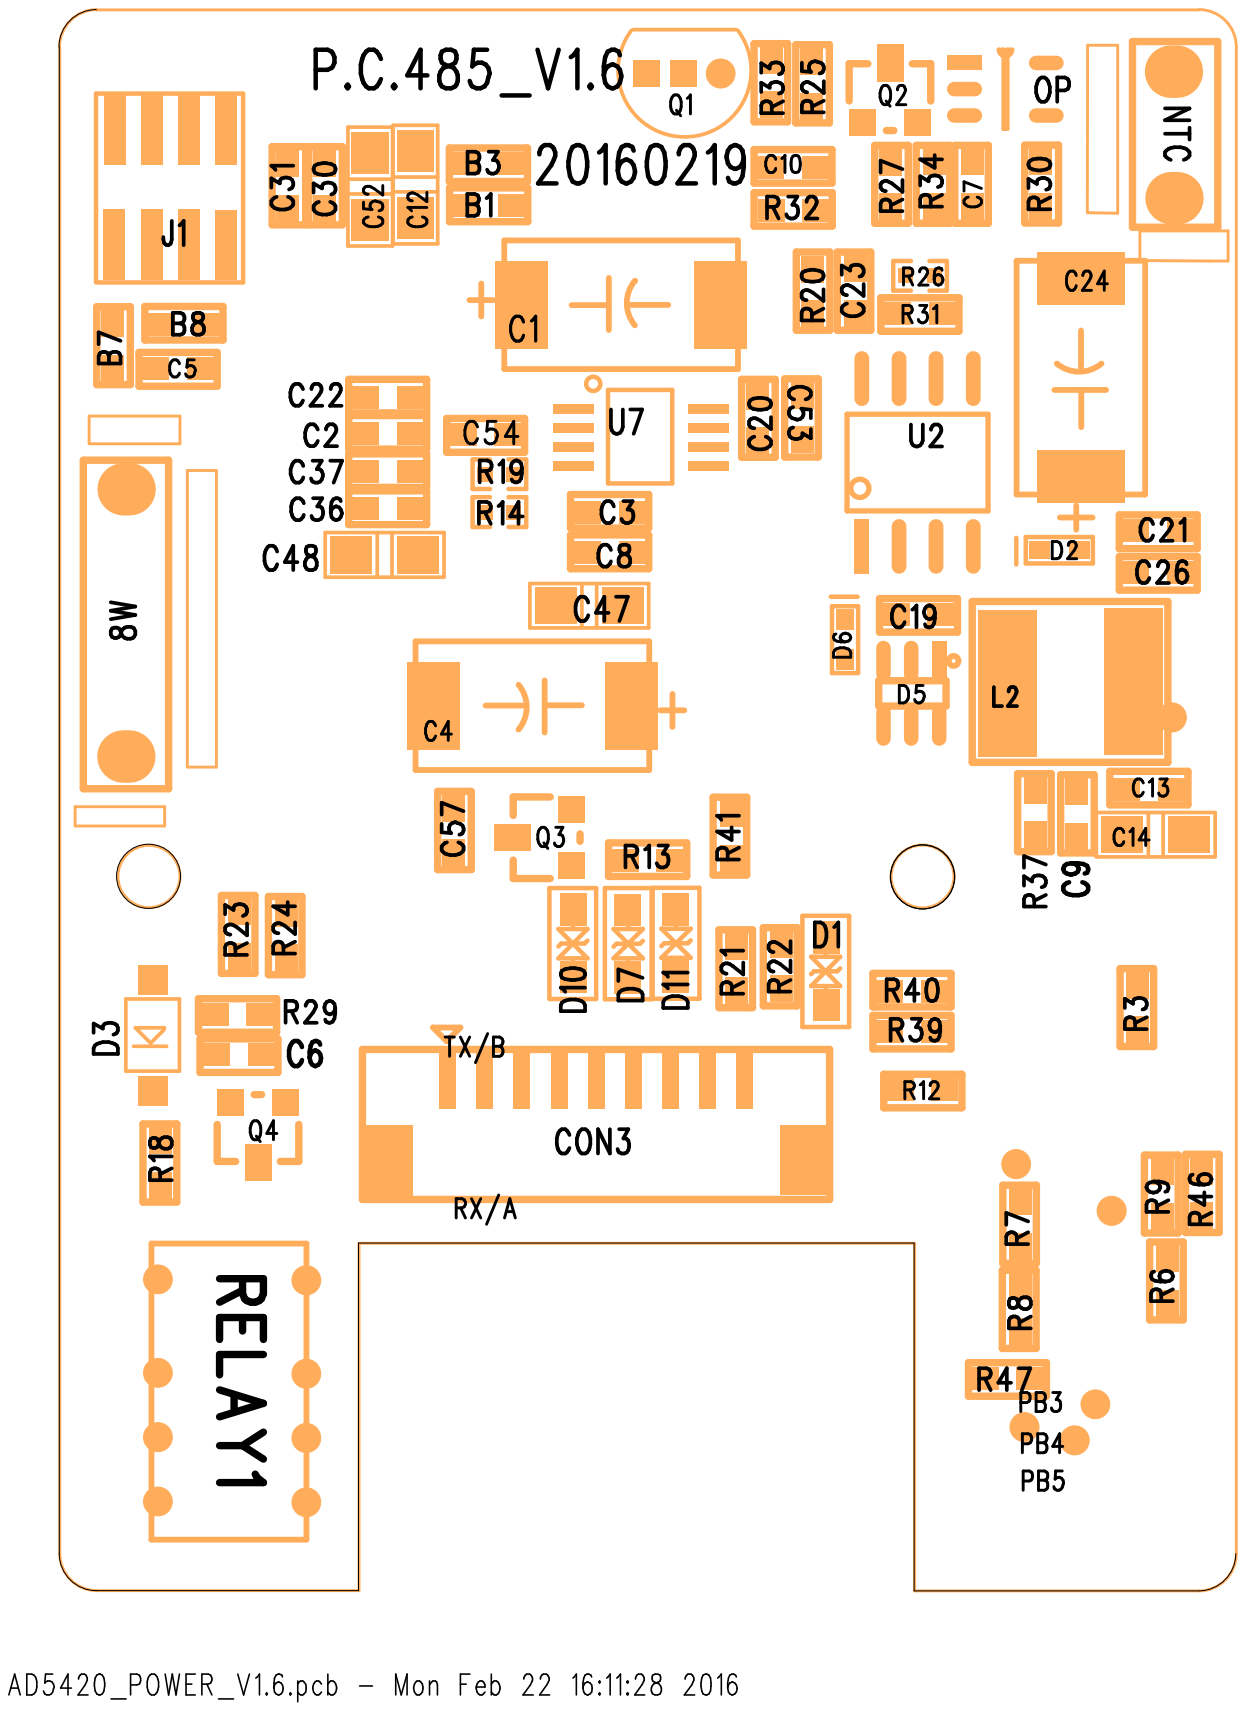
[picture p61: page 1]
