quanhengwen/LK02/(list of files, drawings)

Other design files:
硬件/LK02 3V0/LK02_3V0/DB10_CON/DB10_CON_1V0.pcb
硬件/LK02 3V0/LK02_3V0/MAIN_3V0/LK02 Main board 3V0.pcb
硬件/LK02 3V0/LK02_3V0/RX_3V0/RX_3V0.pcb
硬件/LK02 3V0/LK02_3V0/TX_3V0/TX_3V0.pcb
硬件/LK02 3V0/LK02_3V0/瞄准板/1v1/LK02 Pilot Laser Board V1.1.pcb
硬件/LK02/LK02最新硬件/主板/LK02 Main board V0.3/PCB/LK02 Main board V0.3.pcb
硬件/LK02/LK02最新硬件/主板/第二次试产主板/C2 Main board Rev3.2.pcb
硬件/LK02/LK02最新硬件/发射板/C2 Tx Rev2.0.pcb
硬件/LK02/LK02最新硬件/接收板/C2 Rx Rev2.2.pcb
硬件/LK02/LK02最新硬件/电源板/AD5420_POWER_V2.1（REF）/PCB/AD5420_POWER_V2.1.pcb
硬件/LK02/LK02最新硬件/电源板/LK02_POWER_V1.0.pcb
硬件/LK02/LK02最新硬件/电源板/power PCB 1.6 new 2-19-Old/power PCB 1.6 new 2-19/AD5420_POWER_V1.6.pcb
硬件/LK02/LK02最新硬件/瞄准板/1v0/共阳635激光驱动.pcb
硬件/LK02/LK02最新硬件/瞄准板/1v1/PCB/LK02 Pilot Laser Board V1.1.pcb
硬件/LK02/LK02第三次试产/电源板/AD5420_POWER_V2.1（REF）/AD5420_POWER_V2.1.pcb
硬件/LK02/LK02第二次试产/主板/C2 Main board Rev3.2.pcb
硬件/LK02/LK02第二次试产/发射板/C2 Tx Rev2.0.pcb
硬件/LK02/LK02第二次试产/接收板/C2 Rx Rev2.2.pcb
硬件/LK02/LK02第二次试产/电源板/485new/AD5420_POWER_V2.1.pcb
硬件/LK02/LK02第二次试产/电源板/LK02_POWER_V1.0.pcb
硬件/LK02/LK02第二次试产/电源板/power PCB 1.6 new 2-19-Old/power PCB 1.6 new 2-19/AD5420_POWER_V1.6.pcb
硬件/LK02/LK02第二次试产/瞄准板/laser sight.pcb
硬件/LK02/LK02第二次试产/瞄准板/共阳635激光驱动.pcb
硬件/LK02电源板/LK02_PB_1V0.pcb
硬件/MB01/PCB/layout_MB01_2v3_20160506.pcb
硬件/MB01/PCB/layout_MB01_2v3_20160506_layout-01.pcb
硬件/TX_3V0.pcb
