quanhengwen/LK02/浙大报警输出/MDK/Sources/App/ascii_protocol.h

/*******************************************************************
*file name:    ascii_protocol.c
*project:      C1
*Description:  uart protocol
*Platform:     stm32
*firmware:     v1.0
*Author:       cwd
*data:         2016.5.7
*note:         null
*******************************************************************/
#ifndef _ASCII_PROTOCOL_H_
#define _ASCII_PROTOCOL_H_


//-------------------------------------------------------------------------------
#define EEP_ADDR_START        (0)
#define EEP_SYSTEM_SETTING    (0+EEP_ADDR_START)          // 1byte  0,1,2  

//-------------------------------------------------------------------------------
#define BAUDRATE_4800       ((u32)4800)
#define BAUDRATE_9600       ((u32)9600)
#define BAUDRATE_19200       ((u32)19200)
#define BAUDRATE_38400       ((u32)38400)
#define BAUDRATE_115200      ((u32)115200)
#define BAUDRATE_256000      ((u32)256000)
#define BAUDRATE_460800      ((u32)460800)
#define BAUDRATE_921600      ((u32)921600)

//-------------------------------------------------------------------------------
#define GAIN_APD_MAX         2048        // default value
#define GAIN_APD_DEFAULT     1200//864   // default value 
#define GAIN_AGC_MAX         1048        // default value
#define GAIN_AGC_MIN         24          // default value
#define GAIN_AGC_INC_VALUE   5           // default value
#define GAIN_AGC_MAX_LEVEL  (GAIN_AGC_MAX-GAIN_AGC_INC_VALUE)// default value
#define GAIN_AGC_MIN_LEVEL  (GAIN_AGC_MIN+GAIN_AGC_INC_VALUE)// default value
#define GAIN_AGC_DEFAULT     630//650         // default value

#define Pulse_freq_20KHZ     40000//15k      50000-20k
#define Pulse_freq_4KHZ      270 //4k-270


#define Pulse_freq_1KHZ      50
#define Pulse_freq_500HZ     25
#define Pulse_freq_100HZ     5

#define DEMAR_OFFSET        500
#define CURRENT_DEMAR_NUM 5

typedef struct {
    s32 multiple;
    s16 constance;
} T_Demarcate;  //标定结构体

//-------------------------------------------------------------------------------

typedef struct  
{
    u32 CurrentStart;   //电流输出起点对应的距离
    u32 CurrentEnd; //电流输出终点对应的距离
}TypeCurrentRange;

typedef struct  
{
    u8  CurrentDemarNbr; //标定点数
    u16 CurrentDemar[CURRENT_DEMAR_NUM]; //标定值
}TypeCurrentDemar;


typedef struct
{
    u32 BaudRate;   // 波特率
    u16 OutputHZ;   // 输出频率HZ
    u16 RangeMax;      // 量程
    u16 RangeMin;      // 量程
    u16 PulseHZ;    //脉冲重复频率
    u16 SWvalue;    //开关量门限
    u16 APDV_LOW;   //APD电压增益 PWM
    u16 APDV_MID;   //APD电压增益
    u16 APDV_HIG;   //APD电压增益
    u8  APDV_Cal;   //高压标定标志
    s16 Cal1;       //标定数据1  4KHZ
    u8 CurMol;     //当前模式 0待标定模式 1测试模式 2正式出厂模式
    s16 Cal1_MD;
    s16 Cal1_HI;    //高增益标定数据1  4KHZ
    s16 Cal2;       //标定数据2  20KHZ
    s16 Cal2_MD;
    s16 Cal2_HI;    //高增益标定数据2  20KHZ
    u16 Ctemper;    //标定温度
    u16 PWM_rxHV;   //标定时的接收高压
    u8  Msrefer;    //基准 1,前基准 0，后基准
    u8  MsCurrMax;  //电流环量程上限
    u8  MsCurrMin;  //电流环量程下限
    u16 Gain1;      // 4Khz低增益值 
    u16 Gain1_MD;
    u16 Gain1_HI;    // 4Khz高增益值 
    u16 Gain2;      // 20Khz低增益值 
    u16 Gain2_MD;
    u16 Gain2_HI;    // 20Khz高增益值 
    u8  Flag_free;  //开机自动运行标志0\不自动 ,1\自动运行
    u8  Address;    // modbus 从机地址
    u8  Language;   //0 english, 1 chinese
    TypeCurrentRange CurrentRange; //电流环量程
    TypeCurrentDemar CurrentDemar; //电流环标定
}T_SysParam;

void SysParamInit(void);
void tlc5618_setting(void);  
void SettingSave(void);

#endif
