quanhengwen/LK02/硬件/LK02/LK02第二次试产/发射板/43680502HMC5883PADXL345PL1602/HMC5883+ADXL345+L1602/HMC5883.h

#ifndef __HMC5883_H__
#define __HMC5883_H__

#define uchar unsigned char
#define uint unsigned int

typedef unsigned char  BYTE;

void Multiple_read_HMC5883(void);
void Init_HMC5883();
void conversion(uint temp_data) ;

#endif
