quanhengwen/LK02/硬件/LK02/LK02第二次试产/发射板/43680502HMC5883PADXL345PL1602/HMC5883+ADXL345+L1602/key.h

#ifndef __KEY_H__
#define __KEY_H__

#define uchar unsigned char
#define uint unsigned int

extern uchar code tab_1[];//初始化年月日
extern uchar code tab_2[];//初始化时分秒
extern uchar code tab_3[];

void key();

#endif
