quanhengwen/LK02/浙大报警输出/MDK/Sources/Driver/drv_adc.h

/*******************************************************************
*file name:    drv_uart.c
*project:      s2
*Description:  uart driver
*Platform:     stm32
*firmware:     v1.0
*Author:       cwd
*data:         2014.6.4
*note:         null
*******************************************************************/
#ifndef _DRV_ADC_H_
#define _DRV_ADC_H_

void StartAdcSample(void);
u16 GetADCResult(u32 channel);

#endif
